young-0320/flash-margin-bench/hw/README.md

# hw

**소유자: 팀원 B** — 타인 수정은 PR로만.

실행 코드가 아닌 물리 설계물. DUT 보드 KiCad, BOM, 결선도, 열 이력 시료 기록.
레벨 시프터·히터·보호 회로가 여기서 결정된다.

## TODO

- [ ] DUT 보드 설계: SOP8 소켓, 가변 전원 + 레벨 시프터, 히터 + 온도 센서, 보호 회로
- [ ] BOM / 결선도
- [ ] 보드 제작·브링업
- [ ] 열 이력 시료 (리플로우 0/1/3/5회) 제작·기록
