young-0320/flash-margin-bench/docs/concepts/9.jtag_uart_and_os_enumeration.md

# 9. JTAG과 UART — 케이블 하나에 실린 두 대화, OS마다 다른 문패

- 관련: 로그 13 (Windows COM 오선택 사례) · 런북 3 판독표 E · `host/capture/sweep_uart_capture.py --port`

## 쉬운 버전 — 정비사 통로와 환자의 목소리

**보드와 PC의 대화는 종류가 둘이다.** JTAG은 **정비사 통로**다 — 칩을 멈춰 세우고, 속을 들여다보고, 새 프로그램(비트스트림·ELF)을 심는다. 칩이 협조하지 않아도 밀어넣을 수 있는 강제력 있는 문이고, hw_server/xsdb가 이 문으로 드나든다. UART는 **환자의 목소리**다 — 칩이 실행되는 동안 스스로 말하는 텍스트 스트림(우리의 `#G0 SWEEP BEGIN`, M/R 행들). 프로그램은 JTAG으로 들어가고, 데이터는 UART로 나온다. 방향도 성격도 다른 두 대화다.

**그런데 물리적으론 USB 케이블 하나다.** 보드 위 FTDI 칩(FT2232)이 USB 연결 하나를 **채널 두 개**로 나눈다 — A채널엔 JTAG, B채널엔 UART. 전화선 하나에 내선 두 개가 실린 셈이다. 여기까진 설계의 편리함인데, 함정은 그 다음이다: **내선 번호를 어떻게 보여줄지는 전화국(OS)이 정한다.**

**리눅스는 문패를 하나만 단다.** 커널이 "A채널은 JTAG이니 시리얼 포트가 아니다"라고 알아서 걸러, UART 채널만 `/dev/ttyUSB1` 같은 문패를 단다. 잘못 고를 여지가 없다. **Windows는 두 채널 모두 "USB Serial Port(COM3)(COM4)"라는 똑같은 문패를 달 수 있다.** 이름만 봐선 어느 쪽이 목소리(UART)이고 어느 쪽이 정비사 통로(JTAG)인지 알 수 없다 — 2026-07-08 원격 실행이 실패한 유력 원인이다(로그 13). JTAG 채널에 귀를 대면 영원히 조용하다.

**판별법 두 가지.** ① 장치 관리자에서 COM 포트 속성 → 상위(부모) 장치가 "USB Serial Converter **B**"인 쪽이 UART. ② 실증: 후보 COM으로 캡처를 띄우고 재프로그래밍 — `#G0 SWEEP BEGIN`이 **수 초 안에** 뜨는지가 판정이라 시도당 1분이 안 걸린다. 잘못 골라도 보드엔 아무 해가 없다.

## 엔지니어링 버전

**FT2232 듀얼 채널.** 채널 A = MPSSE 모드로 JTAG 신호를 비트뱅잉 — hw_server가 libusb/D2XX로 **원시 USB 장치를 직접** 잡는다(시리얼 포트 계층을 거치지 않음 — xsdb/xsct에 "포트 지정"이 없는 이유). 채널 B = 평범한 UART 브리지(8N1, 본 프로젝트는 2026-09-15부터 921600 — 그 전엔 115200), PS UART1에 배선.

**리눅스 열거.** `ftdi_sio` 커널 드라이버가 인터페이스 단위로 바인딩해 UART 채널만 ttyUSB 노드가 된다. JTAG 채널은 Digilent udev 규칙(`/etc/udev/rules.d/52-*digilent*.rules`)이 권한을 열어 hw_server가 원시 접근. 주의: ttyUSB **번호는 열거 순서**라 절대적이지 않다 — 다른 USB-시리얼 장치가 꽂혀 있으면 밀릴 수 있고, 그때는 `--port`로 조정한다.

**Windows 열거.** FTDI CDM 드라이버는 채널별로 VCP(가상 COM)를 켜고 끌 수 있는데(EEPROM/INF 설정), 구성에 따라 **두 채널 모두 COM으로 노출**된다. COM 번호는 시스템 이력에 따라 붙어 예측 불가. 판별은 위 ①(부모 컨버터 A/B) 또는 ②(BEGIN 실증).

**우리 코드에서 포트가 등장하는 유일한 곳.** PS의 C 코드는 Zynq 자기 자신의 UART 주변장치에 쓸 뿐 PC 쪽 포트를 모르고, tcl은 JTAG 전용이라 시리얼 개념이 없다. PC측 포트 선택은 `sweep_uart_capture.py --port`(기본 `/dev/ttyUSB1`) 한 곳뿐이다 — OS가 바뀌면 바꿀 것도 이 인자 하나다.

| 대화 | 우리 도구 | 포트 선택 |
| --- | --- | --- |
| JTAG | xsct/xsdb + hw_server | 없음 (원시 USB 직접, OS 무관) |
| UART | sweep_uart_capture.py | `--port` 인자 (리눅스 ttyUSB* / Win COM*) |
