young-0320/flash-margin-bench/docs/concepts/10.jedec_id.md

# 10. JEDEC ID — 칩의 자기소개, 통신 검증의 표준 관용구

## JEDEC이 뭔가

JEDEC은 반도체 업계 표준화 단체 이름이다 (Joint Electron Device Engineering
Council — 현 JEDEC Solid State Technology Association). DDR 메모리 규격을 만드는
그 단체다. "JEDEC ID"라고 할 때는 이 단체가 관리하는 **제조사 식별 표준
JEP106**을 가리킨다: 전 세계 반도체 제조사마다 고유 번호를 배정한 명부.
Winbond = 0xEF.

## 0x9F — "너 누구냐"

SPI 플래시에는 표준 명령 0x9F(Read JEDEC ID)가 있다. 8비트 명령을 보내면 칩이
3바이트로 자기소개한다. W25Q64의 답:

| 바이트 | 값 | 뜻 | 누가 정하나 |
| --- | -- | --- | --- |
| 1 | EF | 제조사 = Winbond | JEDEC (JEP106) |
| 2 | 40 | 디바이스 타입 = SPI NOR 계열 | 제조사 |
| 3 | 17 | 용량 코드: 2²³ 바이트 = 8MB = **64Mbit** | 제조사 (2ⁿ 관례) |

W25Q**64**의 64가 마지막 바이트에서 나온다 (0x17 = 23, 2²³ 바이트 = 64Mbit).

## 왜 통신 증거로 쓰나 (게재 2번의 논리)

전화를 걸어 "성함이 어떻게 되세요?"라고 묻는 것과 같다. 정확히 기대한 이름이
돌아오면 전화선(배선·전원)과 상대방(칩), 발음(클럭·타이밍)이 전부 정상이라는
뜻이다. 조건이 하나라도 어긋나면 이 3바이트가 정확히 맞을 확률은 사실상 0이라,
"EF 40 17 수신 = 보드↔모듈 통신 성립"이 성립한다. 게다가 칩 ROM에 새겨진 고정
응답이라 플래시에 뭘 썼는지와 무관 — 사전 쓰기(D2) 전에도 쓸 수 있는 첫 관문이다.

오답의 판독 (런북 3 표 E와 연결):

- `FF FF FF` — 아무도 수화기를 안 들었다. MISO가 미구동/풀업 상태 그대로 읽힘
  → 무칩·오배선·CS 미연결.
- `00 00 00` — 회선이 땅에 붙었다. MISO 접지·무전원.
- 그 밖의 값 — 다른 칩이거나 간헐 접촉 (비트 일부가 깨져 들어옴).

둘 다 "이름"이 아니라 **회선 상태를 그대로 읽은 것**이라는 게 요점이다.

## 이 리포에서 쓰는 곳

- `ps/src/flash_jedec.c` — 게재 2번: 1초 주기 반복 판독 + 판정 문구 (D1)
- `ps/src/flash_prep.c` — 사전 쓰기 전 JEDEC 선검사 (배선 정상일 때만 지우기 시작)
- SPI 마스터 RTL 경로(G3)는 0x9F가 아니라 읽기(0x0B)로 측정하지만, 그 전에 이
  유틸리티 경로(PS SPI, 2.6MHz)로 칩 존재를 먼저 증명해 두는 구조다.
