young-0320/flash-margin-bench/docs/results/reports/제5회 창의혁신 공모전 중간계획서.docx

제5회 창의혁신 공모전 중간계획서

FPGA 기반 플래시 메모리 마진 계측 및 수명 추적 플랫폼

- 팀명: 에러 ate -

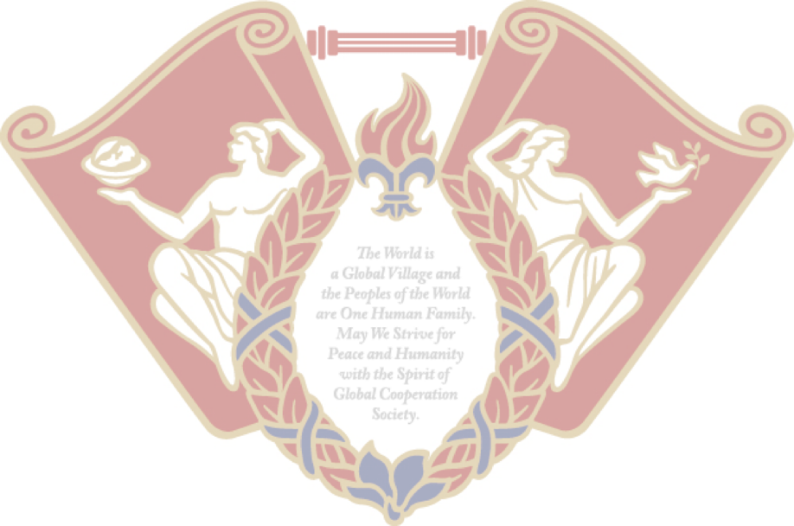
[picture p6: figure]

Ⅰ. 개요

Ⅱ. 세부내용 및 구성

Ⅲ. 기대효과 및 활용방안

Ⅳ. 수행방법

Ⅴ. 진행계획 및 역할분담

Ⅰ. 개요

1. 프로젝트 요약

본 프로젝트는 FPGA 기반 플래시 메모리 마진 계측 및 수명 추적 플랫폼을 개발한다. 같은 모델의 플래시 메모리라도 개체마다, 온도마다, 사용량마다 "여유(마진)"가 다르다. 우리는 저가 FPGA 보드(Zybo Z7-20)로 그 여유를 단위가 있는 물리량(ns, MHz, µs)으로 측정하고, 사용에 따라 여유가 어떻게 소모되는지를 칩 개체별로 추적한다. 즉, 불량인지 아닌지를 판정하는 것이 아니라 여유가 얼마나 남았는지를 측정하며, 출하 전 1회 검사가 아니라 수명 주기 내내 추적한다.

2. 배경 — 질문의 전환

당초 계획(참가 신청서)은 "FPGA 기반 SPI Flash 자동 검증 Mini-ATE", 즉 기존 검사 장비의 소형 재구현이었다. 그러나 검토 과정에서 "기존 장비를 작게 만들었다"는 것은 잘 만든 구현이지 창의적인 문제 정의가 아니라고 판단하여, 질문 자체를 바꾸었다.

산업용 ATE(자동 검사 장비)는 마진 측정을 "못 해서" 안 하는 것이 아니다. 특성 평가(characterization) 단계에서 전압-클럭 스윕은 표준적으로 수행한다. 문제는 시점과 접근성이다. ATE는 대당 수억~수십억 원의 전용 시설이며, 칩이 공장을 떠나는 순간 다시는 ATE에 물리지 않는다. 출하 전 1회 스냅샷이 전부이고, 필드에서 수년간 마모된 칩의 상태를 측정하는 인프라는 존재하지 않는다. 본 플랫폼은 작고 저렴하기 때문에 비로소 가능해지는 일, 즉 출하 이후 생애주기 전체에 걸친 반복 측정을 목표로 한다.

구분 | 산업용 ATE | 본 플랫폼
생애 시점 | 출하 전 1회 스냅샷 | 수명 주기 내내 반복 검진
대상 | 신품 로트(통계) | 사용 중인 개체(이력)
질문 | 지금 스펙을 만족하는가 | 여유가 얼마나 남았고 어떻게 줄고 있는가
결과 | PASS/FAIL + 수율 | 개체별 마진 곡선(단위 있는 물리량)
비용/형태 | 수억~수십억 원, 전용 시설 | 약 20만 원 내 COTS 부품, 벤치탑
비유 | 출생 시 신체검사 | 정기 건강검진

정직한 비교: 본 플랫폼은 ATE의 1/1000 가격에 같은 일을 하는 것이 아니다. ATE의 수많은 기능 중 출하 이후 단계에 필요한 마진 계측 기능만을 잘라내, 그 부분에 대해 1/1000 비용으로 접근 가능하게 만드는 것이다.

3. 목적

∙ 피코초급 위상 스윕으로 정상 칩의 타이밍 마진을 나노초 단위로 실측하는 계측 엔진 구현

∙ 온도·전압·마모에 따른 마진 축소 곡선(노화 곡선) 확보

∙ 마모량-마진 교정 곡선을 구축하고, 이력 미상 칩의 소모량 추정을 블라인드 실험으로 검증하여 추정 오차를 정량화

∙ 중고/재생 칩 판별, 고장 예지 등 실용 시나리오 실증

Ⅱ. 세부내용 및 구성

1. 핵심 원리 — 에러 없이 여유를 재는 위상 스윕

플래시 메모리는 데이터시트 보장 범위(온도 85°C, 클럭 104MHz) 안에서는 조건을 바꿔도 에러가 나지 않는다. PASS/FAIL만 기록하면 결과표는 전부 PASS로 채워져 실험이 성립하지 않는다. 그러나 칩이 데이터를 내보낼 때 "올바르게 읽히는 시간 구간"(유효 윈도우)이 존재하며, 읽기 샘플링 타이밍을 미세하게 옮겨 "어디서부터 틀리기 시작하는가"를 찾으면 이 윈도우의 폭이 나노초 단위 숫자로 측정된다. 결과는 가운데가 에러 0이고 양끝에서 에러가 증가하는 욕조 곡선(bathtub curve)이며, 에러 0 구간의 폭이 곧 마진이다. 칩이 고장 나기를 기다리는 것이 아니라 측정 장비 쪽이 고장 지점까지 다가가 여유를 직접 재므로, 정상 칩에서도 실험이 성립한다.

피코초 제어의 기술적 근거: Xilinx Zynq-7000 FPGA 내부의 MMCM(Mixed-Mode Clock Manager)이 제공하는 Dynamic Phase Shift 기능(PSEN/PSINCDEC 포트)으로 읽기 샘플링 클럭의 위상을 런타임에 미세 조정한다. 1스텝은 VCO 주기의 1/56로, VCO 1400MHz 설정 시 스텝 약 12.8ps다. 외부 장비 없이 FPGA 표준 프리미티브만으로 구현되므로 실현 가능성이 확보되어 있다.

이 윈도우 폭은 온도가 오르면, 전압이 낮아지면, 칩이 마모되면 좁아진다. 결정적으로 마진은 실제 에러가 발생하기 전부터 줄어들기 시작한다. 에러 카운트가 후행 지표라면 마진은 선행 지표이며, 이것이 고장 예지의 물리적 근거다.

2. 시스템 구성

∙ PC(대시보드): 시나리오 스크립트, 칩 개체 이력 DB, CSV 로깅, 그래프(욕조 곡선·슈무 플롯·Fail Map) — UART/USB 연결

∙ Zybo Z7-20 PS(프로세서): 실험 시나리오 자동화, 히터 온도 폐루프 PID 제어, JEDEC ID 칩 자동 식별

∙ Zybo Z7-20 PL(FPGA 로직): 위상 스윕 마진 엔진(핵심), 가변 클럭 SPI 컨트롤러, 패턴 생성기/비교기, 에러 위치 로거, ECC 인코더/디코더, 동작 시간 측정기(10ns 해상도), P/E 사이클링 엔진, Fault Injection(장비 자기 검증)

∙ DUT 보드: SPI NOR(W25Q)·SPI NAND(W25N) 소켓, 가변 전원 회로(전압 축), 히터+온도 센서(온도 축), 보호 회로, 짧은 배선의 전용 보드. SOIC-8 소켓이므로 동일 규격 타 제조사 칩(Macronix, GigaDevice, ISSI 등)도 교체 측정 가능

왜 FPGA인가: ① 읽기 타이밍의 피코초 단위 위상 스윕, ② 지우기·쓰기 소요 시간의 10ns 해상도 계측, ③ 스펙 한계 너머의 고속 클럭 생성과 실시간 비교 — 세 가지 모두 MCU로는 불가능하다. FPGA는 "빠른 SPI 통신기"가 아니라 정밀 계측기로 쓰인다.

3. 주요 기능

구분 | 기능 | 내용
계측(PL) | 위상 스윕 마진 측정기 | 위상별 비트에러 카운트 → 욕조 곡선, 유효 윈도우 폭(ns) 산출 [최우선]
계측(PL) | 가변 클럭 SPI + 패턴 비교 | 5MHz~스펙 초과 주파수 스윕, 조건별 최대 무에러 클럭(MHz)
계측(PL) | 에러 위치 로거 + ECC | 에러의 블록/페이지/비트 위치 기록, 정정 가능/불가 분리 카운트
계측(PL) | 동작 시간 측정기 | 지우기·쓰기 시간을 10ns 해상도로 계측(노화 지표)
계측(PL) | P/E 사이클링 엔진 | 마모 루프를 하드웨어로 고속 실행(수만 회), read disturb 포함
검증(PL) | Fault Injection | 비교기·ECC가 에러를 정확히 잡는지 장비 스스로 검증
자동화(PS/PC) | 시나리오 실행기 + 온도 PID | 온도×전압×주파수×위상 중첩 스윕 자동화, 25/40/60°C 유지
자동화(PS/PC) | 칩 개체 이력 관리 | 칩 ID별 누적 P/E·열 이력·측정 기록 영속 저장(종단 추적의 실체)
자동화(PS/PC) | 1-Click 진단 시퀀스 | 정상 확인→스윕→마진 측정→교정 곡선 대조→잔여 사이클 추정까지 자동
시각화(PC) | 욕조 곡선·슈무 플롯·Fail Map | 온도/전압/마모별 오버레이, 전압-클럭 경계 지도, 블록×워드라인 히트맵

4. 운용 모드의 구분

실험 모드(데이터 생산)는 교정 곡선과 기준 분포를 만들기 위한 장시간·파괴적 실험으로, P/E 마모 루프와 중첩 스윕, 열 이력 인가가 여기에 속한다. 진단 모드(데이터 사용)는 이력 미상 칩을 비파괴로 측정해 교정 곡선에 대조하는 것으로, 1-Click 진단이 대표이며 진단 대상 칩에는 마모를 가하지 않는다. 별도로 Fault Injection은 두 모드 모두의 전제인 장비 자체의 신뢰성 검증을 담당한다. "남은 수명(%)"과 같은 출력은 임의 점수가 아니라 추정 잔여 사이클 ÷ 정격 사이클로 정의된 비율로만 표기하며, 모든 측정값은 단위가 있는 원시 물리량으로 보고한다.

Ⅲ. 기대효과 및 활용방안

1. 중고 칩 등급 판정과 재생 칩(가짜 신품) 판별

폐기 장비에서 떼어낸 수만 회 마모된 플래시를 새것처럼 속여 파는 "재생 칩" 문제가 산업계에 실존한다. 재생 칩도 당장은 읽기/쓰기가 되므로 기존 검사로는 PASS가 뜨지만, 마진을 재면 지우기 시간이 길어져 있고 유효 윈도우가 신품 대비 좁다. 1비트 판정이 놓치는 것을 연속량 계측이 잡는다. 나아가 중고 칩을 잔여 마진에 따라 등급화(binning)하면 재사용 시장의 품질 기준이 된다. 신품 binning은 업계가 이미 수행하지만 중고 칩의 등급화 인프라는 공백이다. 오픈마켓에서 구한 출처 미상 칩과 정품 신품의 비교 실측으로 실증할 계획이다.

2. 고장 예지(Predictive Maintenance)

자율주행차, 인공위성, 의료기기의 메모리는 fail로 죽으면 안 되지만, 칩은 고장 직전까지도 검사 결과가 PASS다. 마진 축소 곡선을 추적하면 에러 발생 이전에 교체 시점을 판단할 수 있다. 응용 분야의 평균 쓰기 워크로드(월간 기록량)는 공개 자료로 구할 수 있으므로, 추정 잔여 사이클 ÷ 월간 소모 사이클 = 예상 잔여 개월로 환산 가능하다(SSD 업계의 TBW 계산과 같은 구조). 한편 SSD의 SMART와 달리, 차량 ECU·라우터·산업장비에 실장되는 raw SPI NOR/NAND는 자기 상태를 보고할 수단이 전혀 없으며 본 플랫폼의 타깃이 정확히 이 영역이다.

3. 과잉 설계(가드밴드) 최적화

"60°C 환경에서 전압이 10% 흔들려도 마진이 충분하다"를 슈무 플롯과 마진 데이터로 확인하면, 시스템 설계자는 불필요한 과잉 마진 설계를 줄여 원가를 낮추면서 안정성을 보장할 수 있다. 예컨대 스펙상 3.3V가 필요한 메모리라도 실측으로 60°C에서 2.8V까지 유효 윈도우가 충분함이 확인되면, 고가의 고정밀 전원 관리 칩(PMIC) 대신 저렴한 일반 레귤레이터로도 안정성이 보장됨을 데이터로 증명할 수 있다.

4. 패키징 스트레스 분석

에러와 마진 감소가 무작위가 아니라 특정 블록·워드라인 위치에 집중되면 물리적 스트레스의 공간적 지문이다(블록×워드라인 Fail Map). 또한 동일 신품 칩에 리플로우 열 프로파일을 0/1/3/5회 가한 그룹을 만들어 그룹별 초기 마진과 고온 마진 저하 곡선을 비교하면, 패키징 공정의 열 데미지를 마진 감소량으로 정량화할 수 있다. 이는 리플로우 대 레이저 보조 본딩(LAB) 같은 공정 간 비교 논의의 근거 데이터가 된다.

5. 교육·연구 플랫폼

학부 과정에서는 산업계의 특성 평가(characterization) 장비를 접할 기회가 없다. 총 20만 원 수준의 COTS 부품으로 구성되는 본 플랫폼은 타이밍 마진·슈무 플롯·노화 실험을 학부 실험실 수준에서 재현 가능하게 만들어, 반도체 신뢰성 교육·연구의 저비용 도구로 활용될 수 있다.

Ⅳ. 수행방법

1. 실험 설계

실험 축 | 값
온도 | 25°C / 40°C / 60°C (히터 + PID 폐루프 제어)
클럭 | 5MHz ~ 스펙 한계(104MHz) 너머까지 스윕
전압 | 3.3V → 저전압 방향 스윕
노화 | NAND P/E 반복(0 → 수만 회), 반복 읽기(read disturb)
열 이력 | 리플로우 프로파일 0/1/3/5회 인가 그룹
제조사 | 동일 스펙 SPI NOR 4개 제조사(공통 표준 커맨드 0x03으로 통일 측정)
등급 | 동일 계열에서 온도 등급만 다른 칩(예: 일반 vs 차량용) 마진 곡선 비교

수명 추정은 교정 곡선 방식으로 수행한다. 통제된 마모 실험이 기준 곡선을 만들고, 이력 미상 칩을 그 위에 위치시켜 소모된 P/E 사이클 수를 역산한다.

그룹 | 구성 | 역할
A | 신품 N개(N≥3) | 기준 분포 + 개체 간 산포 측정
B | 신품을 알려진 횟수까지 마모(0/5k/20k/50k회) | 교정 곡선 — 선이 아닌 띠(band)로 구축
C | 알려진 횟수까지 마모 후 횟수를 가리고 블라인드 추정 | 정답 있는 검증 — 추정 오차 ±X% 산출
D | 진짜 중고(이력 미상) | 응용 시연 — 소모량 추정 데모

방어 설계: ① 곡선은 여러 칩으로 만들어 띠로 보고하고, 개체 산포보다 노화 이동량이 큼을 먼저 보인다. 지표는 윈도우 폭과 지우기 시간을 병용한다. ② 추정 대상은 달력 나이가 아니라 소모된 P/E 사이클 수다. ③ 교정 곡선은 칩 모델별이며, 수명 추정은 W25N(NAND)으로 일관되게 구성하고 W25Q(NOR)는 타이밍 방법론 실증용으로 역할을 분리한다.

2. 사전 검증(시뮬레이션) 전략

∙ cocotb: 테스트벤치를 Python으로 작성하는 검증 프레임워크. SPI 컨트롤러·패턴 비교기·ECC RTL을 시뮬레이터 위에서 검증하며, PC 소프트웨어가 Python이므로 검증 로직을 실보드 UART 테스트 스크립트와 공유할 수 있다.

∙ Winbond 공식 W25Q Verilog 행동 모델: 제조사가 배포하는 칩 모델을 DUT로 연결해, 실제 칩 프로토콜(명령, 더미 사이클, tV 지연) 상대로 SPI 컨트롤러를 사전 검증한다. 모델의 tV 파라미터를 바꿔가며 위상 스윕 FSM이 윈도우 경계를 올바르게 찾는지까지 시뮬레이션으로 확인한다.

∙ VUnit: 테스트가 누적되면 회귀(regression) 관리에 사용한다.

∙ Python 몬테카를로 시뮬레이션(측정 알고리즘 검증): 샘플링 지터를 가우시안으로 모델링한 가상 칩으로 욕조 곡선을 생성하고, 윈도우 폭 추출 알고리즘을 정답을 아는 데이터에 적용해 추정 오차를 정량화한다. "위상당 몇 회 읽어야 경계 추정 오차가 ±1스텝 이내인가" 같은 실험 설계 질문(읽기 횟수 N, 경계 판정 규칙)에 하드웨어 제작 전에 답하고, 전체 실험 소요 시간 예산을 산출한다. Fault Injection이 하드웨어의 자기 검증이라면 이것은 알고리즘의 자기 검증이다.

∙ 한계의 명시: MMCM의 피코초 위상 이동 자체는 RTL 시뮬레이션으로 재현되지 않는다. 시뮬레이션의 역할은 제어 로직과 알고리즘 검증까지이며, 실제 윈도우 값은 실보드에서만 나온다. 위상 스윕 최소 실증(욕조 곡선 1장)을 최우선 마일스톤으로 두는 이유다.

3. 개발 방법

PL은 Vivado로 합성하고, PS는 베어메탈 C(Vitis)로 UART 명령 서버·온도 PID·측정 시퀀스를 구현하며, 시나리오 자동화·이력 DB·시각화는 PC Python이 담당한다. PS를 "UART 명령 서버"로 얇게 유지하고 무거운 로직을 PC로 분리하는 구조다. UART 명령 프로토콜(명령·응답 포맷)을 최우선으로 문서화하여 3인이 PL/PS/하드웨어를 병렬 개발하는 인터페이스 계약으로 삼는다.

4. 시료 및 예산

칩은 일반 SOIC-8 단품(개당 1~3천 원)을 사용하고 소켓은 DUT 보드의 1회성 부품(SOP8 ZIF 어댑터, 개당 5천~2만 원)이다. 시료는 수명 추정 4그룹(W25N 19~21개), 열 이력 그룹(8개), 타이밍 실증(W25Q 3개), 제조사 비교(4개사×3개), 등급 비교(2종×3개), 예비(3~5개)로 총 45~55개(약 10만 원)이며, 소켓·DUT 보드 PCB·전원/히터 부품을 포함해 재료비 지원 한도 20만 원 내에서 수행 가능하다.

5. 정직한 범위 설정(하지 않는 것)

산업용 ATE의 대체(웨이퍼 검사, 셀 내부 측정), 실장 상태(in-circuit) 측정, 달력 나이 추정, 다이 XY 좌표 주장(논리-물리 매핑 비공개로 Fail Map은 블록×워드라인 수준으로 한정), 가속 마모와 실시간의 환산은 범위 밖으로 명시한다. 측정을 다루는 프로젝트에서 가장 중요한 자산은 주장과 데이터가 일치한다는 신뢰이기 때문이다.

Ⅴ. 진행계획 및 역할분담

진행계획

추진내용 | 7월 | 8월 | 9월 | 10월
위상 스윕 마진 엔진 RTL 설계, cocotb+W25Q 모델 검증, 몬테카를로 알고리즘 확정 | ● | ●
DUT 보드 설계·제작(소켓/가변 전원/히터) 및 브링업 | ● | ●
욕조 곡선 실측(핵심 마일스톤) → 온도·전압 축 자동화, 슈무 플롯 | | ● | ●
NAND 마모 실험: 교정 곡선(그룹 A·B), Fail Map, ECC, 지우기 시간 추적 | | | ●
블라인드 수명 검증(그룹 C), 중고 칩·제조사·등급 비교 실증, 최종보고서/발표 | | | ● | ●

역할분담

이름 | 역할
| PL(FPGA 로직): SPI 컨트롤러, 위상 스윕 마진 엔진, ECC, P/E 사이클링 엔진, Fault Injection / 시스템 아키텍처 총괄
| PS 펌웨어(베어메탈 C: UART 명령 서버, 온도 PID) + PC SW(시나리오 자동화, 칩 이력 DB, 대시보드) / cocotb·몬테카를로 시뮬레이션
| DUT 보드 하드웨어(소켓, 가변 전원, 히터/센서, 보호 회로), 열 이력 시료 제작 / 실험 수행 및 데이터 정리
