young-0320/flash-margin-bench/data/README.md

# data

**스키마 관리: 팀원 B.** 측정 원본 CSV는 커밋 금지 (`.gitignore`) — `schema/`, `samples/`와 이 README만 커밋된다.

재현성은 원본 데이터가 아니라 생성 스크립트 + 파라미터 + chip_id 커밋으로 확보한다.

## TODO

- [ ] schema/ — 측정 레코드 스키마 정의 (`docs/interface/` CSV 스키마 준수)
- [ ] samples/ — 샘플 몇 줄

## 어디서 오는가

2026-11-11부터 캡처 · 세션 로그 · 마모 세션 폴더는 처음부터 이 폴더에 떨어진다
(`sweep_uart_capture.DEFAULT_OUTDIR` = `data/`, `run_wear.LOG_ROOT` = `data/wear/<세션>/`) — `build/`에서
옮기는 단계가 없다. `build*/`는 언제든 지워도 되는 폴더라 원본을 두지 않는다 — 2026-09-21에
`build_2024.2/`(652MB)를 실제로 지웠다.

같은 날 `build/` 에 남아 있던 원본을 전부 이리로 옮겼다 — `build/data/` 의 스윕 · 세션 로그 47개 · `build/logs/wear/` 의 세션 폴더 121개 · 지민 묶음(`build/inbox/chip23_20261018`)에만 있던 세션 `1792312085` · 콘솔 기록 25개(`logs/console/` — 마모 런 터미널 출력 · 재개 · 계획 확인 기록). 전부 해시 대조했고(그중 10/19 chip07 `050630Z` · chip25 `050352Z` 스윕은 프레이밍 슬립으로 무효라 build 에만 두던 런이라 `_invalid` 를 붙였다), 그 뒤 `build/` 쪽 사본 중 해시가 같은 것만 지웠다(3.63GB).

## 보관 현황 (2026-10-08 기준 945개 + `wear/` 세션 26개 / 2.5GB · 2026-11-11 기준 1,797개 + `wear/` 세션 172개 + `logs/console/` 25개 / 4.8GB)

| 파일군 | 유래 | 비고 |
| --- | --- | --- |
| `sweep_chip01_20260708T*` | 7월 실칩 (2024.2 세대) | 게재 4번의 원본. `164931Z`가 게재분 |
| `sweep_chip01_20260823T130847Z` | 8/23 W5-D 드리프트 1차 | 판정 보류분 |
| `sweep_chip0N_<UID>_2026091*`·`2026092*` | 9월 신품 전수 측정 (S-2, 2025.2 세대) | 집계는 `docs/results/data/newchip_survey_2026-09.md`. chip05는 측정 불가라 파일이 없고, chip10은 재장착 3회분 |
| `sweep_chip22_<UID>_2026101[78]*` · `sweep_chip23_<UID>_20261018*` · `sweep_chip24_<UID>_2026102[01]*` · `sweep_chip26_<UID>_2026102[67]*` · `temp_chip2[2346]_*` · `session_chip2[36]_<UID>_20261101T*` · `sweep_chip2[36]_<UID>_20261101T*` | 85°C 온도 마모 chip22 · 24(0 → 100k + 사다리 · newchip) · chip23(0 → 26.5k, 세션 1792309823 · 1792312282, 스윕 `20261018*`) · chip26(0 → 70k, 세션 1792996750 · 1793025714, 스윕 `20261026*` - `20261027*`) — 박지민 묶음 · 온도 로그(파일명 65C 는 실제 85°C). 11/01 에 이 PC(보드 A)에서 chip23 · chip26 상온 newchip 1회씩(블라인드 개봉 prep) | 집계 `docs/results/data/wear/wear_endurance_chip2[2346]_2026-10.md` · `docs/results/data/temp_chip2[2346]_2026-10.md`. 블라인드 `docs/results/data/blind_temp_chip23_chip26_2026-11.md` |
| `sweep_chip2N_<UID>_20261015*`·`20261019*`·`20261025*` · `session_chip2N_*` | 10/16 3차 구매분 신품 전수 측정 (chip21-23, 보드 A · newchip 1회씩) · 10/19 chip24 · 25(newchip + sweep 재측정 1회씩, chip25 슬립 무효 1회는 build/ 에만) · 10/25 chip26(newchip 1회) — FV 는 chip26 으로 끝, JV 는 chip30 부터 | 집계는 같은 `newchip_survey_2026-09.md` §1 2026-10-15 행 |
| `sweep_chip3N_<UID>_20261025*` · `session_chip3N_*` · `session_prepfail_20261025T1*` | 10/25 JV 신품 전수 (chip30-39, 보드 A · newchip 1회씩) · 실패 런(`FF FF FF` 8 · 접촉 실패 서명 3 — `132724Z` 는 뒤의 chip34, 「사용 이력」 아님) | 집계는 같은 `newchip_survey_2026-09.md` §1 2026-10-25 JV 행 |
| `sweep_chip21_<UID>_2026101[6-9]*` | 10/16-19 chip21 0 → 200k (보드 A — 체크포인트 23점, 한 세션). 신품 느린 무리 · 빠른 노화(chip12 형) | 집계는 `docs/results/data/wear/wear_endurance_chip21_2026-10.md`. `pe_end.py` 가 `build/` 에서 복사 (10/19) |
| `sweep_chip01_<UID>_2026092[2-6]*` | 9/22-26 P/E 파일럿 (체크포인트 12점 + x=0 newchip 2런 + 300k 의 45·75MHz) | 집계는 `docs/results/data/wear/wear_pilot_chip01_2026-09.md`. `build/data/` 에서 복사 |
| `sweep_chip04_<UID>_2026092[67]*` | 9/26-27 종단 chip04 (보드 B · 박지민 — 체크포인트 13점 + 복구 점 + 마모 전·100k 의 45·75MHz + newchip) | 집계는 `docs/results/data/wear/wear_endurance_chip04_2026-09.md`. 박지민이 보낸 묶음에서 복사 (9/29 · 9/30) |
| `sweep_chip01_<UID>_20260916T1{10148,13611}Z` | 9/16 chip01 스윕 2런 (박지민 리그 · 115200) | 박지민이 9/30 보낸 묶음. 집계하지 않았다 |
| `sweep_chip07_<UID>_2026092[7-9]*`·`20261019*` | 9/27-30 종단 chip07 (체크포인트 11점 + 마모 전·100k 의 45·75MHz + 100k 25MHz 반복 + 9/30 선 복구 뒤 사다리·newchip) · 10/19 10cm 점퍼선 교체 뒤 사다리(25 ×2 · 45 · 75, 무효 1회는 build/ 에만) · 10/20-21 100k → 200k 체크포인트 10점(세션 `1792429510` · `1792494559`) | 집계는 `docs/results/data/wear/wear_endurance_chip07_2026-10.md`. `build/data/` 에서 복사 |
| `sweep_chip03_<UID>_2026092[67]*`·`2026101[45]*` | 9/26-27 종단 chip03 (보드 A — 체크포인트 13점 + 마모 전·100k 의 45·75MHz + 100k 뒤 newchip) · 10/14-15 100k → 200k 연장 10점(세션 `1791990254`) | 집계는 `docs/results/data/wear/wear_endurance_chip03_2026-10.md`. `build/data/` 에서 복사 (10/3 — 그때까지 build 에만 있었다) |
| `sweep_chip09_<UID>_20260930*`·`20261001*`·`20261013*`·`20261014*` | 9/30-10/1 교정 chip09 (보드 A — 체크포인트 13점, 100k 는 휴지 뒤) · 10/13-14 100k → 200k 연장 10점(세션 `1791904816`) | 집계는 `docs/results/data/wear/wear_endurance_chip09_2026-10.md` |
| `sweep_chip17_<UID>_20261001*`·`20261002*` | 10/1-10/2 온도 chip17 (보드 B · 박지민 — 칩 위 65°C 체크포인트 13점) + 10/2 25°C 사다리(`20261002T09*`, 75MHz 는 `_reads` 만) | 집계는 `docs/results/data/wear/wear_endurance_chip17_2026-10.md`. 박지민이 보낸 묶음 |
| `temp_chip17_*.csv` | chip17 마모 중 칩 위 온도 1초 로그 (TMP117) | 집계는 `docs/results/data/temp_chip17_2026-10.md` |
| `sweep_chip12_<UID>_2026100[1-3]*` | 10/1-10/3 종단 chip12 (보드 A — 체크포인트 13점 + 100k 뒤 newchip). 구매처 미검증 — 다른 칩과 같은 칩으로 보지 않는다 | 집계는 `docs/results/data/wear/wear_endurance_chip12_2026-10.md` |
| `sweep_chip18_<UID>_20261003*`·`20261004*` | 10/3-10/4 종단 chip18 (보드 A — 체크포인트 13점 + 100k 뒤 newchip). 새 배치 빠른 무리 · 교정 | 집계는 `docs/results/data/wear/wear_endurance_chip18_2026-10.md`. `pe_end.py` 가 `build/` 에서 복사 (10/4) |
| `sweep_chip15_<UID>_20261004*`·`20261005*`·`20261015*`·`20261016*` | 10/4-10/5 종단 chip15 (보드 A — 체크포인트 13점 + 100k 뒤 newchip). 느린 무리 · 교정 · 10/15-16 100k → 200k 연장 10점(세션 `1792080192`) | 집계는 `docs/results/data/wear/wear_endurance_chip15_2026-10.md`. `pe_end.py` 가 `build/` 에서 복사 (10/5) |
| `sweep_chip10_<UID>_20261005*`·`20261006*` | 10/5-10/6 종단 chip10 (보드 A — 체크포인트 13점 + 100k 뒤 newchip). W25Q64JV · 교정 밖 | 집계는 `docs/results/data/wear/wear_endurance_chip10_2026-10.md`. `pe_end.py` 가 `build/` 에서 복사 (10/6) |
| `sweep_chip{02,12,15,17,18}_<UID>_20260930*`  | 9/30 추가 구매 배치 newchip (chip12·15·17·18, 보드 A) + 앵커 chip02 스윕 | 신품은 집계표 §1. `build/data/` 에서 복사 (10/3) |
| `sweep_chip{14,16}_<UID>_20261001*` | 10/1 추가 구매 newchip (보드 B · 박지민) | 집계표 §1 |
| `session_chip06_<UID>_20260930*` | 블라인드 chip06 마모 체크포인트 4회 + 개봉 prep 5회 (박지민) | `docs/results/data/blind_chip06_2026-10.md` |
| `sweep_chip06_<UID>_20260930*`·`20261012*`·`20261013*` | 블라인드 chip06 마모 체크포인트 4점(1k·3k·10k·12k, 세션 `1790788847`, 보드 B · 박지민) + 개봉 prep 5회의 스윕 · 12k → 100k 체크포인트 9점(세션 `1791740291`, 보드 A, 10/12) · 100k → 200k 체크포인트 10점(세션 `1791800419`, 보드 A, 10/12-13) | 9/30 은 박지민이 10/9 보낸 묶음(`nwe/`), 10/12·13 은 `pe_end.py` 가 `build/` 에서 복사. 집계는 `docs/results/data/wear/wear_endurance_chip06_2026-10.md` · 블라인드 판정은 `docs/results/data/blind_chip06_2026-10.md` |
| `sweep_chip14_<UID>_2026100[4-7]*` | 10/4-10/7 종단 chip14 (보드 B · 박지민 — 체크포인트 12점 1,000-100k + 100k 뒤 45·75MHz 사다리 + newchip). `20261004T050700Z_invalid` 는 체크포인트 100 스윕 시도(row_mismatch) | 박지민이 10/8 · 10/9 보낸 묶음에서 `pe_end.py --from` 으로 복사. 체크포인트 100 은 스윕이 실패해 유효본이 없다(`_invalid` 만). 10/12 JV 별개 승격(`pe_end.py --no-calib --promote`, 로그 53 [D53-5]) — 집계는 `docs/results/data/wear/wear_endurance_chip14_2026-10.md`. 세션 로그 16개(`session_chip14_*_2026100[4-7]*`)는 10/12 저녁 `TalkFile_14.zip` 으로 수령 · `pe_end.py --from` 으로 복사 — 폭·batch 가 비어 있다. 승격 전(`build/pe_end/chip14/`) |
| `sweep_chip16_<UID>_2026100[89]*` | 10/8-10/9 종단 chip16 (보드 B · 박지민 — 체크포인트 13점 100-100k + 100k 뒤 75·45MHz 사다리 + newchip). `20261007T034849Z` 는 마모 전 newchip (보드 A) | 박지민이 10/9 보낸 묶음에서 `pe_end.py --from` 으로 복사. 히터 설정 65°C 로 돌았다 — 10/12 온도 축 · 교정 밖으로 승격(`pe_end.py --temp --promote`, 로그 53 [D53-4]). 집계는 `docs/results/data/wear/wear_endurance_chip16_2026-10.md` |
| `temp_chip16_65C_*.csv`·`_events.txt` | chip16 마모 중 온도 컨트롤러 1초 로그 (TMP117 · 설정 65°C · 10/8 03:58Z - 10/9 06:17Z, 박지민 묶음 「온도제어chip16」) | 히터 꺼진 채 67°C 3.6시간 · 10/9 00:50Z 센서 FAULT 뒤 값 — 로그 53 §2. 집계는 `docs/results/data/temp_chip16_2026-10.md` (10/12) |
| `wear/<세션>/` | `run_wear.py` 세션 폴더 (`1790091548`·`1790212214` = 파일럿 0→300k · `1790494073`·`1790562456`·`1790643103` = chip07 0→100k · `1792429510`·`1792494559` = chip07 103.6k→178.1k · 178.8k→200k (10/20-21), 재개 판정 `1790562292`·`1790643034` · `1790423530`·`1790482991`·`1790491294` = chip04 0→100k · `1790408609`·`1791990254` = chip03 0→100k · 100k→200k (10/14-15) · `1790786787` = chip09 0→100k, 100k 휴지 뒤 `1790844691`·`1790844715` · `1791904816` = chip09 100k→200k (10/13-14) · `1790851785`·`1790879592` = chip17 0→100k (65°C) · `1790852877`·`1790880923` = chip12 0→100k · `1790989701` = chip18 0→100k · `1791078343`·`1791123800` = chip15 0→100k, 69,109 재개 판정 `1791123737` · `1792080192` = chip15 100k→200k (10/15-16) · `1792170748` = chip21 0→200k (10/16-19, 23점) · `1791175305` = chip10 0→100k · `1791280572` = chip02 0→100k · `1790788847` = 블라인드 chip06 100→12,000 (박지민 묶음, 10/8) · `1791740291`·`1791800419` = chip06 12,000→100k · 100k→200k (보드 A, 10/12·10/13) · `1791089978`·`1791201358`·`1791204058` = chip14 0→100 · 100→400(erase_fail@400) · 399→100k, 재개 판정 `1791201309`·`1791201933` (박지민 묶음, 10/8·10/9) · `1791434740`·`1791523150` = chip16 0→97,957(wip_timeout@97957) · 97,957→100k, 재개 판정 `1791523104` (박지민 묶음, 10/9·10/12)) | A.txt(사이클×섹터 소거·프로그램 시간)가 섹터 곡선의 원본. `build/logs/wear/` 에서 복사(chip04·06·14·16 은 박지민 묶음), 666MB (2026-09-30) |
| `sweep_*_invalid*` | 완주하지 못한 런 | 고장 서명 자료로 남긴다 (런북 3 표 E) |
| `*.analysis.json` | `bathtub_analysis --json` 수치 | 같은 CSV에서 재생성 가능 |
| `session_*.log` | `run_sweep_chip` 세션 로그 | 라벨 확정 전에 끝난 것은 `session_<stamp>`·`idfail`·`prepfail` 이름으로 남는다 |
| `sweep_loopback_2026070*`·`20260823T125659Z`  | G0 루프백 (2024.2 세대) | 2026-09-16에 `build_2024.2/data/`에서 복사. **원본은 9/21 삭제 — 이제 여기가 유일본** |
| `monte_carlo_sweep_params.csv` | 로그 13 — 실측 σⱼ로 N=100 재확인 | 〃. 승격 사본이 `docs/results/data/monte_carlo_n112_20260823.csv`에 있다 (내용 동일) |

`_reads.csv`(읽기별 e_i 원본)는 계약 §6이 보존을 **필수**로 규정한다. 게재분 메인 CSV는
`docs/results/data/`에 승격돼 있으나 `_reads`는 용량상 커밋하지 않으므로, **이 폴더가 유일한
사본**이다. `build_*/`는 지워도 되는 폴더이므로 원본을 거기 두지 않는다 — 9/21 삭제가 그
전제를 실제로 시험했고, 옮겨둔 덕에 잃은 것이 없었다. 다만 git도 `build*/`도 이 폴더를
지켜주지 않으므로 백업은 리포 밖에서 따로 챙긴다.
