young-0320/flash-margin-bench/docs/spec/README.md

# docs/spec — 사양서·합격 기준

**구현 전에 합격 조건을 확정하는 문서**의 보관소. 작성자는 한영웅(PE), 수신자는 구현
담당자 한 명이며, 인수 기준 판정으로 닫힌다.

`docs/interface/`와의 구분 — **계약은 3인이 동시에 지키는 것, 사양서는 한 사람에게
보내는 지시다.** 레지스터 맵·프로토콜·CSV 스키마처럼 여러 블록이 맞물리는 합의는
`interface/contract.md`(변경은 3인 합의 + `amendments/`), 한 사람의 구현 범위와 인수
조건을 정하는 문서는 여기.

## 목록

| 문서 | 내용 | 수신자 | 상태 |
| --- | --- | --- | --- |
| `s1.wear_bench_spec.md`  | 스트레스 벤치 (마모 실행 수단) | 장세은 | 작성 완료 (2026-08-23) · **개정 2026-09-16 · 09-18 · 09-19** — 개정 이력은 문서 머리말 |
| `s2.newchip_protocol.md` | 신품 전수 측정 프로토콜 | 장세은 | **확정 (2026-08-23)** — 시료 배분표 정본. 절차 설계는 한영웅, 실행은 소유자 |
| `s3.g1_test_plan.md` | G1 cocotb 회귀 합격 기준 | 박지민 | **동결 (2026-08-23)** — 개정 2로 미비점 8건 해소, 23항목. 판정 기준은 소유자와 한영웅 |
| `s3.g1_review.md` | 위 기준의 ① 판정서 (부속, 누적) | — | 틀만 생성 (2026-08-23) |
| `s4.blackbox_tb.md` | P/E 엔진 블랙박스 TB 채점표 | 한영웅의 AI (TB 구현) | **작성 중 (2026-09-18)** — 「제안-」 4건이 박지민 스펙 대기 |
| `s5.lifetime_inverse_model.md` | 수명 역산 모델 버전별 사양 (v1 - v4) | 한영웅의 AI (구현) | **작성 (2026-10-05)** — 현행 v4.3. 등록 원문은 s1 §15 추기, v4.3 은 2026-10-23 에 블라인드 개봉 전 여기 등록 |
| `s6.bathtub_v2.md` | 욕조 v2 측정 — 훑기 → 벽 집중 · 에지 계수기 · 표준 / 초심부 | v2 펌웨어 · 분석기 구현자 | **초안 (2026-11-11)** — 계약 쪽은 `../interface/amendments/4.edge_counter_bathtub_v2.md` |

## 규칙

- 파일명은 `s<번호>.<주제>.md` — **번호는 이 폴더 안의 일련번호** 다. 결번을 재사용하지
  않는다. 종전 규칙은 「워크플로의 트랙 번호」였는데 s1~s3 이 전부 워크플로 5 의 W5-S
  하나에서 나와 처음부터 성립하지 않았다 (2026-09-18 정정, 로그 41 `[D41-15]`)
- 대응하는 워크플로 트랙이 있으면 **머리말에 적는다.** 없어도 된다 — s4 가 그렇다
- 머리말에 **수신자 · 인수 판정자 · 근거 문서**를 명시한다. 작성자와 판정자가 같아도
  적는다 — 나중에 분리해야 할 때 누락이 드러난다
- 본문은 수치와 조건만 싣는다. **왜 그 값인가는 `docs/log/young/`** 에 남기고 링크한다
