young-0320/flash-margin-bench/docs/log/README.md

# 작업 로그 

## 이 폴더의 기준

> **로그는 "왜 이렇게 만들었나"에 대한 답이지 일지가 아니다.**
> 수치·현황은 `results/`·`spec/`·등록부에, **결정 근거와 의도, 그리고 경위는 로그에.**
> — 커밋 `1535ad8` (2026-09-17). `docs/CONTRIBUTING.md` §1 「폴더별 역할 상세」와 같은 규정.

그래서 아래 한 줄 요약은 "무엇을 했나"가 아니라 **그 로그에만 있는 판단**을 가리킨다.
수치를 찾는다면 로그가 아니라 `docs/results/` · `docs/spec/` · `docs/chip_registry.md` 다.

---

## 서식 규약

**[FORMAT.md](FORMAT.md)** — 무엇을 담고 무엇을 담지 않나, 골격·머리말·절별 규칙.
한영웅 로그에 강제, `jimin/`·`seeun/` 는 제안이다.

---

# 한영웅

## 1기 — 계약과 시뮬레이션 (7/06 ~ 7/07)

| # | 로그 | 여기에만 있는 것 |
| - | --- | --- |
| 1 | [몬테카를로·산출물 정책](young/1.monte_carlo_and_artifact_policy.md) | 산출물 정책의 출발점 |
| 2 | [중간보고서 스프린트](young/2.midterm_sprint_mode.md) | 게재 목록 확정 |
| 3 | [인터페이스 계약 v1](young/3.interface_contract_v1.md) | 결정 21건의**후보·장단점·탈락 이유**,`core`=계측제어 / `flash`=경로 분리 |
| 5 | [욕조 곡선 스크립트 v1](young/5.bathtub_script_contract_upgrade.md) | 게재 1번 소프트웨어 완성 |

## 2기 — RTL 구현과 G0 루프백 (7/07 ~ 7/09)

| #  | 로그 | 여기에만 있는 것 |
| -- | --- | --- |
| 6  | [core RTL](young/6.core_rtl_implementation.md) | MMCM 위상 제어 + AXI-Lite 레지스터 파일 |
| 7  | [flash RTL](young/7.flash_loopback_rtl.md) | G0 루프백 프런트엔드, 프레이밍 재정렬 |
| 8  | [Vivado 통합 + 스윕 SW](young/8.vivado_integration_and_sweep_sw.md) | 비트스트림·XSA·베어메탈·수신기 첫 관통 |
| 9  | [G2 JEDEC 브링업 준비](young/9.g2_jedec_bringup_prep.md) | **앱 소유권 배분** (`flash_jedec`=장세은, 별다른 이유 없으면 수정 지양) |
| 10 | [실칩 앞 의사결정 라운드](young/10.realchip_sweep_decisions.md) | 5건 확정·1건 대기 — 실칩 정책의 원점 |
| 11 | [SPI 마스터 RTL](young/11.spi_master_rtl.md) | `0x0B` 40클럭 프레임 고정 — 뒤에 UID 를 막는 제약 |
| 12 | [실칩 준비 일괄](young/12.realchip_prep_batch.md) | 테스트 계획 ·`flash_prep` · 클럭 사다리 3벌 |
| 13 | [첫 욕조 곡선 + line_dead 수정](young/13.first_loopback_bathtub_and_linedead_fix.md) | 자가진단 오발의 원인 |
| 14 | [세은 브링업 코드 리뷰](young/14.seeun_bringup_code_review.md) | 2벌 리뷰 + 실기 검증 |
| 15 | [G3 25·45MHz 완주](young/15.g3_25mhz_wall_too_narrow.md) | **벽 천이가 Δφ보다 가팔라 체크1 구조적 SKIP** |

## 3기 — 마모 벤치 사양 확정 (8/20 ~ 8/23)

| #  | 로그 | 여기에만 있는 것 |
| -- | --- | --- |
| 16 | [마모 벤치 사양 결정](young/16.wear_bench_spec_decisions.md) | 역할 재정의, 워크플로 5 신설 |
| 17 | [S-1 사양 확정](young/17.wear_bench_spec_finalization.md) | **모든 수치의 채택 근거** (최장 로그, 597줄) |
| 18 | [docs 구조 감사](young/18.docs_structure_audit.md) | `spec/` 신설, 문서-리포 정합 복구 |
| 19 | [S-3 G1 기준 동결과 개정 2](young/19.g1_acceptance_freeze.md) | 오라클 출처·판정 3단 · 미비점 8건 해소 |
| 21 | [S-2 전수 측정 프로토콜](young/21.newchip_protocol.md) | **되돌릴 수 없는 측정의 사전 등록** |

## 4기 — 실칩 스윕 파이프라인 (9/07 ~ 9/08)

| #  | 로그 | 여기에만 있는 것 |
| -- | --- | --- |
| 22 | [D 트랙 1차 실측](young/22.d_track_drift_sweep.md) | 스윕 2건 사후 기록, 판정 보류 |
| 23 | [래퍼·UID 파이프라인 설계](young/23.sweep_wrapper_and_uid_design.md) | **라벨을 사람이 입력하지 않는다** · 부록 A(오배치 위험) — 가장 많이 참조됨 |
| 24 | [같은 것의 구현과 검토](young/24.sweep_wrapper_uid_pipeline_impl.md)  | 로그 23 설계의 코드화 · §8 「중요 1」 —`#PREP ERROR` 를 종료 신호로 읽는 규약 |

## 5기 — 재개와 신품 전수 측정 (9/14 ~ 9/17)

| #  | 로그 | 여기에만 있는 것 |
| -- | --- | --- |
| 26 | [재개 + 9/15 절차](young/26.resume_after_papers_and_day_plan.md) | 팀원 논문 조사 반영 |
| 27 | [Vivado 2025.2 통일 계획](young/27.vivado_2025_2_migration_plan.md) | 워크플로 8, A/B 재기준선 생략 결정 |
| 28 | [9/15 실칩 검증일](young/28.realchip_day_chip02_chip03.md) | chip02·chip03 신품 측정과 그날의 결정 |
| 29 | [P/E 엔진 구현 층위](young/29.pe_engine_layer_decisions.md) | `N_READS` 112 치환 근거 |
| 30 | [`flash_prep` 신품 조사 확장](young/30.flash_prep_newchip_survey.md) | G-b·G-d 구현 명세 · §10.3 보 레이트 |
| 32 | [`reproduce.py`](young/32.reproduce_script.md) | 빌드·검증 원샷 재현 + 채점 |
| 33 | [Windows 대응 — 다섯 벽](young/33.reproduce_windows_support.md) | 셸 의존 제거 ·`.bat` 런처 · `PYTHONUTF8=1` 강제 · §4 빌드 신원 관리(보류) |
| 36 | [`flash_id` + sweep UID 대조](young/36.flash_id_and_sweep_uid_check.md) | **P/E 없는 신원 확인** · §2-7 리팩터 동등성 증거 · §2-10 **재장착 70ps** · §5 설계 결정 |
| 38 | [로그 서식 규약](young/38.log_format_convention.md) | **로그가 담을 것과 담지 않을 것의 판별선** · 골격 다섯 · 전 34편 계측 |
| 39 | [규약 집행 — 스킬과 검사기](young/39.log_convention_enforcement.md) | 규범은 README, 집행은 스킬 · **산문 주의사항은 체크리스트가 아니다** |
| 40 | [로그 전수조사](young/40.log_audit_and_its_byproducts.md) | **자를 못 맞췄다** — 줄이는 힘은 병합·결번에서만 나온다 · 「3인 추인」은 합의된 적 없는 표기였다 |
| 41 | [블랙박스 TB · 엔진 인터페이스](young/41.blackbox_tb_and_engine_interface.md)  | **구현자가 짜는 채점표를 어떻게 믿나** · 경계 7개는 S-1 §13 이 요구하는 것에서 나온다 |
| 42 | [블랙박스 TB 미비점 보완](young/42.blackbox_tb_gaps_and_jimin_reply.md)  | **표에 적힌 것과 실제로 재는 것이 갈라진 자리** · 집행 장치가 없는 인수 조건은 비어도 초록이 난다 |
| 43 | [전수 측정 — 앵커가 고장났다](young/43.newchip_survey_anchor_failure.md)  | **유효한 런과 해석 가능한 런은 다르다** · 기준 개체가 자기 열화를 보고 있으면 게이트가 자기 참조가 된다 · 재장착 σ 13.86 vs 137.33 |
| 44 | [P/E 엔진 구현 전 검토](young/44.pe_engine_prebuild_review.md)  | **경계에 「이어 돌릴」 명령이 없다** · mux 의 전제(체크포인트 무리셋)는 스윕이 부팅 1회 1회라 성립하지 않는다 · 파일럿은 리셋 수용을 권고 |
| 45 | [P/E 엔진 구현 — 실칩 앞에서 멈췄다](young/45.pe_engine_build_to_sim.md)  | **정본이 비워 둔 디테일 10건의 채택값** · 잔류 없는 섹터를 지우는 것은 마모다 · C 엔진은 리셋=프로세스 재시작인 호스트 시뮬레이션이 같은 TB 로 잰다 · (후속 §12~) 0 은 「제대로 재고 0」과 「세는 경로가 죽어서 0」이 같아 보인다 · tally 를 지우는 열쇠는 UID 타이핑 + 장부 먼저 |
| 49 | [보 레이트는 옵션 — xsct 가 실행 직전에 덮어쓴다](young/49.baud_rate_runtime_option.md)  | **ELF 를 갈지 않고 JTAG 로더가 변수를 덮어쓴다** · 보를 낮추면 이용률은 오른다 · 유실은 보가 아니라 안 읽는 시간 · 기계마다 다른 보는 통제 변인이 아니라 추적 조건 |
| 48 | [파일럿 마모 실행기 — 승인은 계획 화면에서](young/48.pilot_wear_handler_and_plan_approval.md)  | **tally 는 영역을 세지 않는다 — 안 지우면 x축이 통째로 밀린다** · 실행기 설계 §1-§7 에 마모 실험 후속 §8-§53 이 붙은 큰 로그 — 파일럿 300k · 종단 chip03 · 04 · 07 · 09 · 15 · 18 · 02 · 온도 chip17 · 교정 밖 chip10 · 12 · 14 · 수명 역산 v1-v3.2 · 기준선 비교 · 공모전 범위. 안건별 위치는 본문 머리의 절 색인 · 역산 v4 부터는 로그 52 |
| 47 | [문서 3층 — 명령은 commands.md 한 곳](young/47.docs_three_tiers_commands_single_source.md)  | **같은 명령 문장이 세 곳에 있으면 하나를 고칠 때 둘이 낡는다** · 런북은 날짜순이라 정본이 될 수 없다 · README 는 본질과 포인터만 |
| 51 | [역산 모델은 소거 시간 하나 — 두 무리, 두 번째 dose](young/51.inverse_model_design_and_blind_procedure.md)  | **비율도 차도 chip01·03 을 못 겹친다 — 차이는 오프셋이 아니라 속도(A 10배)** · prep 한 번은 미지수 둘에 식 하나 · 쌓인 양 ÷ 쌓이는 속도 = x/n · 신품 소거 40ms 가 무리를 가른다 · 폭은 나이가 아니라 현재 마진 · 온도는 비율이 상쇄 · 유효 표본은 칩 수 |
| 53 | [chip16 100k 가 온도 로그와 함께 왔다](young/53.chip16_100k_with_temperature_log.md)  | **상온 교정 칩의 마모 전 구간을 65°C 로그가 덮는다 — 히터가 꺼진 채 67°C 가 세 시간이라 로그도 의심** · 소거 4.2배는 상온 빠른 무리 모양 · 0 → 97,957 의 A 행이 없다(10/12 수령 → 1-100,000 완성 → **[D53-4] 온도 축 · 교정 밖으로 승격** — chip17 과 반대로 상온 빠른 무리처럼 늙음, 칩 온도 미확인) · chip14 는 JV 판독 → chip10 과 「JV 둘」 별개 승격 [D53-5] · chip14 앞 세션 넷 · chip06 스윕 9런 수령 |
| 52 | [역산 v4 — 고른 값을 잰 값으로, LOCO 는 채점표](young/52.inverse_v4_measured_not_chosen.md)  | **생성 모델 선택은 맞았다 — 분류가 아니라 교정 문제, 칩 7개 체제** · 정규 셀은 표 형식이 강제한 가정(분위수 21개로) · 「7개 = 1개」 는 재지 않은 극단값(ρ_s · ρ_p → n_eff) · 「두 번 센다」 진단은 맞고 처방이 틀렸다(정렬 뒤 σ_r 에서 R 유도) · 합격 띠를 먼저 · v4 → v4.1(chip06), chip14 는 대조군 · 합성 복원은 고도화 재료가 아니다 · 200k 연장(chip06 · 09 · 03 · 15) — 빠른 무리는 「언제」 · 160k 너머 평탄 · H6 ② 는 직전 + 21ms, 느린 chip03 · 15 는 계단 없이 미끄럼(chip03 10/14 예측 틀림 · chip15 10/16 예측 맞음 — 계단은 빠른 무리의 표지), **chip21 은 신품 느린데 빠른 속도(chip12 형) — 「신품 소거 = 무리」 전제 깨짐, 상온 모델 0/12 [U52-7]** · v4.3 설계 [D52-13] — 답 범위 100k 그대로, 200k 곡선은 고마모 과소추정 교정 재료 · 튜닝된 R 이 가리던 빠른 무리의 속도 모델 문제 · (후속 §9-§10) 등록 — ρ_s 0 · ρ_p 0.78 에 **칩 효과 ρ_chip 0.29** 를 더해야 95% 가 띠 안(칩 안 표로는 칩 차이가 안 보인다) [D52-6] · 전체값 하나 [D52-7] · 68% 과소신 그대로 등록 [D52-8] · 합성 생성기는 정렬을 깜빡했었다 · (후속 §11, 10/12) **v4.1 측정** — chip06 더한 9칩 LOCO 80.4 · 94.9%(띠 판정 v4 와 같음) · R 2.97 → 2.72 가 chip04 를 밀어냄 · 등록 [U52-5] 대기 · (후속 §12) **v4.2 프로그램 축 폐기 [D52-9]** — 좁아지나 과신(합성 95% 84%), 다음은 v4.3(200k) |
| 54 | [최종 발표 — 슬라이드는 두고 말을 줄인다, 수치는 v4.3](young/54.final_presentation_scope_and_script.md)  | **12장 합치기 대신 16장 유지 · 세부는 예상 질문** · chip23 을 어디에 둘지의 경위 · v3.2 유지안을 버린 이유 · 초안의 「프로그램과 소거의 반응 차이」 와 「차이 없음」 을 버린 이유 · NOR 부족 근거의 한계 |
| 55 | [교수님 피드백 (11/2) — 욕조 곡선 → 욕조 v2 설계](young/55.professor_feedback_bathtub_2026-11-02.md)  | **교수님 요구 다섯** · v2 설계(끊긴 축 W 1,000ps · 훑기 1회 → 벽 집중 K 5 · 표준 N 8,064 · 초심부 N 근거 재검토 [U55-4]) · **주력 25MHz** [D55-7] · 계수기 · BASE_SECTOR 를 M2 「기각한 지표」 장으로 [D55-8] · **천장 = 에지 방향 차(DCD), 선반 = 앞 비트 이력(ISI)** · 25MHz 도 배선에 흔들린다 · 리뷰 §9 |

## 결번 — 4 · 20 · 25 · 31 · 34 · 35 · 37 · 46 · 50 

---

# 장세은 

| # | 로그 | 여기에만 있는 것 |
| - | --- | --- |
| 1 | [Windows 빌드 트러블슈팅](seeun/1.windows_build_troubleshooting.md) | FPGA/Vitis Windows 환경 수동 빌드 가이드 |
| 2 | [W25Q64 온도·열화 환경 구성안](seeun/2.temperature_bench_design.md) | 온도 벤치 1차 하드웨어 구상 |
| 3 | [TMP117 단독 연결 시험](seeun/3.tmp117_test.md) | 온도 센서 읽기 시험 (9/21) |
| 4 | [DFR0457 온도 제어](seeun/4.dfr0457_temperature_controller.md) | 히터 PWM 제어 최종 연결 |
| 5 | [Arduino 온도 로그를 WSL 에서](seeun/5.arduino_wsl_temperature_logging.md) | USB 시리얼을 WSL 로 넘겨 로거 실행 |

---

# 박지민 

| # | 로그 | 여기에만 있는 것 |
| - | --- | --- |
| 1 | [P/E 노화 실험 아이디어](jimin/1.pe_wear_bench_idea.md) | 마모 벤치의 최초 착상 (9/14) |
| 2 | [P/E 스트레스 벤치 AI 프롬프트](jimin/2.pe_stress_bench_ai_prompt.md) | 구현 의뢰용 프롬프트 (9/15) |
| 3 | [cocotb 검증 환경 계획](jimin/3.cocotb_verification_plan.md) | G1 회귀 계획 (9/15) |
| 4 | [Vivado/Vitis 빌드 명령어](jimin/4.vivado_vitis_build_commands.md) | 전체 빌드 명령 정리 |
| 5 | [WSL USB 포트 연결](jimin/5.wsl_usbipd_jtag_uart_connection.md) | usbipd 로 JTAG·UART 붙이기 (9/16) |
| 6 | [cocotb 환경과 smoke 기준선](jimin/6.cocotb_environment_and_smoke_baseline.md) | cocotb 환경 확인 (9/18) |
| 7 | [cocotb G1 진행 기록](jimin/7.cocotb_g1_progress.md) | G1 구현 진행 (9/18) |
| 8 | [P/E 엔진 스펙 회신 검토](jimin/8.pe_engine_spec_review_notes.md) | 스펙 회신 검토와 개념 정리 (9/20) |
