young-0320/flash-margin-bench/host/viz/README.md

# host/viz

**소유자: 팀원 B** — 타인 수정은 PR로만.

결과 시각화와 칩 이력 DB (PC Python).

## TODO

- [ ] plot_bathtub (위상 vs 비트 에러 욕조 곡선)
- [ ] plot_shmoo
- [ ] chipdb (칩 이력 DB)
- [ ] Fail Map 생성·해석

- `overview_figures.py` — 보고서 Ⅱ. 개요의 개념도 2장(SVG): 칩 안의 신품 섹터 · 시스템 블록도. `build/plots/` 에 쓰고 사람이 `docs/results/plots/` 로 승격
