young-0320/flash-margin-bench/fpga/rtl/flash/README.md

# fpga/rtl/flash

**소유자: 팀원 A** — 타인 수정은 PR로만.

플래시와의 트랜잭션 계층 전부. 판별: "칩과 무엇을 주고받나"를 다루면 여기.
내부 아키텍처 결정권은 소유자에게 — 외부 스펙(레지스터 맵, 더미 사이클 요구사항)만 준수.
NOR/NAND 하위 폴더 분화는 W25N 착수 시 소유자 판단 — 지금은 평탄 유지.

## TODO

- [ ] SPI 마스터 — 물리 계층/커맨드 시퀀서 분리, 가변 클럭, 상태 폴링
- [x] 0x0B fast read 더미 사이클 지원 (첫 곡선이 0x03만 써도 스펙에 지금 포함) — `fpga/rtl/flash/flash_spi_ctrl.v`
- [ ] P/E 사이클링 엔진
- [ ] 패턴 생성기 / op_timer(10ns) / error logger
