young-0320/flash-margin-bench/docs/workflow/14.contest_thesis_paper_milestones.md

# 14. 공모전 · 졸업논문 · 학회 투고 — 범위와 마일스톤

- **작성일**: 2026-10-05
- **언제 쓰나**: 할 일이 어느 마일스톤의 것인지 정할 때. 새 작업을 받으면 먼저 이 문서의 「넣는 것 · 넣지 않는 것」 에 비춰 본다
- **근거**: 로그 48 [D48-99] (범위 자르기 · 2026-10-05 한영웅). 모델 버전은 `../spec/s5.lifetime_inverse_model.md`, 블라인드 등록은
  `../spec/s1.wear_bench_spec.md` §15
- **원칙**: 뒤 마일스톤은 앞 마일스톤을 포함한다. 마일스톤마다 **데이터 마감일**을 두고, 그날 뒤에 들어온 데이터는 다음 마일스톤으로 넘긴다.
  학회 욕심이 졸업논문을, 졸업논문 욕심이 발표를 늦추지 않게 하는 장치다

## 한눈에

| | M1 공모전 최종 발표 | M2 졸업논문 | M3 학회 투고 |
|---|---|---|---|
| 기한 | **끝 — 2026-11-06 발표** (처음 계획 10/16 · 보고서는 10/2 제출 · 수정 불가) | **TODO** (학과 일정 확인) | M2 뒤 (투고처 마감에 맞춤) |
| 데이터 마감 | **2026-11-01** (처음 계획 10/12) | M2 기한 3주 전 (TODO 날짜) | 투고 4주 전 |
| 질문 | 이 칩의 마모를 「몇 번」 으로 추정할 수 있나 | 같은 질문 + 그 추정을 블라인드로 믿을 수 있나 | 다른 칩에도 되나, 안 되면 알아채나 |
| 칩 | W25Q64 모듈 — 지금까지의 칩 | W25Q64 전부 — 출처 · 로트 · 실장 회사를 달리한 W25Q64 포함 | 다른 제조사 (Infineon S25FL128L 5개 확보) |
| 모델 | v4.3 · 판정은 chip06(v2) · chip26(v4.3) — 로그 54 [D54-3], 처음 계획 v3.2 | **v4** — 블라인드 개봉 전에 S-5 등록 | v5 (지문 장치 · 프로그램 축 본격) |
| 핵심 산출물 | 대본 · 슬라이드 · 시연 · 기준선 비교 | 논문 · 블라인드 판정 | 원고 |

## M1 공모전 최종 발표 (11/6 확정 — 2026-11-01 영웅님. 처음 계획 10/16)

> **2026-11-10 — 끝났다 (영웅님).** 11/6 발표로 공모전이 끝났다. 아래는 기록으로 두고 고치지 않는다 — 체크 안 된 항목은 발표로 갈음됐다. 현행은 M2.

**넣는 것**
- 지금까지의 결과(마진 불변 · 소거 · 프로그램 · 두 무리 · 128KB 교란) · 현행 모델(v4.3, 로그 54 [D54-3]) · 블라인드 chip06(v2 판정) · chip26(v4.3 모델 고정 판정)
- **방법론을 중심축으로** — 사전 등록(커밋 시각) · 블라인드 · LOCO · 합성 복원 · 버린 것들 (대본 6장)
- 선행 연구 인용과 위치(이진 판별 → 횟수 추정 + 정직한 구간)
- 기준선 비교 — 선행식 이진 판별 · 단순 회귀 · 현행 모델을 같은 LOCO 점에서
- 한계(한 품번 · 한 구매처 · 개체차 바닥 · chip12)와 다음 단계

**넣지 않는 것**: 새 측정 축 · 다른 제조사 · 물리 해석 주장(질의응답에서 「가설」 로만) · 데이터 마감 뒤 결과(chip10 끝 값 등은 「진행 중」 으로)

**할 일**
- [ ] 대본 확정 — `../results/reports/최종발표대본.md` (2026-11-04 초고 · 초시계 리허설 뒤 확정, 슬라이드 `최종발표_초안6.pptx`)
- [x] 기준선 비교 구현 · 수치 문서 (10/12) — `../results/baseline_compare.md` (2026-10-05)
- [ ] 1장 그림 — 신품 15칩 소거 분포 + chip04 1,000회 점
- [ ] 6장 그림 — 커밋 시각 타임라인 · 블라인드 구간 · LOCO 표 · 합성 복원
- [ ] 슬라이드 · 시연 리허설 (시연은 `wear_inverse.py` 화면)
- [ ] 숫자 대조 — 대본 숫자를 출처 문서와 발표 전날 다시 맞춘다

**지민과 묶인 할 일 (2026-10-09 추가 — 로그 53)**. 데이터 마감 10/12 안에 오면 M1 에서 「진행 중」 으로 말하고, 승격은 M2 다
- [ ] 지민에게 요청 넷 — ① chip16 세션 폴더 `1791434740`(0 → 97,957) · `1791523104`(resume) — **10/12 수령**(`TalkFile_request.zip`, 남은 건 ②③④) ② chip16 배치 설명(히터 · 센서가 chip16 보드 위에
  있었나 · 꺼진 뒤 왜 안 식었나 · 사진) ③ chip14 세션 로그 — **10/12 저녁 수령(16개, `TalkFile_14.zip`) · 반영 끝** ④ chip14 IC 마킹 사진 — **10/12 영웅님이 직접 판독(JV `1749`), 더 필요 없음**
- [ ] chip06 12k → 100k 마모를 지금 시작할지 정한다 — 보드 B 가 비었고 약 하루. v4.1([D52-4])의 전제라 10/16 전에 v4.1 을 보려면 10/10 안에 시작

**끝났다는 기준**: 발표 끝. 이후 M1 문서는 고치지 않고 기록으로 둔다

## M2 졸업논문

**넣는 것**
- M1 전부
- **블라인드 판정** — chip08(옛 로트 · 느린) · 새 10칩에서 뽑는 블라인드. **v4 를 개봉 전에 S-5 에 등록**하고 그 버전으로만 판정한다
- 교정 확대 — chip10(`DF`) · 새 10칩 중 교정분 (chip16 은 10/12 온도 축으로 빠짐 [D53-4])
- 프로그램 시간 PRBS 눈금 곡선 — 체크포인트 prep 이 2026-10-05 chip10 부터 13점마다 남긴다(재빌드한 범위 ELF)
- **같은 품번, 다른 출처 · 로트** — 다른 날 · 다른 실장 회사 모듈의 W25Q64. 「출처 미상 모듈 IC 로 만든 모델이 다른 로트에도 맞나」.
  펌웨어를 바꾸지 않는다. **모든 칩의 IC 윗면 마킹(품번 줄 · 날짜 코드 · 로트)을 사진으로 남겨 등록부에** — 개체 지문의 첫 단계
- 물리 해석은 **토론 수준** — 소거 시간 양자화(계단 높이 일정)를 지금 데이터로 확인한 결과까지
- 한계 · 개인 기여 범위(공동 작업과 구분 — 로그의 결정별 날짜 · 사람이 근거)
- **욕조 곡선 심화** — 11/2 교수님 피드백([로그 55](../log/young/55.professor_feedback_bathtub_2026-11-02.md)): 벽 확대 · 좌우 비교 · 0/1 pdf · 칩별 평균 산포 · 체크포인트별 평균. 아래 B1-B5. 논문에서는 「기각한 지표와 그 이유」 장 — 벽이 에지 방향으로 갈리고(DCD) 그 시간 차가 마모와 무관함까지 ([D55-8]). 주력 25MHz, 75MHz 는 선택 교차 검증 ([D55-7])

**넣지 않는 것**: 다른 제조사 칩 · 펌웨어 다중 제조사 대응(2026-10-05 M3 로 옮김) · 지문 장치의 본격 검증 · NAND · DRAM · 슈무 · 아이 다이어그램(향후 과제로 한 줄)

**할 일**
- [ ] 학과 일정 확인 → 기한 · 데이터 마감 날짜를 이 문서에 적는다
- [ ] 모든 칩 IC 윗면 마킹 사진 → 등록부 열 추가
- [x] ~~다른 출처 · 실장 회사의 W25Q64 모듈 추가 구매~~ — **Voltly 모듈은 30개로 고정한다** (2026-10-05, 로그 48 §48). 비교군은 Adafruit 5633 10개(JV)
- [ ] 아직 신품 측정을 안 한 Voltly 칩은 **날짜 코드 판독 → 무리 예측을 칩마다 적어 커밋 → newchip 측정** 순서로 (날짜 코드 가설의 사전 예측 시험)
- [x] v4.3 을 2026-10-23 에 S-5 에 등록했다 (블라인드 개봉 전 — 순서를 지켰다)

**영웅님이 할 일 (2026-11-11 정리 — 사람 손이 필요한 것만, 순서대로)**. AI 가 할 수 있는 것은 끝났다(로그 55 §11). 아래가 끝나야 다음으로 간다

보드 — 욕조 v2 (수정안 #1 · #4, 명세 S-6 §6)
- [ ] ① **A1 — 새 비트스트림이 v1 을 바꾸지 않는가.** 칩 하나를 꽂은 채 v1 스윕 3회(옛 → 새 → 옛, P/E 0). 끝나면 AI 가 판정하고, 통과하면 새 비트스트림을 기본으로 바꾸고 커밋에서 다시 빌드해 md5 를 기록한다
  ```
  uv run python host/run/run_sweep_chip.py --mode sweep --mhz 25 --chip N        # 옛 (지금 기본 폴더)
  cp build/bit_amend14_pre_A1/g3-25/g3_wrapper.bit build/vivado_g3_25/g3_chip_25.runs/impl_1/g3_wrapper.bit
  cp build/bit_amend14_pre_A1/g3-25/g3_chip_25.xsa build/vivado_g3_25/g3_chip_25.xsa
  uv run python host/run/run_sweep_chip.py --mode sweep --mhz 25 --chip N        # 새
  cp build/bit_v1_pre_amend14/g3-25/g3_wrapper.bit build/vivado_g3_25/g3_chip_25.runs/impl_1/g3_wrapper.bit
  cp build/bit_v1_pre_amend14/g3-25/g3_chip_25.xsa build/vivado_g3_25/g3_chip_25.xsa
  uv run python host/run/run_sweep_chip.py --mode sweep --mhz 25 --chip N        # 옛
  ```
- [ ] ② **v2 ELF 빌드** (한 번도 구운 적 없다): `BT2_MHZ=25 vitis -s ps/scripts/build_bathtub_v2.py` (75MHz 는 `BT2_MHZ=75`)
- [ ] ③ **A4 — 실칩 v2 첫 측정**, 같은 장착에서 v1 스윕 바로 뒤: `uv run python host/run/run_sweep_chip.py --mode bathtub2 --mhz 25 --depth std --chip N`
- [ ] ④ **#1 A2 — BASE_SECTOR 세 창**: ③ 에 `--base-sector` 를 0 · 중간 · 끝 근처로 바꿔 3회
- [ ] ⑤ **A5 — 75MHz**: 75MHz ELF 로 `--mhz 75`, 칩 1-2개에 1회씩
- [ ] ⑥ **첫 초심부 측정** (약 6시간, 밤에): ③ 에 `--depth deep`
- [ ] ⑦ **A3 — 루프백 v2 완주**: 실행 명령은 AI 가 ①-③ 동안 준비한다

보드 — 마모 (보드가 빌 때, 명령은 `../commands.md` §3)
- [ ] chip08 을 30k 에서 끝까지 이어 마모
- [ ] chip25 를 교정 칩으로 0 → 100k

사람에게 요청 · 확인
- [ ] 지민 · 세은에게 수정안 #4 · 명세 S-6 · 수정안 #1 추기를 보내 검토 · 승인 받기
- [ ] 학과에 M2 기한 확인 → 이 문서 맨 위 표에 적기
- [ ] 느린 무리 칩 추가 구매 여부

영웅님이 직접 할 판단 (보류 중)
- [ ] chip08 블라인드 결과 해석 · 보고서 한계 문구 (아래 느린 무리 절)
- [ ] SPI NAND 장 — 보류 (`15.thesis_spi_nand_scope_draft.md`). 다시 볼 때 M2 기한부터

**느린 무리 교정 보강 (2026-11-11 추가 — 로그 52 [U52-7])**. chip08 블라인드 불합격으로 느린 무리 블라인드 두 칩이 모두 95% 밖이다
- [ ] chip08 을 30k 에서 끝까지 이어 마모 → 교정에 넣을지 그때 정한다 ([D52-19])
- [ ] **chip08 블라인드 결과 해석은 영웅님이 직접 한다** (2026-11-11 영웅님) — AI 가 쓴 해석 문서 `../results/blind_chip08.md` 와 보고서 한계 문구(개봉 prep 1회 · 휴지 약 2.7시간을 「2.38배를 설명할 크기 아님」 으로 쓸지)는 영웅님 검토 전까지 잠정
- [ ] chip25(미배정 · 느린 FV 신품)를 교정 칩으로 0 → 100k(필요하면 200k)
- [ ] 느린 무리 칩 추가 구매 — 신품 측정으로 무리를 가른 뒤 배정
- [ ] 칩이 늘면 v4.4 설계(느린 무리 형 · 속도 사전) → 등록 → 남은 블라인드

**욕조 곡선 심화 (2026-11-10 추가 — 로그 55)**. 보드 없이 기존 데이터로 되는 것(B1-B3)을 먼저 하고, 새 측정(B4 · B5)은 [D55-8] 로 M2 에 넣었다
- [x] B0 욕조 v2 의 주 주파수 — **25MHz**, 75MHz 는 선택 교차 검증 (2026-11-10, [D55-7]). 사다리 비교는 로그 55 §7 · `host/analysis/bathtub_freq_compare.py`
- [x] B1 확대 그림 — 끊긴 축(P1), 한쪽 1,000ps (2026-11-10 영웅님, 로그 55 [D55-3]) · 좌우 벽 겹침. 기존 v1 데이터 — **초안 끝 (2026-11-11)**: `host/analysis/bathtub_p1_figures.py` → `build/bathtub/v1/`(칩 31 · 런 395). v1 데이터를 축만 바꾼 초안이라 build 에만 둔다. 승격할 욕조 그림은 v2 측정 런으로 만든 것 — 원본 `bathtub2_*` 는 `data/`, 그림은 `../results/plots/bathtub/v2/` · 수치는 `../results/data/` 동명 md (2026-11-11 영웅님)
- [x] B2 칩별 평균 · 산포 · 체크포인트별 평균 — `data/` 25MHz 스윕 전부 (`host/analysis/bathtub_stats.py`, 11/10 작업 중) — **끝 (2026-11-11)**: `bathtub_stats.py`(칩별 · 체크포인트별 집계, 칩 전체 추세는 뺌)
- [x] B3 비대칭 · 천장 폭이 마모에 따라 변하나 — 변하면 셀 쪽, 그대로면 출력단 쪽. 기존 체크포인트 스윕 — **끝 (2026-11-11)**: `bathtub_session_trend.py` — 장착 세션 안에서 어느 특징도 우연 이상으로 변하지 않는다(로그 55 §10)
- [ ] B7 외삽 판정 — 벽마다 바깥 꼬리가 하나의 가우시안인지(probit 직선 · 점 3개 이상) · 절반 높이 턱(ISI 부류)이 있는지로 「가능 · 불가 · 부분(가장 바깥 부류만)」 을 자동 판정한다. 그 뒤 승격할 그림을 고른다 (2026-11-11 영웅님 질문)
- [ ] B4 v2 측정 모드 (명세 `../spec/s6.bathtub_v2.md` · 계약 수정안 `../interface/amendments/4.edge_counter_bathtub_v2.md`, 2026-11-11 초안) — 펌웨어 2단계 스윕(훑기 1회 → 벽 집중, K = 5) + RTL 에지 계수기를 한 번에. 표준 N 8,064 · 초심부 N 2,064,384 = 직접 잰 BER 상한 7e-10 (같은 코드, N 만 다름, 천장은 112회 한 묶음 — [D55-4] · [D55-5] · [D55-11]). 초심부도 `_reads.csv` 를 남긴다 ([D55-9]). 체크포인트 스윕은 v1 그대로 ([D55-10]). 가운데를 건너뛰므로 계약 개정이 필요 — 스텝 결측 금지 · START 당 N ≤ 2,048(112 × k 버스트로) · 캡처 완주 검사(END 줄에 행 수) · 한 파일의 n_reads 섞임(분석 스크립트가 v2 파일을 v1 으로 읽지 않게) · 초심부 u32 여유(N × B = 2^32 의 98.4%) · `_reads.csv` 유지([D55-9]). 계수기는 정렬별 여섯 값을 전부 기록하고 해석은 PC — 승자가 아니라 이웃한 정렬 쌍으로 읽는다 ([D55-13] · [D55-16] · [D55-19]). ID 는 그대로, 새 레지스터 `FEATURE`(0x38) ([D55-18]). 구현 · 판정 한영웅, 검토 · 승인 박지민 · 장세은 ([D55-15]). 인수 A5 = 75MHz 실칩, 부류 정답은 같은 런 안에서 정한다 ([D55-17] · [D55-20]). 설계 리뷰 2 반영(로그 55 §10)
- [x] B6 주파수에 따른 ISI 선반 — 기존 45 · 75MHz `_reads.csv` 로 선반을 앞 비트 이력 부류에 맞춘다. 새 측정 없음 ([D55-12], 75MHz 새 측정은 뺐다) — **끝 (2026-11-11)**: `bathtub_isi_shelf.py` — 75MHz 「1 0 1」 상승 · 「1 1 0」 하강, 45MHz 왼쪽 「0 0 1」 상승(로그 55 §10)
- [ ] B5 BASE_SECTOR(계약 수정안 #1) — 닳은 칩에서 닳은 영역 · 안 닳은 영역을 같은 세션에 비교
- [x] chip16 축 결정 [U53-1] — **(나) 온도 축 · 교정 밖으로 승격 (2026-10-12, [D53-4])** — `docs/results/wear/wear_temperature_chip16.md`. 배치 설명(②)이 오면 §1 만 고친다. 원문: 지민 배치 설명을 받은 뒤 (가) 빠른 무리 교정 (나) 온도 런 `--temp` (다) 교정 밖. 그 뒤
  `pe_end.py --chip chip16 [--temp|--no-calib]` 다시 → `--promote` → 해석 문서 · S-1 §15 · 등록부 · 로그 53 닫기. (가)면 v4 교정 표 · LOCO 재생성
- [x] chip14 — **JV 판독 → chip10 과 「JV 둘」 별개 승격 (2026-10-12, [D53-5] · [U48-22] 닫음)**. 세션 로그도 10/12 저녁 수령 → 1단계 다시 · `--promote --overwrite` 끝(창 위치 · 현장 역산 59-60k)
- [x] v4.1 — chip06 100k 자료 수령 → 1단계 → 승격 → 교정 표 추가 → 같은 LOCO 한 번 더(S-5 §9 8번) — **10/12 측정 끝(미등록, [U52-5])**
- [x] 200k 연장 chip06(10/13) · chip09(10/14) — 승격 · `wear/wear_endurance_200k.md` · S-1 §15 추기 · 로그 52 §13 [D52-10]
- [x] chip03 200k(10/16) — 계단 없이 미끄럼 → `wear_endurance_200k.md` §6 · S-1 §15 10/16 추기
- [x] chip15 200k(10/17) — 예측대로 미끄럼 2.25 → `wear_endurance_200k.md` §7 · S-1 §15 10/17 추기
- [x] chip21 0 → 200k(10/19) — 신품 느린데 빠른 노화(chip12 형) → `wear_endurance_200k.md` §8 · S-1 §15 10/19 · 로그 52 [U52-7]
- [x] chip07 200k(10/21) — 1.91배 · 미끄럼 → 200k 문서 §9 (A 행 결손 두 곳)
- [x] chip02 200k · chip22 · 24(85°C) 승격 · 문서화(10/23) — 빠른 FV 7/7 계단, 85°C 상온 산포 안
- [x] v4.3 등록(10/23, [D52-16]) — 머지 · S-5 · S-1. 다음: chip08 블라인드 개봉 · 판정
- [ ] (기록) v4.3 — **답 범위 100k 그대로**, 200k 곡선으로 고마모 과소추정 교정([D52-13]): `A_SESSIONS` 4줄 · 5장 판 측정 **끝(10/19)** — 68% 74 → 79% 개선, 점 추정 0.84 그대로(80k 이상 한정 상한 효과; 지지 200k (가)는 10/20 재 보고 기각 — 과대 1.24 · 폭 2배). **[U52-8] 영웅님 고민 중**(나/마/다) → chip07 · 02 200k 뒤 재측정 · 등록
- [ ] v4.4 — **[U52-7] 느린 신품 두 종류 처리 결정**(가/나/다), chip22 · 23 의 종류 확인 뒤 *(11/1 — 확인됨: chip22 느린 노화 · chip23 chip12 · 21 형, chip23 블라인드 3.5배 과대 — 결정 재료 생김)*
- [x] 3차 구매 10칩 *(10/25 정정 — 6칩)* 신품 전수(10/16 chip21-23 끝, 셋 다 느린 무리) → 배정(10/16 영웅님: chip21 교정 0 → 200k · chip22 65°C 온도 PE 0 → 100k(느린 무리 첫 온도 칩, 교정 밖) · chip23 블라인드, 나머지 7개는 전수 뒤) — 10/19 chip24(빠른) · 25(느린), **10/25 chip26(빠른, 85°C 종단 배정) 으로 FV 신품 측정 끝**(영웅님)
- [x] JV 칩 신품 전수 — **chip30 부터 등록**(10/25 영웅님, 등록부 10/25) — **10/25 chip30-39 10칩 끝**(디바이스마트, 빠른 7 · 느린 3, 집계표 §1 무리 정리)
- [ ] chip08 · chip23 · 새 칩 블라인드 판정 *(11/1 — 85°C 온도 칩 chip26 합격 · chip23 불합격을 정답 봉인 없이 모델 고정 판정으로 끝냄 [D52-17], `docs/results/blind_temp_chip23_chip26.md`. 남은 것 chip08 · 새 칩)*
- [ ] chip26 — 70k 에서 멈춤, 100k 까지 이을지 결정 (지민) · chip23 장부 20k → 26,528 정정 행 (tally 를 읽은 뒤)
- [ ] 소거 시간 양자화 분석(토론 절)
- [ ] 논문 초고

**끝났다는 기준**: 블라인드 판정이 등록한 v4 로 끝나고 논문 제출

## M3 학회 투고

**넣는 것**
- M2 전부
- 다른 제조사 본실험 — 제조사 2-3곳 · 무리마다 여러 칩. 확보: Infineon S25FL128L 5개(MFI010 산업용 둘 · MFV010 확장 온도 셋, 2026-10-05)
- **펌웨어 다중 제조사 대응** — JEDEC 허용 목록(`ps/src/flash_io.c` 의 `ID_MF` · `ID_TYPE` · `ID_CAP` 고정값) · UID 명령(4Bh 는 Winbond 기준) ·
  등록부가 UID 를 칩 정체로 쓰는 부분 · 128Mbit 섹터 배치. 맨 IC 는 SOIC-8 → 핀헤더 변환 기판과 모듈과 같은 주변부품이 필요
- **「모른다」 고 말하는 장치** — 안 닳은 기준 섹터의 지문(프로그램 시간 · 소거 분포 모양 · UID · 날짜 코드)으로 교정 집단 밖 칩을 판정 보류
- 표본 확대 — FPGA 에 SPI 마스터 여럿을 두는 동시 마모 엔진 검토(보드 시간이 병목)
- 물리 검증 — 소거 펄스 수 해석을 모델에 반영할지
- 온도 두세 점

**넣지 않는 것**: NAND · DRAM · SRAM(별도 연구) · 슈무 · 아이 다이어그램은 별도 계측기 논문 후보

**할 일** (M2 뒤에 구체화)
- [ ] 투고처 선정 — 하드웨어 보안(재활용 · 위조 판별) 대 테스트 · 신뢰성
- [ ] 동시 마모 엔진 타당성
- [ ] 다른 제조사 본실험 계획 · 사전 등록

## 범위를 넘는 요청이 오면

1. 어느 마일스톤의 질문에 답하는가 → 그 마일스톤으로 보낸다
2. 데이터 마감 뒤라면 다음 마일스톤으로
3. 어느 질문에도 답하지 않으면(예: DRAM) 「향후 과제」 한 줄로 두고 하지 않는다
