young-0320/flash-margin-bench/docs/concepts/16.edge_counter.md

# 16. 에지 계수기 — 틀린 비트가 상승에서 났나 하강에서 났나

- 작성: 2026-11-10
- 관련 로그: [55](../log/young/55.professor_feedback_bathtub_2026-11-02.md) [D55-13] (설계 결정) · §7 · §9 (천장 = DCD, 선반 = ISI) · §10 [D55-19] (승자 없이 짝으로 읽기) · [D55-20] (75MHz 대조의 정답은 런 안에서)
- 관련 개념: [2. 위상 스윕과 MMCM](2.phase_sweep_and_mmcm.md) · [5. PRBS 패턴](5.prbs_pattern.md) · [7. 프레이밍 정렬](7.framing_alignment.md)
- 관련 코드: `fpga/rtl/flash/flash_rx.v` (지금의 3정렬 비교기 — 계수기는 여기에 붙는다, 아직 미구현)

## 한눈에 — 문제 · 해결 · 원리

### 1. 기존 RTL 계수기의 문제

`flash_rx.v` 는 읽기 한 번(2,048비트)마다 받은 비트열을 정답(PRBS)과 **정렬 3가지** 로 동시에 비교해 정렬마다 틀린 수를 세고(`e0` · `e1` · `e2`), 가장 적게 틀린 값만 낸다 — `e_i = min(e0, e1, e2)`.

- 틀린 비트가 **어느 에지(상승 0 → 1 · 하강 1 → 0)에서** 났는지 남지 않는다. 그래서 「0 과 1 의 pdf」, 「좌우 벽이 왜 다른가」 에 25MHz 에서 답할 수 없다.
- 상승과 하강은 번갈아 나와 개수가 같거나 1개 차이라, 오류 총수로는 가를 수 없다.
- 처음 떠올린 두 해결은 틀렸다.
  - 「앞 비트 → 지금 비트」 로 세기 — 어느 정렬이 이기느냐에 따라 「앞 비트」 가 가리키는 자리가 한 칸 밀려, 같은 원인이 상승으로도 하강으로도 기록된다(리뷰 모의: 하강 49%, 분류 불가 51%).
  - 「정답 비트 0/1」 로만 나누기 — 양쪽 벽 모두 정답 0 이 틀려 벽을 가르지 못한다.

### 2. 해결 방안

- **RTL**: 정렬 3개 각각의 오류 카운터를 정답 비트 0 / 1 로 둘씩 나눈다 — 카운터 3개가 **6개** 가 된다. 읽기가 끝나면 **6개를 전부** 기록한다(정렬별 총 오류 수 3개 + 정렬별 정답 1 오류 수 3개)(로그 55 [D55-16]). 「승자」(가장 적게 틀린 정렬)는 해석에 쓰지 않는다 — 이웃한 두 정렬이 같은 사실의 양면이라 둘 다 쓴다(2026-11-11, [D55-19]).
- **역할 분담**: FPGA 는 판단하지 않고 기록만 한다. PC 가 읽기마다 합이 그 쪽의 전이 수인 이웃 짝 (c − 1, c)을 고르고, 짝의 「지금 비트」 정렬 c 에서 정답 0 오류 = 먼저 온 상승, 정답 1 오류 = 먼저 온 하강으로 읽는다. 해석이 틀려도 재측정 없이 PC 계산만 고친다.
- **원본**: `_reads.csv` 에 읽기마다 여섯 열(`e_c0` · `e_c1` · `e_c2` · `e1_c0` · `e1_c1` · `e1_c2`)이 붙는다. 정답 0 오류 수는 `e_c − e1_c` 로 파생한다(계약 「파생량은 저장하지 않는다」). 항상 `min(e_c0, e_c1, e_c2) = err_count` · `e1_c ≤ e_c` — 실칩 무결성 검사 항목이다([수정안 #4](../interface/amendments/4.edge_counter_bathtub_v2.md) R8 ④⑤).
- **검증**: ① RTL 시뮬레이션(A2)을 실칩과 같은 `flash_top_spi` 경로로 돌려, 상승 · 하강 지터를 달리 넣은 가짜 칩에서 해석이 주입한 에지별 평균 · 폭을 되찾는지 본다. ② 실칩 25MHz(A4)에서 천장 오류 수가 고른 방향(쪽별 하강 수 또는 상승 수)과 계수기 방향을 맞춰 본다. ③ 실칩 75MHz(A5)에서 같은 런의 오류 수로 정한 선반 부류와 대조한다. 셋 다 통과해야 해석을 쓴다.

### 3. 원리

| 원리 | 내용 | 아래 절 |
| --- | --- | --- |
| 스냅샷과 전이 | 샘플은 한 순간의 값이라 0 이나 1 로 고정된다. 전이가 셔터보다 먼저 왔으면 다음 비트, 늦게 왔으면 지금 비트가 찍힌다 | §1 |
| 위상 스윕 | 셔터를 15.87ps 씩 옮겨 한 비트 전체를 훑는다. 전이 근처에서는 지터 · DCD · ISI 로 도착 시각이 흩어져 확률적으로 틀린다 — 이것이 BER 이고 벽이다 | §2 |
| 프레이밍과 정렬 3개 | 수신부는 프리앰블(「0 8개 이상 뒤 첫 1」 = `t0`)로 데이터 시작을 잡는다(`t0 + 4`). 그 1 도 전이라 벽 근처에서 ±1칸 흔들려, `t0 + 3/4/5` 세 출발점으로 다 맞대 보고 가장 적게 틀린 것을 고른다. 어긋난 정렬은 약 절반이 틀려 쉽게 가려진다. **번호 매기기만** 해결하고 흔들림(BER)은 그대로 남아 측정값이 된다 | §3 · [개념 7](7.framing_alignment.md) |
| 정답을 미리 안다 | 데이터가 PRBS 라 각 자리가 상승 · 하강 · 유지 중 무엇인지 측정 전에 안다. 틀린 자리의 정답 비트가 전이 방향을 정한다 | §4 |
| 방향은 정답 비트가 정한다 | 「지금 비트」 정렬에서 정답 0 오류는 먼저 온 상승, 정답 1 오류는 먼저 온 하강이다. 「다음 비트」 정렬에서는 정답 0 이 아직 안 온 하강, 정답 1 이 아직 안 온 상승이다 | 엔지니어링 버전 |
| 짝 = 같은 사실의 양면 | 같은 원인(상승이 먼저 옴)이 「지금 비트」 정렬에서는 「먼저 온 상승」, 「다음 비트」 정렬에서는 「아직 안 온 하강」 으로 적힌다. 둘을 더하면 그 쪽의 전이 전부라, 합으로 짝을 찾고 둘 다 쓴다 — 「승자」 는 필요 없다 | §5 |
| 벽 → pdf | 위상마다 「이 에지 중 셔터보다 먼저 온 비율」 을 센 것이라 벽 곡선은 에지 도착 시각의 누적분포다. 미분하면 상승 · 하강 에지의 pdf 가 따로 나오고, 두 분포의 거리가 DCD(= 천장 폭)다 | 엔지니어링 버전 |

**범위 밖**: 앞 비트 이력(ISI) 부류별 계수는 하지 않는다. 부류 판정은 오류 수를 PRBS 부류 개수와 맞춰 본다.

## 쉬운 버전

### 1. 스냅샷과 전이 — 기차 사진

플래시가 내보내는 데이터는 0과 1이 줄지어 지나가는 기차와 같다. 객차 하나가 비트 하나이고, 25MHz 에서 객차 하나의 길이(UI)는 40,000ps 다. FPGA 는 일정한 간격으로 셔터를 눌러 사진을 찍는다. 이 사진 한 장이 **샘플(스냅샷)** 이다 — 그 순간 데이터선의 전압을 한 번 보고 0 이나 1 로 정한다. 사진 한 장의 값은 언제나 하나로 고정된다.

객차와 객차 사이 이음매에서 값이 바뀌는 순간이 **전이** 다. 0 에서 1 로 바뀌면 **상승 에지**, 1 에서 0 으로 바뀌면 **하강 에지**, 같은 값이 이어지면 전이가 없다(유지).

```
시간 →
데이터선:  0 0 0 0 0 0 0 ┐1 1 1 1 1 1
                         ↑ 전이 (선이 0→1 로 바뀐 순간)

셔터 A:   ↑                       → 0 이 찍힌다 (전이가 셔터보다 늦다)
셔터 B:                      ↑    → 1 이 찍힌다 (전이가 셔터보다 먼저 왔다)
```

**「전이가 셔터보다 먼저 왔다」** 는 선이 바뀐 순간이 사진 찍은 순간보다 앞섰다는 뜻이다. 그러면 사진에는 바뀐 뒤 값(다음 비트)이 찍힌다. 늦게 왔다면 바뀌기 전 값(지금 비트)이 찍힌다.

### 2. 정상은 두 전이 사이, 위상 스윕은 일부러 전이를 찍는다

실제 SPI 장치는 앞 전이가 지나고 다음 전이가 오기 전, 두 전이 사이 한가운데서 찍는다. 그러면 값이 안정돼 있어 항상 맞다. 욕조 곡선의 **바닥**(오류 0)이 이 구간이다.

위상 스윕([개념 2](2.phase_sweep_and_mmcm.md))은 셔터 위치를 15.87ps 씩 옮겨 한 비트 전체를 훑는다. 그러다 셔터가 전이 근처에 오면 문제가 생긴다. 전이가 오는 시각은 매번 조금씩 다르기 때문이다.

- **지터** — 같은 종류의 전이라도 수 ps 씩 들쭉날쭉 온다 (25MHz 벽에서 σ 약 12ps).
- **DCD(duty cycle distortion)** — 상승 에지와 하강 에지의 평균 도착 시각이 다르다.
- **ISI(inter-symbol interference)** — 직전 비트들이 무엇이었느냐에 따라 도착 시각이 또 달라진다. 「1 0 1」 의 상승과 「0 0 1」 의 상승은 같은 상승이라도 도착 시각이 다르다.

그래서 셔터를 전이 근처에 두면 어떤 전이는 셔터보다 먼저 오고 어떤 전이는 늦게 온다. 같은 위상이라도 확률적으로 맞기도 틀리기도 한다. 이 확률이 BER 이고, BER 이 오르내리는 구간이 욕조의 **벽** 이다.

### 3. 정렬 3개 — 번호 매기기 문제

수신부(`flash_rx.v`) 손에는 두 줄이 있다.

- **받은 줄** — 셔터로 차례로 찍은 비트열
- **정답 줄** — 와야 할 PRBS 비트열. 플래시에 써 둔 데이터라 미리 안다([개념 5](5.prbs_pattern.md))

둘을 한 글자씩 맞대어 다른 곳을 세면 오류 수다. 그런데 **받은 줄의 몇 번째 글자부터 정답 줄의 첫 글자와 맞댈지** 를 정확히 모른다.

플래시는 데이터 앞에 시작 표시(프리앰블)를 보낸다. RTL 은 「0 이 8개 이상 이어진 뒤 처음 나온 1」 을 시작 표시로 잡고(이 위치가 `t0`), 거기서 4칸 뒤부터 진짜 데이터라고 본다(`t0 + 4`). 그런데 이 「처음 나온 1」 도 0 에서 1 로 바뀌는 전이다. 위상이 벽 근처면 이 전이도 먼저 오기도 늦게 오기도 해서, 수신부가 잡는 시작 위치가 실제보다 한 칸 이르거나 늦을 수 있다.

그래서 수신부는 세 출발점으로 다 맞대 본다.

| 이름 | 출발점 | 뜻 |
| --- | --- | --- |
| 한 칸 앞 | `t0 + 3` | 데이터가 예상보다 한 샘플 일찍 시작했다고 보고 맞댄다 |
| 제 번호 | `t0 + 4` | 예상한 자리에서 시작했다고 보고 맞댄다 |
| 한 칸 뒤 | `t0 + 5` | 데이터가 예상보다 한 샘플 늦게 시작했다고 보고 맞댄다 |

한 칸 어긋나게 맞대면 PRBS 는 무작위에 가까워 **약 절반이 틀린다**(읽기 한 번 2,048비트 중 1,000개 안팎). 맞는 출발점은 벽 근처의 진짜 오류 몇 개만 틀린다. 그래서 셋을 동시에 세고 **가장 적게 틀린 것을 진짜로 고른다** — 이것이 **승자 정렬** 이고, 그 오류 수가 지금 CSV 의 `bit_errors` 다.

> 주의 — 3정렬은 「흔들림」 을 보정하지 않는다. 번호 매기기(어디서부터 맞대나)만 해결한다. 전이 근처의 확률적 오류는 그대로 남고, 그것이 우리가 재려는 값이다.

### 4. 오류 총수만으로는 어느 에지에서 틀렸는지 모른다

0 과 1 두 값뿐인 신호라서 상승 다음 전이는 반드시 하강이고, 하강 다음은 반드시 상승이다. 그래서 상승 자리 수와 하강 자리 수는 **항상 같거나 1개 차이** 다. 25MHz 에서 오류 총수를 보고 「왼쪽 벽은 상승 에지, 오른쪽 벽은 하강 에지」 라고 가를 방법이 없다.

### 5. 같은 원인이 정렬에 따라 다르게 적힌다

상승 에지가 하강 에지보다 일찍 오는 칩에서, 셔터가 「상승은 지났고 하강은 아직」 인 위치에 있다고 하자. 데이터가 `0 1 1 0 1` 이면 경계는 상승, 유지, 하강, 상승이다.

```
찍힌 샘플:                     1   1   1   1
「지금 비트」 정렬로 맞댄 정답:   0   1   1   0   → 1번째 · 4번째가 틀림 = 상승 자리, 정답 0
「다음 비트」 정렬로 맞댄 정답:   1   1   0   1   → 3번째가 틀림        = 하강 자리, 정답 0
```

「다음 비트」 정렬은 번호가 하나 작은 정렬이다. RTL 은 같은 샘플을 정렬 0 은 `prbs[k−3]`, 1 은 `prbs[k−4]`, 2 는 `prbs[k−5]` 와 맞대므로 번호가 작을수록 뒤의 정답과 맞댄다 — 「제 번호」(`t0 + 4`)가 지금 비트면 다음 비트는 「한 칸 앞」(`t0 + 3`)이다.

물리적 원인은 하나(상승이 일찍 왔다)인데 기록은 둘로 갈린다. 「지금 비트」 정렬로 보면 「먼저 온 상승」, 「다음 비트」 정렬로 보면 「아직 안 온 하강」 이다. 둘 다 같은 사실의 양면이다 — **이 위상은 상승이 지나간 뒤이고 하강이 오기 전이다.**

그래서 둘 중 하나를 고를 필요가 없다. 「지금 비트」 정렬은 셔터보다 먼저 온 전이를, 「다음 비트」 정렬은 아직 안 온 전이를 세므로 **둘을 더하면 그 쪽의 전이 전부** 다. 정렬 번호는 위상에 따라 옮겨 가는 이름표라(§3 의 시작 표시가 한 칸 흔들린다) 번호로는 고르지 않는다. 합이 쪽의 전이 수와 같은 이웃 짝을 찾으면, 그 짝의 번호 큰 쪽이 「지금 비트」 다.

### 6. 그래서 계수기는 이렇게 생겼다

읽기 한 번(2,048비트)이 끝날 때마다 FPGA 가 정렬 셋 각각에 대해 두 숫자를 남긴다 — 모두 여섯 개다.

1. **그 정렬로 맞댔을 때 틀린 수** (정렬마다 하나, 셋)
2. **그중 정답이 1 이던 자리의 틀린 수** (정렬마다 하나, 셋). 정답 0 쪽은 1번에서 빼면 나온다

어느 두 정렬이 짝인지는 PC 가 여섯 숫자를 보고 찾는다. FPGA 는 판단하지 않고 기록만 한다. 「그래서 상승이 일찍 왔다」 같은 해석은 PC 가 아래 해석표로 한다. 해석이 틀렸다면 재측정 없이 PC 계산만 고치면 된다.

## 엔지니어링 버전

### 원본에 남는 것

`_reads.csv` 에 읽기마다 열 여섯이 는다(계약은 [수정안 #4](../interface/amendments/4.edge_counter_bathtub_v2.md)).

| 열 | 뜻 |
| --- | --- |
| `phase_step` · `read_idx` · `err_count` | 지금 그대로 (위상 · 읽기 번호 · 셋 중 최소 오류 수 = v1 의 `e_i`) |
| `e_c0` · `e_c1` · `e_c2` | 정렬 0 = 한 칸 앞(`t0 + 3`) · 1 = 제 번호(`t0 + 4`) · 2 = 한 칸 뒤(`t0 + 5`) 로 맞댔을 때의 오류 수 |
| `e1_c0` · `e1_c1` · `e1_c2` | 그 정렬에서 정답 비트가 1 이던 자리의 오류 수 |

정답 0 쪽 오류 수는 `e_c − e1_c` 로 계산한다 — 저장하지 않는다. `min(e_c0, e_c1, e_c2) = err_count` 와 `e1_c ≤ e_c` 가 항상 성립해야 하고, 실칩 무결성 검사 항목이다. 하나 더 — `e_c − 2·e1_c` 는 (창 안에 받은 1 의 수) − (정답 1 의 수)라, 정렬끼리의 차이가 정렬 번호 차이를 넘을 수 없다(창이 정렬 하나에 한 샘플씩 밀릴 뿐이다). 정답 0 · 1 을 뒤바꿔 세면 이것이 깨진다([수정안 #4](../interface/amendments/4.edge_counter_bathtub_v2.md) R8 ④⑤⑥).

**구조** — RTL 은 같은 샘플(`cc = k`)을 정렬 0 은 `prbs[k−3]`, 1 은 `prbs[k−4]`, 2 는 `prbs[k−5]` 와 맞댄다. 번호가 하나 작은 정렬이 한 비트 뒤의 정답과 맞대므로 **「다음 비트」 정렬 = 「지금 비트」 정렬 − 1** 이다. 어느 번호가 「지금 비트」 인지는 위상에 따라 옮겨 간다 — 아래 「주의」.

RTL 은 정렬마다 카운터를 정답 0 · 1 로 나눠 **6개(3 × 2)** 를 두고 여섯 값을 전부 내보낸다. 처음 안(승자 번호 + 승자의 정답 1 오류 수만 내기)은 동률이면 RTL 의 min 순서(작은 번호)가 승자를 정해, 그 규칙이 해석에 끼어들 수 있었다. 전부 기록하면 그런 일이 없고, 원본은 초심부 스윕당 약 1GB 에서 약 1.7GB 로 는다(로그 55 [D55-16]). 그다음 안(PC 가 승자를 고른다)도 버렸다 — 천장에서는 두 정렬이 모든 읽기에서 비겨 승자가 서지 않고, 짝으로 읽으면 승자가 아예 필요 없다(로그 55 [D55-19]).

비트별 참/거짓은 남기지 않는다. 초심부 한 스윕이 약 4,000만 회 읽기 × 2,048비트라 UART 로 보낼 수 없고, 해석에 필요한 것은 개수뿐이다.

### 방향은 정답 비트 하나로 정해진다

어느 정렬로 맞대든, 그 정렬 기준으로 오류가 나는 경우는 셔터가 **이웃 비트** 를 찍었을 때뿐이다.

| 셔터가 찍은 것 | 원인 | 정답 0 인 자리 | 정답 1 인 자리 |
| --- | --- | --- | --- |
| 다음 비트 | 다음 전이가 **일찍** 옴 | 0 → 1, 상승이 일찍 | 1 → 0, 하강이 일찍 |
| 앞 비트 | 앞 전이가 **늦게** 옴 | 1 → 0, 하강이 늦게 | 0 → 1, 상승이 늦게 |

「지금 비트」 정렬에서 틀린 자리는 셔터가 다음 비트를 찍은 자리(전이가 먼저 옴)이고, 「다음 비트」 정렬에서 틀린 자리는 그 정렬 기준으로 앞 비트를 찍은 자리(전이가 아직 안 옴)다. 그래서 틀린 자리의 **정답 비트가 전이의 방향을, 짝의 어느 쪽인지가 「먼저 온 것 · 아직 안 온 것」 을** 알려 준다. 두 에지의 꼬리가 같은 위상에서 겹쳐도 상승 · 하강의 누적분포가 따로 나온다.

주의 — 실칩에서는 시작 표시(프리앰블)를 칩이 보내지 않는다. `flash_spi_shim.v` 가 마스터의 데이터 창 예고(`pay`)를 받아 FPGA 안에서 「1 1 1 1」 을 합성한다. 그래서 `t0` 는 데이터 에지가 아니라 `pay` 가 `clk_sample` 로 건너오는 CDC 지연이 정하고, 위상이 그 경계를 지날 때 **정렬 번호가 한 칸 옮겨 간다** — 칩과 상관없는 자리다. 데이터 쪽도 덩어리를 지나면 셔터가 다음 비트로 넘어가, 덩어리 왼쪽 바닥에서 오류 0 이던 정렬보다 오른쪽 바닥의 것이 번호가 하나 작다. 위상축은 원형이라 두 이동이 한 바퀴에 한 번씩 서로 상쇄하고, `t0` 이동이 덩어리 안에 떨어지면 좌우 바닥의 번호가 같아진다. 그래서 정렬 번호를 고정 의미로 읽지 않고, 읽기마다 합으로 짝을 찾는다. 루프백은 프리앰블이 선을 타고 오므로 이 이동을 재현하지 못한다 — A2 는 `flash_top_spi` 경로로 돌린다.

### 해석표 — 짝 안의 정렬 × 정답 비트

읽기마다 이웃 짝 (c − 1, c) 중 `e_(c−1) + e_c` 가 그 쪽의 전이 수와 같은 짝을 고른다(쪽 끝 전이가 먼저 왔으면 1 이 더해진다). 어긋난 정렬은 약 절반이 틀려, 다른 짝은 합이 크게 다르다. 짝의 번호 큰 쪽 c 가 「지금 비트」, 작은 쪽 c − 1 이 「다음 비트」 다.

| 정렬 | 틀린 자리의 정답 | 그 자리의 전이 | 뜻 |
| --- | --- | --- | --- |
| 지금 비트 c | 0 | 0 → 1 상승 | 셔터보다 **먼저 온** 상승 |
| 지금 비트 c | 1 | 1 → 0 하강 | 셔터보다 **먼저 온** 하강 |
| 다음 비트 c − 1 | 0 | 1 → 0 하강 | **아직 안 온** 하강 |
| 다음 비트 c − 1 | 1 | 0 → 1 상승 | **아직 안 온** 상승 |

그래서 위상마다 상승의 「먼저 온 비율」 = (`e_c − e1_c`) ÷ 쪽 상승 수, 하강 = `e1_c` ÷ 쪽 하강 수가 바로 나온다. 「다음 비트」 정렬의 두 값은 그 나머지라 검산이 된다. 천장을 포함한 모든 위상에서 성립한다 — 천장에서는 두 정렬이 모든 읽기에서 비기는데(쪽 경계 전이 몫 0-1 차이), 짝으로 읽으면 어느 쪽이 이겼는지가 필요 없다. 이 표는 설계 단계의 유도이고, **RTL 시뮬레이션(A2)과 실칩 대조(A4 · A5)로 확정한다**.

### 위상을 쓸고 지나가면

상승이 하강보다 일찍 오는 칩이라면 위상(셔터 시각)을 왼쪽에서 오른쪽으로 옮길 때 이렇게 찍힌다.

| 위상 위치 | 무슨 일이 일어나나 | 기록 |
| --- | --- | --- |
| 바닥 (왼쪽) | 셔터가 모든 전이보다 이르다 | 오류 0 |
| 왼쪽 벽 | 가장 일찍 오는 상승 몇 개만 셔터를 앞지른다 | 「지금 비트」 정렬의 정답 0 오류가 0 에서 오른다 → **상승 에지의 앞쪽 꼬리** |
| 천장 | 상승은 전부 지났고 하강은 아직이다 | 「지금 비트」 = 쪽 상승 전부(정답 0), 「다음 비트」 = 쪽 하강 전부(정답 0). 두 정렬이 비긴다 (BER 약 0.25) |
| 오른쪽 벽 | 가장 늦게 오는 하강 몇 개만 아직 안 왔다 | 「지금 비트」 정렬의 정답 1 오류가 쪽 하강 수로 오른다 · 「다음 비트」 정렬의 정답 0 오류가 0 으로 내려간다 → **하강 에지의 뒤쪽 꼬리** |
| 바닥 (오른쪽) | 모든 전이가 지났다 | 「다음 비트」 정렬 오류 0 — 덩어리 안에 `t0` 이동이 없으면 왼쪽 바닥에서 오류 0 이던 정렬보다 번호가 하나 작다 |

두 정렬 중 오류가 적은 쪽(RTL 의 min)의 정답 1 오류가 덩어리 내내 0 이라는 것이 「상승이 먼저 온다」 는 판정이다 — 왼쪽은 「지금 비트」, 오른쪽은 「다음 비트」 정렬이 적은 쪽이다. 반대 칩이면 그 자리에 정답 1 쪽(`e1`)이 찍힌다.

> **2026-11-11 — 시뮬레이션이 고친 것 (A2, 로그 55 §11).** 「짝은 하나」 가 아니다. 오류 0 정렬이 1 인 바닥과 꼬리에서는 두 짝이 다 맞는다 — 그때는 덩어리 중심 왼쪽은 정렬 1, 오른쪽은 정렬 2 를 「지금 비트」 로 쓴다. 합의 여분은 0-2 다. 그리고 방향은 천장 오류 수가 상승 수냐 하강 수냐가 아니라, 고른 짝의 「지금 비트」 정렬이 `e1 = 0` 이냐 `e1 = e` 냐로 정한다.

천장 BER 이 0.25 인 이유: PRBS 는 비트의 약 절반이 전이 자리이고, 그 절반이 한쪽 방향이다. 천장에서는 한쪽 방향 전이가 전부 틀리므로 약 1/4 이다. 실측 천장 오류 수가 쪽별 하강 전이 수(112읽기 기준 56,572)와 25MHz 395런 중 386런에서 정확히 같다(로그 55 §7 추기). 상승 수(56,460)인 런도 있다 — 쪽 0-111 은 모두 1 로 시작해 0 으로 끝나 쪽마다 하강이 상승보다 1 많은데, 상승이 먼저 온 칩은 쪽 끝 상승(다음 쪽 첫 비트 1)이 「지금 비트」 쪽에 더해져 두 정렬이 하강 수로 비기고, 하강이 먼저 온 칩은 「다음 비트」 쪽(상승 전부)이 1 작아 min 이 상승 수가 된다. 그래서 25MHz 에서도 천장 오류 수가 방향을 하나 알려 준다(유도 — 수정안 #4 A2 · A4 에서 확인).

### 벽에서 pdf 로

위상 한 칸마다 「상승 전이 중 셔터보다 먼저 온 비율」 을 센 것이므로, 왼쪽 벽 곡선은 상승 에지 도착 시각의 **누적분포(CDF)** 다. 오른쪽 벽은 하강 에지의 누적분포를 반대쪽에서 본 것이다. 이를 위상으로 미분하면 **상승 에지의 pdf 와 하강 에지의 pdf 가 따로** 나온다.

- 두 분포의 거리 = 천장의 폭 = **DCD**
- 각 분포의 퍼짐 = 에지별 지터

교수님의 「0 과 1 의 pdf」 질문(로그 55 §1 3번)을 출력 에지 기준으로 답하는 방법이다. 셀 문턱 전압 분포 가설과는 다른 쪽이라, 둘 중 어느 것이 맞는지가 이 측정으로 갈린다.

### 이 계수기가 못 하는 것

- **앞 비트 이력(ISI) 부류는 못 나눈다.** 「1 0 1 의 상승」 과 「0 0 1 의 상승」 은 같은 칸에 들어간다. 부류는 지금처럼 오류 수를 PRBS 부류별 개수와 맞춰 본다 — 75MHz 에서 평평한 왼쪽 선반 = 27,952 = 「1 0 1」 상승 27,840 + 쪽 경계 상승 112, 오른쪽 선반 = 28,119 = 「1 1 0」 하강 28,008 + 쪽 머리 하강 111 로 확인됐다(27,840 · 28,008 은 선반 바깥 1-3스텝의 턱이다). 45MHz 왼쪽 선반은 「0 0 1」 상승(28,620, 112읽기 모두 일치)이다. 같은 칩이라도 배선이 바뀌면 부류가 바뀐다 — chip07 2026-09-29 75MHz 는 두 선반이 다 하강 부류였다. 부류별 하드웨어 계수기는 [D55-8] 범위 밖이다.
- **비트 위치는 모른다.** 읽기 한 번 안에서 몇 번째 비트가 틀렸는지는 남지 않는다.

### 처음 정의가 왜 틀렸나 — 「앞 비트 → 지금 비트」

처음에는 정렬과 상관없이 「앞 비트가 0 이고 지금 비트가 1 이면 상승 자리」 로 세려 했다. 그런데 §5 처럼 어느 정렬이 이기느냐에 따라 「앞 비트」 가 가리키는 자리가 한 칸 밀린다. 리뷰 모의에서 상승만 일찍 오는 칩을 넣었더니 이 계수기는 「하강 49%, 분류 불가 51%」 를 냈다(로그 55 §9 R1). 「정답 비트 0/1」 만으로는 어느 에지가 먼저인지까지는 나오지만, 양쪽 벽 모두 정답 0 이라 겹치는 구간에서 상승 · 하강의 누적분포를 나누지 못한다. 정렬별 기록을 **함께** 남겨야 풀린다.

### 흔한 오해

| 오해 | 실제 |
| --- | --- |
| 계수기는 0 과 1 의 개수를 센다 | 틀린 비트를 정답 0 · 정답 1 로 나눠 센다 |
| 3정렬은 흔들림을 보정한다 | 번호 매기기만 맞춘다. 흔들림(BER)은 그대로 남아 측정된다 |
| 셔터는 전이 이후에 찍어야 정상이다 | 두 전이 사이에서 찍는 것이 정상이다. 위상 스윕은 일부러 전이를 찍는다 |
| 상승 다음엔 하강만 온다는 규칙으로 방향을 안다 | 그 규칙은 「총수로는 못 가린다」 는 문제를 만든 쪽이다. 방향은 「정답을 미리 안다」 로 안다 — 틀린 자리의 정답 비트 |
| 동률 규칙이 방향 판정을 왜곡한다 | 방향은 정답 비트가 정하므로 동률과 무관하다. 게다가 v2 는 정렬별 값을 전부 남기고 「승자」 를 쓰지 않는다 — 합으로 찾은 짝을 둘 다 쓴다 |
