young-0320/flash-margin-bench/docs/spec/s1.wear_bench_spec.md

# S-1. 스트레스 벤치 사양서

- **수신자**: 장세은 (구현) — `ps/src/`
- **인수 판정**: 한영웅 (§13)
- **작성**: 2026-08-23 · **개정**: 2026-08-23 (건조판) · 2026-09-16 (§12 시간 예산 — 스윕 1회 실측 반영) ·
  2026-09-18 (§1 마모 패턴 — 파라미터화, 파일럿 `0x00` 확정) ·
  2026-09-18 (§8.2·§8.3 재개 판정 — 「큰 쪽 채택」 폐기 · 2벌 병합 신설 · `d` 3구간) ·
  2026-09-21 (§8.1 초기화 — 그 소거 도구가 엔진 경계 10 `tally_erase` 임을 명시) ·
  2026-09-18 (§1 계수 — 카운터는 마모 루프만, 체크포인트 P/E 는 영역별 누적으로) ·
  2026-09-19 (§6·§7 — 검사 사이클만 「프로그램 → 검사 → 소거」로 분기 ·
  blank check 는 부를 때 읽어서 센다) ·
  **2026-09-21** (§6 ⑥ A 행 출력 단계 · §7 합 불변식은 `0x00`·같은 읽기 한정 · §8.3 6 재개는
  `wear_start(cycle=채택값)` · §9 B 행 phase 분리 · R 사건 로그 · §10 사람 정지 —
  지민 회신 2026-09-20 과 `docs/log/young/44.pe_engine_prebuild_review.md`)
- **채택 근거**: 본 문서는 수치만 싣는다. 각 값을 왜 그렇게 정했는지는
  `docs/log/young/17.wear_bench_spec_finalization.md`
- **전제**: 계약 수정안 [#1](../interface/amendments/1.base_sector.md)(BASE_SECTOR) ·
  [#2](../interface/amendments/2.n_reads_112.md)(N=112). #1 미승인 시 §14

---

## 1. 1사이클 정의

| 항목 | 값 |
| --- | --- |
| 구성 | ① 0x00 프로그램 112페이지 → ② 7섹터 소거 |
| 마모 패턴  | **파라미터** (`WEAR_PAT_EVEN`/`WEAR_PAT_ODD` 레지스터 2개). **파일럿 고정값 `0x00`** — 아래 |
| 시간 (typ) | 7 × 45ms + 112 × 0.8ms =**405ms** |
| 계수 | 프로그램+소거 1쌍 = 1사이클. 체크포인트의 소거+PRBS 기록도 1사이클이지만 **영역별 누적**(§9 C `area_cumulative_cycles`)에만 넣는다 — 엔진의 사이클 카운터(§13 A1)는 **마모 루프만** 센다 |

> **2026-09-18 개정 — 마모 패턴은 파라미터(옵션화하여 패턴 선택할 수 있도록)다.** 2026-09-15 3인 회의에서 체커보드
> (`0x55`/`0xAA` 교대)도 **채택**해 본 실험은 여러 패턴으로 읽고 쓴다. 다만
> **파일럿은 마모 그룹이 하나뿐(§2.1)이라 패턴도 하나**이고 `0x00` 으로 확정했다
> (2026-09-18, 한영웅). 레지스터 설계와 "한 wear 그룹 안에서 패턴 변경 금지"는
> `docs/log/young/29.pe_engine_layer_decisions.md` `[D29-7]`.
>
> **2026-09-18 개정 — 세는 자리를 가른다** (한영웅). 체크포인트의 소거+PRBS 도 마모라는
> **사실은 그대로**이고, 그것을 **카운터가 아니라 영역별 누적에 기록한다.** §13 A5 가
> 「카운터 · A 로그 행수÷7 · B 의 cycle · **tally×100** 이 전부 100」을 요구하는데 tally 는
> 마모 루프 100사이클마다 1바이트이므로(§8.1), **카운터가 체크포인트까지 세면 A5 가
> 성립하지 않는다.** §13 은 이미 마모 루프를 전제로 쓰여 있었고 이 표의 계수 문구만
> 그것을 안 갈라 두었다. 경위는 `docs/spec/s4.blackbox_tb.md` §5.1 제안-8.
>
> **보류 둘** (2026-09-18, 한영웅).
> ① **본 실험 3그룹(§2.2)에 패턴과 목표 사이클을 어떻게 배정하나** — 축이 둘인데 그룹이
> 셋이라 하나를 고정하거나 그룹을 늘려야 한다.
> ② **패턴 간 비교를 사이클 수로 맞추나 누적 1→0 전이 수로 맞추나** — `0x00` 은 셀당
> 8비트, `0x55` 는 4비트가 1→0 이라 같은 300k 면 스트레스가 2배 다르다.

---

## 2. 영역 배치

### 2.1 파일럿 (확정)

```
섹터     0 ~     6   마모 그룹      BASE_SECTOR = 0
섹터     7 ~    13   근접 대조군    BASE_SECTOR = 7
섹터 2,041 ~ 2,047   원격 대조군    BASE_SECTOR = 2,041
섹터   512           tally #1       측정 안 함
섹터 1,536           tally #2       측정 안 함
```

### 2.2 본 실험 (잠정 — §15 파일럿 후 확정)

```
섹터     0 ~     6   마모 그룹 1    BASE_SECTOR = 0
섹터     7 ~    13   마모 그룹 2    BASE_SECTOR = 7
섹터    14 ~    20   마모 그룹 3    BASE_SECTOR = 14
섹터    21 ~    27   근접 대조군    BASE_SECTOR = 21
섹터 2,041 ~ 2,047   원격 대조군    BASE_SECTOR = 2,041
섹터   512 / 1,536   tally ×2       측정 안 함
```

**그룹 수·그룹별 목표 사이클·그룹별 패턴은 미정** (§1 개정 주석 · §15).

### 2.3 영역 규칙

| 영역 | 크기 | 소거 반복 | 스윕 측정 | PRBS 기록 |
| --- | --- | --- | --- | --- |
| 마모 그룹 | 7섹터 = 112페이지 | O | O | 체크포인트마다 |
| 대조군 (근접·원격) | 7섹터 | X | O | **체크포인트마다** |
| tally | 1섹터 × 2 | X (초기 소거 1회) | X | X |

- 완충 섹터를 두지 않는다
- 대조군은 체크포인트마다 소거+PRBS 재기록 → 대조군 누적 마모 = 체크포인트 수
- `flash_prep`·스캔 코드는 tally 섹터를 **하드 가드**로 제외한다
- tally는 실험 종료 시 해제한다 (§8.4)

---

## 3. 측정 조건

| 항목 | 값 |
| --- | --- |
| N (위상당 읽기) | **112** |
| B (읽기당 비트) | 2,048 (1페이지) |
| BASE_SECTOR | 영역별 (§2) |
| 클럭 | 25MHz |
| 측정 패턴 | **PRBS-15**, 시드 {1, page[13:0]} |
| θ 기록 | 10⁻², 10⁻³, 10⁻⁴ |
| 반복 — 파일럿  | **1회**. 단 처음·중간·끝 3개 지점만 **3회** |
| 반복 — 본 실험 | **3회** (파일럿 결과에 따라 5회로 상향 가능, §15) |
| 사전 등록 확인  | σ_width @ N=112 =**0.16 / 0.34 / 1.35 ps** (θ=10⁻²/10⁻³/10⁻⁴, σ_j=11ps) — 규칙 한계 7.9ps 통과 |

---

## 4. 초기화 (실험 시작 시 1회)

```
1. UID 읽기 (4Bh) → 등록부 대조. 미등록이면 중단
2. tally 섹터 2개 소거 → 전체 0xFF 확인
3. 대조군 전 영역에 PRBS15 프로그램 → verify
4. 마모 그룹 전 영역에 PRBS15 프로그램 → verify
5. 신품 blank check 1회 → 출고 시점 결함 비트 기록 (주소 포함)
6. 체크포인트 0 측정
```

---

## 5. 체크포인트 절차

### 5.1 마모 그룹 (그룹마다)

```
1. 그룹 7섹터 소거
2. PRBS15 프로그램 112페이지 → verify
3. 스윕 (N=112, BASE_SECTOR=그룹 시작) × 반복 횟수
4. 사이클 카운터 +1
```

### 5.2 대조군 (근접·원격 각각)

```
1. 7섹터 소거
2. PRBS15 프로그램 112페이지 → verify
3. 스윕 (N=112, BASE_SECTOR=21 또는 2,041) × 반복 횟수
4. 해당 대조군의 누적 사이클 +1 (로그에 기록)
```

---

## 6. 마모 루프

```
반복 {
    ① 0x00 프로그램 112페이지          → t_program_us 기록
   ①' 검사 주기 사이클이면 여기서       → program_fail_bits (§7)
        112페이지를 읽어 기대 패턴 대조     ※ 소거 전이라야 한다
    ② 7섹터 소거                        → 섹터별 t_erase_us 기록
    ③ 사이클 카운터 +1                  ※ 마모 루프만 센다 (§1)
    ④ 검사 주기 도달 시 (§7):
         - blank check (소거 직후 읽기 → erase_residual_bits)
         - tally 바이트 기록 (2벌 모두)
         - 다이 온도 읽기
         - UID 재확인
    ⑤ 체크포인트 도달 시 → 엔진은 멈추고 checkpoint_due (§5 는 호스트가 한다), 다음 체크포인트 산정 → §11
    ⑥ 이 사이클의 A 행 7개 출력 (검사 사이클이면 뒤에 B 행 1개)   ※ 매 사이클 실시간
}
```

> **2026-09-21 개정 — ⑥ 출력 단계를 넣었다 (S-4 §5.1 제안-6, 지민 회신 §4).** 종전 루프에는
> 출력 단계가 없어 A2 의 700행이 호스트에 닿는 경로가 문장에 없었다. 매 사이클 실시간이어야
> §8.3 의 `d` 규칙이 선다. ⑤ 의 「→ §5」는 엔진이 스윕을 부른다는 뜻이 아니다 — 엔진은
> `checkpoint_due` 로 멈추고 §5 는 호스트 도구가 한다 (`docs/interface/pe_engine.md` §2.1).

소거 시간은 **WIP 비트가 서 있는 구간의 지속시간**을 XTime으로 측정한다.

> **2026-09-19 개정 — 검사 사이클만 「프로그램 → 검사 → 소거」로 분기한다(①').**
> §7 은 `program_fail_bits` 를 *"프로그램 직후"* 에 재라고 하는데 이 루프는 검사를 ④
> 한 곳에 두어 **소거가 끝난 뒤** 였다. 그 시점엔 기대 패턴이 사라져 §7 의 그 줄이
> **실행될 수 없는 문장** 이었다 — 두 절이 어긋나 있었다. 읽기가 느는 것은 검사 주기
> (100사이클)뿐이고 나머지 99사이클은 그대로다.
>
> **그 사이클의 A 행 시간 정의가 달라진다.** ①' 의 읽기는 P/E 가 아니므로
> `t_program_us`·`t_erase_us` 에 **넣지 않는다** — 넣으면 A6(소거 시간)의 분포에
> 100사이클마다 한 번씩 튀는 점이 생긴다 (2026-09-19, 한영웅 · 로그 42 `[U42-3]`).

---

## 7. 무결성 검사 (blank check)

```
소거 직후    : 112페이지 읽기 → 0xFF가 아닌 비트    = erase_residual_bits
프로그램 직후: 112페이지 읽기 → 기대 패턴과 다른 비트 = program_fail_bits
```

| 항목 | 값 |
| --- | --- |
| 기본 주기 | **100사이클** |
| 조밀화 주기 | **10사이클** |
| 조밀화 트리거 | 결함 비트**1회 검출** |
| 1회 비용 | 약 176ms (실측 확인 대상) |

- 결함 비트의 **주소를 기록**한다. 초기엔 전량, 한 검사에서 64개 초과 시 처음 64개 + 총 개수
- 영구/일시 판정은 하지 않는다. 재현 횟수는 사후 분석에서 다룬다
- **두 숫자는 부를 때 실제로 읽어서 센다.** 마지막 결과를 캐시해 두지 않는다. 호스트는
  체크포인트(소거 직후)에 `blank_check` 를 불러 **세는 경로가 살아 있는지** 를 본다 —
  그 자리에서 `program_fail_bits` 의 정답은 `바이트 수 × popcount(~pattern)` (패턴 `0x00`
  이면 전량 229,376) 이다 (2026-09-19 추가 · 2026-09-21 정정)

> **2026-09-21 정정 — 합 불변식은 조건부다** (지민 회신 §5.1, 로그 44 `[D44-7]`). 종전 문장
> 「`erase_residual + program_fail = 전량` 이 항상 성립」은 **패턴 `0x00` 이고 두 값이 같은
> 읽기에서 나왔을 때만** 참이다. 기대 비트가 1인 자리에서는 두 값이 같은 것을 세므로 `0x55`
> 에서 깨지고, B 로그의 두 값은 프로그램 직후·소거 직후의 **서로 다른 두 읽기** 라 B 행에는
> 애초에 적용되지 않는다. 경로 점검은 위 `probe` 기대값으로 한다.

> **왜 이 한 줄이 필요한가.** 신품 100사이클에서는 `program_fail_bits = 0` 이 **정답** 이라,
> 「제대로 재고 0」과 「세는 경로가 죽어서 0」이 로그에서 같아 보인다 — 관측값이 정답과
> 같으면 그 관측에는 정보가 없다. 체크포인트(소거 직후)에 호스트가 blank check 를 부르면
> `program_fail_bits` 가 **전량** 이어야 하므로, 거기서 `0` 이 나오면 경로가 죽은 것이다.
> **정답에서 제일 먼 값이 나오는 자리** 를 일부러 고른 것이다 (로그 42 §8).

---

## 8. 카운트 영속화 (tally)

### 8.1 방식

| 항목 | 값 |
| --- | --- |
| 초기화 | 실험 시작 시 tally 섹터 2개를 각 1회 소거 → 전체`0xFF` (엔진 경계 10 `tally_erase` — `run_wear.py tally-erase`, 사람이 UID 를 타이핑해야 하고 지우기 전 값이 `chip_pe.md` 에 먼저 남는다) |
| 기록 | 100사이클마다 다음 바이트 하나에`0x00` (2벌 동일하게) |
| 판독 | 누적 =`0x00` 바이트 수 × 100 |
| 용량 | 4,096바이트 →**409,600 사이클** |
| 기록 비용 | 0.004% (2벌 합산) |
| 바이트 재기록 | **금지** — 각 바이트를 딱 한 번만 쓴다 |

### 8.2 판독과 2벌 병합

| 값 | 처리 |
| --- | --- |
| `0x00` | 센다 |
| `0xFF` | 안 씀 |
| 그 외 | 세지 않되**±1 불확실**로 기록 |

두 벌을 **하나의 tally 값으로 합치는 것이 「병합」** 이다. 2벌은 같은 사이클에 동일하게
쓰므로(§8.1) 눈금이 같고, 불일치의 원인은 **한 벌을 쓰고 다른 벌을 쓰기 전에 끊긴 것**
하나다 — 그래서 차이의 크기로 가른다.

| `|a − b|` | 뜻 | 동작 |
| --- | -- | ---- |
| `0` | 정상 | 그대로 쓴다 |
| `≤ 100` (1바이트) | 쓰는 중에 끊겼다 | **큰 쪽으로 병합** + 불일치와 두 원래 값을 기록 |
| `> 100` | **정상 차단으로 설명되지 않는다** — 한 벌의 기록이 반복 실패했거나 엔진이 한 벌만 쓰고 있다 | **중단하고 사람을 부른다** |

- **「병합」과 「채택」은 다른 말이다.** 병합은 **2벌 → tally 값 하나**(여기, 눈금이 같다),
  채택은 **tally 값과 호스트 로그 중 최종 사이클 수**(§8.3, 눈금이 다르다)를 고르는 일이다.
  **§8.3 의 「큰 쪽 채택」은 폐기됐고**(`[D41-20]`) 병합은 그 대상이 아니다
- 병합은 **호스트가 한다.** 엔진은 2벌을 따로 돌려준다 — `docs/interface/pe_engine.md` §2

### 8.3 재개 절차

```
1. UID 읽기 → 등록부 대조. 불일치면 중단
2. tally 2벌 판독 → **2벌 병합** (§8.2)
3. d = (A 로그의 최대 cycle) − (tally × 100) 을 구한다
4. d 로 가른다 — 아래 표. **큰 쪽 채택이 아니다**
5. blank check → 부분 소거 상태면 해당 섹터 재소거 (경계 8 `reerase`, 별도 명령 · R 행 기록)
6. 이어서 진행 — `wear_start(cycle=채택값, delta=다음 체크포인트까지)`. 엔진은 `cycle` 이
   tally 와 `d` 규칙 밖이면 거부한다 (`E_CYCLE`)
```

| `d` | 뜻 | 동작 |
| --- | --- | --- |
| `0 ≤ d < 100` | 정상 | **호스트 로그 채택** |
| `d < 0` | **호스트 죽음** — A 가 멈추고 tally 만 앞섰다 | **tally × 100 채택** + 결손 구간을 기록 |
| `d ≥ 100` | tally 가 안 는다 | 채택하지 않고**tally 섹터의 다음 바이트를 본다** (아래) |

`d ≥ 100` 에는 두 경우가 섞인다. §6 ④ 가 tally 를 먼저 쓰고 행을 나중에 내보내므로
**A 행은 받았는데 tally 쓰기 전에 끊기는 창** 이 있는데, 그것은 정상 차단이라 사람을
부르면 과하다.

| 다음 바이트 | 뜻 | 동작 |
| --- | --- | --- |
| `0xFF` | 아직 안 썼다 — 정상 차단의 창 | 호스트 로그 채택하고 계속 |
| 그 외 | 전원 차단 중 부분 프로그램 | §8.2 의**±1 불확실**로 기록 |
| write 시험 실패 | **플래시가 안 써진다** | **중단하고 사람을 부른다** |

복원 불확실성: 최대 100사이클 (+소거 중 차단 시 ±1)

> **2026-09-18 개정 — 「큰 쪽 채택」을 폐기한다** (한영웅, `[D41-20]`).
> 폐기 대상은 **이 절의 3번**(tally 와 호스트 로그를 부등호로 고르던 것)이고,
> §8.2 의 **2벌 병합은 눈금이 같은 다른 규칙이라 그대로 둔다.**
> tally 는 100사이클마다 1바이트라 **해상도가 100** 이다(§8.1). 147사이클에서 tally×100 =
> 100, 호스트 로그 = 147 이므로 **`tally < 호스트로그` 는 늘 참** 이고, 부등호로는 아무것도
> 안 가려진다 — 「호스트만 죽었다」와 「정상 중단」이 같은 모양으로 온다. 가르는 것은
> **차이의 크기** 다. 경위는 `docs/log/young/41.blackbox_tb_and_engine_interface.md` §12 ·
> `[D41-20]`·`[D41-21]`.
>
> **전제** — A 로그가 **매 사이클 실시간** 으로 나간다(§9 A). 일괄로 내보내면 `d` 가 버스트
> 단위로 튀어 이 표를 다시 써야 한다. §6 ④ 에 그 출력 단계를 넣는 개정이 따로 걸려 있다.
>
> **엔진은 채택하지 않는다.** tally 2벌의 원본값·다음 바이트·write 가능 여부만 돌려주고
> 판단은 호스트가 한다 — `docs/interface/pe_engine.md` §2 경계 3. 중단 판단이 사람을
> 불러야 하는 일이라 엔진이 혼자 정하면 호스트가 이유를 모른다(§8.3 1 과 같은 원리).

### 8.4 실험 종료 시

```
1. 최종 카운트를 docs/chip_registry.md에 확정 기입
2. tally 섹터 해제 (이후 정상 섹터로 사용 가능)
```

### 8.5 파일럿에서 검증할 것

파일럿 종료 시 tally 섹터를 전량 읽어 `0x00`/`0xFF` 외의 값이 있는지 확인한다.
있으면 마크 간격 또는 페이지당 기록 바이트 수를 조정한다.

---

## 9. 로깅

```
A. 사이클 로그   (매 사이클, 섹터별 1행)
   cycle, sector, t_erase_us, t_program_us, timestamp

B. 무결성 로그   (검사 주기마다 1행 — 두 읽기의 값을 한 행에)
   cycle, erase_residual_bits, program_fail_bits,
   p_addr_count, p_addrs, p_worst_page, p_worst_bits,     ← 프로그램 직후 읽기
   e_addr_count, e_addrs, e_worst_page, e_worst_bits,     ← 소거 직후 읽기
   die_temp_c, uid_ok, timestamp

R. 사건 로그     (사건 1건마다 1행 — 재소거 · WIP 타임아웃 · 프로그램/소거 실패 · UID 불일치 · 사람 정지)
   kind, cycle, sector, op, t_us, ok, resid_before, resid_after, timestamp

C. 체크포인트 로그 (스윕 1개당 1행)
   cycle, area, sweep_csv, chip_id(UID), base_sector, n_sectors, n_reads,
   pattern, repeat_idx, area_cumulative_cycles, git_rev, die_temp_c, timestamp
```

공통 필수: `chip_id`(UID), `git_rev`, `base_sector`, `timestamp`

- `p_addrs`·`e_addrs` — 결함 비트 주소 목록 (페이지·바이트·비트). 각 최대 64개 + 총 개수.
  프로그램 실패(전하가 안 들어감)와 소거 잔류(전하가 안 빠짐)는 다른 고장이라 phase 별로
  보존한다 (2026-09-21, 로그 44 `[D44-13]`)
- `R` 의 재소거는 **카운터에도 `area_cumulative_cycles` 에도 더하지 않는다.** 전원 차단 당시
  진행 중이던 P/E 의 완료 여부가 ±1 불확실하다는 뜻이고, 그 데이터 지점은 회복 사건이 있었음을
  표시해 민감도 분석에서 뺄 수 있게 한다 (지민 회신 §3.4). 호스트는 `docs/chip_pe.md` 에 증분
  행을 남긴다
- `area_cumulative_cycles` — 대조군의 재기록 누적 사이클을 포함한 값
- 온도는 B·C에만 (A는 매 사이클이라 같은 값 반복)

---

## 10. 중단·경고 조건

| 조건 | 동작 |
| --- | --- |
| 결함 비트 >**46** | θ=10⁻⁴ 무효 표시, 계속 |
| 결함 비트 >**459** | θ=10⁻³ 무효 표시, 계속 |
| 결함 비트 >**4,588** | θ=10⁻² 무효 →**정지** |
| 소거 시간 >**400ms** | 경고 기록, 계속 |
| WIP 미해제 >**2초** (잠정) | **정지** + 대기시간 기록. **자동 재시도 금지** |
| UID 불일치 | **정지** |
| 사람 정지 (`halt` 명령) | **다음 사이클 경계에서 정지**. 진행 중 P/E 는 끊지 않는다. 이어 가는 길은 `wear_start(cycle=마지막 완료값)` |

- 결함 비트 한계 = 위상 무관 에러 플로어가 θ를 넘는 지점.
  `0.5 × D / (112 × 2,048) < θ`
- 워치독 2초는 잠정값. **M 트랙 신품 소거 시간 실측 후 확정**
- 정지 사유는 전부 §9 R 행으로 남긴다 (2026-09-21)

---

## 11. 체크포인트 배치 — 적응적 조밀화

| 항목 | 값 |
| --- | --- |
| 시작점 | 0 |
| 두 번째 점 | 300 |
| 기본 간격 | **× 2.15** |
| 조밀 간격 | **× 1.47** |
| 조밀화 트리거 | 직전 체크포인트 대비 폭 변화**> 1.83ps** (= 3σ) |
| 복귀 조건 | 변화 ≤ 1.83ps → 다음 간격 2.15배로 복귀 |
| 종점 | **300,000** |

```
C_next = C × 2.15                      (조용할 때)
C_next = C × 1.47                      (직전 변화 > 1.83ps)
```

폭 계산은 `host/analysis/bathtub_analysis.py`. 자동화 전에는 수동 판정 허용.

---

## 12. 시간 예산

| 단위 | 값 |
| --- | --- |
| 1사이클 | 405ms (typ) |
| 스윕 1회 | **59초** (실측 2026-09-15, chip02 25MHz·N=112·921600) |
| 체크포인트 1점 — 파일럿  | 3영역 × 1회 =**약 3분** |
| 체크포인트 1점 — 본 실험 | 5영역 × 3회 =**약 15분** |
| 사이클링 300k (1그룹) | **33.7h** |

| 실험 | 사이클링 | 측정 | 합계 |
| --- | --- | --- | --- |
| 파일럿 (1그룹 300k) | 33.7h | 점 수 × 3분  | 점 수에 따라 34~35h |
| 본 실험 | 그룹별 목표 사이클 합 × 405ms | 점 수 × 15분 | §15 확정 후 산정 |

**개정 근거 (2026-09-16).** 종전 값 5.6분은 115200bps·N=112 계산치였고 "실측 확인 대상"으로
열어 두었던 항목이다. 2026-09-15 보 레이트를 921600으로 올려(로그 30 §10.3) 실측 59초를
얻었다 — UART 전송이 지배 항이었고 순수 측정 시간은 약 23초다. 체크포인트 비용이 5.6배
싸졌으므로 **§11 적응적 조밀화에서 점을 더 촘촘히 박을 여유가 생긴다**(종전엔 본 실험
점당 84분이 1차 비용 동인이었다 — 로그 17 §3.9). 사이클링 33.7h는 tSE가 지배하는 칩 물리라
불변이며, 이제 전체 일정의 95% 이상이 사이클링이다.

tSE는 칩 내부 고전압 펄스 시간이라 SPI 클럭으로 줄일 수 없다. 소켓 1개, 전 과정 직렬.

---

## 13. 인수 기준

### A. 100사이클 시험

| #  | 항목 | 통과 조건 |
| -- | --- | --- |
| A1 | 사이클 카운터 | 100 |
| A2 | 사이클 로그 행 수 | 700 (= 100 × 7) |
| A3 | 무결성 로그 행 수 | 1 |
| A4 | tally 바이트 | 각 벌에`0x00` 1개 |
| A5 | **경로 간 일치** | 카운터 / A행수÷7 / B의 cycle / tally×100 이**전부 100** |
| A6 | 소거 시간 | typ 45ms 부근, 400ms 미만 |
| A7 | UID | 로그의 chip_id가 등록부와 일치 |

### B. 전원 장애 복구 시험

100사이클 시험 도중 임의 시점 전원 차단 → 재개 → §8.3 복원

- 통과: 복원 카운트와 실제 진행 사이클의 차이 **≤ 100**
- 소거 중 차단 시: 부분 소거가 blank check에 잡히고 재소거 후 정상 진행

### C. 측정 경로 연결

체크포인트 절차(§5) 1회 실행

- 통과: `valid=1 reason=complete` · CSV의 `n_reads`=112, `base_sector`=지정값 ·
  체크포인트 로그의 `sweep_csv`가 실제 파일명과 일치

---

## 14. Plan B — 계약 수정안 #1 미승인 시

읽기 창이 페이지 0 고정. 한 스윕이 섹터 0~6만 읽는다.

```
섹터 0 ~ 3   마모 그룹 (64페이지)
섹터 4 ~ 6   대조군    (48페이지)
```

| 항목 | Plan A | Plan B |
| --- | --- | --- |
| 마모 그룹 | 다수 × 7섹터 | 1개 × 4섹터 |
| 대조군 | 근접 + 원격 | 근접만 |
| 그룹당 읽기 | 112 | 마모 64 / 대조 48 |
| θ 유효 | 10⁻², 10⁻³, 10⁻⁴ | 10⁻², 10⁻³ |
| 인접 간섭 검출 | 가능 | 불가 |

**§6~§10(마모 루프·무결성·tally·로깅·중단)은 Plan A와 완전히 동일하다.**
영역 배치와 스윕 파라미터만 다르므로 **승인을 기다리지 않고 착수한다.**

---

## 15. 파일럿 유보 항목

| #  | 미정 항목 | 파일럿이 답할 질문 |
| -- | --- | --- |
| ① | 본 실험 체크포인트 배치 | 폭이 언제부터 움직이는가 |
| ② | 본 실험 그룹 수·마모량 배분 | 마모 효과 대비 섹터 간 산포의 크기 |
| ③ | 본 실험 섹터 배치 | 인접 섹터 간섭이 존재하는가 (근접 vs 원격) |
| ④ | 본 실험 반복 횟수 (3회/5회)  | 폭 변화량이 노이즈 플로어 대비 얼마인가 |
| ⑤ | 반복 측정의 온도 전이 영향 | 3회 반복의 순서와 폭에 체계적 경향이 있는가 |
| ⑥ | tally 기록 방식 | 페이지당 256회 부분 프로그램이 성립하는가 (§8.5) |

**파일럿 결과 전에는 종단 마모 3칩을 착수하지 않는다.**

> **2026-09-23 추기 — 파일럿의 정지 기준과 사전 가설** (한영웅, chip01 파일럿 29,600사이클 시점 · 세션 `1790091548`).
> §11 의 종점 300,000 은 데이터시트 내구 10만의 3배라는 자리표시자이지 물리에서 나온 수가 아니다.
> 파일럿은 다음 셋 중 먼저 오는 것으로 멈춘다 — 이는 파일럿의 기준이며 실행기에 넣지 않는다.
>
> 1. **측정 불능** — 체크포인트 prep 이 마모 섹터에 PRBS 를 써서 검증하지 못하거나, 엔진이 스스로 서는 때
>    (WIP 2초 타임아웃 · 소거 잔류 4,588비트 초과). 폭을 더 잴 수 없으니 칩의 수명이 끝난 것이다.
>    소거 시간이 데이터시트 최대 400ms 를 넘는 것은 정지 사유가 아니다 — 늙었다는 표시지 못 잰다는 뜻이 아니다
> 2. **답이 나옴** — 폭이 재장착 σ 의 3배(≈42ps, S-2 §6.2)를 넘게 움직인 체크포인트가 나오고 그 뒤 2~3점으로
>    기울기가 서면 ①·④ 는 닫힌다. §11 의 조밀화 트리거 1.83ps 는 7월 반복 σ 로 만든 값이라 체크포인트 간
>    흔들림(8점에서 6ps)에도 걸리므로 파일럿에서는 쓰지 않는다
> 3. **300,000** — 위 둘이 오지 않으면.
>
> **사전 가설.** 29,600사이클까지 소거 시간 p50 은 32.8 → 62.6ms 로 2배가 됐고 폭(25MHz · θ=10⁻²)은
> 8점이 39,666~39,672ps 로 6ps 안에 있다. 이를 데이터로 삼아 나머지 구간의 예측을 미리 적는다 —
> **(H1) 25MHz SPI 타이밍 마진은 측정 불능(기준 1)까지 3σ(42ps) 안에서 움직이지 않는다.
> (H2) 소거 시간은 단조 증가한다.** 근거는 구조다 — 출력 엣지는 클럭에 맞춰 도는 출력 레지스터가 내고,
> 셀 열화로 길어지는 어레이 접근 시간은 25MHz 의 40ns 주기 안에서 여유가 커 엣지에 이르지 못한다. 반면
> 소거 시간은 소거 검증 루프가 산화막의 갇힌 전하를 그대로 반영한다. H1 이 참이면 결론은 "이 정밀도의
> 벤치로도 데이터시트 내구의 N배까지 마진은 움직이지 않았고 소거 시간이 노화 지표다" 이고, 이는 §1 의
> 목적(어느 지표가 노화를 보이는가)에 대한 답이다. H1 이 깨지는 자리는 수명 끝일 가능성이 크며, 그때는
> 폭보다 BER 바닥(체크리스트 2)이 먼저 뜰 수 있으므로 BER 바닥도 폭과 나란히 y1 로 본다.
> 75MHz 스윕을 체크포인트에 더하면 접근 시간 여유가 작아 H1 을 더 세게 시험한다 — 채택 여부는 미정.

> **2026-09-26 추기 — 파일럿 결과와 종단 3칩의 사전 등록** (한영웅, chip01 파일럿 300k 종료일 · 세션 `1790091548`·`1790212214`).
> 파일럿은 기준 3(300,000)으로 멈췄다. 기준 1·2 는 오지 않았다 — 294,500 까지 폭(25MHz · θ=10⁻²)은 신품 대비
> +15ps 로 재장착 σ 안이고 BER 바닥 0, 즉 **H1 참**. 소거 p50 은 28.7 → 131ms 로 단조 증가(**H2 참**). 프로그램
> 시간은 137k 까지 7.0ms 불변이다가 섹터 0 이 약 145k 부터 서서히 벌어져(1k 구간 중앙값 7.1ms, 200k 에 8.0ms) 294.5k 에
> 섹터 0 이 2.3배. 300k 최종값과 수치의 정본은 `docs/results/wear/wear_pilot_chip01.md`(해석) · `docs/results/data/wear/wear_pilot_chip01_2026-09.md`(수치).
>
> **종단 3칩 결정.** ① 배치는 "폭이 언제 움직이나" 로는 정할 수 없다(안 움직였다). 대신 **정격 내구 10만 회를 종점**으로
> 하고(데이터시트 근거 · 블라인드 x(누적 사이클 — 기호는 2026-09-30 N → x, 로그 51 [D51-1]) 가 내삽 범위에 들어옴 · 칩당 약 22시간), 체크포인트는 폭이 아니라 **prep 소거 시간과
> 마모 루프 소거 시간의 교정점**으로 둔다 — 블라인드 칩은 개봉 전 prep 1회로 소거 시간을 재기 때문이다. 격자는 소거 시간이
> 가파른 앞을 로그로, 블라인드 x 가 있을 10k 이상을 10k 등간격으로:
> `100 · 1,000 · 3,000 · 10,000 · 20,000 · 30,000 · 40,000 · 50,000 · 60,000 · 70,000 · 80,000 · 90,000 · 100,000` (13점,
> `run_wear.py` `CHECKPOINTS`). 파일럿 격자를 자르는 안은 63,700 다음이 100,000 이라 탈락. 파일럿 chip01 은 300k 에서
> 세워 보관한다(고온 유지 시험(베이크) 시료). 정격 너머의 마모는 종단에 넣지 않는다.
>
> **사전 가설 — 종단 3칩의 데이터를 보기 전에 적는다.** 근거는 chip01 의 A 행(사이클·섹터별 소거 시간)이다. 7섹터 중앙값은
> 58k 에서 한 번 뛴 것처럼 보였지만 섹터별로 쪼개면 **7섹터가 각자 다른 시점(34k-72k)에 같은 크기(칩 p50 으로는 92→110ms, 섹터별로는 아래 추정법으로 19.7-22.0ms)로
> 뛰었고**, 신품에 가장 느렸던 섹터 3(41ms)이 가장 먼저(34k) 뛰었으며, 전환 근처에서는 두 값 사이를 수천 사이클 오갔다.
>
> - **(H3 계단 양자)** 섹터의 소거 시간은 약 21ms 단위의 계단으로 오르고, 그 양자는 칩·섹터에 무관하게 같다 — 소거 펄스
>   하나의 폭이다. **추정법**: 섹터마다 1k 구간 중앙값 시계열에서 이웃 구간 사이 최대 상승을 찾아 그 두 값의 중점을 문턱으로
>   삼고, 첫 전환 구간(문턱을 처음 넘기 2k 전부터 마지막으로 문턱 아래인 구간 3k 뒤까지)의 A 행을 그 문턱으로 갈라 두 수준
>   중앙값의 차를 계단 높이로 한다. **판정**: 종단 3칩 21섹터 **전부**가 21±4ms 안이면 참. 근거 — chip01 7섹터가 이 추정법으로
>   19.7-22.0ms(평균 20.8 · sd 0.9), 부트스트랩 추정 잡음 sd 0.4ms 이하라 봐줄 잡음이 없다. 한 섹터라도 벗어나면 반증이다
> - **(H4 전환 순서)** 섹터의 첫 계단 전환 시점 순서는 신품 소거 시간의 내림차순과 같다. 판정: 칩마다 순위 상관 ρ ≥ 0.5,
>   3칩 중 2칩 이상
> - **(H5 칩 간 산포)** 신품 소거 시간으로 정렬한 같은 순위의 섹터끼리 비교하면, 첫 계단 전환 시점의 칩 간 차이는 chip01 의
>   섹터 간 폭(34k-72k)보다 작다. 판정: 3칩의 같은 순위 섹터 전환 시점 범위가 40k 이하. 이것이 서야 교정 곡선이 칩 사이를
>   건넌다
> - **(H1′·H2′ 재현)** 100k 안에서 폭은 3σ(42ps) 안, 프로그램 시간은 7.0ms 불변 — 파일럿에서 프로그램 시간이 섹터 0 부터
>   약 145k 에서 움직였으므로(1k 구간 중앙값 기준) 종단에서는 안 보일 것을 예측한다 — 여유는 1.5배뿐이다. 보이면 H2′ 는 깨진 것이고 그 시점을 기록한다
>
> **블라인드 역산의 방법을 미리 정한다 — 두 층.** 현장의 칩에는 신품 데이터가 없다. 그래서 주 결과는 신품값을 입력으로
> 받지 않는 모델이고, 신품값은 그 모델의 오차를 얼마나 줄이는지를 재는 보조 층으로만 쓴다.
>
> - **1차 — 현장 모델 (주 결과, 블라인드 판정은 이것으로).** 입력은 개봉 전 `--mode newchip`(prep 0-127) 1회의
>   **섹터별 소거 시간뿐**이다. 기준값은 같은 칩의 대조군 섹터(근접 7-13 · 원격 121-127, P/E 는 prep 몇 번뿐)의 소거
>   시간 — 칩이 자기 신품 기준을 몸에 지닌다. 읽는 것은 셋: 마모 섹터 대 대조군 섹터의 소거 시간 비율, 올라간 계단 수,
>   전환 구간에서 두 값 사이를 오가는 비율(계단 안의 완만한 상승 포함). 이를 종단 3칩의 섹터별 곡선(같은 비율로 정규화)에
>   대조해 x 를 좁힌다. 외부 데이터는 쓰지 않는다
> - **2차 — 참조 모델 (보조).** 1차에 집계표의 신품 소거 시간을 더해 같은 x 를 다시 추정한다. 두 층의 오차 차이가
>   "신품 참조의 값어치" 이고 보고서에 나란히 적는다 (현장 ±X · 참조 있음 ±Y)
>
> 전제 하나가 검증 항목으로 늘어난다 — **대조군 섹터의 소거 시간은 100k 동안 변하지 않는다** (안 닳은 섹터 = 신품).
> 체크포인트 prep 은 0-6 만 지우므로, 종단 3칩의 100k 직후에 `--mode newchip` 1회를 붙여 대조군 섹터의 소거 시간을
> 신품 집계표와 맞댄다. 오차 막대는 H5 의 산포로 보고한다. 폭은 역산에 쓰지 않는다(H1). 첫 분석 그림은 칩 전체 p50
> 이 아니라 **섹터 7개의 개별 곡선**이다.

> **2026-09-27 추기 — 종단 1칩째(chip03) 판정과 새 예측** (한영웅, 세션 `1790408609` 종료일). 수치·해석은
> `docs/results/wear/wear_endurance_chip03.md`.
>
> - **H1′ 참** — 25·45·75MHz 모두 체크포인트 100 대비 1σ 안, 같은 칩·같은 리그 전후 비교
> - **H2′ 거짓** — 프로그램 시간이 약 20k 부터 오른다(100k p50 8.60ms). 7섹터가 함께 오르고 chip01 의 섹터 순서
>   기울기는 없다
> - **H3·H4·H5 chip03 에서 판정 불가** — 100k 안에 계단이 없다. H3 의 "21섹터 전부" 는 그대로 두며, chip03 의 7섹터는
>   H3 을 충족하지 못한 것으로 센다
> - **전제(대조군 소거 불변) 부분 성립** — 100k 뒤 newchip 에서 원격 대조군(121-127)과 블록 2-7 은 신품 대비 0.98,
>   근접 대조군(7-13)을 포함한 첫 128KB(섹터 7-31)는 1.08-1.11. 인접 간섭(③)이 존재하고 범위는 128KB 다.
>   1차 현장 모델의 기준을 "대조군 섹터" 에서 **마모 영역에서 128KB 넘게 떨어진 섹터**로 좁히는 안이 [U48-8] 로
>   열려 있다 — 블라인드 개봉 전 데이터로만 정하므로 블라인드 착수 전에 닫는다
>
> **(H6, 두 칩을 본 뒤의 예측 — 사전 등록이 아니라 다음 칩에 대한 예측)** 섹터의 **첫 계단**을 "그 섹터의 1k 구간
> 중앙값이 처음 105ms 를 넘은 구간" 으로 정의한다. H6: 첫 계단은 ① 직전 1k 구간 중앙값이 **84ms 이상**일 때만 나타나고
> ② 그 구간 중앙값이 **107-112ms** 다(착지 수준이 칩·섹터에 무관하게 약 110ms). 근거: chip01 의 첫 계단 7개가 직전 84.4-93.2ms
> 에서 109.5-109.7ms 로 착지했고(34-62k), 전환 구간의 A 행이 두 봉우리로 갈려 94-108ms 가 비었다. chip03 은 100k 에 88-93ms
> 에 닿았으나 계단이 없어(105ms 이상 A 행이 70만 행 중 56건) ① 이 충분조건이 아님을 보였다 — 그래서 H6 은 계단이
> **올 때의 조건**만 말한다. "+8ms 도약" 같은 상대 기준은 쓰지 않는다 — chip01 섹터 5 는 42k 에 77 → 86ms 로 뛰었다가
> 53k 에 110ms 로 착지해, 상대 기준으로는 첫 계단이 두 번 잡힌다. **판정**: chip06·chip04 에서 첫 계단이 나타난 섹터 전부가
> ①·② 를 만족하면 참, 하나라도 어기면 거짓. 계단이 없는 섹터는 판정에서 뺀다. 이 문단은 chip06 의 마모 데이터를 보기 전에 커밋한다.

> **2026-09-27 추기 — 종단 3 을 chip06 에서 chip07 로 바꾼다** (한영웅). chip07 의 마모 데이터를 보기 전에 커밋한다.
>
> - **이유는 물리적인 것뿐이다** — chip06 이 박지민 쪽에 있고, 종단 3 은 보드 A(한영웅)에서 돌린다. chip06 은 마모 전 상태로 남는다
> - 위 H3-H6 과 두 층 역산에서 "chip06" 은 chip07 로 읽는다. 판정식·문턱은 바꾸지 않는다
> - **알고 바꾼 것**: chip07 의 신품 소거 median 은 47.0ms 로, 100k 안에 계단이 없던 chip03(51.1ms)과 같은 느린 무리다.
>   chip06(25.7ms)은 계단이 34-62k 에 온 chip01(28.7ms)과 같은 빠른 무리였다. 따라서 종단 3칩은 빠름·중간·느림이 아니라
>   중간(chip04 33.7ms) 하나·느림 둘이 되고, chip07 에도 계단이 없으면 H3-H6 은 chip04 한 칩으로만 판정된다. 빠른 무리의
>   대체 후보(chip09 26.0ms)를 두고 chip07 을 골랐다. **예측**: chip07 은 chip03 처럼 100k 안에 계단이 없다 — 계단이 오면
>   "신품 소거가 느리면 100k 안에 계단이 없다" 는 이 예측이 깨진 것이고, 그 시점과 섹터를 기록한다

> **2026-09-29 추기 — 링크 끊김과 체크포인트 측정 시점** (한영웅, chip07 종단 종료일 · 세션 `1790494073`·`1790562456`).
> chip07 은 50k→60k · 70k→80k 에서 USB 재열거로 호스트가 죽고 엔진만 구간을 끝내, 60k·80k 체크포인트를 못 쟀다(로그 48 §17).
> chip04 부터 두 가지를 바꾼다. 판정식·문턱·체크포인트 격자는 바꾸지 않는다.
>
> - **호스트는 끊겨도 버틴다** — 30초 안에 포트가 다시 열리면 구간을 잇고 체크포인트를 제때 잰다. 측정 절차는 같다.
>   끊긴 사이의 A·B 행은 없고, 그 구간 판정의 행 수 항목(A2·A3)은 채점하지 않는다
> - **못 잰 체크포인트는 재개 때 START 전에 잰다** — 이 점은 구간 직후가 아니라 **휴지 뒤** 측정이라 C 행 `measured` 칸에
>   따로 표시한다. 휴지(수 시간) 동안 소거 시간·폭이 회복할 수 있으므로 **곡선의 주 판정(H1′·두 층 역산)에는 직후 점만 쓰고**,
>   휴지 뒤 점은 같은 자리의 직후 점이 없을 때 참고로만 싣는다
> - chip07 의 60k·80k 는 이 변경 전이라 결측이다

> **2026-09-29 추기 — 종단 3칩째(chip07) 판정** (한영웅, 세션 `1790494073`·`1790562456`·`1790643103` 종료일). 수치·해석은
> `docs/results/wear/wear_endurance_chip07.md`.
>
> - **H1′ 25MHz 참 (사후 처리) · 75·45MHz 보류** — 2026-09-28 02:23:55Z 의 배선 접촉(계측 사건)이 25MHz 폭을 +590ps 옮겼다.
>   사고로 생긴 불연속이라 **사건 전후 구간을 각자의 첫 점과 비교**한다 — 등록 기준에 없던 방식이라 사후 처리로 표시한다.
>   사건 뒤 구간 −2ps. 사건 전 구간은 체크포인트 100 대비 최대 −59ps 로 숫자는 기준을 넘지만, 처음 10k(약 1.4시간)에 내려간 뒤
>   40k 동안 13ps 안에 머물러 **장착 뒤 안정화**로 판단한다. 75·45MHz 는 마모 전후 비교가 사건을 사이에 둬 보류 — 선을 되돌려
>   사건 전 상태가 재현되면 다시 잰다 (로그 48 [U48-9])
> - **H2′ 거짓** — 섹터별 4-12k 에 7.0ms 를 넘었고 100k 에 p50 14.19ms (chip03 에 이어 두 번째)
> - **H3-H5 chip07 에서 판정 불가** — 100k 안에 계단이 없다. H3 의 "21섹터 전부" 에 chip07 의 7섹터는 미충족으로 센다
> - **H6 판정에서 빠진다** — 계단이 없고, 섹터 1k 구간 중앙값이 ① 의 84ms 에도 닿지 않았다(최대 81ms)
> - **9/27 예측 "chip07 은 100k 안에 계단이 없다" 참** — 105ms 이상 A 행 0건(621,872행). 그 대가로 적었던 대로 H3-H6 은 chip04
>   한 칩으로만 판정된다

> **2026-09-30 추기 — chip07 선 복구 뒤 측정과 newchip** (한영웅, batch `20260930T041252Z`-`041756Z`). 수치·해석은
> `docs/results/wear/wear_endurance_chip07.md` §5·§6.
>
> - **H1′ 75·45MHz 판정 불가** — 선을 다시 눌러 경로 서명(원점 회전·F)은 마모 전 값으로 돌아왔지만, 폭이 마모 전 대비 25MHz −147 ·
>   75MHz −185 · 45MHz −79ps 로 세 클럭 모두 좁았다. USB 접촉이 불안정했고, 재접속을 사이에 둔 반복(리그 재현성)을 재기 전에
>   칩을 뺐다. 마모와 리그 상태를 가를 자가 없으므로 참·거짓 어느 쪽으로도 적지 않는다. 25MHz 판정(사후 처리 참)은 두 구간 안의
>   비교라 이 값에 영향받지 않는다
> - **대조군 전제: 원격만 성립 (chip03 에 이어 두 번째)** — 100k 뒤 newchip 에서 원격 대조군·블록 2-7 은 1.00, 근접 대조군 1.06 ·
>   64KB 블록 0 1.16 · 블록 1 1.07. 교란 범위가 첫 128KB 인 것이 칩을 바꿔 재현됐다([U48-8] 의 근거)
> - **prep 프로그램 시간은 A 행과 눈금이 다르다** — 새 prep 의 `#PREP PROGRAM`(PRBS)은 안 닳은 섹터에서 A 행 초기(0x00)와 같고
>   (6.73 대 6.74ms), 닳은 섹터에서 약 0.53배다(7.62-7.89 대 14.15-14.93ms). 두 층 역산에 프로그램 축을 넣는다면 prep 값은 A 행
>   교정 곡선에 그대로 대지 않고 따로 교정한다

> **2026-09-30 추기 — 종단 2칩째(chip04) 판정과 종단 3칩 종합** (한영웅, 박지민 세션 `1790423530`·`1790482991`·`1790491294`, 보드 B).
> 수치·해석은 `docs/results/wear/wear_endurance_chip04.md`.
>
> - **H1′ 참** — 25MHz 체크포인트 14점이 체크포인트 100 대비 −3.7 에서 +3.2ps, 45MHz +5.3 · 75MHz −2.0ps. 스윕 원점·F 가 끝까지 고정
> - **H2′ 참** — 섹터 1k 구간 중앙값 6.94-6.96ms 로 100k 까지 그대로
> - **H6 참** — 7섹터 모두 첫 계단(25-47k) 직전 87.8-94.4ms(① 84ms 이상), 착지 110.5-111.0ms(② 107-112ms). 9/27 13:08 KST 커밋 뒤,
>   chip04 A 행을 보기 전에 적은 예측이다
> - **H3 — chip04 7섹터는 충족, 종단 판정은 거짓.** 계단 높이 18.5-22.7ms 로 전부 21±4ms 안이지만, 등록 문구 "종단 3칩 21섹터 전부" 에서
>   chip03·chip07 의 14섹터는 계단이 없어 미충족으로 센다
> - **H4 거짓** — chip04 의 신품 소거 내림차순과 전환 순서의 순위 상관 −0.31(기준 0.5, 방향 반대). 계단이 온 종단 칩이 하나라
>   "3칩 중 2칩" 도 채울 수 없다
> - **H5 판정 불가** — 계단이 온 종단 칩이 하나다
> - **대조군 전제: 원격만 성립 (세 칩째)** — 근접 1.15 · 블록 0 1.25 · 블록 1 1.18 · 블록 2-7 1.00. 세 칩 모두 경계가 첫 128KB 다
> - **집계 방법 기록** — H3 추정법·H6 은 새로 짠 일회성 코드로 쟀다. 같은 코드가 파일럿 chip01 에서 첫 계단 시점·H6 값은 위 기록과 같고,
>   계단 높이는 섹터 5 하나가 22.8ms 로 등록값(최대 22.0ms)과 0.8ms 다르다
> - x 축은 tally 를 따른다 — 66,654-66,671 의 SPI 접촉 불량 행 120개는 집계에서 빼고, 66,600 으로 되돌린 재개 뒤의 값을 쓴다

> **2026-09-30 추기 — 수명 역산 1차 모델의 확정과 블라인드 절차** (확정 2026-09-30 저녁 · 로그 48 §22 [D48-40]~[D48-45]) (한영웅, 종단 3칩 종합 뒤 · 블라인드 마모 첫 P/E 전에 커밋한다).
> 위 2026-09-26 추기의 "두 층 역산" 을 종단 3칩의 결과로 고쳐 확정한다. 코드는 `host/analysis/wear_inverse.py`, 교정 표는
> `docs/results/data/wear_curves_<chip>_2026-09.csv`(생산 `host/analysis/wear_curves.py`). 이 추기가 커밋된 뒤에는 판정식을 바꾸지 않는다.
>
> **기호**: 누적 P/E 사이클은 **x**, 추정값은 x̂ (로그 51 [D51-1] 채택). N 은 위상당 읽기 112 에만 쓴다. 이 절의 옛 문구 「블라인드 N」 은 x 로 고쳤다.
>
> **1차(현장) 모델 — 입력은 개봉 전 `--mode newchip` prep 의 섹터별 소거·프로그램 시간뿐이다.**
>
> - **입력 A — 신품값**: 섹터 **32-127** 의 소거 시간 중앙값. 기준 섹터를 "대조군(7-13 · 121-127)" 에서 여기로 좁힌다 — 종단 3칩 모두
>   100k 뒤 newchip 에서 첫 128KB(섹터 7-31)가 1.06-1.25 로 느려졌고 블록 2-7 은 1.00 이었다([U48-8] 은 이 문장으로 닫는다). 이 값은
>   그 칩의 신품 소거 시간이며 **무리 분류자**다 — 신품 소거가 빠른 칩(chip01 28.7 · chip04 33.7ms)은 100k 안에 3.5-4배로 늘고
>   계단을 타며, 느린 칩(chip07 47.0 · chip03 51.1ms)은 1.6-1.7배로 완만하고 계단이 없다. 같은 배율이 두 무리에서 30배 다른 사이클을
>   뜻하므로(chip04 3k ≈ chip07 100k) 절대값 없이는 역산이 서지 않는다. 경계는 **40ms**(잠정 — 34 와 47 사이에 칩이 없다. 남은 칩은
>   chip06·09·02·10 이 26-33ms, chip08 이 49.5ms 로 경계에서 멀다)
> - **입력 B — 마모 섹터 소거 시간**: 섹터 0-6 각각의 값. prep 을 k 회 돌리면 7k 개. 나이의 주 신호
> - **입력 C — 마모 섹터 프로그램 시간**: 섹터 0-6 각각의 값. **x 추정에 넣지 않는다.** 무리 선택(A)의 교차 확인만 — 빠른 무리는 100k 까지
>   7.0ms 그대로, 느린 무리는 5-20k 부터 오른다. 넣지 않는 이유: prep 프로그램(PRBS)은 A 행(0x00)과 눈금이 달라(0.53배) 교정점이
>   chip07 100k 한 점뿐이고, 느린 무리 안에서도 상승 크기가 두 배 갈린다(+26% · 2.1배)
> - **쓰지 않는 것**: 폭·BER 바닥(H1′), 집계표의 신품값(2차 참조 모델에서만), 기준 섹터의 프로그램 시간(6.7-7.0ms 로 칩 간 정보가 없다),
>   그리고 9/26 추기의 "전환 구간에서 두 값 사이를 오가는 비율" — prep 1회로는 섹터당 소거가 한 번이라 관측할 수 없다. 개봉 prep 을
>   3회 이상으로 하면 살아난다 (아래 절차)
> - **교정**: 마모 4칩(chip01 300k · chip03 · chip04 · chip07 100k)의 A 행을 1,000사이클 구간 × 섹터로 묶은 p10/p50/p90. 무리 안 칩 × 섹터
>   하나하나가 그 구간의 구성원이고, 구성원마다 p50 중심 · (p90−p10)/2.56 폭의 정규분포를 놓는다. 100k 너머는 교정이 없어 답하지 않는다
> - **계산과 출력**: 구간마다 관측 B 가 나올 확률(관측별 구성원 평균 밀도의 기하 평균 — 7개 관측은 같은 칩이라 독립으로 곱하지 않는다)을
>   평평한 사전으로 정규화하고, **확률이 가장 큰 구간과 68%·95% 최고밀도 집합을 사이클 범위로** 낸다. 답은 점이 아니라 구간이다.
>   MAP 구간의 밴드(구성원 p10 최소~p90 최대) 밖에 관측이 전부 있으면 "교정 범위 밖" 으로 낸다
> - **소거 시간의 눈금 — 배율로 확정 (2026-09-30 저녁).** 규칙은 먼저 적었다: 모의 블라인드를 두 눈금으로 돌려 정답이 95% 안에 드는
>   비율이 높은 쪽, 같으면 68% 폭이 좁은 쪽. 4칩 46점에서 배율 36/46 · ms 19/46 (속도 배율 없이). 계단 착지는 ms 로 같지만(110·111ms)
>   계단 전 구간에서 배율이 두 칩을 더 잘 포갠다. ms 눈금은 chip04 를 1.5배 과대, chip01 을 과소로 한결같이 빗나갔다
> - **속도 배율 r — 같은 무리 안에서도 늙는 속도가 다르다.** 모의 블라인드에서 chip04 는 chip01 보다 약 1.4배, chip03 은 chip07 보다 약
>   1.25배 적은 사이클에 같은 상태에 이르렀다 — 곡선 모양은 같고 가로축만 늘어난 것. 이것을 숨은 오차가 아니라 모수로 둔다: 진짜 사이클
>   x 인 칩은 교정 곡선의 x·r 지점처럼 보이고, r 은 [1/R, R] 에서 로그 균등으로 적분한다. **R 은 규칙으로 정하고 결과에 맞춰 조정하지
>   않는다**: 두 쌍의 로그 차이(0.34 · 0.22)의 평균 ÷ 1.13(두 표본 차이의 기댓값 계수) = 개체 표준편차 약 0.25, 새 칩 하나 대 교정 칩
>   하나의 95% 범위 = √2 × 1.96 × 0.25 = log 2.0 → **R = 2.0**. 가정(로그 정규 · n=2 쌍 둘)은 약하며 그대로 적는다.
>   "계단 뒤 하한"(H6 의 105ms 를 빠른 무리의 x 하한으로 재사용)은 넣지 않는다 — 효과가 작고 규칙만 는다 (2026-09-30 결정)
>
> **2차(참조) 모델**은 9/26 추기 그대로 — 1차에 집계표의 신품 소거 시간을 더해 같은 x 를 다시 추정하고, 두 오차의 차이를 "신품 참조의
> 값어치" 로 나란히 적는다.
>
> **모의 블라인드 (2026-09-30 실행).** 교정 칩 하나를 빼고 그 칩의 구간별 섹터 p50 을 관측으로 넣어 나머지 칩으로 맞힌다
> (`wear_inverse.py --loco`, 1k·3k·10k-100k 12점, chip07 은 60k·80k 결측이라 10점 — 계 46점). 무리당 칩이 둘이라 이것은 "한 칩으로
> 다른 칩을 맞히기" 이고, 여기서 나오는 폭이 블라인드에서 기대할 오차다. 결과 (눈금 배율):
>
> | R | 정답∈68 | 정답∈95 | 68% 폭 중앙값 |
> |---|---|---|---|
> | 1 (속도 배율 없음) | 26/46 | 36/46 | 15,000 |
> | 1.4 | 35/46 | 45/46 | 28,000 |
> | **2.0 (채택, 규칙)** | **42/46** | **46/46** | **39,500** |
> | 3.0 | 39/46 | 46/46 | 48,500 |
>
> R = 2.0 에서 68% 구간이 정답을 91% 품는다 — 명목보다 넓다. n=2 쌍에서 R 을 낸 대가이고, 좁히려고 R 을 내리지 않는다(내리면 이
> 4칩에 맞춘 값이 된다). 이 표는 보고서에 민감도로 싣는다. **성공 기준**: 블라인드 칩의 정답이 95% 구간 안에 들고, 68% 구간의
> 바깥 폭(가장 낮은 구간부터 가장 높은 구간까지)이 **60,000 사이클 이하** — 위 표를 본 뒤 적은 값이라 사전 등록이 아니다. 60k 는
> 마모 담당자의 선택 범위(79k)보다 좁다는 최소선이며(LOCO R=2.0 에서 44/46 통과), 정밀도의 실제 주장은 상대 폭이다 — 폭이 N 에
> 비례해(±50% 꼴) 낮은 x 에서는 수 k 다. 보고서에는 폭/MAP 을 같이 적는다. 폭을 줄이는 길은 모수가 아니라 교정 칩 추가다.
>
> **블라인드 절차.**
>
> - 칩 둘: **빠른 무리 하나(chip06·09·10 중) · 느린 무리 하나(chip08)**. 추가 구매 칩에서 **교정 2**(신품 소거로 무리를 본 뒤 빠른·느린
>   하나씩, 100k, 보드 A·B 동시)를 먼저 돌려 무리당 교정 칩을 셋으로 늘린다 — 폭을 줄이는 유일한 확실한 길이다. 배분표는 S-2 §1
> - 마모 담당자(박지민, 보드 B)가 사이클 수를 **1,000-80,000** 안에서 고른다. 80,000 은 교정 100k 안쪽(내삽)이고, 1,000 을 아래로 둔 것은
>   추정자가 범위로 답을 좁히지 못하게 하려는 것이다 — 느린 무리가 낮은 사이클에 걸리면 신품과 구별이 어려워 구간이 넓게 나올 것을
>   미리 적어 둔다. 정답은 파일로 봉인하고 커밋 해시로 남긴다. 정답의 정본은 장부가 아니라 칩의 tally 다. 추정자는 보드 B 의 계획 화면을
>   보지 않는다
> - 개봉: 보드 A 에서 `--mode newchip`(0-127) prep 을 **3회 이상** 연속으로 돌린다(P/E +3). 그 세션 로그들이 `wear_inverse.py` 의 입력이다.
>   개봉 시점은 마모 종료 후 **24시간 이내** — 교정 곡선이 마모 직후 값이고 휴지 중 소거 시간이 회복할 수 있어서다. 종단 3칩의 100k 뒤
>   newchip 은 모두 하루 안(chip03·04 같은 날, chip07 다음 날)이었고 직후 값과 같은 눈금이었다. 더 오래 쉰 칩의 회복은 모른다
> - 추정자는 구간(MAP · 68% · 95%)과 무리 판정을 봉인 개봉 전에 커밋한다. 개봉 뒤 정답과 나란히 `docs/results/` 에 적는다
>
> **이 추기로 닫히는 것**: [U48-8](기준 섹터 32-127) · 종단 결과 문서들의 "넘어감 — 두 층 역산의 형식"(무리를 먼저 가르고 소거 한 축).
> **남는 것**: `run_wear.py --blind`(장부 `(MASK)`) · 정답 봉인 담당(로그 51 은 장세은, 이 추기는 마모 담당자 — 미정리) · 추가 교정 칩
> 둘의 CSV 가 들어오면 R 규칙을 세 쌍으로 다시 계산(규칙은 그대로, 값만).

> **2026-10-01 추기 — 블라인드 절차 정리 · 성공 기준 ③ · 칩 배정** (한영웅, 블라인드 첫 P/E 전 · 로그 48 §23 [D48-47]~[D48-50]).
>
> - **절차는 규칙으로 간다. `run_wear.py --blind` 는 만들지 않는다.** 마모·정답 봉인·Δx 마모는 **박지민**(보드 B) 하나가 한다.
>   지민은 평소 `accept --to <x>` 로 돌리고, 정답 파일의 sha256 만 커밋하며, 그 칩의 세션 로그와 `chip_pe.md` 행은 개봉까지 커밋하지
>   않는다. 추정자(한영웅)는 그 칩에 `run_wear`·`flash_id` 를 치지 않는다(tally 가 정답이다). Δx 를 쓰게 되면 A 행은 `cycle` 열을
>   0 부터 다시 매겨 넘긴다. 개봉 뒤 장부 행을 그대로 커밋한다. 3인 팀이라 완전 블라인드는 아니며 보고서에 그렇게 적는다
> - **개봉 prep 은 5회** (3회 → 5회. 한 번 잴 때 ±4ms 를 √5 로 줄인다). 나머지 개봉 절차는 위 추기 그대로
> - **성공 기준**: ① 정답 ∈ 95% 구간 · ② 68% 바깥 폭 ≤ 60,000 (최소선) · **③ 68% 바깥 폭 / MAP ≤ 2.0** — 등록 설정(배율 · R=2.0)
>   모의 블라인드 46점의 폭/MAP 90분위. MAP < 10,000 이면 ③ 대신 바깥 폭 ≤ 10,000. "90분위" 가 규칙이고 2.0 은 그 결과다.
>   근거와 낮은 x 예외의 경위는 로그 48 §23
> - **칩 배정**: chip09 교정(빠른, 100k, 13점 격자 그대로) · chip06 블라인드(빠른) · chip08 블라인드(느린; 새 배치 newchip 뒤 느린 칩이
>   둘 이상이면 교정으로 돌리고 새 칩을 블라인드로) · chip10 예비. 새 배치는 느린 교정(있으면) · 로트 브릿지 · 무마모 대조군 2.
>   위 추기의 "추가 구매 칩에서 교정 2(빠른·느린 하나씩)" 중 빠른 쪽을 원 배치로 옮긴 것이다 — 로트 교란 없이 빠른 무리를 3칩으로
> - **Δx(두 번째 dose)는 1차 블라인드에 넣지 않는다.** 1k 는 무의미하고(1k 변화 0.04ms 대 한 번 잴 때 폭 4~8ms) 5k~10k 는 매 사이클
>   회귀로 성립할 수 있으나 계단 칩에서 깨진다. 모의 블라인드로 먼저 시험한다(로그 48 §23)
> - **모의 블라인드가 보인 한계를 미리 적는다**: prep 소거 시간으로는 5만 번 넘은 칩의 x 가 좁혀지지 않는다(느린 무리 정답 9만 → MAP 5만,
>   68% 4.3만~9만). 지민이 5만 이상을 고르면 ②③ 은 통과해도 답의 쓸모가 작을 것이다. 그것도 결과다
>
> **남는 것**: 새 배치 newchip 뒤 chip08 재검토 · [U51-1] Δx 모의 시험 · 교정 칩이 늘면 ③ 의 값 재계산(규칙 그대로).
>
> **2026-10-01 저녁 추기 — 정답 봉인은 tally · chip06 추정은 두 번** (한영웅, chip06 개봉 prep 수령 뒤 · 추정 전 · 로그 48 §24 [D48-51]·[D48-52]).
>
> - **정답 봉인은 칩의 tally 로 갈음한다. 위 추기의 "정답 파일의 sha256 만 커밋" 은 하지 않는다.** tally 는 줄지 않고 지우려면 UID 를
>   쳐야 하므로 정답을 고쳐 적을 수 없다. 지민의 종이 기록은 개봉 때 tally 와 맞춰 보는 참고값이다. 지킬 것은 "추정을 커밋한 뒤에 tally 를 읽는다"
> - **chip06 은 두 번 추정한다** — v1 은 지금 커밋된 모델(교정 4칩), v2 는 chip09 를 교정 표에 넣고 R·③ 을 규칙대로 다시 낸 것. 둘 다 tally 를
>   읽기 전에 커밋한다. **판정용은 v2**, v1 은 교정 칩 추가 효과의 참고다(로그 48 [D48-55]). v1 뒤의 재량 수정은 판정이 아니라 탐색이다
> - v2 의 R 은 쌍을 늘려(빠른 3쌍 + 느린 1쌍) 지금 공식으로 다시 내고, 성공 기준 ③ 은 추정마다 자기 설정의 90분위로 판정한다(v1 은 2.0) —
>   로그 48 [D48-53]·[D48-54]
>
> **개봉 전 기록 — 계단 뒤에서 MAP 이 낮게 치우치는 이유** (2026-10-01, chip06 개봉 로그 추정 전 · 로그 48 §24 [D48-56]). 교정 칩 chip04 의
> 100k 뒤 newchip prep 1회(`session_chip04_…_20260927T173048Z`, 정답 100,000)로 모델을 돌렸다:
>
> | 교정 | R | MAP | 68% 바깥 (폭) | 95% |
> | ---- | - | --- | ------------- | --- |
> | chip01·04 (자기 포함) | 2 | 53k | 47k-97k (50k) | 34k-100k |
> | chip01·04 (자기 포함) | 1 | 95k | — | — |
> | chip01 (chip04 제외) | 2 | 66k | 35k-98k (63k) | 32k-100k |
>
> 섹터 0-6 소거 p50 중앙값의 신품 대비 배율 (교정 표):
>
> | x | 30k | 50k | 65k | 80k | 95-100k | 150k | 200k | 300k |
> | - | --- | --- | --- | --- | ------- | ---- | ---- | ---- |
> | chip01 | 2.36 | 2.90 | 3.86 | 3.90 | 3.97 | 4.13 | 4.51 | 5.13 |
> | chip04 | 2.61 | 3.31 | 3.38 | 3.45 | 3.55 | — | — | — |
>
> - **x 의 상한(100k)이 원인이 아니다.** MAP 은 최빈값이라 사전 범위를 잘라도 움직이지 않는다 — r 을 끄면 같은 상한에서 MAP 95k 다
> - **r 적분과 곡선 끝이 MAP 을 끌어내린다.** 관측(3.5-3.9배)이 맞는 곡선 지점은 약 50-95k 뿐이고 100k 너머엔 없다(chip04 곡선은 100k 에서
>   끝나고 chip01 은 거기서 4.0 이상). x 가 클수록 r > 1 쪽이 0 이 되어 사후분포가 50-90k 에서 평평해지고 MAP 이 그 안에 떨어진다
> - **근본은 관측 지표다.** 계단 뒤 배율은 35k 사이클에 3-5% 오르는데 칩 간 높이 차는 약 10% 다(chip01 3.9 · chip04 3.5). x 가 만드는
>   신호가 개체 차보다 작으므로, 교정 칩을 늘려도(chip01 의 300k 곡선이 이미 들어 있다) 계단 뒤의 MAP 은 좁혀지지 않고 구간만 정직하게
>   넓어진다. 좁히는 길은 다른 관측(Δx 기울기 · 프로그램 시간)이다
> - **그래서 모델은 고치지 않는다.** 비대칭 r 이나 칩별 곡선 모양은 새 모델링이고, 블라인드 직전 4칩으로 정하면 검증되지 않은 수정이 된다.
>   chip06 의 정답이 빠른 무리 계단 이전(약 5만 미만)이면 이 한계를 거의 겪지 않고, 이후면 MAP 이 낮게 치우치고 95% 구간이 넓게 나올 것을
>   여기 미리 적는다
>
> **우도는 그대로 — 합성 복원으로 확인** (2026-10-01, 로그 48 [D48-58]). 따로 돌린 prep 을 독립으로 치면 구간이 좁아지지만, 가정대로 만든
> 가짜 칩 500회에서 처음 보는 칩(정체 칩을 교정에서 뺌, prep 5회)의 68%/95% 구간이 53/82% 만 품었다. 기존(prep 전부를 관측 하나로)은 68/96%.
> v2 는 기존 우도 · chip09 · R 재계산이다. 수치와 그림은 `docs/results/data/synthetic_recovery_2026-10.md`
>
> **v2 설정** (2026-10-01 저녁, 로그 48 [D48-59]). 교정 5칩 · R 3.8(무리 안 4쌍의 곡선 맞춤 속도 비 → σ 0.49) · ③ 의 기준 5.99(v2 설정
> 모의 블라인드 폭/MAP 90분위). chip09 가 빠른 무리 안에서 2-3배 느리게 늙어 R 이 2.0 에서 커졌다.
>
> **v2 설정 정정** (같은 날, 로그 48 [D48-60]). R 은 **2.0**, ③ 은 **2.80**. 위의 R 3.8 은 교정 곡선 혼합이 이미 품은 칩 산포를 r 로 한 번 더
> 센 값이라 버렸다. 5칩 LOCO 포함률 68%/95% 가 R 2.0 에서 72/98% 로 명목에 가장 가깝다(R 3.8 은 81/98%). 정답을 읽기 전이다.

> **2026-10-01 추기 — 새 배치 4칩 배정** (한영웅, 로그 48 §25 [D48-57]). chip12 느린 교정(5번째 · 로트 브릿지) · chip08 느린 블라인드
> 확정 · chip15 2차 블라인드(느린 · 새 로트) · chip17 80°C 종단(온도 축, 히터와 계수 스윕 뒤) · chip18·chip10 무마모 대조군.
> 위 10-01 추기의 "새 배치 newchip 뒤 chip08 재검토" 는 이것으로 닫힌다. 교정이 6칩(빠른 01·04·09 · 느린 03·07·12)이 되면 R 과 ③ 을
> 규칙대로 다시 낸다.
>
> **2026-10-01 판정 — 블라인드 chip06** (한영웅, 개봉 2026-10-01 10:55 UTC · `docs/results/blind_chip06.md` · `docs/results/data/blind_chip06_2026-10.md`).
> 정답은 칩 tally 120/120 바이트 = **12,000 사이클** (박지민 종이 기록 일치 · 장부 마모 합계 12,000). 판정용 v2(교정 5칩 · R 2.0, 커밋 `04bab2a`)는
> MAP 7,001-8,000 · 68% 3,001-19,000 · 95% 1,001-34,000.
>
> | 성공 기준 | v2 (판정) | v1 (참고, 교정 4칩) |
> |---|---|---|
> | ① 정답 ∈ 95% | **참** | 참 |
> | ② 68% 바깥 폭 ≤ 60,000 | **참** (16,000) | 참 (9,000) |
> | ③ MAP < 1만 → 68% 바깥 폭 ≤ 10,000 | **거짓** (16,000) | 참 (9,000) |
>
> 정답은 v2 의 68% 구간 안, 사후분포 49번째 백분위다(MAP 은 정답의 약 0.6배로 낮게 치우침). v1 은 정답을 68% 구간 밖(79번째)에 두었다 —
> 교정에 chip09 가 들어와 넓어진 구간이 정직했다. ③ 은 교정 칩이 무리당 둘이던 모의 블라인드로 정한 값이라 무리 안 속도 산포를 몰랐다.
> 기준을 고치지 않고 거짓으로 적는다. 느린 무리(chip08) · 새 로트(chip15) 블라인드는 남는다.

> **2026-10-03 추기 — 10-01 배정 뒤 바뀐 것** (한영웅, 로그 48 §26 · §34 · §35 [D48-73]-[D48-77]). **chip17** 은 히터 한계로 칩 위
> 65°C 에서 돌았고 5만 회 계획보다 길게 10만 회까지 갔다(10-02 끝, `docs/results/wear/wear_temperature_chip17.md`). **chip12** 는 교정에서
> 빼고 다른 칩과 같은 칩으로 보지 않는다 — 구매처(알리익스프레스)가 다르고, 소거는 빠른 무리만큼 늘었는데 계단이 없고 프로그램은
> 그대로였다(`docs/results/wear/wear_endurance_chip12.md`). 그래서 위 10-01 추기의 「느린 교정 · 로트 브릿지」 와 「교정 6칩(느린
> 03·07·12)」 은 성립하지 않는다. 대신 새 배치 디바이스마트 칩 **chip16 · chip18** 을 상온에서 0 → 100k 닳게 하고, 같은 절차로 마치면
> **곡선이 어떻게 나오든 빠른 무리 교정에 넣는다** — 교정은 빠른 01·04·09·16·18 · 느린 03·07 의 7칩이 된다. 그때의 R 과 ③ 은 쌍 규칙을
> 버렸으므로([D48-60]) 방법부터 다시 정한다. 무마모 대조군은 chip18 대신 **chip14**(chip10 과 함께). 이 추기는 chip16 · 18 의 마모 결과를
> 보기 전에 커밋한다(chip18 은 10-03 01:09 KST 시작).

> **2026-10-04 추기 — chip18 종단 판정과 교정 편입** (한영웅, 세션 `1790989701`, 보드 A · 로그 48 §38). 새 배치 빠른 무리 첫 칩.
> 결과 `docs/results/wear/wear_endurance_chip18.md`.
>
> - **H1′ 참 (25MHz)** — 체크포인트 100 대비 −6.8 - 0.0ps. 45·75MHz 는 재지 않았다
> - **H2′ 참** — 섹터 1k 구간 중앙값 6.75-6.83ms, newchip prep 신품 대비 1.00
> - **H6 참** — 계단이 온 5섹터(53-100k) 직전 89.2-91.3ms(① 84ms 이상) · 착지 108.1-108.8ms(② 107-112ms). 첫 계단 구간 A 행의
>   94-108ms 가 0% — 두 봉우리. chip04 에 이어 두 칩째. 섹터 5 · 6 은 100k 에 88-90ms 로 ① 을 넘었으나 계단 없음
> - **(추가 관측, 종단 판정은 닫힘)** H3 높이 5섹터 19.7-23.1ms 로 21±4ms 안 · H4 계단 온 5섹터 ρ 0.70 · H5 는 chip18 의 계단이
>   chip04 · chip01 보다 늦어(53-100k) 같은 순위 섹터 범위가 40k 를 넘는 순위가 있다
> - **대조군 전제: 원격만 성립 (네 칩째)** — 원격 121-127 · 블록 2-7 0.98, 근접 7-13 1.09 · 블록 1 1.10
> - **교정 편입** — 위 10-03 추기대로 곡선을 보기 전 결정을 따라 넣었다(`wear_curves_chip18_2026-10.csv`). chip16 이 끝나기 전의 중간
>   상태라 R 은 2.0 그대로 둔다 — 6칩에서 명목에 가장 가까운 값은 1.6(68% 49/70 · 95% 69/70)이나 교정 곡선이 계속 늘어 모델에
>   반영하지 않고, v3 는 교정 칩이 더 쌓인 뒤 정한다(로그 48 [D48-86]). 교정 6칩 · R 2.0 LOCO 포함률 68% 60/70 · 95% 70/70 (5칩 42/58 · 57/58). 넣기 전 v2 의 현장 역산은
>   chip18 100k 를 MAP 54-55k 로 낮게 봤다(68% 밖 · 95% 안). v3 의 R · ③ 을 정하는 방법은 아직 정하지 않았다

> **2026-10-04 추기 — chip15 를 블라인드에서 느린 교정으로 (마모 전)** (한영웅, 로그 48 §39 [D48-90]). chip15(디바이스마트 · 신품 49.8ms)를
> 2차 블라인드에서 빼고 상온 0 → 100k 마모 뒤 **곡선이 어떻게 나오든 느린 무리 교정에 넣는다** — 느린 교정은 chip03 · 07 · 15 가 된다.
> 「교정에 없는 로트도 맞히나」 블라인드는 새로 산 10칩에서 마모 전에 다시 정한다. 이 추기는 chip15 의 마모를 시작하기 전에 커밋한다.

> **2026-10-05 추기 — chip15 종단 판정과 교정 편입** (한영웅, 세션 `1791078343` · `1791123800`, 보드 A · 로그 48 §40). 새 배치 느린 무리 첫 칩.
> 결과 `docs/results/wear/wear_endurance_chip15.md`.
>
> - **H1′ 참 (25MHz)** — 체크포인트 100 대비 −18.7 - +5.3ps. 45·75MHz 는 재지 않았다
> - **H2′ 거짓** — 섹터별 24-37k 에 +0.1ms, 100k 섹터 중앙값 8.25ms(+21%), 7섹터 함께. 느린 무리 세 칩 모두 거짓 · 상온 빠른 무리 네 칩 모두 참
> - **H6 판정 불가** — 7섹터 모두 100k 안에 105ms 를 넘지 않았다. 섹터 6 이 89k 에 100ms 를 넘었으나 95-100k A 행이 한 덩어리(94-108ms 75%)
> - **대조군 전제: 원격만 성립 (다섯 칩째)** — 원격 121-127 0.96 · 기준 32-127 0.98, 근접 7-13 1.09 · 블록 1 1.05 · 블록 2 0.96
> - **교정 편입** — 위 10-04 추기대로 넣었다(`wear_curves_chip15_2026-10.csv`, 사이클 69,109 의 USB 사건 7행을 뺌). 배율 100k 1.75 로 chip03(1.74)과
>   겹친다. 교정 7칩 · R 2.0 LOCO 포함률 68% 72/82 · 95% 82/82 (6칩 60/70 · 70/70). 넣기 전의 현장 역산은 100k 를 MAP 61-62k 로 읽었다(68% · 95% 안).
>   입력 C(prep 프로그램)의 「빠른 무리와 맞음」 경고가 헛울렸다 — prep 은 다 쓴 느린 칩에서도 0x00 루프만큼 오르지 않는다. R 은 2.0 그대로([D48-86])

> **2026-10-05 추기 — Δx(두 번째 dose)는 뺀다** (한영웅, 로그 48 §41 [D48-93]). 위 10-01 추기의 「Δx 모의 시험」 을 교정 7칩으로 했다. 5k · 10k 에서
> 68% 폭이 16 · 30% 줄지만 x 20k 이하에서만 포함률을 지키고, 50k 넘는 점(68% 23/25 → 17/25)과 chip18 · chip15 에서 틀린 쪽으로 좁혔다 —
> 계단(빠른 무리)과 후반 잡음(느린 무리) 때문에 Δx 기울기가 칩의 평생 속도를 대표하지 못한다. 블라인드 · 시연 절차에 넣지 않는다.
> 수치 `docs/results/data/inverse_v3_probe_2026-10.md` §1. 좁히는 다른 관측으로는 프로그램 시간(느린 무리)이 남는다

> **2026-10-05 추기 — v3 설정 등록 (블라인드 개봉 전)** (한영웅, 로그 48 §41 [D48-94]). 교정 7칩(빠른 01 · 04 · 09 · 18 · 느린 03 · 07 · 15).
>
> - **R 1.6** — 규칙 「LOCO 전체 68% 포함이 명목에 가장 가까운 R」. 7칩 82점에서 68% 59/82(72%) · 95% 81/82 · 68% 폭 중앙값 36,000
>   (R 2.0 은 72/82 · 82/82 · 43,000). 한계: 가장 빨리 늙는 chip04 의 68% 가 12점 중 4점 — 빨리 늙은 칩을 덜 썼다고 읽는 쪽으로 틀린다
> - **대표값은 사후 중앙값** (MAP 대신). 7칩 LOCO 추정 ÷ 정답 중앙값 MAP 0.72 → 사후 중앙값 0.95(R 2.0). 등급 판정 · 구간(HPD 68 · 95%)은 그대로
> - **입력 C(prep 프로그램 교차 확인)는 뺀다** — 다 쓴 느린 칩에서 「빠른 무리와 맞음」 으로 헛울렸다. 무리는 신품 소거로만 정하고 v3 는 프로그램 시간을 쓰지 않는다(로그 48 [U48-16])
> - Δx 없음 (위 추기). 위 성공 기준 ① ② ③ 은 바꾸지 않는다 — ③ 의 값을 v3 로 다시 낼지는 구현 때 같은 규칙으로
> - 남은 블라인드(chip08 · 새 10칩)는 v3 로 판정한다. 수치 `docs/results/data/inverse_v3_probe_2026-10.md` §2 · §3 · 같은 날 `wear_inverse.py` 에 구현(로그 48 §42)

> **2026-10-05 추기 — v3.1 설정 등록 (블라인드 개봉 전)** (한영웅, 로그 48 §43 [D48-95]). v3 에서 **느린 무리의 R 만 1.3** 으로 바꾼다.
>
> - **R 은 무리별** — 빠른 1.6(v3 그대로) · 느린 1.3. 느린 3칩 LOCO 34점에서 68% 31 · 95% 34 · 68% 폭 중앙값 31,500 (R 1.6 은 30 · 34 · 36,000).
>   R 1.0 · 1.1 은 95% 가 chip07 100k 를 놓치고(33/34), 1.2 가 통과하는 가장 작은 값 — 그 한 칸 위를 골랐다. 느린 쌍 속도 차 1.11 · 1.24 · 1.47배
> - 교정 7칩 LOCO 82점 전체: 68% 60 · 95% 81 · 68% 폭 중앙값 33,000 (v3 는 59 · 81 · 36,000). 빠른 무리 수치는 v3 와 같다
> - 위 v3 추기의 「명목에 가장 가까운 R」 은 정확하지 않다 — R 1.3-1.8 에서 68% 포함이 57-62점으로 평평하다. R 이 바꾸는 것은 폭과 95% 포함이다
> - 대표값(사후 중앙값) · 구간(HPD) · 입력 · 성공 기준은 그대로. 한계: 느린 무리 근거가 3칩
> - 남은 블라인드(chip08 · 새 10칩)는 **v4 로 판정할 예정이다** — 위 v3 추기의 「v3 로 판정」 을 바꾼다. 그때까지 교정 곡선을 늘리고 고도화를
>   검토하며, v4 는 개봉 전에 등록한다. v3.1 은 그 사이의 현행 모델이다. 수치 `docs/results/data/inverse_v3_probe_2026-10.md` §5

> **2026-10-05 추기 — 모델 버전별 사양은 S-5 로** (한영웅, 로그 48 [D48-96]). v1 - v3.1 의 사양을 한 표로 모은 정본은
> `docs/spec/s5.lifetime_inverse_model.md` 다. 이 절의 추기는 등록 시점의 원문으로 남기고, v4 부터는 S-5 에 등록한다.

> **2026-10-06 추기 — chip10(`DF`) 종단 결과 · 교정 밖** (한영웅, 세션 `1791175305`, 보드 A · 로그 48 §50 [D48-101] [U48-21]).
> **chip10 은 W25Q64JV 다**(마킹 `25Q64JVSIQ` `1850`, 같은 날 판독) — 이 사양의 다른 칩(FV)과 다른 세대라, 아래 판정은 FV 가설을 JV 칩에
> 대 본 결과로 읽는다. 같은 날 `--no-calib` 으로 승격했다(교정 밖 · 다른 칩과의 비교는 보류) — `docs/results/wear/wear_endurance_chip10.md`.
>
> - **H1′ 참 (25MHz)** — 체크포인트 100 대비 −3.2 - +8.5ps
> - **H2′ 거짓** — 0x00 마모 루프 프로그램 p50 이 1k 5.96 → 100k 6.63ms(1.11배). 빠른 무리 넷은 1.00-1.01 이었다
> - **H6 판정 밖** — 100k 안에 계단이 없다(105ms 이상 A 행 0). 섹터 100k 중앙값 78-87ms
> - **대조군 전제: 교란 없음** — 100k 뒤 newchip 에서 근접 7-13 0.98 · 블록 1 0.99 · 원격 1.02 (D1 칩은 근접 1.06-1.15)
> - **무리** — 신품 33.0ms 로 빠른 무리지만 소거 100k 2.55배(빠른 2.80-3.97 · 느린 1.59-1.75), 계단 없음 · 프로그램 상승은 느린 쪽. 교정 밖 현장
>   역산은 100k 칩을 MAP 54-55k 로 보고 95% 구간에서도 놓쳤다. 교정에 넣을지는 [U48-21] — 곡선을 본 뒤의 결정이다([D48-97])

> **2026-10-09 추기 — v4 등록 (블라인드 개봉 전)** (한영웅, 로그 52 [D52-2] · [D52-6] - [D52-8]). 사양은 S-5 §2 v4 열, 수치는
> `docs/results/data/inverse_v4_eval_2026-10.md`. 고른 값 다섯을 잰 값으로 — ① 셀을 정규 대신 분위수 21개 ② 증거량을 상관에서 잰 유효 관측 수
> ③ 교정 곡선을 칩 속도로 정렬 ④ R 을 정렬 뒤 σ_r 에서 유도 ⑤ LOCO 관측을 A 행 그대로 · 합격 띠를 먼저.
>
> - **교정 8칩** — 빠른 chip01 · 02 · 04 · 09 · 18 · 느린 chip03 · 07 · 15 (접미사 없는 표 전부, 분위수 열 붙여 재생성 · p10/p50/p90 불변)
> - **ρ** — ρ_s 0.00 · ρ_p 0.78 · ρ_chip 0.29 (교정 8칩 A 행 · 전체값 하나). chip06 개봉 prep 5회 0.00 · 0.72 로 마모 루프와 같다. ρ_chip 은 등록
>   절차 중에 더한 것 — 칩 안 표의 ρ 로는 95% 가 과신(90.2%)이었고, 그 식이 「이 칩이 교정과 다른 몫」을 못 보고 있었다. prep 1회 n_eff 2.55 · 5회 2.68
> - **R** — 유도. 8칩에서 빠른 2.97(σ_r 0.507 · M 5) · 느린 1.52(0.184 · 3). 교정 칩이 늘면 저절로 다시 난다
> - **LOCO (등록 방식 rows P5 · 94점 · 반복 20)** — 68% 79.1% · 95% 96.5% · 68% 폭 중앙값 33,000 · |중앙값 − 정답| 중앙값 7,500. 띠(68% 56-72 ·
>   95% 86-93 / 94)에 대면 **68% 는 과소신 · 95% 는 합격**. 과소신은 그대로 등록한다 — 안전한 쪽의 오차이고, 빠른 무리의 R 이 chip04 의 모양 차이를
>   속도 흩어짐으로 흡수한 결과라 모수가 아니라 교정 칩이 늘어야 준다. p50 관측은 75 · 91 / 94 (v3.2 는 67 · 93)
> - **합성 복원** — 정체 칩을 뺌 · prep 5회: 68% 73 · 95% 96 (v3.2 72 · 96)
> - 대표값(사후 중앙값) · 구간(HPD 68 · 95%) · 입력(A · B) · 성공 기준 ① ② ③ 은 그대로. ③ 의 값은 내지 않았다
> - 한계: 빠른 무리는 「모양이 같고 가로축만 늘어난 가족」이 아니다(ρ_chip 빠른 0.33 · chip04 잔차 −0.12) — chip04 는 12점 중 68% 41% · 95% 80%.
>   느린 무리 R 은 칩 셋에서 나온 값. 무리 경계 40ms 의 틈(34-47ms)은 미검증
> - **남은 블라인드(chip08 · 새 10칩)는 v4 로 판정한다.** 공모전 보고서 · 발표 수치는 v3.2 그대로([D48-107])

> **2026-10-06 추기 — chip02 를 빠른 무리 교정으로 (첫 결과 전)** (한영웅, 로그 48 §51 [D48-103]). chip02(FV `1434` · 신품 27.2ms)를 상온
> 0 → 100k 마모 뒤 **곡선이 어떻게 나오든 빠른 무리 교정에 넣는다** — 빠른 교정은 chip01 · 04 · 09 · 18 · 02(· chip16 이 끝나면 16)가 된다.
> 마모 START(09:56:29Z) 직후, 첫 체크포인트 결과를 보기 전에 커밋한다.
---

> **2026-10-12 추기 — chip16 은 온도 축으로 (등록 전제가 깨짐)** (한영웅, 로그 53 [D53-4]). 2026-10-03 에 상온 0 → 100k · 곡선 무관 빠른 무리 교정으로
> 등록한 chip16 을 박지민이 보드 B 에서 히터 설정 65°C 로 돌렸다(10-08 - 10-09, 세션 `1791434740` · `1791523104` · `1791523150`). 상온 전제가 깨졌으므로
> [D48-75] 의 교정 편입은 적용하지 않고 chip17 과 같이 **온도 축 · 교정 밖**(곡선 `_64C`)으로 승격한다. 빠른 무리 교정은 chip01 · 02 · 04 · 09 · 18 그대로,
> v4 → v4.1(chip06) 순서 불변. 판정(`docs/results/wear/wear_temperature_chip16.md`): 폭 −8.3 - +4.6ps(H1′ 참) · 프로그램 1.00(H2′ 참) · 소거 100k 4.34배 · 계단
> 1.19 - 1.22(H6 와 맞음) — chip17(2.44 · 계단 없음 · 프로그램 +20%)과 반대. 상온 v4 로 10/12 · 11/12. 온도 로그는 히터 상태와 맞지 않아(꺼진 채 3.6시간
> 66 - 67°C · 켜진 채 10시간 60 - 63°C) 칩 온도 미확인 — 「65°C 이력」 이라 쓰지 않는다. 온도 런은 앞으로 센서 · 히터 배치 사진을 시작 조건으로 둔다.

> **2026-10-12 추기 — chip14 는 JV, chip10 과 「JV 둘」 로 별개 승격** (한영웅, 로그 48 [U48-22] 닫음 · 로그 53 [D53-5]). 무마모 대조군으로 등록했던 chip14 를
> 박지민이 10/4 - 10/6 에 100k 까지 닳게 했고(로그 48 [D48-108]), 마킹 판독 `25Q64JVSIQ` `1749` 로 JV 가 확정돼 10/9 규칙대로 `--no-calib` 별개 승격 · `SEPARATE`.
> v4 교정(FV 8칩) 불변. 판정(`docs/results/wear/wear_endurance_chip14.md`): 폭 12점 중 11점 3σ 안(90k −43.4ps, 창 위치 미확인) · 프로그램 1.03 · 소거 100k 2.65배,
> **7섹터 모두 84ms 를 넘고도 계단 없음 — H6 는 FV 의 규칙**. 날짜 코드 예측 대조: chip10 `1850` · 14 `1749` · 16 `1551` · 17 `1430` 전부 「1430 이후」(4/4),
> 「chip10 · 14 같은 로트」 는 거짓(세대는 같음). 모델 적용 범위는 「W25Q64FV · 날짜 코드 1309 - 1551」 로 적는다. 같은 날 저녁 세션 로그 16개 수령 — 창 위치(80k - 100k
> 2 - 6스텝 이동, 90k 폭 −43ps 는 장착 쪽) · 현장 역산 59 - 60k(95% 23 - 100k, 정답 상한 끝 — chip10 54 - 55k 와 같은 방향) · 대조군 전제 원격 1.03 성립 · 근접 1.10 기록.

> **2026-10-14 추기 — 빠른 무리 두 칩을 200k 까지 (사전 등록 밖의 관측 · H6 ② 수정)** (한영웅, 로그 52 [D52-9] · §13). 역산 답 범위를 150k 너머로 넓히려고
> chip06(세션 `1791800419`) · chip09(`1791904816`)를 100k → 200k 로 더 닳게 했다 — 정격 너머는 종단에 넣지 않는다는 9/26 결정의 예외이고 판정이 아니라 관측이다.
> 결과(`docs/results/wear/wear_endurance_200k.md`): 폭은 200k 까지 3σ 안(chip06 보드 A 안 ±8ps · chip09 +25ps 안) · 100k 안에 계단이 없던 12섹터가 전부 110k-158k 에
> 전환, 높이 18.1-21.3ms(H3 안) · 160k-200k 는 두 칩 다 104-109ms 평탄 · 프로그램은 chip06 1.9배 · chip09 1.01 로 갈림. **H6 ② 「착지 107-112ms」 는 두 칩 14섹터가
> 전부 94.6-104.2 로 아래에 떨어졌다** — 직전 수준(83-88ms)에 21ms 양자를 더한 값이라 고정 띠가 아니다. 다음 칩(chip03 200k)에 대한 예측은 「① 직전 84ms 이상 ·
> ② 착지 = 직전 + 21±4ms」 로 둔다. H4 는 0.32 · −0.29 로 못 미침(chip06 신품값은 101-1,000 대리). 300k 는 가지 않는다 — 2차 계단은 chip01 로 충분하고 같은 구간에
> 칩이 여럿이어야 ρ_chip 을 잰다.

> **2026-10-16 추기 — 느린 무리 chip03 을 200k 까지: 10/14 예측 틀림, 느린 무리에는 H6 가 서지 않는다** (한영웅, 로그 52 §13 추기). 100k 에 88-93ms 로 문턱에 있던
> chip03(세션 `1791990254`)에 「110-130k 에 계단 · 착지 = 직전 + 21±4」 를 걸었는데, 계단 없이 미끄러졌다 — 한 구간 상승 최대 5-12ms(빠른 무리 18-21), p10-p90 20-25ms(빠른
> 무리 8-12)로 벌어진 채 p50 이 86 → 107ms 로 100k 에 걸쳐 올랐고, 105ms 이상 A 행 비율이 70k 에 걸쳐 0 → 66%(chip09 는 20k 안에 6 → 77%). 같은 문턱에서 빠른 칩은 뛰고
> 느린 칩은 미끄러지므로 **계단은 빠른 무리의 표지**이고(0 → 100k 의 「느린 세 칩 계단 없음」 이 「아직 못 와서」 가 아님), H6 ①·② 는 빠른 무리 안에서만 쓴다. 폭 +16ps 안 ·
> 프로그램 1.7-2.3배 · 휴지 19일 회복 없음. 느린 무리 소거 축은 100k-200k 에서 평탄 구간 없이 1.74 → 2.10. 다음 느린 칩 chip15 예측: 「계단 없이 미끄럼 · 200k 배율 약 2.1」.
> 결과 `docs/results/wear/wear_endurance_200k.md` §6.

> **2026-10-17 추기 — chip15 200k: 10/16 예측 맞음** (한영웅, 로그 52 §13 추기). 느린 무리 두 장째 chip15(세션 `1792080192`)는 「계단 없이 미끄럼 · 200k 배율 약 2.1」 대로 —
> 한 구간 상승 4-11ms · p10-p90 18-25ms · 배율 2.25(조금 높음), 섹터 4 · 2 는 128-131ms 로 한 수준 더(역시 미끄럼). 폭 +13ps 안 · 프로그램 1.5-2.0배 · 휴지 12일 회복 없음.
> 느린 무리 100k-200k 곡선 두 장(03 · 15)이 같은 모양(150k 1.87 · 1.88, 200k 2.10 · 2.25, 평탄 구간 없음). 다음 chip21(0 → 200k) 예측 「미끄럼 · 200k 배율 2.1-2.3」.
> 결과 `docs/results/wear/wear_endurance_200k.md` §7.

> **2026-10-19 추기 — chip21 0 → 200k: 예측 틀림, 「신품 소거 느림 = 노화 느림」 이 두 번째로 깨졌다** (한영웅, 로그 52 §13 추기 · [U52-7]). 3차 구매 chip21(신품 48.9ms ·
> FV `1647`, 세션 `1792170748`)에 「미끄럼 · 200k 배율 2.1-2.3」 을 걸었는데 미끄럼은 맞고 속도가 빠른 무리다 — 10k 1.49 · 50k 2.19 · 100k 2.63 · 200k 2.93(느린 03 · 15 는
> 100k 1.74 · 200k 2.10-2.25), 프로그램 150k 까지 불변, 폭 −6 - +3ps. 알리 chip12(1.40 · 1.99 · 2.58 · 불변)와 같은 꼴이라 [D48-73] 의 「구매처」 읽기는 접고 **FV 안의 세 번째
> 종류**(신품 느림 · 노화 빠름 · 미끄럼 · 프로그램 불변)로 본다 — 느린 신품 5칩 중 2. 40ms 경계로 무리를 가르는 S-5 의 전제는 빠른 신품(6/6 빠른 노화)에서만 선다. 상온 9칩
> 모델이 이 칩을 68% 0/12 · 95% 2/12 로 전부 틀린다. 같은 날 chip21 은 교정에서 뺐다(`_nocal`, 로그 52 [D52-12] — v4.3 은 다섯 장 200k 로 답 범위만, 두 종류는 v4.4). 적용 범위는 「W25Q64FV · 1309 - 1551」 그대로이고,
> 느린 신품에 대한 답에는 「chip12 · 21 형이면 전부 틀린다(5칩 중 2)」 가 한계로 붙는다. 결과 `docs/results/wear/wear_endurance_200k.md` §8.

> **2026-10-21 추기 — chip07 200k: 미끄럼 맞음 · 배율 1.91 (예측 약 2.1 보다 낮음).** 느린 형 세 칩 200k 1.91 · 2.10 · 2.25 가 100k 순서를 따른다. 105ms 미도달.
> A 행 결손 두 곳(전원 상실 · 작업 실수). `docs/results/wear/wear_endurance_200k.md` §9.

> **2026-10-23 추기 — v4.3 등록 (블라인드 chip08 개봉 전)** (한영웅, 로그 52 [D52-14] - [D52-16]). 사양은 S-5 §2 v4.3 열 — v4 식 그대로에 교정 9칩의 100k 너머 곡선 6장
> (chip01 300k · chip03 · 06 · 07 · 09 · 15 200k) · ρ_chip 재측정 0.21 · 대표값 사후 평균(상한 처리 후보 일곱을 로그 CRPS · 배율 오차로 비교해 선택). LOCO 106점 68% 81.6%(과소신) ·
> 95% 94.1%(합격) · 성공 기준 ③ 값 1.33. 학습 곡선: 빠른 무리는 교정 3칩에서 포화. 알려진 한계 — 정답 80k 이상 과소추정(0.84, 소거 한 지표의 정보 한계) · chip04 형(빠른 속도
> 가장자리) · chip12 · 21 형 느린 신품(전부 빗나감) · 고온 이력 칩 68% 22/48(95% 47/48). 개봉은 이 등록 뒤에만, 개봉 뒤 이 판으로 판정한다.

> **2026-10-23 추기 — chip02 200k · 85°C 두 칩** (한영웅, 로그 53 §5). ① chip02(빠른 무리 마지막 미계단 칩) 100k → 200k: 7섹터 148-178k 계단 — **빠른 FV 7/7 이 계단을
> 밟았다**(2.5만-17.8만 회). 200k 4.00배, 110k 재장착 단차 +128ps(110k-200k ±3ps). ② 설정 85°C(의도 85°C — 파일명 65C 는 틀림) chip24(빠른) · chip22(느린) 0 → 100k: chip24 는
> 상온 빠른 띠 한가운데(3.47배 · 계단 · 프로그램 불변 · 상온 모델 12/12), chip22 는 상온 느린 띠 위(1.90배, 상온 모델 68% 3/12 · 95% 12/12) — 느린 신품 개체 산포와 구별되지 않는다.
> 65 · 85°C 네 칩 합쳐 상온 모델 95% 47/48 · 68% 22/48. 온도 축은 넣지 않는다(로그 52 [U52-6]). `docs/results/wear/wear_temperature_85C.md` · `wear_endurance_200k.md` §10.

> **2026-10-25 추기 — 모델 적용 범위를 「W25Q64FV」 전체로 넓힌다** (한영웅). 10/12 의 「W25Q64FV · 날짜 코드 1309 - 1551」 은 그때까지 잰 FV 의 날짜 코드 범위였을 뿐이고,
> 3차 구매 FV(chip21-26, `1413` - `2122`)도 같은 FV 다. 범위는 세대(FV)로 긋고 날짜 코드로 긋지 않는다. 날짜 코드 1642 - 2122 칩의 교정 반영은 따로 정하고(chip21 은 `_nocal` 그대로),
> FV 느린 신품의 chip12 · 21 형 한계(10/19 추기)는 그대로 붙는다. 신품 전수는 이날 끝(31칩 = FV 19 · JV 12, `docs/results/newchip_survey.md` 10/25 추기)

> **2026-11-01 추기 — 85°C 온도 칩 두 개의 v4.3 블라인드 판정 (정답 봉인 없이 모델 고정)** (한영웅, 로그 52 §18 · 로그 53 §6). 박지민이 85°C 로 마모한 chip26(빠른, 0 → 70,000) ·
> chip23(느린, 0 → 26,528)을 보드 A 에서 상온 newchip 1회씩 재고 v4.3 7장 판(10/23 등록 그대로)으로 추정했다. 정답은 묶음으로 먼저 받아 봉인하지 않았다 — 모델 · 교정 표 · 코드가
> 고정이라 판정은 성립하고 봉인만 빠졌다(영웅님 결정). **chip26 합격**(60-61k · 68% 31-85k · 95% 25-100k, 정답 70,000 은 68% 안, 0.86배 — 성공 기준 ①②③ 통과) ·
> **chip23 불합격**(92-93k · 95% 78-100k, 정답 26,528 밖, 3.5배 과대 — ① 불통과). chip23 의 26k 배율 1.77 은 상온 chip21 · 12 와 같은 자리라 원인은 온도가 아니라 10/19 추기의
> chip12 · 21 형 한계다. 등록 판정 칩 chip08 은 그대로. `docs/results/blind_temp_chip23_chip26.md` · `docs/results/data/blind_temp_chip23_chip26_2026-11.md`

> **2026-11-11 추기 — chip08 도 정답 봉인 없이 v4.3 「모델 고정 판정」** (한영웅, 로그 52 §19 [D52-18]). 등록 판정 칩 chip08 의 11/5 마모 정답이 대장 커밋 제목과 대화로 판정자에게 드러났다. v4.3 은 10/23 등록 뒤 바뀌지 않았고 chip08 마모는 그 뒤라 모델 쪽에서 정답에 끌릴 길은 없다 — 빠진 것은 봉인 절차뿐이다. 봉인 판정은 chip06 하나로 남는다.

> **2026-11-11 추기 — chip08 판정 결과: 불합격** (한영웅, 로그 52 §19). 2026-11-05 상온 0 → 30,000(세션 `1793893689`) 뒤 같은 날 newchip 1회(관측 1.60배)를 v4.3 7장 판(10/23 등록 그대로)으로 추정했다 —
> 71-72k · 68% 58-96k · 95% 43-100k, 정답 30,000 밖 · 2.38배 과대(성공 기준 ① 불통과 · ② ③ 통과). 같은 30k 의 마모 중 배율 1.51 은 느린 교정 셋(1.32-1.36)과 chip12 · 21 형(1.79-1.90) 사이 —
> 교정 셋보다 1.5-2.3배(가운데 chip03 대비 약 1.8배) 빨리 늙어 느린 무리 R 1.59 너머다. 10/19 추기의 「chip12 · 21 형」 한계와는 다른 중간 속도라, 느린 신품의 노화 속도 산포가 교정 3칩보다 넓다는 재료([U52-7]).
> `docs/results/blind_chip08.md` · `docs/results/data/blind_chip08_2026-11.md`

## 16. 본 사양 범위 밖

- P/E 사이클러 구현 층위 (PS C 전제 — 3인 확정 필요)
- 온도 제어 (히터 도착 후. 본 사양은 기록만)
- W25N(NAND) 확장
