young-0320/flash-margin-bench/docs/spec/s5.lifetime_inverse_model.md

# S-5. 수명 역산 모델 사양 (v1 - v4)

- **수신자**: 한영웅의 AI (구현) — `host/analysis/wear_inverse.py` · 시험 `host/tests/test_wear_inverse.py`
- **인수 판정**: 한영웅
- **작성**: 2026-10-05 · v4 초안 2026-10-08
- **현행 버전**: **v4.3** (2026-10-23 등록 · 블라인드 개봉 전, 로그 52 [D52-16]). 남은 블라인드(chip08 · 새 칩)는 v4.3 7장 판으로 판정한다(§9 9번). chip08 은 정답이 드러나 봉인 없는 「모델 고정 판정」 이다(2026-11-11, 로그 52 [D52-18]). `--model v4.3` 이 기본,
  `--model v4` · `--model v3.2` 로 이전 모델 — 공모전 보고서의 수치는 v3.2 이하다(로그 48 [D48-107]) · 11/6 발표는 v4.3(로그 54 [D54-3]). 등록 경위는 로그 52 §15 · §17, 수치는 `docs/results/data/inverse_v4_3_eval_2026-10.md`
- **채택 근거**: 본 문서는 버전별 사양만 싣는다. 각 값을 왜 그렇게 정했는지는
  `docs/log/young/48.pilot_wear_handler_and_plan_approval.md` §22 - §24 · §41 - §43 · §45 ([D48-40] - [D48-60] · [D48-93] - [D48-95] · [D48-98]) ·
  v4 는 `docs/log/young/52.inverse_v4_measured_not_chosen.md` ([D52-1] - [D52-8])
- **등록 이력**: `docs/spec/s1.wear_bench_spec.md` §15 의 날짜별 추기 (블라인드 개봉 전 등록의 원문)
- **성능 수치**: v3 `docs/results/data/inverse_v3_probe_2026-10.md` §4 · §5 · §7 · v4 `docs/results/data/inverse_v4_eval_2026-10.md`
- **개념 설명**: `docs/concepts/15.lifetime_inverse_model.md`

---

## 1. 범위

개봉 전 prep 1회 이상의 섹터별 소거 시간에서, 마모 섹터 0-6 의 누적 P/E 사이클 x 를 구간으로 추정한다.
신품 기록 없이 칩 안의 값만 쓰는 1차(현장) 모델이다. 신품 집계표를 더하는 2차(참조) 모델은 구현하지 않았다.

## 2. 버전별 사양

| 항목 | v1 | v2 | v3 | v3.1 | v3.2 | v4 | v4.1 | v4.3 |
|---|---|---|---|---|---|---|---|---|
| 등록일 | 2026-09-30 | 2026-10-01 | 2026-10-05 | 2026-10-05 | 2026-10-05 | 2026-10-09 (코드 2026-10-08) | **미등록** — 2026-10-12 측정 (등록은 로그 52 [U52-5]) | **2026-10-23 등록** (블라인드 chip08 개봉 전, 로그 52 [D52-16]) — 브랜치 `inverse-v4.3-ceiling` 머지 |
| 교정 칩 (빠른 무리) | chip01 · 04 | chip01 · 04 · 09 | chip01 · 04 · 09 · 18 | v3 와 같음 | v3 와 같음 | 접미사 없는 표 전부 (2026-10-08: chip01 · 02 · 04 · 09 · 18) | v4 + **chip06** (chip01 · 02 · 04 · 06 · 09 · 18) | v4.1 과 같음 — **100k 너머: chip01 300k · chip02 · 06 · 09 200k** |
| 교정 칩 (느린 무리) | chip03 · 07 | chip03 · 07 | chip03 · 07 · 15 | v3 와 같음 | v3 와 같음 | 같음 (chip03 · 07 · 15) | 같음 (chip03 · 07 · 15) | 같음 (chip03 · 07 · 15) — **세 칩 모두 200k 까지**(chip07 10/21). chip21 은 밖([D52-12]) |
| 셀 분포 | 정규 (p50 · (p90−p10)/2.5631) | 같음 | 같음 | 같음 | 같음 | **분위수 21개 (§4)** | 같음 | 같음 |
| 증거량 (유효 관측 수) | 1 (prep 전부를 하나로) | 같음 | 같음 | 같음 | 같음 | **n_eff(ρ_s, ρ_p, ρ_chip) (§5)** — prep 1회 2.55 · 5회 2.68 | 같음 — ρ 등록값 그대로면 prep 1회 2.55 · 5회 2.68 | 같음 |
| 교정 곡선 정렬 | 없음 | 없음 | 없음 | 없음 | 없음 | **칩 속도 r̂_j 로 공통 시계 (§4)** | 같음 | 같음 (100k 안에서 정렬) |
| 속도 배율 범위 R (빠른 무리) | 2.0 | 2.0 | 1.6 | 1.6 | 1.6 | **σ_r 에서 유도 (§5)** — 등록 시 8칩 2.97 | 유도 — 9칩 **2.72** (σ_r 0.473 · M 6) | 같음 규칙 — **2.80** (7장 판: chip02 r̂ 0.636 → 0.608) |
| 속도 배율 범위 R (느린 무리) | 2.0 | 2.0 | 1.6 | 1.3 | 1.3 | 같은 규칙 — 등록 시 1.52 | 같음 규칙 — 1.52 | 같음 규칙 — **1.59** |
| ρ_s · ρ_p · ρ_chip | — | — | — | — | — | **0.00 · 0.78 · 0.29** (`--rho`, 2026-10-09 · 전체값 하나) | v4 등록값 그대로 (9칩 재측정 0.00 · 0.78 · **0.27** — 감도 LOCO 80.3 · 94.6%) | 0.00 · 0.78 · **0.21** (6장 판 재측정) |
| r 적분 | 로그 등간격 41점 평균 | 같음 | 같음 | 같음 | 격자 없는 적분 (§5) | 같음 | 같음 | 같음 — **곡선 지점 M = x·r 이 100k 너머 곡선(5장 → 7장)을 씀** |
| 대표값 | MAP 구간 | MAP 구간 | 사후 중앙값 구간 | 사후 중앙값 구간 | 사후 중앙값 구간 | 같음 | 같음 | **사후 평균** (v4.3.2 — CRPS · 배율 오차로 7안 중 선택, 로그 52 §15) |
| 구간 | HPD 68% · 95% | 같음 | 같음 | 같음 | 같음 | 같음 | 같음 | 같음 |
| 입력 C (prep 프로그램 교차 확인) | 있음 | 있음 | 없음 | 없음 | 없음 | 없음 | 없음 | 없음 |
| LOCO 관측 | 구간 p50 7개 | 같음 | 같음 | 같음 | 같음 | **A 행 그대로, prep 수만큼 (§7)** | 같음 | 같음 (정답 ≤ 100k 의 106점) |
| LOCO 합격 띠 | 없음 | 없음 | 없음 | 없음 | 없음 | **점 수에서 미리 (§7)** | 같음 — 106점: 68% 63-81 · 95% 97-105 | 같음 — 106점: 68% 63-81 · 95% 97-105 (고마모 0.90 기준은 미충족 — 정보 한계) |
| 기록의 답 줄 | MAP · 68% · 95% | 같음 | 중앙값 · MAP · 68% · 95% | v3 와 같음 | v3 와 같음 | 같음 (A·B 줄 끝에 σ_r · ρ_s · ρ_p · ρ_chip · n_eff) | 같음 | 같음 |
| 성공 기준 ③ 의 값 | 2.0 | 2.80 | 미정 | 미정 | 미정 | 미정 | 미정 | **1.33** (rows P5 × 20 · 106점의 「68% 바깥 폭 ÷ 대표값(사후 평균)」 90분위) |
| 블라인드 판정에 쓴 칩 | chip06 (참고) | chip06 (판정용) | 없음 | 없음 | 없음 | (chip08 · 새 10칩 예정) | (미등록) | chip08 불합격(모델 고정 판정 — 정답 봉인 없음, 2026-11-11 로그 52 [D52-18] · §19 — 정답 30,000 · 2.38배 과대 · 95% 밖, `docs/results/blind_chip08.md`) · 2026-11-01 85°C 온도 칩 chip26 합격 · chip23 불합격(모델 고정 판정, 정답 봉인 없음 — `docs/results/blind_temp_chip23_chip26.md`) |
| LOCO 등록 수치 (rows P5 · 94점) | — | — | — | — | (p50 67 · 93 / 94) | 68% 79.1% **과소신** · 95% 96.5% 합격 · 폭 33,000 | **106점**: 68% 80.4% 과소신 · 95% 94.9% 합격 · 폭 34,000 (p50 86 · 100 / 106) | **7장 판 106점**: 68% 81.7% 과소신 · 95% 94.5% 합격 · 폭 34,000 · 50-100k 추정/정답 0.84 · 합성(정체 칩 뺌 · prep 5) 71 · 96 |

- 표에 없는 항목은 §3 - §6 의 공통 사양이며 모든 버전이 같다
- 버전을 다시 돌릴 때: `--model v3.2` 가 v3.2 이전의 계산 경로(정규 셀 · 증거 1 · 정렬 없음 · R 상수)다. 교정은 `--curves` 로 그 버전의 칩만, R 은
  `--rate-range` 로 준다. v1 · v2 의 대표값은 기록의 MAP 칸이다. r 적분은 현행 코드가 v3.2 방식 하나라, v3.1 이전 버전의 등록 수치(41점)와는
  포함 수가 한두 점 다를 수 있다. 2026-10-08 확인: `--model v3.2 --loco` 가 10-07 기준선(68% 67/94 · 95% 93/94)을 그대로 낸다
- **v4 의 원칙** — 결과를 보고 고르던 값(R · 증거 1/k · 셀 모양)을 전부 교정 데이터에서 **잰 값**으로 바꾼다. LOCO 포함률은 손잡이가 아니라 채점표다.
  근거는 로그 52. 등록 때 68% 는 띠 위(과소신)였고 그대로 등록했다 — 안전한 쪽의 오차이고, 출처는 빠른 무리의 R(chip04 의 모양 차이가 σ_r 에
  들어감)이라 모수가 아니라 교정 칩이 늘어야 준다(로그 52 §10)

## 3. 입력 (공통)

| 입력 | 정의 | 쓰임 |
|---|---|---|
| A | 섹터 32-127 소거 시간의 중앙값 | 이 칩의 신품값 · 무리 분류 · 배율의 분모 |
| B | 섹터 0-6 소거 시간 (prep k 회면 7k 개) | x 추정의 관측 |
| C | 섹터 0-6 프로그램 시간 (v1 · v2 만) | 무리 선택의 교차 확인 문구 — x 추정에 넣지 않는다. 중앙값 7.3ms 미만이면 「빠른 무리와 맞음」 |

- **무리**: A 가 40ms 미만이면 빠른 무리, 이상이면 느린 무리. 교정 곡선은 같은 무리의 칩만 쓴다
- **눈금**: 배율(ratio). 관측은 B ÷ A, 교정은 구간값 ÷ 그 칩의 신품 소거 중앙값(`newchip_survey_2026-09.csv`)
- **쓰지 않는 것**: 폭 · BER 바닥 · 집계표의 신품값(블라인드 칩) · 기준 섹터의 프로그램 시간 · 두 번째 dose Δx

## 4. 교정 (공통)

- **표**: `docs/results/data/wear_curves/wear_curves_chipNN_YYYY-MM.csv` — 마모 루프 A 행을 1,000사이클 구간 × 섹터로 묶은 p10 · p50 · p90
- **대상**: 이름에 접미사가 없는 표만. `_65C`(chip17) · `_ali`(chip12) · `_nocal` 은 교정이 아니다
- **구성원**: 무리 안 칩 × 섹터 하나가 그 구간의 구성원이다. 구성원마다 평균 p50 · 표준편차 (p90 − p10) ÷ 2.5631 의 정규분포
- **폭의 바닥**: 표준편차는 p50 의 2% 아래로 두지 않는다
- **범위**: 곡선 지점은 교정이 있는 데까지 쓴다(chip01 은 300k). 답하는 x 는 1 - 100,000
- **v4 셀 분포**: 표에 `erase_us_q00 … q100`(5% 간격 분위수 21개, `wear_curves.py` 가 같이 쓴다)이 있어야 한다. 구성원은 이웃 분위수 사이
  조각마다 5% 의 균일 밀도(0.05 ÷ 조각 폭) — 모양을 가정하지 않아 계단 전환 셀의 빈 구간이 그대로 낮은 밀도가 된다. 조각 폭 하한 1µs(A 행 해상도),
  분위수 밖의 밀도 1/1,001 ÷ (q100 − q00)(1,001번째 표본의 몫). 둘 다 표본 수와 해상도에서 오는 값이라 고르지 않는다. 밴드 검사의 p10 · p90 은 q10 · q90
- **v4 정렬**: 무리 안 쌍마다 `pair_speed`(양방향 로그 평균)를 ŝ_a − ŝ_b = ln r_ab 로 두고 최소제곱으로 칩당 로그 속도 ŝ_j (무리 안 합 0).
  공통 시계 구간 B 마다 칩 j 의 (B 가운데) ÷ r̂_j 가 든 셀을 구성원으로 넣는다. 가장 가까운 셀을 그대로 쓰고 보간하지 않는다(계단 앞뒤를 섞으면
  한 번도 안 나온 중간값이 생긴다). 빠른 칩(r̂ > 1)의 100k 는 공통 시계 100k·r̂ 까지 늘어나고, 느린 칩(r̂ < 1)은 그 전에 끝난다

## 5. 계산 (공통)

1. **곡선 우도**: 곡선 지점(1k 구간) M 마다, 관측별 「구성원 밀도의 평균」 의 로그를 관측 수로 나눠 더한다(기하 평균).
   prep 을 여러 번 돌려도 관측 전부를 한 덩어리로 친다
2. **속도 배율 r**: 누적 x 인 칩은 곡선의 M = x · r 지점처럼 보인다고 두고, r 을 [1/R, R] 에서 로그 균등으로 적분한다.
   곡선에 없는 지점의 기여는 0 이다. R 이 1 이하면 r = 1 하나
   - v3.1 까지: r 을 로그 등간격 41점으로 찍어 평균한다
   - v3.2: 격자 없이 — x 구간 가운데 c 에 대해 곡선 범위 [c/R, c·R] 에 걸치는 1k 구간을 모두 더하고, 구간마다
     ln(걸친 끝 ÷ 걸친 시작)을 곱한다 (1k 구간은 [시작, 시작 + 1000))
3. **사전**: x 는 1 - 100,000 의 1k 구간에 균등
4. **사후**: 구간별 값을 합이 1 이 되게 정규화한다
5. **v4 증거량**: 1 의 기하 평균에 유효 관측 수 n_eff 를 곱한다 — k 섹터 × P prep 의 평균이 줄이는 분산의 역수. 관측 하나가 교정 곡선에서
   벗어나는 분산을 넷으로 나눈다: 칩 효과 ρ_chip(이 칩이 교정 혼합에서 7섹터 · 모든 prep 에 공통으로 벗어나는 몫 — 늘려도 안 준다) · 칩 안 몫
   1 − ρ_chip 안에서 ρ_s = 같은 prep 안 섹터 간, ρ_p = 같은 섹터 prep 간 상관
   `n_eff = 1 / (ρ_chip + (1 − ρ_chip)·(ρ_s/P + ρ_p/k + (1 − ρ_s − ρ_p)/(k·P)))`.
   ρ_chip 0 · ρ_s 1 · P 1 이면 v3 와 같고(1), 전부 0 이면 독립 곱(k·P), ρ_chip 이 c 면 1/c 를 못 넘는다. 값은 `--rho` 로 잰다: ρ_s · ρ_p 는 교정 A 행에서
   연속 사이클 P 개 × 7섹터 표(구간당 20개, 연속이라 추세는 무시할 만하다)의 이원 랜덤효과 적률 추정 — 행(prep) 효과의 몫이 ρ_s, 열(섹터) 효과의 몫이
   ρ_p. ρ_chip 은 칩 안 표로는 보이지 않으므로(칩 효과가 표 전체의 상수라 평균에 묻힌다) 교정 칩을 하나씩 빼고 그 칩의 A 행 한 줄(7섹터)을 나머지
   칩의 정렬된 혼합(공통 시계 b·r̂_j 의 구성원 p50 중앙값)과 비교한 로그 잔차 표의 일원 랜덤효과 — 표 간 분산의 몫. 블라인드 prep 로그(같은 표 꼴)로
   ρ_s · ρ_p 가 마모 루프의 값과 비슷한지 본다. 셋 다 **전체값 하나**를 등록한다(무리별로 두지 않는다 — 칩 3개짜리 무리의 값은 운일 수 있고 규칙이
   둘이 된다). 잰 값은 코드 `RHO` 에 출처와 함께 등록한다 — **등록 전에는 v4 가 돌지 않는다**(--rho-sector/--rho-prep/--rho-chip 은 시험용).
   2026-10-09 등록: ρ_s 0.00 · ρ_p 0.78 · ρ_chip 0.29 (빠른 0.33 · 느린 0.03 은 발견으로만)
6. **v4 R**: 정렬에 쓴 ŝ_j 의 표준편차 σ_r (무리마다 합 0 이라 Σŝ² ÷ (M − 1)) 에서 `R = exp(1.96 · σ_r · √(1 + 1/M))` — 새 칩 하나 대 교정 M개 평균의
   95% 범위. v1 · v2 규칙의 √2 가 √(1 + 1/M) 로 준 것이 이중 계산을 뺀 효과다. 무리에 칩이 하나면 두 무리를 합친 σ_r 을 쓴다(가정이라 기록에 적는다).
   `--rate-range` 를 주면 그 값이 이긴다. 2026-10-08 교정 8칩 미리보기: 빠른 σ_r 0.507 (M 5) → 2.97 · 느린 0.184 (M 3) → 1.52

## 6. 출력 (공통)

| 출력 | 정의 |
|---|---|
| MAP 구간 | 사후 확률이 가장 큰 1k 구간 |
| 사후 중앙값 구간 | 누적 사후 확률이 처음 절반에 닿는 1k 구간 (v3 부터 대표값) |
| HPD 68% · 95% | 확률이 큰 구간부터 모아 누적이 68% · 95% 에 닿을 때까지의 집합. 이어진 구간은 한 범위로 합쳐 적는다 |
| 밴드 밖 관측 수 | r 없이 곡선 우도가 가장 큰 지점에서, 구성원 p10 최소 - p90 최대 밖에 있는 관측의 수 |
| 등급 (화면, 2026-10-02 부터) | 사후 확률의 합이 가장 큰 등급 — 정격 100,000 대비 신품 1% 이하 · 저마모 20% 이하 · 중마모 60% 이하 · 고마모 100% 이하 |

- **보류**: 관측이 전부 밴드 밖이면 판정을 내지 않는다. 단 곡선 첫 구간보다 전부 아래면 신품 쪽으로 읽고 보류하지 않는다
- **기록** (`--out`): 입력 A 줄 · 입력 B 줄 · (v1 · v2 는 입력 C 줄) · 답 줄 · 주의 줄. 머리말에 모델 버전(v3.2 부터) · git 리비전 · 인자 · 입력 로그 sha256 · 교정 표 목록
- 100,000 너머는 답하지 않는다

## 7. 모의 블라인드 (LOCO)

- 교정 칩 하나를 빼고, 그 칩의 구간별 섹터 p50 7개를 관측으로 넣어 나머지 칩으로 추정한다. 신품값은 집계표 값. v4 의 등록 수치는 아래 rows 관측
- 정답 지점 12점: 1,000 · 3,000 · 10,000 - 100,000 (10,000 간격). 표에 구간이 없는 점은 뺀다(chip07 60k · 80k)
- 같은 무리에 남는 칩이 없으면 그 칩은 뺀다
- 지표: 정답 ∈ 68% · 정답 ∈ 95% · 68% 폭(HPD 조각 길이의 합)의 중앙값
- 명령: `uv run python host/analysis/wear_inverse.py --loco` (현행 버전) · `--rate-range R` (두 무리에 같은 R)
- **v4 관측**: 빠진 칩의 그 1k 구간 A 행에서 사이클 P 개를 뽑아 7섹터를 **그대로** 넣는다(`--loco-obs rows --prep-k P`, 7·P 개). 같은 사이클의
  7섹터를 함께 쓰므로 한 prep 안의 섹터 상관이 실전처럼 들어가고, 실전처럼 한 번 잰 값의 흔들림이 있다. 정렬 · σ_r · R 은 빠진 칩 없는 교정으로
  다시 낸다(누수 없음). seed · 반복 횟수를 적는다. A 행이 없는 칩은 이유와 함께 뺀다
- **v4 합격 띠 (돌리기 전에 정한다)**: 점 수 n 과 명목 q 에서 `n·q ± 1.96·√(n·q·(1−q))` (올림 · 내림). 띠 안이면 합격, 아래면 과신, 위면 과소신.
  58점이면 68% 는 33-46점 · 95% 는 52-58점. 점들이 칩 몇 개에서 나와 독립이 아니라 띠는 실제보다 좁다 — 띠 안은 「틀렸다는 증거 없음」이다.
  띠 밖일 때 의심 순서: 과신이면 ① 분위수 바닥 · 조각 폭 하한 ② 정렬 부족 ③ 구성원 수 M, 과소신이면 ① ρ 측정(연속 사이클 수 · 추세) ② R.
  결과를 본 뒤 순서를 바꾸지 않는다. 코드가 띠와 판정을 LOCO 출력 끝에 찍는다.
  2026-10-09 등록 때의 경위: ρ_chip 없는 식으로 95% 가 과신이었고, 위 순서의 ① - ③ 이 아니라 **ρ 의 정의**(칩 효과를 못 보는 표)가 원인이었다
  — 순서를 바꾼 것이 아니라 재는 양을 고친 것이다(로그 52 §9). 다음부터 과신의 ⓪ 은 「ρ 가 칩 효과를 재고 있나」

## 8. 블라인드 성공 기준

| # | 기준 |
|---|---|
| ① | 정답이 95% 구간 안 |
| ② | 68% 구간의 바깥 폭(가장 낮은 구간 - 가장 높은 구간) 60,000 사이클 이하 |
| ③ | 68% 바깥 폭 ÷ MAP 이 그 버전의 값(§2) 이하. MAP 이 10,000 미만이면 바깥 폭 10,000 이하로 대신한다. **v4.3 부터 MAP 대신 그 버전의 대표값(사후 평균)** |

- v3 · v3.1 의 ③ 값은 내지 않았다. 블라인드 절차(정답 봉인 · 개봉 prep 횟수 · 시한)는 `docs/spec/s1.wear_bench_spec.md` §15

## 9. v4 등록 절차 (원본 A 행이 있는 PC 에서 · 2026-10-08 초안 · 2026-10-09 실행)

한 번에 하나만 바꾼다 — 비교 사슬은 v3.2(8칩) → v4(8칩) → v4.1(8칩 + chip06). 각 단계의 LOCO 를 같은 점에서 나란히 둔다.
2026-10-09 에 1 - 7 을 돌렸다 — 수치는 전부 `docs/results/data/inverse_v4_eval_2026-10.md`(아래 각 단계 끝의 § 는 그 문서의 절).

1. **교정 표 재생성** — `docs/results/data/wear_curves/wear_curves_2026-09.md` 의 재현 명령 그대로(`wear_curves.py` · `pe_end.py`). 분위수 열 21개가
   붙는다. p10 · p50 · p90 열은 그대로라 v3.2 수치가 변하지 않는지 `--model v3.2 --loco` 로 확인한다 (68% 67/94 · 95% 93/94) — 됨 (§7)
2. **ρ 측정** — `--rho --prep-k 5` (교정 8칩 A 행) 와 `--rho data/session_chip06_*.log` (prep 5회). 칩별 중앙값이 비슷하면 전체 중앙값을 `RHO` 에
   등록하고 출처(이 명령 · 날짜)를 주석에 적는다. 마모 루프와 prep 의 값이 다르면 그 차이를 적고 prep 쪽을 쓴다(실전이 prep 이다) — ρ_s 0.00 · ρ_p 0.78,
   chip06 prep 0.00 · 0.72 로 같아 마모 루프 전체 중앙값을 등록. ρ_chip 0.29 는 같은 명령이 함께 찍는다 (§1)
3. **속도 · R 확인** — `--rate-rule` 의 v4 줄(칩 속도 r̂ · σ_r · R). 정렬 뒤 쌍 규칙이 다시 1 근처인지는 시험이 본다. A 행 없이 정렬 · R 유도만
   v3.2 위에 얹은 부분 탐색은 `docs/results/data/inverse_v4_probe_2026-10.md`(빠른 무리 2.97 이 68% 를 띠 위로 — 로그 52 §4) — 2.97 · 1.52 그대로
4. **합격 띠를 먼저 적는다** — LOCO 점 수(현재 94)에서 §7 의 식으로. 이 문서에 날짜와 함께 — 2026-10-08: 68% 56-72 · 95% 86-93 / 94
5. **LOCO** — `--loco --loco-obs rows --prep-k 5 --reps 20 --study` (v4 등록 방식) 와 `--loco` (p50, v3 와 같은 점) 둘 다. 띠 판정을 적는다
   — rows 79.1% **과소신** · 96.5% 합격 · 폭 33,000, p50 75 · 91 / 94 (§2). ρ_chip 없는 식은 74.2% · 90.2% 로 95% 과신이었다
6. **합성 복원** — `--synthetic 500` (v4 는 분위수 역변환 + ρ 코퓰러 · 정체 칩의 셀은 공통 시계 x·r 의 자기 시계 x·r/r̂_j 에서). 대각선 그림은 `--plot`
   — 정체 칩을 뺌 · prep 5회: 68% 73 · 95% 96 (§5)
7. **등록** — 이 문서 §2 의 v4 열을 「미등록」에서 날짜로, S-1 §15 추기, 로그에 결정 경위. 그 뒤 chip08 개봉 — 2026-10-09 등록 (로그 52 [D52-8])
8. **v4.1** — chip06 이 100k 에 닿으면(정답 12,000 부터) 표를 더해 같은 LOCO 를 한 번 더. chip14 는 2026-10-08 에 100k 까지 닳아 돌아왔다
   (로그 48 §53 [D48-108]) — 교정에 넣을지는 [U48-22] 의 답을 따른다
   > **2026-10-12 — 돌렸다.** chip06 이 10/12 100k 에 닿아 9칩 표로 1 - 6 을 다시 — 수치는 `docs/results/data/inverse_v4_1_eval_2026-10.md`,
   > §2 의 v4.1 열은 미등록 초안. 106점 띠 68% 63-81 · 95% 97-105 에 rows P5 80.4% · 94.9%(과소신 · 합격), R 빠른 2.97 → 2.72, chip04 가 95% 80 → 62%.
   > chip14 는 JV 로 교정 밖([D53-5]). 등록 여부는 로그 52 [U52-5]

9. **v4.3 — 고마모 과소추정 제거 (설계 2026-10-19, 로그 52 [D52-13])**. 답 범위 x ≤ 100k · 사전 · 대표값 · 구간 · 무리 경계 · LOCO 점(106, ≤100k)은 **전부 그대로**.
   바뀌는 것은 우도의 재료뿐이다 — 곡선 지점 M = x·r 이 100k 너머 곡선을 쓰는데(§5 — 교정 범위 밖은 0), 지금까지 그 구간은 chip01 하나라 큰 x 는 r 이 작은 쪽만
   기여해 사후가 아래로 눌렸다(v4.1 §4 · 로그 52 §11 의 「50k 이상 점 추정 55-63k」). 200k 까지 닳린 chip06 · 09(빠른) · chip03 · 15(느린)의 곡선이 그 자리를 채운다(이미
   승격돼 glob 에 든다 — 10/14-17). 할 일: ① `A_SESSIONS` 에 200k 세션(1791800419 · 1791904816 · 1791990254 · 1792080192) 등록 — 합성 복원과 ρ 가 100k 너머 행을 읽게
   ② 1 - 6 재실행(ρ · R · LOCO rows P5 ×20 · p50 · 합성) ③ **채점 기준(결과 전 고정)**: 106점 띠 68% 63-81 · 95% 97-105 그대로 통과 + 고마모 버킷 50-100k(약 45점)의
   추정/정답 중앙값이 v4.1 의 **0.84**(빠른 0.82 · 느린 0.89, `inverse_v4_1_eval` §3.1)에서 **0.90 이상**, 68% 포함이 v4.1 의 **74.2% 이상**, 느린 50-100k 의 95% 가 93.8% 아래로
   안 내려감. (설계 초안은 「0.6대 → 0.8」 로 적었는데 0.6대는 §11 의 chip06 held-out 점 추정이지 버킷 중앙값이 아니었다 — LOCO 를 돌리기 전인 2026-10-19 에 고쳐 적음.)
   안 오르면 과소추정의 원인이 곡선 결핍이 아니라는 답 ④ 5장 판(지금) → chip07 200k 뒤 6장 판 →
   chip02 200k 뒤 7장 판으로 같은 표를 쌓고 마지막 판으로 등록(`MODEL_VERSION` v4.3 · 이 표 §2 · S-1 §15). v4.1 등록 안건([U52-5])은 v4.3 이 대신한다.
   chip21(신품 느린 · 빠른 노화)은 넣지 않는다([D52-12]) — 느린 신품의 두 종류는 v4.4([U52-7]). 수치는 `docs/results/data/inverse_v4_3_eval_2026-10.md`
   > **2026-10-19 — 5장 판을 돌렸다.** 106점 띠 68% 82.6% 과소신 · 95% 94.7% 합격(v4.1 과 같은 판정). 고마모 50-100k: 정답∈68 74.2 → **79.1%**(① 충족) · 추정/정답 0.84 → **0.84**
   > (② 미충족). ρ_chip 0.29 → 0.20, R 그대로, 느린 세 칩 LOCO 전부 개선, 합성 71 → 66 · 96. 정답 x 별로 보면 50k +13% → 100k −29% 로 상한에 가까울수록 단조로 눌리고
   > 곡선이 있는 칩과 없는 칩의 차이가 없다 — **곡선 결핍이 아니라 답 범위 상한 100k 의 절단 효과**. 처리는 로그 52 [U52-8](영웅님 결정)
   > **2026-10-20 — 지지를 200k 로 넓히는 안(가)은 재 보고 기각.** 50-100k 추정/정답 0.84 → 1.24(과대) · 68% 폭 44k → 93k — 빠른 무리의 160k-200k 평탄 때문에 소거 시간이
   > 100k 너머를 식별하지 못한다. 답 범위 100k 절단은 그대로 두고, 상한 근처 중앙값 편향은 한계 · 표기 규칙으로(로그 52 [U52-8] 추기, `inverse_v4_3_eval` §3.3)
   > **2026-10-21 — 6장 판 · 후보 일곱 비교 (브랜치 `inverse-v4.3-ceiling`, 머지 대기).** 대표값을 사후 평균으로(로그 52 [D52-14]). 106점 82.5 · 94.7%, 50-100k 0.84 그대로 —
   > 상한은 정보 한계로 남는다. `docs/results/data/inverse_v4_3_ceiling_2026-10.md`
   > **2026-10-23 — 등록 뒤 chip02 200k 곡선이 들어와 교정 파일이 7장이 됐다(모델 식 · ρ · 대표값 그대로).** 7장 판 LOCO(rows P5 × 20): 68% 81.7% · 95% 94.5% · 폭 34,000 ·
   > 바깥 폭/대표값 90분위 1.33 · 추정/정답 1.02 — 등록 수치(81.6 · 94.1 · 34,000 · 1.33)와 같은 판정이고 ③ 값도 같다. **chip08 은 7장 판으로 개봉한다**(로그 52 §17)

v4 가 **안 고치는 것** (보고서의 한계로 남긴다): 무리 경계 40ms(틈 34-47ms 안의 칩은 미검증 — 블라인드는 우리가 고르지 않는다) ·
답 상한 100k 와 계단 이후의 「범위만 준다」(교정 칩을 더 닳게 해야 풀린다 — **v4.3 이 이것을 겨냥한다**, 9번) · 느린 신품의 chip12 · 21 형(v4.4, 로그 52 [U52-7])
