young-0320/flash-margin-bench/docs/concepts/15.lifetime_inverse_model.md

# 15. 수명 역산 모델 — 소거 시간으로 "몇 번 썼나" 를 거꾸로 맞히기

- 작성: 2026-09-30
- 관련 로그: [48](../log/young/48.pilot_wear_handler_and_plan_approval.md) (§15-§21 종단 3칩 판정)
- 관련 사양: S-1 §15 2026-09-30 추기 — `docs/spec/s1.wear_bench_spec.md` · 경위 [로그 48](../log/young/48.pilot_wear_handler_and_plan_approval.md) §22
- 관련 코드: `host/analysis/wear_curves.py` (교정 표) · `host/analysis/wear_inverse.py` (모델 · 모의 블라인드) ·
  `host/analysis/plot_wear_curves.py` (그림)
- 관련 결과: `docs/results/data/wear_curves/wear_curves_2026-09.md` · `docs/results/plots/wear/wear_curves_2026-09.png`
- 앞선 개념: [13 마모의 두 얼굴](13.wear_cell_death_and_margin_loss.md) · [14 NOR 의 프로그램과 소거
  ](14.nor_program_erase_and_wear.md)

> **2026-10-01 — v2 로 갱신했다 (§10).** 이 문서는 교정 4칩(v1) 때 썼다. 지금 판정용 모델(v2)은 chip09 를 더한 5칩 · R 2.0 이고,
> R 의 근거가 쌍 규칙에서 모의 블라인드 포함률로 바뀌었다. §4 (마) · §6 의 수치는 v1 이다.
>
> **2026-10-05 — v3 로 갱신했다 (§11).** 교정 7칩 · R 1.6 · 대표값은 사후 중앙값 · 입력 C 없음. §5 의 MAP 은 v2 까지의 대표값이다.
> 같은 날 v3.1 — R 을 무리별로(빠른 1.6 · 느린 1.3, §11 끝) · v3.2 — r 적분을 격자 없이. 버전별 사양만 건조하게 모은 표는 `docs/spec/s5.lifetime_inverse_model.md`.
>
> **2026-10-08 — v4 코드 (등록 전).** 고른 값을 잰 값으로: ① 셀을 정규분포 대신 분위수 21개로(§7 의 이봉이 그대로 들어간다) ② 섹터 7개를 「1개 분량」으로
> 치던 1/k 를 상관 ρ_s · ρ_p 로 잰 유효 관측 수로 ③ 교정 곡선을 칩 속도로 정렬해 r 이중 계산을 없앰 ④ R 을 정렬 뒤 속도 흩어짐 σ_r 에서 유도
> ⑤ LOCO 관측을 A 행 그대로 · 합격 띠를 먼저. 사양과 등록 절차는 S-5 §4 - §9. 원본 A 행으로 ρ 를 재고 표를 다시 만든 뒤 등록한다.
>
> **2026-10-09 — v4 등록 (현행).** 등록하며 ρ 에 세 번째 몫이 생겼다 — **ρ_chip**, 「이 칩 자체가 교정 칩들과 다른 몫」. 섹터 7개가 증거 7개가 아닌
> 이유를 칩 안의 흔들림(ρ_s · ρ_p)에서만 찾았는데 그것은 0 · 0.78 이었고, 본체는 칩 효과(0.29)였다. 체온계 7개로 한 사람을 재도 그 사람이 평균적인
> 사람이 되지는 않는다. 수치는 `docs/results/data/inverse_v4_eval_2026-10.md`, 경위는 로그 52 §9 - §10.

---

## 쉬운 버전

### 무엇을 하려는가

정체를 모르는 플래시 칩 하나를 받는다(**블라인드 칩** — 누가 몇 번 썼는지 추정하는 사람에게 숨긴 칩). 그 칩의 섹터를 몇 번 지워 보고 걸린 시간만 재서 **누적 P/E 횟수**(프로그램·소거를 한 쌍으로 센 마모 횟수, 기호 x — N 은 위상당 읽기 112 에만 쓴다)를 **구간으로** 맞힌다. "약 30,000 번" 이 아니라 "68% 확률로 25,001-37,000 번 사이" 처럼.

근거는 하나다 — **셀이 닳을수록 소거가 느려진다** (개념 14: 터널 산화막에 전자가 박혀 전계가 약해진다).
그래서 소거 시간은 칩의 나이테 같은 것이다.

### 재료 셋

1. **교정 곡선**(calibration curve — 답을 아는 표본으로 만든 "값 → 답" 대응표). 칩 4개(chip01·03·04·07)를 0 에서 100,000 번(chip01 은 300,000 번)까지 직접 닳게 하며 매번 소거 시간을 쟀다. 그걸 "1,000 번째마다 소거 시간이 대략 얼마였나"로 요약한 표가 `wear_curves_<chip>_2026-09.csv` 다. 성장표(나이별 키 분포)와 같은 역할이다.
2. **역산 모델**(inverse model — 결과에서 원인을 거꾸로 추정하는 계산 규칙). 블라인드 칩의 소거 시간을 교정 곡선에 대 보고 "어느 나이 구간이 이 값을 가장 잘 설명하나" 를 확률로 계산한다. 이 문서의 대부분이 이것이다.
3. **모의 블라인드 검증**(LOCO — 아래 §6). 실제 블라인드 전에 답을 아는 칩으로 모델의 오차를 미리 잰다.

### 왜 칩을 두 무리로 먼저 나누나

종단 실험(100,000 번까지 닳게 한 본 실험)에서 칩이 **신품 때 소거 속도**에 따라 두 부류로 갈렸다.

| 무리 | 칩 (신품 소거 시간) | 100k 까지 소거 시간 | 모양 |
| --- | --- | --- | --- |
| 빠른 무리 | chip01 (28.7ms) · chip04 (33.7ms) | 3.5-4배로 급하게 늘어남 | 중간에**계단현상**(약 85ms 에서 111ms 로 뛰어오름)존재. 프로그램 시간은 안 변함 |
| 느린 무리 | chip07 (47.0ms) · chip03 (51.1ms) | 1.6-1.7배로 완만 | 계단 현상 없음. 프로그램 시간이 일찍 오름 |

같은 "신품의 1.7배" 가 빠른 칩에서는 약 3,000 번, 느린 칩에서는 약 100,000 번이다. 무리를 모르고 대 보면 답이 30배 틀린다. 그래서 모델은 **먼저 무리를 고르고**, 그 무리의 곡선에만 대 본다. 경계는 신품 소거 시간 **40ms**(잠정 — 34ms 와 47ms 사이에 칩이 없어서 그 가운데).

블라인드 칩의 신품 소거 시간은 어떻게 아나? 칩 안의 **안 닳은 섹터**(섹터 32-127 — 마모시킨 섹터 0-6 에서 128KB 넘게 떨어져 있어 영향을 받지 않은 곳)를 같이 지워 보면 된다. 칩이 자기 신품값을 몸에 지니고 있는 셈이다.

"쓰던 칩에서 어떻게 신품값이 나오나" 하는 의문이 들 수 있다. 과거 기록을 꺼내는 것이 아니다. 마모는 칩 전체가 아니라 **지운 섹터에만**
쌓이므로(소거를 느리게 하는 갇힌 전하는 그 섹터 셀의 산화막에 있다), 지운 적 없는 섹터는 지금도 신품 상태다. 실측으로 확인했다 —
종단 3칩에서 섹터 0-6 을 10만 번 지운 뒤 섹터 32-127 의 소거 시간은 신품 대비 1.00 이었다(열흘과 재장착을 사이에 두고도). 현장 NOR 은
펌웨어 영역과 로그·카운터 핫스팟이 한 칩에 같이 있어 이 조건이 보통이고, 웨어 레벨링으로 전체가 고르게 닳은 칩은 적용 밖이다.

### 계산의 흐름 한 장

```
 블라인드 칩 prep 로그 (섹터 0-127 을 한 번씩 지우고 시간 기록)
        │
        ├─ 섹터 32-127 소거 시간 중앙값 = 신품값(A)  ──▶  40ms 미만? ─ 예 ─▶ 빠른 무리 곡선 (chip01·04)
        │                                                       └ 아니오 ▶ 느린 무리 곡선 (chip03·07)
        │
        └─ 섹터 0-6 소거 시간 7개 = 관측(B) ──(ratio 눈금이면 A 로 나눔)──┐
                                                                         ▼
          곡선의 1,000 번 지점 M 마다 "이 지점 칩이라면 이 7개 값이 나올 확률" 계산 (= 우도)
                                                                         ▼
          속도 배율 r 을 1/2 ~ 2 로 훑으며 x = M / r 로 옮겨 더함  (칩마다 늙는 속도가 다르다 — §4 (마))
                                                                         ▼
          합이 1 이 되게 나눔 (= 사후확률)  ──▶  제일 높은 구간 (MAP) · 68% 구간 · 95% 구간
```

---

## 엔지니어링 버전

### 1. 교정 표의 한 칸

한 행 = (1,000 번 구간 하나 × 섹터 하나). 예: chip04 · 26,001-27,000 번 · 섹터 3.

| 열 | 뜻 |
| --- | --- |
| `n` | 그 칸에 들어간 측정 수 (정상이면 1,000) |
| `erase_us_p10` · `p50` · `p90` | 그 1,000 번 소거 시간의**분위수**(작은 값부터 줄 세웠을 때 10% · 50% · 90% 지점). p50 은 중앙값 |

p10-p90 을 같이 두는 이유: 블라인드 칩은 섹터당 **한 번**(또는 몇 번)만 지워 본다. 그 한 번은 중앙값이 아니라 1,000 개 중
아무거나 하나다. p10-p90 폭이 "한 번 쟀을 때 얼마나 흔들릴 수 있나" 를 알려 준다.

### 2. 눈금 — ms 와 ratio

**눈금**(scale)은 마모 섹터 소거 시간을 교정 곡선과 **어떤 단위로 맞대느냐** 다.

- **ms 눈금** — 소거 시간 그대로(밀리초).
- **ratio 눈금** — 같은 칩 신품값(A)으로 나눈 배율. "신품의 몇 배로 느려졌나".

절댓값을 버리는 것이 아니다. **절댓값(A, ms)은 무리를 가르는 데 쓰고**, 무리 안에서 나이를 맞출 때만 배율로 맞댄다.
두 단계가 서로 다른 일을 한다.

| 단계 | 쓰는 값 | 이유 |
| --- | --- | --- |
| 무리 선택 | A (ms 절댓값) | 빠른/느린은 신품 소거 속도 자체의 차이다 |
| 나이 맞히기 | B/A (배율) — ratio 눈금일 때 | 같은 무리 안에서도 신품값이 다르다(chip01 28.7 · chip04 33.7ms). ms 로 대면 chip04 는 태생의 5ms 를 "더 닳았다" 로 읽는다 |

어느 눈금을 쓸지는 결과를 보기 전에 규칙으로 정해 뒀다(S-1 §15 추기): **모의 블라인드에서 정답이 95% 구간 안에 드는
비율이 높은 쪽**. 2026-09-30 결과는 ratio 36/46 · ms 20/46 → ratio.

주의 — 교정 칩의 배율 분모는 신품 집계표(`newchip_survey_2026-09.csv`, 마모 전 전 섹터 소거 중앙값)이고, 블라인드 칩의 분모는
개봉 prep 의 섹터 32-127 중앙값이다. 둘이 같다는 근거는 종단 3칩의 100k 뒤 newchip 에서 섹터 32-127 이 신품 대비 1.00 이었던
것이다.

### 3. 확률 모델 — 우도 · 사전확률 · 사후확률 (베이즈 정리)

> 수식은 GitHub 에서 렌더링된다. 같은 내용을 그림·마우스 값과 함께 본 페이지: [수명 역산 확률 모델](https://claude.ai/artifact/PRCK4oceuPdUxz9AHs6gvs) (비공개 — 공유해야 열린다)

**기호.**

| 기호 | 뜻 | 이 모델에서 |
| --- | --- | --- |
| $x$, $b$ | 누적 P/E 사이클과 그 후보 구간 | 1-1,000 · 1,001-2,000 · … · 99,001-100,000 번. 100개 |
| $e_i$ | $i$ 번째 관측값 | 섹터 $i$ 의 소거 시간 ÷ 신품값 (ratio 눈금) |
| $k$ | 관측 수 | prep 1회면 7, 3회면 21 |
| $j$, $M$ | 구성원과 그 수 | 같은 무리 교정 칩 × 섹터 곡선 하나가 구성원 하나. 칩 2개면 $M = 14$ |
| $\mu_j(b)$, $\sigma_j(b)$ | 구성원 $j$ 의 구간 $b$ 중심과 폭 | 교정 표의 p50 과 p10-p90 에서 계산 (§4) |
| $P(b \mid e)$ | 사후확률 | 관측 $e$ 를 본 뒤 "정답이 구간 $b$" 일 확률 |

이론 배경은 **베이즈 정리**(Bayes' theorem)다. 원인 후보가 여럿이고 결과 하나를 봤을 때 각 원인의 확률을 고치는 규칙이다.
여기서 원인 = "누적 P/E $x$ 가 구간 $b$", 결과 = 관측 $e = (e_1, \dots, e_k)$.

```math
\underbrace{P(b \mid e)}_{\text{사후확률}} \;=\; \frac{\overbrace{P(e \mid b)}^{\text{우도}} \cdot \overbrace{P(b)}^{\text{사전확률}}}{\underbrace{\sum_{b'} P(e \mid b')\,P(b')}_{\text{정규화 상수}}}
```

분모는 모든 구간에 대한 분자의 합이다. 사후확률의 합을 1 로 맞추는 역할만 한다.

- **사전확률** $P(b)$ (prior — 측정 전의 믿음). 블라인드 담당자가 1,000-80,000 번 사이에서 아무 값이나 고르므로 치우칠 근거가
  없다. 그래서 모든 구간에 같은 값 $P(b) = 1/100$ 을 준다 — **평평한 사전**(flat prior). 100 은 후보 구간 수(0-100,000 번을
  1,000 번씩 자른 수)다. 구간을 100 번씩 잘랐다면 1/1,000 이 된다. 어느 쪽이든 모든 구간에 같은 상수라 분자·분모에서
  약분되므로 사후확률은 그 값과 무관하다.
- **우도** $P(e \mid b)$ (likelihood — "정답이 $b$ 라고 가정하면 이 관측이 나올 법한 정도"). 관측은 고정해 두고 **가정을 바꿔 가며**
  매기는 점수다. 구간에 대해 합이 1 일 필요가 없다.
- **사후확률** $P(b \mid e)$ (posterior — 측정 뒤의 믿음). 이것이 답이다.

사전이 평평하면 $P(b)$ 가 분자·분모에서 약분되어 이렇게 줄어든다. 남은 일은 구간마다 우도 $L(b)$ 를 계산하는 것뿐이다(§4).

```math
P(b \mid e) \;=\; \frac{L(b)}{\sum_{b'} L(b')}, \qquad L(b) \equiv P(e \mid b)
```

**작은 예** (숫자는 설명용). ratio 관측 하나가 2.0 이고 후보 구간이 셋이라 하자.

| 구간 | 곡선 중심 μ | 폭 σ | 우도 = 정규분포 밀도 N(2.0; μ, σ) | 사후확률 |
| ---- | --- | ---- | --- | --- |
| 10k  | 1.6 | 0.10 | 0.0013 (4σ 밖) | 0.0004 |
| 30k  | 2.0 | 0.15 | 2.66 (한가운데) | **0.80** |
| 50k  | 2.3 | 0.20 | 0.65 (1.5σ 밖) | 0.20 |

합 3.31 로 나누면 사후확률이다. "30k 구간일 확률 80%" 가 답이다.

### 4. 우도를 실제로 어떻게 계산하나

**(가) 관측 하나 · 곡선 하나 — 정규분포 밀도.** 교정 표의 한 칸(칩 하나 · 섹터 하나 · 구간 하나)을 **정규분포**(가우스 분포 —
평균 주변에 모이는 종 모양)로 본다. 관측 $e$ 가 이 종의 어디쯤 떨어지는지가 점수다.

```math
\mathcal{N}(e;\,\mu,\sigma) \;=\; \frac{1}{\sigma\sqrt{2\pi}}\,\exp\!\left[-\frac{1}{2}\left(\frac{e-\mu}{\sigma}\right)^{2}\right]
```

$e = \mu$ 일 때 가장 크고, $\sigma$ 한 칸 멀어질 때마다 급하게 작아진다(1σ 에서 0.61배, 2σ 에서 0.14배, 4σ 에서 0.0003배).
$\mu$ 와 $\sigma$ 는 교정 표에서 온다. $\mu$ 는 p50(중앙값)이다. 정규분포에서 p10 과 p90 은 중심에서 각각 $1.2816\sigma$ 떨어져 있으므로

```math
p_{90} - p_{10} = 2 \times 1.2816\,\sigma \;\;\Rightarrow\;\; \sigma = \frac{p_{90} - p_{10}}{2.5631}, \qquad \sigma \ge 0.02\,\mu
```

오른쪽 하한(`SIGMA_FLOOR`)은 구간 안 값이 거의 일정해 폭이 0 에 가까울 때를 막는다. 폭이 0 이면 조금만 어긋나도 우도가 0 이 된다.

> **밀도는 1 을 넘을 수 있다.** $\sigma = 0.15$, $e = \mu$ 이면 밀도는 $1/(0.15\sqrt{2\pi}) = 2.66$ 이다. 밀도는 "그 근처에 몰려 있는
> 정도" 라서 확률과 단위가 다르다. 우도가 합이 1 이 아니어도 되는 이유이고, 마지막에 정규화하는 이유다.

**(나) 관측 하나 · 곡선 여럿 — 혼합 분포.** 블라인드 칩의 섹터 3 이 교정 칩의 어느 섹터를 닮았는지 모른다. 그래서 구간 $b$ 의
구성원 $M$ 개 곡선을 같은 무게로 섞는다 — **혼합 분포**(mixture distribution — 여러 분포의 가중 평균).

```math
\ell_i(b) \;=\; \log\!\left[\frac{1}{M}\sum_{j=1}^{M} \mathcal{N}\big(e_i;\;\mu_j(b),\,\sigma_j(b)\big)\right]
```

$\ell_i(b)$ 는 관측 $e_i$ 하나가 구간 $b$ 에서 받는 로그 점수다. 구성원 중 하나에만 가까워도 점수가 산다. 섹터마다 계단을 타는
시점이 다른 것(chip04 는 25-47k)이 이 혼합에 자연히 들어간다. 로그를 쓰는 이유는 계산상의 것이다 — 밀도는 $10^{-300}$ 처럼
작아질 수 있어 곱하면 컴퓨터에서 0 이 된다. 로그로 바꾸면 곱이 합이 된다. 코드의 `_logmeanexp` 가 괄호 안을 넘침 없이 계산한다.

**(다) 관측 여럿 — 곱하지 않고 기하 평균.** 관측이 서로 **독립**(한 값이 다른 값에 대해 아무것도 알려 주지 않음)이면 교과서대로
우도를 곱한다(로그로는 더한다). 이 모델은 더한 뒤 $k$ 로 나눈다.

```math
\text{독립일 때:}\;\; \log L(b) = \sum_{i=1}^{k} \ell_i(b) \qquad\quad \text{이 모델:}\;\; \log L(b) = \frac{1}{k}\sum_{i=1}^{k} \ell_i(b)
```

오른쪽은 $L(b) = \big(\prod_i e^{\ell_i(b)}\big)^{1/k}$, 즉 관측별 우도의 **기하 평균**이다. 섹터 0-6 은 같은 칩에서, 같은 prep
한 번에, 같은 온도·전원·장착으로 잰 값이다. 한 섹터가 느리면 옆 섹터도 느릴 가능성이 크다. 이런 관측 7개를 독립처럼 곱하면
모델은 증거가 7배라고 착각하고 구간을 지나치게 좁힌다. 기하 평균은 반대 끝 — 관측 7개를 **한 개 분량의 증거**로 친다.

> **둘은 한 식의 양 끝이다.** 일반형은 $\log L(b) = w \sum_i \ell_i(b)$ 이고 $w = 1$ 이면 독립, $w = 1/k$ 이면 기하 평균이다.
> $1/w$ 를 **유효 관측 수**(서로 닮은 관측을 독립 관측 몇 개로 칠 수 있나)라 볼 수 있다. 지금 코드는 가장 보수적인 $w = 1/k$ 를
> 잠정으로 쓰고, 모의 블라인드(§6)의 포함률로 검증한다.

코드 한 줄(`posterior()`)로 합치면:

```math
\log L(b) = \frac{1}{k}\sum_{i=1}^{k} \log\!\left[\frac{1}{M}\sum_{j=1}^{M} \mathcal{N}\big(e_i;\,\mu_j(b),\sigma_j(b)\big)\right], \qquad P(b \mid e) = \frac{L(b)}{\sum_{b'} L(b')}
```

**(라) 답은 100k 까지** — 교정 4칩이 모두 닿는 곳이 100,000 번이라 **답(x)의 후보 구간은 1-100,000 번**이고 그 너머는 답하지
않는다(`MAX_CYCLE`). 다만 곡선 지점 M 으로는 chip01 의 100k 너머(300k 까지)도 쓴다 — 아래 (마)의 r 이 1 보다 크면 x ≤ 100k 인
칩도 곡선의 100k 너머 지점처럼 보이기 때문이다. (2026-09-30 저녁에 바뀐 점 — 그 전에는 100k 너머 구성원을 뺐다.)

**(마) 속도 배율 r — 같은 무리 안에서도 늙는 속도가 다르다.** 모의 블라인드(§6)에서 chip04 는 chip01 보다 약 1.4배, chip03 은
chip07 보다 약 1.25배 **적은** 사이클에 같은 소거 시간에 닿았다. 곡선 모양은 같고 가로축만 늘어난 것이다. 그래서 "진짜 사이클
x 인 칩은 교정 곡선의 M = x·r 지점처럼 보인다" 고 두고, 모르는 r 을 범위 안에서 전부 더한다.

```math
P(x \mid e) \;\propto\; \sum_{r \in \mathcal{R}} L\big(b(x \cdot r)\big), \qquad \mathcal{R} = \{\,r : \tfrac{1}{R} \le r \le R\,\},\; \log r \text{ 균등 41점}, \quad R = 2.0
```

$b(\cdot)$ 은 그 사이클이 든 1,000 번 구간이다. r 의 범위 R 은 결과에 맞춰 고른 값이 아니라 규칙으로 냈다 — 두 쌍의 로그 차이
(0.34 · 0.22)의 평균을 1.13(두 표본 차이의 기댓값 계수)으로 나누면 개체 표준편차 약 0.25, 새 칩 하나가 교정 칩 하나와 다를 95%
범위는 $\sqrt{2} \times 1.96 \times 0.25 = \log 2.0$. n=2 쌍에서 낸 값이라 가정이 약하며, 교정 칩이 늘면 같은 규칙으로 다시 계산한다.
r 을 넣으면 구간이 넓어진다(x 에 비례, ±50% 꼴). 그것이 칩 4개가 정직하게 뒷받침하는 정밀도다 — 좁히려면 모수가 아니라 교정 칩을
더 닳게 해야 한다.

> **2026-10-01 — v2 에서 R 의 근거가 바뀌었다 (§10).** 빠른 무리 교정이 셋이 되자 같은 쌍 규칙이 3.84 를 냈다. 그런데 칩 사이 속도
> 차는 이미 곡선 혼합((나))에 들어 있어 r 로 한 번 더 세는 셈이라 버렸다. R 은 2.0 그대로이고, 근거는 5칩 모의 블라인드에서 68% · 95%
> 구간 포함률이 약속한 값에 가장 가까운 것이다.

### 5. 답의 모양 — MAP · 최고밀도 구간

```math
\hat b_{\text{MAP}} = \arg\max_b\; P(b \mid e), \qquad H_{68} = \text{확률 큰 구간부터 담아}\ \sum_{b \in H} P(b \mid e) \ge 0.68\ \text{이 되는 첫 집합}
```

- **MAP**(maximum a posteriori — 사후확률이 가장 큰 구간). "가장 그럴듯한 1,000 번 구간 하나". 점 추정.
- **68% · 95% 최고밀도 구간**(HPD, highest posterior density set — 확률 높은 구간부터 주워 담아 누적 68% · 95% 에 닿을 때까지 모은 집합). 가장 좁게 그 확률을 채우는 범위다. 봉우리가 둘이면 떨어진 두 범위로 나온다(출력에 "·" 로 이어진 여러 범위).
- **교정 범위 밖 경고** — 관측이 MAP 구간의 밴드(구성원 p10 최소-p90 최대) 밖에 전부 있으면, 어느 곡선과도 안 맞는다는 뜻이다 (무리 선택이 틀렸거나 100k 너머).
- **입력 C 교차 확인** — 마모 섹터 프로그램 시간. 빠른 무리는 7.0ms 그대로, 느린 무리는 오른다. 답에는 안 넣고 "무리 선택이 맞아 보이나" 만 알려 준다.
  (v3 에서 뺐다 — §11)

**실제 한 사례 — chip03 · 정답 30,000 번** (LOCO, ratio 눈금). chip03 을 교정 표에서 빼면 느린 무리에 남은 교정 칩은 chip07
하나라 $M = 7$ 이다. chip03 의 29,001-30,000 구간 섹터별 p50 을 관측으로 넣었다(신품값 51.1ms).

| 섹터 | 0 | 1 | 2 | 3 | 4 | 5 | 6 |
| --- | --- | --- | --- | --- | --- | --- | --- |
| 소거 (ms) | 67.4 | 68.2 | 69.8 | 66.4 | 66.3 | 68.2 | 70.1 |
| ÷ 신품값 = $e_i$ | 1.319 | 1.334 | 1.365 | 1.299 | 1.296 | 1.333 | 1.370 |

세 후보 구간의 관측별 로그 점수 $\ell_i(b)$ 와 그 평균($= \log L(b)$). 정답 구간은 일곱 섹터 모두에서 고르게 높고, 10k·50k 는
섹터에 따라 크게 오르내린다.

| 구간 $b$ | $\ell_0$ | $\ell_1$ | $\ell_2$ | $\ell_3$ | $\ell_4$ | $\ell_5$ | $\ell_6$ | 평균 |
| --- | --- | --- | --- | --- | --- | --- | --- | --- |
| 9,001-10,000 | 0.78 | 0.37 | −1.05 | 1.08 | 1.09 | 0.39 | −1.35 | 0.19 |
| **29,001-30,000 (정답)** | 2.09 | 1.99 | 1.67 | 2.07 | 2.05 | 2.00 | 1.60 | **1.93** |
| 49,001-50,000 | −0.23 | 0.62 | 1.88 | −1.60 | −1.82 | 0.59 | 2.00 | 0.21 |

100개 구간을 정규화한 결과, 그리고 같은 관측을 독립으로 곱했을 때($w = 1$)와의 비교:

| 우도 결합 | MAP | 68% 구간 | 68% 폭 | 95% 구간 |
| --- | --- | --- | --- | --- |
| 기하 평균 (현재) | 34,001-35,000 | 21,001-22,000 · 23,001-25,000 · 26,001-38,000 · 40,001-44,000 | 19,000 | 8,001-10,000 · 11,001-13,000 · 14,001-20,000 · 21,001-48,000 · 49,001-50,000 |
| 독립 곱 | 34,001-35,000 | 29,001-31,000 · 32,001-35,000 | 5,000 | 28,001-38,000 · 41,001-42,000 |

이 사례에서는 곱한 쪽도 정답을 품고 68% 폭이 약 4분의 1 이다. 그러나 교정 칩이 하나뿐이라 칩 사이 개체차가 곡선에 없는
상태에서 이렇게 좁히면 다른 사례에서 정답을 놓칠 위험이 커진다. 어느 $w$ 가 맞는지는 46개 사례 전체의 포함률로 정한다
(현재 기하 평균으로도 95% 포함률 78% — 과신 쪽).

### 6. 모의 블라인드 (LOCO) 와 구간의 정직성

**LOCO**(leave-one-chip-out, 하나 빼고 교차 검증 — 기계학습의 leave-one-out cross-validation 을 칩 단위로 한 것).
교정 칩 하나를 표에서 빼고, 그 칩의 1k·3k·10k-100k 12개 시점 값을 블라인드 관측처럼 넣어 나머지 칩으로 맞힌다. 네 칩을 돌아가며.

채점은 **포함률**(coverage — 정답이 구간 안에 든 비율)이다. 68% 구간은 정의상 **10번 중 3번은 빗나가야** 한다. 그래서:

| 포함률 | 뜻 |
| --- | --- |
| 약속한 값(68% · 95%) 근처 | **보정이 잘 됨**(calibrated — 모델이 말한 확신이 실제와 맞음) |
| 훨씬 낮음 | **과신**(overconfident — 구간을 너무 좁게 말함) |
| 훨씬 높음 | **과소신**(구간을 쓸데없이 넓게 말함. "0-100k" 는 늘 맞지만 정보가 없다) |

2026-09-30 결과 (4칩 46점):

| 눈금 · R | 68% 포함률 | 95% 포함률 | 68% 구간 폭 중앙값 |
| --- | --- | --- | --- |
| ms · r 없음 | 3/46 (7%) | 19/46 (41%) | 14,500 번 |
| ratio · r 없음 | 26/46 (57%) | 36/46 (78%) | 15,000 번 |
| ratio · R 1.4 | 35/46 (76%) | 45/46 (98%) | 28,000 번 |
| **ratio · R 2.0 (채택)** | **42/46 (91%)** | **46/46 (100%)** | **39,500 번** |
| ratio · R 3.0 | 39/46 (85%) | 46/46 (100%) | 48,500 번 |

r 없이는 ratio 도 95% 에서 78% 라 **과신 쪽**이었다. R = 2.0 에서는 68% 가 91% 를 품어 명목보다 넓다(과소신 쪽). R 을 1.4 로 내리면
명목에 가깝지만 그것은 이 4칩에 맞추는 것이라 하지 않는다 — 규칙으로 낸 2.0 을 쓰고 이 표를 민감도로 보고한다. 남은 빗나감은
전부 계단 뒤 자리다(§7).

**LOCO 가 실전과 다른 두 방향.**

- **실전보다 어렵다** — 한 칩을 빼면 무리마다 교정 칩이 **하나만** 남는다. "표본 한 명짜리 성장표로 다른 아이 맞히기" 다.
  칩 사이 개체차가 곡선 폭에 안 들어가 과신이 생긴다. 실전 블라인드는 두 칩을 다 쓴다.
- **실전보다 쉽다** — LOCO 관측은 빠진 칩의 구간 **p50**(1,000 번의 중앙값)이다. 흔들림이 거의 없는 이상적인 값이다.
  실전은 섹터당 소거 **한 번**(prep 3회면 세 번)이라 p10-p90 만큼 흔들린다. 고치려면 LOCO 관측을 원본 A 행(마모 루프가
  매 사이클 남긴 측정 행, `data/wear/<세션>/A.txt`)의 **한 사이클 값**으로 뽑아 넣으면 실전과 같은 조건이 된다(미구현).

### 7. 알려진 약점 — 계단 전환 구간의 봉우리 둘

빠른 무리 섹터는 계단을 올라타는 몇 천 번 동안 **아래 값(약 80-95ms)과 위 값(약 111ms) 사이를 오간다**. 그 구간의 소거
시간은 봉우리가 둘인 **이봉 분포**(bimodal distribution)다. 예: chip04 섹터 3 · 26,001-27,000 번 — 75-95ms 593회 ·
**95-110ms 0회** · 110ms 대 407회. 교정 그림의 넓은 옅은 띠(p10-p90)가 이것이다.

모델은 칸마다 종 모양 **하나**를 놓으므로, 한 번도 안 나온 95-110ms 에 가장 큰 밀도를 준다. 전환 중인 칩을 잘못 짚을 수 있다.
대안은 전환 칸을 "두 값의 섞임(위 값 비율 p)" 으로 두는 것이다. prep 을 3회 이상 돌리면 섹터마다 위·아래를 몇 번 오갔는지가
보여 이 비율이 정보가 된다(S-1 §15 에 적어 둔 "오가는 비율"). 모델 형식 변경이라 S-1 추기 승인 전에 정할 안건이다.

### 8. 2차 참조 모델 — 신품값을 "밖에서" 알 때

지금까지가 **1차(현장) 모델**이다. 현장에서 받은 칩에는 신품 때 기록이 없으므로 칩 안의 안 닳은 섹터에서 신품값을 얻는다.

**2차(참조) 모델**은 같은 칩의 **신품 집계표 값**(출고 직후 우리가 잰 소거 시간)을 안다고 치고 같은 x 를 다시 추정한다. 필요한 이유는 **비교의 기준**이다 — 두 답의 오차 차이가 "신품 기록이 있으면 얼마나 더 잘 맞히나"(신품 참조의 값어치)이고,
보고서에 "현장 ±X · 참조 있음 ±Y" 로 나란히 적는다. 1차가 칩 안의 기준 섹터로 충분히 버틴다면 X 와 Y 가 가깝다. 멀면 현장 역산의 약점이 기준 섹터에 있다는 뜻이다. 미구현.

### 9. 남은 결정 (2026-09-30)

- 정해진 것 (S-1 §15 2026-09-30 추기 · 로그 48 §22): X = 68% 바깥 폭 60,000 (LOCO 를 본 뒤 적은 값) · Y = 마모 종료 후 24시간 ·
  추가 구매 칩에서 교정 2(빠른·느린 하나씩, 100k) + 블라인드 2(빠른 하나 + chip08) · 개봉 prep 3회 이상 · 장부 표기 `(MASK)`
- 남은 것: `run_wear.py --blind` · 정답 봉인 담당 · 교정 칩 둘이 들어오면 R 재계산(규칙 그대로)
- 미구현: LOCO 관측을 한 사이클 값으로 · 전환 구간 이봉 처리 · 2차 모델 · 두 번째 dose(Δx, 로그 51 §6 — 2026-10-05 교정 7칩 시험 뒤 뺐다, 로그 48 [D48-93])

### 10. v2 (2026-10-01) — 교정 5칩, R 은 2.0 그대로

**무엇이 바뀌었나.** 빠른 무리 교정에 chip09(신품 26.0ms)를 더해 빠른 셋(01 · 04 · 09) · 느린 둘(03 · 07)이 됐다. chip09 는 빠른 무리
안에서 가장 느리게 늙어(같은 배율에 chip04 의 약 2.9배 사이클), 무리 안 속도 차를 곡선 묶음이 직접 품게 됐다.

**R.** 쌍 규칙(§4 (마))을 다시 돌리면 3.84 가 나오지만, 칩 사이 속도 차가 곡선 혼합과 r 에 두 번 들어가므로 버렸다. R 을 바꿔 가며 5칩
모의 블라인드(58점)의 68% · 95% 포함률을 보면 R 1.0 47/69% · 1.4 55/81% · **2.0 72/98%** · 2.8 83/100% · 3.8 81/98% 로, 약속한 값(68 ·
95%)에 가장 가까운 것이 2.0 이다. §6 에 적은 「LOCO 에 맞춰 R 을 고르지 않는다」 와 부딪히는데, 버린 이유(이중 계산)가 구조 결함이
먼저이고 LOCO 는 남은 값을 고른 것이다(로그 48 [D48-60]). 68% 폭 중앙값은 44,000 번이다.

**블라인드 chip06 (정답 12,000).** v2 는 MAP 7,001-8,000 · 68% 3,001-19,000 · 95% 1,001-34,000 으로 정답을 68% 구간 안(사후분포 49번째
백분위)에 품었다. 같은 입력을 교정 4칩(v1)으로 보면 68% 2,001-11,000 이라 정답이 밖(79번째)이다 — 칩이 하나 늘어 구간이 넓어진 쪽이
정직했다(`docs/results/blind_chip06.md`).

**다음 (v3).** 새 배치 디바이스마트 칩 chip16 · 18 을 상온 0 → 100k 로 닳게 해 곡선이 어떻게 나오든 빠른 무리 교정에 넣는다(결과 전
결정, 로그 48 [D48-75]) — 빠른 다섯 · 느린 둘. 알리익스프레스에서 산 chip12 는 같은 칩으로 보지 않아 넣지 않는다([D48-77]). v3 의 R 과
성공 기준 ③ 은 쌍 규칙을 버렸으므로 방법부터 다시 정한다.

### 11. v3 (2026-10-05) — 교정 7칩, R 1.6, 대표값은 사후 중앙값

**무엇이 바뀌었나.** 교정이 빠른 넷(01 · 04 · 09 · 18) · 느린 셋(03 · 07 · 15)이 됐다(chip16 은 아직). 설정은 세 가지가 바뀌었다(로그 48 [D48-94]).

- **R 2.0 → 1.6.** v2 와 같은 규칙(모의 블라인드 68% 포함이 약속한 68% 에 가장 가까운 값)을 7칩 82점에 다시 적용한 결과다. R 2.0 은 68% 구간이
  88% 를 품어, 약속보다 넓은 구간을 내고 있었다. 대가로 가장 빨리 늙는 chip04 는 12점 중 4점만 품는다
- **대표값 MAP → 사후 중앙값.** 사후분포가 오른쪽으로 길게 늘어진 모양이면, 가장 높은 봉우리(MAP)는 늘 왼쪽에 선다. 산 모양의 지도에서
  「정상 위치」 를 대표로 고르면, 긴 능선이 오른쪽으로 뻗은 산은 늘 왼쪽 끝을 가리키는 것과 같다. 중앙값은 「이보다 적게 썼을 확률이
  절반」 인 자리라 꼬리 길이를 반영한다. 7칩 모의 블라인드에서 추정 ÷ 정답 중앙값이 0.72(MAP) → 0.95(중앙값)로 바뀌었다
- **입력 C 를 뺐다.** prep 프로그램 시간은 다 쓴 느린 칩에서도 거의 오르지 않아(chip15 100k 에 6.88ms), 정상 칩에 「무리 선택과 어긋난다」 를
  띄웠다. 무리는 신품 소거로만 정한다. 프로그램 시간은 눈금(PRBS)이 맞는 데이터가 쌓인 뒤 축으로 다시 다룬다(v4)

**구간은 그대로 최고밀도(HPD).** 한 덩어리 구간(양쪽 꼬리를 16% · 2.5% 씩 자름)도 봤지만 95% 포함이 75/82 로 약속 아래라 버렸다.

**두 번째 dose(Δx)는 뺐다.** 칩을 조금 더 닳게 해 기울기로 속도 r 을 재는 방법은, 초반(20k 이하)에는 좋았지만 빠른 무리의 계단과 느린 무리
후반의 잡음 때문에 기울기가 칩의 평생 속도를 대표하지 못해 틀린 쪽으로 구간을 좁혔다(로그 48 [D48-93]).

**교정 칩을 늘려도 구간이 계속 좁아지지는 않는다.** 구간 폭의 바닥은 칩마다 늙는 속도의 산포다. 사람을 아무리 많이 조사해도 흰머리만으로
한 사람의 나이를 맞히는 정확도에는 한계가 있는 것과 같다 — 칩을 늘리면 그 산포를 정확히 알게 될 뿐이다. 더 좁히려면 칩 하나에서 다른
정보(프로그램 시간 같은 두 번째 축)를 더 뽑아야 한다.

v1 · v2 · v3 의 성능 비교는 로그 48 §42, 수치는 `docs/results/data/inverse_v3_probe_2026-10.md` §4.

**v3.1 (같은 날) — R 을 무리별로.** v3 의 68% 포함 72% 는 빠른 무리 60% 와 느린 무리 88% 의 평균이었다. 느린 무리는 세 칩의 배율 곡선이
거의 겹쳐 속도 여유가 크게 필요 없다 — 한 반 학생들의 키가 비슷하면 「처음 보는 학생」 의 키 범위도 좁게 잡아도 되는 것과 같다. 그래서
느린 무리만 R 1.3 으로 줄였다(68% 폭 36,000 → 31,500, 포함은 그대로). 빠른 무리는 칩 사이 차이가 커 1.6 을 둔다. R 을 얼마로 잡든
68% 포함은 거의 안 변하고, 바뀌는 것은 구간의 폭과 95% 포함이다(로그 48 §43 [D48-95]).

**v3.2 (같은 날) — r 을 띄엄띄엄 찍지 않고 전부 더한다.** 지금까지는 r 을 41개만 골라 그 자리의 곡선만 봤다. 적게 쓴 칩에서는 41개로도
곡선의 모든 칸을 여러 번 보지만, 9만 번쯤 쓴 칩에서는 한 걸음이 2천 번이라 1천 번짜리 칸을 하나 걸러 하나씩 건너뛴다. 줄자의 눈금을
2cm 마다만 읽으면 1cm 짜리 물건은 재는 자리에 따라 있다가 없다가 하는 것과 같다 — 그래서 68% 구간이 빗살처럼 쪼개졌다. v3.2 는
범위 [x ÷ R, x × R] 에 걸치는 칸을 하나도 빼지 않고 더한다. 답은 거의 그대로이고(중앙값 차이 최대 1천 번) 구간이 한 덩어리가 된다
(로그 48 §45 [D48-98]).

---

## 용어표

| 리포 용어 | 일반 용어 · 뜻 |
| --- | --- |
| x · 사이클 · P/E | 누적 프로그램/소거 횟수 (마모량). N 은 위상당 읽기 112 (로그 51 [D51-1]) |
| 블라인드 칩 | 추정자에게 x 를 숨긴 시험 칩 |
| prep ·`--mode newchip` | 섹터 0-127 을 한 번씩 지우고 쓰며 시간을 기록하는 측정. 블라인드 개봉 때의 입력 |
| A 행 | 마모 루프가 매 사이클·섹터마다 남긴 소거·프로그램 시간 기록 (`A.txt`) |
| 교정 곡선 · 교정 표 | 답(x)을 아는 칩으로 만든 "x → 소거 시간 분포" 대응표 |
| 구간 · bin | 1,000 번 단위 묶음 (1-1,000 · 1,001-2,000 …) |
| p10 · p50 · p90 | 10% · 50%(중앙값) · 90% 분위수 |
| 빠른 무리 · 느린 무리 | 신품 소거 시간 40ms 미만 · 이상인 칩 부류 |
| 신품값 · 입력 A | 안 닳은 섹터 32-127 의 소거 시간 중앙값 |
| 관측 · 입력 B · $e$ | 마모 섹터 0-6 의 소거 시간 |
| 입력 C | 마모 섹터 0-6 의 프로그램 시간 (무리 확인용) |
| ms 눈금 · ratio 눈금 | 소거 시간 절댓값으로 맞대기 · 신품값 대비 배율로 맞대기 |
| 구성원 | 무리 안 (칩 × 섹터) 곡선 하나 — 혼합 분포의 한 성분 |
| 우도 | 가정한 원인에서 관측 결과가 나올 확률(밀도) |
| 사전확률 · 사후확률 | 측정 전 · 측정 뒤의 믿음 |
| MAP | 사후확률이 가장 큰 구간 |
| 68% · 95% 구간 (HPD) | 확률 높은 구간부터 모아 누적 68% · 95% 를 채운 최소 집합 |
| LOCO · 모의 블라인드 | 교정 칩 하나를 빼고 나머지로 맞히는 교차 검증 |
| 포함률 · 보정 | 정답이 구간 안에 든 비율 · 그 비율이 약속한 확률과 맞는 정도 |
| 계단 | 빠른 무리 섹터의 소거 시간이 약 85ms 에서 111ms 로 뛰는 전환 |
| 속도 배율 r · R | 같은 무리 안 칩의 노화 속도 차이(가로축 배율) · 그 사전 범위 [1/R, R], v3.1 은 빠른 1.6 · 느린 1.3 (v3 는 1.6 · v2 까지 2.0) |
| 1차 · 2차 모델 | 칩 안 기준 섹터만 쓰는 현장 모델 · 신품 기록을 더한 참조 모델 |
