young-0320/flash-margin-bench/docs/concepts/14.nor_program_erase_and_wear.md

# 14. NOR 의 프로그램과 소거 — 공을 던져 넘기는 것과 자석으로 당기는 것

플래시 셀에 전자를 넣는 방법과 빼는 방법은 **서로 다른 물리**다. 넣을 때는 벽을 *넘기고*, 뺄 때는 벽을 *통과시킨다.* 이 차이가 마모 실험에서 "소거 시간은 첫 사이클부터 늘고, 프로그램 시간은 한참 뒤에야 움직이고, 타이밍 마진은 끝까지 안 움직이는" 세 현상을 한 줄로 설명한다.

마모가 겉으로 드러나는 두 얼굴(셀이 죽는 것 · 여유가 줄어드는 것)은 [개념 13](13.wear_cell_death_and_margin_loss.md)
에 있다. 여기서는 **그 벽 안에서 무슨 일이 일어나는가** 만 다룬다.

---

## 1. 셀 — 유리 벽 뒤의 선반

셀은 MOSFET 인데 게이트가 둘이다. 위의 **컨트롤 게이트**는 배선이 닿아 있고, 그 아래 **플로팅 게이트(FG)**
는 사방이 산화막으로 싸여 어디에도 안 닿는다. FG 와 채널 사이의 산화막을 **터널 산화막**이라 부르고 두께는 8-10nm 다.

FG 에 전자가 있으면 문턱 전압 Vt 가 올라가고, 없으면 내려간다. 읽기는 컨트롤 게이트에 중간 전압을 걸고 **전류가 흐르는지** 보는 것이다. 흐르면(FG 비어 있음) 1, 안 흐르면(전자 있음) 0. 그래서 NOR 은 소거 상태가 1 이고, 프로그램은 1→0 만 된다. 0 을 1 로 되돌리는 길은 소거뿐이라 섹터째 지운다.

비유하면 FG 는 **유리 벽 뒤 선반**이고 전자는 공이다. 프로그램은 공을 선반에 올리는 것, 소거는 내리는 것, 읽기는 선반에 공이 있나 보는 것이다. 벽은 열리지 않는다. 그래서 공을 넣고 빼는 방법이 둘이고, 둘이 다르다.

---

## 2. 프로그램 — 공을 던져서 벽을 넘긴다 (핫 일렉트론 주입)

드레인에 4-5V, 컨트롤 게이트에 8-10V 를 건다. 채널을 달리던 전자가 드레인 근처의 강한 전계에서
가속돼, 운동 에너지가 Si 와 SiO₂ 사이 장벽 3.2eV 를 넘는 놈이 생긴다. 이것이 **뜨거운(hot) 전자**이고,
그중 일부가 장벽을 넘어 게이트 전계에 끌려 FG 에 박힌다. 벽을 뚫는 것이 아니라 **벽 위로 넘기는 **것이다 (CHEI, channel hot electron injection).

특징은 **빠르고 전류가 많이 든다**는 것. 셀마다 채널 전류를 흘려야 하니 한꺼번에 못 하고 바이트·페이지
단위로 한다. 칩 내부는 펄스 → 검증 읽기 → 부족하면 다시 펄스, 이 루프를 Vt 가 목표를 넘을 때까지
돈다. 데이터시트의 페이지 프로그램 시간(수백 µs)이 이 루프 몇 번의 합이고, 마모 엔진의 A 행
`t_program_us` 는 한 섹터 16페이지의 합이다.

---

## 3. 소거 — 자석으로 벽 너머의 공을 당긴다 (FN 터널링)

컨트롤 게이트에 −8 에서 −10V, 소스·바디에 +5 에서 +8V. 터널 산화막 양단에 10MV/cm 급 전계가 걸리면 전자가
장벽을 **넘지 않고 통과한다.** 양자역학적 터널링이고, 벽이 8nm 라서 가능하다 (Fowler-Nordheim).
섹터의 모든 셀이 소스·바디를 공유하므로 한꺼번에 빠진다.

특징은 **느리고 전류가 거의 안 든다**는 것. 여기도 펄스 → 검증 → 반복인데, NOR 에는 절차가 하나 더
있다. 너무 많이 빠져 Vt 가 음수가 된 셀(**과소거**)은 항상 켜져 있어 같은 비트라인의 다른 셀을 전부
1 로 보이게 만든다. 그래서 칩은 소거 전에 섹터를 전부 프로그램해 출발선을 맞추고, 소거 뒤에는
과소거 셀을 살짝 되메우는 소프트 프로그램을 한다. 신품이 수십 ms 나 걸리는 이유가 이 절차다.

| | 프로그램 | 소거 |
| --- | --- | --- |
| 방법 | 벽을 넘긴다 (핫 일렉트론) | 벽을 통과시킨다 (터널링) |
| 단위 | 바이트·페이지 | 섹터 |
| 속도 | µs-ms | 수십 ms |
| 전류 | 크다 | 거의 없다 |
| 무엇에 민감한가 | 채널 전류 · 온도 | 산화막 양단 전계 |

---

## 4. 마모 — 벽에 흠집이 나고 공이 박힌다

프로그램이든 소거든 전자가 산화막을 지날 때마다 Si-O 결합이 조금씩 끊어져 **트랩**이 생기고, 거기에
전자가 박힌다. 박힌 전자는 그 자리에 음전하로 남는다. 유리 벽에 흠집이 나고 흠집마다 공이 끼는
것이다. 이것이 마모의 실체이고, 세 지표가 각각 다른 때에 이것을 드러낸다.

### 소거 시간 — 첫 사이클부터, 단조롭게

터널링은 전계의 **지수 함수**다. 산화막 안에 박힌 음전하는 FG 에서 나가려는 전자가 느끼는 전계를
깎으므로, 같은 펄스로 빠지는 양이 줄고 검증 루프가 는다. 트랩이 하나 생길 때마다 바로 반영되니
소거 시간은 첫 사이클부터 단조 증가한다. 그래서 **소거 시간은 산화막 흠집의 계수기**이고, 그것으로
P/E 이력을 되짚는 것이 가능해진다. 자석의 힘은 그대로인데 벽에 낀 공들이 자기장을 가리는 셈이다.

### 프로그램 시간 — 한참 뒤에야

핫 일렉트론은 벽을 *넘기는* 것이라 벽 *안의* 흠집에는 덜 민감하다. 대신 채널·드레인 근처에 계면
준위가 늘면 전류가 줄고 뜨거운 전자가 덜 생겨 펄스 수가 는다. 이것은 흠집이 상당히 쌓여야 보이므로
늦게 나타난다. 던지는 사람의 팔 힘은 그대로인데 발판이 무너지기 시작해야 던지기가 느려지는 것과
같다.

### 타이밍 마진 — 끝까지

읽기 경로는 셀과 떨어져 있다. 셀은 센스 앰프에 "전류 있음/없음" 만 주고, 출력 핀의 엣지는 SCLK 에
맞춰 도는 **출력 레지스터**가 만든다. Vt 가 마진 안에서 움직이는 한 센스 앰프의 답은 같고 엣지의 시각은
클럭이 정한다. **셀이 늙어도 시계는 안 늙는다.** 마진이 움직이는 자리는 셀이 아니라 센스 앰프가
답을 못 내는 순간, 즉 [개념 13](13.wear_cell_death_and_margin_loss.md) 의 ① 셀이 죽는 자리다.

### 유지 — 사양서가 실제로 보증하는 것

흠집 난 벽은 공을 **천천히 샌다.** 박힌 전하가 만드는 누설 경로(SILC) 로 FG 의 전자가 조금씩 빠지면
쓴 값이 몇 년 뒤 바뀐다. 데이터시트의 "내구 10만 회" 는 그 뒤에 쓴 데이터가 10-20년 유지된다는
보증이지, 10만 회에 셀이 죽는다는 뜻이 아니다. 즉시 읽어서 멀쩡한 것과 유지되는 것은 다른 시험이고,
유지는 고온 유지 시험(베이크 — 125-150°C 에 수 시간, 상온 수년을 가속. HTDR, JESD22-A117)으로 잰다.

---

## 5. 소거 직후의 프로그램은 왜 더 느린가 — 후보 둘

프로그램이 늙기 시작하면 한 가지가 더 보일 수 있다. **같은 사이클 안에서 먼저 프로그램되는 섹터가
더 느린** 현상이다. 마모 엔진은 7섹터를 프로그램한 뒤 7섹터를 소거하므로, 섹터 0 은 직전 사이클의
소거 7번 직후에 프로그램되고 섹터 6 은 가장 늦게 프로그램된다. 섹터 번호 순의 단조 기울기는 위치가
아니라 **소거 뒤 얼마나 지났나**를 따르는 모양이다. 후보는 둘이고 둘 다 마모에 비례한다.

- **열.** 소거 시간이 늘면 소거 7번의 합이 신품 0.2초에서 1초로 늘어 다이를 데운다. 핫 일렉트론
  주입은 온도가 오르면 효율이 떨어지므로(포논 산란으로 전자가 식는다) 펄스가 는다. 늙을수록 소거가
  길어져 더 데워지니 마모에 비례한다
- **소거 직후 과도.** 소거 직후 산화막 트랩의 전하가 ms-s 에 걸쳐 풀리며 Vt 가 움직인다. 늙은
  산화막일수록 트랩이 많아 과도가 크다

가르는 방법은 온도 센서 하나다. 다이 근처 온도가 소거 묶음 뒤에 오르는지 보면 첫째가 있는지 알고,
프로그램 순서를 뒤집거나 소거 뒤 지연을 넣은 짧은 런이 둘째를 가른다.

---

## 6. 이 프로젝트에서 보인 것

chip01 파일럿(2026-09-22 - 09-26, 섹터 0-6, 300k, 세션 `1790091548`·`1790212214`)에서 위 순서가 그대로
나왔다. 소거 p50 은 첫 체크포인트부터 단조 증가해 294.5k 에서 신품의 4.6배, 프로그램 시간은 137k 까지
7섹터 전부 7.0ms 로 붙박이였다가 섹터 0 이 약 145k 부터 서서히 벌어져 294.5k 에서 2.3배, 25MHz 폭은
신품 대비 15ps 로 재장착 σ(13.86ps) 안이었다. 섹터 번호 순의 프로그램 시간 기울기(§5)도 약 145k 부터
보였다. 수치는 `docs/results/` 의 승격본이 정본이고, 해석의 경위는 로그 48 과 그 후속에 있다.

이 순서가 말하는 것은 하나다. **어느 지표가 노화를 보이는가**(S-1 §1)에 대한 답은 소거 시간이고,
마진 폭은 셀이 죽기 전까지는 늙음을 모른다.
