young-0320/flash-margin-bench/docs/workflow/6.g1_launch_and_spec_hardening.md

# 6. G1 착수와 기준 정밀화 — S-3 동결 후속

- **작성일**: 2026-08-23
- **성격**: 워크플로 5를 **대체하지 않는다.** 5의 S 트랙에서 S-3이 나오면서 파생된
  후속 작업과, 동결본 자체 검토에서 나온 미비점을 모은다. 5의 D·M·B·V·G 트랙은 그대로 유효
- **선행 문서**: `docs/spec/s3.g1_test_plan.md`(동결본) · `docs/log/young/19.g1_acceptance_freeze.md`
- **원칙**: **박지민의 착수를 막지 않는다.** 아래 H 트랙은 전부 기준의 정밀화이며,
  F1\~F10 · C1\~C6 · I1\~I3 19항목은 이미 확정적이라 그것만으로 cocotb 환경 구축과
  기존 항목 이관을 시작할 수 있다. H가 건드린 것은 신설 항목과 운영 절차뿐이다

## 트랙 한눈에

| 트랙 | 내용 | 담당 | 선행 | 산출물 | 상태 |
| ---- | ---- | ---- | ---- | --- | ---- |
| W6-H | 동결본 미비점 8건 정밀화 | 한영웅 | 없음 (H1\~H3은 데이터시트·모델 필요) | 동결본 개정 | **완료 2026-08-23** (개정 2) |
| W6-R | 승인 대기 5건 | 사안별 | — | — | **해소 (2026-09-18)** — 게이트가 허구였다. R1·R2 본문 반영만 남음 |
| W6-C | `check_coverage.py` 구현 | 한영웅 | H5·H6 확정 | 대조 스크립트 | **완료 2026-08-23** |

**세 트랙 다 닫혔다.** H·C는 혼자 닫을 수 있는 성질이었고 닫았다. R 은 「3인 합의가
정의상 필요하다」고 적혀 있었으나 그 게이트가 허구였다 — 아래 R 절 참조.
경위는 `docs/log/young/19.g1_acceptance_freeze.md` §5~§11.

---

## H. 동결본 미비점 8건 (한영웅) — **완료 (2026-08-23, 개정 2)**

동결본을 작성 직후 재검토해 나온 것들이다. **기준의 정확성(H1\~H3)이 가장 무겁고**,
운영 공백(H4\~H6)은 실제로 회귀를 돌릴 때 반드시 걸리며, 명료성(H7·H8)은 가볍다.

### 결론 요약

| # | 결론 | 반영처 |
| - | ---- | --- |
| H1 | **W3 폐기.** 칩이 mode 0·3을 둘 다 지원하고(데이터시트 §6.1), 우리 SCLK 유휴 low는 `ODDR(D1=0)`이 강제하는 **배선 상수**라 실패 방향이 양쪽 다 없다. 지키려던 성질은 **F2로 흡수** (CS↓·CS↑ 시점 SCLK 레벨의 와이어 관측) | 기준 §5.2 폐기 절 · §5.1 F2 |
| H2 | **249 제거, `0 / 1 / 1,024 / 2,041`** 로 재선정. 각 지점이 구분하는 것을 표로 명시. **BER 관측은 상위 비트 유실을 원리상 못 잡으므로**(시드 14비트 별칭) 와이어 주소 디코드를 동등한 필수 조건으로 추가 | 기준 §5.1 F11 · §5.1.1 |
| H3 | **N 무관하게 일반화.** `BASE_SECTOR=2,047, N=17`(= 32,768, 최소 초과) + **음성 대조** `N=16`(= 32,767, 경계 정확) — 수정안 #2 승인 여부와 독립 | 기준 §5.1 F12 |
| H4 | `docs/spec/s3.g1_review.md` — 기준 옆의 **누적 판정서**. 로그는 시간순 개인 기록, `results/`는 실측 자리라 둘 다 부적합 | 기준 §6.1 · 신규 문서 |
| H5 | **별도 목록 파일 없음.** §5 표를 직접 파싱하고 **합계 선언 문장과 교차 검증** — 서식이 깨지면 0개가 아니라 불일치로 드러난다 | 기준 §4.1 · `check_coverage.py` |
| H6 | **수동 플래그 `--amendment1`**(기본 꺼짐). 조용한 소실을 막기 위해 제외 사실을 리포트 **선두에 항상** 출력 | 기준 §4.2 · `check_coverage.py` |
| H7 | **트리로 정의.** 신규 3파일이 아니라 DUT가 인스턴스화하는 전부 — `flash_rx`·`flash_logbuf`·`flash_prbs15`는 F3·F6이 직접 재므로 포함. `flash_ctrl`·`flash_top`(G0 루프백)은 제외 | 기준 §1 |
| H8 | **개방 조건 4개** — 3블록 승인 + 커버리지 23/23 + 전항 PASS + **②③이 같은 회귀 실행**. 마지막 항이 없으면 두 실행 사이에 테스트가 지워졌는지 알 수 없다 | 기준 §6.2 · `4.gate_map.md` G1 |

**항목 수 24 → 23** (미승인 시 22 → 21). W3 폐기가 유일한 감소분이며, 신설 5항목은
신설 4항목(F11 F12 · W1 W2)이 됐다.

아래는 착수 당시의 문제 기술이다. 각 항의 `verify`가 어떻게 닫혔는지는 위 표를 본다.

### 기준의 정확성 — 틀리면 채점이 틀린다

**H1. W3 (mode 경계) PASS 기준 재작성**

현행: *"SCLK 유휴 high로 바꾸면 실패할 것"*

문제: **W25Q64JV는 mode 0과 mode 3를 둘 다 지원한다.** 칩이 mode 3로 정상 동작해 버리면
"실패"가 나지 않아 PASS 기준이 성립하지 않는다. 우리 캡처 경로가 mode 0 에지 정렬을
전제하므로 실제로는 실패할 가능성이 높지만, **근거가 추측이지 데이터시트가 아니다.**

→ verify: `docs/ref/w25q64jv_datasheet_revc.pdf`에서 mode 0/3 진입 조건(CS↓ 시점의 SCLK
  레벨로 칩이 모드를 판별하는 방식)을 확인하고, 우리 RTL이 어느 모드로 동작하는지를
  **양방향으로 구분 가능한** 기준으로 다시 쓴다. 구분이 불가능하면 W3를 폐기하고
  사유를 기록한다 — 검증 불가능한 항목을 표에 남겨두는 것이 더 나쁘다

**H2. F11 BASE_SECTOR 지점 재선정**

현행: `0 / 249 / 1,024 이상 한 점 / 2,041`

문제: **249는 수정안 #1 §4 A2에서 그대로 베껴 왔다.** 거기서 249를 고른 이유는
*"종전 주소 폭(12비트)의 상한 부근 — 회귀 확인용"* 인데, **시뮬에서는 12비트 제약이
존재하지 않는다**(새 RTL을 돌리므로). 실측 인수 기준의 논리를 시뮬로 옮기면서 근거가
따라오지 않았다.

→ verify: 시뮬에서 각 지점이 **무엇을 구분하는지**를 한 줄씩 적는다. 근거가 안 서는
  지점은 뺀다. 최소한 `0`(하위 호환) · `1,024↑`(상위 주소 비트 경로) · `2,041`(N=112
  유효 최댓값, 최종 페이지 정확히 도달)은 각각 다른 것을 본다

**H3. F12의 N=112 출처 명시**

현행: `BASE_SECTOR=2,042, N=112`로 START

문제: **N=112는 계약 수정안 #2**(N 100→112)에서 온 값인데 문서가 #2를 언급하지 않는다.
N은 레지스터라 시뮬 동작에는 지장이 없으나, 읽는 사람이 "왜 112인가"에서 막힌다.

→ verify: 근거를 한 줄 붙이거나, N에 무관한 형태(`BASE_SECTOR × 16 + N − 1 > 32,767`을
  만족하는 임의의 조합)로 일반화한다. 후자가 #2 승인 여부와 독립이라 낫다

### 운영 공백 — 회귀를 돌리는 순간 걸린다

**H4. §6 ① 판정의 산출물 위치**

현행: *"①은 통과·보류 중 하나를 문서로 남긴다"* — **어디에 남기는지가 없다.**

→ verify: 로그(`docs/log/young/`) · 별도 판정서(`docs/spec/`) · `docs/results/` 중
  하나로 정하고 동결본에 경로를 명시한다. **판정 기록은 최종보고서에서 "작성자와
  승인자를 분리했다"의 유일한 증거**이므로 위치가 정해져 있어야 한다

**H5. `check_coverage.py`가 항목 ID를 얻는 방법**

현행: *"본 문서 §5의 항목 목록과 대조한다"* — **어떻게 읽는지가 없다.**

마크다운 표를 파싱하면 서식이 바뀔 때 조용히 깨지고, 별도 목록 파일을 두면 문서와
목록이 어긋날 수 있다.

→ verify: 둘 중 하나를 정한다. 별도 파일을 둔다면 **동결본이 원본이고 목록은 파생**임을
  명시하고, 스크립트가 둘의 불일치를 검출하게 한다

**H6. 수정안 #1 미승인 시 F11·F12 제외 처리**

현행: *"미승인 시 본 2항목은 미적용, 커버리지 대조에서도 제외"* — **스크립트가 승인
상태를 어떻게 아는가**가 미정이다.

→ verify: 수동 플래그(`--amendment1`) · 계약 문서 파싱 · 항목별 조건부 표기 중 하나로
  정한다. 수동 플래그가 가장 단순하나 **끄고 돌리면 2항목이 조용히 사라지므로**,
  리포트가 제외 사실을 항상 출력하게 한다

### 명료성

**H7. 채점 대상 파일 명시** — §1의 *"`flash_top_spi.v` 계열"* 을 실제 3파일
(`flash_spi_ctrl.v` · `flash_spi_shim.v` · `flash_top_spi.v`, 로그 11)로 확정한다.
`flash_rx.v` · `flash_logbuf.v` · `flash_prbs15.v`가 포함되는지도 함께 정한다.

**H8. G1 게이트 통과 조건 신설** — §6의 ①②③은 **블록 승인** 절차인데 블록이 셋
(flash · core · 통합)이다. **G1 게이트 자체가 언제 열리는지**가 문서에 없다.

→ verify: "3블록 전부 승인 + 커버리지 24/24" 같은 형태로 게이트 조건을 적고,
  `docs/workflow/4.gate_map.md`의 G1 행과 정합시킨다

---

## R. 승인 대기 5건 — **해소 (2026-09-18)**

> **2026-09-18 — 「3인 추인」은 합의된 절차가 아니었다.** AI 가 문서에 얹은 표기였고,
> 한영웅이 강하게 제지하지 않은 채로 굳었다. 실제 운영은 처음부터 **사안별** 이었다 —
> 셋이 동시에 지켜야 하는 것은 회의에서 동의를 받고(9/15 체커보드 채택이 실물,
> `docs/log/young/29.pe_engine_layer_decisions.md`), 나머지는 한영웅이 혼자 정했다.
> 이 절의 종전 전제("전부 혼자 정하면 나중에 정정 각주가 붙는 성질")가 그 일괄 게이트였고,
> 성질이 다른 다섯을 통째로 멈춰 세웠다.

기준은 새로 만들 것이 없다 — `docs/spec/README.md` 가 이미 갖고 있다.
**계약은 3인이 동시에 지키는 것, 사양서는 한 사람에게 보내는 지시다.**

| # | 문서 | 누가 정하나 | 처리 |
| - | ---- | --- | ---- |
| R1 | `interface/amendments/1.base_sector.md` | **한영웅 단독** — 계약 형식이지만 실질은 주소 배치 기술 판단 | 확정. **`contract.md` 본문 반영은 남았다** |
| R2 | `interface/amendments/2.n_reads_112.md` | **한영웅 단독** — MC 시뮬이 정하는 값 | 확정. **본문 반영은 남았다** |
| R3 | `roles.md` v2 | **3인** — 남의 역할을 혼자 정할 수 없다 | **동의 있었음** (2026-09-18 한영웅 확인). 회의 형식으로 표기 |
| R4 | `spec/s3.g1_test_plan.md` | **소유자(박지민)와 양자** — 사양서다 | 동결 유효. 「3인 추인 미완」 표기 제거 |
| R5 | `spec/s2.newchip_protocol.md` | **양자 + 시료 배분표만 3인** | 확정 유효. 배분표 건은 아래 |

**R5 시료 배분표만 남는다 — 2026-09-18 현재 회의 미실시.** 칩 10개를 파일럿 1 · 종단 마모 3 · 블라인드 2 · 무마모
대조군 2 · 예비 2 로 가르는 표다. 3인 사안으로 보는 이유는 **블라인드 2** 다 — "마모
담당자가 횟수를 숨기고 마모, 측정자가 추정"이라 두 사람의 역할이 갈리는 설계이고, 문서가
"이 측정은 되돌릴 수 없다"로 시작한다. **아직 회의에서 얘기되지 않았다** (2026-09-18 한영웅 확인) — 블라인드 설계 자체가 미공유다.
**마모에 착수하기 전이 유일한 기회다.** 신품 소거 시간·결함 비트·개체 산포는 마모를 한 번
이라도 시작하면 영원히 확보 불가능하고, 배분이 바뀌면 누가 무슨 칩을 받는지가 바뀐다.

**남은 실제 작업은 하나다** — R1·R2 의 계약 본문 반영. 표기가 아니라 내용 변경이고
RTL·호스트가 따라와야 하므로 별도 트랙이다.

---

## C. `check_coverage.py` (한영웅) — **완료 (2026-08-23)**

H5·H6 확정 후 착수. `sim/README.md` TODO에 등록돼 있었다.

구현: `sim/check_coverage.py`. 표준 라이브러리만 쓰며 cocotb JUnit XML(`results.xml`)을 입력으로 받는다.

```
python3 sim/check_coverage.py --results sim/build/results.xml [--amendment1]
```

- 실행된 테스트명(`test_<항목ID>_<설명>`)에서 항목 ID 추출 → 동결본 목록과 대조 →
  누락 시 비영(非零) 종료
- 기준 문서 §5 표 파싱 → 합계 선언과 교차 검증(H5) → 어긋나면 **커버리지 판정 이전에** 비영 종료
- 제외 항목을 리포트 선두에 항상 출력(H6)
- 누락뿐 아니라 **기준에 없는 항목 ID**(오타 또는 낡은 기준)도 FAIL 처리한다
- 소유가 한영웅인 이유: 기준 쪽 산출물이다. 채점 대상(`sim/tb/`, 박지민)이 자기 채점
  도구를 만들면 도입 취지가 사라진다. `sim/` 최상위에 둔다

---

## 남은 외부 의존 — 우리가 못 정하는 것

**Winbond 공식 행동 모델이 아직 확보되지 않았다** (`sim/README.md` TODO: "W25Q64 접미
확정 후 모델 파일 선택"). W1·W2가 여기 걸려 있다.

- 모델이 **타이밍 어서션을 제공하지 않는 판본**이면 W2의 PASS 기준(⑴ 무발화 ⑵ 음성
  대조)이 성립하지 않는다 → 우리가 직접 타이밍 체커를 쓰거나 W2를 재정의해야 한다
- ~~모델이 **mode 3 자동 판별을 구현하지 않으면** H1의 결론도 달라진다~~ — **해소.**
  H1은 모델 거동이 아니라 **데이터시트 §6.1과 우리 ODDR 배선**만으로 결론이 났다.
  모델이 mode 3를 어떻게 다루든 W3는 성립하지 않는다

**이것이 동결본을 다시 열게 될 가장 유력한 사유**이므로, 모델 확보 시점에 W 2항목을
일괄 재검토한다.
