young-0320/flash-margin-bench/docs/concepts/12.device_identity_and_nondestructive_check.md

# 12. 개체 식별 — 품종과 개체, 그리고 "재지 않고 확인하기"

- 작성일: 2026-09-16
- 관련 작업 로그: 로그 36(`flash_id` 구현) · 로그 23(UID 파이프라인 설계)
- 관련 코드: `ps/src/flash_id.c` · `ps/src/flash_io.c` `flash_read_uid()` ·
  `host/run/run_sweep_chip.py` `run_id()` · `docs/chip_registry.md`
- 함께 읽기: `docs/concepts/10.jedec_id.md`(품종 식별자 쪽)

---

## 쉬운 버전

### 품종과 개체는 다른 질문이다

강아지를 데려왔다고 하자. 두 가지를 물을 수 있다.

- **"무슨 종이냐"** — 진돗개다. 같은 종 수십만 마리가 같은 답을 낸다
- **"이 녀석이 누구냐"** — 목덜미 마이크로칩의 등록번호. 세상에 하나뿐이다

플래시 칩도 똑같다. `0x9F`(JEDEC ID)에 `EF 40 17`이라고 답하면 **"윈본드에서 만든
64Mbit 노어 플래시"**라는 뜻이고, 같은 모델 전부가 같은 답을 낸다. 품종이다.
`4Bh`(Read Unique ID)에 답하는 8바이트가 **개체**다 — 공장에서 다이마다 다르게
구워 넣은, 그 칩 하나만의 번호.

책상에 같은 모델 칩이 10개 널려 있을 때 `0x9F`는 아무 도움이 안 된다. 열 개가
전부 `EF 40 17`이라고 답한다. **품종 질문으로는 개체를 가릴 수 없다.**

### 그런데 왜 확인이 어려웠나 — 재는 행위가 대상을 닳게 한다

보통의 검사는 대상을 바꾸지 않는다. 자로 길이를 재도 물건은 그대로다.

플래시는 다르다. **쓰고 지우는 것이 곧 수명을 깎는 일**이다(P/E 사이클). 이 프로젝트가
재려는 것이 바로 그 마모의 효과라서, **검사가 표본을 바꾸면 실험 자체가 무너진다.**
체중 변화를 보겠다고 매번 체중계에 올릴 때마다 한 숟갈씩 먹이는 꼴이다.

문제는 이랬다. 개체 번호를 읽을 수 있는 상태(g2 비트스트림)에서 돌던 프로그램이
**하나뿐이었고, 그것이 반드시 지우고 쓰는 프로그램이었다.** 그래서 "누구냐"를 물으려면
반드시 한 번 닳게 해야 했다. 그 대가가 싫어서 재측정에서는 아예 묻지 않았고,
대신 사람이 "얘가 chip04야"라고 선언했다.

**의료로 치면 조직검사밖에 없던 상황이다.** 확인하려면 떼어내야 한다. 그래서 안 물었다.
`flash_id`는 그 자리에 **X-ray를 놓은 것**이다 — 읽기만 하므로 표본이 그대로다.

### 검사에는 두 가지 실패가 있다

칩이 `EF 40 17`이라고 답하지 않으면 원인이 여럿이다.

| 답 | 무슨 일인가 |
| --- | --- |
| `FF FF FF` | 아무도 대답하지 않았다 — 칩이 없거나 선이 틀렸다 |
| `00 00 00` | 선은 닿았는데 칩이 안 깨어 있다 — 전원·CS |
| 다른 값 | 누군가 대답은 했다 — 다른 칩이거나 접촉이 튀었다 |

개체 번호가 제대로 읽히면 위 셋은 자동으로 다 통과한 것이다. **그래서 품종 검사는
성공했을 때는 군더더기고, 실패했을 때만 값을 한다** — "왜 안 되는지"를 가른다.
진단은 원래 그런 성질이다. 잘 되면 필요 없고, 안 될 때 어디를 볼지 알려준다.

### 같은 걸 세 번 묻는 이유

전화가 지직거릴 때 상대가 불러준 번호를 한 번 더 확인하는 것과 같다.

SPI에는 **오류 검출 장치가 없다.** 전화선에 잡음이 끼어도 "지금 잡음이 꼈습니다"라고
알려주는 장치가 없는 셈이라, 접촉이 잠깐 튀면 **틀린 값이 성공으로 돌아온다.**
그래서 세 번 읽어 셋이 다 같을 때만 믿는다. 값 자체를 검산할 방법이 없으니
**반복의 일치**를 대신 쓴다.

### 신원 확인이 못 잡는 것

"다른 칩을 꽂았다"는 잡는다. **"칩을 안 뺐다"는 못 잡는다.**

접촉 저항이 매번 조금씩 달라지는 효과를 보려고 일부러 뺐다 꽂는 절차가 있는데,
사람이 빼지 않고 엔터만 쳐도 번호는 당연히 일치한다. 기계는 "지금 꽂혀 있는 게
누구냐"만 알지 "아까 뺐었냐"는 모른다. **정적인 사실은 확인되고 행위는 확인되지 않는다.**
거기는 여전히 사람 손에 달려 있다.

---

## 엔지니어링 버전

### 4Bh 프레임 — 왜 PL 경로로는 못 읽나

`4Bh`(Read Unique ID)의 전송 모양은 이렇다.

```
      [4Bh] [더미 4바이트] [UID 8바이트]      = 13바이트, 주소 없음
CS  ‾\______________________________________/‾
```

비교 대상인 측정용 읽기 `0x0B`(Fast Read)는 이렇다.

```
      [0Bh] [주소 3바이트] [더미 1] [데이터…]  = 주소가 있다
```

두 프레임은 **구조가 다르다.** 우리 PL 컨트롤러(`flash_spi_ctrl.v:120`)는 `0x0B`의
40클럭 프레임에 고정돼 있어 `4Bh`를 낼 수 없다. 그래서 개체 번호는 **PS 하드 SPI가
칩을 직접 잡는 세션(g2 비트스트림)에서만** 읽힌다 — 로그 23 §0이 말한 "세션 경계"가
이것이다. UID를 읽는 세션과 CSV를 만드는 세션이 물리적으로 달라, 사람이 중간에 끼면
UID가 파일에 닿지 못한다.

### 식별자의 층위

| 층위 | 명령 | 폭 | 같은 값을 갖는 집합 | 우리 쓰임 |
| --- | --- | --- | --- | --- |
| 품종 | `0x9F` | 3바이트 | 같은 모델 전부 | 배선·전원 진단 |
| 개체 | `4Bh` | 8바이트 | 그 칩 하나 | 측정의 귀속처 |

개체 번호는 공장에서 다이별로 프로그램되어 **변경 불가**다. 그래서 등록부
(`docs/chip_registry.md`)가 "라벨 ↔ 번호"를 불변 사실로 관리하고, 라벨(chip04)은
사람이 읽기 좋은 별명일 뿐 **진실은 번호 쪽에 있다.** 측정 CSV에 번호를 박는 이유가
그것이다 — 라벨은 사람이 잘못 붙일 수 있지만 번호는 칩이 스스로 말한다.

### 왜 "선언"에서 "검증"으로 바뀌는 것이 중요한가

같은 `--chip chip04`라는 입력이 두 가지로 읽힌다.

| | 선언 | 검증 |
| --- | --- | --- |
| 뜻 | "이건 chip04다" | "이게 chip04인지 확인해라" |
| 틀렸을 때 | 틀린 채로 파일에 기록된다 | 파일을 만들기 전에 멈춘다 |
| 사후 | **판별 불가** — 번호가 이미 박혔다 | — |

핵심은 **"사후 판별 불가"**다. 잘못된 측정이 남으면 나중에 이상한 값을 발견해도
"칩이 이상한 건지, 잘못 꽂은 건지" 구분할 근거가 없다. 데이터셋 전체의 신뢰가 흔들린다.
**틀린 데이터보다 없는 데이터가 낫다**는 계측의 오래된 원칙이 여기 적용된다 —
그래서 대조 실패는 경고가 아니라 중단이다.

### 비파괴 검사라는 일반 개념

측정이 대상을 변화시키는 계측에서는 **검사 수단 자체가 비파괴여야 한다**는 요구가
따로 생긴다. 반도체 신뢰성 시험(HTOL·사이클링), 배터리 수명 시험, 재료 피로 시험이
모두 같은 구조다 — 시험 대상의 상태량을 확인하는 행위가 그 상태량을 바꾸면 안 된다.

이 프로젝트에서는 그것이 **"쓰기 명령을 한 바이트도 내보내지 않는다"**로 구현된다.
소거·프로그램은 물론 `WREN`(쓰기 활성화)조차 내지 않는다. 앱을 따로 만든 이유가
기능 분리가 아니라 **그 보장을 코드 수준에서 자명하게 만들기 위해서**다 — 파일 안에
쓰기 명령이 없으면 "쓰지 않는다"를 읽어서 확인할 수 있다.
