young-0320/flash-margin-bench/docs/spec/s3.g1_review.md

# S-3 부속. G1 ① 판정서 — 어서션이 기준을 재는가

- **성격**: 합격 기준 `s3.g1_test_plan.md` §6 ①의 산출물. 블록별 행이 **누적**된다
- **판정자**: 한영웅 (TB 비작성자 — `roles.md` §검증(G1) 판정 3단)
- **대상**: `sim/tb/` 의 cocotb 테스트 코드 (작성: 박지민)
- **선행**: `check_coverage.py` 리포트 통과. 누락(항목 부재)은 기계가 이미 걸렀으므로
  ①은 **형식 커버**(`assert True` 류)와 **잘못된 기준**(예: tSHSL 최소값 오기)만 본다
- **위치 근거**: `s3.g1_test_plan.md` §6.1 (H4)

**③ 블록 승인은 해당 블록 행이 통과로 기입된 뒤에만 가능하다.** ①을 건너뛴 승인은 무효다.

---

## 판정 이력

| 일자 | 블록 | 회귀 스탬프 | 커버리지 | 판정 | 사유 / 보류 항목 |
| ---- | ---- | --- | --- | ---- | --- |
| — | flash | — | — | **미판정** | cocotb 환경 구축 전 |
| — | core | — | — | **미판정** | 〃 |
| — | 통합 | — | — | **미판정** | 〃 |

- **회귀 스탬프**: 커버리지 리포트와 전항 PASS가 **같은 실행**에서 나왔음을 보이는 값
  (커밋 해시 + 실행 시각). 게이트 조건 4번(§6.2)의 증거다
- **커버리지**: `23/23` 또는 수정안 #1 미승인 시 `21/21`. 제외 항목이 리포트에 명시됐는지 함께 확인
- **판정**: 통과 · 보류 둘 중 하나. 보류 시 **항목 ID를 반드시 적는다** — "전반적으로 부실"은
  재작업 범위를 정하지 못한다

## 보류 사유 기록 양식

보류가 나오면 아래를 이 문서에 이어 붙인다.

```
### <일자> <블록> 보류

| 항목 | 무엇이 | 무엇으로 고쳐야 하는가 |
| ---- | ------ | ---------------------- |
| F5   | 1UI 초과 실패 확인이 없다 (형식 커버) | 지연을 1UI 넘겨 BER≈0.5 를 어서트 |
```

## G1 게이트 개방 기록

3블록이 전부 통과로 기입되고 `s3.g1_test_plan.md` §6.2의 조건 4개가 충족되면 여기에 적는다.

| 항목 | 값 |
| ---- | -- |
| 개방일 | — |
| 회귀 스탬프 | — |
| 커버리지 | — |
| 수정안 #1 | 미승인 (`--amendment1` 미사용) |
| 캡처 승격 | `docs/results/captures/g1/` — 미생성 |
