young-0320/flash-margin-bench/docs/interface/s1.wear_bench_spec.md

# S-1. 스트레스 벤치 사양서

- **수신자**: 장세은 (구현) — `ps/src/`
- **인수 판정**: 한영웅 (§13)
- **작성**: 2026-08-23 · **개정**: 2026-08-23 (건조판)
- **채택 근거**: 본 문서는 수치만 싣는다. 각 값을 왜 그렇게 정했는지는
  `docs/log/young/17.wear_bench_spec_finalization.md`
- **전제**: 계약 수정안 [#1](amendments/1.base_sector.md)(BASE_SECTOR) ·
  [#2](amendments/2.n_reads_112.md)(N=112). #1 미승인 시 §14

---

## 1. 1사이클 정의

| 항목 | 값 |
| ---- | -- |
| 구성 | ① 0x00 프로그램 112페이지 → ② 7섹터 소거 |
| 마모 패턴 | `0x00` |
| 시간 (typ) | 7 × 45ms + 112 × 0.8ms = **405ms** |
| 계수 | 프로그램+소거 1쌍 = 1사이클. 체크포인트의 소거+PRBS 기록도 **1사이클로 계수** |

---

## 2. 영역 배치

### 2.1 파일럿 (확정)

```
섹터     0 ~     6   마모 그룹      BASE_SECTOR = 0
섹터     7 ~    13   근접 대조군    BASE_SECTOR = 7
섹터 2,041 ~ 2,047   원격 대조군    BASE_SECTOR = 2,041
섹터   512           tally #1       측정 안 함
섹터 1,536           tally #2       측정 안 함
```

### 2.2 본 실험 (잠정 — §15 파일럿 후 확정)

```
섹터     0 ~     6   마모 그룹 1    BASE_SECTOR = 0
섹터     7 ~    13   마모 그룹 2    BASE_SECTOR = 7
섹터    14 ~    20   마모 그룹 3    BASE_SECTOR = 14
섹터    21 ~    27   근접 대조군    BASE_SECTOR = 21
섹터 2,041 ~ 2,047   원격 대조군    BASE_SECTOR = 2,041
섹터   512 / 1,536   tally ×2       측정 안 함
```

**그룹 수와 그룹별 목표 사이클은 미정**(§15).

### 2.3 영역 규칙

| 영역 | 크기 | 소거 반복 | 스윕 측정 | PRBS 기록 |
| ---- | ---- | --- | --- | --- |
| 마모 그룹 | 7섹터 = 112페이지 | O | O | 체크포인트마다 |
| 대조군 (근접·원격) | 7섹터 | X | O | **체크포인트마다** |
| tally | 1섹터 × 2 | X (초기 소거 1회) | X | X |

- 완충 섹터를 두지 않는다
- 대조군은 체크포인트마다 소거+PRBS 재기록 → 대조군 누적 마모 = 체크포인트 수
- `flash_prep`·스캔 코드는 tally 섹터를 **하드 가드**로 제외한다
- tally는 실험 종료 시 해제한다 (§8.4)

---

## 3. 측정 조건

| 항목 | 값 |
| ---- | -- |
| N (위상당 읽기) | **112** |
| B (읽기당 비트) | 2,048 (1페이지) |
| BASE_SECTOR | 영역별 (§2) |
| 클럭 | 25MHz |
| 측정 패턴 | **PRBS-15**, 시드 {1, page[13:0]} |
| θ 기록 | 10⁻², 10⁻³, 10⁻⁴ |
| 반복 — 파일럿 | **1회**. 단 처음·중간·끝 3개 지점만 **3회** |
| 반복 — 본 실험 | **3회** (파일럿 결과에 따라 5회로 상향 가능, §15) |
| 사전 등록 확인 | σ_width @ N=112 = **0.16 / 0.34 / 1.35 ps** (θ=10⁻²/10⁻³/10⁻⁴, σ_j=11ps) — 규칙 한계 7.9ps 통과 |

---

## 4. 초기화 (실험 시작 시 1회)

```
1. UID 읽기 (4Bh) → 등록부 대조. 미등록이면 중단
2. tally 섹터 2개 소거 → 전체 0xFF 확인
3. 대조군 전 영역에 PRBS15 프로그램 → verify
4. 마모 그룹 전 영역에 PRBS15 프로그램 → verify
5. 신품 blank check 1회 → 출고 시점 결함 비트 기록 (주소 포함)
6. 체크포인트 0 측정
```

---

## 5. 체크포인트 절차

### 5.1 마모 그룹 (그룹마다)

```
1. 그룹 7섹터 소거
2. PRBS15 프로그램 112페이지 → verify
3. 스윕 (N=112, BASE_SECTOR=그룹 시작) × 반복 횟수
4. 사이클 카운터 +1
```

### 5.2 대조군 (근접·원격 각각)

```
1. 7섹터 소거
2. PRBS15 프로그램 112페이지 → verify
3. 스윕 (N=112, BASE_SECTOR=21 또는 2,041) × 반복 횟수
4. 해당 대조군의 누적 사이클 +1 (로그에 기록)
```

---

## 6. 마모 루프

```
반복 {
    ① 0x00 프로그램 112페이지          → t_program_us 기록
    ② 7섹터 소거                        → 섹터별 t_erase_us 기록
    ③ 사이클 카운터 +1
    ④ 검사 주기 도달 시 (§7):
         - blank check
         - tally 바이트 기록 (2벌 모두)
         - 다이 온도 읽기
         - UID 재확인
         - 호스트로 #WEAR 행 출력
    ⑤ 체크포인트 도달 시 → §5, 다음 체크포인트 산정 → §11
}
```

소거 시간은 **WIP 비트가 서 있는 구간의 지속시간**을 XTime으로 측정한다.

---

## 7. 무결성 검사 (blank check)

```
소거 직후    : 112페이지 읽기 → 0xFF가 아닌 비트    = erase_residual_bits
프로그램 직후: 112페이지 읽기 → 기대 패턴과 다른 비트 = program_fail_bits
```

| 항목 | 값 |
| ---- | -- |
| 기본 주기 | **100사이클** |
| 조밀화 주기 | **10사이클** |
| 조밀화 트리거 | 결함 비트 **1회 검출** |
| 1회 비용 | 약 176ms (실측 확인 대상) |

- 결함 비트의 **주소를 기록**한다. 초기엔 전량, 한 검사에서 64개 초과 시 처음 64개 + 총 개수
- 영구/일시 판정은 하지 않는다. 재현 횟수는 사후 분석에서 다룬다

---

## 8. 카운트 영속화 (tally)

### 8.1 방식

| 항목 | 값 |
| ---- | -- |
| 초기화 | 실험 시작 시 tally 섹터 2개를 각 1회 소거 → 전체 `0xFF` |
| 기록 | 100사이클마다 다음 바이트 하나에 `0x00` (2벌 동일하게) |
| 판독 | 누적 = `0x00` 바이트 수 × 100 |
| 용량 | 4,096바이트 → **409,600 사이클** |
| 기록 비용 | 0.004% (2벌 합산) |
| 바이트 재기록 | **금지** — 각 바이트를 딱 한 번만 쓴다 |

### 8.2 판독 규칙

| 값 | 처리 |
| -- | ---- |
| `0x00` | 센다 |
| `0xFF` | 안 씀 |
| 그 외 | 세지 않되 **±1 불확실**로 기록 |

두 벌이 불일치하면 **큰 쪽 채택**, 불일치를 로그에 기록한다.

### 8.3 재개 절차

```
1. UID 읽기 → 등록부 대조. 불일치면 중단
2. tally 2벌 판독 → 큰 쪽 채택
3. 호스트 로그 마지막 값과 대조 → 큰 쪽 채택, 불일치 기록
4. blank check → 부분 소거 상태면 해당 섹터 재소거
5. 이어서 진행
```

복원 불확실성: 최대 100사이클 (+소거 중 차단 시 ±1)

### 8.4 실험 종료 시

```
1. 최종 카운트를 docs/chip_registry.md에 확정 기입
2. tally 섹터 해제 (이후 정상 섹터로 사용 가능)
```

### 8.5 파일럿에서 검증할 것

파일럿 종료 시 tally 섹터를 전량 읽어 `0x00`/`0xFF` 외의 값이 있는지 확인한다.
있으면 마크 간격 또는 페이지당 기록 바이트 수를 조정한다.

---

## 9. 로깅

```
A. 사이클 로그   (매 사이클, 섹터별 1행)
   cycle, sector, t_erase_us, t_program_us, timestamp

B. 무결성 로그   (검사 주기마다 1행)
   cycle, erase_residual_bits, program_fail_bits,
   defect_addrs, defect_addr_count,
   worst_page_idx, worst_page_bits, die_temp_c, uid_ok, timestamp

C. 체크포인트 로그 (스윕 1개당 1행)
   cycle, area, sweep_csv, chip_id(UID), base_sector, n_sectors, n_reads,
   pattern, repeat_idx, area_cumulative_cycles, git_rev, die_temp_c, timestamp
```

공통 필수: `chip_id`(UID), `git_rev`, `base_sector`, `timestamp`

- `defect_addrs` — 결함 비트 주소 목록 (페이지·바이트·비트). 최대 64개
- `area_cumulative_cycles` — 대조군의 재기록 누적 사이클을 포함한 값
- 온도는 B·C에만 (A는 매 사이클이라 같은 값 반복)

---

## 10. 중단·경고 조건

| 조건 | 동작 |
| ---- | ---- |
| 결함 비트 > **46** | θ=10⁻⁴ 무효 표시, 계속 |
| 결함 비트 > **459** | θ=10⁻³ 무효 표시, 계속 |
| 결함 비트 > **4,588** | θ=10⁻² 무효 → **정지** |
| 소거 시간 > **400ms** | 경고 기록, 계속 |
| WIP 미해제 > **2초** (잠정) | **정지** + 대기시간 기록. **자동 재시도 금지** |
| UID 불일치 | **정지** |

- 결함 비트 한계 = 위상 무관 에러 플로어가 θ를 넘는 지점.
  `0.5 × D / (112 × 2,048) < θ`
- 워치독 2초는 잠정값. **M 트랙 신품 소거 시간 실측 후 확정**

---

## 11. 체크포인트 배치 — 적응적 조밀화

| 항목 | 값 |
| ---- | -- |
| 시작점 | 0 |
| 두 번째 점 | 300 |
| 기본 간격 | **× 2.15** |
| 조밀 간격 | **× 1.47** |
| 조밀화 트리거 | 직전 체크포인트 대비 폭 변화 **> 1.83ps** (= 3σ) |
| 복귀 조건 | 변화 ≤ 1.83ps → 다음 간격 2.15배로 복귀 |
| 종점 | **300,000** |

```
C_next = C × 2.15                      (조용할 때)
C_next = C × 1.47                      (직전 변화 > 1.83ps)
```

폭 계산은 `host/analysis/bathtub_analysis.py`. 자동화 전에는 수동 판정 허용.

---

## 12. 시간 예산

| 단위 | 값 |
| ---- | -- |
| 1사이클 | 405ms (typ) |
| 스윕 1회 | 약 5.6분 (실측 확인 대상) |
| 체크포인트 1점 — 파일럿 | 3영역 × 1회 = **17분** |
| 체크포인트 1점 — 본 실험 | 5영역 × 3회 = **84분** |
| 사이클링 300k (1그룹) | **33.7h** |

| 실험 | 사이클링 | 측정 | 합계 |
| ---- | --- | ---- | ---- |
| 파일럿 (1그룹 300k) | 33.7h | 점 수 × 17분 | 점 수에 따라 36~41h |
| 본 실험 | 그룹별 목표 사이클 합 × 405ms | 점 수 × 84분 | §15 확정 후 산정 |

tSE는 칩 내부 고전압 펄스 시간이라 SPI 클럭으로 줄일 수 없다. 소켓 1개, 전 과정 직렬.

---

## 13. 인수 기준

### A. 100사이클 시험

| # | 항목 | 통과 조건 |
| - | ---- | --- |
| A1 | 사이클 카운터 | 100 |
| A2 | 사이클 로그 행 수 | 700 (= 100 × 7) |
| A3 | 무결성 로그 행 수 | 1 |
| A4 | tally 바이트 | 각 벌에 `0x00` 1개 |
| A5 | **경로 간 일치** | 카운터 / A행수÷7 / B의 cycle / tally×100 이 **전부 100** |
| A6 | 소거 시간 | typ 45ms 부근, 400ms 미만 |
| A7 | UID | 로그의 chip_id가 등록부와 일치 |

### B. 전원 장애 복구 시험

100사이클 시험 도중 임의 시점 전원 차단 → 재개 → §8.3 복원

- 통과: 복원 카운트와 실제 진행 사이클의 차이 **≤ 100**
- 소거 중 차단 시: 부분 소거가 blank check에 잡히고 재소거 후 정상 진행

### C. 측정 경로 연결

체크포인트 절차(§5) 1회 실행

- 통과: `valid=1 reason=complete` · CSV의 `n_reads`=112, `base_sector`=지정값 ·
  체크포인트 로그의 `sweep_csv`가 실제 파일명과 일치

---

## 14. Plan B — 계약 수정안 #1 미승인 시

읽기 창이 페이지 0 고정. 한 스윕이 섹터 0~6만 읽는다.

```
섹터 0 ~ 3   마모 그룹 (64페이지)
섹터 4 ~ 6   대조군    (48페이지)
```

| 항목 | Plan A | Plan B |
| ---- | --- | --- |
| 마모 그룹 | 다수 × 7섹터 | 1개 × 4섹터 |
| 대조군 | 근접 + 원격 | 근접만 |
| 그룹당 읽기 | 112 | 마모 64 / 대조 48 |
| θ 유효 | 10⁻², 10⁻³, 10⁻⁴ | 10⁻², 10⁻³ |
| 인접 간섭 검출 | 가능 | 불가 |

**§6~§10(마모 루프·무결성·tally·로깅·중단)은 Plan A와 완전히 동일하다.**
영역 배치와 스윕 파라미터만 다르므로 **승인을 기다리지 않고 착수한다.**

---

## 15. 파일럿 유보 항목

| # | 미정 항목 | 파일럿이 답할 질문 |
| - | --- | --- |
| ① | 본 실험 체크포인트 배치 | 폭이 언제부터 움직이는가 |
| ② | 본 실험 그룹 수·마모량 배분 | 마모 효과 대비 섹터 간 산포의 크기 |
| ③ | 본 실험 섹터 배치 | 인접 섹터 간섭이 존재하는가 (근접 vs 원격) |
| ④ | 본 실험 반복 횟수 (3회/5회) | 폭 변화량이 노이즈 플로어 대비 얼마인가 |
| ⑤ | 반복 측정의 온도 전이 영향 | 3회 반복의 순서와 폭에 체계적 경향이 있는가 |
| ⑥ | tally 기록 방식 | 페이지당 256회 부분 프로그램이 성립하는가 (§8.5) |

**파일럿 결과 전에는 종단 마모 3칩을 착수하지 않는다.**

---

## 16. 본 사양 범위 밖

- P/E 사이클러 구현 층위 (PS C 전제 — 3인 확정 필요)
- 온도 제어 (히터 도착 후. 본 사양은 기록만)
- W25N(NAND) 확장
