young-0320/flash-margin-bench/docs/concepts/11.ber_scales_tails_and_ruler.md

# 11. BER 스케일과 꼬리 외삽, 그리고 자(尺)의 해상도

첫 실칩 곡선(로그 15)에서 나온 세 가지 질문 — "왜 10⁻¹²인가", "모델 부적합이
뭔가", "절벽은 자가 넓어서 생긴 착시 아닌가" — 의 일반론.

## BER 눈금 감각

BER 10⁻¹² = 1조 비트당 1비트 오류. W25Q64(6,400만 비트) 전체를 1만 5천 번
읽으면 10¹² 비트가 된다 — 저장장치의 일상 규모라, 업계 규격(SATA·PCIe·플래시
데이터시트)이 "사실상 안 틀림"으로 합의한 선이 이 근방이다. 반면 우리 스윕은
위상당 204,800비트만 읽으므로 볼 수 있는 바닥은 ~10⁻⁵. 10⁻¹²를 직접 재려면
위상 한 점에 열 시간대 → 그래서 "재는 것"이 아니라 "모델로 연장선을 긋는
것"(외삽)이 표준 전략이고, 체크 1(가우시안 probit 직선성)은 그 연장선을 그을 자격시험이었다.

## 벽의 두 얼굴: 모래 비탈(랜덤)과 콘크리트 절벽(결정론)

- 랜덤 지터(RJ)가 지배하는 벽: 샘플링 순간이 가우시안으로 흔들려 BER이
  위상에 따라 **매끈한 비탈**을 그린다. probit 좌표에서 직선이고, 벽 중심에서
  BER→0.5 (동전던지기)로 포화한다. 이 직선의 기울기가 σⱼ.
- 결정론 성분(DJ)이 지배하는 벽: 특정 패턴의 비트만 **항상** 틀린다. 포화
  천장이 0.5가 아닌 임의 값(실측 0.246)에 멈추고, 연속 위상에서 에러 수가
  비트 단위까지 동일하게 반복된다(노이즈면 출렁여야 한다 — 로그 13·15의
  "결정론 평탄부").
- 업계 표준 지터 모델(dual-Dirac)은 처음부터 TJ = DJ + 2Q(BER)·σ_RJ 로
  두 성분을 분리해 10⁻¹²까지 외삽한다. "단일 가우시안" 체크는 그 단순판.

## 자의 해상도와 절벽 착시

절벽처럼 보이는 벽도 σ가 0이 아닌 한 충분히 촘촘한 자로는 비탈이다. 우리
자는 Δφ = VCO주기/56 = 15.873ps (VCO 1.125GHz). 실칩 σⱼ ≈ 6~11ps이므로
비탈 전체(±3σ)가 자 눈금 1~2칸에 들어가 절벽으로 보인다. 자를 줄이는 길은
VCO 상향뿐인데 이 칩 등급 상한 1.2GHz → 14.9ps, 6% 개선에 그침 — 비탈 분해엔
2~3ps가 필요해 구조적으로 불가. 단, 자를 줄여도 0.246 천장(결정론 성분)은
그대로 남는다 — 착시는 비탈의 "모양"에만 해당하고, 모델 부적합의 핵심 증거는
자 해상도와 무관하다.

## 실무 귀결 (이 프로젝트)

- 결정론 지배 채널에서는 θ(판정 BER)를 바꿔도 폭이 거의 안 변한다 (실측:
  θ 10⁻²→10⁻⁴에서 27ps 차이). 외삽이 필요 없으므로 실측 폭 직독이 가능.
- 체크 1의 거취(θ-수렴 검사로 대체 vs 2성분 모델 도입)는 판정 기준 변경이라
  3인 합의 사안 — 로그 15 미결 참조.
