young-0320/flash-margin-bench/docs/concepts/5.prbs_pattern.md

# 5. PRBS와 BER — 정답지를 안 보내고 채점하는 법, 그리고 채점 결과를 읽는 법

- 관련 결정: 계약 19 (패턴 = PRBS-15, 시드 = {1, index[13:0]}) · 계약 §5 (N·B) · 로그 10 ① (체크리스트 문턱값)

## 왜 패턴 "사양"이 필요한가

에러 1개의 정의는 "받은 비트 ≠ 기대한 비트"다. 채점이 성립하려면 보내는 쪽과 채점하는 쪽이 **같은 정답지를 공유**해야 한다. 그리고 그 정답지의 내용 자체가 측정의 품질을 좌우한다.

시험지 비유로 나쁜 정답지 두 가지:

- **올-제로 (`0000...`)**: 모든 문제의 답이 "0"인 시험지. 답안지를 한 칸 밀려 써도(타이밍이 틀어져 옆 비트를 읽어도) 만점이 나온다. 고장이 에러로 번역되지 않으니 **욕조 곡선의 벽 자체가 안 생긴다.**
- **교대 (`0101...`)**: 한 칸 밀림은 잡지만 주기가 2라서 **두 칸 밀리면 다시 만점** — 짝수 슬립이 전부 투명해진다.

이상적인 정답지는 "어느 칸으로 밀려 써도 확률 1/2로 틀리는" **무작위 비트열**이다. 그러면 윈도우 밖에서 BER이 0.5로 포화하는데, 이것이 몬테카를로와 `bathtub_analysis.py`가 처음부터 가정해 온 성질이다. 그런데 진짜 난수는 채점자가 정답을 모르게 된다. 여기서 PRBS가 등장한다.

## PRBS: 무작위처럼 보이는 결정론

PRBS(Pseudo-Random Binary Sequence)는 **시프트 레지스터와 XOR 게이트 하나**로 만드는 비트열이다(이 회로를 LFSR이라 부른다). 매 클럭마다: 레지스터의 특정 두 칸을 XOR한 결과를 맨 앞에 밀어 넣고, 맨 뒤에서 한 비트를 출력한다. 동전 던지기처럼 보이지만 완전히 결정론적이라, **같은 시작값(시드)에서 돌리면 언제 어디서든 똑같은 수열**이 나온다.

즉 정답지를 통째로 전달하는 대신 **"생성 규칙 + 시작값"만 공유**한다. FPGA의 패턴 생성기, 비교기, 파이썬 golden model이 각자 15개 플립플롭(또는 코드 몇 줄)으로 같은 정답을 독립 재생성한다 — 오라클 독립성까지 공짜로 따라온다.

## 엔지니어링 수치 — 왜 하필 15인가

우리 사양: **다항식 x¹⁵ + x¹⁴ + 1** (15비트 레지스터, 14·15번 칸을 XOR — 통신 표준에서 검증된 최대 길이 구성).

| 항목 | 값 | 의미 |
| --- | --- | --- |
| 주기 | 2¹⁵ − 1 =**32,767비트** | 버스트 2,048비트는 주기의 6.25% →**버스트 안에서 반복 없음** |
| 하드웨어 비용 | FF 15개 + XOR 1개 | 7Z020 FF 106,400개의 0.014% — 사실상 공짜 |
| 0/1 균형 | 한 주기에 1이 16,384개, 0이 16,383개 | BER 0.5 포화의 전제인 균형성 |
| 이웃 비트 상이 확률 | ≈ 1/2 (한 주기에 전이 16,384회) | k비트 슬립 시(k = 1..2,047 어느 값이든) BER ≈ 0.5 — 모든 슬립이 가시화 |
| 최장 런 | 1이 15개 / 0이 14개 연속 | 저주파 쏠림 한계 — DC 균형 유지 |

**PRBS-7이면 안 되는 이유**: 주기가 2⁷−1 = 127비트라 버스트 2,048비트 안에 약 16번 반복된다. 그러면 **127의 배수만큼 밀린 슬립은 정답과 다시 일치**해 투명해진다 — 교대 패턴의 "짝수 슬립 구멍"과 같은 병이 주기만 길어진 채 남는 것. PRBS-15는 버스트 내 무반복이라 이 구멍이 없다. PRBS-23(주기 838만)은 이득 없이 레지스터만 커진다 — 버스트 무반복이면 충분하다.

전기적으로도 전이 밀도 ~50%는 실제 데이터와 비슷한 스펙트럼을 만들어, 심벌 간 간섭 같은 실사용 스트레스를 자극한 채로 마진을 잰다 — 얌전한 패턴으로 재면 마진이 낙관적으로 부풀 수 있다.

## 시드 규약 

시드는 15비트인데 **0만은 금지**다: 올-제로 상태에서 XOR 피드백은 영원히 0만 낳는다(락업). 우리 규약은 상위 비트를 1로 고정하고 하위 14비트에 인덱스를 넣는다:

$$
seed = \{1,\ index[13:0]\}
$$

- 구조적으로 0이 될 수 없어 락업 방어에 조건문이 필요 없다.
- **index = 루프백: 스텝 내 읽기 번호(0..N−1)** — 모든 위상 스텝이 동일한 자극 시퀀스를 받아, 스텝 간 차이가 순수하게 캡처 타이밍에만 귀속된다(통제 변인).
- **index = 실칩: 페이지 주소 하위 14비트** — "주소만 알면 그 페이지에 뭐가 써 있어야 하는지 안다"가 되어, 쓰기·읽기·채점 장부가 주소 하나로 닫힌다.
- 정직한 한계: W25Q64는 32,768페이지라 하위 14비트가 같은 페이지 쌍(16,384쌍)은 같은 시드를 공유한다. 시드의 목적은 페이지 유일성이 아니라 **버스트 단위 재생성 가능성**이므로 실험에 무해하다 — 스윕은 소수의 페이지만 쓴다.

## 버스트마다 재시드하는 이유

버스트 시작마다 시드를 다시 넣으면, 비교기는 **이전 이력 없이** 그 버스트의 정답을 그 자리에서 만들 수 있다. 도중에 에러가 나든 측정을 재시작하든 다음 버스트에서 동기가 저절로 회복된다. 이력에 의존하는 연속 스트림 방식이었다면 슬립 하나가 이후 전체를 오염시켰을 것이다 — 재시드는 오염의 전파를 버스트 하나로 격리하는 방화벽이다.

---

## BER — 채점 결과를 읽는 법 (이 실험의 y축)

**BER(Bit Error Rate) = 틀린 비트 수 ÷ 읽은 비트 수.** 욕조 곡선의 y축이 이것이고, 위상 스텝 하나가 BER 표본 하나다 (스텝당 읽는 비트 = N×B = 100×2,048 = 204,800).

### BER은 측정값이 아니라 추정값이다

에러는 확률 현상이라 BER은 "동전의 앞면 확률"과 같은 종류의 양이다 — 동전을 던져서(비트를 읽어서) **추정**할 수 있을 뿐이다. 두 가지 실무적 귀결:

- **분해능**: 스텝당 204,800비트이므로 구별 가능한 최소 BER은 1/204,800 ≈ **4.9×10⁻⁶**. 체크 2의 floor 문턱(10⁻⁵)이 이 바로 위에 있는 것은 우연이 아니다 — 측정이 분해할 수 있는 한계 근처까지 요구하되 넘지 않는 값이다.
- **"에러 0" ≠ "BER 0"**: 20만 번 던져 앞면이 안 나왔다고 앞면 확률이 0인 게 아니다. 에러 0의 올바른 문장은 "BER < 상한"이고, n비트 무에러의 95% 신뢰 상한은 ≈ 3/n(3의 법칙)이다. `bathtub_analysis.py`가 floor를 "실측 0.0 (상한 …)"으로 출력하는 이유. 클럭 사다리의 "풀 스윕 에러 0 → 승격"(로그 10 ⑤)도 정확히는 "전 위상에서 BER < 1.5×10⁻⁵ 상한" 진술이다.

### 왜 로그로 보는가 — 벽은 자릿수의 게임

윈도우 안팎에서 BER은 10⁻⁶ ↔ 0.5처럼 **자릿수 단위로** 변한다. 선형 축에서는 벽이 수직 절벽으로 뭉개져 보이지만, 벽의 실체는 절벽이 아니라 **경사**다: 샘플 시점이 전이 지점에 가까워질수록 지터(가우시안)의 꼬리가 점점 자주 걸린다. 로그 축 + probit 변환(가우시안의 역함수)을 하면 이 경사가 **직선**이 되고, 직선성(R² ≥ 0.98, 체크 1)이 "벽이 정말 가우시안 지터로 설명되는가"의 검정이 된다. 직선의 기울기에서 σⱼ(지터 표준편차)가 나오고, 이것이 몬테카를로에 되먹임되어 N=100의 근거를 재확인한다(계약 §5).

### 판독표 — BER 값이 말해주는 것

| 관측 | 해석 |
| --- | --- |
| ≈ 0 (바닥) | 유효 창 안. 정확히는 "< 3/n 상한" |
| 10⁻⁴ ~ 10⁻¹ (경사)  | 벽 — 지터 꼬리가 걸리는 전이 구간. probit 적합·θ 교차가 전부 여기서 나온다 |
| **0.5 (포화)** | 샘플이 완전히 창 밖 — 받은 비트와 정답이 무상관. **동전 던지기 = 정보 0** |
| 0.5보다 유의하게 큼 | 무상관이 아니라 **반상관** — 프레이밍 슬립/극성 반전 의심 (분석기 체크 5가 잡는 서명) |

0.5가 "최악"인 이유: BER 1.0은 사실 완벽한 채널이다(전부 뒤집으면 만점). 정보가 진짜로 없는 지점이 0.5이고, PRBS의 균형성(위 표)이 창 밖을 정확히 0.5로 포화시켜 준다 — 전 통계의 암묵 전제가 패턴 사양으로 보장되는 구조.

### θ 문턱 — "윈도우 폭"은 정의의 문제다

벽이 경사인 이상 "창이 어디서 끝나는가"는 자연이 정해주지 않는다 — **수위선을 어디에 긋느냐**의 문제다. 그래서 폭은 반드시 문턱과 함께 말해야 한다: "BER = θ 교차점 사이 거리". 우리는 θ = 10⁻²(잠정)를 채택하고 10⁻³·10⁻⁴ 폭을 병행 기록한다(계약 §6) — 문턱을 나중에 바꿔도 곡선만 있으면 재환산이 되도록. θ의 최종 확정은 실측 곡선이 체크리스트 4항을 통과하는지로 판정한다(로그 10 ①, 문턱 3개는 2026-07-07 확정).

### 읽기 단위 통계 — 평균 뒤에 숨는 버스트

같은 스텝의 BER이라도 "에러가 읽기 전체에 고르게 4개"와 "한 읽기에 몰려 4개"는 물리가 다르다(후자 = 버스트성 — 순간 전원 노이즈, 간헐 접촉). 스텝 합계만 저장하면 이 구별이 소실되므로 읽기별 e_i를 전량 보존하고(계약 3-4), 과분산 F = 관측분산/이항기대분산 ≤ 2(체크 4)로 "에러가 비트 단위로 독립"이라는 probit 적합의 전제를 검사한다. 평균은 같아도 분산이 말해주는 것이 있다 — e_i 버퍼가 원시값 보존에 목숨 거는 이유.
