young-0320/flash-margin-bench/docs/concepts/8.ui_ruler_and_clock_ladder.md

# 8. 1 UI라는 자와 클럭 사다리 — 왜 클럭을 올려야 벽이 보이나

- 관련 결정: 계약 결정 16 (VCO 1,125MHz 고정) · 로그 10 ⑤ (승격 기준) · 워크플로 1 조건부 필수 ③

## 스윕의 자는 정확히 1 UI다

위상은 원형 축이다 — 시계 바늘을 한 바퀴 넘게 돌리면 그냥 제자리다. 샘플 위상을 SCLK 한 주기(= 비트 하나의 폭, **UI**) 넘게 밀면 "다음 비트의 같은 지점"을 찍는 것이고, 7번 문서의 재정렬이 그걸 투명하게 흡수한다. 따라서 **스윕이 볼 수 있는 세계의 크기는 정확히 1 UI**다. 25MHz면 자의 길이가 40ns.

## 문틈이 자보다 넓으면

측정하려는 것은 칩의 **유효 데이터 창**(비트 폭에서 전이 불확정 구간을 뺀 나머지)이다. 에러는 샘플이 불확정 구간 — tCLQV 산포 + 지터 + 신호 전이 시간 — 에 걸릴 때만 나는데, 이 구간은 **클럭과 무관한 ns 단위 절대량**이다. 25MHz에서는 40ns 자 위에 불확정 구간이 몇 ns도 안 되어, 유효 창이 자를 통째로 덮어버릴 공산이 크다: **스윕 전 스텝 에러 0, 벽 없음.**

문틈을 자로 재는데 문틈이 자보다 넓으면 얻는 문장은 "자보다 넓다"뿐이다. 욕조 곡선의 정보 — probit 적합, σⱼ, θ 교차 폭 — 는 전부 벽에 있으므로(5번 문서), 벽 없는 스윕은 하한 진술 한 줄이지 곡선이 아니다. 체크리스트는 적합 자체가 불가능하다.

## 클럭을 올리면 벽이 자 안으로 들어온다

불확정 구간은 고정이고 UI가 줄어드니, 클럭을 올릴수록 그 고정량이 자에서 차지하는 비율이 커진다:

| SCLK | O (MMCM 분주) | UI | 스텝 수 (56×O) | 불확정 ~5ns의 비율 |
| --- | --- | --- | --- | --- |
| 25MHz  | 45 | 40ns | 2,520 | 12.5% |
| 45MHz  | 25 | 22.2ns  | 1,400 | 22.5% |
| 75MHz  | 15 | 13.3ns  | 840 | 37.5% |

어느 클럭부터 벽이 보이기 시작하는지 자체가 칩 마진의 측정값이다 — 사다리는 우회로가 아니라 **측정 절차의 일부**다.

VCO를 1,125MHz에 고정한 설계(결정 16)의 우아함이 여기서 드러난다: 위상 스텝 Δφ = VCO주기/56 = **15.873ps는 사다리 전 구간 불변**이고, 바뀌는 것은 스텝 수(56×O)뿐이다. 자가 짧아져도 눈금 간격은 그대로 — 클럭별 곡선을 같은 분해능으로 겹쳐 볼 수 있고, 빌드도 분주 파라미터(O_DIV) 하나로 끝난다. 이 불변성 덕에 phase_ps 계산도 클럭 독립식(step × 10⁶/63 fs)이 된다 — 사다리에서 UI 기반 상수를 쓰면 오염된다는 것을 오늘 니어미스로 확인했다 (로그 12).

## "에러 0"도 산출물이다

승격 기준(로그 10 ⑤)이 코어스 스캔이 아니라 **풀 스윕 에러 0**인 이유 중 하나: 전 스텝 에러 0인 완전한 CSV는 "이 클럭에서 유효 창 > 1 UI(= BER < 1.5×10⁻⁵ 상한, 5번 문서의 3의 법칙)"라는 **게재 가능한 증거**다. 버려지는 사다리 단이 아니라 "저클럭에서는 여유가 이만큼"이라는 데이터 포인트.

정직한 한계 둘: ① 벽이 보이는 클럭에서도 벽 폭이 몇 스텝뿐이면 전이 구간에 점이 부족해 R² 적합이 안 된다 — 그 단은 건너뛰고 더 올린다 (채택 기준: 양벽 각각 BER>θ 스텝 ≥ 2개인 최저 클럭에서 체크리스트 통과). ② 75MHz에서는 왕복 지연이 1 UI에 근접해 7번 문서의 PAY_LEAD 재보정이 걸릴 수 있다 — 측정 한계가 아니라 프레이밍 보정 항목.
