young-0320/flash-margin-bench/docs/concepts/2.phase_sweep_and_mmcm.md

# 2. 위상 스윕과 MMCM — 15ps짜리 눈금자는 어떻게 만들어지나

- 관련 결정: 계약 0(샘플 클럭 시프트), 16(클럭 플랜 — VCO 1,125MHz, Δφ=15.87ps)

## 위상이란: 두 시계의 어긋남

같은 속도로 가는 시계 두 개가 있다고 하자. 둘 다 1초에 한 번 째깍거리지만, 하나가 다른 것보다 0.3초 늦게 째깍거린다면 — 이 "늦음"이 위상이다. 주파수(빠르기)는 같고 **타이밍(언제)**만 다른 것.

디지털 회로에서 데이터는 클럭이 째깍하는 순간에 읽힌다. 칩이 내보낸 데이터 비트 하나는 아주 짧은 시간 동안만 유효하고(우리 설계에서는 40ns — 이 길이를 **UI**라고 부른다), 그 구간의 어디에서 읽느냐에 따라 성공/실패가 갈린다. 한가운데서 읽으면 항상 성공, 비트가 바뀌는 경계에서 읽으면 실패하기 시작한다. **읽는 시점(위상)을 조금씩 옮겨가며 "어디서부터 틀리는가"를 찾는 것**이 위상 스윕이고, 그 결과가 욕조 곡선이다.

## 위상 아키텍처: 무엇을 움직일 것인가

읽는 시점과 데이터가 오는 시점의 "상대적 차이"를 바꾸는 방법은 둘이다: 데이터를 내보내는 쪽 시계를 움직이거나, 읽는 쪽 시계를 움직이거나. 줄자와 물체의 관계와 같다 — 물체를 옮겨 재도 되고 줄자를 옮겨 재도 되지만, 물체에는 다른 것들이 딸려 있다(명령·제어 신호가 같은 시계에 묶여 있다).

우리는 **읽는 쪽(샘플 클럭)만 움직인다**. 칩이 보는 세계(SCLK·명령·CS)는 스윕 내내 완전히 동일하고, 우리 쪽 "읽는 순간"만 15.87ps씩 이동한다. 이러면 곡선에 나타나는 모든 변화를 "읽는 타이밍" 단 하나의 변수에 귀속시킬 수 있다 — 실험에서 통제 변인을 하나만 남기는 것과 같은 원리다.

## MMCM: FPGA 안의 시계 공방

MMCM(Mixed-Mode Clock Manager)은 FPGA에 내장된 클럭 가공 블록이다. 하는 일은 시계 공방과 같다: 기준 시계(보드의 125MHz)를 받아서, 더 빠르게/느리게 만들거나, **원하는 만큼 늦춘(위상 시프트한) 복제 시계**를 만들어 준다.

내부 구조는 세 개의 손잡이로 요약된다:

```
125MHz 입력 → [÷D] → [×M] → VCO (내부 고속 발진) → [÷O] → 출력 클럭
```

- **VCO**: 공방의 심장. 600~1200MHz 사이의 매우 빠른 발진기로, 모든 출력은 이 발진을 나눠서 만든다.
- **D, M, O**: 사용자가 정하는 정수 손잡이. VCO = 125 × M ÷ D, 출력 = VCO ÷ O.

### 위상 시프트의 눈금은 왜 1/56인가

MMCM은 VCO 한 주기를 하드웨어적으로 **56등분**하는 위상 보간기를 내장하고 있다(칩에 새겨진 상수 — 우리가 못 바꾼다). "위상 한 칸 이동" 명령을 줄 때마다 출력 클럭이 VCO 주기의 1/56만큼 늦춰진다:

$$\Delta\phi = \frac{VCO 주기}{56}$$

그래서 눈금을 촘촘하게 하려면 VCO를 빠르게 돌리면 된다. VCO 1,125MHz면 주기 888.9ps ÷ 56 = **15.87ps** — 우리의 눈금이다. 참고로 1조분의 15초다. 빛도 이 시간엔 5mm밖에 못 간다.

### 그런데 왜 VCO를 최대(1200)로 안 돌렸나 — 지터

지터는 클럭 자신의 흔들림이다. 완벽한 시계는 정확히 40ns마다 째깍거리지만, 실제 시계는 매번 몇 ps씩 빠르거나 늦다. 문제는 우리가 만드는 것이 **시간을 재는 계측기**라는 점이다 — 자를 만드는데 자 자체가 떨리면, 그 떨림이 측정값에 그대로 섞인다.

MMCM의 지터는 설정의 "청결도"가 좌우한다. MMCM은 피드백 루프라 입력과 출력을 **초당 125÷D 백만 번** 비교하며 스스로 보정하는데, D가 크면 비교가 뜸해져 보정 사이에 위상이 더 떠돈다. 그래서 수칙은 **D=1(입력을 안 나누고 그대로 비교), M은 정수**다. VCO를 정확히 1200MHz로 만들려면 D=5가 필요해서(125×48÷5) 지터가 늘어난다 — 눈금 1ps를 얻으려고 자의 떨림을 키우는 역설. 그래서 D=1이 가능한 것 중 가장 빠른 VCO 1,125MHz(M=9)를 골랐다.

## 눈금 하나 더: 스윕 전체는 몇 스텝인가

한 비트 길이(UI) = 출력 클럭 한 주기 = VCO 주기 × O. 이걸 Δφ = VCO 주기 ÷ 56으로 나누면:

$$\text{UI당 스텝 수} = 56 \times O$$

우리 설정(O=45)에서는 56 × 45 = **2,520스텝**. 위상을 2,520번 밀면 정확히 한 비트를 처음부터 끝까지 훑는다.

## 함정 하나: SCLK와 샘플 클럭은 같은 빠르기여야 한다

위상 시프트는 자기 클럭 한 주기를 넘어가면 제자리로 돌아온다(시계 바늘이 한 바퀴 돌면 같은 위치이듯). 그래서 샘플 클럭의 주기가 UI와 같아야 스윕이 UI 전체를 정확히 한 번 덮는다. 만약 SCLK를 clk_core의 절반 속도로 만들면 UI가 샘플 클럭 주기의 2배가 되어 **비트의 절반은 영영 스윕할 수 없다.** 그래서 계약 R9가 "SCLK는 분주하지 말고 clk_core를 그대로 내보내라(포워딩)"를 강제한다.
