young-0320/flash-margin-bench/docs/concepts/3.clock_domains_and_cdc.md

# 3. 클럭 도메인과 CDC — 두 시계 세계 사이에 다리를 놓는 법

- 관련 결정: 계약 1-1(CDC 소유권 — flash 전담), 계약 0의 파생 구조

## 클럭 도메인: 같은 시계를 보는 회로들의 나라

디지털 회로의 모든 저장 소자(플립플롭)는 자기 클럭이 째깍하는 순간에만 값을 받아들인다. **같은 클럭을 쓰는 회로들의 집합**을 클럭 도메인이라 부른다 — 같은 표준시를 쓰는 나라라고 생각하면 된다. 나라 안에서는 모두가 같은 순간에 움직이므로 신호를 주고받는 데 아무 문제가 없다.

우리 설계에는 나라가 둘 있다:

- **clk_core의 나라**: SPI 마스터, AXI 레지스터, 핸드셰이크 — 고정된 시계
- **clk_sample의 나라**: MISO 캡처 플롭, 비교기, 에러 집계 — 같은 빠르기지만 **위상이 계속 바뀌는** 시계 (스윕이 곧 이 시계를 옮기는 일이므로)

## 왜 국경을 함부로 넘으면 안 되나: 준안정성

플립플롭에는 규칙이 있다: 째깍하는 순간의 **직전·직후 아주 짧은 시간 동안 입력이 바뀌면 안 된다**(셋업/홀드 시간). 어기면 어떻게 되나 — 0도 1도 아닌 어중간한 전압에 한동안 머무르는 **준안정(metastable)** 상태가 된다. 동전을 던졌는데 모서리로 선 상황이다. 결국 0이나 1로 쓰러지긴 하는데, 언제 어느 쪽으로 쓰러질지 보장이 없다.

같은 나라 안에서는 이 규칙이 자동으로 지켜진다(모두 같은 순간에 움직이니 타이밍을 계산할 수 있다). 그런데 **다른 나라에서 온 신호**는 우리 시계와 아무 약속 없이 아무 때나 바뀐다 — 언젠가는 반드시 금지 구간을 밟는다. 그 결과가 준안정성이고, 증상은 최악의 유형이다: **가끔, 재현 안 되게, 값이 틀린다.** 매번 틀리면 금방 잡지만, 만 번에 한 번 틀리는 버그는 몇 주를 잡아먹는다.

## CDC: 국경 세관

CDC(Clock Domain Crossing)는 이 국경 통과를 안전하게 만드는 회로 기법의 총칭이다. 가장 기본은 **2단 동기화기**: 신호를 받는 나라의 플립플롭 두 개를 직렬로 놓는다. 첫 번째 플롭은 준안정에 빠질 수 있지만, 두 번째 플롭이 받기 전 한 주기 동안 거의 확실히 안정된다. 모서리로 선 동전도 잠시 기다리면 쓰러져 있다는 원리다.

단, 2단 동기화기는 **1비트짜리 신호**에만 안전하다. 32비트 카운터 값을 그대로 국경에 넘기면 비트마다 도착 시간이 달라 — 어떤 비트는 이번 째깍에, 어떤 비트는 다음 째깍에 잡혀 — 잠깐 동안 뒤죽박죽 값이 읽힌다. 그래서 다중 비트를 넘길 때의 정석은: **값을 먼저 멈춰 세워 놓고**, "값 준비됨"이라는 1비트 신호만 동기화기로 넘긴 뒤, 받는 쪽이 그 신호를 보고 멈춰 있는 값을 읽는 것이다.

### 왜 이걸로 충분한가: 준안정성은 "전이"의 문제지 "국경"의 문제가 아니다

이 정석이 좀 이상하게 들릴 수 있다 — 32비트 값 자체는 동기화기를 **아예 거치지 않고** 생짜 배선으로 국경을 넘는데, 그게 어떻게 안전한가? 답은 준안정성이 원래 무엇 때문에 생기는지를 다시 보면 나온다: 플립플롭은 "다른 나라 신호라서" 위험한 게 아니라, 째깍하는 순간 **입력이 마침 바뀌고 있어서** 위험하다(셋업/홀드 위반). 값이 여러 주기째 가만히 멈춰 있다면 — 즉 아무 전이도 없다면 — 그 값을 아무 순간에나 찍어도 위반할 전이 자체가 없으므로 항상 안전하다.

그래서 트릭은 "32비트를 안전하게 옮기는 법"이 아니라 **"32비트가 멈춰 있는 상태를 만들고, 그 사실 하나만 안전하게 알리는 법"**이다. 보내는 쪽이 값을 다 확정한 뒤에야 "준비됨" 비트를 세우고, 그 비트가 2단 동기화기를 거쳐 오는 동안 걸리는 몇 주기가 — 우연이 아니라 — 바로 "32비트가 그동안 계속 멈춰 있었다"는 걸 받는 쪽에게 보장해주는 여유 시간이 된다. 받는 쪽이 동기화된 준비 신호를 확인하는 시점엔 원래 값은 이미 그보다 훨씬 오래전부터 정지해 있었던 셈이라, 그제서야 읽는 32비트는 동기화기 없이도 안전하다.

## 우리 설계에서: 다리는 하나, 가장 쉬운 자리에

측정 데이터의 여정: MISO 핀 → 캡처 플롭(clk_sample 나라) → 비교·집계(clk_sample 나라) → **국경** → 핸드셰이크·AXI(clk_core 나라).

계약 1-1의 결정은 이 국경(다리)을 **맨 뒤, 측정이 다 끝난 지점**에 놓는 것이었다. 이유는 위의 정석과 정확히 일치한다 — 측정이 끝나면 카운터와 버퍼는 **멈춰 있는 값**이고, 넘길 것은 "끝났음(done)" 1비트뿐이다. 비트가 초당 2,500만 개씩 흐르는 도중에 다리를 놓는 것(1-1의 다른 후보)보다 압도적으로 쉽고 안전하다.

그리고 다리 전체를 flash 블록 한 사람이 소유한다. 국경 사고의 특성상(간헐적·재현 불가) 책임 경계가 갈라져 있으면 "네 쪽 문제다"의 무한 루프에 빠지기 쉽기 때문에, 계약의 모든 신호를 clk_core 하나로 통일하고 국경은 블록 내부 문제로 캡슐화했다.

## 덧붙임: 우리 국경은 그나마 온순한 편

일반적인 CDC는 두 시계의 빠르기가 다른 경우까지 다뤄야 해서 더 험하다. 우리 두 시계는 **같은 MMCM에서 나온 같은 주파수**고 위상만 다르다(이런 관계를 mesochronous라 부른다). 위상은 스텝 사이에만, 우리가 명령할 때만 바뀐다. 그래서 "측정 중에는 두 시계의 관계가 고정"이라는 좋은 성질이 있고, 다리 설계가 교과서적 패턴으로 충분하다. 남는 미묘함 하나는 위상이 바뀔 때마다 국경 통과 지연이 한 주기쯤 달라질 수 있다는 것 — 그래서 비트 정렬(프레이밍)을 버스트마다 다시 잡고, 인접 스텝 간 BER 연속성 검사로 이 유형의 버그를 자동 검출한다.
