young-0320/flash-margin-bench/docs/workflow/1.midterm_report_workflow.md

# 1. 중간보고서(7/10) 게재 항목 작업 워크플로

- **작성일**: 2026-07-06
- **마감**: 2026-07-10 중간보고서 제출
- **목표**: 무조건 필수 1개를 확보하고, 칩 도착·브링업 성공 시 조건부 묶음을 승격시킨다
- **근거 문서**: `docs/project_context.md` §9 (게이트 순서 G0→G4 고정)
- **원칙**: "필수" = 없으면 보고서가 성립하지 않는 것 **그리고** 우리 통제 안에서 확실히 달성 가능한 것. 통제 못 하는 변수를 필수로 적으면 계획이 도박이 된다.
- **운영 모드 (2026-07-07 ~ 제출)**: (G0→G2→G3) 투입. 단 인터페이스 합의(핸드셰이크·레지스터 맵·카운터 폭·CSV 스키마)는 구두로 정하는 즉시 `docs/interface/`에 한 줄씩 기록. 제출 후 역할·규칙 복원.

## 게재 확정 목록 (2026-07-07) — 담당 배정 (7/8 동시 진행)

1. 루프백 욕조 곡선 (무조건 필수) — **한영웅** (아침 최우선: 1·2번용 인터페이스 계약 완성 → 장세은 인계 후 착수)
2. 보드-모듈 정상 통신 증거 — JEDEC ID 캡처 1장, 실칩 곡선의 도입부로만 — **장세은**
3. 몬테카를로 근거 그림 2장 (✅ 확보 — 보고서 문단 정리 + G0 후 실측 σⱼ 재실행만 남음) — **한영웅**
4. 실칩 욕조 곡선 + 연속 반복 5회 에러바 (조건부 승격) — **한영웅** ※ 1·2 완료가 선행 조건

- cocotb 증거: **필수 아님 — 마감 시점에 회귀 PASS가 존재하면 캡처 1장으로 줍는다** (G1 작업 자체는 유지, 게재만 강등)
- **박지민** (7/8 오전 인턴, 오후 합류): cocotb 사다리 — ① iverilog+cocotb 환경 구축·예제 PASS ② Winbond W25Q64 행동 모델 구동 ③ cocotb로 모델에 JEDEC ID 트랜잭션 → 0xEF 40 17 수신 확인 (= 2번의 시뮬레이션 리허설, 향후 SPI 마스터 채점기)
  - 환경: 윈도우면 네이티브 말고 **WSL2 권장** (cocotb의 VPI 연결이 네이티브 윈도우에서 잘 깨짐) — `wsl --install` 후 WSL 안에서 `sudo apt install iverilog gtkwave`, `pip install cocotb`. 파이썬 분석 쪽은 `docs/CONTRIBUTING.md` §1.5 (uv) 참조

---

## 우선순위 구조

| 분류 | 항목 | 게이트 | 하드웨어 | 방어하는 질문 |
| --- | --- | --- | --- | --- |
| 무조건 필수 | 루프백 욕조 곡선 | G0 | Zybo 단독 | "그 측정기, 실제로 동작하나?" |
| 조건부 필수 (승격형 묶음) | 실칩 곡선 + 최소 반복(연속 5회) | G2→G3(+G4 최소판) | Zybo + W25Q64 | "실제 칩에서도 되나?" + "한 번 우연히 나온 그림 아닌가?" |
| 병렬 저비용 | 몬테카를로 (위상당 N 근거) | — | 불필요 (PC만) | "N번 읽기는 왜 N번인가?" |
| 병렬 저비용 | cocotb 검증 증거 | G1 | 불필요 (PC만) | "RTL이 맞다는 건 어떻게 아나?" |
| 순수 선택 | 재장착 포함 풀 반복성 통계 | G4 완전판 | Zybo + W25Q64 | "장착 편차까지 분리했나?" |

- **승격 조건**: 모듈이 D-2(7/8)까지 도착하고 JEDEC ID가 읽히면(G2), 조건부 묶음은 그 즉시 필수로 승격. 미충족 시 루프백 곡선 + 계획으로 보고서를 완성한다.
- **묶음인 이유**: 실칩 곡선이 성공한 순간 재장착 없는 연속 반복 5회는 몇 분~몇 시간짜리다. "곡선 1장 + 에러바"가 "곡선 1장"과 "반복성 표" 두 항목보다 강하므로 분리하지 않는다.
- 병렬 저비용 2개는 하드웨어가 필요 없으므로 무조건 필수와 **동시 진행** (cocotb는 팀원 A 소유).

---

## 무조건 필수 — 루프백 욕조 곡선 (G0)

칩·DUT 보드 없이 FPGA 단독으로 자기 배선의 욕조 곡선을 실측한다. 외생 변수 0 — 유일하게 확실히 달성 가능한 실측물이자 보고서의 바닥. 최대 기술 리스크(MMCM 위상 제어)를 여기서 소진한다.

0. (선행 입력) 몬테카를로에서 위상당 읽기 횟수 N 확정 — 아래 병렬 저비용 참조
1. MMCM 동적 위상 시프트 제어 RTL + 스윕 FSM 동작 확인
   → verify: 위상 스텝 명령에 대해 시프트 완료(DONE) 응답이 전 구간에서 돌아옴
2. 루프백 경로 구성 (출력 핀 → 입력 핀) + 패턴 생성/비교기 연결
   → verify: 위상 중앙에서 에러 0, 극단 위상에서 에러 발생
3. 위상 전 구간 스윕 → 위상별 에러 카운트 CSV 수집 (UART 경로 포함)
   → verify: CSV에 전 스텝 데이터가 결측 없이 기록됨
4. 욕조 곡선 산출 스크립트 작성 (CSV → 곡선 그림 + 윈도우 경계 판정 + 폭 계산)
   → verify: 곡선이 욕조 모양(중앙 평탄 0, 양끝 상승)이고 폭이 ns 단위로 출력됨
5. golden model(경계 판정 독립 구현)과 폭 판정 교차 검증
   → verify: 두 구현의 윈도우 폭 판정 일치

**산출물**: 루프백 욕조 곡선 그림 1장 + 윈도우 폭 수치

## 조건부 필수 — 실칩 곡선 + 최소 반복 묶음 (G2 → G3 → G4 최소판)

설득력 1위("프로젝트 전체 주장의 증명")지만 달성 확실성이 외생 변수 세 개에 걸려 있어 승격 조건을 단다: ① 모듈 배송 시점, ② 브링업 성공, ③ 저클럭에서는 윈도우가 스윕 범위(클럭 1주기)보다 넓어 에러가 안 보일 수 있음 — 클럭을 올려가며 에러가 보이는 지점을 찾아야 한다.

첫 곡선은 SOP8 ZIF 어댑터 직결 + 저클럭 허용 (전용 보드 불요).

1. 실칩 저클럭 브링업: JEDEC ID 읽기 (G2) — **승격 판정 지점**
   → verify: 0xEF 40 17 (W25Q64) 수신
2. 쓰기 → 읽기 → 검증 기본 트랜잭션 확인
   → verify: 알려진 패턴이 오류 없이 왕복
3. 루프백의 스윕 절차를 실칩 읽기 경로에 적용, CSV 수집
   → verify: 위상 극단에서 에러가 실제로 발생 (안 나면 클럭을 올려 재시도)
4. 동일 스크립트로 곡선 산출
   → verify: 실칩 욕조 곡선 1장 + 윈도우 폭 (ns)
5. 같은 칩 연속 반복 측정 5회 (재장착 없이) — 곡선에 거의 공짜로 붙는 부속
   → verify: 윈도우 폭의 평균·표준편차 → 곡선에 에러바 표기

**산출물**: 실칩 욕조 곡선 그림 1장 (에러바 포함) + 윈도우 폭 평균·편차

## 병렬 저비용 — 몬테카를로: 위상당 읽기 횟수 N의 근거

하드웨어 불필요. 단순 게재물이 아니라 **G0의 선행 입력**이다 — 스윕을 돌리려면 N을 정해야 하므로 사실상 첫 작업.

1. 에러율 p인 위상에서 N회 읽기 시 경계 판정 오차의 시뮬레이션 (Python)
   → verify: N에 따른 윈도우 폭 추정 분산 곡선 출력
2. 채택한 N 값의 근거 문장 정리 (보고서 게재용)
   → verify: "N = ___인 이유" 한 단락 + 그림 1장

## 병렬 저비용 — cocotb 검증 증거 (G1)

하드웨어 불필요. 팀원 A 소유 — 무조건 필수와 동시 진행.

1. cocotb + Winbond 공식 행동 모델 환경에서 SPI 트랜잭션 회귀 실행
   → verify: 회귀 전체 PASS
2. PASS 로그·커버 항목 요약을 보고서 게재 형태로 정리
   → verify: 시뮬레이션 파형 또는 PASS 요약 캡처 확보

## 순수 선택 — 재장착 포함 풀 반복성 통계 (G4 완전판)

조건부 묶음 완료 후, 시간이 남을 때만.

1. 재장착(ZIF 탈착) 포함 반복 측정 N회
   → verify: 재장착 편차가 연속 측정 편차와 분리되어 보고됨

**산출물**: 반복 측정 산점도 또는 편차 표 — "측정이 노이즈가 아니라 신호"의 완전한 증거

---

## 시간이 남으면 (게재 항목 외 보너스)

- **10개 전수 신품 측정** — 조건부 묶음 성공 시 같은 절차 ×9, 수 시간. 개체 산포 히스토그램 1장
- **신품 소거·쓰기 시간 측정** — 10ns 타이머 동작 증거, 표 한 줄

둘 다 비파괴이므로 보고서 이후에 해도 손실 없음. 필수·선택과 시간을 다투지 않는다.
