young-0320/flash-margin-bench/docs/concepts/1.monte_carlo.md

# 1. 몬테카를로와 위상 스윕의 파라미터들

- 작성일: 2026-07-06
- 관련 작업 로그: `docs/log/young/1.monte_carlo_and_artifact_policy.md`
- 관련 코드: `host/analysis/monte_carlo_sweep_params.py`

---

## 몬테카를로는 무엇을 하는 도구인가

한 문장으로: **실험을 실험하는 도구**입니다.

본실험(위상 스윕)을 하려면 파라미터를 미리 정해야 합니다 — 위상마다 몇 번 읽을지(N), 에러율 몇을 경계로 볼지(θ). 그런데 이 값들이 좋은지 나쁜지는 실험을 해봐야 알고, 실험을 하려면 값을 정해야 하는 순환에 빠집니다. 게다가 θ 같은 값은 "유효 윈도우 폭"이라는 숫자의 정의 그 자체라서, 한번 정하면 프로젝트 끝까지 못 바꿉니다. 감으로 정했다가 나중에 틀렸다는 걸 알게 되면 그때까지의 측정이 전부 비교 불능이 됩니다.

몬테카를로는 이 순환을 끊습니다. 컴퓨터 안에 **정답을 미리 아는 가짜 칩**(진짜 욕조 곡선을 우리가 심어둔)을 만들고, 그 위에서 측정 절차 전체 — "위상마다 N번 읽고, 에러를 세고, 경계를 판정하고, 폭을 계산한다" — 를 난수로 수천 번 연습합니다. 정답을 아니까 측정값이 정답에서 얼마나 흔들리는지(편차), 얼마나 벗어나는지(편향)를 N과 θ의 함수로 잴 수 있습니다.

비유하면 **정답지를 아는 모의고사**입니다. 진짜 시험(실칩 측정)에서는 정답(진짜 폭)을 아무도 모르기 때문에 채점 도구가 옳은지 검증할 방법이 없습니다. 모의고사에서는 정답을 심어놨으니 채점 도구(경계 판정 알고리즘)가 정답을 복원하는지 시험할 수 있죠.

그래서 역할이 세 겹입니다:

1. **파라미터의 근거** — "왜 N=100인가? 왜 θ=10⁻³인가?"에 감이 아니라 곡선으로 답한다
2. **실험 예산 설계** — 스윕 1회가 몇 초인지 미리 계산해서, 정밀도와 시간의 거래를 눈에 보이게 한다
3. **golden model의 시험대** — 정답을 아는 합성 데이터는 경계 판정 알고리즘의 검증 벡터가 되고, 나중에 실측 반복 편차(G4)와 비교할 이론 하한(순수 통계 노이즈)이 된다. 실측 편차가 이 하한보다 크면 그 초과분은 통계가 아닌 다른 원인(온도 드리프트, 재장착)이라는 진단까지 가능하다

---

## 위상 스윕이란 무엇인가 — 욕조 곡선의 전 단계

플래시 내부 동작은 몰라도 됩니다. 필요한 그림은 "동기식 디지털 통신이 신호를 받는 법" 하나입니다.

1. **디지털 수신 = 순간 포착.** 데이터는 전압이 오르내리는 연속 파형으로 오고, 받는 쪽은 클럭이 째깍하는 순간에 한 번 '찰칵' 샘플링해 그 순간의 전압으로 0/1을 판정한다.
2. **한 비트 안에는 안전 구간과 위험 구간이 있다.** 비트 하나가 전선을 점유하는 시간이 클럭 한 주기(UI). 값이 바뀌는 전이 순간 근처에서 찍으면 틀릴 수 있고, 안정 구간 한가운데면 항상 맞는다. 회전문을 통과하는 사람을 찍는 것과 같다 — 문이 돌아가는 순간에 찍으면 잘리고, 완전히 나온 순간이면 선명하다.

```
신호:   ──╳████████████╳──   (╳ = 전이 구간(위험), █ = 안정 구간)
                 ↑
           한가운데 '찰칵' = 항상 정확
```

3. **위상 = 찰칵 타이밍의 위치, 스윕 = 그걸 조금씩 옮겨보기.** 평소 시스템은 타이밍을 가운데 고정해 두므로 항상 성공하고, 안전 구간의 너비는 보이지 않는다. 위상 스윕은 MMCM으로 타이밍을 수십 ps씩 일부러 어긋내며 "어디서부터 틀리는가"를 양쪽으로 찾는 것. 위치별 에러율을 기록하면 아래의 욕조 곡선이 되고, 바닥 너비가 유효 윈도우 폭이다.

**플래시는 파형을 보내주는 상대방일 뿐이다.** 위상 스윕은 전적으로 수신 측(FPGA)의 행위라서 상대가 칩이든 루프백 점퍼든 원리가 같다 — G0가 칩 없이 성립하는 이유. 플래시 내부(셀·전하)가 필요해지는 건 측정이 아니라 해석 단계("낡으면 왜 좁아지는가")다.

한 줄 요약: 위상 스윕 = "사진 찍는 타이밍을 일부러 조금씩 어긋내며, 어디까지 어긋나도 사진이 안 망가지는지 재는 것."

## 욕조 곡선이란 무엇인가

위상 스윕이 만들어내는 결과 그래프입니다. X축은 읽기 샘플링 타이밍(위상), Y축은 그 타이밍에서 측정된 에러율. 가운데가 평탄하게 낮고(윈도우 안 — 항상 성공) 양끝에서 가파르게 치솟아(윈도우 밖 — 항상 실패) **욕조를 옆에서 자른 단면** 모양이 되기 때문에 욕조 곡선(bathtub curve)이라고 부릅니다. 신호 무결성/지터 분석 분야의 표준 용어이고, SerDes 같은 고속 링크의 BER 테스트에서 쓰는 바로 그 그림입니다.

비유하면 **긴 줄넘기에 들어가는 타이밍**입니다. 줄이 도는 동안 들어가도 되는 타이밍 구간이 있죠 — 한가운데 타이밍이면 백 번 시도해도 백 번 성공하고, 구간을 완전히 벗어나면 백 번 다 걸립니다. 그리고 구간의 가장자리 타이밍에서는 *가끔* 걸립니다. 시도 타이밍을 조금씩 옮겨가며 "백 번 중 몇 번 걸리는가"를 기록하면 그게 정확히 욕조 곡선입니다.

이 곡선에서 읽어내는 것은 두 가지입니다:

- **바닥의 폭** = 유효 윈도우 폭. 이 프로젝트가 재는 "여유" 그 자체입니다. 평소에는 윈도우 한가운데서 읽으니 항상 성공해서 여유가 안 보이는데, 타이밍을 일부러 가장자리까지 밀어보면 여유가 나노초 단위 숫자로 나옵니다 — 칩이 고장 나기를 기다리는 대신 측정기가 고장 지점까지 다가가서 재는 방식.
- **벽의 위치와 기울기의 변화** = 온도·전압·노화가 남기는 지문. 조건이 나빠지면 바닥이 좁아지고, 그 좁아지는 속도가 우리의 데이터입니다.

이름 주의: 신뢰성 공학에도 "욕조 곡선"이 따로 있습니다(X축 = 수명, Y축 = 고장률 — 초기 고장·안정기·마모기). 이름만 같은 완전히 다른 그래프이므로, 보고서에서는 "BER bathtub (위상 대 에러율)"이라고 한 번 명시해 혼동을 차단합니다. 또 SRAM의 버터플라이 커브(전압 노이즈 마진)와도 무관합니다 — 그쪽은 셀 내부 전압 이야기, 우리는 인터페이스 타이밍 이야기.

## 경계는 벽이 아니라 비탈이다 — 욕조 곡선과 θ

위 줄넘기 비유에서 "가장자리 타이밍에서는 가끔 걸린다"고 했는데, 이 "가끔"이 핵심입니다. 위상을 옮겨가며 에러율을 재면 이렇게 생겼습니다:

```
에러율
 0.5 |‾\                              /‾
     |  \                            /
10⁻² |---\--------------------------/---  ← θ를 여기 그으면 (좁고 정밀한 폭)
10⁻³ |----\------------------------/----  ← θ를 여기 그으면
10⁻⁴ |-----\----------------------/-----  ← θ를 여기 그으면 (넓고 거친 폭)
   0 |______\____________________/______
              ↑    윈도우 폭    ↑        → 위상
```

가운데는 에러 0, 바깥은 엉망(0.5)인 건 분명한데, 그 사이가 **점진적인 비탈**입니다. 에러율이 0에서 갑자기 0.5로 뛰는 게 아니라 10⁻⁶ → 10⁻⁴ → 10⁻² → 0.5로 번져요. 그러니 "윈도우가 끝나는 지점"을 물으면 자연이 주는 정답이 없습니다. 수평선을 하나 긋고 **"에러율이 이 높이를 넘는 순간부터 윈도우 밖"**이라고 선언해야 하고, 그 수평선의 높이가 θ입니다.

해수욕장 비유가 정확합니다: "수영 가능 구역은 어디까지인가?" 바다는 점점 깊어질 뿐 경계벽이 없으니, "수심 1.5m까지"라는 기준을 사람이 정해야 구역의 폭이 정의됩니다. 수심 1.2m 기준이면 구역이 좁아지고 2m 기준이면 넓어지죠. 어느 쪽도 틀린 게 아니고, 기준을 명시하고 한번 정하면 바꾸지 않는 것이 중요할 뿐입니다. 우리의 "유효 윈도우 폭"도 마찬가지로 항상 **"BER=θ 기준 폭"**입니다.

θ의 높낮이는 거래입니다. θ를 높게(10⁻²) 그으면 교차점이 비탈 안쪽 = 폭이 좁게 정의되지만, 그 지점의 에러는 흔한 사건이라 많이 세어져서 판정이 정밀합니다. 낮게(10⁻⁴) 그으면 폭은 "거의 에러 없음"이라는 직관에 가깝게 넓지만, 만 비트에 하나 틀리는 희귀 사건을 세는 것이라 판정이 거칠어집니다. 그래서 우리는 대표값 하나를 채택하되 10⁻²/10⁻³/10⁻⁴ 세 높이의 폭을 전부 병행 기록합니다 — 노화가 비탈의 위치가 아니라 **기울기**를 바꾸는 경우까지 잡기 위해서입니다.

---

## 파라미터 사전

### Δφ — 위상 스텝 (기본 15 ps)

측정 타이밍을 옮기는 한 걸음의 크기, 즉 **우리 자(尺)의 눈금**입니다. 이 값은 우리가 자유롭게 고르는 게 아니라 하드웨어가 줍니다: MMCM의 미세 위상 시프트 한 칸 = VCO 주기 ÷ 56이라, VCO를 어떻게 설정하느냐에 따라 대략 10~18ps로 정해집니다. 눈금보다 가늘게는 어떤 수를 써도 잴 수 없습니다 — 이 사실이 아래 N 선택 규칙의 근거가 됩니다. (현재 15ps는 자리표시자이고 클럭 플랜 확정 시 실값으로 바뀝니다.)

### N — 위상당 읽기 횟수

같은 위상에 멈춘 채 **같은 패턴을 반복해서 읽는 횟수**입니다. 경계 근처의 에러는 확률적이라 한 번 읽어서는 "이번엔 운 좋게 통과"와 "진짜 안전"을 구분할 수 없습니다. 주사위가 찌그러졌는지 알려면 여러 번 던져야 하듯, N은 그 던지는 횟수입니다. N이 클수록 욕조 곡선이 매끈해지고 경계가 정밀해지지만, 스윕 시간이 정비례로 늘어납니다.

### B — 읽기 1회의 비트 수 (기본 2,048 = 256바이트)

읽기 한 번에 실려 오는 비트 수, 비유하면 **그물 한 번에 걸리는 그물코 수**입니다. 통계의 유효 표본은 N이 아니라 N×B라서, N=100이라도 실제로는 20만 번의 동전 던지기를 한 셈이 됩니다 — 비트 단위로 에러를 세는 방식이 강력한 이유입니다.

**주의: B는 실측이 아니라 설계 추론값입니다.** 실제 스윕 엔진의 버스트 길이가 확정되면 반드시 일치시켜야 하고, 바뀌면 FPGA 에러 카운터 폭(위상당 최대 에러 = N×B, 오버플로 시 곡선이 조용히 오염됨)과 N 권고값이 연쇄로 바뀝니다. 스크립트의 `!!` 경고 블록 참조.

### θ — 경계 문턱값 (채택 10⁻², 병행 기록 10⁻²/10⁻³/10⁻⁴)

위 절 참조. "여기서부터 윈도우 밖"이라고 선언하는 에러율 기준선이며, 윈도우 폭이라는 숫자는 θ 없이는 정의 자체가 안 됩니다.

**채택 근거 (2026-07-06 잠정, G0 실측 후 확정)**: 폭을 재는 목적이 변화 추적이므로, 좋은 θ의 기준은 노화 신호 ÷ 측정 노이즈(SNR)입니다. 노화가 비탈을 통째로 밀든(신호 전 θ 동일) 완만하게 만들든(낮은 θ의 신호가 1.7배 크지만 노이즈는 7배 큼), SNR은 10⁻²가 모든 시나리오에서 우세합니다. "에러 없음" 직관과의 거리는 병행 기록되는 10⁻⁴ 폭이 담당합니다.

다만 이 논리는 비탈이 가우시안이라는 모델 위에 서 있으므로, **최종 확정은 G0 루프백 실측 후**에 합니다. G0는 칩도 노화도 없는 계측기 특성 데이터라 이를 보고 확정해도 "결과 보고 유리한 정의 고르기"가 아닙니다 — 장비를 교정한 뒤 눈금을 확정하는 것과 같습니다. 확정 기준은 사전 선언되어 있습니다(스크립트 docstring의 체크리스트 4항: 비탈 log-선형성, BER floor < 10⁻⁵, 실측 σⱼ로 N 재확인, 버스트성 점검). 통과 시 10⁻²로 확정하고 이후 변경 금지.

### σⱼ — 경계 지터 (시뮬레이션 가정: 20~200 ps)

비탈이 얼마나 완만한가, 즉 **경계의 흐릿함**입니다. 해수욕장 비유를 이어가면, 물가선은 파도 때문에 매 순간 다른 곳에 있고 그 흔들림의 폭이 σⱼ입니다. 클럭과 데이터의 지터가 클수록 비탈이 완만해져 경계 찾기가 어려워집니다. 실값은 G0에서 측정되기 전까지 모르므로, 시뮬레이션은 그럴듯한 범위 전체를 훑어 결론이 σⱼ에 둔감함을 보입니다.

### trials, seed

가상 실험의 반복 횟수(1,000)와 난수 씨앗(42, 고정). 씨앗을 고정하는 이유는 보고서의 그림을 언제 누가 다시 돌려도 비트 단위로 똑같이 재생성되게 하기 위함입니다 — "생성물은 커밋하지 않고 스크립트로 재생성한다"는 리포 원칙의 전제 조건.

### σ_width — 최종 출력: 폭 추정의 표준편차

같은 칩을 같은 조건에서 무한히 반복 측정한다고 상상했을 때 폭 값이 흔들리는 정도. 몬테카를로가 내놓는 답이 바로 "σ_width가 N과 θ에 따라 어떻게 변하는가"의 곡선입니다.

---

## 파라미터들이 서로 묶이는 세 개의 매듭

1. **N 선택 규칙: σ_width ≤ Δφ/2** — 측정의 통계적 흔들림이 자 눈금의 절반보다 작으면 충분합니다. 그보다 정밀해 봐야 눈금에 묻히고, 그보다 거칠면 눈금이 아깝습니다. (잠정 규칙 — G0/G4 실측 후 재조정 가능)
2. **θ 신뢰 조건: N×B×θ ≥ ~20** — 어떤 θ의 교차점을 믿으려면 거기서 에러가 스무 개쯤은 세어져야 합니다. 따라서 **N의 하한은 채택 θ가 아니라 병행 기록하는 가장 낮은 θ(10⁻⁴)가 정합니다**: N×B ≥ 20만 → B=2,048이면 N ≥ 100. θ를 높여 N을 줄이고 싶은 유혹이 여기서 막힙니다.
3. **시간 예산: 스윕 1회 = 스텝 수 × (N × 읽기 시간)** — 스텝 수 = 클럭 한 주기(UI) ÷ Δφ라서, 클럭을 올리면 스텝 수가 줄고 읽기도 빨라져 시간이 제곱 꼴로 줄어듭니다 (25MHz 22.8초 → 100MHz 1.5초, N=100 기준). 스윕이 느리면 범인은 대개 N이 아니라 클럭입니다.
