young-0320/flash-margin-bench/docs/results/reports/최종발표_질의응답부록.md

# 최종 발표 질의응답 부록 (2026-11-06)

- **작성일**: 2026-11-04 · **슬라이드**: [`최종발표_초안6.pptx`](최종발표_초안6.pptx) · **대본**: [`최종발표대본.md`](최종발표대본.md)
- **쓰는 법**: [§0 핵심 수치](#s0) → [§1 예상 질문](#s1) → 답 오른쪽 `표` 칸의 링크로 뒤의 데이터로 간다. ★ 는 곤란한 질문이고, 답을 먼저 외워 둔다
- **모델 버전**: 별말이 없으면 v4.3 7장 판(교정 9칩). chip06 판정만 v2, 기준선 비교만 v3.2 다
- **값의 정의**: 소거 · 프로그램 표의 한 칸은 그 사이클에서 끝나는 1k 구간의 섹터 0-6 p50 중앙값이다. 슬라이드 7 · 8 · 12쪽과 같다. 체크포인트 표(`wear_checkpoint_table_2026-10.md`)는 직전 구간 전체의 p50 이라 조금 다르다
- **재현**: [§7](#s7) 의 표 대부분은 `uv run python host/analysis/deck_tables.py` 산출이다. 다른 표의 출처는 표 아래에 적었다

## 찾아보기

| 찾는 것 | 위치 | 찾는 것 | 위치 |
|---|---|---|---|
| 핵심 수치 한 장 | [§0](#s0) | 블라인드 3칩 | [§5](#s5) |
| 예상 질문 | [§1](#s1) | 고온 칩 · chip06 대 chip26 | [§6](#s6) |
| 모델 수식 · 값 · 계산 예 | [§2](#s2) | 칩 명부 · 신품값 · 날짜 코드 | [D1](#d1) |
| 모델 버전 · 버린 것 | [§3](#s3) | 소거 시간 체크포인트별 | [D2](#d2) |
| 교차검증 · 합성 · 학습 곡선 · 기준선 | [§4](#s4) | 프로그램 시간 체크포인트별 | [D3](#d3) |
| 먼저 적었다는 증거(커밋 시각) | [§3.3](#s33) | 칩 간 · 섹터 간 산포 · 칩 속도 | [D4](#d4) |
| 계단 시점 · 높이 | [D5](#d5) | 마진 폭 변화 | [D6](#d6) |
| 안 쓴 섹터 · 근접 섹터 | [D7](#d7) | 마모 소요 시간 · 사고 기록 | [D8](#d8) |
| 측정 조건 · 데이터시트 | [D9](#d9) | 선행 연구 비교 | [D10](#d10) |

## §0. 핵심 수치 한 장

| 항목 | 값 | 표 |
|---|---|---|
| 대상 칩 | Winbond W25Q64FV, 64Mbit SPI NOR, 4KB 섹터 · 정격 10만 회 · -40 to 85°C | [D9](#d9) |
| 데이터시트 | 섹터 소거 typ 45ms(IQ · IF) · 60ms(IG), max 400ms · 페이지 프로그램 typ 0.7ms, max 3ms | [D9](#d9) |
| 신품 측정 | 31칩 (FV 19 · JV 12) · 측정 불가 3칩(chip05 · 11 · 13) | [D1](#d1) |
| 신품 소거 | FV 빠른 24.9-33.7ms · 느린 47.0-51.1ms · 경계 40ms | [D1](#d1) |
| 마모 칩 | 19칩 · 30만 회 1칩(chip01) · 20만 회 7칩(02 · 03 · 06 · 07 · 09 · 15 · 21) | [D1](#d1) |
| 마모 조건 | 섹터 0-6(7섹터 · 112페이지) · 0x00 프로그램 후 소거 반복 | [D9](#d9) |
| 소요 시간 | 10만 회 약 16-27시간 · 20만 회 약 39-56시간 · 30만 회 약 81시간 | [D8](#d8) |
| 마진 측정 | 25MHz · 위상 스텝 15.873ps · 위상당 112회 · 2,520스텝 | [D9](#d9) |
| 마진 판정 | 재장착 σ 13.86ps · 기준 3σ = 42ps · chip01 30만 회 +15.5ps | [D6](#d6) |
| 소거 증가 (상온) | 10만 회: 빠른 2.60-3.97배 · 느린 1.59-1.75배 · 30만 회 chip01 5.2배(28.7 → 148.1ms) | [D2](#d2) |
| 계단 | 빠른 FV 상온 6칩 모두 · 높이 약 18-23ms · 느린 칩 없음 | [D5](#d5) |
| 프로그램 (상온 100k) | 빠른 1.00-2.09배 · 느린 1.21-2.15배 (칩마다 다름) | [D3](#d3) |
| 안 쓴 섹터 (상온 FV) | 10만 회 뒤 기준 섹터 32-127 이 신품의 0.98-1.00배 · 근접 7-13 은 1.06-1.15배 | [D7](#d7) |
| 칩 속도 차 | 빠른 무리 r̂ 0.608-2.092 (최대 약 3.4배) · 느린 무리 0.798-1.187 (약 1.5배) | [D4](#d4) |
| 모델 | 소거 시간 배율 + 교정 곡선 + 평평한 사전의 베이즈 역추정 · 답 범위 1-100,000회 | [§2](#s2) |
| 교차검증 | 106점 · 95% 구간 94.5% (띠 91.5-99.1%, 합격) · 68% 구간 81.7% (띠 59.4-76.4%, 과소신) | [§4](#s4) |
| 블라인드 | chip06 12,000회 68% 안(49백분위) · chip26 70,000회 68% 안 · chip23 26,528회 3.5배 과대(불합격) | [§5](#s5) |
| chip26 오차 | 대표값 60,500 · 정답 대비 -9,500회 · -13.6% · 0.86배 | [§5](#s5) |
| 고온 | 네 칩 48점: 95% 47/48 · 68% 22/48 · 일관된 온도 방향 없음 | [§6](#s6) |

## §1. 예상 질문

### A. 문제 설정 · 선행 연구

| # | 질문 | 답 | 표 |
|---|---|---|---|
| A1 | 왜 NOR 인가 | 부트 코드와 펌웨어가 들어 있어 고장 나면 시스템 전체가 부팅되지 않는데, 가장 가까운 선행 연구들의 대상은 NAND 였습니다. | [D10](#d10) |
| A2 | ★ NOR 연구가 부족하다는 근거는 | 편수를 센 통계는 아닙니다. Sakib · Guo 의 대상이 NAND 이고, Guo 는 NOR 를 향후 과제로 적었습니다. LIU 는 칩 수준 열화 연구가 적다고 썼습니다. NOR 연구가 없다는 뜻은 아닙니다. | [D10](#d10) |
| A3 | 선행 연구와 무엇이 다른가 | Sakib 은 데이터시트 기준 이진 판별, Guo 는 신품 등록이 필요한 점 추정입니다. 저희는 등록 없이 칩 안의 안 쓴 섹터로 구간을 답하고 처음 보는 칩으로 검증했습니다. | [D10](#d10) |
| A4 | ★ 세계 최초인가 | 그렇게 주장하지 않습니다. 사용량 추정은 Guo 2017 이 NAND 에서 먼저 했고, NOR 쪽 전방 인용 조사도 끝내지 않았습니다. | [D10](#d10) |
| A5 | SSD 처럼 내부 정보를 읽으면 되지 않나 | SSD 는 SMART 로 보고하지만, 기판에 바로 붙는 SPI NOR 에는 그런 경로가 없어 바깥에서 재야 합니다. | |
| A6 | 소거 시간이 늘어나는 건 이미 아는 사실 아닌가 | 맞습니다. 신호 자체는 저희 발견이 아닙니다. 저희가 더한 것은 개체 차를 지우는 기준, 횟수 구간 추정, 블라인드 검증입니다. | [D10](#d10) |

### B. 마진 측정

| # | 질문 | 답 | 표 |
|---|---|---|---|
| B1 | 마진이 왜 안 줄었나 | 원인은 가설입니다. 창을 정하는 것은 클럭에 맞춰 도는 출력 회로이고, 셀이 느려져도 25MHz 40ns 주기 안에서 출력까지 닿지 않는 것으로 봅니다. | [D6](#d6) |
| B2 | 그럼 계측기는 헛수고 아닌가 | 안 변한다고 말하려면 정밀한 자가 필요합니다. 13.86ps 자가 있어서 답이 마진이 아니라 소거 시간이라고 말할 수 있었고, 590ps 배선 사건도 찾았습니다. | [D6](#d6) |
| B3 | 42ps 는 어떻게 정했나 | 같은 칩을 다시 꽂은 흔들림 σ 13.86ps(chip10 3회)의 3배입니다. | [D6](#d6) |
| B4 | ★ 42ps 를 벗어난 칩은 없었나 | 있습니다. chip06 -55ps · chip02 +128ps 는 재장착 단차, chip07 은 초기 -59ps 와 배선 사건 +590ps 입니다. 단차 뒤 다시 움직이지 않아 장착 쪽으로 읽었고, chip07 은 사후 처리로 표시했습니다. | [D6](#d6) |
| B5 | 고주파에서는 줄지 않나 | chip01 75MHz 300k 는 신품 대비 +2.6ps 지만 신품값이 다른 보드라 비교가 약합니다. 25MHz 만큼 강하게 말하지 않습니다. | [D6](#d6) |
| B6 | 위상당 112회는 왜인가 | 몬테카를로로 N 을 먼저 정했고, 112페이지가 마모 영역 7섹터와 정확히 겹치게 맞췄습니다. | [D9](#d9) |
| B7 | θ = 10⁻² 는 왜인가 | 몬테카를로로 먼저 정했고, θ 를 10⁻⁴ 까지 조여도 폭 차이가 27ps(0.07%)입니다. | [D9](#d9) |
| B8 | 슬라이드의 "욕조곡선 바닥 미확인"은 무슨 뜻인가 | 위상 분해능과 지터 안에서는 BER 바닥 근처를 나누지 못했다는 뜻입니다. 위상당 약 22.9만 비트라 BER 약 4×10⁻⁶ 아래는 원리상 보이지 않습니다(계산값). | [D9](#d9) |

### C. 마모 실험

| # | 질문 | 답 | 표 |
|---|---|---|---|
| C1 | 얼마나 걸렸나 | 10만 회 약 하루(16-27시간), 20만 회 약 이틀(39-56시간), 30만 회 3일 이상(약 81시간)입니다. | [D8](#d8) |
| C2 | 정격을 넘겼는데 칩이 죽지 않았나 | chip01 은 30만 회까지 체크포인트 12점 검사가 모두 PASS 였습니다. 그래서 PASS 만으로는 사용량을 알 수 없습니다. | [D2](#d2) |
| C3 | 왜 섹터 0-6 인가 | 7섹터 = 112페이지로 읽기 창과 마모 영역을 겹치기 위해서입니다. 같은 칩의 32-127 은 안 지워서 기준으로 남습니다. | [D7](#d7) |
| C4 | 소거 시간이 데이터시트를 넘었나 | 넘지 않았습니다. 30만 회 p50 148ms 로 max 400ms 안입니다. 스펙 안에서 쓴 횟수를 읽는 것이 요점입니다. | [D9](#d9) |
| C5 | 프로그램 7ms 는 데이터시트 3ms 를 넘은 것 아닌가 | 아닙니다. 기록값은 한 섹터 16페이지의 합입니다. 페이지당 약 0.43ms 입니다. | [D9](#d9) |
| C6 | 쉬면 회복되지 않나 | 12-19일 쉰 칩도 소거 시간이 이어졌습니다. chip03 88.9 → 88.8ms · chip15 86.4 → 85.8ms 로 회복이 보이지 않았습니다. | [D8](#d8) |
| C7 | 실험 중 사고는 없었나 | 있었습니다. USB 끊김 · 접촉 불량 · PC 전원 상실입니다. 칩 내부 카운터(tally)로 횟수를 대조해 이어 갔고, 결측은 표에 그대로 남겼습니다. | [D8](#d8) |
| C8 | 검증은 어떻게 했나 | 실칩 전에 cocotb 테스트벤치로 시퀀스를 검증했고, 테스트는 구현자와 다른 사람이 썼습니다. 칩 없는 루프백으로 측정계도 먼저 확인했습니다. | |

### D. 소거 · 프로그램 결과

| # | 질문 | 답 | 표 |
|---|---|---|---|
| D-1 | 소거 시간은 왜 느나 | 산화막에 전하가 갇혀 지우기와 교정에 일이 더 듭니다. LIU 2019 의 4단계(사전 프로그램 · 일괄 소거 · 과소거 교정 · 비선택 섹터 복구)가 모두 늘어나는 구조입니다. | [D10](#d10) |
| D-2 | 계단은 왜 생기나 | 가설입니다. 지우고 확인하기의 반복 단계가 하나 늘 때 시간이 한 칸 뛴다고 봅니다. 높이가 칩과 무관하게 약 18-23ms 로 일정한 것이 근거입니다. | [D5](#d5) |
| D-3 | 왜 21ms 나 되나 | 모릅니다. NAND 펄스 약 1ms(Sakib)보다 커서 펄스 하나가 아니라 교정 · 복구 같은 더 큰 단위로 추정합니다. | [D5](#d5) |
| D-4 | 느린 칩은 왜 완만한가 | 가설입니다. 같은 85-93ms 를 지나지만 사이클마다 요구 횟수가 흔들려 비율이 천천히 바뀐다고 봅니다. 분포 폭이 약 2배인 것이 근거입니다. | [D4](#d4) |
| D-5 | ★ 왜 두 무리로 갈리나 | 원인을 모릅니다. 처음 10칩은 날짜 코드로 갈렸지만 FV 19칩에서는 겹칩니다. 내부 설정 차이를 가설로 두고, 확인하려면 제조사 자료가 필요합니다. | [D1](#d1) |
| D-6 | 40ms 경계는 왜인가 | FV 신품값 사이의 빈 구간(33.7-47.0ms)입니다. 칩을 더 재도 이 구간에 든 FV 칩은 없습니다. | [D1](#d1) |
| D-7 | 프로그램 시간은 왜 안 쓰나 | 칩마다 너무 다릅니다. 100k 에서 chip09 1.01배, chip02 2.09배입니다. 모델 축으로 시험한 v4.2 는 구간이 과신해 버렸습니다. | [D3](#d3) |
| D-8 | 5.2배는 어떻게 나온 값인가 | chip01 신품 28.7ms 와 마지막 구간(294.5-300k) p50 148.1ms 의 비입니다. 100k 에서는 약 4배입니다. | [D2](#d2) |

### E. 모델

| # | 질문 | 답 | 표 |
|---|---|---|---|
| E1 | 원리를 한 줄로 | 안 닳은 섹터로 나눈 배율을, 칩들을 실제로 닳게 해 만든 곡선에 거꾸로 대어 횟수별 확률을 냅니다. | [§2](#s2) |
| E2 | 왜 베이즈인가 | 칩마다 늙는 속도가 달라 같은 배율이 여러 횟수에 대응합니다. 그래서 숫자 하나보다 확률 분포가 맞습니다. | [§2](#s2) |
| E3 | 사전 확률은 무엇인가 | 1-100,000회를 1k 구간으로 나눈 평평한 사전입니다. 로그 균등 사전도 시험했지만 68% 가 56% 로 떨어져 버렸습니다. | [§3.2](#s32) |
| E4 | 입력은 무엇인가, raw 데이터가 필요한가 | prep 로그의 섹터별 소거 시간뿐입니다. 스윕과 `_reads` 는 쓰지 않습니다. 계산에는 칩이 필요 없습니다. | [§2](#s2) |
| E5 | 기준 섹터를 왜 32-127 로 잡았나 | 닳은 섹터 근처 128KB 안은 함께 느려집니다(1.06-1.25배). 32-127 은 0.98-1.00배입니다. | [D7](#d7) |
| E6 | ★ 68% 구간이 81.7% 인 건 잘된 것 아닌가 | 아닙니다. 합격 띠 위라 구간이 필요 이상 넓다는 뜻(과소신)입니다. 안전한 쪽 오차로 기록하고 그대로 등록했습니다. | [§4](#s4) |
| E7 | 교정 칩 9개로 충분한가 | 빠른 무리는 3개에서 포화됐습니다. 느린 무리는 3칩뿐이라 판정하지 못했습니다. 남는 오차 약 1.4배는 칩 속도 차입니다. | [§4](#s4) |
| E8 | ★ 교정 칩을 늘리면 좋아지지 않나 | 빠른 무리는 3개 이후 거의 안 좋아졌습니다. 칩마다 늙는 속도가 달라 생기는 몫이라 칩 수로는 안 줄어듭니다. | [§4](#s4) |
| E9 | 많이 쓴 칩은 잘 맞나 | 낮게 읽습니다. 정답 10만 회를 약 0.7배로 읽습니다. 다만 50-100k 의 95% 구간 포함은 99.3% 라 범위로 답합니다. | [§4](#s4) |
| E10 | 10만 회 넘는 칩은 | 답 범위가 10만 회까지입니다. 지지를 20만 회로 넓히면 과대 1.24배에 폭이 2배가 돼 버렸습니다. 소거 시간은 100k 너머를 구분하지 못합니다. | [§3.2](#s32) |
| E11 | ★ 모델을 여러 번 바꿨는데 끼워 맞추기 아닌가 | 판정은 판정 전에 고정한 버전으로만 했습니다(chip06 v2, chip26 v4.3). 버전마다 이유와 성능을 기록했고, 좋아 보여도 버린 설정이 있습니다. | [§3](#s3) |
| E12 | 단순 회귀로 충분하지 않나 | 오차 중앙값이 회귀 10,000, 모델(v3.2) 7,500 입니다. 느린 무리는 회귀가 낫습니다. 차이의 본체는 구간을 준다는 점입니다. | [§4](#s4) |
| E13 | 기준선은 94점인데 교차검증은 왜 106점인가 | 기준선 비교는 10/07 교정 8칩이고, 교차검증은 chip06 을 더한 9칩입니다. | [§4](#s4) |
| E14 | 칩 없이 다른 PC 에서 돌아가나 | 돌아갑니다. 로그 · 교정 표 · 코드 · numpy 만 있으면 됩니다. 측정만 보드가 필요합니다. | [§2](#s2) |

### F. 블라인드

| # | 질문 | 답 | 표 |
|---|---|---|---|
| F1 | ★ 다른 블라인드 칩은 없었나 (chip23) | 있습니다. 같은 날 판정한 chip23 은 정답 26,528회를 약 92,500회로 3.5배 높게 읽어 불합격입니다. 같은 사이클의 배율이 상온 chip12 · 21 과 같아 원인을 칩 종류로 봅니다. 이 형은 10/19 에 한계로 적었습니다. | [§5](#s5) |
| F2 | ★ chip26 은 왜 블라인드라 부르나 | 엄밀한 봉인 블라인드가 아니라 모델 고정 판정입니다. 모델을 10/23 에 고정했고 마모는 10/26 에 시작해, 추정이 정답에 끌릴 길이 없습니다. | [§5](#s5) |
| F3 | chip26 오차는 | 대표값 60,500회, 정답 70,000회, -9,500회(-13.6%)입니다. 칩 하나의 결과이고 68% 구간은 3.1만-8.5만 회입니다. | [§5](#s5) |
| F4 | chip06 기준 ③ 은 왜 불통과인가 | 68% 폭 16,000 이 기준 10,000 을 넘었습니다. 기준은 무리당 교정 칩이 둘이던 때 정한 값이고, 고치지 않고 불통과로 적었습니다. | [§5](#s5) |
| F5 | ★ chip06 의 R 을 결과를 보고 고쳤나 | R 3.8 추정을 본 뒤 2.0 으로 고친 것은 맞습니다. 정답을 읽기 전이고, 이유는 칩 산포를 두 번 세는 결함입니다. 버린 추정도 파일로 남겼고 정답을 68% 안에 품었습니다. | [§5](#s5) |
| F6 | chip06 점 추정은 왜 7-8천인가 | MAP 은 정답의 0.6배로 낮았습니다. 분포가 오른쪽으로 길어서입니다. v4.3 은 사후 평균으로 바꿨습니다. | [§3.2](#s32) |
| F7 | 3인 팀인데 블라인드가 되나 | 완전하지 않습니다. 정답은 칩 내부 기록(tally 120/120 바이트)으로 봉인했고 종이 기록과 일치했습니다. | [§5](#s5) |
| F8 | 먼저 적었다는 증거는 | git 커밋 시각입니다. chip06 추정 커밋 18:08, 개봉 19:55 입니다. | [§3.3](#s33) |
| F9 | 블라인드가 더 남았나 | chip08(느린 · 상온)이 남았고 등록한 v4.3 7장 판으로 엽니다. | [§5](#s5) |
| F10 | 시연 칩은 답을 아는 칩 아닌가 | 맞습니다. 시연은 블라인드가 아니라 시스템이 실제로 돈다는 것을 보여 드리는 것입니다. | [§5](#s5) |

### G. 고온

| # | 질문 | 답 | 표 |
|---|---|---|---|
| G1 | 고온과 상온이 같다는 말인가 | 아닙니다. 개체 차와 구별되지 않았다는 뜻입니다. 표본이 적어 같다고 단정하지 않고, 68% 적중은 상온 약 80% 에서 46% 로 떨어집니다. | [§6](#s6) |
| G2 | ★ chip06 과 chip26 만 보면 프로그램이 다르지 않나 | 다릅니다만 온도 효과로 볼 수 없습니다. 70k 에서 상온 chip06 은 1.21배, 85°C chip26 은 1.01배로 오히려 상온 칩이 올랐습니다. 상온 6칩도 넷은 평평하고 둘은 오릅니다. | [§6](#s6) |
| G3 | 유의미한지 검정했나 | 칩 한 개로는 검정이 되지 않습니다. 상온 6칩과 비교한 순위 검정도 p 가 약 0.29 아래로 내려갈 수 없습니다. 섹터 7개를 표본처럼 세면 잘못입니다. | [§6](#s6) |
| G4 | 고온에서 측정한 것인가 | 마모를 고온에서 했습니다. 블라인드 판정 측정은 상온에서 했습니다. 고온 동작 중 판정은 시험하지 않았습니다. | [§6](#s6) |
| G5 | 칩 온도는 정확한가 | 센서 자리 값이고 칩 내부 온도는 재지 못했습니다. chip24 는 초반 30k 에 81-84°C, chip26 은 처음 30k 에 약 79-83°C 였습니다. | [§6](#s6) |
| G6 | 모델에 온도를 왜 안 넣었나 | 일관된 방향이 없어 넣을 근거가 없습니다. 고온 이력 칩에는 넓은 범위로 답합니다. | [§6](#s6) |
| G7 | 유지(retention)나 전압은 봤나 | 보지 않았습니다. 온도 축도 마모 이력까지입니다. | |

### H. 활용 · 한계

| # | 질문 | 답 | 표 |
|---|---|---|---|
| H1 | ★ 실제 중고 칩에 해 봤나 | 못 했습니다. 닳은 섹터 위치를 아는 칩으로만 검증했습니다. | |
| H2 | 현장 칩에도 안 쓴 섹터가 있나 | 펌웨어 영역처럼 거의 지우지 않는 섹터가 그 역할을 할 것으로 봅니다. 저희가 확인한 것은 안 쓴 섹터가 0.98-1.00배라는 데까지입니다. | [D7](#d7) |
| H3 | ★ 펌웨어 섹터를 재면 펌웨어가 지워지지 않나 | 지워집니다. 소거 시간을 재려면 실제로 지워야 합니다. 백업 후 재고 복원해야 하고, 그 절차는 아직 만들지 않았습니다. | |
| H4 | 안 쓴 섹터가 닳은 섹터 옆이면 | 같은 128KB 안 근처는 함께 느려집니다. 떨어진 섹터를 골라야 합니다. | [D7](#d7) |
| H5 | 어느 섹터가 닳았는지 어떻게 아나 | 지금 검증은 위치를 아는 칩으로 했습니다. 위치를 찾는 절차는 검증하지 않았습니다. | |
| H6 | ★ 칩 전체를 고르게 쓴 경우는 | 약합니다. 웨어 레벨링으로 고르게 닳으면 기준으로 쓸 섹터가 없습니다. 이 경우는 신품 때 등록하는 방식이 낫습니다. | [D10](#d10) |
| H7 | 진단이 칩을 닳게 하나 | 섹터 0-127 에 P/E 가 1회 늘어납니다(정격의 0.001%). 사실상 마모는 없지만 내용은 지워지므로 비파괴는 아닙니다. | |
| H8 | 다른 품번에도 되나 | 안 됩니다. FV 모델은 JV 두 칩을 약 0.6배로 낮게 읽습니다. 곡선을 따로 만들어야 합니다. | [D2](#d2) |
| H9 | 느린 칩은 왜 틀리나 | 느린 신품 7칩 중 3칩(chip12 · 21 · 23)이 빠르게 늙는 다른 형인데, 신품 측정 한 번으로는 구별되지 않습니다. | [D2](#d2) |
| H10 | 진단 시간 · 비용은 | 11/1 chip26 측정은 1분 53초, 계산은 수 초입니다. 비용은 슬라이드의 약 20만 원입니다. | [D9](#d9) |
| H11 | 표본이 충분한가 | 한 품번에 마모 19칩입니다. 무리 안 산포를 재기에는 빠른 무리가 낫고, 느린 무리와 고온은 적어서 경향만 말합니다. | [D1](#d1) |
| H12 | NAND 로 넓히면 | SPI NAND 는 내부 버퍼를 거쳐 출력해 지표가 다릅니다. tR · raw BER 같은 지표로 다시 교정해야 합니다. 계획 단계입니다. | |

## §2. 모델 상세 (v4.3)

### 2.1 말로 설명하면

| 단계 | 하는 일 | 왜 |
|---|---|---|
| 1. 기준 잡기 | 섹터 32-127 소거 중앙값 A 를 잰다 | 그 칩의 신품값 대신 쓴다 |
| 2. 무리 판정 | A 가 40ms 미만이면 빠른 무리, 이상이면 느린 무리 | 곡선 모양이 달라 같은 무리 곡선만 쓴다 |
| 3. 배율 계산 | 닳은 섹터 소거 시간 ÷ A | 칩마다 다른 출발점을 지운다 |
| 4. 곡선과 대조 | 곡선의 각 지점에서 지금 배율이 나올 확률을 낸다 | 교정 칩을 실제로 닳게 하며 잰 분포다 |
| 5. 칩 속도 반영 | 이 칩이 r 배 빠르면 x 회에 곡선의 x·r 지점처럼 보인다고 두고 r 전체를 평균한다 | 같은 무리에서도 늙는 속도가 다르다 |
| 6. 분포 출력 | 1k 구간별 확률 → 사후 평균 · 68% · 95% 구간 · 등급 | 숫자 하나로 답하면 틀리기 때문이다 |

### 2.2 계산 순서 (교수님께 말로 설명)

**30초 답변**

> "먼저 안 닳은 섹터로 칩의 기준값을 잡아 무리를 나눕니다. 닳은 섹터 7개의 소거 시간을 기준값으로 나눠 배율을 만들고, 같은 무리 교정 곡선의 1k 지점마다 이 배율이 나올 가능성, 즉 우도를 계산합니다. 관측 7개가 완전히 독립은 아니어서 상관을 재서 정보량을 약 3.1개로 보정합니다. 칩마다 늙는 속도가 다르므로 가능한 속도 범위에 걸쳐 우도를 평균합니다. 사전 확률은 1-100k 에 평평하게 두어서, 이 값을 합이 1 이 되게 나누면 횟수별 확률이 되고, 거기서 사후 평균과 95% 구간을 냅니다."

**단계별 설명 (chip26 값)**

1. **기준값을 잡는다.** 안 쓴 섹터 32-127 의 소거 시간 중앙값 A 를 구한다. 그 칩의 신품값 대신이다. → 25.3ms
2. **무리를 나눈다.** A 가 40ms 미만이면 빠른 무리, 이상이면 느린 무리다. 이후에는 같은 무리 칩의 곡선만 쓴다. → 빠른 무리, 교정 6칩
3. **배율을 만든다.** 닳은 섹터 0-6 의 소거 시간을 각각 A 로 나눈다. 칩마다 다른 출발점이 지워진다. → 배율 7개, 중앙값 2.66배
4. **교정 곡선을 준비한다.** 교정 칩을 실제로 닳게 하며 잰 값으로, 1k 구간마다 배율이 어떻게 분포하는지 표를 만든다. 칩마다 늙는 속도가 다르므로 먼저 가로축을 맞춰 겹쳐 둔다.
5. **우도를 계산한다.** 곡선의 1k 지점마다 "이 지점의 칩이라면 지금 배율 7개가 나올 가능성"을 구한다. 배율 하나마다 칩 · 섹터별 분포에서 밀도를 읽어 평균하고, 7개 값은 로그로 평균한다.
6. **정보량을 보정한다.** 7개 섹터는 같은 칩이라 7개의 독립 증거가 아니다. 잰 상관(ρ)으로 유효 관측 수 n_eff 를 구해 우도에 반영한다. → 7개가 아니라 3.10개
7. **칩 속도를 반영한다.** 이 칩의 속도를 모르므로, 사용 횟수 후보 x 마다 곡선의 x/R 에서 x·R 까지 우도를 로그 눈금으로 고르게 평균한다. R 은 교정 칩의 속도 흩어짐에서 계산한다. → R 2.80
8. **확률로 바꾼다.** 사전 확률이 1-100k 에 평평하므로 7번 값의 합이 1 이 되게 나누면 1k 구간별 사후 확률이 된다.
9. **답을 낸다.** 사후 평균이 대표값이고, 확률이 큰 구간부터 모아 68% · 95% 구간을 만든다. 정격 대비 등급은 확률이 가장 큰 등급이다. → 60,001-61,000회, 95% 25,001-100,000회, 고마모

**수식 (참고)**

```text
입력    A = median(소거시간[섹터 32-127])
        y_i = 소거시간[섹터 i] / A                (i = 0-6, prep 여러 번이면 7·P 개)
무리    A < 40ms → 빠른 · 그 밖 → 느린

교정    구성원 m = (같은 무리 칩 j, 섹터 s) 의 공통 시계 지점 M 의 셀
        칩 속도 r̂_j 로 정렬: M 에는 칩 j 의 M / r̂_j 구간 셀을 넣는다
        셀 밀도 f_m(y): 분위수 21개(5% 간격) 사이를 조각마다 5% 균일 밀도로 둔다

곡선 우도
        log L(M) = n_eff · (1/N) · Σ_i log( mean_m f_m(y_i) )

유효 관측 수
        n_eff = 1 / ( ρ_chip + (1 - ρ_chip) · ( ρ_s/P + ρ_p/k + (1 - ρ_s - ρ_p)/(k·P) ) )
        k = 섹터 수(7) · P = prep 횟수

칩 속도 적분
        P(x | y) ∝ ∫[1/R, R] L(x·r) d(ln r) · 사전 p(x)
        사전 p(x) = x 는 1-100,000 의 1k 구간에 균등

속도 범위
        R = exp( 1.96 · σ_r · sqrt(1 + 1/M) )     (σ_r = 교정 칩 ln r̂_j 의 표준편차 · M = 교정 칩 수)

출력    대표값 = 사후 평균이 든 1k 구간
        68% · 95% 구간 = 확률 큰 1k 구간부터 모은 HPD
        등급 = 정격 대비 1% · 20% · 60% · 100% 까지 신품 · 저마모 · 중마모 · 고마모 중 확률 최대
```

### 2.3 값

| 기호 | 뜻 | 값 | 출처 |
|---|---|---|---|
| 교정 칩 | 빠른 6 · 느린 3 | chip01 · 02 · 04 · 06 · 09 · 18 / chip03 · 07 · 15 | S-5 §2 |
| 100k 너머 곡선 | 7장 | chip01 300k · chip02 · 03 · 06 · 07 · 09 · 15 200k | S-5 §2 |
| R | 칩 속도 범위 | 빠른 2.80 (σ_r 0.486 · M 6) · 느린 1.59 (σ_r 0.204 · M 3) | `--rate-rule` |
| ρ_s | 같은 prep 안 섹터 간 상관 | 0.00 | `RHO` |
| ρ_p | 같은 섹터의 prep 간 상관 | 0.78 | `RHO` |
| ρ_chip | 칩 효과(반복해도 안 주는 몫) | 0.21 | `RHO` |
| n_eff | prep 1회 · 7섹터 | 3.10 | 계산 |
| 곡선 범위 | 곡선 지점 M | 교정이 있는 데까지 (chip01 300k) | S-5 §4 |
| 답 범위 | x | 1-100,000 | S-5 §4 |
| 소거 관측 | 쓰는 값 / 쓰지 않는 값 | prep 소거 시간 / 폭 · BER · 프로그램 · 집계표 신품값 | S-5 §3 |

### 2.4 계산 예: chip26

| 단계 | 값 |
|---|---|
| 기준 A (섹터 32-127) | 25.3ms → 빠른 무리 |
| 닳은 섹터 7개 | 67.1 · 68.6 · 67.5 · 70.7 · 62.5 · 61.2 · 64.7ms |
| 관측 배율 | 2.66배 |
| 교정 곡선 | 빠른 6칩 · R 2.80 · n_eff 3.10 |
| 2.66배가 지나는 자리 | 상온 빠른 칩들이 약 50-80k 에서 지남 |
| 대표값 (사후 평균) | 60,001-61,000회 |
| 68% · 95% 구간 | 31,001-85,000회 · 25,001-100,000회 |
| 등급 | 고마모 · 확률 51% |
| 정답 | 70,000회 → 68% 구간 안, 61번째 백분위 |

### 2.5 실행

| 목적 | 명령 | 칩 |
|---|---|---|
| 측정 | `uv run python host/run/run_sweep_chip.py --mode newchip --mhz 25` | 필요 |
| 추정 | `uv run python host/analysis/wear_inverse.py <prep 로그>` | 불필요 |
| 교차검증 | `uv run python host/analysis/wear_inverse.py --loco` | 불필요 |
| 칩 속도 · R | `uv run python host/analysis/wear_inverse.py --rate-rule` | 불필요 |

## §3. 모델 버전 · 버린 것 · 증거

### 3.1 버전 이력

| 버전 | 등록일 | 교정 칩 | 바뀐 것 | 어디에 썼나 |
|---|---|---|---|---|
| v1 | 2026-09-30 | 4칩 | 첫 모델 · R 2.0 · MAP | chip06 참고 추정 |
| v2 | 2026-10-01 | 5칩 | chip09 추가 | **chip06 판정** |
| v3 · v3.1 · v3.2 | 2026-10-05 | 7칩 | 사후 중앙값 · 무리별 R · 격자 없는 적분 | 기준선 비교(8칩 · 94점) |
| v4 | 2026-10-09 | 8칩 | 분위수 셀 · 정렬 · ρ · R 유도 · 합격 띠 먼저 | - |
| v4.1 | 미등록 | 9칩 | chip06 추가 | v4.3 이 대신함 |
| v4.3 | 2026-10-23 | 9칩 | 200k 곡선 · 대표값 사후 평균 | **교차검증 · chip26 · chip23 판정** |

출처: `docs/spec/s5.lifetime_inverse_model.md` §2

### 3.2 버린 것

| 버린 것 | 왜 | 근거 |
|---|---|---|
| 가설 「닳으면 마진이 좁아진다」 | 30만 회까지 기준 안 | [D6](#d6) |
| H2′ 「프로그램은 정격 안에서 불변」 | 느린 칩에서 깨짐 | [D3](#d3) |
| R 3.8 | 곡선 혼합과 r 이 칩 산포를 두 번 셈 | 로그 48 [D48-60] |
| Δx (추가 마모로 구간 좁히기) | 20k 아래만 좋아지고 50k 넘는 점에서 틀린 쪽으로 좁힘 | 로그 48 [D48-93] |
| 입력 C (프로그램 교차 확인) | 정상 칩에 경고가 울림 | S-1 §15 |
| v4.2 프로그램 축 | 좁아지지만 과신 (합성 95% 가 84%) | 로그 52 [D52-9] |
| 지지 200k | 과대 1.24배 · 68% 폭 2배 이상 | `inverse_v4_3_eval_2026-10.md` §3.3 |
| 대표값 MAP · 중앙값 | 배율 오차 평균 MAP 0.471 · 중앙값 0.329 · 사후 평균 0.310 | `inverse_v4_3_ceiling_2026-10.md` §2 |
| 로그 균등 사전 | 68% 56.3% 로 과신 | 같은 표 |
| 온도 축 | 일관된 방향 없음 | [§6](#s6) |

### 3.3 먼저 적었다는 증거

| 시각 (KST) | 사건 | 근거 |
|---|---|---|
| 9/23 00:39 | chip01 파일럿 마모 시작 | 세션 `1790091548` |
| 9/24 09:56 | H1 · H2 사전 가설이 S-1 에 커밋 | `45a51ec` |
| 9/26 16:31 | 종단 3칩 사전 등록 커밋 | `0b1abe2` |
| 9/26 16:43 | chip03 종단 마모 시작 (등록 12분 뒤) | 세션 `1790408609` |
| 10/1 18:08:35 | chip06 v2 추정 커밋 | `04bab2a` |
| 10/1 19:55 | chip06 tally 개봉 (커밋 1시간 47분 뒤) | [§5](#s5) |
| 10/4 10:42 | chip15 교정 편입 결정 커밋 | `2afa1ba` |
| 10/4 10:45 | chip15 마모 시작 (커밋 3분 뒤) | 세션 `1791078343` |
| 10/5 16:36 | 기준선 비교 방법 커밋 (결과 전) | `7ce25fc` |
| 10/23 21:34 | v4.3 등록 | `7c55df6` |
| 10/26 15:39 | chip26 마모 시작 (등록 뒤) | 세션 `1792996750` |
| 11/1 23:28 | chip26 · chip23 추정 (코드 `18e06ad`) | 추정 파일 머리말 |

★ **H1 은 시점을 정확히 말한다.** S-1 은 29,600회(9/23) 시점에 적었다고 기록하지만, 커밋은 9/24 09:56 이라 약 12만 회까지 진행된 뒤다. 커밋 시각이 증명하는 것은 그 뒤 약 18만 회를 재기 전에 적었다는 것까지다.

## §4. 검증 수치

### 4.1 교차검증 (칩 하나씩 빼고 맞히기, rows P5 × 20)

| 항목 | 값 | 판정 |
|---|---|---|
| 교정 · 점수 | 9칩 · 106점 (정답 100k 이하) | |
| 95% 구간 포함 | 94.5% (합격 띠 97-105점 = 91.5-99.1%) | 합격 |
| 68% 구간 포함 | 81.7% (합격 띠 63-81점 = 59.4-76.4%) | 과소신 |
| 68% 폭 중앙값 | 34,000회 | |
| 추정 ÷ 정답 전체 · 50-100k | 1.02 · 0.84 | |
| 합성 복원 (정체 칩 뺌 · prep 5회) | 68% 71 · 95% 96 | |

출처: `inverse_v4_3_ceiling_2026-10.md` §7. 아래 두 표는 5장 판(10/19) 값이고 7장 판과 판정이 같다.

| 정답 구간 | 점 | 68% | 95% | 68% 폭 | 추정 ÷ 정답 |
|---|---|---|---|---|---|
| 3k 이하 | 18 | 81.7% | 93.6% | 3,000 | 1.17 |
| 3-20k | 18 | 82.5% | 93.3% | 17,000 | 1.08 |
| 20-50k | 27 | 88.9% | 89.1% | 41,000 | 1.21 |
| 50-100k | 43 | 79.1% | 99.3% | 44,000 | 0.84 |
| 빠른 무리 | 72 | 81.8% | 92.8% | 40,000 | 0.96 |
| 느린 무리 | 34 | 84.3% | 98.8% | 23,000 | 0.98 |

| 정답 x (p50 관측) | 50k | 60k | 70k | 80k | 90k | 100k |
|---|---|---|---|---|---|---|
| 추정 ÷ 정답 중앙값 | 1.13 | 1.04 | 0.85 | 0.84 | 0.75 | 0.71 |
| 68% 적중 | 8/9 | 7/8 | 8/9 | 8/8 | 5/9 | 6/9 |
| 95% 적중 | 8/9 | 8/8 | 9/9 | 8/8 | 9/9 | 9/9 |

| 칩 | 무리 | 점 | 68% | 95% | 68% 폭 | 오차 중앙값 |
|---|---|---|---|---|---|---|
| chip01 | 빠른 | 12 | 100% | 100% | 36,000 | 12,500 |
| chip02 | 빠른 | 12 | 82% | 100% | 43,000 | 4,500 |
| chip04 | 빠른 | 12 | **34%** | **57%** | 33,000 | 19,500 |
| chip06 | 빠른 | 12 | 90% | 100% | 51,500 | 5,500 |
| chip09 | 빠른 | 12 | 85% | 100% | 52,500 | 4,500 |
| chip18 | 빠른 | 12 | 100% | 100% | 50,000 | 6,500 |
| chip03 | 느린 | 12 | 84% | 99% | 30,000 | 5,500 |
| chip07 | 느린 | 10 | 67% | 97% | 13,000 | 2,500 |
| chip15 | 느린 | 12 | 99% | 100% | 23,000 | 6,500 |

★ **chip04 가 가장 나쁘다.** 가장 빨리 늙는 칩(r̂ 2.09)이라 범위 가장자리에 있다. 출처: `inverse_v4_3_eval_2026-10.md` §3-§4

### 4.2 합성 복원 (500회 · 명목 → 실제 %)

| 명목 | 10 | 20 | 30 | 40 | 50 | 60 | 68 | 80 | 90 | 95 |
|---|---|---|---|---|---|---|---|---|---|---|
| 정체 칩 뺌 · prep 5회 (5장 판) | 12 | 22 | 30 | 39 | 49 | 58 | 66 | 78 | 89 | 96 |
| 정체 칩 뺌 · prep 1회 (5장 판) | 13 | 24 | 35 | 43 | 54 | 66 | 73 | 84 | 91 | 95 |

### 4.3 학습 곡선 (교정 칩 k 개만 쓰기)

| 무리 | k | 조합 | 68% 적중 | 95% 적중 | 배율 오차 (절대 로그) | 68% 폭 |
|---|---|---|---|---|---|---|
| 빠른 | 1 | 6 | 27.2% | 46.3% | 0.510 | 6,667 |
| 빠른 | 2 | 15 | 64.2% | 79.3% | 0.420 | 36,600 |
| 빠른 | **3 (포화)** | 20 | 73.3% | 89.5% | 0.367 | 41,775 |
| 빠른 | 4 | 15 | 78.3% | 91.9% | 0.356 | 44,067 |
| 빠른 | 5 | 6 | 81.4% | 91.4% | 0.351 | 44,583 |
| 느린 | 1 | 3 | 43.2% | 77.9% | 0.298 | 8,333 |
| 느린 | 2 | 3 | 78.8% | 99.3% | 0.274 | 23,500 |

출처: `inverse_learning_curve_2026-10.md`. 포화 판정은 측정 전에 정했다. 느린 무리는 3칩이라 판정하지 못했다.

### 4.4 기준선 비교 (교정 8칩 · 94점 · 모델 v3.2)

| 방법 | 답 | 검출 | 빠른 무리 2만 회 이하 | 오경보 |
|---|---|---|---|---|
| (a) 데이터시트 기준 이진 | 썼다 / 안 썼다 | 64/94 | 2/20 | 0/15 |
| (b) 실측 신품 분포 기준 이진 | 썼다 / 안 썼다 | 65/94 | 3/20 | 0/15 |
| (c) 칩 안 정규화 이진 | 썼다 / 안 썼다 | 74/94 | 13/20 | 0/15 |

| 부분 | 점 | 단순 회귀 오차 중앙값 | 모델 오차 중앙값 | 모델 68% | 모델 95% |
|---|---|---|---|---|---|
| 전체 | 94 | 10,000 | 7,500 | 67/94 | 93/94 |
| 20k 이하 | 32 | 2,662 | 1,500 | 27/32 | 32/32 |
| 20-50k | 24 | 13,366 | 8,500 | 16/24 | 23/24 |
| 50k 초과 | 38 | 20,825 | 14,500 | 24/38 | 38/38 |
| 빠른 무리 | 60 | 16,163 | 9,000 | 36/60 | 59/60 |
| 느린 무리 | 34 | **4,106** | 6,500 | 31/34 | 34/34 |

출처: `baseline_compare_2026-10.md`. 느린 무리는 회귀가 더 낫다.

## §5. 블라인드 3칩

| 항목 | chip06 | chip26 | chip23 |
|---|---|---|---|
| 슬라이드 | 10쪽 상온 | 10쪽 열화 · 15쪽 시연 | 없음 (질문 시) |
| 무리 · 신품 | 빠른 · 25.7ms | 빠른 · 25.7ms | 느린 · 49.4ms |
| 마모 | 상온 · 보드 B | 약 84°C · 보드 B | 85°C · 보드 B |
| 측정 | prep 5회 · 상온 | prep 1회 · 상온 | prep 1회 · 상온 |
| 관측 배율 | 1.63 | 2.66 | 1.83 |
| 모델 · 교정 · R | v2 · 5칩 · 2.0 | v4.3 · 빠른 6칩 · 2.80 | v4.3 · 느린 3칩 · 1.59 |
| 정답 | **12,000** | **70,000** | **26,528** |
| 대표값 | MAP 7,001-8,000 | 평균 60,001-61,000 | 평균 92,001-93,000 |
| 중앙값 · MAP | 중앙값 약 1.2만 | 중앙값 60,001-61,000 · MAP 51,001-52,000 | 중앙값 94,001-95,000 · MAP 99,001-100,000 |
| 68% 구간 | 3,001-19,000 | 31,001-85,000 | 91,001-100,000 |
| 95% 구간 | 1,001-34,000 | 25,001-100,000 | 78,001-100,000 |
| 정답의 자리 | 49백분위 · 68% 안 | 61백분위 · 68% 안 | 0% · **95% 밖** |
| 대표값 ÷ 정답 | 약 0.6 | 0.86 | **3.49** |
| 오차 | MAP 약 -4,500 | -9,500 (-13.6%) | +65,972 (+249%) |
| 기준 ① 정답 ∈ 95% | 통과 | 통과 | **불통과** |
| 기준 ② 68% 폭 ≤ 60,000 | 통과 (16,000) | 통과 (54,000) | 통과 (9,000) |
| 기준 ③ | **불통과** (16,000 > 10,000) | 통과 (0.89 ≤ 1.33) | 통과 (0.10 ≤ 1.33) |
| 봉인 | 칩 tally · 추정 먼저 커밋 | 없음 · 모델 먼저 고정 | 없음 · 모델 먼저 고정 |
| 입력 해시 · 코드 | 추정 파일 머리말 · `318dee7` | 머리말 · `18e06ad` | 머리말 · `18e06ad` |

| chip06 의 다른 추정 | 교정 · R | MAP | 68% | 95% | 정답 자리 |
|---|---|---|---|---|---|
| v1 (참고) | 4칩 · 2.0 | 5,001-6,000 | 2,001-11,000 | 1,001-18,000 | 79백분위 · 68% 밖 |
| R 3.8 (버림) | 5칩 · 3.8 | 6,001-7,000 | 2,001-30,000 | 1,001-61,000 | 32백분위 · 68% 안 |

| chip23 원인 비교 (26k 소거 배율) | 값 |
|---|---|
| chip23 (85°C) | 1.77 |
| chip21 · chip12 (상온 · 빠른 노화 형) | 1.79 · 1.69 |
| chip22 (85°C · 같은 배치) | 1.40 |
| chip03 · 07 · 15 (상온 느린 교정) | 1.28-1.33 |

출처: `blind_chip06.md` · `data/blind_chip06_2026-10.md` · `blind_temp_chip23_chip26.md` · `data/blind_temp_chip23_chip26_2026-11.md`

## §6. 고온

### 6.1 칩별

| 칩 | 온도 | 무리 | 소거 100k (배) | 계단 | 프로그램 100k (배) | 상온 모델 68% · 95% |
|---|---|---|---|---|---|---|
| chip16 | 65°C 설정 | 빠른 | 4.34 | 7/7 | 1.00 | 6/12 · 12/12 |
| chip17 | 65.2°C | 빠른 | 2.44 | 없음 | 1.20 | 1/12 · 11/12 |
| chip24 | 83.5°C | 빠른 | 3.47 | 3섹터 | 1.00 | 12/12 · 12/12 |
| chip22 | 85.0°C | 느린 | 1.90 | 없음 | 1.64 | 3/12 · 12/12 |
| **합계** | | | | | | **22/48 · 47/48** |
| chip26 | 약 84°C | 빠른 | 70k 2.47 | 70k 까지 없음 | 70k 1.01 | 블라인드 합격 |
| chip23 | 85.0°C | 느린 | 26k 1.77 | 없음 | 평평 | 블라인드 불합격 |
| 상온 빠른 6칩 | 25°C | 빠른 | 2.60-3.97 | 6/6 (chip02 는 200k 안) | 1.00-2.09 | 교차검증 |
| 상온 느린 3칩 | 25°C | 느린 | 1.59-1.75 | 없음 | 1.21-2.15 | 교차검증 |

출처: `wear/wear_temperature_85C.md`

### 6.2 chip06 (상온) 대 chip26 (85°C)

| 누적 | 소거 배율 chip06 | chip26 | 프로그램 ms chip06 | chip26 | 프로그램 배율 chip06 | chip26 |
|---|---|---|---|---|---|---|
| 1k | 1.22 | 1.12 | 6.55 | 6.79 | 1.00 | 1.00 |
| 10k | 1.56 | 1.44 | 6.55 | 6.80 | 1.00 | 1.00 |
| 20k | 1.78 | 1.64 | 6.69 | 6.82 | 1.02 | 1.01 |
| 30k | 1.99 | 1.86 | 6.90 | 6.82 | 1.05 | 1.00 |
| 40k | 2.16 | 1.94 | 7.12 | 6.80 | 1.09 | 1.00 |
| 50k | 2.26 | 2.11 | 7.42 | 6.80 | 1.13 | 1.00 |
| 60k | 2.35 | 2.28 | 7.64 | 6.80 | 1.17 | 1.00 |
| 70k | 2.53 | 2.47 | 7.96 | 6.82 | 1.21 | 1.01 |

### 6.3 70k 에서 chip26 대 상온 빠른 6칩

| 지표 | chip26 | chip06 | 상온 범위 | 상온 중앙 | chip26 순위 (7칩 중 낮은 쪽부터) |
|---|---|---|---|---|---|
| 프로그램 ÷ 첫 1k | 1.01 | 1.21 | 1.00-1.71 | 1.01 | 3 |
| 프로그램 ms | 6.82 | 7.96 | 6.55-11.55 | 6.95 | 3 |
| 첫 1k 프로그램 ms | 6.79 | 6.55 | 6.50-6.98 | 6.75 | 5 |
| 소거 배율 | 2.47 | 2.53 | 2.34-3.86 | 2.59 | 2 |

★ **칩 한 개로는 유의미성을 말하지 못한다.** 순위 검정은 상온 6칩 대 1칩이라 p 최소가 2/7 = 0.29 다. 사이클당 시간도 chip06 약 0.59-0.61초, chip26 약 0.56-0.62초로 차이가 없다.

## §7. 기본 데이터

### D1. 칩 명부

| 칩 | 세대 | 날짜 코드 | 무리 | 신품 소거 ms | 신품 섹터 범위 ms | 신품 폭 ps | 마모 끝 | 신품 측정일 | 용도 |
|---|---|---|---|---|---|---|---|---|---|
| chip01 | FV | 1541 | 빠른 | 28.7 | 25.7-32.7 | 39,659 | 300,000 | 09-22 | 교정 · 파일럿 |
| chip02 | FV | 1434 | 빠른 | 27.2 | 23.9-33.1 | 39,630 | 200,000 | 09-15 | 교정 |
| chip03 | FV | 1309 | 느린 | 51.1 | 46.9-55.4 | 39,653 | 200,000 | 09-15 | 교정 |
| chip04 | FV | 1450 | 빠른 | 33.7 | 29.9-43.3 | 39,688 | 100,000 | 09-16 | 교정 |
| chip05 | FV | 1212 | 측정 불가 | - | - | - | - | - | 신품 측정 불가 |
| chip06 | FV | 1430 | 빠른 | 25.7 | 22.2-31.0 | 39,798 | 200,000 | 09-16 | 상온 블라인드 → 교정 |
| chip07 | FV | 1333 | 느린 | 47.0 | 46.2-55.7 | 39,796 | 200,000 | 09-20 | 교정 |
| chip08 | FV | 1423 | 느린 | 49.5 | 45.8-55.2 | 39,498 | - | 09-20 | 블라인드 대기 |
| chip09 | FV | 1548 | 빠른 | 26.0 | 22.4-30.1 | 39,327 | 200,000 | 09-20 | 교정 |
| chip10 | JV | 1850 | 빠른 | 33.0 | 31.4-36.1 | 38,730 | 100,000 | 09-20 | 교정 밖 (JV) |
| chip12 | 미상 | — | 느린 | 47.8 | 46.5-54.1 | 39,682 | 100,000 | 09-30 | 교정 밖 (마킹 지워짐) |
| chip14 | JV | 1749 | 빠른 | 36.2 | 34.1-41.7 | 38,803 | 100,000 | 10-01 | 교정 밖 (JV) |
| chip15 | FV | 1327 | 느린 | 49.8 | 48.3-55.6 | 39,685 | 200,000 | 09-30 | 교정 |
| chip16 | FV | 1551 | 빠른 | 26.8 | 25.3-30.8 | 39,802 | 100,000 | 10-01 | 온도 65°C |
| chip17 | FV | 1430 | 빠른 | 26.4 | 23.2-31.1 | 39,775 | 100,000 | 09-30 | 온도 65°C |
| chip18 | FV | 1529 | 빠른 | 29.4 | 24.6-33.9 | 39,603 | 100,000 | 09-30 | 교정 |
| chip21 | FV | 1647 | 느린 | 48.9 | 44.8-54.3 | 39,649 | 200,000 | 10-15 | 교정 밖 (빠른 노화 형) |
| chip22 | FV | 1413 | 느린 | 49.5 | 45.6-52.7 | 39,588 | 100,000 | 10-15 | 온도 85°C |
| chip23 | FV | 1642 | 느린 | 49.4 | 45.1-53.3 | 39,679 | 26,528 | 10-15 | 온도 85°C · 판정 불합격 |
| chip24 | FV | 1542 | 빠른 | 24.9 | 22.8-28.7 | 39,583 | 100,000 | 10-19 | 온도 85°C |
| chip25 | FV | 1645 | 느린 | 50.6 | 46.5-64.2 | 39,573 | - | 10-19 | 미배정 |
| chip26 | FV | 2122 | 빠른 | 25.7 | 23.5-31.6 | 39,638 | 70,000 | 10-25 | 온도 85°C · 판정 합격 · 시연 |
| chip30 | JV | 2505 | 느린 | 53.2 | 49.6-60.7 | 39,697 | - | 10-25 | 미배정 |
| chip31 | JV | 2505 | 빠른 | 26.5 | 22.9-28.9 | 39,622 | - | 10-25 | 미배정 |
| chip32 | JV | 2033 | 느린 | 52.6 | 48.8-56.5 | 38,897 | - | 10-25 | 미배정 |
| chip33 | JV | 1836 | 빠른 | 35.5 | 32.2-43.3 | 38,790 | - | 10-25 | 미배정 |
| chip34 | JV | 1736 | 빠른 | 34.4 | 32.7-39.8 | 38,852 | - | 10-25 | 미배정 |
| chip35 | JV | 2505 | 빠른 | 36.9 | 33.2-43.5 | 38,918 | - | 10-25 | 미배정 |
| chip36 | JV | 2505 | 빠른 | 24.5 | 24.5-24.5 | 39,717 | - | 10-25 | 미배정 |
| chip37 | JV | 2505 | 빠른 | 26.3 | 23.2-29.5 | 39,821 | - | 10-25 | 미배정 |
| chip38 | JV | 2505 | 빠른 | 30.2 | 28.1-37.9 | 39,813 | - | 10-25 | 미배정 |
| chip39 | JV | 2033 | 느린 | 53.4 | 49.8-58.9 | 38,704 | - | 10-25 | 미배정 |

- 무리는 신품 소거 40ms 기준이다. chip12 는 마킹이 지워졌다. chip36 은 섹터 범위가 집계되지 않았다
- 무리 분류값(섹터 32-127) 범위: FV 빠른 10칩 24.9-33.7ms · FV 느린 9칩 47.0-51.1ms(chip12 포함) · JV 빠른 9칩 24.5-36.3ms · JV 느린 3칩 52.7-53.4ms. 표의 신품 소거는 집계표 중앙값이라 칩에 따라 조금 다르다
- 폭은 UID 꼴로 두 띠다: UID `DF` JV 7칩 38,704-38,918ps · 나머지 24칩 39,327-39,821ps
- 날짜 코드: 느린 FV 1309-1423 · 1642-1647, 빠른 FV 1430-1551 · 2122. 끝자리 IG · IQ 는 무리와 상관없다
- 출처: `newchip_survey_2026-09.csv` · `docs/chip_registry.md`

### D2. 소거 시간 체크포인트별

칸 = 소거 ms (신품 대비 배율). `-` 는 그 칩이 안 간 사이클이거나 결측이다(chip07 60k · 80k 근처).

- chip01 300k: 이 표는 마지막 1k 구간 147.5ms(5.13배)다. 슬라이드의 148.1ms(5.2배)는 294.5-300k 구간 전체의 p50 이다
- chip23 은 26,528회에서 멈췄다. 26k 구간 배율 1.77 은 [§5](#s5)에 있다
- 데이터시트 max 는 400ms 이고, 전 칩 p50 이 그 안이다

**소거 ms (÷신품) · 빠른 무리 · 상온**

| 누적 | chip01 | chip02 | chip04 | chip06 | chip09 | chip18 |
|---|---|---|---|---|---|---|
| 1k | 35.5 (1.23) | 31.5 (1.16) | 46.7 (1.38) | 31.3 (1.22) | 29.7 (1.14) | 34.2 (1.16) |
| 3k | 42.8 (1.49) | 35.1 (1.29) | 52.2 (1.55) | 35.8 (1.39) | 34.2 (1.32) | 38.4 (1.30) |
| 5k | 44.0 (1.53) | 38.8 (1.43) | 56.3 (1.67) | 37.6 (1.47) | 34.7 (1.34) | 42.2 (1.43) |
| 10k | 47.8 (1.66) | 40.1 (1.48) | 65.2 (1.93) | 40.1 (1.56) | 39.7 (1.53) | 45.0 (1.53) |
| 20k | 59.9 (2.08) | 44.6 (1.64) | 74.9 (2.22) | 45.8 (1.78) | 44.5 (1.71) | 50.5 (1.71) |
| 30k | 67.7 (2.36) | 50.2 (1.85) | 88.9 (2.63) | 51.1 (1.99) | 48.9 (1.88) | 57.7 (1.96) |
| 40k | 74.8 (2.60) | 54.2 (2.00) | 111.7 (3.31) | 55.5 (2.16) | 54.3 (2.09) | 62.2 (2.11) |
| 50k | 81.4 (2.83) | 58.0 (2.14) | 111.8 (3.31) | 58.0 (2.26) | 59.5 (2.29) | 66.5 (2.26) |
| 60k | 109.5 (3.81) | 60.9 (2.24) | 114.0 (3.38) | 60.3 (2.35) | 62.4 (2.40) | 69.8 (2.37) |
| 70k | 110.9 (3.86) | 63.5 (2.34) | 115.2 (3.41) | 65.0 (2.53) | 69.0 (2.66) | 73.9 (2.51) |
| 80k | 111.9 (3.90) | 67.7 (2.49) | 116.3 (3.45) | 65.6 (2.56) | 68.4 (2.63) | 80.5 (2.73) |
| 90k | 113.0 (3.93) | 69.7 (2.57) | 118.5 (3.51) | 69.7 (2.71) | 70.6 (2.72) | 86.0 (2.92) |
| 100k | 114.1 (3.97) | 70.7 (2.60) | 119.8 (3.55) | 76.3 (2.97) | 72.7 (2.80) | 108.4 (3.68) |
| 120k | 116.1 (4.04) | 75.1 (2.77) | - | 81.1 (3.16) | 78.8 (3.03) | - |
| 140k | 117.4 (4.09) | 79.3 (2.92) | - | 103.4 (4.03) | 103.7 (3.99) | - |
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
| 90k | 3 | 1.57 | 1.69 | 1.70 | 1.08 | 1.17 | 1.23 | 2.05 |
| 100k | 3 | 1.59 | 1.74 | 1.75 | 1.10 | 1.21 | 1.27 | 2.15 |
| 150k | 3 | 1.78 | 1.87 | 1.88 | 1.06 | 1.38 | 1.50 | 2.47 |
| 200k | 3 | 1.91 | 2.10 | 2.25 | 1.18 | 1.85 | 2.05 | 2.89 |

**섹터 간 · 사이클 간 산포** (한 칩 안)

| 칩 | 누적 | 섹터 p50 최소 ms | 최대 ms | 섹터 간 차이 ms | 같은 섹터 p10-p90 폭 중앙 ms |
|---|---|---|---|---|---|
| chip01 | 100k | 111.8 | 118.7 | 6.9 | 2.6 |
| chip01 | 200k | 122.8 | 136.3 | 13.5 | 8.0 |
| chip02 | 100k | 68.0 | 72.1 | 4.0 | 6.1 |
| chip02 | 200k | 107.3 | 109.1 | 1.8 | 3.5 |
| chip04 | 100k | 117.4 | 129.8 | 12.4 | 3.7 |
| chip06 | 100k | 69.5 | 103.9 | 34.4 | 11.3 |
| chip06 | 200k | 106.5 | 108.2 | 1.7 | 2.9 |
| chip09 | 100k | 68.8 | 103.0 | 34.3 | 6.9 |
| chip09 | 200k | 105.8 | 109.2 | 3.4 | 2.4 |
| chip18 | 100k | 88.0 | 115.7 | 27.7 | 23.0 |
| chip03 | 100k | 87.7 | 93.2 | 5.6 | 10.6 |
| chip03 | 200k | 103.7 | 127.3 | 23.6 | 16.0 |
| chip07 | 100k | 72.2 | 81.0 | 8.9 | 6.1 |
| chip07 | 200k | 86.9 | 94.7 | 7.8 | 7.4 |
| chip15 | 100k | 74.9 | 98.8 | 23.9 | 9.7 |
| chip15 | 200k | 103.2 | 131.1 | 28.0 | 16.8 |
| chip12 | 100k | 119.4 | 127.0 | 7.5 | 6.3 |
| chip21 | 100k | 126.0 | 131.5 | 5.5 | 4.1 |
| chip21 | 200k | 139.9 | 151.7 | 11.8 | 8.0 |
| chip16 | 100k | 114.3 | 123.8 | 9.5 | 4.9 |
| chip17 | 100k | 60.3 | 67.5 | 7.1 | 5.2 |
| chip24 | 100k | 79.6 | 109.3 | 29.7 | 14.8 |
| chip22 | 100k | 89.7 | 98.3 | 8.6 | 5.8 |
| chip10 | 100k | 78.0 | 87.0 | 9.0 | 3.7 |
| chip14 | 100k | 91.8 | 103.6 | 11.8 | 6.4 |

느린 칩 산포 근거: 전환 밖 p10-p90 이 빠른 칩 8-12ms, 느린 칩 chip03 20-25ms 다. 105ms 이상 비율이 chip09 섹터 4 는 약 2만 회, chip03 섹터 0 은 약 7만 회에 걸쳐 바뀐다(`wear/wear_endurance_200k.md` §6).

### D5. 계단

| 칩 | 계단 섹터 | 계단 시점 (문서) | 높이 ms (문서) | 105ms 넘은 섹터 (계산) | 105ms 첫 도달 (계산) | 1k 구간 최대 상승 ms (계산) |
|---|---|---|---|---|---|---|
| chip01 | 7/7 | 34-62k | 19.7-22.0 | 7/7 | 35-63k | 16.3-25.2 |
| chip02 | 7/7 | 148-178k | 17.5-21.0 | 7/7 | 148-178k | 17.5-21.0 |
| chip04 | 7/7 | 25-47k | 18.5-22.7 | 7/7 | 26-47k | 17.1-22.7 |
| chip06 | 7/7 | 90k(섹터 0) · 116-158k | 18.1-21.3 | 7/7 | 98-186k | 17.0-21.2 |
| chip09 | 7/7 | 92k(섹터 6) · 110-157k | 18.1-21.3 | 7/7 | 139-199k | 16.9-19.9 |
| chip18 | 5/7 | 53-100k | 19.7-23.1 | 5/7 | 54-100k | 3.5-19.4 |
| chip03 | 없음 | - | - | 6/7 | 161-189k | 5.2-12.3 |
| chip07 | 없음 | - | - | 0/7 | - | 3.2-7.6 |
| chip15 | 없음 | - | - | 7/7 | 125-199k | 5.4-10.6 |
| chip12 | 없음 | - | - | 7/7 | 46-69k | 5.0-11.0 |
| chip21 | 없음 | - | - | 7/7 | 25-57k | 5.0-7.8 |
| chip16 | 7/7 | 해석 문서 참고 | - | 7/7 | 43-70k | 17.6-19.8 |
| chip17 | 없음 | - | - | 0/7 | - | 2.2-4.3 |
| chip24 | 3/7 | 78-100k | 17-21 | 3/7 | 78-100k | 5.7-20.7 |
| chip26 | 없음 | - | - | 0/7 | - | 2.3-3.8 |
| chip22 | 없음 | - | - | 0/7 | - | 2.9-5.3 |
| chip23 | 없음 | - | - | 0/7 | - | 2.9-5.7 |
| chip10 | 없음 | - | - | 0/7 | - | 1.7-5.1 |
| chip14 | 없음 | - | - | 0/7 | - | 3.4-7.9 |

- 문서 값과 계산 값의 기준이 다르다. 착지가 105ms 아래인 칩(chip06 · 09)은 105ms 첫 도달이 실제 계단보다 늦게 나온다
- 빠른 칩의 계단 직전 수준은 약 84ms 이상이고, 착지는 직전 + 약 21ms 다. 느린 칩도 85-93ms 를 지나지만 뛰지 않는다
- 계단 뒤 평탄: chip06 · 09 160-200k 104-109ms · chip02 180-200k 106-109ms
- 2차 계단: chip01 203-283k, 116 → 137ms

### D6. 마진 폭

체크포인트 100 대비 변화. 기준은 ±42ps(3σ)다.

| 칩 | 체크포인트 100 폭 ps | 100k 안 최소 변화 ps | 최대 ps | 끝 사이클 | 전 구간 최소 ps | 최대 ps |
|---|---|---|---|---|---|---|
| chip02 | 39,676.8 | +0.0 | +11.6 | 200,000 | +0.0 | +137.7 |
| chip04 | 39,774.7 | -3.7 | +3.2 | 100,000 | -3.7 | +3.2 |
| chip09 | 39,612.9 | -2.7 | +10.9 | 200,000 | -2.7 | +24.5 |
| chip18 | 39,584.9 | -6.8 | +0.0 | 100,000 | -6.8 | +0.0 |
| chip03 | 39,681.2 | -2.1 | +3.6 | 200,000 | -2.1 | +15.7 |
| chip07 | 39,355.7 | -59.1 | +543.8 | 200,000 | -59.1 | +543.8 |
| chip15 | 39,677.0 | -18.8 | +5.3 | 200,000 | -18.8 | +13.3 |
| chip21 | 39,682.8 | -5.2 | +3.1 | 200,000 | -5.7 | +3.1 |
| chip16 | 39,789.8 | -8.3 | +4.6 | 100,000 | -8.3 | +4.6 |
| chip17 | 39,763.7 | -3.3 | +14.8 | 100,000 | -3.3 | +14.8 |
| chip24 | 39,668.2 | -1.0 | +5.6 | 100,000 | -1.0 | +5.6 |
| chip26 | 39,759.5 | -32.0 | +3.7 | 60,000 | -32.0 | +3.7 |
| chip22 | 39,752.3 | +0.0 | +17.3 | 100,000 | +0.0 | +17.3 |
| chip23 | 39,742.1 | -0.6 | +6.7 | 20,000 | -0.6 | +6.7 |

| 표 밖 칩 · 사건 | 내용 |
|---|---|
| chip01 | 신품 39,659 · 30만 회 +15.5ps (25MHz) · 75MHz 12,185.7ps (신품 12,183.1, 다른 보드) |
| chip06 | 체크포인트 100 없음. 20k 에 -55ps (보드 B → A 재장착), 이후 200k 까지 ±8ps |
| chip02 | 110k 에 +128ps (13일 휴지 · 재장착), 110-200k 안 ±3ps |
| chip07 | 초기 10k -59ps (장착 뒤 안정화로 읽음), 9/28 배선 접촉으로 +590ps, 사건 전후를 나눠 사후 처리 |
| chip14 | 90k -43ps 는 창 이동 자리 (12점 중 11점 3σ 안) |
| chip12 | 재장착 단차 약 30ps 포함 불변 |
| 재장착 σ | 13.86ps (chip10 3회) |
| 클럭 사다리 (chip01, 7월) | 25MHz 39,737ps · 45MHz 21,898ps · 75MHz 12,205ps |

출처: `data/wear/wear_checkpoint_table_2026-10.md` · `wear/wear_endurance_200k.md` · `wear/wear_endurance_chip07.md`

### D7. 안 쓴 섹터 · 근접 섹터 (마모 뒤 상온 newchip ÷ 신품)

| 칩 | 조건 | 기준 32-127 | 근접 7-13 | 원격 121-127 |
|---|---|---|---|---|
| chip03 | 100k · 상온 | 0.98 | 1.11 | 0.98 |
| chip04 | 100k · 상온 | 1.00 | 1.15 | 1.00 |
| chip07 | 100k · 상온 | 1.00 | 1.06 | 1.00 |
| chip15 | 100k · 상온 | 0.98 | 1.09 | 0.96 |
| chip18 | 100k · 상온 | 0.98 | 1.09 | 0.98 |
| chip12 | 100k · 상온 | 0.99 | - | - |
| chip10 (JV) | 100k · 상온 | 1.02 | 0.98 | 1.02 |
| chip14 (JV) | 100k · 상온 | 1.03 | 1.10 | 1.03 |
| chip22 | 100k · 85°C | 1.00 | 1.11 | - |
| chip24 | 100k · 85°C | **1.11** | **1.43** | - |
| chip23 | 26.5k · 85°C | 0.99 | 1.06 | 0.99 |
| chip26 | 70k · 85°C | 0.98 | 1.17 | 0.98 |

- 블록 경계: 근접 쪽 64KB 블록 0 · 1 은 1.05-1.25배이고 블록 2(섹터 32-47)부터 약 1.00 으로 끊긴다. 그래서 기준을 32 부터 잡는다
- ★ chip24 는 기준 섹터도 1.11 이다. 고온 칩에서 기준값이 흔들릴 수 있는 사례다. 이 한 칩으로 일반화하지 않는다
- 출처: 칩별 `data/wear/wear_endurance_*.md` · `wear/wear_temperature_85C.md` §3

### D8. 마모 소요 시간 · 사고

세션 로그의 첫 시각과 끝 시각 차이의 합이다. 체크포인트 측정이 포함되고 세션 사이에 쉰 시간은 빠진다.

| 칩 | 끝 사이클 | 10만 번까지 시간 | 그 뒤 시간 | 합계 시간 | 비고 |
|---|---|---|---|---|---|
| chip01 | 300,000 | - | 80.8 | 80.8 | 122,164 까지 한 세션이 100k 를 걸침 |
| chip02 | 200,000 | 16.1 | 23.4 | 39.5 |  |
| chip04 | 100,000 | 26.4 | - | 26.4 |  |
| chip06 | 200,000 | 16.4 | 25.0 | 41.4 |  |
| chip09 | 200,000 | 16.1 | 22.9 | 39.1 |  |
| chip18 | 100,000 | 18.2 | - | 18.2 |  |
| chip03 | 200,000 | 19.1 | 24.1 | 43.3 |  |
| chip07 | 200,000 | 26.8 | 21.7 | 48.4 |  |
| chip15 | 200,000 | 19.0 | 24.4 | 43.4 |  |
| chip12 | 100,000 | 23.2 | - | 23.2 |  |
| chip21 | 200,000 | - | 56.3 | 56.3 | 200,000 까지 한 세션이 100k 를 걸침 |
| chip16 | 100,000 | - | - | - | 로그 시각이 맞지 않아 뺐다 — 다음 세션이 24.6시간 뒤에 시작 |
| chip17 | 100,000 | 16.7 | - | 16.7 |  |
| chip24 | 100,000 | 19.4 | - | 19.4 |  |
| chip26 | 70,000 | 11.5 | - | 11.5 |  |
| chip22 | 100,000 | 22.6 | - | 22.6 |  |
| chip23 | 26,528 | 5.9 | - | 5.9 |  |
| chip10 | 100,000 | 17.1 | - | 17.1 |  |
| chip14 | 100,000 | 22.9 | - | 22.9 |  |

- 사이클당 평균: 0-100k 약 0.6초 · 100-200k 약 0.9초 · chip01 122-300k 약 1.1초

| 사건 | 내용 |
|---|---|
| chip01 122,164 | 타이머 오버플로로 가짜 `wip_timeout`, 펌웨어 수정 뒤 재개 (`45a51ec`) |
| chip04 66,671 | SPI 접촉 불량 · 66,600 으로 되돌린 수기 복구 |
| chip06 0-100 | 호스트 로그 유실, tally 로 보정 |
| chip07 60k · 80k | USB 재열거로 체크포인트 결측, 엔진 단독 완주 (tally 80,000) |
| chip07 100k-103.6k | PC 전원 상실로 A 행 유실 |
| chip15 69,109 | USB 흔들림 `wip_timeout` · resume |
| chip16 97,957 | `wip_timeout` · 약 1.5시간 뒤 resume |
| chip23 26,528 | USB 끊김 · 히터 센서 FAULT 로 중단 |
| chip26 33,100 | error 뒤 이어 돌림 · 70k 첫 스윕 `_invalid` 로 재스윕 |
| 휴지 회복 | chip03 19일 88.9 → 88.8ms · chip15 12일 86.4 → 85.8ms · chip09 13일 이어짐 |
| 측정 불가 | chip05 · 11 · 13 (JEDEC 무응답 등) · 앵커 chip02 조립체 고장(-300ps 이탈)은 대조 칩으로 분리 |

### D9. 측정 조건 · 데이터시트

| 항목 | 값 | 출처 |
|---|---|---|
| 보드 | Zybo Z7-20 (Zynq-7020) · W25Q64 모듈 | README |
| 위상 스텝 | 15.873ps (MMCM 동적 위상 이동) | 스윕 CSV |
| 스윕 | 25MHz · 2,520스텝 · 위상당 112회 · 2,048비트 · PRBS-15 | 집계표 |
| 한 스윕 | 5.78억 비트 · 약 1분 | README · 세션 로그 |
| 위상당 비트 | 112 × 2,048 = 229,376 → 최소 BER 약 4.4×10⁻⁶ | 계산 |
| 판정 θ | 10⁻² (10⁻³ · 10⁻⁴ 도 기록, 세 값 차이 27ps) | README |
| UART · 빌드 | 921600 · Vivado/Vitis 2025.2 | 집계표 |
| 마모 1 사이클 | 0x00 프로그램 112페이지 → 7섹터 소거 | S-1 |
| A 행 | 사이클 · 섹터마다 `t_erase_us` · `t_program_us`(16페이지 합) | S-1 |
| 체크포인트 | 100 · 1k · 3k · 10k · 20k 이후 10k 단위 (13점, chip01 은 격자가 다름) | S-1 §15 |
| 진단 시간 | 11/1 chip26 newchip 1분 53초 (보드 프로그래밍 약 10초 · prep 약 40초 · 스윕 약 1분) + 계산 수 초 | 세션 로그 |
| 비용 | 슬라이드 약 20만 원 · **레포에 부품 목록 근거 없음** | 15쪽 |
| 정격 내구 | 10만 회 이상 · 유지 20년 이상 | 데이터시트 |
| 동작 온도 | -40 to 85°C (Industrial) | 데이터시트 |
| 섹터 소거 tSE | typ 60ms (IG) · 45ms (IQ · IF) · max 400ms | 데이터시트 |
| 페이지 프로그램 tPP | typ 0.7ms · max 3ms | 데이터시트 |
| 마모 칩 프로그램 | 16페이지 합 6.5-7.0ms → 페이지당 약 0.43ms | [D3](#d3) |
| 팀 | 한영웅 PE · 총괄 · 박지민 RTL · DV · 장세은 HW · TE | `docs/roles.md` |

### D10. 선행 연구 비교

| 논문 | 칩 | 신호 | 답 | 기준 | 검증 | 원문 확인 |
|---|---|---|---|---|---|---|
| Sakib 외 2018, *Cryptography* 2(3):17 | raw NAND | 소거 시간 | 재활용 / 정품 · 확신도 | 데이터시트 중앙값 | 신품 분포와 겹침 | 읽음 |
| Guo 외 2017, DAC (FFD) | raw MLC NAND | 부분 프로그래밍 실패 지도 | 점 추정 | 신품 때 칩마다 등록 | 같은 칩 다른 페이지 | 읽음 |
| LIU 외 2019, JUESTC 48(4) | 65nm 128Mb SPI NOR 자체 제작 | 소거 시간 열화 기전 | 기전 · 최적화 | - | 칩 수준 측정 | 읽음 |
| Poudel 외 2020, DAC (Flashmark) | NOR | 의도적 마모 워터마크 | 위조 판별 | 워터마크 | - | 초록 |
| **저희** | SPI NOR (W25Q64FV) | 소거 시간 배율 | 횟수 + 68 · 95% 구간 + 등급 | 칩 안의 안 쓴 섹터 | 교차검증 · 블라인드 · 합성 | - |

| 인용 문장 | 출처 |
|---|---|
| "there are a very few works on the detection of recycled Flash memory" | Sakib 2018 3절 |
| "we will extend this analysis to other flash memory types, such as TLC NAND and NOR flash memory" | Guo 2017 7절 |
| 연구 대부분이 단일 소자 수준이고 칩 수준 성능 열화 연구는 상대적으로 적다 · 65nm 이하 NOR 칩에서 소거 열화가 특히 심각 (중국어 원문 번역) | LIU 2019 서론 |

| 저희가 약한 점 | 내용 |
|---|---|
| 칩 전체를 고르게 쓴 경우 | Sakib 은 데이터시트와, Guo 는 등록 지도와 비교하므로 잡는다. 저희는 안 쓴 섹터가 있어야 한다 |
| 초기 소량 사용 | Sakib 은 수명 0.05-3% 를 검출한다. 저희는 1,000회(정격 1%) 지점의 검출이 약하다 |
