young-0320/flash-margin-bench/docs/results/reports/최종발표대본.md

# 최종 발표 대본 (2026-11-06)

- **작성일**: 2026-11-04 · **슬라이드**: [`최종발표_초안6.pptx`](최종발표_초안6.pptx) 16장, 같은 대본이 슬라이드 노트에 들어 있다
- **방침 (영웅님, 11/04)**: 슬라이드는 합치지 않고 말을 줄인다. 장마다 핵심만 말하고, 세부는 아래 예상 질문으로 답한다
- **시간**: 음절 수로 낸 추정 약 7분 16초(초당 4.5음절 · 터미널 전환 포함). 느리게(초당 4음절) 8분 2초 · 빠르게(초당 5음절) 6분 36초. 실제로 재 본 값이 아니니 리허설에서 초시계로 잰다. 남는 시간은 여유로 둔다
- **이전 판**: `최종발표대본초안.md`(10/5)는 v3.2 시절 수치와 긴 구성이라 쓰지 않는다

## 시연

보드에 chip26을 꽂아 두고 3쪽에서 실행한다. 리허설에서 이 명령과 로그 경로를 먼저 확인한다(11/1 로그는 `build/data/` 에 있었다).

```bash
uv run python host/run/run_sweep_chip.py --mode newchip --mhz 25 && \
uv run python host/analysis/wear_inverse.py "$(ls -t build/data/session_chip26_*.log | head -1)"
```

- 슬라이드 15쪽 숫자는 11/1 측정이다(약 60,500회 · 68% 31,001-85,000회 · 95% 25,001-100,000회 · 정답 70,000회). 새로 재면 달라질 수 있으니 대본은 화면 값을 읽는다
- 실패 대비: 리허설 결과 화면을 캡처해 둔다. 측정은 섹터 0-127 을 지우고 `docs/chip_pe.md` 에 행을 남긴다

## 대본

### 1쪽 · 표지 (약 11초)

> 안녕하세요, 팀 errorATE입니다. FPGA 기반 플래시 메모리 수명 예측 시스템을 발표하겠습니다.

### 2쪽 · NOR 선택 이유 (약 27초)

> 저희는 NOR 플래시를 골랐습니다. NOR에는 부트 코드와 펌웨어가 들어 있어서, 고장 나면 시스템 전체가 부팅되지 않습니다. 그런데 노화 연구는 NAND에 몰려 있습니다. 중고 칩을 가린 연구도, 사용량을 추정한 연구도 대상이 NAND였고, NOR는 향후 과제로 남아 있었습니다.

- 논문 카드 세 장은 읽지 않는다

### 3쪽 · 과정 · 시연 시작 (약 49초)

> 결론부터 말씀드리겠습니다. 타이밍 마진으로 수명을 재려 했지만, 마진은 30만 번을 써도 움직이지 않았습니다. 대신 소거 시간이 5.2배로 늘었고, 이걸로 몇 번 썼는지 거꾸로 읽는 모델을 만들어 블라인드로 검증했습니다. 저희는 결과를 보기 전에 예측과 기준을 먼저 적었고, 그 기준을 바꾸지 않았습니다. [터미널 전환 · 명령 실행] 85도에서 7만 번 쓴 실제 칩을 지금 진단에 걸어 두고, 결과는 끝에서 확인하겠습니다.

- STEP 설명은 읽지 않는다

### 4쪽 · 마진 가설 기각 (약 31초)

> 처음 가설은 닳으면 마진이 좁아진다는 것이었습니다. 읽는 시점을 약 16피코초씩 밀면서 데이터가 맞게 읽히는 구간의 폭을 쟀습니다. 결과는 30만 번까지 판정 기준 42피코초 안이었고, 가설은 데이터로 기각했습니다. 다만 소거와 프로그램 시간을 처음부터 함께 기록해 두어서 지표를 옮길 수 있었습니다.

- 욕조곡선 수치는 읽지 않는다

### 5쪽 · PASS/FAIL 대신 구간 (약 20초)

> 답의 형태도 바꿨습니다. 기존 검사는 고장 직전까지 PASS, 한 비트입니다. 저희는 몇 번 썼는지를 확률 구간으로 답합니다. 그래서 같은 PASS 안에서 중고 칩을 가리고 교체 시점을 고를 수 있습니다.

### 6쪽 · 마모 엔진 (약 20초)

> 데이터는 칩을 실제로 닳게 해서 얻었습니다. 지우고 쓰기를 FPGA로 최대 30만 번 반복하면서 천 번 단위로 시간을 기록했습니다. 시퀀스는 실기판에 올리기 전에 테스트벤치로 먼저 검증했습니다.

- 오른쪽 설계 판단은 질문이 오면

### 7쪽 · 두 무리 · 계단 현상 (약 23초)

> 같은 모델인데 신품 소거 시간이 40밀리초를 사이에 두고 두 무리로 갈렸습니다. 빠른 무리는 약 21밀리초씩 계단을 밟고, 느린 무리는 계단 없이 완만하게 늘어납니다. 계단은 내부 소거 단계가 하나 느는 것으로 보지만, 아직 가설입니다.

- 160k · 1.91-2.25배는 읽지 않는다

### 8쪽 · 소거 시간 증가 (약 28초)

> 소거 시간은 마모를 따라갔습니다. 같은 칩이 30만 번에 5.2배가 됐습니다. 두 가지만 보시면 됩니다. 같은 무리에서도 늙는 속도가 약 3배까지 달라서 구간으로 답해야 합니다. 그리고 안 쓴 섹터는 10만 번 뒤에도 신품값 그대로입니다. 이게 모델의 핵심 재료입니다.

### 9쪽 · 모델 · 교차검증 (약 36초)

> 그래서 칩 자신을 기준으로 삼습니다. 닳은 섹터를 안 닳은 섹터로 나누면 칩마다 다른 출발점이 지워지고, 이 배율을 교정 칩의 곡선과 맞대어 사용량을 분포로 냅니다. 같은 94개 지점에서 데이터시트 기준은 64개, 저희 기준은 74개를 잡았습니다. 칩을 하나씩 빼고 맞히는 교차검증에서는 95% 구간이 정답의 94.5%를 품어, 미리 정한 합격 띠 안에 들었습니다.

- 실측 신품 65는 읽지 않는다

### 10쪽 · 블라인드 (약 54초)

> 진짜 시험은 답을 모르는 칩입니다. 왼쪽 chip06은 상온 블라인드입니다. 팀원이 횟수를 정해 봉인했고, 저희는 추정을 먼저 커밋한 뒤 정답을 열었습니다. 정답 1만 2천 번은 68% 구간 안, 분포의 거의 가운데였습니다. 다만 미리 정한 기준 셋 중 구간 폭은 떨어졌고, 기준을 고치지 않고 그대로 보고합니다. 오른쪽 chip26은 85도에서 마모한 칩입니다. 10월 23일에 고정한 모델로 판정했고, 정답 7만 번이 68% 구간 안에 들었습니다. 이 칩은 정답을 봉인하지 않아 모델 고정 판정으로 구분합니다. 이 순서의 증거는 커밋 시각입니다.

- 95% 구간 · MAP · 사전 기준 번호는 읽지 않는다

### 11쪽 · 고온 셋업 (약 12초)

> 현장은 상온이 아닙니다. 그래서 칩을 히팅 필름으로 가열해, 65도와 85도에서 칩 6개를 마모했습니다.

- 회로 · 로그 사진은 가리키기만 한다

### 12쪽 · 고온 결과 (약 30초)

> 결과는 상온 칩의 개체 차이와 구별되지 않았습니다. 온도에 따른 일관된 방향이 없고, 오른쪽의 물리적 기대는 가설로만 둡니다. 표본이 적어 차이가 없다고 단정하지는 않습니다. 모델의 95% 구간은 48점 중 47점으로 유지됐지만 68% 구간은 22점만 맞아서, 고온 이력 칩에는 넓은 범위로 답합니다.

### 13쪽 · 한계 (약 27초)

> 한계는 셋입니다. 첫째, W25Q64FV 한 모델에서만 검증했고, 그 안에서도 느린 신품 7개 중 3개는 빠르게 늙는 다른 형이라 모델이 높게 읽습니다. 둘째, 보드 분해능 안에서는 마진 변화가 보이지 않아 지표에서 뺐습니다. 셋째, 온도는 센서 값이고 칩 내부 온도는 모릅니다.

### 14쪽 · 극복 방안 (약 18초)

> 극복 방안입니다. 같은 계열 JV 12개와 다른 제조사 칩 5개를 이미 확보해, 같은 절차로 곡선을 만들어 비교하겠습니다. 지표는 지금 장비로 확실히 재는 소거 시간을 씁니다.

### 15쪽 · 시연 결과 · 의의 (약 46초)

> [터미널 전환] 아까 걸어 둔 결과입니다. [화면 값을 읽는다] 이 칩의 추정은 약 6만 번, 68% 구간은 3만에서 8만 5천 번이고, 실제 7만 번이 구간 안에 있습니다. [슬라이드 복귀] 약 20만 원 부품으로 칩 하나를 5분 안에 진단하고, 빠른 무리는 교정 칩 3개부터 성능이 포화됩니다. 다음은 NAND로 넓히겠습니다. 기능 검사는 살았다만 말합니다. 저희는 얼마나 썼고, 그 말을 얼마나 믿어도 되는지를 답합니다.

### 16쪽 · 감사합니다 (약 4초)

> 감사합니다. 질문 받겠습니다.

## 예상 질문

먼저 물어보지 않으면 말하지 않는다. 물어보면 숨기지 않고 바로 답한다.

질문별 답과 데이터 표를 모은 판은 [`최종발표_질의응답부록.md`](최종발표_질의응답부록.md) 다.

### 마진 · 측정

| 질문 | 답 | 출처 |
|---|---|---|
| 창이 안 변했으면 피코초 계측기는 헛수고 아닌가 | 「안 변한다」 를 말하려면 자가 정밀해야 합니다. 같은 칩을 다시 꽂은 흔들림이 13.86ps이고, 기준은 그 3배인 42ps입니다. 이 자가 있어서 답이 마진이 아니라 소거 시간이라고 말할 수 있었습니다. 배선 접촉으로 폭이 590ps 옮겨 간 사건도 이 자로 찾았습니다. | `newchip_survey.md` §6 · `wear/wear_endurance_chip07.md` |
| 42ps를 벗어난 칩은 없었나 | 있었습니다. chip06은 보드를 바꿔 다시 꽂은 20k에서 -55ps 단차가 생겼고, 그 뒤 200k까지는 ±8ps 안입니다. chip07은 초기 -59ps와 +590ps 사건이 있어 구간을 나눠 판정했고, 이것은 사후 처리로 표시했습니다. 단차 뒤에 움직이지 않아 마모가 아니라 장착 쪽으로 읽습니다. | `wear/wear_endurance_200k.md` §1 · `wear/wear_endurance_chip07.md` |
| 먼저 적었다는 증거는 | git 커밋 시각입니다. chip06 추정은 10/1 18:08에 커밋했고 정답은 19:55에 열었습니다. chip15를 교정에 넣는다는 결정은 10/4 10:42 커밋, 마모 시작은 10:45입니다. | `data/blind_chip06_2026-10.md` §1 · §4 · 커밋 `2afa1ba` |

### 모델

| 질문 | 답 | 출처 |
|---|---|---|
| 기준 섹터를 왜 32-127로 잡았나 | 마모 섹터 근처는 소거 교란으로 함께 느려집니다(근접 섹터 약 1.06-1.15배). 32-127은 10만 번 뒤에도 신품의 0.98-1.00배라 기준으로 씁니다. | `wear/wear_endurance_chip04.md` · 칩별 해석 |
| 68% 구간은 잘 맞나 | 교차검증에서 81.7%를 품어, 합격 띠(59.4-76.4%)보다 위입니다. 구간이 필요 이상 넓다는 뜻이고 과소신으로 기록했습니다. 안전한 쪽 오차라 고치지 않고 등록했습니다. | `docs/spec/s5.lifetime_inverse_model.md` §2 · `data/inverse_v4_3_ceiling_2026-10.md` §7 |
| 교정 칩 9개로 충분한가 | 빠른 무리는 3개에서 포화됐습니다. 1개에서 3개로 늘 때 95% 적중이 46%에서 90%로 오르고, 5개까지 가도 91%입니다. 느린 무리는 3칩뿐이라 판정하지 못했습니다. 남는 오차 약 1.4배는 칩마다 늙는 속도 차이입니다. | `data/inverse_learning_curve_2026-10.md` |
| 모델을 여러 번 바꿨는데 끼워 맞추기 아닌가 | 판정은 판정 전에 고정한 버전으로만 했습니다. chip06은 v2, chip26은 v4.3입니다. 숫자가 좋아 보여도 버린 것이 있습니다. R 3.8은 칩 산포를 두 번 세서, Δx는 일부 칩에서 틀린 쪽으로 좁혀서, 사후 지지 200k는 과대 1.24배에 폭이 2배가 되어 버렸습니다. | `docs/spec/s5.lifetime_inverse_model.md` · `data/inverse_v3_probe_2026-10.md` · `data/inverse_v4_3_eval_2026-10.md` §3.3 |
| chip06의 R을 결과를 보고 고친 것 아닌가 | R 3.8 추정을 본 뒤 2.0으로 고친 것은 맞습니다. 다만 정답을 읽기 전이었고, 이유는 칩 산포를 두 번 세는 구조 결함이었습니다. 버린 R 3.8 추정도 파일로 남아 있고, 그것도 정답을 68% 구간 안에 품었습니다. | `blind_chip06.md` §4 · `data/blind_chip06_2026-10.md` §5 |
| chip06 점 추정은 왜 7-8천인가 | MAP은 정답의 0.6배로 낮았습니다. 분포가 오른쪽으로 길어서입니다. 그래서 점이 아니라 구간으로 답하고, v4.3 대표값은 사후 평균으로 바꿨습니다. | `blind_chip06.md` §2 · `data/inverse_v4_3_ceiling_2026-10.md` §3 |
| 많이 쓴 칩은 잘 맞나 | 10만 번 쓴 칩을 약 0.7배로 낮게 읽습니다. 소거 시간이 100k 너머를 구분하지 못해서입니다. 대신 50-100k의 95% 구간 포함률은 99.3%라서, 고마모는 숫자보다 범위로 답합니다. | `data/inverse_v4_3_eval_2026-10.md` §3 (5장 판) |
| 기준선은 94점인데 교차검증은 왜 106점인가 | 기준선 비교는 10/07 교정 8칩 기준이고, 교차검증은 chip06을 더한 9칩 기준입니다. | `baseline_compare.md` · `data/inverse_v4_3_eval_2026-10.md` |
| 단순 회귀로 충분하지 않나 | 같은 94점에서 오차 중앙값이 회귀 10,000, 당시 모델(v3.2) 7,500입니다. 느린 무리는 회귀가 더 낫습니다. 차이의 본체는 정확도보다 구간을 준다는 점입니다. | `baseline_compare.md` |

### 블라인드

| 질문 | 답 | 출처 |
|---|---|---|
| 다른 블라인드 칩은 없었나 (chip23) | 있습니다. 같은 날 판정한 85도 느린 칩 chip23은 불합격입니다. 정답 26,528번을 92,500번으로 3.5배 높게 읽어 95% 구간 밖이었습니다. 같은 사이클의 배율이 상온의 chip12 · 21과 같아 원인을 온도가 아니라 칩 종류로 봅니다. 이 형은 10/19에 한계로 적어 두었습니다. 시간상 발표에서는 두 칩만 설명했습니다. | `blind_temp_chip23_chip26.md` |
| 정답을 봉인 안 했는데 chip26이 왜 블라인드인가 | 엄밀한 봉인 블라인드는 아니어서 모델 고정 판정으로 구분합니다. 모델과 교정 표를 10/23에 고정한 뒤 10/26에 마모를 시작했고, 추정 파일에 코드 버전과 입력 해시가 남아 있어 추정값이 정답에 끌릴 길이 없습니다. | `data/blind_temp_chip23_chip26_2026-11.md` |
| 3인 팀인데 chip06이 블라인드가 되나 | 완전 블라인드는 아닙니다. 정답은 칩 안의 기록(tally)으로 봉인했고, 개봉 값 120/120 바이트가 종이 기록 12,000과 일치했습니다. | `blind_chip06.md` §4 |
| 블라인드가 더 남았나 | chip08이 남아 있습니다. 등록된 v4.3 7장 판으로 개봉할 예정입니다. | `docs/spec/s5.lifetime_inverse_model.md` |
| 시연 칩은 답을 아는 칩 아닌가 | 맞습니다. 시연은 블라인드가 아니라 시스템이 실제로 돈다는 것을 보여 드리는 것입니다. | - |

### 칩의 성질

| 질문 | 답 | 출처 |
|---|---|---|
| 두 무리는 왜 생기나 | 원인은 확인하지 못했습니다. 처음 10칩은 날짜 코드로 깔끔하게 갈렸지만, FV 19칩으로 늘리니 겹쳐서 생산 시기만으로는 설명되지 않습니다. 내부 설정 차이를 가설로 둡니다. | `docs/chip_registry.md` 마킹 절 |
| 계단은 모든 빠른 칩에서 나왔나 | 빠른 FV 7칩 모두 나왔습니다. chip06 · 09 · 02는 100k 넘어 7섹터가 전부 넘어갔고, 높이는 18-21ms, 그 뒤 평탄합니다. 원인은 내부 소거 단계가 늘어나는 것으로 보는 가설입니다. Sakib의 펄스 약 1ms보다 커서 더 큰 단위로 봅니다. | `wear/wear_endurance_200k.md` §1 · §10 · `docs/ref/선행논문_재활용판별_NOR소거열화.md` §5 |
| 프로그램 시간은 왜 안 쓰나 | 칩마다 너무 다릅니다. 100k에서 chip09는 1.01배, chip02는 2.09배입니다. 일관된 축이 못 되어 모델에서 뺐습니다. | `host/analysis/plot_deck_figures.py` 출력 · `wear/wear_endurance_200k.md` |

### 고온

| 질문 | 답 | 출처 |
|---|---|---|
| 고온과 상온이 같다는 말인가 | 아닙니다. 개체 차이와 구별되지 않았다는 뜻이고, 표본이 적어 같다고 단정하지 않습니다. 68% 구간 적중은 상온 약 80%에서 고온 46%(22/48)로 떨어집니다. | `wear/wear_temperature_85C.md` |
| 온도는 얼마나 믿을 수 있나 | 센서 자리 온도이고 칩 내부 온도는 재지 못했습니다. chip24는 초반 30k 동안 81-84도로 설정보다 낮았습니다. | `wear/wear_temperature_85C.md` §4 |

### 활용 · 선행 연구

| 질문 | 답 | 출처 |
|---|---|---|
| 실제 중고 칩에 해 봤나 | 못 했습니다. 닳은 섹터 위치를 아는 칩으로만 검증했습니다. | - |
| 칩 전체를 고르게 쓴 경우는 | 약합니다. 안 닳은 섹터가 남아 있어야 작동하는 방법입니다. | `docs/ref/선행논문_재활용판별_NOR소거열화.md` §1 |
| 진단이 칩에 영향을 주나 | 섹터 0-127을 지우고 쓰므로 P/E가 1회 늘고(정격의 0.001%), 그 구간의 내용은 지워집니다. 마모는 무시할 수준이지만 비파괴는 아닙니다. | `docs/chip_pe.md` (11/01 행) |
| 다른 품번에도 되나 | 안 됩니다. FV 모델은 JV 두 칩을 약 0.6배로 낮게 읽습니다. 그래서 곡선을 따로 만들어야 합니다. | `wear/wear_endurance_chip14.md` |
| 선행 연구와 무엇이 다른가 | Sakib 2018은 데이터시트 기준의 이진 판별입니다. 같은 품번 FV 신품이 24.9-51.1ms로 두 배 달라 이 칩에서는 그 전제가 서지 않습니다. Guo 2017은 사용량을 추정했지만 신품 때 칩마다 등록이 필요하고, 같은 칩 안에서 검증했습니다. 저희는 등록 없이 구간으로 답하고 처음 보는 칩으로 검증했습니다. 최초라고 주장하지는 않습니다. | `docs/ref/선행논문_재활용판별_NOR소거열화.md` §1 · §3 · `newchip_survey.md` |
| NOR 연구가 부족하다는 근거는 | 편수를 센 통계는 아닙니다. 가장 가까운 연구들의 대상이 NAND이고 NOR가 향후 과제로 남아 있다는 것이 근거입니다. LIU 2019나 Flashmark 2020 같은 NOR 연구도 있습니다. | `docs/ref/선행논문_재활용판별_NOR소거열화.md` |
| 비용과 시간은 | 부품 약 20만 원입니다. 11/1 chip26 측정은 prep과 스윕을 합쳐 1분 53초였습니다. | `build/data/session_chip26_D16518B58F503638_20261101T142328Z.log` |
