young-0320/flash-margin-bench/docs/results/reports/최종발표대본초안.md

# 최종 발표 대본 초안 (2026-10-16 발표)

- **작성일**: 2026-10-05 · **상태**: 초안 — 영웅님의 5단계 흐름(선행 한계 → 발상 전환 → 가설 기각 → 교정 · 모델 → 한계)을 뼈대로,
  논리가 비는 자리를 채웠다. 채운 자리와 이유는 끝의 「보완한 것」 에 있다
- **숫자 출처**: [`final_report_material_2026-10.md`](final_report_material_2026-10.md) (보고서 재료) · [`../data/inverse_v3_probe_2026-10.md`](../data/inverse_v3_probe_2026-10.md)
  (v3 · v1-v3 비교) · 칩별 해석 `../wear/*.md` · 블라인드 [`../blind_chip06.md`](../blind_chip06.md). 대본 숫자는 발표 직전 이 문서들과 다시 대조한다
- **배점** (보고서 제출 뒤 발표): 창의성 20 · 난이도 20 · 구현 완성도 30 · 발표 30. 각 장 머리에 어느 항목을 겨누는지 적었다
- **시간**: 지금 합계 12분 30초 — 실제 발표 시간을 확인해 다시 나눈다. 10분이면 1 · 2 장을 1분씩, 3 · 7 장을 45초씩으로 줄이고 6장은 지킨다
- **TODO**: 표시는 발표 전까지 채울 것
- **2026-10-05 주의**: 칩은 W25Q64**FV** 다(chip10 · 16 을 뺀 전 칩 마킹 확인, 로그 48 §47 · §48). 대본에 「JV」 를 쓰지 않는다.
  chip12 는 품번이 긁혀 있었다 — 8장 · 질의응답에서 「재마킹 의심 외관」 으로만 말한다
- **중심축 (2026-10-05, 영웅님)**: 발표에서 가장 강조할 것은 **방법론** — 결과를 보기 전에 가설과 기준을 정했고, 모델을 스스로 검증했고,
  데이터를 끼워 맞추거나 조작 · 왜곡하지 않았다는 것을 설득한다. 6장이 그 중심이고, 0 · 4 · 9 장이 같은 실을 잇는다

---

## 0. 여는 말 (30초) — 발표 30

> 플래시 메모리는 죽기 직전까지 "정상" 입니다. 오늘은 그 정상 판정 속에 숨어 있는 **"얼마나 썼나"** 를 숫자로, 그리고 그 숫자를
> 얼마나 믿어도 되는지까지 재는 방법을 보여드리겠습니다.
>
> 그리고 하나 더 보여드리고 싶은 것이 있습니다. 저희는 **결과를 보기 전에 예측과 판정 기준을 먼저 적었고, 그 기준을 끝까지 바꾸지
> 않았습니다.** 오늘 나오는 숫자는 맞아서가 아니라, 틀릴 수 있는 방식으로 쟀기 때문에 믿을 수 있습니다.

- 화면: 같은 품번 칩 두 개 사진 — 하나는 신품, 하나는 10만 번 쓴 칩. "둘 다 기능 검사 PASS 입니다"

## 1. 기존 방법의 한계 (1분 30초) — 창의성 20

> 지금 칩을 검사하는 방법은 크게 둘입니다.
>
> 첫째, **기능 검사(PASS/FAIL)**. 읽고 쓰기가 되면 PASS 입니다. 그런데 저희가 정격의 세 배인 30만 번을 쓴 칩도 기능 검사는 PASS 였습니다.
> 칩은 고장 나는 순간까지 PASS 이고, 중고 칩이나 재생 칩도 PASS 로 통과합니다.
>
> 둘째, 선행 연구는 **소거 시간**에 주목했습니다. 칩이 닳으면 지우는 데 오래 걸린다는 것이죠. 2018년 미국 앨라배마대 연구팀은 NAND
> 플래시에서 이 점으로 중고 칩을 수명의 몇 %만 써도 가려냈습니다. 그 연구팀 스스로 **「재활용 플래시 판별 연구는 아주 적다」** 고 썼습니다.
> 하지만 이 방법도 답이 **"썼다 / 안 썼다" 두 가지**뿐입니다. 50번 쓴 칩과 9만 번 쓴 칩이 같은 "사용됨" 입니다. 남은 수명은 알려주지 않습니다.
>
> 그리고 이 방법은 **같은 품번이면 신품 소거 시간이 거의 같다**는 전제로 데이터시트 값을 신품 기준으로 씁니다. 저희가 같은 품번 SPI NOR
> 15개를 신품 상태로 재 보니, **신품 소거 시간이 26ms 에서 51ms 까지, 두 배 차이**가 났습니다. 신품인데 느린 칩이, 이미 1,000번 쓴 빠른
> 칩보다 오래 걸립니다(chip03 신품 51.1ms > chip04 1,000회 46.5ms). 이 칩에서는 그 전제가 성립하지 않습니다.

- 화면: ① PASS/FAIL 표(전부 PASS) ② 신품 15칩 소거 시간 분포 + 1k 쓴 chip04 점 하나가 신품 분포 안에 들어가는 그림
- 인용(발표에서 이름을 대는 선행 연구는 이 하나): Sakib 외, *Non-Invasive Detection Method for Recycled Flash Memory Using Timing Characteristics*,
  *Cryptography* 2(3):17, 2018 (doi 10.3390/cryptography2030017) · 같은 그룹 학회판 Kumari 외, IEEE HOST 2018 — 한 연구로 묶어 말한다.
  「a very few works on the detection of recycled Flash memory」 는 같은 논문 3절. 근거 정리 `../../ref/선행논문_재활용판별_NOR소거열화.md` §1
- 「NAND 는 XX편 · NOR 는 X편」 처럼 숫자로 말하려면 IEEE Xplore 에서 날짜 · 검색어를 정해 직접 세고 그 조건을 화면에 같이 적는다 — 세기 전에는 쓰지 않는다
- **TODO**: 신품 분포 + chip04 1k 점 그림 (집계표 `newchip_survey_2026-09.csv` + `wear_endurance_chip04_2026-09.csv`)

## 2. 발상의 전환 — 마진을 피코초로 직접 잰다 (1분 30초) — 창의성 20 · 난이도 20

> 저희는 PASS/FAIL 이 아니라, PASS 안에 남은 **여유(마진)**를 재기로 했습니다. 칩이 데이터를 내보내는 순간을 기준으로 읽는 시점을
> 15.9 피코초씩 2,520번 옮겨 가며, 몇 피코초 구간에서 데이터가 맞게 읽히는지 — **유효 윈도우 폭**을 잽니다. 피코초는 1조분의 1초입니다.
>
> 가설은 이랬습니다. 칩이 닳으면 셀이 느려지고, 그러면 이 창이 **에러가 나기 전부터** 좁아질 것이다. 그러면 창 폭이 남은 수명을
> 보여줄 것이다. 다만 창이 안 줄어들 수도 있으니, 소거 시간과 프로그램 시간을 **보조 지표로 같이 기록**하기로 했습니다.

- 화면: 욕조 곡선 한 장(`plots/bathtub/v1/bathtub_*`) — 가로축 위상, 세로축 BER, 가운데 0 인 구간이 창
- 화면: 장비 구성 — Zybo Z7-20(FPGA) + 소켓 + 20만 원 수준

## 3. 그 자가 믿을 만한가 (1분) — 난이도 20 · 구현 30

> 창이 "안 변했다" 고 말하려면, 자가 그만큼 정밀해야 합니다. 그래서 측정 전에 자부터 검증했습니다.
>
> - 알고리즘은 몬테카를로로 미리 검증해 한 위상당 112번 읽기로 정했고,
> - 같은 칩을 뺐다 꽂아 반복 측정한 흔들림이 **13.86ps** 입니다. 판정 기준은 그 세 배, 42ps 로 잡았습니다.
> - 측정 중 생긴 장비 사고(배선 접촉으로 590ps 이동)도 데이터만으로 찾아내 분리했습니다.

- 화면: 반복 측정 산포 · 3σ = 42ps 막대

## 4. 가설은 기각됐다 — 그런데 다른 것이 움직였다 (1분 30초) — 구현 30

> 결과입니다. 칩 9개를 정격 10만 번까지(한 개는 30만 번까지) 닳게 하며 13번씩 쟀습니다.
>
> **창 폭은 움직이지 않았습니다.** 10만 번 동안 기준 42ps 안, 30만 번에서도 마찬가지입니다. "닳으면 창이 좁아진다" 는 저희의
> 출발 가설은 데이터로 기각됐습니다. 저희는 파일럿 도중 이 경향을 보고 **"정격 안에서는 움직이지 않는다" 를 결과 전에 미리 적어 두었고**,
> 남은 칩들이 그 예측대로 나왔습니다. 이유도 있습니다 — 창을 정하는 건 클럭에 맞춰 도는 출력 회로이고, 셀이 느려지는 정도는 25MHz 의
> 40ns 주기 안에서 여유가 커 출력까지 닿지 않습니다.
>
> 대신 **보조 지표가 움직였습니다.** 소거 시간은 10만 번에 신품의 1.6-4배가 됐고, 칩은 두 무리로 갈렸습니다.
> - **빠른 무리**(신품 40ms 미만): 소거가 2.8-4배로 크게 늘고, 섹터마다 약 21ms 씩 **계단**을 뛰어오릅니다. 프로그램 시간은 그대로입니다
> - **느린 무리**(신품 40ms 이상): 소거는 1.6-1.75배로 완만하게, 계단 없이 늘고, 대신 **프로그램 시간이 오릅니다**(+21-26%, 한 칩은 2.1배)
>
> 소거 시간이 느는 이유는 칩 안에 있습니다. 섹터를 지울 때 칩은 내부에서 여러 단계를 거치는데, 셀이 닳을수록 상한 셀을 고치느라 일을 더 합니다.
>
> 원래 목적은 "무엇이 노화를 보여주는가" 였습니다. 그 답이 창 폭이 아니라 소거 시간이라는 것을, 피코초 자로 창이 안 움직인다는 것을
> 확인했기 때문에 말할 수 있습니다. 그리고 저희는 이 기각을 숨기지 않았습니다 — 출발 가설이 틀렸다는 것이 이 발표의 첫 결과입니다.

- 화면: ① 칩 간 폭 변화(`plots/wear/wear_checkpoint_width_program_2026-10.png` 위 칸 — 전부 ±42ps 띠 안) ② 배율 곡선 두 칸
  (`plots/wear/wear_ratio_curves_2026-10-05.png`) — 빠른 무리 계단 · 느린 무리 완만
- 「기각」 표현: 기각된 것은 **중간계획서의 전제**(마모 → 창 축소)이고, 사전 등록한 H1(정격 안 불변)은 **참**이다. 둘을 섞지 않는다

## 5. 교정 곡선과 모델 (1분 30초) — 창의성 20 · 구현 30

> 이제 소거 시간으로 "몇 번 썼나" 를 거꾸로 읽습니다. 1장의 문제 — 신품값이 칩마다 두 배 다르다 — 를 이렇게 풉니다.
>
> 1. **칩이 자기 신품값을 몸에 지니고 있습니다.** 닳지 않은 먼 섹터(32-127)의 소거 시간이 그 칩의 신품값입니다. 10만 번 뒤에도 0.98배로
>    그대로였습니다. 그래서 닳은 섹터를 **신품값 대비 배율**로 읽으면 개체차가 지워집니다.
> 2. 신품값이 40ms 보다 빠른지 느린지로 **무리를 정합니다.**
> 3. 같은 무리 교정 칩들의 1,000번 단위 곡선과 맞대어, 몇 번 썼을 때 지금 배율이 나올 확률을 계산합니다. 같은 무리 안에서도 늙는
>    속도가 칩마다 다르기 때문에(최대 2.9배) 그 차이까지 넣습니다.
> 4. 답은 숫자 하나가 아니라 **추정값 + 68% · 95% 구간 + 등급**(신품 · 저마모 · 중마모 · 고마모)입니다.

- 화면: 4단계 그림 · 시연 화면 한 장(`wear_inverse.py` 출력 — 칩 · 무리 · 교정 곡선 · 확률 막대 · 판정)

## 6. 끼워 맞추지 않았다는 증거 — 방법론 (2분 30초) — 구현 30 · 발표 30 · **발표의 중심**

> 모델이 데이터에 잘 맞는 것은 어렵지 않습니다. 데이터를 보고 모델을 고치면 언제나 맞습니다. 그래서 저희는 반대로 했습니다.
> **답을 모르는 상태에서 먼저 적고, 나중에 맞춰 봤습니다.** 네 가지 장치를 보여드리겠습니다.

**① 결과보다 먼저 적었다 — 사전 등록**

> 예측과 판정 기준은 데이터를 보기 전에 사양서에 날짜를 달아 적고 커밋했습니다. 커밋 시각이 증거입니다.
>
> - 창 폭 불변 예측(H1): 30만 번 파일럿의 2만 9,600번 지점에서, 나머지 27만 번을 재기 전에 적었습니다
> - chip15 를 교정에 넣는다는 결정: **10월 4일 10시 42분 커밋, 마모 시작은 10시 45분** — 곡선이 어떻게 나오든 넣는다고 먼저 적었습니다
> - 블라인드 chip06 의 추정: **개봉 1시간 47분 전에 커밋**했습니다

**② 정답을 숨기고 맞혔다 — 블라인드**

> 팀원이 칩 하나를 몰래 닳게 하고 정답을 봉인했습니다. 칩 안의 기록(tally)이 정답이라 저희가 고칠 수 없습니다. 추정 68% 구간
> 3,001-19,000 번, 정답 **12,000 번** — 구간 안이었습니다. 그런데 미리 정한 기준 셋 중 「구간 폭」 하나는 통과하지 못했습니다.
> **기준을 고치지 않고 불통과로 보고합니다.** 기준을 바꿔 통과시키는 순간, 앞의 모든 사전 등록이 의미를 잃기 때문입니다.

**③ 스스로 시험했다 — 모의 블라인드와 합성 복원**

> - **모의 블라인드(LOCO)**: 교정 칩을 하나씩 빼고 나머지로 맞힙니다. 94번 중 68% 구간이 67번(71%), 95% 구간이 93번을 품었습니다 —
>   약속한 확률대로입니다
> - **합성 복원**: 정답을 아는 가짜 칩 500개를 모델의 가정대로 만들어 넣어, 모델이 말하는 확률이 정직한지 쟀습니다. 여기서 저희가
>   준비한 「개선안」 이 오히려 구간을 과신하게 만든다는 것이 드러나, **그 개선안을 버렸습니다**

**④ 틀린 것을 버렸다 — 기록으로 남은 기각들**

| 저희가 버린 것 | 왜 |
|---|---|
| 출발 가설 「마모되면 창이 좁아진다」 | 9칩 모두 3σ 안 — 데이터가 기각 |
| 「프로그램 시간은 정격 안에서 안 변한다」(H2′) | 느린 무리 세 칩에서 깨짐 — 거짓으로 기록 |
| 속도 범위 R 3.8 | 칩 간 차이를 두 번 세는 구조 결함 — 숫자가 좋아 보여도 버림 |
| v1 모델 | 자기 성적표는 가장 좋았지만, 처음 보는 칩을 0.4배로 읽음 — 저희 분석으로 찾아냄 |
| 두 번째 측정(Δx)으로 구간 좁히기 | 전체로는 좁아졌지만 일부 칩에서 틀린 쪽으로 좁힘 — 버림 |
| 무리 교차 확인 경고(입력 C) | 정상 칩에 경고를 띄움 — 뺌 |

> 그리고 이 모든 결정 — 98개 — 에 날짜와 사람, 이유, 버린 후보가 기록돼 있습니다. 데이터를 본 뒤에 정한 것은 **「사후 처리」 라고
> 따로 표시**했습니다. 원자료(칩당 70만 행)와 재현 명령은 전부 남아 있어, 누구든 같은 숫자를 다시 낼 수 있습니다.

- 화면: ① 커밋 시각 타임라인 세 줄(H1 · chip15 · chip06) ② 블라인드 구간과 정답 점 · 기준 표(③ 불통과 그대로) ③ LOCO 포함률 표 ·
  합성 복원 포함률 그림(`plots/synthetic_recovery_2026-10.png`) ④ 버린 것 표
- 숫자 출처: H1 — S-1 §15 사전 가설 · chip15 — 커밋 `2afa1ba`(10-04 10:42 KST)와 세션 `1791078343`(01:45Z) · chip06 — 커밋 `04bab2a`
  (10-01 18:08 KST = 09:08Z)와 개봉 10:55Z · LOCO — `baseline_compare_2026-10.md` §1(10-07, 교정 8칩 · v3.2 — 10-05 의 7칩 82점은 `inverse_v3_probe_2026-10.md` §7) · S-5 · 합성 복원 — `synthetic_recovery_2026-10.md` ·
  결정 수 — 로그 48 `[D48-*]`
- chip06 은 v2 로 판정했다. 지금 버전으로 다시 본 값은 개봉 뒤라 **블라인드 성과로 말하지 않는다**
- 모델을 버전별로 올린 효과(교정에 없던 칩 오차 v1 16,000 → v3 8,500 → 교정 8칩(10-07) 7,500)는 7장 기준선 비교 뒤에 한 줄로 붙여도 된다

## 7. 기준선 비교 (1분) — 창의성 20 · 구현 30

> 같은 칩 데이터에 세 방법을 대 봤습니다.
>
> | 방법 | 답 | 같은 데이터에서 |
> |---|---|---|
> | 선행 연구식 이진 판별 (데이터시트 기준) | 썼다 / 안 썼다 | 94번 중 64번 검출 — 빠른 칩은 2만 번 이하에서 20번 중 2번 |
> | 같은 판별 + 저희 정규화 | 썼다 / 안 썼다 | 94번 중 74번 검출 — 빠른 칩은 2만 번 이하에서 20번 중 13번 · 신품 15칩 오경보 0 |
> | 단순 회귀 (배율 → 사이클 곡선 맞춤) | 숫자 하나 | 오차 중앙값 10,000 번 · 구간 없음 |
> | 저희 모델 (v3) | 숫자 + 믿을 수 있는 구간 + 등급 | 오차 중앙값 7,500 번 · 68% 구간 67번 · 95% 구간 93번 |
>
> 선행 연구 방식 그대로 데이터시트 값을 기준으로 하면, 빠른 칩은 3-4만 번을 써도 신품으로 보입니다. 신품을 실제로 재서 기준으로 삼아도
> 문턱이 느린 칩의 신품값에 걸려 결과가 같습니다. 저희 방식대로 칩 자신의 안 닳은 섹터로 나누면 빠른 칩은 1만 번부터 전부 잡힙니다 —
> 하지만 답은 여전히 "썼다" 뿐입니다. 단순 회귀도 숫자를 주지만 저희 모델보다 덜 맞고(오차 중앙값 1만 번 대 7,500 번 — 느린 칩만은
> 회귀가 낫습니다), 얼마나 믿어야 할지는 말하지 않습니다. 저희 모델의 구간은 94번 중 약속한 만큼 정답을 품었습니다.

- 화면: `plots/baseline_compare_binary_2026-10.png`(선행 방식을 우리 칩에 — 무리별 검출) · `plots/baseline_compare_estimate_2026-10.png`(우리 모델 대 단순 회귀)
- 숫자 출처: `../baseline_compare.md` · `../data/baseline_compare_2026-10.md` (2026-10-07 판 — chip02 를 교정에 넣은 뒤 같은 방법으로 다시 계산,
  10-05 판은 커밋 `fd0f79a`). 방법은 결과 전에 커밋(`7ce25fc`)
- **메시지를 초안과 다르게 고쳤다 (결과가 예상과 달랐다)**: ① 초안의 「이진 판별은 썼는지는 잘 맞힌다」 는 정규화한 빠른 무리에서만 참이다 —
  선행식 기준 그대로는 빠른 무리를 놓치고, 느린 무리는 느는 폭이 작아 정규화해도 4만 번부터 잡힌다 ② 점 추정 오차는 저희가 작다(1만 대 7,500 — 10-05 판 9,254 대 8,500 에서 벌어졌고, chip02 를 뺀 82점에서도 8,867 대 6,500) ·
  느린 무리는 회귀가 낫다 — 「저희 숫자가 늘 더 정확하다」 고는 말하지 않는다. 저희가 더하는 것의 본체는 구간이다
- 판정 규칙은 논문 4절 식 (1) 과 대조했다(2026-10-05, `../../ref/sakib2018_recycled_flash_timing_cryptography.pdf`)

## 8. 한계와 다음 단계 (1분) — 발표 30

> 한계도 분명합니다.
>
> - **검증 범위**: 한 품번(W25Q64FV, 2013-2015년 생산), 한 구매처의 두 배치입니다. 다른 구매처 칩(chip12)은 어느 무리와도 맞지 않았습니다 —
>   이 모델은 교정한 집단 밖의 칩을 맞히지 못합니다
> - **정밀도의 바닥**: 같은 로트 안에서도 늙는 속도가 칩마다 2.9배까지 달라, 교정 칩을 늘려도 구간이 어느 폭 아래로는 좁아지지 않습니다.
>   가장 빨리 늙는 칩은 덜 쓴 것으로 읽는 경향이 남아 있습니다
> - **고마모의 바닥**: 5만 번을 넘으면 소거 시간이 거의 늘지 않아(계단을 넘은 빠른 칩은 4만 번부터 그대로입니다), 10만 번 쓴 칩도
>   추정값은 6-8만 번에 머뭅니다. 그래서 고마모는 숫자가 아니라 **등급과 구간**으로 답합니다 — 7만 번 이상 31번 모두 95% 구간이 정답을 품었습니다
> - 온도는 65°C 한 칩, 전압 축은 하지 못했습니다
>
> 다음은 **"모른다" 고 말할 줄 아는 모델**입니다. 닳지 않은 섹터의 성질(개체 지문)로 교정 집단 밖 칩을 걸러 판정을 보류하고,
> 다른 제조사 칩과 프로그램 시간을 두 번째 축으로 더하겠습니다.

- 화면: 한계 넷 · 다음 단계 셋
- 고마모: 공모전은 모델(v3.2)을 그대로 두고 한계로 말한다(로그 48 [D48-107]). 보정치는 칩 하나씩 빼고 시험해 버렸다 — 7만 번 이상 오차는
  19,500 → 10,000 으로 줄지만 2-5만 번이 8,500 → 12,333 으로 나빠진다(관측이 같으면 보정도 같다). 답 범위 150k · 프로그램 축은 v4 후보

## 9. 맺음 (30초)

> 기능 검사는 "살았다" 만 말합니다. 저희는 그 안에서 **"얼마나 썼고, 그 말을 얼마나 믿어도 되는지"** 를 재는 방법을 만들었습니다.
> 피코초 자로 창이 움직이지 않는다는 것을 확인했기에, 소거 시간이라는 답에 닿을 수 있었습니다.
> 그리고 그 모든 답을, 틀릴 수 있는 방식으로 먼저 적고 나서 확인했습니다.

---

## 예상 질문

| 질문 | 답의 요지 · 출처 |
|---|---|
| 창이 안 변했으면 피코초 계측기는 헛수고 아닌가 | 「무엇이 노화를 보이나」 에 답하려면 「안 변한다」 를 증명해야 했고, 그 증명에 13.86ps 자가 필요했다. 또 장비 사고(590ps)를 찾아낸 것도 이 자 |
| 선행 연구와 무엇이 다른가 | 이진 판별 → 횟수 추정 + 구간 + 그 구간이 정직한지 블라인드 · LOCO 로 검증. 개체차를 신품값 배율로 정규화 |
| 기준 섹터를 왜 32-127 로 | 마모 섹터를 지울 때 첫 128KB(섹터 0-31)가 약 10% 느려진다(소거 교란, 다섯 칩에서 재현). 그 밖은 0.98 |
| 칩 7개로 충분한가 | 아니다 — 그래서 결과를 구간으로 주고, 구간이 약속한 확률대로 맞는지 LOCO 로 쟀다. 칩을 늘려도 개체차 때문에 구간은 일정 폭 아래로 안 좁아진다 |
| 모델 버전을 여러 번 바꿨는데 그게 끼워 맞추기 아닌가 | 버전마다 바꾼 이유 · 날짜 · 그때의 성능을 사양서(S-5)에 남겼다. 블라인드 chip06 은 개봉 전 버전(v2)으로만 판정하고, 이후 버전의 chip06 값은 성과로 쓰지 않는다. 남은 블라인드는 개봉 전에 버전을 등록한다 |
| 사전 등록을 정말 먼저 했다는 증거는 | git 커밋 시각 — 바꿀 수 없는 순서 기록. chip15 는 커밋 3분 뒤 마모 시작 |
| 진짜 중고 칩은 해 봤나 | 못 했다. 닳은 섹터 위치를 아는 칩으로만 검증했다 — 한계에 적었다 |
| 블라인드 기준 ③ 은 왜 불통과 | 무리당 교정 칩이 둘이던 때 정한 폭 기준이라 같은 무리 안 속도 차를 몰랐다. 기준을 고치지 않고 불통과로 적었다 |
| 두 무리는 왜 생기나 | 원인은 확인하지 못했다. 다만 IC 날짜 코드로 갈린다 — 2014년 23주 이전 생산은 전부 느린 무리, 30주 이후는 전부 빠른 무리(10칩). 같은 셀이라도 내부 소거 알고리즘 · 바이어스 조건이 바뀌면 초기 속도와 열화 모양이 크게 달라진다는 칩 설계 연구(LIU 외 2019, 65nm NOR)가 있어, 그 무렵의 내부 설정 변경을 가설로 둔다. 남은 칩으로 예측을 먼저 적고 확인 중 |
| 10만 번 쓴 칩을 왜 6-8만 번으로 읽나 | 5만 번 위에서는 소거 시간이 거의 안 늘어 관측에 정보가 없다 — 빨리 늙는 칩의 4만 번과 느리게 늙는 칩의 10만 번이 같은 값을 낸다. 보정치를 넣어 봤지만 중마모 칩을 같은 만큼 밀어 올렸다. 그래서 등급 · 구간으로 답하고, 95% 구간은 7만 번 이상 31번 모두 정답을 품었다. 늦게 늙는 칩은 프로그램 시간이 계속 늘어 v4 의 두 번째 축 후보 · 로그 48 §52 |
| 그냥 곡선을 맞춘 것 아닌가 · 소거 시간은 왜 느나 | 모델은 측정한 교정 곡선이지만 기전은 알려져 있다 — NOR 섹터 소거는 칩 안에서 사전 프로그램 · 일괄 소거 · 과소거 교정 · 이웃 섹터 복구의 네 단계이고, 산화막이 닳을수록 네 단계가 모두 길어진다(LIU 외 2019). 계단(약 21ms, 칩이 바뀌어도 일정)은 알고리즘이 단계를 하나 더 쓰기 시작한 순간으로 읽힌다(가설). 근거 `../../ref/선행논문_재활용판별_NOR소거열화.md` §5 |

## 보완한 것 (초안 흐름 대비)

1. **1장 — 「죽기 직전이라도 문턱을 안 넘으면 PASS」 를 고쳤다.** 이 한계는 **기능 검사(PASS/FAIL)**의 것이다. 소거 시간 선행 연구는 오히려
   50회만 써도 「사용됨」 으로 잡는다 — 그 연구의 한계는 **이진 답(얼마나 썼는지 모름)**과 **고정 문턱이 개체차에 흔들림**이다. 섞어 말하면
   그 논문을 아는 심사위원에게 바로 걸린다. 개체차(신품 26-51ms)는 저희 데이터로 보여줄 수 있는 가장 강한 근거라 1장에 넣었다
2. **2장 — 시간 순서.** 창 폭 발상은 중간계획서부터 있었고(선행 연구를 보고 바꾼 것이 아니다), 선행 연구는 나중에 찾았다. 그래서 「선행
   연구의 한계를 보고 발상을 바꿨다」 가 아니라 「기존 접근(PASS/FAIL · 소거 시간 이진)과 다른 축을 시험했다」 로 썼다
3. **3장 신설 — 자의 정밀도.** 「창이 안 줄었다」 는 음성 결과는 측정 정밀도가 없으면 「못 쟀다」 와 구별되지 않는다
4. **4장 — 「기각」 의 대상.** 기각된 것은 중간계획서의 전제, 사전 등록 H1(정격 안 불변)은 참. 「가설이 틀려서 방향을 틀었다」 가 아니라
   「예측한 대로 안 움직였고, 그래서 답이 소거 시간이다」 로 이어지게 했다
5. **5장 — 1장의 개체차 문제를 푸는 고리(신품값 배율 정규화)를 명시했다.** 이것이 없으면 1장과 5장이 이어지지 않는다
6. **6장 신설 — 검증.** 블라인드 · LOCO 가 없으면 모델은 곡선 맞춤이다. 기준 ③ 불통과를 그대로 말하는 것이 오히려 신뢰를 준다
7. **7장 — 기준선 비교 자리.** 영웅님 결정(발표에 넣기). 결과는 2026-10-05 에 넣었다 — 메시지를 초안과 다르게 고쳤다(7장 아래 메모)
8. 발표 시간이 10분이 아니면 3 · 6 · 7 장을 줄이기보다 4 · 5 장 설명을 줄인다 — 구현 완성도(30)는 검증이 보여준다
9. **6장을 방법론 중심으로 다시 썼다 (2026-10-05, 영웅님 요청).** 사전 등록(커밋 시각 증거) · 블라인드 · 자가 검증(LOCO · 합성 복원) ·
   버린 것들. 0 · 4 · 9 장에 같은 문장을 한 줄씩 심어, 「틀릴 수 있는 방식으로 먼저 적고 확인했다」 가 발표 전체의 실이 되게 했다.
   시간은 10분 안에서 6장 2분 30초 — 4 · 5 장을 30초씩 줄여 맞춘다
