young-0320/flash-margin-bench/docs/log/young/51.inverse_model_design_and_blind_procedure.md

# 51. 역산 모델은 소거 시간 하나 — 두 무리로 갈리고, 두 번째 dose 가 칩 속도를 지운다

- **작성일**: 2026-09-29
- **발단**: 종단 3칩(chip03·04·07)의 마모가 끝나 문서화 중이다. 다음 국면은 블라인드와 역산
  모델인데, S-1 §15 의 「두 층 역산」은 뼈대만 있고 입력·식·오차 산출법이 없었다. 게다가
  chip01 과 chip03 이 같은 x 에서 소거 시간이 다르게 늘어(4배 vs 1.7배) 파일럿 때 세운
  "비율로 정규화하면 칩 사이를 건넌다" 는 전제가 흔들렸다.
- **목적**: 이력을 모르는 칩의 prep 측정값으로 누적 P/E 사이클 수를 어떤 식·어떤 입력으로
  역산하고, 그 식을 블라인드로 어떻게 검증하는가? 그리고 온도·프로그램 시간·윈도우 폭은
  이 모델에 들어가는가?
- **관련**: `docs/spec/s1.wear_bench_spec.md` §15 (2026-09-26 두 층 역산 · 09-27 H6) ·
  `docs/results/wear/wear_endurance_chip03.md` §4-§5 · `docs/results/data/newchip_survey_2026-09.csv` ·
  `docs/workflow/5.newchip_baseline_and_wear_bench.md` 「보류 — 블라인드 이해충돌」 ·
  [로그 23](23.sweep_wrapper_and_uid_design.md) 부록 D ·
  [로그 48](48.pilot_wear_handler_and_plan_approval.md) §15 · `[U48-1]` `[U48-7]` `[U48-8]`

> **2026-09-30 — 모델 형식이 바뀌었다 ([로그 48](48.pilot_wear_handler_and_plan_approval.md) §22, S-1 §15 2026-09-30 추기).**
> 채택된 1차 모델은 비모수 교정 밴드(1k 구간 × 섹터 p10/p50/p90) + 무리 분류(40ms) + 배율 눈금 + 속도 배율 r(R = 2.0) 이고,
> 코드는 `host/analysis/wear_inverse.py` 다. 이 로그의 무리 분류·소거 단일 입력·LOO·무리별 블라인드 1칩은 그대로 살았고,
> 거듭제곱 회귀(D51-3)는 뒤집혔으며 두 번째 dose(D51-4)는 보류다. 기호 x 는 같은 날 저녁 채택됐다([D48-46]). 봉인 담당은 아직 정리되지 않았다.

## 결정

- [D51-1] 누적 P/E 사이클 수의 기호는 **`x`**, 추정값은 `x̂`. `N` 은 읽기 횟수 112 에만 쓴다
  (2026-09-29, 한영웅) — §1
- [D51-2] 역산 모델의 입력은 **소거 시간뿐**이다. 프로그램 시간은 보조 지표, 윈도우 폭은
  「현재 마진」으로 나란히 보고하되 역산에 넣지 않는다. 온도는 변수가 아니라 상수(상온)이고
  측정 온도만 기록한다 (2026-09-29, 한영웅) — §2 · §3
- [D51-3] 곡선 형태는 `e − e₀ = A·xⁿ`. n 은 칩 공통, A 는 무리별. 무리는 원격 섹터 소거
  시간 40ms 를 문턱으로 둘로 가른다 — §4 · §5
  > **2026-09-30 — 뒤집힘 (로그 48 §22, [D48-42]).** 형태를 두지 않고 교정 칩 × 섹터의 1k 구간 분위수를 밴드로 쓴다. 무리 문턱 40ms 는 그대로
  >
- [D51-4] 현장·블라인드 절차는 **prep → Δx 추가 마모 → prep**. 두 점의 기울기로 A 를 소거한
  `x̂ = n·(e−e₀)/(de/dx)` 가 주 결과, prep 1회 식은 비교선 (2026-09-29, 한영웅) — §6
  > **2026-09-30 — 보류 (로그 48 §22, [D48-42]).** 블라인드 개봉은 prep 3회 이상, Δx 없이. 칩 속도는 모수 r 의 사전 범위로 흡수한다. Δx 는 r 을 데이터로 좁히는 후보로 남는다
  >
- [D51-5] 오차 막대는 회귀 잔차가 아니라 종단 칩 **leave-one-out** 으로 낸다. n·A·Δx·식·오차
  막대를 블라인드 첫 P/E 전에 S-1 §15 추기로 커밋한다 — §7
- [D51-6] 블라인드 2칩은 **무리마다 하나**. 느린 무리는 남은 칩이 chip08 뿐이라 chip08 로
  고정. 정답은 장세은이 봉인(해시만 커밋), 체크포인트 없이 끝에서 §6 절차로 잰다. 3인 구조에서
  완전 블라인드가 아님을 보고서에 명시한다 — §8 · `[D23-14]` 뒤집음
- [D51-7] 온도 축(계수 스윕 25→50→80→25 · 80°C 종단)은 이 모델과 **독립된 확장**이다. 시간이
  없으면 폐기해도 모델은 서고, 살아나면 보정 항으로만 붙는다 — §3

## 근거

### 1. 기호 — 리포가 이미 x 를 쓰고 있었다

파이프라인 문서가 "곡선의 x=0 점"·"x축을 만든다", 집계표가 "신품 x=0" 이라 새 글자를 들이면
두 벌이 된다. 후보와 탈락: `N` 은 `N_READS_CFG=112` 와 충돌, `C` 는 checkpoints.csv 의 「C 행」과
충돌, `P`·`E` 는 프로그램·소거와 겹친다. `k` 는 신뢰성 문헌 관례라 충돌은 없으나 리포 전례가
없어 표기 통일 작업이 하나 더 생긴다. S-1 §15 09-26 추기의 「블라인드 N」 세 곳은 같은 혼동이
있으므로 추기 날짜를 달고 `x` 로 고칠 대상이다.

### 2. 스윕은 x 정보를 갖지 않는다 — 데이터 보존 때문이 아니라 H1 때문에

처음 걱정은 "현장에서는 데이터를 지울 수 없으니 스윕만 가능하고, 스윕은 욕조 곡선만 준다" 였다.
두 전제가 다 틀렸다. 폭은 chip01 300k · chip03 100k(25·45·75MHz) 에서 3σ 안에 있었다(H1 참) —
폭은 나이를 안 담는다. 그리고 소거·프로그램 시간은 지우지만 **백업 → 소거 → 원본 복원**으로
데이터가 보존되며, 복원 쓰기가 곧 프로그램 시간 측정이다. 그 섹터에 P/E 1회가 든다.

하드웨어 관점에서는 가정이 반대다. 소거 시간은 WIP 비트 폴링 + µs 타이머라 아무 MCU 로 되고,
위상 스윕은 MMCM 이 있는 FPGA 에서만 된다. 소거 시간이 노화 지표라는 결론은 현장 배포에 유리한
쪽이다.

**프로그램 시간을 뺀 이유.** chip01 은 145k 부터 섹터 순서 기울기로, chip03 은 20k 부터 7섹터
균일하게 올라 두 칩이 반대 방향이다. 여기에 현장 데이터는 임의 패턴이라 0x00 을 쓰는 마모
루프와 프로그램 시간이 같은 눈금인지 확인이 없다. 패턴 의존성 검증은 시간이 없어 차후 연구
과제로 미룬다 — 그래서 역산 입력에서 빼고 보조 지표로만 남긴다.

### 3. 온도 — 비율이 1차로 상쇄하므로 상수로 둔다

온도가 들어갈 자리는 둘이다. ⑴ 측정 시점 온도(보정 변수): e 와 e₀ 가 같은 prep 안에서 같은
온도로 측정되므로 온도 효과가 1차로 나뉘어 사라진다. 남는 2차 항(온도 계수가 마모 정도에
따라 다를 때)은 크기를 모르니 오차 막대에 넣는다. ⑵ 마모 이력의 온도(노화 축): 블라인드
칩의 **과거** 온도는 측정할 수 없어 입력이 될 수 없고, 온도별 종단 곡선을 세울 시료도 없다.
그래서 모델의 전제는 「상온 마모 이력」이고 이것은 약점이 아니라 범위 정의다.

대가는 chip03 원격 섹터의 일간 차이 2%(9/15 vs 9/27)가 보정 없이 오차에 들어간다는 것이다.
그래서 교정 곡선 체크포인트와 블라인드 prep 은 같은 실내·같은 리그·정착 뒤에 재고, TMP117
이 왔으니 prep 마다 온도를 한 줄 기록한다. 기록이 없으면 "측정 온도 25±2°C" 를 보고서에 쓸
수 없다.

온도 축을 살릴 경우의 설계도 여기 적어 둔다. 계수 스윕은 마모된 칩(chip03·04·07, chip01 은
베이크 시료라 prep 금지)을 25 → 50 → 80 → **25** 로 prep 한다 — 마지막 25 는 가열 자체가
트랩 전하를 풀어 소거 시간을 영구히 바꾸는 어닐링과 온도 계수를 가르는 되돌림 점이다. 80°C
종단은 "고온 P/E + 22시간 베이크" 가 설계상 섞이며 후자는 chip01 베이크 시험이 따로 재 준다.
새 칩을 사면 로트가 달라질 수 있어 **상온 종단 브릿지 1개**가 필요하다 — 온도 효과와 로트
효과가 완전히 겹치기 때문이다. 현장 모델은 같은 칩 원격 섹터로 정규화하므로 로트에 덜 민감하다.

### 4. 비율도 차도 chip01·chip03 을 겹치지 못했다 — 차이는 오프셋이 아니라 속도

체크포인트 p50 으로 chip03 격자에 chip01 을 로그 보간해 맞댔다. 비율 t/t₀ 는 두 칩 사이가
100k 로 갈수록 벌어져(1k 에 1.25배 → 100k 에 2.05배), 차 t−t₀ 는 10k 이상에서 2배로 일정했다.
chip03 값을 chip01 곡선으로 역산하면 비율은 x̂/x ≈ 0.1, 차는 ≈ 0.3 — 둘 다 못 쓰는 수준이고
차가 덜 나쁘다. 「소거 시간이 곱셈적으로 자라니 비율이 자연스럽다」 는 사전 직관은 데이터가
지지하지 않아 철회했다.

거듭제곱 `e − e₀ = A·xⁿ` 을 맞추면 두 칩 다 로그 잔차 8% 안에 들어오고, n 은 0.45(chip01) ·
0.60(chip03) 으로 가까운데 A 가 0.33 vs 0.036 으로 **10배** 다. 정규화가 실패한 이유가 A 다.
비율·차는 곡선을 한 파라미터로 밀거나 늘리는 것이라 A 를 지울 수 없다.

문헌은 형태를 받쳐 준다. NOR 소거는 「펄스 → 검증 → 미달이면 다시 펄스」 루프이고, 터널
산화막의 전자 트랩이 검증 통과까지의 펄스 수를 늘린다(Macronix AN0291 · Micron TN-12-30).
트랩 축적은 사이클 수의 제곱근(Mielke et al., IEEE TDMR 2004) 또는 지수 0.3~0.6 의 거듭제곱
(NAND 계면·벌크 트랩 연구)으로 보고된다. 우리 n 0.45~0.60 이 그 범위 안이다. 프록시가 원문
PDF 를 막아 초록·요약만 확인했으므로 지수 수치는 원문으로 재확인이 필요하다. 「검증 통과까지의
프로그램 펄스 수로 블록 나이를 추정한다」 는 발상은 Micron 특허(US 8036035 · 8358538)에 있어
보고서에 선행 기술로 인용하고, 우리 차별점은 **칩 밖에서 WIP 시간만으로** 재는 것과 §6 의
두 번째 dose 다.

### 5. 4칩을 놓으면 두 무리다 — 신품 소거 시간이 속도를 분류한다

chip04·07 의 100k 값(각 세션 checkpoints.csv 의 cycle=100000 행, chip04 는 지민 세션)을 받아 4칩을
놓았다.
chip01 값은 파일럿 체크포인트가 63.7k 와 137k 사이에 점이 없어 보간이 과소였고, 90,001-100,000
구간 A 행 p50 으로 다시 뽑았다.

신품 집계표를 정렬하면 9칩이 25.7~33.7ms 여섯과 47.0~51.1ms 셋으로 갈리고 사이 13ms 가 비어
있다. 마모한 칩의 100k 비율은 빠른 무리(chip01·04) 3.97·3.54, 느린 무리(chip03·07) 1.74·1.58.
**초과량 e−e₀ 로 보면 빠른 무리 두 칩이 85.4·85.9ms 로 사실상 같고**, 느린 무리는 27·38ms 로
30% 벌어진다. 무리 안에서 신품 순서와 비율 순서가 뒤집히므로(chip07 < chip03) "신품이 빠를수록
비율이 크다" 는 단조 가설은 버리고, t_ref 는 속도를 연속 예측하는 것이 아니라 **무리를 분류**
한다고 본다. UID 앞자리와는 무관하다 — `DF` 인 chip10 이 빠른 무리 한가운데다.

이 구조는 4칩을 본 뒤 찾은 패턴이라 사전 등록이 아니다. chip04 에 대한 예측도 값을 받은 뒤
적은 사후 확인이다. 진짜 예측으로 남길 수 있는 것은 아직 안 태운 칩에 대한 것뿐이며 §7 의
H7 이 그것이다.

### 6. 두 번째 dose — 미지수 둘에 측정 둘

prep 한 번은 숫자 하나를 주고 미지수는 x 와 A 둘이다. 어떤 정규화를 쓰든 식 하나로 둘을 못
푼다. 후보를 늘어놓으면: ⑴ x 축 정규화(AFT) — τ_chip 을 알아야 해 같은 문제. ⑵ 속도를 t_ref
로 예측 — §5 에서 무리 분류까지만 성립. ⑶ 같은 prep 안의 다른 관측(근접 대조군 교란·프로그램
시간·섹터 분포) — 2칩으로는 가능성 이상 말할 수 없음. ⑷ 계층 모델 — 정확도가 아니라 오차
막대를 넓히는 장치. ⑸ 회귀 대신 구간 분류 — 후퇴선. ⑹ **알려진 소량의 추가 마모**.

⑹ 을 채택한다. 초과량 `e−e₀ = A·xⁿ` 과 기울기 `de/dx = A·n·xⁿ⁻¹` 을 나누면 A 가 사라지고
`x̂ = n·(e−e₀)/(de/dx)` 다 — 쌓인 양을 쌓이는 속도로 나누면 걸린 시간이 나오고 비례 상수가
n 이다. 교정 칩에서 가져오는 것은 n 하나. n 을 0.52 로 두고 실제가 0.60 이면 오차 15% 다.
비용은 1섹터 × 1k-2k 사이클 ≈ 2-3분(1사이클 ≈ 소거 1회 + 16페이지, 추정)과 P/E 1% — 벤치
종단의 22시간은 7섹터 × 100k 의 값이라 현장과 자릿수가 다르다. 처음엔 prep 1회 식(무리별
A_g)을 주 결과로 두고 Δx 를 선택으로 뒀으나, 느린 무리의 A_g 산포 30% 가 그대로 오차 막대가
되므로 Δx 를 **필수**로 올렸다. prep 1회 식은 "Δx 없이 얼마나 되는가" 의 비교선으로 남긴다.

e₀ 를 현장에서 어떻게 얻나 — **같은 칩의 안 쓴 섹터**다. chip03 100k 뒤 newchip 에서 마모
영역 128KB 밖 섹터가 신품 대비 0.98 이었다(11일·재장착 뒤). 개체 편차는 칩 사이의 것이고 칩
안의 안 쓴 섹터는 그 칩의 e₀ 를 지닌다. 현장 NOR 은 코드 영역(XIP, 펌웨어 갱신 때만 소거)과
핫스팟(EEPROM 에뮬레이션·카운터·링 로그·부트 플래그, 웨어 레벨링 없이 같은 섹터)이 한 칩에
공존하므로 이 조건이 기본형이다. e₀ 의 잡음은 칩 안 섹터 간 ±10%(집계표 min/max) 이고, 원격
섹터 여러 개의 중앙값으로 줄인 뒤 남는 것이 적용 하한(e−e₀ 가 5ms 를 넘는 3k 근처, 추정)으로
나타난다. 근접 대조군(7-13)은 10% 오염돼 e₀ 로 못 쓴다 — 범위는 `[U48-8]`.

계단 칩(chip01 형)에서는 Δx 구간이 21ms 계단에 걸리면 기울기가 과대, 평탄 구간이면 과소다.
Δx 를 넉넉히 잡아 얼마나 막히는지는 A 행이 답하고, 못 막으면 x̂ 를 구간으로 보고한다.

### 7. 과적합 — 유효 표본은 39도 70만도 아니고 칩 수다

데이터가 많아 보이지만(3칩 × 13 체크포인트, A 행 칩당 70만 행) 블라인드가 묻는 것은 「다른
칩에서 맞는가」 이고 한 칩 안의 70만 행은 그 질문에 표본 1개다. 그래서 형태는 물리와 단조성으로
고정하고(자유 파라미터 0~2개) 데이터로는 칩 간 산포만 잰다. 회귀는 정방향(`e = g(x)`, x 는
실행기가 세는 값이라 오차 0)으로 하고 역함수로 x̂ 를 구한다 — 분석화학의 검량선(inverse
prediction) 그대로다. 역방향 회귀는 errors-in-variables 편향이 생겨 탈락.

성능은 학습 잔차가 아니라 **LOO** 로만 말한다. 칩 하나를 빼고 나머지로 n(·A_g)을 정한 뒤 뺀
칩의 각 체크포인트에서 §6 절차대로 x̂ 를 내는 것을 칩 수만큼 반복하고, x̂/x 의 중앙값·범위가
블라인드에 미리 적는 오차 막대다. 잔차를 쓰면 칩 안 잡음이라 작게 나와 자신을 속이는 숫자가
된다. 이 막대와 함께 다음을 S-1 §15 추기로 커밋한다 — n · 무리 문턱 40ms · e₀ 섹터 규칙 ·
Δx · 식, 그리고 안 태운 칩에 대한 예측:

> (H7, chip04·07 을 본 뒤의 예측) 신품 소거 40ms 미만 칩은 100k 에 e−e₀ = 86±10ms, 40ms
> 이상 칩은 33±10ms. 블라인드 칩의 무리는 원격 섹터 소거 시간으로 개봉 전에 판정한다.

### 8. 블라인드 — 무리마다 하나, 봉인은 장세은, 완전 블라인드는 아니다

마모 안 한 칩은 빠른 무리 chip06·09·10(02 는 앵커, 05 는 측정 불가), 느린 무리 **chip08 하나**.
둘 다 빠른 무리에서 뽑으면 느린 곡선의 검증이 0 이고 무리 분류 자체가 시험되지 않으므로
chip08 은 대조군·예비로 돌리지 않는다. 종단 3 이 chip06 → chip07 로 바뀐 경위(9/27)는 아직
리포에 없다 — 등록부와 로그 48 후속 절이 받는다.

절차의 골격은 로그 23 부록 D 의 네 항목을 그대로 채운다. ⑴ 사전 커밋 vs 로컬 보관 → 해시만
커밋, 원본은 장세은 로컬, 개봉 시 대조. ⑵ 시간 누설 → 체크포인트를 찍지 않아 CSV 채널을
막고, 두 칩을 한 무인 세션에서 연속으로 돌려 개별 소요 시간을 섞는다. 커밋 시각·보드 점유는
그래도 새므로 ⑷ 3인 구조에서 완전 블라인드가 아님을 보고서에 명시한다 — 절차를 더 복잡하게
해도 막히지 않는 채널이라 명시가 정직하다. ⑶ 측정은 끝에서 1회가 아니라 §6 의 prep → Δx →
prep 이며, 봉인된 x 에 Δx 가 더해지는 것은 정답이 x+Δx 가 될 뿐 봉인과 충돌하지 않는다.
워크플로 5 「보류 — 블라인드 이해충돌」 의 해소안(설계 한영웅 · 봉인 장세은 · 추정 한영웅)을
채택한다. 격자는 10k~90k 안.

## 미결

- **[U51-1] Δx 의 값** — 1k 인가 2k 인가 5k 인가. 4칩 A 행에서 각 Δx 로 기울기를 재 x̂/x 의
  분산이 가장 작은 값. 계단 칩에서 얼마나 막히는지가 같이 나온다
  > **2026-10-01 — 1k·2k 는 탈락, 5k-10k 만 후보 ([로그 48](48.pilot_wear_handler_and_plan_approval.md) §23).** 1k 사이 변화 0.04ms 가
  > 한 번 잴 때 폭 4-8ms 의 100분의 1이라 앞뒤 한 번씩으로는 안 된다. 매 사이클 A 행 회귀로 5k-10k 를 모의 블라인드에서 시험한다.
  > 1차 블라인드에는 넣지 않는다
  > **2026-10-05 — 5k · 10k 도 탈락, Δx 는 뺐다 ([로그 48](48.pilot_wear_handler_and_plan_approval.md) §41 [D48-93]).** 교정 7칩 모의 블라인드에서
  > 20k 아래만 좋아지고, 계단 칩(chip18)과 후반 느린 칩(chip15)에서 기울기가 틀린 쪽으로 구간을 좁혔다
  >
- **[U51-2] n 은 공통인가** — 무리 사이에 n 도 다르면 무리별 n 이다. chip04·07 의 A 행(또는
  13점 checkpoints.csv)이 리포에 없어 아직 못 돌렸다. §7 의 LOO 도 같은 데이터가 선행 조건
- **[U51-3] 빠른 무리의 블라인드 칩** — chip06·09·10 중 하나. 대조군 2·예비와 함께 정한다
  > **2026-10-01 — 닫힘 ([로그 48](48.pilot_wear_handler_and_plan_approval.md) §23, [D48-50]).** chip06 블라인드 · chip09 교정 · chip10 예비
  >
- **[U51-4] 프로그램 시간의 패턴 의존성** — 0x00 루프와 임의 데이터 복원 쓰기가 같은 눈금인지.
  차후 연구 과제로 미뤘고, 확인되면 프로그램 시간을 역산 입력으로 올릴지 다시 본다
- **[U51-5] 종단 4칩 곡선의 승격** — `docs/results/` 에 chip04·07 해석 문서와 §4·§5 의 겹침
  그림(지금은 스크래치)을 어디에 어떤 이름으로 둘 것인가
