young-0320/flash-margin-bench/docs/log/young/26.resume_after_papers_and_day_plan.md

# 26. 재개 — 팀원 논문 조사 반영, 실칩 검증일(9/15) 절차, project_context 정합

- **작성일**: 2026-09-14
- **발단**: [로그 24](24.sweep_wrapper_uid_pipeline_impl.md) §8(9/8) 이후 팀원 커밋 2건(`64deb89` 세은 9/11 ·
  `e229b04` 지민 9/14)이 들어왔고, 래퍼는 아직 실칩에서 한 번도 돌지 않았다. 내일 첫 실행을
  앞두고 순서표를 만들고 낡은 문서를 맞춘다
- **목적**: 세은이 제안한 마모 패턴 체커보드를 채택할 것인가? 내일 첫 실행에 무엇이 낡은
  채로 남아 있나?
- **관련**: `docs/workflow/7.realchip_uid_verification_day.md` ·
  `docs/workflow/9.sept_meeting_role_split.md` · `docs/project_context.md` ·
  [로그 27](27.vivado_2025_2_migration_plan.md) · [로그 28](28.realchip_day_chip02_chip03.md)

## 결정

- [D26-1] 마모 패턴은 `0x00` 유지 — 세은의 체커보드 제안은 지금 채택하지 않는다.
  **닫힌 것이 아니라 보류다** (2026-09-14, 한영웅) — §3

  > **2026-09-15 — 뒤집혔다 (3인 회의, 한영웅).** 체커보드도 **채택**한다. `0x00` 과
  > 체커보드를 **여러 패턴으로** 읽고 쓰기로 했다 — 보류가 아니라 둘 다 쓴다.
  > 그 회의는 따로 문서화하지 않았으므로 **이 추기가 기록이다.** 레지스터는
  > [로그 29](29.pe_engine_layer_decisions.md) [D29-7] 이 이미
  > `WEAR_PAT_EVEN`/`WEAR_PAT_ODD` 로 설계해 둬 값만 바꾸면 된다.
- [D26-2] 런북 3 은 손대지 않고 워크플로 7 머리에 "이 문서로 대체"를 적는다. 런북 3 이 당일
  절차의 원전이므로 갱신은 별건이다 — §5 · `docs/workflow/7.realchip_uid_verification_day.md`
- [D26-3] 워크플로 7 §0 표에 "빌드 산출물 mtime 이 소스보다 뒤인가"를 항목으로 넣는다 — §2 ·
  `docs/workflow/7.realchip_uid_verification_day.md`
- [D26-4] `project_context.md` §1~§3·§5·§6·§10 은 손대지 않는다 — 철학·범위는 여전히 맞다 — §4 ·
  `docs/project_context.md`

## 근거

### 1. 팀원 논문 조사 2건 — 읽고 남기는 것

내용은 `docs/ref/` 두 문서가 정본이다. 읽고 남는 것만 적는다.

| 문서 | 보고서 활용 | 사양에 닿는 것 |
| ---- | --- | --- |
| `docs/ref/선행논문_조사.md` (세은) | 배경·차별점(사전 계측 vs 사후 복구) | **마모 패턴 체커보드 제안** — §3에서 결정 |
| `docs/ref/해외논문_조사.md` (지민) | 서론 대비표("제조사급 접근권 없이 외부 관측값으로")가 그대로 쓸 만하다 | 없음. "ECC count·Fail map"은 NAND 확장 항목이라 base 주장과 섞지 않도록 집필 시 주의 |

둘 다 결론이 같다 — *내부 물리량을 못 보는 제약을 FPGA 위상 스윕으로 우회한다*. 이 문장은
`project_context.md` §3.2와 일치하므로 서론은 이 셋을 합치면 된다.

### 2. 워크트리에서 빌드한 것은 main 으로 오지 않는다

| 파일 | mtime |
| ---- | ----- |
| `build/vitis_prep/flash_prep/build/flash_prep.elf` (main) | 2026-09-07 23:53 |
| `ps/src/flash_prep.c` (로그 24 §8 「중요 1」 수정) | 2026-09-08 00:18 |

그 수정 빌드는 워크트리 `.claude/worktrees/fix-sweep-wrapper-review`에서 돌았고,
`build/`는 워크트리마다 따로라 **main의 ELF는 UID 재시도 루프 수정 전**이었다. 내일 그대로
갔으면 `#PREP ERROR`가 재시도 중에 찍혀 래퍼가 첫 전송 실패에서 죽는, 로그 24 §8 이 고쳤다고
기록한 바로 그 경로를 다시 밟았을 것이다.

`g3_chip_25` 비트스트림(7/8)·`g3_sweep.elf`(7/9)는 소스 무수정이라 재빌드가 필요 없다.

> **2026-09-14 밤 — 이 재빌드는 2025.2 전환에 흡수됐다 ([로그 27](27.vivado_2025_2_migration_plan.md)).**
> 다른 세션이 같은 날 Vivado 2025.2 통일(워크플로 8)을 실행해 `build/`를 통째로 2025.2로
> 재빌드했다(23:00~23:06). 2024.2 산출물은 `build_2024.2/`에 남아 있고(보험 비트 pl4/pl6 포함),
> `program_g3.tcl`의 `BUILD_DIR`로 고를 수 있다. 워크플로 7의 환경 경로·빌드 세대·판정
> 주의(§0·§1·§4·§6)를 이에 맞춰 고쳤다. 번호도 정리했다 — 워크플로 7 실칩 검증일 / 8 Vivado
> 통일 / 9 회의, 로그 26 본 문서 / 27 Vivado / 28 실칩 당일.

### 3. 마모 패턴은 0x00 유지 — 체커보드의 인용 근거가 NAND 다

1. **인용 근거가 NAND다.** 셀 간 간섭(cell-to-cell interference)을 키워 빨리 지치게 하는
   논리는 셀이 직렬로 붙은 NAND 스트링에서 성립한다. NOR는 셀이 병렬이고 간섭 메커니즘이
   다르다.
2. **간섭이 어느 셀까지 미치는지 모른다.** [로그 16](16.wear_bench_spec_decisions.md) 때
   논의한 대로, 체커보드가 인접 셀
   "하나"에만 영향을 준다는 보장이 없고 논리-물리 매핑도 비공개라(`project_context.md` §6)
   그것을 찾는 비용이 실험 하나다. S-1은 그래서 완충 대신 **근접 대조군(파일럿 기준 섹터 7\~13, S-1 §2.1)으로
   간섭 유무를 측정**하는 쪽을 택했다.
3. 0x00의 근거(모든 비트 1→0, 최대 스트레스, 비트 천이 없음이라 측정 패턴 PRBS15와 분리)는
   그대로 유효하다.

**닫힌 것이 아니라 보류다.** 파일럿 칩(S-1 §15)이 300k에서 폭 이동을 보이지 않으면
가속 수단이 필요해지고, 그때 체커보드는 후보 1순위다. 세은 문서는 그대로 두고(팀원 소유)
이 로그가 답이다 — 통지 목록에 추가.

### 4. `project_context.md` 에서 손대지 않은 것

§1\~§3·§5·§6·§10(철학·범위)은 여전히 맞다. §5 "golden model" 문구는 `sim/golden/` 폴더
부재(roles 미결)와 무관하게 사실이므로 유지한다.

### 5. 런북 3 D3 는 낡았는데 원전이라 손대지 않는다

런북 3 D3의 `sweep_uart_capture.py --target chip01` 명령은 `--target` 삭제로 더는 돌지
않는다. 런북 3은 당일 절차의 원전이므로 갱신은 별건이다 — 런북은 손대지 않고 워크플로 7
머리에 "이 문서로 대체"를 적었다.

## 산출물

| # | 산출물 | 위치 |
| - | --- | ---- |
| 1 | 9/15 회의 안건 (역할 배분 변경안, 확정할 것 3건, 서명·통지, 각자 할 일) | `docs/workflow/9.sept_meeting_role_split.md` |
| 2 | 9/15 실칩 검증일 순서표 (전날 준비 → 배선 → 1차 실행 → 세 곳 대조 → 분석 → 재장착 3회 → W5-D 판정 → 보관) | `docs/workflow/7.realchip_uid_verification_day.md` |

## 미결

- **[U26-1] 워크플로 7 §9 표가 9/15 실행 결과로 닫힌다.** 판정 문장은 그날 로그 28에
  ([로그 27](27.vivado_2025_2_migration_plan.md)은 Vivado 2025.2 전환 로그)

  > **2026-09-16 — 닫혔다 ([로그 28](28.realchip_day_chip02_chip03.md)).** 9/15 측정 결과와
  > 그날의 결정 4건이 예약해 둔 그 번호에 들어갔다.
- **[U26-2] 통지 목록 (누적)** — [로그 24](24.sweep_wrapper_uid_pipeline_impl.md) 미결 5의
  항목 + 본 로그 §3(세은에게 마모 패턴 결정) + 수정안 #3 승인 요청(박지민·장세은).
  9/15 결과를 근거 자료로 붙여 한 번에 보내는 편이 낫다

  > **2026-09-18 — 닫혔다 (한영웅).** 셋 중 둘이 없어졌다 — 마모 패턴은 9/15 회의에서
  > 논의돼 [D26-1] 이 뒤집혔고, **수정안 승인 요청이라는 절차는 리포에 실재하지 않는다**
  > (워크플로 9 §3 「서명·통지」는 회의 안건 목록이지 승인 시스템이 아니다). 남은 실물은
  > [로그 24](24.sweep_wrapper_uid_pipeline_impl.md) [U24-5] 한 곳이고 거기가 정본이다.
- **[U26-3] 런북 3 D3 갱신** — `--target` 명령을 래퍼 한 줄로 바꿀지, 워크플로 7을 원전으로
  승격할지
- **[U26-4] 일정 재산정** — 워크플로 5 마감(8/31 G5) 2주 초과. 10월 최종보고 기준으로 마모 300k
  (칩당 33.7h + 체크포인트)가 파일럿 1 + 종단 3에 들어가는지 역산이 필요하다. W5-D 판정
  뒤에 한다

  > **2026-09-18 — 닫혔다.** 역산했고 결과는 `docs/workflow/10.newchip_survey_completion.md`
  > 「10/6 최종보고까지 — 마모 일정 역산」이다. **들어간다** — 144.4h ≈ 6.0일이고 10/6 까지
  > 8일이 남는다. 임계 경로는 마모 시간이 아니라 G5 ③ 블라인드 절차(미설계)·W10-M(2/10)·
  > 마모 엔진 순이다.
- **[U26-5] 워크트리 정리** — `.claude/worktrees/fix-sweep-wrapper-review`가 locked 상태로 남아
  있다. 커밋은 이미 main에 있으므로 제거해도 된다(사람 확인 후)

  > **2026-09-18 — 닫혔다.** `.claude/worktrees/` 가 없고 `git worktree list` 도 main
  > 하나뿐이다. 이미 정리됐다.
  > **2026-09-18 — 닫혔다.** `.claude/worktrees/` 가 없고 `git worktree list` 가 main 하나만
  > 낸다. 워크트리는 이미 제거됐다.
