young-0320/flash-margin-bench/jimin.md

# P/E 엔진 스펙 회신 — 한영웅 → 박지민

- **날짜**: 2026-09-18 (2026-09-19 보완 — TB 미비점 보완분 반영)
- **대상**: `docs/log/jimin/2.pe_stress_bench_ai_prompt.md` (2026-09-15, P/E 스트레스 벤치 구현용 AI 프롬프트)
- **보내는 것**: ① 엔진 경계 7개(스펙) ② 뼈대와 재량 ③ 첫 프롬프트 수정사항 ④ 구현용 프롬프트 갱신 패치
- **이 파일은 전달용 임시본입니다.** 정본은 리포의 `docs/spec/s4.blackbox_tb.md` §5.1·§5.2 와 `docs/interface/pe_engine.md` §2 입니다.
- 본문의 `:숫자` 는 지민 프롬프트의 **줄 번호**이고, 리포 쪽 기준은 **GitHub `main` 최신(2026-09-19)** 입니다.

---

# 표지 — 지민이 정해야 하는 것만

**본문은 40KB 입니다. 이 한 장만 보셔도 진도가 나갑니다. 나머지는 근거와 참고입니다.**

## A. 답이 꼭 필요한 것 — 4개 (본문 §6)

| # | 질문 | 없으면 |
| - | ---- | --- |
| 1 | **체크포인트에서 엔진이 스스로 멈추고 `checkpoint_due` 로 알리나?** 프롬프트 `:390` 은 이것을 **호스트 실행기 책임**으로 적었습니다 | UART 포트가 하나인데 체크포인트가 분 단위라, 엔진이 안 멈추고 계속 뱉으면 **호스트 버퍼가 넘칩니다** |
| 2 | **재개 9단계 중 3·4·5(호스트 로그 판독·대조·선택)를 호스트로 넘겨도 되나?** 그리고 **§8.3 5번의 재소거를 무엇으로 부르나?** 경계 7개에 그 수단이 없습니다 — ⓐ `wear_resume()` 안에서 자동 ⓑ 경계 8 `reerase()` 신설. 어느 쪽이든 **그 재소거가 X축에 세어지는지**도 같이 | 엔진이 호스트 로그를 읽을 수 없어 `:363` 이 성립하지 않고, **S-1 §13 B 의 두 번째 통과 조건**(부분 소거 → 재소거)을 아무도 못 밟습니다 |
| 3 | **1사이클 순서에 「⑥ A 로그 출력」을 넣어 주세요** (확인만) | `:190-196` 에 출력 단계가 없어 **A2 의 700행이 호스트에 닿는 경로가 없습니다** |
| 4 | **검사 사이클만 「①프로그램 → 검사 → ②소거」로 분기**하고, **`blank_check` 는 부를 때 실제로 읽어서 세 주세요**(마지막 결과 캐시 금지). S-1 §7 이 *"프로그램 직후"* 에 재라고 하는데 §6 루프는 소거가 끝난 ④에서 잽니다 — **동결본 두 절이 서로 어긋나 있습니다** | `program_fail_bits` 가 **영구히 측정 불가**입니다. 이건 「칩이 실제로 마모됐나」를 증명하는 **유일한 논리 경로**라, 없으면 tally 가 100 을 가리켜도 그게 장부인지 사실인지 구분할 방법이 없습니다 |

## B. 기본값 없이 지민이 정하는 것 — 2개

| 정할 것 | 우리가 거는 조건 |
| --- | --- |
| **층위** (RTL 엔진 / PS C / PS C + 핀 mux) | 없습니다. **전적으로 재량**입니다 |
| **명령 채널 = 제안-1** (경계 7개를 무엇으로 부르나) | 하나뿐 — **ELF 재빌드 없이** `wear_start` 의 네 인자와 `wear_resume` 이 들어갈 것 |

**재소거를 어디에 붙이나**(제안-9)도 기본값이 없는데, 그건 위 **A-2** 에 붙여 여쭙습니다.

## C. ⚠️ 안 읽고 넘기면 굳는 것 — §4 표 10줄

행 문법 · 체크섬 · 오류 코드 6종 · `defect_addrs` 인코딩 · `die_temp_mc` · `timestamp` u64 ·
`t_program_us` 정의 · 체크포인트 반올림 · tally 대안 · 공통 필수를 어디에 싣나.

**전부 기본값을 붙여 보내고, 회신에 언급이 없으면 그대로 확정합니다.** 우리가 이미 돌려 본
실물(`host/tests/`)이라 그대로 가도 동작합니다. **바꾸고 싶으면 그 줄만** 알려 주십시오.

## D. 첫 프롬프트에서 바뀌는 것 — 5줄

1. **「두 tally 가 다르면 큰 값 채택」은 폐기**합니다 — tally 해상도가 100 이라 부등호로는 아무것도 안 갈립니다. `d` 규칙으로 갑니다 (§1)
2. **판단 주체는 호스트**입니다. 엔진은 재료만 돌려줍니다 (제안-5)
3. **사이클 카운터는 마모 루프만** 셉니다. 체크포인트의 소거+PRBS 는 `area_cumulative_cycles` 로 갑니다 (§1)
4. **로그 행에 체크섬이 붙습니다** — UART 에 패리티가 없어서, 없으면 숫자 비트 반전을 아무도 못 잡습니다 (제안-4)
5. **테스트는 새로 짜지 않습니다** — 채점표가 `host/tests/` 에 이미 있습니다. 엔진 구현자가 채점표를 다시 짜면 그 둘이 서로를 검증하지 못합니다

## E. 답이 필요 없는 것

- **`far`(섹터 2,041) 스윕은 오늘 하드웨어로 불가능합니다** — RTL 11비트 `BASE_SECTOR` 미구현(구현 0건). 파일럿은 wear·near 까지만 (§5.0)
- §5.2 의 일곱 항목(WIP 타임아웃·`flash_prep` 전소거·포트/baud·로그 파일 분할 등)은 **우리가 처리합니다**

---

## 0. 세 줄 요약

1. **스펙을 보지 않고 블랙박스 TB 를 먼저 짰습니다**(`host/tests/`, 49 케이스 통과). 막힌 자리가 그대로 아래 제안 목록이 됐습니다.
2. **지민 프롬프트가 S-1 을 따랐던 두 곳은 우리 쪽이 틀린 것이었습니다 — S-1 을 먼저 고쳤습니다**(§1). 그 두 건은 답하실 필요가 없습니다.
3. **답해 주실 것은 4개뿐**입니다(§6). 나머지는 **기본값을 붙여 보내므로 회신에 언급이 없으면 그대로 확정**됩니다.

---

## 1. 먼저 — 우리 쪽을 고쳤습니다 (S-1 개정 4건 — 9/18 세 건 · 9/19 한 건, 모두 반영 완료)

프롬프트 §5.1·§5.2 의 **「두 tally 가 다르면 큰 값 채택」** 은 지민이 지어낸 게 아니라 **S-1 §8.2·§8.3 을 그대로 따른 것**이었습니다. 그래서 요구하기 전에 우리 사양을 고쳤습니다.

**네 건 모두 `docs/spec/s1.wear_bench_spec.md` 본문에 반영돼 있습니다** — §8.2·§8.3·§1 은 **2026-09-18**, §6·§7 은 **2026-09-19** 입니다. 각 자리에 개정 경위를 인용구로 붙여 두었으니 **열어 보시면 바뀐 이유가 같이 보입니다.** 근거는 로그 41 `[D41-20]`·`[D41-21]` 과 로그 42 입니다.

| # | 고친 곳 | 무엇을 |
| - | --- | --- |
| 1 | **S-1 §8.2** (9/18) | 「큰 쪽 채택」을**tally 2벌 사이로 한정**하고 이름을 **「2벌 병합」** 으로 바꿨습니다. 차이가 1바이트(100) 이하면 큰 쪽으로 병합 + 불일치 기록, **100 을 넘으면 중단하고 사람을 부릅니다**(정상 차단으로 설명되지 않으므로) |
| 2 | **S-1 §8.3** (9/18) | tally 와 호스트 로그를 부등호로 고르던 것을**폐기**하고 `d` 규칙으로 바꿨습니다 (아래) |
| 3 | **S-1 §1 계수** (9/18) | 체크포인트의 소거+PRBS 도 1사이클이지만**영역별 누적(`area_cumulative_cycles`)에만 넣고, 엔진의 사이클 카운터는 마모 루프만 셉니다** |
| 4 | **S-1 §6·§7** (9/19) | §7 은 `program_fail_bits` 를 *"프로그램 직후"* 에 재라는데 §6 루프는 소거 뒤 ④에서 쟀습니다 — **두 절이 서로 어긋나 있었습니다.** §6 에 ①'(프로그램 직후 검사)를 넣고, §7 에 **「부를 때 읽어서 센다」** 를 붙였습니다 (제안-10) |

### 왜 「큰 쪽 채택」이 안 되나

tally 는 100사이클마다 1바이트라 **해상도가 100** 입니다. 147사이클 시점에서 `tally×100 = 100`, 호스트 로그 `= 147` 이므로 **`tally < 호스트로그` 는 늘 참**이고, 부등호로는 「호스트만 죽었다」와 「정상 중단」이 구분되지 않습니다. 가르는 것은 **차이의 크기**입니다.

```
d = (A 로그의 최대 cycle) − (tally × 100)

  0 ≤ d < 100   정상                                   → 호스트 로그 채택
      d < 0     호스트 죽음 (A 가 멈추고 tally 만 앞섬)  → tally×100 채택 + 결손 구간 기록
      d ≥ 100   tally 가 안 는다                        → 채택하지 않고 tally 다음 바이트를 본다
                  · 0xFF        → tally 쓰기 전에 끊긴 정상 차단. 호스트 로그 채택하고 계속
                  · 그 외 값    → ±1 불확실로 기록
                  · write 실패  → 플래시가 안 써진다. 중단하고 사람을 부른다
```

**이 판단은 호스트가 합니다.** 엔진은 재료만 돌려주면 됩니다(경계 3).

### 왜 카운터가 체크포인트를 세면 안 되나

S-1 §13 A5 의 통과 조건이 *"카운터 / A행수÷7 / B의 cycle / **tally×100** 이 전부 100"* 인데 tally 는 마모 루프만 셉니다. 카운터가 체크포인트까지 세면 **네 경로가 서로 다른 것을 세게 되어 A5 가 성립하지 않습니다.** 프롬프트 §3.3 의 *"wear loop cycle 과 영역별 누적을 같은 변수로 처리하지 말라"* 와 같은 결론입니다.

---

## 2. 엔진 경계 — 7개 (스펙)

**층위(RTL / PS C / PS C + 핀 mux)는 전적으로 지민이 정합니다.** 이 문서는 **밖에서 보이는 모양**만 정합니다. 레지스터 write 로 채우든 C 함수로 채우든 같은 모양이면 됩니다.

| # | 서명 | 없으면 |
| - | --- | --- |
| 1 | `wear_start(base_sector, n_sectors, pattern, cycles)` | 루프를 시작할 수 없다 |
| 2 | `wear_status() → (cycle, state, defect_seen)` | 호스트가 스윕 시점을 모른다 |
| 3 | `wear_resume() → (tally_a, tally_b, mismatch, next_tally_byte, write_ok)` | B(전원 장애 복구)를 판정할 수 없다  |
| 4 | `blank_check(base_sector, n_sectors) → (erase_residual_bits, program_fail_bits, defect_addrs[], defect_addr_count, worst_page_idx, worst_page_bits)` | 부분 소거를 못 잡는다 |
| 5 | `tally_read() → (count_a, count_b, mismatch)` | A5(경로 간 일치)가 성립하지 않는다  |
| 6 | `tally_dump() → 4,096B × 2벌` | `0x00`/`0xFF` 외의 값을 못 본다 |
| 7 | `uid_read() → 16 hex` | 중단 판단을 호스트가 못 한다 |

**값의 규약**

- `pattern` 은 **시작할 때 한 번만** 받습니다. 한 wear 그룹 안에서 변경 금지. 파일럿 고정값 `0x00`
- `cycles` 는 **다음 체크포인트까지의 수**입니다. 엔진은 거기까지만 돌고 멈춥니다
- `state` 는 다섯 — `idle` · `running` · **`checkpoint_due`** · `halted` · `error`
- `cycle` 은 **마모 루프 사이클**입니다 (체크포인트 P/E 는 여기 안 들어감, §1)
- `tally_read()` 는 **2벌을 따로** 돌려줍니다. 엔진이 고르면 호스트가 불일치를 볼 수 없습니다
- `defect_addrs[]` 는 최대 64개 + 총 개수 (페이지·바이트·비트)
- `worst_page_idx`·`worst_page_bits` 는 **프롬프트 §4.4 가 맞았습니다** — S-1 §9 가 요구하는데 우리 경계에 빠져 있어서 오늘 넣었습니다
- **재소거를 부를 수단이 이 7개에 없습니다** — S-1 §8.3 5번(「부분 소거 상태면 해당 섹터 재소거」)이 갈 자리가 없습니다. `wear_start` 는 §8.1 초기화가 안 돌았으면 거부하고 `wear_resume()` 은 채택하지 않으므로 둘 다 아닙니다. **엔진이 재개 안에서 자동으로 하나, 경계 8 로 따로 내나** 가 §6 의 2번에 붙어 있습니다

**경계에 넣지 않은 것과 이유** — `wear_times()`(소거·프로그램 시간은 A 로그에 이미 있음. 같은 값이 두 경로로 나오면 어긋났을 때 어느 쪽이 맞는지 알 수 없음) · `log_tail()`(로그는 호스트가 받아서 가짐. 엔진에 되물으면 「엔진이 뱉었다」와 「호스트가 받았다」의 차이가 가려짐 — UART 행 유실을 실제로 겪었습니다) · 온도 읽기(로그로 나옴) · 체크포인트 실행(호스트 도구).

---

## 3. 뼈대 — 못 박는 것 (9건)

흔들리면 **TB 가 채점을 못 하거나 X축이 비가역으로 틀어지는 것**들입니다. 아래 `:숫자` 는 지민 프롬프트의 줄 번호입니다.

| # | 못 박는 것 | 프롬프트의 현재 상태 |
| --- | --- | --- |
| **제안-6** | **A 로그를 매 사이클 실시간으로 내보낸다** | `:296` 에서 **이미 채택하셨습니다.** 다만 `:190-196` 의 1사이클 순서(①Program ②상태 확인 ③Erase ④상태 확인 ⑤카운트)에 **출력 단계가 없습니다** — ⑥ 으로 넣어 주세요 |
| **제안-10** | **검사 사이클은 「①프로그램 → 검사 → ②소거」로 분기한다** · **`blank_check` 는 부를 때 읽어서 센다** | S-1 **§7 은 *"프로그램 직후"* 에 재라고 하는데 §6 루프는 ④(소거 뒤)에서 잽니다** — 동결본 두 절이 어긋나 있어, 지민 프롬프트 `:306-315` 의 *"Program 검사 시점"* 도 루프 어디인지 정해지지 않았습니다. `:190-196` 의 ②·④ 「완료 상태와 오류 확인」은 **상태 레지스터 확인이지 데이터 대조가 아닙니다.** **← 확인이 필요합니다** |
| **제안-7** | **엔진이 체크포인트에서 스스로 멈추고 알린다** (`checkpoint_due`) | `:390` 이 *"checkpoint 도달 시 안전한 정지"* 를 **호스트 실행기 책임**으로 적었습니다. **← 답이 필요합니다** |
| **제안-5** | **재개에서 엔진은 채택하지 않는다** | S-1 §8.3 을 고쳤으므로 §1 의`d` 규칙을 따르면 됩니다. 다만 `:363`(*"PC 호스트 로그의 마지막 완료 cycle 판독"*)은 **엔진이 호스트 로그를 읽으라는 뜻**이라 경계와 부딪칩니다. **← 답이 필요합니다** |
| **제안-8** | **A1 카운터 = 마모 루프 사이클** | S-1 §1 개정으로 닫혔습니다.`wear_loop_cycles` / `wear_pe_actual` / `near_pe_actual` / `far_pe_actual` 을 따로 두라는 `:236-238` 과 같은 방향입니다 |
| **제안-9** | **재소거를 부를 수단을 정한다** (ⓐ `wear_resume()` 안에서 자동 / ⓑ 경계 8 `reerase()`) | 경계 7개 어디에도 없습니다. `wear_start` 는 §8.1 초기화 미실행이면 거부하고 `wear_resume()` 은 채택하지 않으므로 둘 다 아닙니다. **← 답이 필요합니다**(§6 의 2번) |
| **제안-4** | **로그 행에 무결성 검사 수단이 있다** (체크섬 또는 단조 증가) | 프롬프트 전체에 없습니다.**방식은 재량**(§4) |
| **제안-2** | **거부가 서로 구분되는 형태로 온다** | `:227-228` 의 *"명확한 오류 로그와 비영 종료 상태"* 까지는 왔습니다. 코드가 없어 여섯 가지 거부를 가를 수 없습니다. **이름은 재량**(§4) |
| — | **무결성 로그는 정확히 1행** | `:536` 이 *"1행 이상"* 으로 느슨합니다. S-1 §13 A3 은 **정확히 1행** 입니다 |

**왜 제안-4(체크섬)가 뼈대인가** — `cycle=100` 이 UART 에서 `cycle=900` 으로 바뀌어 와도 **행 수는 700 그대로**라 A5 의 네 경로 중 하나만 조용히 틀립니다. 6일 무인 구동에 UART 는 패리티가 없습니다.

**왜 제안-7 이 뼈대인가** — UART 포트는 하나이고 체크포인트는 분 단위라 그동안 호스트가 `#WEAR` 를 읽지 못합니다. **엔진이 안 멈추고 계속 뱉으면 버퍼가 넘칩니다.**

### 이미 서로 맞아 있어 확인만 하는 것

기존 로그가 있는데 신규 초기화를 시도하면 **거부하고 자동으로 소거하지 않는다**(`:372-373`) · **플래시 동작의 자동 재시도 금지**(`:285-286`. 전송·연결만 3회) · tally 2벌과 불일치 기록 · wear 는 섹터 0–6 만 건드리고 near/far/tally 는 하드 가드(`:208-225`).

---

## 4. 재량 — 지민이 정합니다 (기본값 첨부, 무응답이면 확정)

빈칸으로 보내면 왕복이 한 번 더 돌아서, **우리가 이미 돌려 본 실물을 기본값으로 붙입니다.** 바꾸고 싶으면 그 줄만 알려 주시면 됩니다.

| 정할 것 | 우리 기본값 |
| --- | --- |
| **명령 채널** (제안-1 — 경계 7개를 무엇으로 부르나) | 무엇이든 좋습니다. 조건 하나 —**ELF 재빌드 없이** `wear_start` 의 네 인자와 `wear_resume` 이 들어가야 합니다 |
| **로그 행 문법 = 제안-3** | 아래 전문 |
| **체크섬 방식 = 제안-4** | 본문 바이트 합`mod 0x10000`, 4자리 hex, 행 끝 ` sum=` |
| **오류 코드 이름 = 제안-2** | `REJECT <code>` 6종 — `E_NSECT0`·`E_TALLY_OVERLAP`·`E_RANGE`·`E_CAP`·`E_RUNNING`·`E_DIRTY`. **우리 TB 가 이 코드로 채점합니다** |
| `defect_addrs` 인코딩 | `page:byte:bit` 를 `;` 로, 최대 64개 + 총 개수 |
| `die_temp` 표기 | **정수 밀리도** `die_temp_mc`(B 행). 미확보 시 빈 값 (`xil_printf` 는 부동소수를 못 찍고, XADC 코드가 리포에 0건이라 미확보가 기본 경로입니다) |
| `timestamp` 원천·폭 | 부팅 후 µs,**u64** (기존 `us_since()` 는 u32 µs 라 **71.6분마다 감깁니다** — 300k 사이클 33.7h 에 28회) |
| `t_program_us` 정의 | 섹터의 16페이지**합계** (`:302-303` 이 열어 둔 것) |
| 체크포인트 배치 반올림 | **100 단위 내림** (×2.15·×1.47 이 정수가 아니고 tally 복원 해상도가 100) |
| tally 부분 프로그램이 성립 안 하면 | 페이지당 1바이트(섹터당 16마크) 등 대안 (S-1 §15 ⑥ 이 파일럿 유보 항목으로 열어 둔 것) |
| **공통 필수를 어디에 싣나** (`chip_id`·`git_rev`·`base_sector`) | **세션 헤더 `#WEAR H` 1행.** A 행마다 실으면 300k 에서 2.1M행이 그만큼 길어집니다 |
| **층위** (RTL / PS C / PS C + 핀 mux) | **전적으로 재량** |

### 로그 행 문법 (기본값 전문)

```
#WEAR H chip_id=<16hex> git_rev=<hex> base_sector=<n> n_sectors=<n>
        pattern=0x<2hex> ts=<n> sum=<4hex>

#WEAR A cycle=<n> sector=<n> t_erase_us=<n> t_program_us=<n> ts=<n> sum=<4hex>

#WEAR B cycle=<n> erase_residual_bits=<n> program_fail_bits=<n>
        defect_addr_count=<n> defect_addrs=<p:b:k;p:b:k;...>
        worst_page_idx=<n> worst_page_bits=<n> die_temp_mc=<n> uid_ok=<0|1>
        ts=<n> sum=<4hex>
```

- 유효 접두는 **`#WEAR `**(뒤 공백 포함). 줄 앞에 쓰레기 바이트가 붙어도 찾습니다
- `sum` 은 그 앞까지의 본문 바이트 합 `mod 0x10000`
- **S-1 §9 의 공통 필수(`chip_id`·`git_rev`·`base_sector`)가 A 행에서 빠져 있었습니다** — 프롬프트 `:296-300` 과 우리 첫 실물 **양쪽 다** 빠뜨렸던 자리입니다. **기본값은 `#WEAR H` 세션 헤더 1행**으로 잡았고(A 행마다 실으면 300k 에서 2.1M행이 그만큼 길어집니다), 다른 자리가 좋으면 그 줄만 알려 주십시오
- 정본은 `docs/spec/s4.blackbox_tb.md` §5.2 이고, 우리 파서·가짜 엔진이 이 문법 그대로 돌고 있습니다

---

## 5. 첫 프롬프트 수정사항

리포의 실제 코드(2026-09-19 기준)와 대조한 결과입니다. 실험 설계·해석 문제는 빼고 **구현에 들어가면 기계적으로 깨지는 것만** 추렸습니다.

### 5.0 프롬프트 §7 이 "추측하지 말라"고 남긴 3건 — 사실 답

| 질문 | 사실 | 근거 |
| --- | --- | --- |
| `run_sweep_chip.py` 가 `base_sector != 0` 을 거부하나 | **거부합니다** — `ap.error("수정안 #1 미승인 — 0 만 허용")` | `host/run/run_sweep_chip.py:341` |
| RTL/PS 가 11비트`BASE_SECTOR[10:0]` 를 구현했나 | **구현 0건.** `fpga/rtl/` 전체에 `cfg_base_sector` 없음. AXI 디코드는 `0x24` 까지고 `0x28` 은 디코드 자체가 없음 | `fpga/rtl/core/core_axil_regs.v:70-71,153,177` |
| 스윕 빌드의`N_READS` 가 112 인가 | **112 맞습니다.** 단 실칩 전용이고 원본 `g0_sweep.c` 는 100 유지(루프백 이력 보존) | `ps/scripts/build_g3_sweep.py:27,42` · `ps/src/g0_sweep.c:67` |

**→ far(2041) 스윕은 오늘 하드웨어로 불가능합니다(blocker).** 주소 산술 자체는 맞습니다 (`2041×16+111 = 32767` ✓, `2042×16+111 = 32783 > 32767` ✓).

### 5.1 경계에 닿는 것 — 답이 필요하거나 같이 정해야 하는 것

| #  | 내용 |
| -- | --- |
| 1  | **베어메탈에 "실행 인자"가 없습니다.** `ps/src/` 의 앱은 전부 `main(void)` 이고 파라미터 전달은 빌드타임 텍스트 치환뿐입니다(`build_g3_sweep.py:42` 가 `#define` 을 sed 로 교체). `:406-415` 의 CLI 옵션(expected UID·target cycles·base sector)이 **엔진에 닿을 경로가 없습니다** → §4 「명령 채널」 |
| 2  | **`:296-300` 스키마에 `sum=` 이 없습니다.** 그대로 내보내면 우리 파서가 **전 행을 reject** 합니다 → §4 「로그 행 문법」 |
| 3  | **`die_temp_c` 를 `xil_printf` 로 못 찍습니다**(부동소수 미지원). 게다가 XADC 를 읽는 코드가 리포에 0건입니다(`XSysMon`/`XAdcPs` 0건) → §4 |
| 4  | **`timestamp` 의 원천이 없고 u32 면 71.6분마다 랩합니다** → §4 |
| 5  | **「큰 쪽 채택」** → §1 에서 우리가 고쳤습니다 |
| 6  | **A1 카운터 정의** → §1 에서 우리가 고쳤습니다 |
| 7  | **`checkpoint_due` 규약이 없습니다** → §3 제안-7 |
| 8  | **`program_fail_bits` 를 잴 자리가 사이클 순서에 없습니다.** 근원은 **S-1 자신** 입니다 — §7 은 *"프로그램 직후"* 에 재라 하고 §6 루프는 ④(소거 뒤)에서 잽니다. `:190-196` 의 ②·④ 는 **상태 확인**이지 데이터 대조가 아니라 여기서도 안 나옵니다. **소거 뒤엔 기대 패턴이 사라져 영구히 측정 불가** → §3 제안-10 · §6 의 4번 |
| 9  | **거부가 *"비영 종료 상태"***(`:227`)라 **프로세스가 죽는 것**으로 읽힙니다. 거부 뒤 `wear_status()` 를 부를 수 있나요? → §3 제안-2 |
| 10 | **무결성 로그 *"1행 이상"***(`:536`) ↔ S-1 §13 A3 은 **정확히 1행** |
| 11 | **tally 바이트 부분 프로그램은 미검증 전제**입니다 — S-1 §15 ⑥ 이 *"페이지당 256회 부분 프로그램이 성립하는가"* 를 파일럿이 답할 질문으로 열어 뒀는데 `:337-343` 은 확정 절차로 썼습니다 → §4 에 대안 |
| 12 | **체크포인트 배치가 정수가 아닙니다** (300 → 645 → 1386.75). 반올림 규칙이 프롬프트에도 S-1 §11 에도 없습니다 → §4 |
| 13 | **재소거를 부를 자리가 없습니다.** `:363-371` 의 재개 절차가 S-1 §8.3 5번(「부분 소거면 재소거」)을 그대로 두는데 **경계 7개 어디에도 그 수단이 없습니다.** S-1 §13 B 의 두 번째 통과 조건(*"소거 중 차단 시 부분 소거가 blank check 에 잡히고 재소거 후 정상 진행"*)이 여기 걸립니다 → §6 의 2번 |

### 5.2 경계 밖 — 우리(한영웅)가 처리합니다. 회신 불필요

- **WIP 2초 타임아웃을 "기존 코드 재사용"으로는 못 만듭니다** — `flash_prep.c:90` 의 `wait_wip_clear()` 는 시간이 아니라 **반복 1천만 회 상한**이라 실효 타임아웃이 분 단위입니다. XTime 기반으로 새로 써야 합니다
- **`COUNTS_PER_SECOND` 괄호 함정** — `x / COUNTS_PER_SECOND` 로 쓰면 `X/A/2` 로 전개돼 **정확히 4배 작은 값**이 나옵니다. 2026-09-15 chip02 에서 실제로 밟았습니다(`flash_prep.c:115` 주석)
- **`flash_prep` 이 매 실행마다 섹터 0–127 을 통째로 지웁니다**(`N_PAGES=2048`) — wear(0–6)·near(7–13)이 그 안에 있습니다. 체크포인트를 기존 래퍼로 돌리면 마모 이력과 근접 대조군이 날아갑니다
- **`near_pe_actual` 의 초기값이 0 이 아닙니다** — `docs/chip_pe.md` 에 chip02 는 `0~127 +1` 이 5행, chip03 이 1행 있습니다
- **`docs/chip_pe.md` 머리말의 원격 대조군 표기가 낡았습니다**(121–127 → 2,041–2,047)
- `:471-509` 의 단위 테스트 중 **`BASE_SECTOR=2042` 거부는 계층이 다릅니다** — 그건 스윕 읽기 창 파라미터지 P/E 함수 인자가 아닙니다. 엔진 쪽 등가물은 `wear_start` 의 범위 검사이고 우리 TB 에 이미 있습니다
- 포트 기본값(`/dev/ttyUSB1` ↔ Windows COM) · baud 실제값 925,925bps(+0.47%) · **A 로그 300k 면 2.1M행(≈200MB)** 이라 파일 분할 규칙 필요

### 5.3 프롬프트 §1 「반드시 읽을 것」이 나흘 낡았습니다 (문서 09-15, 리포 09-19)

빠진 것 — `docs/interface/pe_engine.md`(경계 7개) · `docs/spec/s4.blackbox_tb.md`(블랙박스 TB 사양서) · `host/tests/`(995줄 — `tb-pre-spec` 커밋 + 9/18·9/19 보완분) · `docs/log/young/29`(P/E 층위 결정) · `docs/log/young/41`(경계·TB).

**주의** — `:488-509` 의 15개 시나리오 중 상당수가 `host/tests/` 에 이미 있습니다. 그리고 블랙박스 전제상 **엔진을 구현하는 에이전트가 그 채점표를 다시 짜면 안 됩니다.** 테스트는 우리가 가진 것을 쓰고, 지민 쪽은 엔진만 보시면 됩니다.

---

## 6. 답해 주실 것 — 4개

1. **제안-7** — 체크포인트에서 **엔진이 멈추고 `checkpoint_due` 로 알리나요?** (`:390` 은 호스트 책임으로 적혀 있습니다)
2. **제안-5·제안-9 / `:363`** — 재개 절차 9단계 중 **3·4·5(호스트 로그 판독·대조·선택)를 호스트로 넘겨도 될까요?** 엔진은 1·2·6·7(UID·tally 판독·blank check·재소거)만 하는 모양입니다. 같이 여쭐 것 하나 — **그 재소거를 무엇으로 부르나요?** 경계 7개에 없습니다. ⓐ `wear_resume()` 안에서 엔진이 자동으로 하거나 ⓑ 경계 8(`reerase(base_sector, n_sectors)`)로 내는 두 갈래이고, 어느 쪽이든 **그 재소거가 X축에 세어지는지**(§8.2 의 ±1)도 같이 정해 주십시오
3. **제안-6 / `:190-196`** — 1사이클 순서에 **⑥ A 로그 출력**을 넣어 주세요 (확인만)
4. **제안-10 / `:190-196`·`:306-315`** — **검사 사이클만 ①프로그램 → 검사 → ②소거 로 분기**해 주세요 (확인만). 지금 순서로는 `program_fail_bits` 를 **소거 뒤에** 재게 되어 기대 패턴이 이미 사라진 뒤입니다 — 영구히 측정 불가입니다. S-1 §6 과 §7 이 어긋나 있던 자리라 **S-1 본문은 이미 고쳤습니다**(§1 의 4번).

   **한 줄만 덧붙입니다 — `blank_check` 는 부를 때 실제로 읽어서 세 주세요**(마지막 결과를 캐시해 두지 않기). 두 숫자는 같은 읽기에서 기준만 달리해 나오므로 `erase_residual + program_fail = 전량(229,376)` 이 항상 성립합니다. 그러면 **호스트가 체크포인트에서 한 번 불러 「세는 경로가 살아 있는지」를 확인**할 수 있습니다 — 소거 직후라 `program_fail` 이 전량으로 나와야 하고, `0` 이면 그 경로가 죽은 겁니다. **로그 행 문법(제안-3)은 안 바꿉니다.** 필드 추가 없습니다

그 외 §4 표 12줄 중 **기본값을 붙인 10줄은 회신에 언급이 없으면 그대로 확정**하겠습니다. 나머지 둘은 기본값을 붙이지 않았습니다 — **층위**(전적으로 재량) · **명령 채널**(조건 하나만 겁니다). 재소거는 §3 뼈대(제안-9)로 올려 위 2번에서 여쭙습니다.

---

## 7. 구현용 프롬프트 — 갱신 패치

원본 프롬프트를 버릴 필요는 없고, 아래만 갈아 끼우면 오늘 상태와 맞습니다.

| 절 | 이렇게 바꿉니다 |
| --- | --- |
| §1 읽을 것 | `docs/interface/pe_engine.md` · `docs/spec/s4.blackbox_tb.md` · `host/tests/` · 로그 29·41 **추가** |
| §3.1 1사이클  | `⑥ 호스트로 A 로그 행 출력(매 사이클, 섹터별 1행)` **추가**. 검사 사이클만 `①프로그램 → 검사 → ②소거` 로 분기 |
| §3.3 카운트 | `wear_loop_cycles` 가 **엔진 카운터**이고 체크포인트 P/E 는 `area_cumulative_cycles` 로 간다고 **명시** |
| §4 PS C | *"전용 프로그램을 구현한다"* 앞에 **경계 7개(§2)를 채우는 형태로** 라고 못 박기 |
| §4.2 WIP | *"기존 코드 재사용"* → **XTime 기반으로 새로 쓴다**(기존은 반복 횟수 상한이라 2초가 안 지켜짐) |
| §4.3 로그 | 행 문법을 §4 기본값 전문으로 교체(`sum=` 포함, `#WEAR H` 헤더 1행). `timestamp` 는 u64 |
| §4.4 무결성 | `die_temp_c` → `die_temp_mc`(정수 밀리도, 미확보 시 빈 값) |
| §5.1 tally | *"두 tally 가 다르면 큰 값 채택"* → **§1 의 「2벌 병합」**(차이 > 100 이면 중단) |
| §5.2 resume | 9단계를**엔진 단계(1·2·6·7) / 호스트 단계(3·4·5·8·9)** 로 가르고, 판단은 §1 의 `d` 규칙. **재소거를 무엇으로 부르는지 명시**(제안-9) |
| §7 체크포인트 | 반올림**100 단위 내림** 명시. far=2041 은 **blocker 확정**(RTL 11비트 미구현)이므로 wear·near 까지만 |
| §8 테스트 | *"15개 시나리오를 새로 짠다"* → **`host/tests/` 의 채점표를 쓴다.** 엔진 구현자가 채점표를 다시 짜지 않는다 |
| §9 합격 기준  | *"무결성 로그 1행 이상"* → **정확히 1행** |

### 붙여 쓸 머리말 블록

```
이 작업의 엔진 경계는 docs/interface/pe_engine.md §2 의 7개 함수다. 이름과 반환값을
바꾸지 않는다. 층위(RTL / PS C)는 자유다.

로그 행 문법·체크섬·오류 코드는 docs/spec/s4.blackbox_tb.md §5.2 의 기본값을 쓴다.
채점표는 host/tests/ 에 이미 있다 — 새로 만들지 않는다.

사이클 카운터는 마모 루프만 센다. 체크포인트의 소거+PRBS 는 area_cumulative_cycles 로 간다.
재개 판단(「큰 쪽 채택」 아님)은 S-1 §8.3 의 d 규칙을 따르고, 판단 주체는 호스트다.

사람의 명시적 승인 없이 실제 칩에 Program/Erase 를 실행하지 않는다.
```

---

## 8. 참고 — 블랙박스 TB 가 보증하는 것과 못 하는 것

과장 없이 적습니다. **TB 는 「엔진이 무결하다」를 보증하지 못합니다.** 보는 데가 경계 7개와 호스트가 받은 파일뿐이고, 지금 통과한 49개는 **가짜 엔진**에 대고 잰 것입니다.

보증하는 것은 셋입니다 — ① **채점표에 이빨이 있다**(엔진에 버그 10종을 심으면 지정 항목이 반드시 깨집니다. 반대 방향도 집행합니다 — **버그 하나로도 안 깨지는 채점 항목이 있으면 그 항목이 비어 있는 것**이라 테스트가 빨간불을 냅니다) ② **채점 기준이 구현에 맞춰 휘지 않았다**(스펙을 안 보고 짰습니다) ③ **환경 고장 10종에서 조용히 통과하지 않는다**.

못 하는 것 — 칩 물리(소거 시간 곡선·실제 부분 소거의 잔류량·마모 결함 진행) · A6(소거 시간)는 통째로, A7 은 **실제 UID 대조가** 실칩 전용(가짜 엔진에서는 고정값 대조까지) · 우리가 생각 못 한 고장 · **100사이클에서 통과해도 300k 에서 나는 것**. 엔진 내부의 정확성은 지민의 cocotb 층(`docs/log/jimin/3`)이 보는 자리입니다.
