young-0320/flash-margin-bench/docs/chip_registry.md

# 시료 등록부 (W25Q64FV · JV — 1차 ×10 + 알리 2 + 2차 6 + 3차 6 + 4차 JV 10 = 34, 라벨 chip01~chip40)

Updated: 2026-11-01

칩 개체의 **정본 식별자는 하드웨어 Unique ID**다. 사람이 부르는 라벨(chip01 등)은 편의를
위한 별칭이며, 라벨과 데이터가 어긋나면 **UID가 진실**이다.

- **UID**: `4Bh` Read Unique ID Number — 공장에서 새긴 개체별 읽기 전용 64비트
  ("a factory-set read-only 64-bit number that is unique to each W25Q64JV device")
- **JEDEC ID**(`9Fh` → `EF 40 17`)는 모델 식별자라 전 칩이 동일하다(FV · JV 도 같다). **개체 식별 불가.**

## 등록부

| 라벨 | UID (16 hex) | 최초 측정  | 용도 | 비고 |
| --- | --- | --- | --- | --- |
| chip01 | D1654CB09B352233 | 2026-07-08 | 브링업·G3·G4 반복성 ·**파일럿(종료)** · **고온 유지 시험 시료** | 7월 게재 데이터의 원본 개체. 9/22 신품 25MHz 39,659.0ps — 세 지표(width·소거·벽 두께) 모두 무리 한가운데라 파일럿에 가장 무난한 개체(집계표 §1).**2026-09-26 P/E 파일럿 종료 — 섹터 0-6 300,000 사이클, 300k PRBS 기록 상태로 소켓에서 빼 보관.** 고온 유지 시험(베이크) 시료 — 300k 에 써 둔 PRBS 가 가열 뒤에도 남는지 본다. **그 전까지 prep·newchip 금지**(PRBS 가 덮여 가열 전후 비교가 사라짐 — `docs/results/wear/wear_pilot_chip01.md` §6) |
| chip02 | D1642C74E7134527 | 2026-09-15 | **상온 종단 → 교정 (빠른 무리) · 200k 연장 종료** | 신품 소거 27.2ms ·**빠른 무리**. 2026-09-21 TB 영역(섹터 1000-1006) 인수 시험 100사이클 — 마모 섹터 0-6 과 무관. **2026-10-06 — tally-erase 뒤 상온 0 → 100k 시작(세션 `1791280572`), 마치면 곡선 무관 빠른 무리 교정에 넣는다** (로그 48 [D48-103] — START 직후 · 첫 결과 전 커밋) **2026-10-20 - 10-22 100k → 200k**(세션 `1792520588`) — 7섹터 148-178k 계단(빠른 FV 7/7), 200k 4.00배, 프로그램 약 3배, 110k 재장착 단차 +128ps. `docs/results/wear/wear_endurance_200k.md` §10 |
| chip03 | D1628C10C3433F33 | 2026-09-15 | **종단 1 (보드 A) · 종료 · 200k 연장 종료** | **2026-09-27 종단 마모 종료 — 섹터 0-6 100,000 사이클**, 뒤이어 75·45MHz 스윕과 newchip 1회. 결과 `docs/results/wear/wear_endurance_chip03.md`. **2026-10-14 - 10-15 100k → 200k 연장**(세션 `1791990254`, 24h09m, 무인) — 느린 무리 첫 200k, 역산 답 범위 150k 너머용(로그 52 [D52-10]). 소거 200k 2.10배 · **계단 없이 미끄럼**(한 구간 상승 5-12ms · 분포 폭 20-25ms) · 프로그램 1.7-2.3배 · 폭 +16ps 안. 결과 `docs/results/wear/wear_endurance_200k.md` §6. 200k PRBS 기록 상태로 소켓에서 빼 보관 — 고온 유지 시험 100k 시료 후보에서는 빠짐(200k 가 됐다) |
| chip04 | D16484578B525622 | 2026-09-16 | **종단 2 (보드 B) · 종료** | **2026-09-27 종단 마모 종료 — 섹터 0-6 100,000 사이클**(박지민, 보드 B · 115200). 60k 에서 DUMP 중단 뒤 수기 체크포인트, 66,654-66,671 SPI 접촉 불량 · `wip_timeout`@66671 뒤 66,600 으로 되돌려 재개(66,601-66,653 은 두 번 탐 — 장부 마모 합계 100,071). 100k 뒤 75·45MHz 스윕과 newchip 1회 — 0-127 에 newchip PRBS 기록 상태로 박지민 보관. 결과 `docs/results/wear/wear_endurance_chip04.md` |
| chip05 | | 2026-09-16 | **측정 불가 — 분모 제외** | **JEDEC 무응답(FF FF FF) 누적 4회 (9/16 3회 · 9/20 1회) — UID 미확보.** 2026-09-20 전수 측정 분모를 `n=9` 로 확정했다(집계표 §7·§8). 같은 리그에서 직전 chip04, 직후 chip06 이 정상 동작했으므로 배선·전원이 아니라 개체 또는 삽입 상태 문제다. 방향·핀 접촉 재확인 혹은 점퍼선 교환 확인 |
| chip06 | D16428231B4E182B | 2026-09-16 | **블라인드 (빠른 무리) → 교정 (12k → 100k) · 200k 연장 종료** | 2026-09-27 종단 3 에서 뺌 — 칩이 박지민 쪽에 있어 보드 A 에서 못 돌림. 종단 3 은 chip07 (S-1 §15 추기).**2026-09-30 블라인드 12,000 개봉**(정답 12k · v2 판정 `docs/results/blind_chip06.md`). **2026-10-11 - 10-12 보드 A 에서 12k → 100k**(세션 `1791740291`) → 교정 9칩째(v4.1 측정, 로그 52 §11). **2026-10-12 - 10-13 100k → 200k 연장**(세션 `1791800419`, 24h54m) — 답 범위 150k 너머용(로그 52 [D52-9]). 소거 200k 4.18배 · 7섹터 계단 90k-158k · 프로그램 1.9배 · 폭 보드 A 안 ±8ps. 결과 `docs/results/wear/wear_endurance_200k.md`. 200k PRBS 기록 상태로 소켓에서 빼 보관 |
| chip07 | D1629835DB334534 | 2026-09-20 | **종단 3 (보드 A) · 종료** · 200k 연장 종료 | 2026-09-27 chip06 대신 배정. 신품 소거 47.0ms 로 chip03 과 같은 느린 무리 — 알고 고름 (S-1 §15 추기).**2026-09-29 종단 마모 종료 — 섹터 0-6 100,000 사이클**(60k·80k 체크포인트 결측 — USB 재열거로 호스트 종료). **2026-09-28 02:23:55Z 배선 접촉(계측 사건)** 뒤로 25MHz 폭이 +590ps 옮겨 있다. 100k 뒤 25·45·75MHz 스윕(P/E 0). **2026-09-30 선 복구 뒤 사다리와 newchip 1회로 측정 종료** — 0-127 에 newchip PRBS 기록 상태로 소켓에서 빼 보관. 결과 `docs/results/wear/wear_endurance_chip07.md` **2026-10-19 - 10-21 100k → 200k 연장**(세션 `1792429510` · `1792494559`, 10cm 선) — 소거 200k 1.91배 · 미끄럼 · 프로그램 2.9배. A 행 결손 100.0-103.6k(전원 상실) · 178.1-178.8k(작업 실수). 결과 `docs/results/wear/wear_endurance_200k.md` §9 |
| chip08 | D16414615B564524 | 2026-09-20 | **블라인드 (느린 무리) · 상온 30k · 블라인드 불합격(모델 고정 판정)** | 신품 소거 49.5ms. 원 배치의 유일한 느린 신품 — 새 배치 newchip 뒤 느린 칩이 둘 이상이면 교정으로 돌림 (로그 48 §23) **2026-11-05 상온 0 → 30,000**(세션 `1793893689`, 체크포인트 100-30k) · 같은 날 newchip 1회 **2026-11-11 v4.3 블라인드(모델 고정 판정 — 정답 봉인 없음, [D52-18])** — 관측 1.60배 → 추정 71-72k · 95% 43-100k, 정답 30,000 밖 · 2.38배 과대. 30k 배율 1.51 이 느린 교정 셋과 chip12 · 21 형 사이 — 중간 속도([U52-7] 재료). 마모 곡선 미승격. `docs/results/blind_chip08.md` |
| chip09 | D1657C9713633921 | 2026-09-20 | **교정 4 (빠른 무리) · 200k 연장 종료** | 신품 소거 26.0ms. 2026-10-01 배정 — 빠른 무리 교정을 원 배치로 (로트 교란 없음, 로그 48 §23). 종단과 같은 100k · 13점 격자.**2026-10-01 0 → 100k 종료**(세션 `1790786787`, 100k 는 휴지 뒤). **2026-10-13 - 10-14 100k → 200k 연장**(세션 `1791904816`, 22h56m, 무인) — 답 범위 150k 너머용(로그 52 [D52-9]). 소거 200k 4.15배 · 7섹터 계단 92k-157k · 프로그램 1.01 불변 · 폭 +25ps 안. 결과 `docs/results/wear/wear_endurance_200k.md`. 200k PRBS 기록 상태로 소켓에서 빼 보관 |
| chip10 | DF685453E7791531 | 2026-09-20 | **W25Q64JV (FV 아님) · 상온 종단 종료 · 교정 밖** | 신품 소거 33.0ms (섹터 32-127 중앙값, 9/20) ·**빠른 무리**(40ms 경계 — 빠른 교정 칩 26.0-33.7ms 의 위쪽 끝, chip04 33.7ms 바로 아래). UID 앞바이트가`DF` 로 나머지 아홉(`D1 6x`)과 다르다. JEDEC 정상·스윕 완주라 접촉 서명은 없으나 재측정 때 **UID 재독으로 확인**한다. **2026-10-05 — 상온 0 → 100k 마모로 바꿈**: `DF` 칩이 어떻게 늙는지 본다(새 10칩 도착 전). 교정에 넣을지는 곡선을 본 뒤 정한다 (로그 48 §44 [D48-97]). `DF` 무마모 대조군은 chip14 가 남는다 **2026-10-06 종단 마모 종료 — 섹터 0-6 100,000 사이클(보드 A), 뒤이어 newchip.** 어느 무리와도 맞지 않아(소거 100k 2.55배 · 계단 없음 · 프로그램 1.11배) 교정에 넣지 않고 `--no-calib` 으로 승격(결과 `docs/results/wear/wear_endurance_chip10.md`, 다른 칩과의 비교는 보류) · 다루는 법은 [U48-21]. **2026-10-06 마킹 `25Q64JVSIQ` `1850` — JV 세대다** (아래 마킹 표) |
| chip11 | | 2026-09-30 | **측정 불가 — UID 미확보 · 분모 제외** | **알리익스프레스 구매분(chip12 와 같은 2개 묶음).** **2026-09-30 추가 구매 배치(8칩 chip11-18) 신품 측정에서 JEDEC 을 못 읽어 UID 미확보** — 그날 보드 A 의 `#PREP FAIL jedec mismatch`(`FF FF FF` · `00 00 00` · `80 00 00`) 7건 (`data/session_prepfail_20260930T155646Z` … `162125Z` · `210130Z`) 중 어느 것이 이 칩인지는 못 가린다(UID 전에 멈춰 귀속 없음 · `162125Z` 는 21초 뒤 chip17 PASS 라 재장착). 같은 리그에서 chip12 · 15 · 18 · 17 이 그 사이에 정상이라 배선·전원이 아니라 개체 또는 삽입 상태 문제 — chip05 와 같은 종류. 방향·핀 접촉 재확인 혹은 점퍼선 교환 뒤 재시도, 그래도 안 되면 분모에서 뺀다. 라벨은 이 칩 자리로 두고 새 칩에 주지 않는다 |
| chip13 | | 2026-09-30 | **측정 불가 — UID 미확보 · 분모 제외** | **디바이스마트 6개 묶음(chip13-18) 중 하나.** chip11 과 같다 —**2026-09-30 추가 구매 배치(8칩 chip11-18) 신품 측정에서 JEDEC 을 못 읽어 UID 미확보** — 그날 보드 A 의 `#PREP FAIL jedec mismatch`(`FF FF FF` · `00 00 00` · `80 00 00`) 7건 (`data/session_prepfail_20260930T155646Z` … `162125Z` · `210130Z`) 중 어느 것이 이 칩인지는 못 가린다(UID 전에 멈춰 귀속 없음 · `162125Z` 는 21초 뒤 chip17 PASS 라 재장착). 같은 리그에서 chip12 · 15 · 18 · 17 이 그 사이에 정상이라 배선·전원이 아니라 개체 또는 삽입 상태 문제 — chip05 와 같은 종류. 방향·핀 접촉 재확인 혹은 점퍼선 교환 뒤 재시도, 그래도 안 되면 분모에서 뺀다. 라벨은 이 칩 자리로 두고 새 칩에 주지 않는다 |
| chip12 | D165B43013742436 | 2026-09-30 | **별개 칩 · 종단 종료 · 교정 제외** | 알리익스프레스에서 구매. 2026-10-01 배정(로그 48 §25) — 100k · 13점 격자. 신품 소거 47.8ms (섹터 32-127 중앙값) ·**느린 무리**. **2026-10-03 — 교정에서 뺀다** — 구매처(알리익스프레스, 검증 안 된 판매자)가 다른 칩(디바이스마트)과 달라 새 배치를 대표하지 못하고, 소거·프로그램이 빠른 무리처럼 늙었다 (로그 48 [D48-73]). **2026-10-03 종단 마모 종료 — 섹터 0-6 100,000 사이클** (보드 A, 7,400 재장착), 뒤이어 newchip 1회. 빠른·느린 무리에 넣지 않는다 — 소거는 빠른 무리만큼 늘었지만 계단이 없고 프로그램은 그대로라 어느 무리와도 맞지 않는다 (로그 48 [D48-77]). 결과 `docs/results/wear/wear_endurance_chip12.md` |
| chip14 | DF678C14CF384F30 | 2026-10-01 | **상온 종단 종료 (보드 B · 박지민) · JV 별개 승격 · 교정 밖 (chip10 과 「JV 둘」)** | 신품 소거 36.3ms (섹터 32-127 중앙값, 첫 prep) · 40ms 경계로는 빠른 무리지만 빈 구간(33.7-47ms) 안.**UID 앞바이트 `DF` — chip10 과 같고**, width 38,803ps 도 chip10(38,730)처럼 약 900ps 낮다. 2026-10-01 prep 4회(앞 2회는 라벨 전 Ctrl-C, 집계표 §1). **2026-10-03 — 무마모 대조군 배정** (chip18 자리, 로그 48 [D48-76]). **2026-10-04 - 10-06 박지민이 보드 B 에서 섹터 0-6 을 0 → 100,000 마모**(세션 `1791089978` 0→100 · `1791201358` 100→400 erase_fail@400, 장부 399 로 보정 · `1791204058` 399→100k 12점 PASS), 10/7 45·75MHz 사다리 + newchip. 자료는 10/8 수령(`data/`, 세션 로그 없음) — 무마모 대조군 자리는 비었다. **2026-10-09 앞 세션 폴더 넷 수령**(1단계 다시 — 1k 곡선 1-100,000 완성). 체크포인트 100 은 스윕이 실패해 유효본이 없다. 세션 로그 15 · 마킹 사진은 아직(로그 48 §53 추기). 100k 소거 2.65배 · 계단 없음 · 프로그램 1.05배로 chip10 과 같은 모양(로그 48 §53). **2026-10-12 — 마킹 `25Q64JVSIQ` `1749` (JV) 판독 → [U48-22] 규칙대로 chip10 과 「JV 둘」, `--no-calib` 별개 승격 · `SEPARATE`** (로그 53 [D53-5]). 결과 `docs/results/wear/wear_endurance_chip14.md` — 7섹터 모두 84ms 를 넘고도 계단 없음 · 폭 12점 중 11점 3σ 안. 세션 로그 16개는 10/12 저녁 수령 → 1단계 다시 · 창 위치(80k-100k 2-6스텝 이동) · 현장 역산 59-60k(95% 상한 끝) · 근접 대조군 소거 1.10 채움 |
| chip15 | D16314314B671B24 | 2026-09-30 | **상온 종단 · 교정 (느린 무리) · 종료 · 200k 연장 종료** | 2026-10-01 배정(로그 48 §25). 신품 소거 49.7ms (섹터 32-127 중앙값) ·**느린 무리**. 구매처 디바이스마트. **2026-10-04 — 2차 블라인드에서 상온 0 → 100k 마모로, 마치면 곡선 무관 느린 무리 교정에 넣는다** (로그 48 [D48-90], 마모 시작 전 커밋). 블라인드는 새 10칩에서 다시 뽑는다.**2026-10-04 종단 마모 종료 — 섹터 0-6 100,000 사이클**(보드 A · 921600). 69,109 에서 USB 흔들림으로 `wip_timeout` → resume 채택 69,109 · 섹터 6 재소거 ±1 뒤 재개(두 번 돈 사이클 없음 · 체크포인트 결측 없음). 10-05 newchip 1회로 측정 종료 — 0-127 에 newchip PRBS 기록 상태. 느린 교정 편입(`wear_curves_chip15_2026-10.csv`). 결과 `docs/results/wear/wear_endurance_chip15.md` **2026-10-15 - 10-16 100k → 200k 연장**(세션 `1792080192`, 24h21m, 무인) — 느린 무리 두 장째, 100k 너머 LOCO 용(로그 52 [D52-10]). 소거 200k 2.25배 · **계단 없이 미끄럼**(예측 맞음) · 프로그램 1.5-2.0배 · 폭 +13ps 안. 결과 `docs/results/wear/wear_endurance_200k.md` §7. 200k PRBS 기록 상태로 보관 |
| chip16 | D165906063442A33 | 2026-10-01 | **65°C 종단 (온도 축 2) · 종료 · 승격 · 교정 밖** | 신품 소거 26.9ms (섹터 32-127 중앙값) ·**빠른 무리** · width 39,801.5ps. 구매처 디바이스마트. **2026-10-03 배정 — 상온 0 → 100k, 마치면 교정에 넣는다** (로그 48 [D48-74] · [D48-75]). **2026-10-08 - 10-09 박지민이 보드 B 에서 섹터 0-6 을 0 → 100,000 마모**(세션 `1791434740` 0→97,957 error · `1791523104` resume · `1791523150` 97,957→100k 1점 PASS), 10/9 75·45MHz 사다리 + newchip. 자료 10/9 수령(`data/` · 1단계 `build/pe_end/chip16/`), **앞 세션 둘은 10/12 수령 → 1단계 다시, A 행 700,000 · 1k 곡선 1-100,000 완성**(13점 모양은 chip01·18 과 겹침, 계단 1.19 — 로그 53 §3 추기). **같이 온 온도 로그(`temp_chip16_65C_*`)가 마모 전 구간을 65°C 설정으로 덮는다** — [D48-74] 의 상온과 다르고, 히터가 꺼진 채 67°C 가 3시간이라 로그 자체도 의심. 100k 소거 116.6ms(신품 27.7ms 의 4.2배 — chip17 65°C 의 2.44 가 아니라 상온 빠른 무리 모양) · 폭은 100 대비 −8ps. 처리는 로그 53 [U53-1] → **2026-10-12 영웅님 결정 [D53-4]: 온도 축(두 번째 설정 65°C 칩) · 교정 밖으로 승격** — 곡선 `_64C` · 결과 `docs/results/wear/wear_temperature_chip16.md`(chip17 과 반대로 상온 빠른 무리처럼 늙음 · 상온 v4 가 10/12 맞힘 · 센서가 히터를 안 따라가 칩 온도 미확인). 100k 뒤 식히지 않은 채 45·75MHz 사다리 + newchip. 25°C newchip 은 아직 |
| chip17 | D1642C325331242E | 2026-09-30 | **65°C 종단 (온도 축) · 종료** | 2026-10-01 배정(로그 48 §25). 히터·PID 가 하루 유지 가능해진 뒤, chip03/07 온도 계수 스윕(25→50→80→25 prep) 뒤에 시작. 신품 소거 26.4ms (섹터 32-127 중앙값) ·**빠른 무리** **2026-10-01 — 기술적 한계로 80°C → 65°C, 마모 5만 회로 진행 (박지민 리그)**. **2026-10-02 종단 마모 종료 — 섹터 0-6 100,000 사이클 (65°C, 박지민 · 보드 B)** — 5만 회 계획보다 길게 갔다. 뒤이어 25°C 로 식혀 25·45·75MHz 스윕(P/E 0). 결과 `docs/results/wear/wear_temperature_chip17.md` |
| chip18 | D1652C218B613936 | 2026-09-30 | **상온 종단 · 교정 (빠른 무리) · 종료** | 2026-10-01 배정(로그 48 §25). 신품 소거 29.5ms (섹터 32-127 중앙값) ·**빠른 무리**. 구매처 디바이스마트. **2026-10-03 — 무마모 대조군에서 상온 0 → 100k 마모로, 마치면 교정에 넣는다** (로그 48 [D48-74] · [D48-75]). **2026-10-04 종단 마모 종료 — 섹터 0-6 100,000 사이클(보드 A), 뒤이어 newchip. 교정에 넣었다.** 결과 `docs/results/wear/wear_endurance_chip18.md` |
| chip21 | D1659431272A2339 | 2026-10-15 | **0 → 200k 종료 · 교정 밖(_nocal) — 신품 느린 무리인데 빠른 노화(chip12 형), v4.4 재료 [U52-7]** | 2026-10-15 newchip 1회(보드 A, 집계표 §1). 신품 소거 48.9ms(섹터 32-127 중앙값) ·**느린 무리** · width 39,649.3ps · blank_pre 0(출고 상태). 마킹 `25Q64FVSIG` `1647`. **2026-10-16 배정(영웅님)** — chip15 200k 뒤 0 → 200k(느린 무리 100k 너머 세 장째, 교정 4번째 느린 칩) **2026-10-16 - 10-19 0 → 200k 종료**(세션 `1792170748`, 56h20m, 무인, 23점 전부 PASS). 소거 200k 2.93배(느린 03 · 15 는 2.10 · 2.25) · 미끄럼 · 프로그램 150k 까지 불변 → chip12 와 같은 꼴, 느린 신품 5칩 중 2. 상온 9칩 모델 LOCO 68% 0/12. 결과 `docs/results/wear/wear_endurance_200k.md` §8. 10/19 승격 직후 교정에서 뺌(`_nocal`, [D52-12]) — v4.3 은 이 칩 없이, 종류 처리는 v4.4. 200k PRBS 기록 상태로 보관 |
| chip22 | D163C424D305372D | 2026-10-15 | **85°C 종단 (온도 축 · 느린 무리) · 종료 · 승격 · 교정 밖** | 2026-10-15 newchip 1회(보드 A, 집계표 §1). 신품 소거 49.5ms(섹터 32-127 중앙값) ·**느린 무리** · width 39,588.5ps · blank_pre 0(출고 상태). 마킹 `25Q64FVSIG` `1413`. **2026-10-16 배정(영웅님)** — 65°C 온도 PE 0 → 100k(느린 무리 첫 온도 칩 — chip16 · 17 은 둘 다 빠른 무리). 교정 밖, 곡선 이름 `_<마모 평균 °C>C`(`pe_end.py --temp`). 10/16 낮 「상온 0 → 100k 교정」 에서 바꿈 **2026-10-17 - 10-18 설정 85°C(파일명 65C 는 틀림, 의도 85°C) 0 → 100k**(박지민, 세션 `1792205864`, 칩 85.0°C) — 100k 1.90배 · 계단 없음 · 프로그램 1.64 · 상온 모델 held-out 68% 3/12 · 95% 12/12. 곡선 `_85C`. `docs/results/wear/wear_temperature_85C.md` |
| chip23 | D16660141F1B132F | 2026-10-15 | **85°C (온도 축 · 느린 무리) · 26.5k 에서 중단 · 승격 · 블라인드 불합격 · 교정 밖** | 2026-10-15 newchip 1회(보드 A, 집계표 §1). 신품 소거 49.4ms(섹터 32-127 중앙값) ·**느린 무리** · width 39,679.0ps · blank_pre 0(출고 상태). 마킹 `25Q64FVSIG` `1642`. **2026-10-16 배정(영웅님)** — 블라인드(느린 무리 두 번째, chip08 과 함께). 우리는 닳게 하지 않는다 — 박지민이 보드 B 에서 비밀 사이클까지, 개봉 때 prep 만 잰다(S-1 §15 블라인드 절차) **2026-10-18 85°C(설정 · 칩 85.0°C, 영웅님: 의도 85°C) 0 → 26,528**(세션 `1792309823` · `1792312282`, 1.7k 끊김 → resume) — 13:50Z USB 끊김 · 13:57Z 히터 센서 FAULT 로 멈춤, 체크포인트 100-20k. 20k 소거 1.53배 · 프로그램 평평(chip12 · 21 형 모양). 이어 갈지 지민 확인 **2026-11-01 승격(곡선 `_85C`) · 상온 newchip 1회(보드 A)로 v4.3 블라인드** — 관측 1.83배 → 추정 92-93k · 95% 78-100k, 정답 26,528(마지막 A 행, tally 미확인) 밖 · 3.5배 과대. 26k 배율 1.77 이 상온 chip21 · 12 와 같은 자리 — 느린 신품 · 빠른 노화 형으로 확정([U52-7] 재료). 장부 20k → 26,528 정정 행은 tally 를 읽은 뒤. `docs/results/blind_temp_chip23_chip26.md` |
| chip24 | D1656C51CF672034 | 2026-10-19 | **85°C 종단 (온도 축 · 빠른 무리) · 종료 · 승격 · 교정 밖** | 2026-10-19 newchip 1회(보드 A, 집계표 §1). 신품 소거 **24.9ms**(섹터 32-127 중앙값 — 전 칩 중 최소, 10/25 기준 FV 중 최소 · JV chip36 24.5ms 가 더 작다) ·**빠른 무리** · width 39,583.2ps · blank_pre 0. 마킹 `25Q64FVSIQ` `1542`. 새 배치의 첫 빠른 칩 — 빠른 블라인드 후보. 용도는 전수 뒤 **2026-10-20 - 10-21 설정 85°C 0 → 100k**(박지민, 세션 `1792494617`, 칩 83.5°C) — 100k 3.47배 · 3섹터 계단 · 프로그램 불변 · 상온 모델 held-out 12/12 · 12/12. 곡선 `_83C`. `docs/results/wear/wear_temperature_85C.md` |
| chip25 | D1666C67A72B2835 | 2026-10-19 | **미배정 (3차 구매분 · 느린 무리)** | 2026-10-19 newchip 1회(보드 A, 집계표 §1). 신품 소거 50.6ms(섹터 32-127 중앙값) ·**느린 무리** · width 39,572.5ps · blank_pre 0. 마킹 `25Q64FVSIG` `1645`(10/19 엔 앞 네 글자 판독 불가, 뒤에 판독). **참고(영웅님 기억, 10/19)**: 구매 때 상위 등급 품목으로 정격 온도 105°C 로 봤음 — 판매 정보로 확인 필요, 마킹만으로는 다른 FV 와 구별 안 됨. 용도는 전수 뒤 |
| chip26 | D16518B58F503638 | 2026-10-25 | **85°C (온도 축 · 빠른 무리) · 70k 에서 멈춤 · 승격 · 블라인드 합격 · 교정 밖** | 2026-10-25 newchip 1회(보드 A, 집계표 §1). 신품 소거 25.7ms(섹터 32-127 중앙값) ·**빠른 무리** · width 39,638.1ps · blank_pre 0(출고 상태). 마킹 `25Q64FVSIG` `2122` — FV 칩 중 가장 늦은 날짜 코드(기존 최신 1647). 0-6 ÷ 32-127 소거 비 0.98(앞쪽 섹터 미리 닳은 흔적 없음). **배정(영웅님, 10/25) — 85°C 종단.** **2026-10-26 - 10-27 설정 85°C 0 → 70,000**(박지민, 세션 `1792996750` · `1793025714`, 센서 처음 30k 81-83°C · 뒤 85.0°C, 100k 까지 이을지 미정) — 70k 마모 중 배율 2.47 · 계단 없음 · 프로그램 불변, 곡선 `_84C`. **2026-11-01 상온 newchip 1회(보드 A)로 v4.3 블라인드** — 관측 2.66배 → 추정 60-61k · 68% 31-85k, 정답 70,000(tally) 68% 안 · 0.86배. `docs/results/blind_temp_chip23_chip26.md` · **FV 신품 측정은 이 칩으로 끝**(영웅님, 10/25) — JV 칩은 chip30 부터 등록 |
| chip30 | D1628C6597471430 | 2026-10-25 | **미배정 (JV · 디바이스마트 · 느린 무리)** | 2026-10-25 newchip 1회(보드 A, 집계표 §1). 신품 소거 53.2ms(섹터 32-127 중앙값) ·**느린 무리** · width 39,696.8ps · 프로그램 6.73ms · blank_pre 0. 마킹 `25Q64JVSIQ` `2505`. UID `D1` 형 |
| chip31 | D1641086635D0E37 | 2026-10-25 | **미배정 (JV · 디바이스마트 · 빠른 무리)** | 2026-10-25 newchip 1회(보드 A, 집계표 §1). 신품 소거 26.6ms(섹터 32-127 중앙값) ·**빠른 무리** · width 39,621.5ps · 프로그램 6.62ms · blank_pre 0. 마킹 `25Q64JVSIQ` `2505`. UID `D1` 형 |
| chip32 | DF603D0357252F26 | 2026-10-25 | **미배정 (JV · 디바이스마트 · 느린 무리)** | 2026-10-25 newchip 1회(보드 A, 집계표 §1). 신품 소거 52.7ms(섹터 32-127 중앙값) ·**느린 무리** · width 38,897.3ps · 프로그램 5.80ms · blank_pre 0. 마킹 `25Q64JVSIQ` `2033`. UID `DF` 형 — chip10 · 14 처럼 width 약 800ps 낮고 프로그램 짧음 |
| chip33 | DF6858705F745F33 | 2026-10-25 | **미배정 (JV · 디바이스마트 · 빠른 무리)** | 2026-10-25 newchip 1회(보드 A, 집계표 §1). 신품 소거 35.5ms(섹터 32-127 중앙값) ·**빠른 무리(40ms 경계) · 빈 구간 33.7-47ms 안** · width 38,790.2ps · 프로그램 5.79ms · blank_pre 0. 마킹 `25Q64JVSIQ` `1836`. UID `DF` 형 — chip10 · 14 처럼 width 약 800ps 낮고 프로그램 짧음 |
| chip34 | DF6738825B416137 | 2026-10-25 | **미배정 (JV · 디바이스마트 · 빠른 무리)** | 2026-10-25 newchip 1회(보드 A, 집계표 §1). 신품 소거 34.4ms(섹터 32-127 중앙값) ·**빠른 무리(40ms 경계) · 빈 구간 33.7-47ms 안** · width 38,851.8ps · 프로그램 5.79ms · blank_pre 0. 마킹 `25Q64JVSIQ` `1736`. UID `DF` 형 — chip10 · 14 처럼 width 약 800ps 낮고 프로그램 짧음. **13:27 첫 시도의 「blank_pre 48,538 비트」 는 접촉 불량 읽기였다** — 13:45 재측정 blank_pre 0 · PASS (아래 10/25 단락) |
| chip35 | DF6994870F4F412F | 2026-10-25 | **미배정 (JV · 디바이스마트 · 빠른 무리)** | 2026-10-25 newchip 1회(보드 A, 집계표 §1). 신품 소거 36.1ms(섹터 32-127 중앙값) ·**빠른 무리(40ms 경계) · 빈 구간 33.7-47ms 안** · width 38,917.5ps · 프로그램 6.14ms · blank_pre 0. 마킹 `25Q64JVSIQ` `2505`. UID `DF` 형 — chip10 · 14 처럼 width 약 800ps 낮고 프로그램 짧음 |
| chip36 | CA6194A2C32F0733 | 2026-10-25 | **미배정 (JV · 디바이스마트 · 빠른 무리)** | 2026-10-25 newchip 1회(보드 A, 집계표 §1). 신품 소거 24.5ms(섹터 32-127 중앙값) ·**빠른 무리** · width 39,717.3ps · 프로그램 10.66ms · blank_pre 0. 마킹 `25Q64JVSIQ` `2505`. UID `CA` 형 — **다른 모양: 128섹터 소거가 24,487-24,523µs(폭 36µs, 다른 칩은 수 ms) · 프로그램 10.66ms(다른 칩 5.8-7.0) · UID 앞바이트 `CA`** (chip12 처럼 「같은 칩」 인지 확인 필요 — **별개 칩 여부 보류**, 영웅님 10/25) |
| chip37 | D166B805DF3C2638 | 2026-10-25 | **미배정 (JV · 디바이스마트 · 빠른 무리)** | 2026-10-25 newchip 1회(보드 A, 집계표 §1). 신품 소거 26.3ms(섹터 32-127 중앙값) ·**빠른 무리** · width 39,820.8ps · 프로그램 6.74ms · blank_pre 0. 마킹 `25Q64JVSIQ` `2505`. UID `D1` 형 — 0-6 ÷ 32-127 소거 비 0.92(10/05 점검 범위 0.96-1.04 밖, 앞쪽이 더 빠름) |
| chip38 | D163808443284C2D | 2026-10-25 | **미배정 (JV · 디바이스마트 · 빠른 무리)** | 2026-10-25 newchip 1회(보드 A, 집계표 §1). 신품 소거 30.1ms(섹터 32-127 중앙값) ·**빠른 무리** · width 39,813.3ps · 프로그램 6.76ms · blank_pre 0. 마킹 `25Q64JVSIQ` `2505`. UID `D1` 형 |
| chip39 | DF603D0357693E33 | 2026-10-25 | **미배정 (JV · 디바이스마트 · 느린 무리)** | 2026-10-25 newchip 1회(보드 A, 집계표 §1). 신품 소거 53.4ms(섹터 32-127 중앙값) ·**느린 무리** · width 38,704.4ps · 프로그램 5.91ms · blank_pre 0. 마킹 `25Q64JVSIQ` `2033`. UID `DF` 형 — chip10 · 14 처럼 width 약 800ps 낮고 프로그램 짧음 |

**2026-10-05 — IC 윗면 마킹 확인을 시작했다 (한영웅).** 모듈 기판 실크는 `W25QXX`. 지금까지 이 등록부와 사양서는 칩을 「W25Q64JV」 로 적었지만 **마킹으로 확인한 적이 없었다** — JEDEC `EF 40 17` 은 W25Q64JV 와 옛 세대 W25Q64FV 가 같아 측정으로는 가를 수 없다.

| 라벨 | IC 윗면 마킹 | 날짜 코드 | 비고 |
| --- | --- | --- | --- |
| chip01 | `25Q64FVSIG` | `1541` | 빠른 무리 |
| chip02 | `25Q64FVSIQ` | `1434` | 빠른 무리(신품 소거 27.2ms) |
| chip03 | `25Q64FVSIG` | `1309` | 느린 무리. 주문 품번은 W25Q64FV**SS**IG(SOIC-8 208mil · 산업용 온도 · 무연)로 추정 — 데이터시트로 확인 |
| chip04 | `25Q64FVSIG` | `1450` | 빠른 무리 |
| chip05 | `25Q64FVSIG` | `1212` | 측정 불가 |
| chip06 | `25Q64FVSIQ` | `1430` | 빠른 무리 |
| chip07 | `25Q64FVSIG` | `1333` | 느린 무리 · 점퍼선 20cm (아래) |
| chip08 | `25Q64FVSIG` | `1423` | 느린 무리 |
| chip09 | `25Q64FVSIQ` | `1548` | 빠른 무리 |
| chip10 | `25Q64JVSIQ` | `1850` | **JV 세대 — 이 등록부의 다른 칩(FV)과 다른 제품**. 2018년 50주. UID `DF`. 마모 종료 10/6 (로그 48 §50) |
| chip12 | **품번 줄의 숫자가 지워짐** · 모듈 생김새도 다름 | — | 의도적으로 지운 것으로 보이는 외관 — 재마킹 · 위조 부품의 전형적 징후. 단정은 못 한다. 데이터만으로 「같은 칩이 아니다」 로 판정한 칩([D48-77]) |
| chip14 | `25Q64JVSIQ` | `1749` | |
| chip15 | `25Q64FVSIG` | `1327` | 느린 무리 |
| chip16 | `25Q64FVSIG` | `1551` | 빠른 무리 |
| chip17 | `25Q64FVSIQ` | `1430` | |
| chip18 | `25Q64FVSIG` | `1529` | 빠른 무리 |
| chip21 | `25Q64FVSIG` | `1647` | 느린 무리(신품 소거 48.9-49.5ms) — 3차 구매분, 10/15 신품 측정 |
| chip22 | `25Q64FVSIG` | `1413` | 느린 무리(신품 소거 48.9-49.5ms) — 3차 구매분, 10/15 신품 측정 |
| chip23 | `25Q64FVSIG` | `1642` | 느린 무리(신품 소거 48.9-49.5ms) — 3차 구매분, 10/15 신품 측정 |
| chip24 | `25Q64FVSIQ` | `1542` | 빠른 무리(신품 소거 24.9ms — FV 중 최소) — 3차 구매분, 10/19 신품 측정 |
| chip25 | `25Q64FVSIG` | `1645` | 느린 무리(신품 소거 50.6ms) — 3차 구매분, 10/19 신품 측정. 영웅님 기억: 상위 등급 · 정격 105°C(판매 정보 확인 필요) |
| chip26 | `25Q64FVSIG` | `2122` | 빠른 무리(신품 소거 25.7ms) — 3차 구매분, 10/25 신품 측정. FV 마지막 칩 |
| chip30 | `25Q64JVSIQ` | `2505` | 10/25 신품 측정. |
| chip31 | `25Q64JVSIQ` | `2505` | 10/25 신품 측정. |
| chip32 | `25Q64JVSIQ` | `2033` | 10/25 신품 측정. |
| chip33 | `25Q64JVSIQ` | `1836` | 10/25 신품 측정. |
| chip34 | `25Q64JVSIQ` | `1736` | 10/25 신품 측정. |
| chip35 | `25Q64JVSIQ` | `2505` | 10/25 신품 측정. |
| chip36 | `25Q64JVSIQ` | `2505` | 10/25 신품 측정. |
| chip37 | `25Q64JVSIQ` | `2505` | 10/25 신품 측정. |
| chip38 | `25Q64JVSIQ` | `2505` | 10/25 신품 측정. |
| chip39 | `25Q64JVSIQ` | `2033` | 10/25 신품 측정. |
- 「`25Q64FV`」 만 적힌 칸은 FV 세대만 확인한 것이다. 날짜 코드는 연도 2 + 주차 2 로 읽는다(한영웅 판독, 2026-10-05)
- **날짜 코드와 무리가 갈린다 (2026-10-05, 10칩).** 1309 · 1327 · 1333 · 1423 의 4칩이 전부 느린 무리, 1430 · 1434 · 1450 · 1529 · 1541 · 1548 의
  6칩이 전부 빠른 무리(앵커 chip02 포함) — **2014년 23주와 30주 사이에서 겹침 없이 나뉜다.** 끝자리 IG/IQ 는 무리와 상관없다
  (빠른 무리에 둘 다). 생산 시기에 따른 공정 · 설정 변경과 보관 기간(칩 나이)이 겹쳐 있어 둘을 이 자료로는 가르지 못한다
  **2026-10-25 추기 — FV 19칩으로는 겹친다.** 3차 구매분의 느린 칩 chip21 · 23 · 25 가 `1647` · `1642` · `1645`(2016년)로 빠른 칩들(1430-1551)보다 늦다.
  느린 날짜 코드 1309 - 1423 · 1642 - 1647, 빠른 1430 - 1551 · 2122 — 「2014년 23-30주 사이 한 줄」 은 원 배치 10칩까지의 관측이다. 2016년 느린 셋 중 chip21 은 신품 느림 · 노화 빠름 형(S-1 10/19 추기)
- **예측 — 날짜 코드를 읽기 전에 적는다 (2026-10-05, 로그 48 §48).** 신품 소거가 빠른 무리인 chip14(36.3ms · UID `DF`) · chip16(26.9ms) ·
  chip17(26.4ms) · chip10(33.0ms · UID `DF`)은 날짜 코드가 **1430 이후**일 것이다. UID 가 `DF` 로 시작하는 chip10 · chip14 는 둘이 같은 날짜 코드 무리(같은 로트)일 것이다. chip05 는 소거 자료가 없어 예측하지 않는다
  **판정 (2026-10-06, chip10 판독 — 한영웅)**: chip10 은 `25Q64JVSIQ` `1850` — 「1430 이후」 는 맞았지만 **FV 가 아니라 JV** 였다.
  「chip10 · 14 같은 로트」 는 **거짓**(2026-10-12, chip14 `1749` — chip10 `1850` 과 날짜 코드가 다르다, S-1 10/12 추기). 10/25 JV `DF` 다섯 칩도 1736 · 1836 · 2033 · 2033 · 2505 로 갈려 `DF` 는 로트가 아니다.
  위 「날짜 코드와 무리가 갈린다」 는 FV 칩들의 이야기라 chip10 에는 쓰지 않는다
- 날짜 코드 `1309` 는 2013년 생산으로 읽힌다. 모듈이 오래된 재고 칩을 얹었다는 뜻이고, **「신품」 은 「우리가 받기 전 사용 이력을 모른다」 는 뜻**이다 —
  재생 칩일 가능성까지 배제하지는 못한다. 신품 측정에서 마모 섹터(0-6)와 기준 섹터(32-127)의 소거 시간이 같은지가 그 점검이다
- **점검 결과 (2026-10-05)**: 칩마다 첫 신품 newchip prep 의 소거 중앙값 비 0-6 ÷ 32-127 이 **0.96-1.04**, 7-31 ÷ 32-127 이 0.98-1.05 (15칩).
  우리 손에서 100사이클만 닳아도 빠른 무리는 1.08-1.4(chip04 1.22), 느린 무리는 약 1.02 가 된다 — 빠른 무리 칩은 앞쪽 섹터가 미리 닳은 흔적이
  없고, 느린 무리는 수백 사이클 이하를 가려낼 힘이 없다. 칩 전체가 고르게 쓰였다면 이 비로는 보이지 않는다(기준 섹터도 같이 닳으므로)

**2026-10-05 — chip07 만 점퍼선이 20cm 였다 (다른 칩은 10cm).** *(2026-10-19 — 10cm 로 교체하고 재측정: 25MHz +538 · 45MHz +957ps 로 다른 칩 띠 안에 들어옴 — 선이 원인, `docs/results/wear/wear_endurance_chip07.md` 10/19 추기)* 칩마다 배선이 한 벌이라(S-2 §8) chip07 의 폭 측정은 다른 칩과 조건이 다르다 — chip07 의 폭 이동(세션 사이 −440ps · 계측 사건 +590ps)을 읽을 때 이 조건을 같이 본다. 소거 · 프로그램 시간은 칩 내부 동작이라 선 길이의 영향을 거의 받지 않는다.

**2026-09-30 — 라벨 상한을 chip20 까지 열었다** (칩 추가 구매). 새 칩은 `--mode newchip` 이 UID 를 읽고 다음 빈 라벨(chip11~)을 물어 행을 추가한다. chip05 행은 죽은 칩의 자리라 새 칩에 주지 않는다. 추가분의 개수·용도는 S-2 §1 배분표에 아직 없다.

> **2026-10-16 추기 — 9/30 배치는 8칩** = 알리익스프레스 2(chip11 · 12) + 디바이스마트 6(chip13-18). chip11 · 13 은 JEDEC 무응답으로 측정 불가(UID 미확보, 위 표). chip19 · 20 은 상한만 연 빈 번호(지금은 칩 없음) — 나중에 새 칩에 줄 수 있다.
> 구매 누계 10(1차) + 2(알리) + 6(2차) + 10(3차) = **28칩**, 측정 불가 3(chip05 · 11 · 13) 빼면 25.
> **2026-10-25 추기** — **3차 구매는 6칩(chip21-26)이었다**(영웅님 확인) — 아래 10/16 단락의 「3차 구매 10칩」 · 위 「10(3차) = 28칩」 은 틀린 기록. 3차까지 누계 24, chip27-29 는 빈 번호.

**2026-10-25 — FV 신품 측정은 chip26 으로 끝, JV 칩은 chip30 부터 등록한다 (영웅님).** JV 칩(`25Q64JV`)은 chip30 부터 번호를 받는다 — 지금까지의 JV 둘(chip10 · 14)은 그대로 둔다. `--mode newchip` 이 묻는 빈 라벨에 chip30 이상을 넣는다. chip19 · 20 · 27-29 는 빈 번호로 남는다. JV 칩은 **디바이스마트 구매 10칩 = chip30-39** (10/25 신품 전수 끝, 전부 `25Q64JVSIQ` — 날짜 코드 2505 ×6 · 2033 ×2 · 1836 · 1736). UID 앞바이트가 세 가지다 — `DF` 5칩(32-35 · 39) · `D16x` 4칩(30 · 31 · 37 · 38, FV 칩과 같은 꼴) · `CA` 1칩(36).
> **10/25 접촉 실패 서명 — 「사용 이력」 아님.** 13:27 newchip(batch `20261025T132724Z`)에서 UID `DF6738825B416137`(뒤의 chip34)이 blank_pre 48,538 비트 · 페이지 단위 `00` 뒤 첫 소거 `busy stuck` 으로 멈췄다. 한때 사용 이력으로 읽었으나 **13:45 같은 칩 재측정이 blank_pre 0 · PASS** 라 접촉 불량 읽기로 정정한다. 14:02 · 14:04 실패 두 건(`140239Z` · `140430Z`)도 같은 서명(UID `0000000000000000` · blank_pre 수만 비트 · `busy stuck`). **blank_pre 가 0 이 아니고 뒤이어 `busy stuck` 이 나면 칩을 다시 꽂고 재측정한다.** 이날 `JEDEC FF FF FF` 는 8건(전부 재장착으로 풀림)

**2026-10-20 — 라벨 상한을 chip40 까지 열었다** (4차 구매 10칩 — 도착하면 신품 전수, 라벨 chip31-40). 구매 누계 38.
*(2026-10-25 — 실제 라벨은 chip30-39(JV 디바이스마트 10칩, 위 10/25 단락). chip40 은 빈 번호. 3차가 6칩이라 구매 누계는 **34**, 측정 불가 3 빼면 31)*

**2026-10-16 — 라벨 상한을 chip30 까지 열었다** (3차 구매 10칩 = chip21-30 *(10/25 정정 — 6칩, chip21-26)* — 신품 전수 측정 중. `--mode newchip` 이 묻는 빈 라벨 중 chip05 · 11 · 13 은 죽은 칩 자리라 주지 않고, chip19 · 20 은 빈 번호라 줘도 된다). 상한 밖 라벨은 `chip_registry.py` · `sweep_uart_capture.py` 가 막는다.

용도 배분의 **정본은 `docs/spec/s2.newchip_protocol.md` §1**이다 — 파일럿 1 / 종단 마모 3 /
블라인드 2 / 무마모 대조군 2 / 예비 2 = 10. 전수 신품 측정은 용도가 아니라 **단계**이며,
비파괴이므로 10개 전부에 먼저 수행하고 그 뒤에 용도가 갈린다.

(2026-08-23 정정: 종전에는 이 줄이 근거를 `project_context.md` §7로 적었으나 §7에는 파일럿이
없었다. §7이 S-2 확정본을 가리키도록 갱신됐고, 이 줄의 참조도 함께 돌렸다.)

## 기입 절차

1. `flash_prep` 실행 시 출력되는 `#PREP UID <16hex>` 를 읽는다
2. 이 표에 UID를 기입한다. **최초 1회만** — UID는 불변이다. `host/run/run_sweep_chip.py`가
   `#PREP UID`를 받아 공란 행을 자동으로 채운다 (`host/capture/chip_registry.py` — 공란 채우기·행
   추가만 허용, 기존 값 수정 금지)
3. P/E는 이 표에 적지 않는다. `docs/chip_pe.md`에 작업마다 증분 행이 append 된다
   (블라인드 칩은 `--blind`로 증분을 `(MASK)` 처리 — 절차는 미설계, 로그 23 부록 D)

## 소급 적용 (7월 데이터)

7월 8일 측정분은 UID를 읽기 전이라 파일에 개체 식별자가 없다. **파일명은 변경하지 않는다** —
README·유래 md·로그 13·15·워크플로가 전부 `chip01` 표기를 참조하고 있어 개명은 재현성 기록을
끊는다. 대신:

- 워크플로 5 **D 트랙**(드리프트 확인)에서 chip01을 다시 꽂을 때 UID를 읽어 이 표에 기입
  - **2026-08-23 D 1차 측정에서는 확보하지 못했다** — `flash_prep`에 `4Bh`가 아직 없다
    (B-1b, 장세은). 그 스윕 CSV에도 `#UID` 헤더가 없다. 다음 chip01 세션으로 이월
    (`docs/log/young/22.d_track_drift_sweep.md` §5)
- `docs/results/data/sweep_chip01_20260708T164931Z.md` 등 유래 문서에 UID 한 줄 추가
- 파일명의 `chip01`은 별칭으로 유지하되, 이 등록부가 UID와의 대응을 보증한다

## 새 데이터 규칙 (2026-08-20 이후 · 2026-09-07 정정)

모든 chip 측정 CSV는 **`uid` 열**(전 행 반복)과 **파일명 `sweep_<label>_<uid16>_<stamp>.csv`**
에 UID를 갖는다 (계약 수정안 #3, `docs/interface/amendments/3.uid_pipeline.md`). 수집 경로:

- `flash_prep`이 `#PREP UID <16hex>` 출력 (PS SPI 경로, `4Bh`, 3회 일치)
- `host/run/run_sweep_chip.py`가 UART를 계속 쥔 채 그 값을 받아 이 표에서 라벨을 역조회하고,
  `host/capture/sweep_uart_capture.py`에 넘긴다. **캡처는 UID 없이 chip CSV를 만들지 않는다**

(정정: 종전에는 "CSV 헤더에 `#UID <16hex>` 주석 행"으로 적었으나, 주석 행은 `csv.DictReader`가
헤더로 읽어 분석이 통째로 깨진다. 열 방식으로 바꿨다 — 로그 23 §8.)

스윕 중에는 PS가 칩과 직접 통신할 수 없으므로(스윕은 PL 경로, prep은 PS SPI 경로) UID와
스윕의 연결은 **같은 세션**이라는 절차적 근거에 의존한다. 세션 중간에 칩을 교체하지 않는다.
PL에서 UID를 직접 읽어 헤더에 박는 완전 자동화는 계약 변경 안건이다(BASE_SECTOR와 묶음).

## 누적 P/E의 정본

등록부의 `누적 P/E` 열은 **값을 갖지 않는다** — 값을 두 곳에 두면 어긋난다. 호스트 측 기록은
`docs/chip_pe.md`의 **증분 이력**(append-only, 누적은 읽는 쪽이 합산)이고, 정본은 **칩 자신의
이력(tally) 섹터**에 있다(`docs/workflow/5.*` 전원 장애 복구 절). 이력과 칩 tally가 어긋나면
**칩이 진실**이다 — UID와 같은 원칙이다. 칩은 자기가 누구인지(UID)와 얼마나 살았는지(tally)를
스스로 들고 다닌다. 등록부는 **불변 사실**(UID·라벨·최초 측정)만 사람이 관리한다.
