young-0320/flash-margin-bench/docs/project_context.md

# flash-margin-bench

Updated: 2026-11-11 (공모전 끝 · 졸업논문 단계 — §1 · §3.3 · §5 · §7 시료 운용 · 나온 것 · §9 현황을 지금 상태로. 직전 개정 2026-10-05)

**FPGA 기반 플래시 메모리 마진 계측 및 노화 진단 플랫폼**

> 불량인지 아닌지를 판정하는 것이 아니라, **여유가 얼마나 남았는지를 측정한다.**

---

> **이 문서는** 팀과 AI 가 배경·계획·범위를 공유하는 자리다 — **왜 이 실험인가 · 무엇을 재나 ·
> 무엇은 하지 않나**. 지금 어디까지 됐나는 여기 없다 → `docs/project_pipeline.md` ·
> 밖에 보이는 결과 요약은 → `README.md` · 사람이 치는 명령은 → `docs/commands.md`

## 1. 한 문장 요약

같은 모델의 플래시 메모리라도 개체마다, 온도마다, 사용량마다 "여유(마진)"가 다르다.
우리는 FPGA 보드로 그 여유를 숫자로 측정하고, 여유가 어떻게 줄어드는지를 추적하는 플랫폼을 만든다.

**범위 구조 — Base와 확장**: Base는 SPI NOR(W25Q64 — 다섯 번 산 34칩, 등록 34 라벨)로, 측정 방법론 실증부터 노화 추적·수명 역산까지 **NOR 하나로 완결**한다(2026-11-06 공모전 최종 발표까지 블라인드 3칩을 판정했고, 지금은 졸업논문 단계다). SPI NAND(W25N)는 확장으로, 실제 비트 에러·Fail Map·ECC가 등장하는 일반화 단계다. 조달·일정 충족 시 착수하며, base의 성립은 확장에 의존하지 않는다.

---

## 2. 배경: 왜 이 프로젝트인가

### 2.1 원래 계획과 그 한계

처음 계획은 "FPGA 기반 SPI Flash Mini-ATE"였다. FPGA로 패턴 생성기, 비교기, ECC, Fail Map, PASS/FAIL 분류기를 만들어 플래시 메모리를 테스트하는 소형 검사 장비다.

그러나

- ATE(자동 검사 장비)는 이미 산업에 존재하는 장비다.
- "기존 장비를 작게 만들었다"는 것은 잘 만든 **구현**이지, 창의적인 **문제 정의**가 아니다.

그래서 장비를 다시 만드는 것이 아니라, **질문 자체를 바꾸기로 했다.**

### 2.2 질문을 바꾸다

| | 기존 질문 | 우리의 질문 |
| ---- | --- | --- |
| 관점 | 이 칩은 정상인가, 불량인가? | 이 칩은**여유가 얼마나 남았는가?** |
| 결과 | PASS 또는 FAIL (1비트짜리 답) | 여유의 크기와 그 변화 곡선 (연속적인 답) |
| 비유 | 시험의 합격/불합격 발표 | 남은 체력을 재는 건강검진 |

PASS, FAIL은 "고장 났는가"만 본다. 하지만 정말 알고 싶은 것은 "앞으로 얼마나 더 사용할 수 있는가"다. 우리는 메모리 칩에 대해 후자의 질문을 던진다.

---

## 3. 핵심 문제: 정상인 칩에서 무엇을 측정하는가

### 3.1 처음 부딪힌 벽

플래시 메모리는 생각보다 튼튼하다. 데이터시트가 보장하는 범위(온도 85°C, 클럭 104MHz) 안에서는 온도를 좀 올리고 클럭을 좀 바꿔도 **에러가 나지 않는다.** 즉, 조건을 바꿔가며 PASS/FAIL만 기록하면 결과표는 전부 PASS로 채워지고, 실험은 아무것도 보여주지 못한다.

"에러가 나야 실험이 성립한다"는 전제 자체가 함정이었다.

### 3.2 돌파구: 에러 없이도 여유는 측정된다

칩이 데이터를 내보낼 때, 그 데이터가 "올바르게 읽히는 시간 구간"이 존재한다. 이 구간을 **유효 윈도우**라고 부르자.

- 평소에는 윈도우 한가운데에서 읽으니 항상 성공한다. 그래서 여유가 얼마인지 보이지 않는다.
- 그런데 FPGA는 읽는 타이밍을 **수십 피코초(1조분의 1초 단위) 간격으로 아주 조금씩 옮길 수 있다.**
- 타이밍을 앞뒤로 밀어가며 "어디서부터 틀리기 시작하는가"를 찾으면, 윈도우의 폭이 **나노초 단위 숫자로** 측정된다.

이것이 이 프로젝트의 핵심 도구다. **칩이 고장 나기를 기다리는 게 아니라, 고장 나는 지점까지 측정 장비 쪽이 다가가서 여유를 직접 잰다.** 그래서 모든 칸이 PASS인 조건에서도 실험이 성립한다.

### 3.3 여유는 실제로 움직인다

이 윈도우 폭은 고정된 값이 아니다.

- **온도가 오르면** 칩 내부 회로가 느려져 윈도우가 좁아진다.
- **전원 전압이 낮아지면** 역시 좁아진다.
- **칩이 낡으면(쓰기/지우기를 많이 반복하면)** 여유가 줄어든다 — 단, 어느 지표에 나타나는지는 칩 종류에 따라 다르다(아래).

즉 "온도·전압·노화에 따라 여유가 어떻게 줄어드는가"라는 곡선이 우리의 데이터다. PASS/FAIL로는 보이지 않던 것이 숫자로 보인다.

**노화 지표에 대한 정직한 전제**:

- **Base(NOR)**: W25Q는 셀 어레이를 직접 읽는 구조라 노화가 타이밍 윈도우에 반영될 *여지*가 있다 — 단 이것은 보장이 아니라 **base 실험이 검증하는 가설**이다. 그래서 base에서도 노화 지표를 이중화한다: ① 유효 윈도우 폭(가설 검증 대상), ② 소거·쓰기 소요 시간(교과서적으로 확립된 노화 지표 — 윈도우가 마모에 반응하지 않더라도 교정 곡선과 수명 역산은 이 지표로 성립한다).
- **확장(NAND)**: W25N은 셀 → 페이지 버퍼 → 핀의 2단계 구조라, 셀이 마모돼도 버퍼에서 나오는 출력 타이밍은 거의 그대로일 수 있다. 따라서 NAND에서는 위 두 지표에 **위상과 무관한 비트 에러 플로어**(셀 마진의 대리 지표)를 더한 3종 체계로 확장한다.

"윈도우 폭 = 만능 노화 센서"라고 주장하지 않는 것이 이 프로젝트의 방어선이다.

**실험이 낸 답 (2026-10 - 11)**: base 의 가설 ①은 **기각됐다** — W25Q64FV 의 25MHz 윈도우 폭은 정격 내구의 3배(300k, 1칩)와
2배(200k)까지 측정 재현성(3σ = 42ps) 안에서 움직이지 않았다. 지표 ②가 일했다 — 소거 시간은 100k 에 빠른 무리 2.60-3.97배 ·
느린 무리 1.59-1.75배, 300k 에 5.2배로 늘었고, 교정 곡선과 수명 역산은 이 지표로 섰다. 이중화해 둔 이유가 그대로 결과가 됐다
(`docs/results/wear/` · `docs/results/wear/wear_endurance_200k.md`).

---

## 4. 무엇을 만들고 무엇을 측정하는가

### 4.1 세 가지 측정

**① 타이밍 여유 측정 (핵심)**
읽기 타이밍을 미세하게 스윕하여 유효 윈도우 폭을 측정한다. 온도와 전압을 바꿔가며 이 폭이 어떻게 변하는지 기록한다.

**② 동작 경계 지도 (shmoo plot, "슈무 플롯")**
전압을 낮추고 클럭을 스펙 한계 너머까지 올리면 실제로 실패하는 지점이 나타난다. 전압-클럭-온도 축에서 "동작하는 영역"과 "실패하는 영역"의 경계를 지도처럼 그린다. 이런 그림을 반도체 업계에서는 슈무 플롯이라 부르며, 우리는 이 측정을 **자동화된 플랫폼**으로 만든다.

**③ 노화 추적 (base: NOR 종단 마모)**

- 같은 칩을 마모시키며 체크포인트마다 윈도우 폭과 소거·쓰기 소요 시간을 측정한다. **파일럿 1칩은 300k 사이클**(데이터시트 "Min. 100K per sector"의 3배 — 하한 보장이지 고장점이 아니므로, `docs/spec/s1.wear_bench_spec.md` §11), **종단 칩은 정격인 100k** 까지다(파일럿에서 폭이 움직이지 않아 종점을 정격으로 잡았다 — S-1 §15). 역산의 답 범위 너머 곡선을 얻으려고 교정 칩 일부를 200k 까지 이었다(로그 52 [D52-10]). 마모 범위는 칩 전체가 아니라 7섹터 마모 그룹(섹터 0\~6)이며, 같은 칩의 안 닳은 섹터가 대조군이자 그 칩의 신품 기준이 된다. 칩이 낡을수록 지우기에 걸리는 시간이 길어지는 성질이 있고, 이 시간은 PS 의 µs 타이머로 WIP 해제를 폴링해 재며(아래 「2026-11 현재의 실물」), **동작 시간의 변화 자체를 칩의 나이를 읽는 센서로 쓴다.**
- 마모량-지표 교정 곡선이 확보되면, 이력을 모르는 칩의 측정값 1회로 사용량을 역추정하고 블라인드 실험으로 검증한다. 이 역추정이 **수명 역산 모델**이다 — 닳은 섹터의 소거 시간이 같은 칩의 안 닳은 섹터보다 몇 배 느린지를 교정 곡선에 대어 누적 사이클을 구간으로 답한다(사양 `docs/spec/s5.lifetime_inverse_model.md`).

**③′ 실에러 측정 (확장: NAND)**

- NAND 플래시는 쓰기/지우기를 수만 번 반복하거나 같은 곳을 수십만 번 읽으면 **실제 비트 에러**가 생긴다. 이때 에러가 몇 개, 어느 주소에서 생기는지 지도(Fail Map)로 기록하고 ECC(오류 정정 코드)로 몇 개까지 복구되는지 확인한다.
  - **필수 전제**: W25N은 on-die ECC가 기본 활성이라, 켜둔 채 읽으면 마모로 인한 raw 에러가 전부 정정되어 가려진다. 노화 측정 시 ECC-E 비트로 비활성화하거나 ECC 상태 레지스터를 병행 로깅하는 절차를 프로토콜에 명문화한다.

### 4.2 측정 지표 (전부 단위가 있는 물리량)

- 유효 윈도우 폭 (ns) — 온도별, 전압별
- 에러 없이 동작하는 최대 클럭 (MHz) — 조건별
- 실제 비트 에러 개수와 위치 (확장: NAND, 마모 후)
- ECC로 정정된 개수 / 정정 불가 개수 (확장: NAND)
- 지우기·쓰기 소요 시간 (µs) — 마모 정도에 따른 변화

> 원칙: 임의의 가중치로 합성한 "점수"는 만들지 않는다. 근거를 물었을 때 방어할 수 없는 숫자는 신뢰를 깎는다. 측정값은 항상 단위가 있는 원시 물리량으로 보고한다.

---

## 5. 시스템 구성

```
[PC / 대시보드]
  │
  │  UART/USB — CSV 저장, 그래프
  │
┌─┴─[ Zybo Z7-20 ]───────────────────────
│
│  PS (프로세서)
│    - 실험 시나리오 자동화
│    - 온도 폐루프 제어 (PID)
│    - 결과 수집
│
│  PL (FPGA 로직)
│    - SPI 컨트롤러 (클럭 가변)
│    - 타이밍 위상 스윕 엔진 (핵심)
│    - 패턴 생성기 / 비교기
│    - ECC 인코더/디코더 (확장: NAND 단계)
│    - 동작 시간 측정기 (10ns 해상도, 목표 구성 — 현재 소거 시간은 PS µs 타이머)
│    - Fault Injection (자기 검증용*)
│
└─┬──────────────────────────────────────
  │
  │  본실험: 짧은 배선의 전용 보드 (브레드보드 금지)
  │  단, 첫 욕조 곡선(G0-G3)은 SOP8 ZIF 어댑터 직결 + 저클럭으로 허용
  │
┌─┴─[ DUT 보드 ]─────────────────────────
│
│  - SPI NOR (W25Q64) — base: 마진 측정·노화 추적 대상
│  - SPI NAND (W25N) — 확장: 실에러·Fail Map·ECC 대상 (조달 시)
│  - 가변 전원 회로 — 전압 축
│  - 레벨 시프터 — 저전압 스윕의 필수 전제
│      (FPGA는 3.3V 출력 고정, DUT 입력 절대최대정격은 VCC+0.4V.
│       없이 전압을 내리면 과전압 스트레스가 실험 교란 변수가 된다)
│  - 히터 + 온도 센서 — 온도 축 (PS가 제어)
│  - 보호 회로
│
└────────────────────────────────────────
```

> **2026-11 현재의 실물**: 전용 DUT 보드(가변 전원 · 레벨 시프터)는 제작 전이라 측정은 **W25Q64 가 실장된 6핀 모듈**(핀헤더 납땜, 칩마다
> 배선 한 벌 — 런북 3 · S-2 §8)을 보드 JB 에 직결해서 했다. SOP8 ZIF 어댑터는 계획에만 있고 쓰지 않았다.
> 온도는 PS 폐루프가 아니라 아두이노 온도 제어기(`hw/temperature_controller.ino` — TMP117 센서 + 필름 히터)로 칩 위 65 · 85°C 두 점에서
> 마모를 돌렸다. 전압 축은 이 보드가 전제라 착수하지 않았다. 소거 · 쓰기 시간은 FPGA 10ns 계측이 아니라 PS 의 µs 타이머로 WIP 해제까지 폴링해 잰다(`ps/src/flash_wear.c` · `ps/src/wear_plat_zynq.c`). 위 그림은 목표 구성이다.

\* Fault Injection은 "에러를 흉내 내는" 용도가 아니라, **우리가 만든 비교기와 ECC가 에러를 정확히 잡아내는지 스스로 검증하는 용도**다. 측정 장비를 만들 때는 장비 자체의 신뢰성부터 증명해야 하기 때문이다.

같은 이유로 검증에는 설계자 자신과 독립적인 기준(oracle) 3종을 둔다:
**Winbond 공식 행동 모델**(프로토콜 정답, cocotb 시뮬레이션) · **golden model**(경계 판정 알고리즘의 Python 독립 구현) · **루프백 실측**(칩 없이 FPGA 단독으로 자기 배선의 욕조 곡선을 찍어 메커니즘을 물리 검증).

### 왜 FPGA인가 (반드시 받을 질문)

단순히 플래시를 읽고 쓰는 것은 몇천 원짜리 마이크로컨트롤러로도 된다. FPGA가 필요한 이유는 명확히 세 가지다.

1. 읽기 타이밍을 **피코초 단위로 조절**하는 위상 스윕 — MCU로는 불가능
2. 동작 시간을 **10ns 해상도로 계측** — MCU로는 불가능 (목표 구성이고, 현재 소거 시간은 PS µs 타이머로 잰다)
3. 스펙 한계 너머까지의 **고속 클럭 생성과 실시간 비교** — MCU로는 불가능

즉 FPGA는 "빠른 SPI 통신기"가 아니라 **정밀 계측기**로 쓰인다.

---

## 6. 이 프로젝트가 하지 않는 것 (정직한 범위 설정)

- 산업용 ATE를 대체하지 않는다. 웨이퍼 검사, 셀 내부 전압 측정 같은 제조사 수준 테스트는 범위 밖이다.
- 상온-85°C 범위의 온도만으로 칩에 에러를 일으키겠다고 주장하지 않는다. (스펙 안쪽이라 에러가 안 나는 것이 정상이며, 그래서 여유 측정 방식을 택했다.)
- 방열판·팬 비교 같은 실험은 하지 않는다. 플래시는 자체 발열이 수십 mW 수준이라 방열 구조의 효과가 물리적으로 측정 불가능하기 때문이다. 온도는 히터로 **제어하는 독립 변수**이지, 완화 대상이 아니다.

범위 밖의 것을 명시하는 이유: 측정을 다루는 프로젝트에서 가장 중요한 자산은 **주장과 데이터가 일치한다는 신뢰**다.

---

## 7. 실험 계획

| 축 | 값 |
| ---- | --- |
| 온도 | 25°C / 40°C / 60°C (히터 + PID 제어) |
| 클럭 | 5MHz 부터 스펙 한계 너머까지 스윕 (fR 초과 구간은 0x0B fast read — SPI 스펙에 더미 사이클 선반영) |
| 전압 | 3.3V → 저전압 방향 스윕 (레벨 시프터 경유) |
| 노화 | base: NOR 마모 (파일럿 0 → 300k · 종단 0 → 100k · 연장 100k → 200k, 7섹터 그룹 — S-1 §2·§11·§15) / 확장: NAND 마모·반복 읽기 |

각 조건에서: 쓰기 → 읽기 → 검증 → 윈도우 폭 측정 → (NAND) Fail Map + ECC → 기록(CSV) → 그래프.

**시료 운용 (W25Q64, base)** — 처음 계획은 10칩을 「전수 신품 측정 → 파일럿 1 · 종단 3 · 블라인드 2 · 무마모 대조군 2 · 예비 2」 로
나누는 것이었다(`docs/spec/s2.newchip_protocol.md` §1). 실험이 진행되며 칩을 네 번 더 사고 용도를 바꿨다. **지금의 배정 정본은
`docs/chip_registry.md`** 이고(34 라벨), 2026-11-11 기준은 이렇다:

0. **전수 신품 측정** — 들어온 칩은 전부. 31칩(FV 19 · JV 12) 측정, chip05 · 11 · 13 은 JEDEC 무응답으로 UID 를 못 읽어 분모에서 뺐다.
   **용도가 아니라 단계**다
1. **파일럿 1** — chip01, 0 → 300k. 본 실험의 미지수(S-1 §15)를 풀었고 교정 곡선에도 들어간다. 고온 유지 시험 시료로 보관
2. **교정 9칩** — 빠른 무리 chip01 · 02 · 04 · 06 · 09 · 18 · 느린 무리 chip03 · 07 · 15. 칩 하나가 노화 곡선 하나를 내고, 그 곡선이
   수명 역산의 교정 표가 된다. 100k 너머 곡선은 7장(chip01 300k · chip02 · 03 · 06 · 07 · 09 · 15 200k). 체크포인트는 100k 까지 고정
   13점(100 · 1k · 3k · 10k … 100k) — 처음 계획한 적응적 조밀화는 폭이 움직이지 않아 쓰지 않았다
3. **블라인드** — chip06(상온 · 빠른 무리, 정답 12,000 · 2026-10-01 개봉, 그 뒤 교정으로) · chip26 · chip23(85°C, 2026-11-01 모델 고정
   판정 — 정답 봉인 없음) · chip08(마모 함; 상온 · 느린 무리 — v4.3 으로 「모델 고정 판정」, 정답 봉인 없음 — 로그 52 [D52-18])
4. **온도** — 65°C chip16 · 17 · 85°C chip22 · 24 (0 → 100k) · chip26(70k 에서 멈춤) · chip23(26,528 에서 중단). 전부 교정 밖
5. **교정 밖 상온** — chip12 · 21(신품은 느린 무리인데 빠른 무리 속도로 늙는 형) · chip10 · 14(JV)
6. **미배정** — chip25(FV · 느린 무리) · chip30-39(JV 10칩)

처음 계획의 무마모 대조군은 남지 않았다 — chip14 · 18 을 마모로 돌렸고, 대조는 같은 칩의 안 닳은 섹터가 맡는다(등록부 chip14 · 18 행).

확장 시 동일한 배분 논리를 W25N 조달분에 적용한다.

**개체 식별 (2026-09-07 이후)**: 칩의 정본 식별자는 하드웨어 UID(`4Bh`, 64비트)이며 라벨
chipNN은 별칭이다. 대응표는 `docs/chip_registry.md`, P/E 이력은 `docs/chip_pe.md`(append-only).
측정 CSV는 파일명과 `uid` 열에 UID를 갖는다(계약 수정안 #3). 누적 P/E 의 정본은 칩 자신의 tally 섹터다(S-1 §8).

**측정의 자기 검증 절차** (모든 본실험에 선행):

- **반복성 프로토콜** — 같은 칩을 재장착 포함 반복 측정하여 윈도우 폭의 재현 편차를 정량화한다.
  이 편차(측정 노이즈)가 예상 노화 이동량보다 충분히 작아야만 노화 실험이 성립한다.
  노이즈 플로어를 확립하기 전에는 마모를 시작하지 않는다.
- **블라인드 검증** — 마모 담당자가 마모 횟수를 숨긴 칩을 측정자가 추정하고, 정답과 대조한다. 추정 성능을 사후 해석이
  아니라 사전 등록된 기준으로 검증한다. 실제 절차(S-1 §15): 정답은 칩의 tally 가 쥐고, 추정을 커밋한 뒤에 tally 를
  읽는다. 답은 점이 아니라 **구간**(68% · 95%)이며 성공 기준 셋을 먼저 등록했다. 3인 팀이라 완전 블라인드는 아니다.
  85°C 두 칩(chip26 · 23)은 정답을 봉인하지 않고 모델을 먼저 고정해 판정했다 — 「모델 고정 판정」 으로 구분한다(로그 52 [D52-17])

### 기대 결과물

1. 온도·전압에 따른 **유효 윈도우 축소 곡선**
2. 전압-클럭 평면의 **슈무 플롯** (온도별로 여러 장)
3. 마모 횟수에 따른 **비트 에러 증가 곡선과 Fail Map**
4. 마모 횟수에 따른 **지우기 시간 증가 곡선** (노화 지표)
5. 같은 모델 칩 여러 개의 **개체 간 여유 분포** — 개체 산포(σ)와 노화 이동량(Δ)을 분리해야 교정 곡선을 선이 아닌 띠(band)로 정직하게 보고할 수 있다
6. 블라인드 수명 추정의 **오차 정량화** — 계획은 ±X% 였고, 실제로는 구간의 포함 여부와 폭으로 낸다

**2026-11-11 기준으로 나온 것**: 4(소거 시간 곡선 — 마모 19칩, 교정 9칩) · 5(신품 31칩 분포와 두 무리) · 6(블라인드 3칩 — chip06 68% 안 · 기준 ③ 불통과 · chip26
합격 · chip23 불합격, 교정 9칩 교차검증 106점) 은 나왔다. 1 은 65 · 85°C 마모 이력까지라 온도별 윈도우 곡선이 아니고(소거 노화도 상온
개체 산포와 구별되지 않았다), 2(슈무)는 전용 보드가 없어 착수하지 않았으며, 3 은 NAND 확장이라 범위 밖에 남았다.
결과의 정본은 `docs/results/`, 요약은 `README.md`, 상태는 `docs/project_pipeline.md`.

---

## 8. 역할 분담 (3인, v2 — 2026-08-20)

| 담당 | 소유 영역 |
| ---- | --- |
| 한영웅 — 총괄 + Product Engineer | 실험 설계(칩 배분·반복성·블라인드·사전 등록), 판정 기준(θ·게이트·고장 판독표), MSA, 분석(`host/analysis/`), 사양서·인터페이스 계약, 게재물 승격. 코어·flash RTL은 지원으로 작성한 실적이 있으며 합격 판정은 넘긴다 |
| 팀원 A(박지민) — RTL 설계 / DV | 코어·flash RTL(`fpga/rtl/`), 빌드 플로우(xdc·tcl), G1 검증(cocotb 환경·Winbond 모델·회귀 실행·블록 승인 집행) |
| 팀원 B(장세은) — 하드웨어 / Test Engineer | DUT 보드(온도 축 우선), PS 펌웨어(`ps/` — 사전 쓰기·UID·소거 시간 계측·P/E 사이클러, PS C 로 구현됨), 실험 수행, 열 이력 실험, 시각화·chipdb |

원칙: 폴더 = 소유자, RTL 작성자와 회귀 승인자 분리(G1 판정은 3단계 분할 — `docs/roles.md` §팀원 A). 상세·미결(P/E 사이클러 층위 등)은 `docs/roles.md`.

---

## 9. 마일스톤

**욕조 곡선 마일스톤 (중간보고서, 게이트 순서 고정 — 상세는 `docs/workflow/4.gate_map.md`)**

1. **G0 루프백 욕조 곡선** — 칩·보드 없이 FPGA 단독으로 자기 배선의 곡선 실측. 최대 기술 리스크(MMCM 위상 제어)를 최우선 소진
2. **G1** cocotb + Winbond 모델 회귀 PASS — G0과 병렬 트랙(소유자·의존성 분리), 둘 다 PASS 후 G2 진입
3. **G2** 실칩 저클럭 브링업 (JEDEC ID)
4. **G3 실칩 욕조 곡선 1장** — 이 그래프가 프로젝트 전체 주장의 증명
5. **G4 반복성 정량화** — 재장착 포함 재현 편차. "측정이 노이즈가 아니라 신호"라는 증거

중간보고서 게재분 = 루프백 곡선 · 실칩 곡선 · 반복성 · 몬테카를로(위상당 읽기 횟수 N의 근거) · cocotb 검증 증거.
온도·전압 축은 의도적으로 이 마일스톤에서 제외 — 히터·레벨 시프터(전용 보드)가 전제라 일정 도박이 되기 때문.

**현황 (2026-11-11)**: 공모전은 2026-11-06 최종 발표로 끝났고, 지금은 졸업논문(M2 — `docs/workflow/14.contest_thesis_paper_milestones.md`) 단계다. G0·G2·G3·G4 통과(2026-07-09, 코어 RTL 동결). **마모는 2026-09-22 에 개시**했다 — P/E 엔진 실칩 인수 뒤 파일럿 chip01 로(G5 의 실제 경위는 아래). **G1(cocotb 회귀)은 진행 중**(회귀 21항목 PASS(9/23, 작성자 실행) · ① 판정 3블록 미판정 · F11 · F12 제외 · 게이트 미개방) — 합격 기준은 `docs/spec/s3.g1_test_plan.md`(2026-08-23 동결), G5 조건이 아니라 최종보고 조건이었다.

**중간보고서 이후 실제로 간 길 (base — NOR)**:

| 날짜 | 무엇 |
| --- | --- |
| 2026-09-15 - 09-20 | 신품 전수 측정(S-2) · 재장착 σ 13.86ps · 앵커 chip02 의 이탈이 측정계가 아니라 조립체 고장임을 가름 |
| 2026-09-22 | P/E 엔진 실칩 인수 → 파일럿 chip01 개시 |
| 2026-09-26 | 파일럿 300k 종료 — 폭 불변 · 소거 5.2배. 종단 칩의 종점을 100k · 13점으로 정하고 가설(H1′ - H6)을 사전 등록 |
| 2026-09-27 - 09-30 | 종단 3칩(chip03 · 07 · 04) — 신품 소거 시간으로 갈리는 두 무리 확인 |
| 2026-09-30 - 10-01 | 수명 역산 모델 v1 · v2 등록 · 블라인드 chip06 개봉(정답 12,000 을 68% · 95% 구간에 품음) |
| 2026-10-02 | chip17 칩 위 65°C 종단 종료 · **최종보고서 제출** |
| 2026-10-03 - 10-05 | 추가 구매분 종단(chip12 별개 칩 판정 · chip18 · chip15 교정 편입) · 모델 v3 → v3.2 |
| 2026-10-06 - 10-14 | chip02 · chip06(12k → 100k) 교정 편입 → 교정 9칩 · 모델 v4 등록(10-09) · chip16(65°C 설정) 온도 축 · JV chip14 교정 밖 승격(10-12, chip10 은 10-06) |
| 2026-10-12 - 10-23 | 200k 연장(chip06 · 09 · 03 · 15 · 07 · 02) · chip21 0 → 200k(신품 느린데 빠른 노화 — 교정 밖) · 85°C chip22 · 24 · **모델 v4.3 등록(10-23)** |
| 2026-10-15 - 10-25 | 추가 구매분 FV 6칩 · JV 10칩 신품 측정 → 신품 31칩으로 끝 |
| 2026-11-01 | 85°C chip26 · chip23 을 v4.3 으로 모델 고정 판정 — chip26 합격 · chip23 불합격(칩 종류) |
| 2026-11-06 | **최종 발표** — 공모전 끝. 수치는 v4.3(로그 54 [D54-3]) |
| 2026-11-10 - 11-11 | 교수님 피드백(11-02)으로 욕조 v2 설계(로그 55) — 명세 S-6 · 계약 수정안 #4 초안, 수정안 #1 을 같이 구현하기로 · 측정 원본을 처음부터 `data/` 에 쓰게 바꿈 |

**지금 하고 있는 것 (M2, 2026-11-11)**:

- **욕조 v2** — 교수님 피드백(벽 확대 · 좌우 비교 · 0/1 pdf · 칩별 · 체크포인트별 평균)에서 나왔다. 펌웨어 2단계 스윕(훑기 1회 → 벽 집중,
  25MHz)과 RTL 에지 계수기다. 명세 `docs/spec/s6.bathtub_v2.md` · 계약 수정안 #4(`docs/interface/amendments/4.edge_counter_bathtub_v2.md`)가
  초안이고, 수정안 #1(BASE_SECTOR)을 같은 작업으로 구현한다 — 구현 · 판정 한영웅, 검토 · 승인 박지민 · 장세은(로그 55 [D55-14] · [D55-15]).
  논문에서는 「기각한 지표와 그 이유」 장이다([D55-8]). 마모 체크포인트 스윕은 v1 그대로 둔다([D55-10])
- 기존 25MHz 스윕의 칩별 · 체크포인트별 평균 · 산포 — `host/analysis/bathtub_stats.py` 로 시작했고 닫지 않았다(로그 55 [U55-2])
- 남은 블라인드 chip08(v4.3 으로 판정) · 느린 신품 두 형의 처리(v4.4, 로그 52 [U52-7])
- 측정 원본은 2026-11-11 부터 캡처 · 실행기가 처음부터 `data/` 에 쓴다 — `build/` 에서 옮기는 단계가 없어졌다(`data/README.md`)
- M2 기한 · 데이터 마감은 학과 일정을 확인한 뒤 정한다(워크플로 14)

**G5 마모 개시 게이트** — 마모는 이 프로젝트에서 유일한 비가역 행위라 게이트를 뒀다: ① 전수 신품 측정 완료(S-2), ② 반복성 노이즈 플로어가 예상 노화 이동량 대비 충분히 작음을 확인, ③ 체크포인트 계획과 블라인드 절차의 사전 커밋. 실제로는 ①을 2026-09-20 에 닫았고, ②는 예상 이동량을 문서로 정하지 못한 채 파일럿 1칩을 미지수 해소용으로 먼저 돌려 답을 얻었으며(폭은 움직이지 않았다), ③의 블라인드 절차는 종단 3칩 뒤 블라인드 칩의 첫 P/E 전에 등록했다(S-1 §15, 2026-09-30 · 10-01).

**확장 (NAND — 조달·일정 충족 시)**: W25N 실에러 측정 — Fail Map, ECC 정정 한계, 3종 지표 체계, on-die ECC 제어

**확장 (제조사별 비교 — 조달 시)**: 동일 스펙·핀 호환 SPI NOR를 제조사별(Winbond W25Q64 외 GigaDevice GD25Q64, Macronix 등 동급 칩)로 확보하여 동일 프로토콜로 측정한다. 신품 윈도우 분포·노화 곡선이 제조사 간에 어떻게 다른지 비교 — 측정 플랫폼이 특정 칩이 아니라 SPI NOR 일반에 성립함을 보이는 일반화 축이다.

> 원칙: 계획 10페이지보다 실측 그래프 1장이 강하다.

---

## 10. 핵심 철학 (요약)

1. **판정이 아니라 계측.** PASS/FAIL은 1비트짜리 답이다. 우리는 그 안에 숨어 있던 연속적인 "여유"를 꺼내 숫자로 만든다.
2. **에러를 기다리지 않고, 경계까지 다가간다.** 측정 장비 쪽의 타이밍을 움직여 여유를 직접 잰다. 그래서 정상 칩에서도 실험이 성립한다.
3. **인터페이스의 거동은 칩 내부 상태의 센서다.** 윈도우 폭, 동작 시간의 변화는 온도·노화가 남기는 지문이다.
4. **주장과 데이터의 일치가 최우선.** 만든 점수 대신 단위가 있는 측정값을, 과장 대신 명시된 범위를.
5. **자기 측정을 먼저 의심한다.** 반복성으로 측정 노이즈 플로어를 확립한 뒤에만 노화 신호를 주장하고, 수명 추정은 블라인드로 검증한다. 장비의 신뢰성(Fault Injection, oracle 3종)부터 증명한 뒤 칩을 논한다.
