young-0320/flash-margin-bench/docs/roles.md

# 역할 분담 v2

Updated: 2026-08-20 (v1: 2026-07-06 초안) (2026-11-11 갱신)

| 사람 | 역할 | 주 소유 폴더 예시 |
| --- | --- | --- |
| 한영웅(총괄+PE) | 총괄 / Product Engineer | `docs/interface/`, `host/analysis/`, `docs/results/` |
| 팀원 A(박지민)  | RTL 설계 / Design Verification | `fpga/rtl/`, `fpga/constraints/`, `fpga/scripts/`, `sim/tb/` |
| 팀원 B(장세은)  | 하드웨어 / Test Engineer | `hw/`, `ps/`, `host/viz/`, `data/` |

---

## 협업 원칙 — 주 역할은 명확히, 서로의 일은 돕는다

폴더 = 소유자는 **책임 소재**를 정하기 위한 것. **자기 주 역할이 무엇인지 명확히 인지하되, 팀원의 일을 돕는 것을 목표로 한다.**

다만 **누가 무엇을 도왔는지는 기록에 남긴다.**

---

## 한영웅 — 총괄 + PE (Product Engineer)

### 역할 정의

**장비를 만드는 사람이 아니라, 장비로 판정 기준을 세우고 데이터로 결론을 내는 사람.**

Product Engineer는 산업에서 특성·신뢰성 평가 계획을 수립하고, 테스트 리밋과 가드밴드를 결정하며, 측정 시스템 자체의 신뢰성을 검증(MSA)하고, 데이터를 근거로 다음 단계 진입 여부를 판정한다. 설계자가 "어떻게 만들까"를, 검증자가 "스펙대로 도는가"를 묻는다면 PE는 **"이 숫자를 믿어도 되는가, 그래서 어떤 결론을 내릴 수 있는가"** 를 묻는다.

PE의 자리가 갖는 고유한 성격은 **결론을 내야만 한다**는 것이다. 연구자는 "데이터가 부족해 아직 모른다"로 끝낼 수 있지만 PE는 판정을 미룰 수 없다. 불충분한 데이터 위에서 방어 가능한 잠정 결론을 내고, 한계를 명시하고, 그 미지가 결론을 뒤집을 수 없음을 보이는 것이 직무의 핵심이다.

### 총괄

마일스톤과 게이트를 관리하고, 일정 판단과 3인 회의 안건 상정, 보고서 총괄 집필과 게재물 승격을 결정한다.

### 실험 설계

무엇을 측정할지보다 **어떻게 측정해야 믿을 수 있는지**를 먼저 정한다. 시료 배분, 반복 횟수, 블라인드 절차, 그리고 결과를 보기 전에 무엇을 고정해 둘지(사전 등록)를 설계한다.

> 사례 — 몬테카를로로 N=100을 실측 전에 결정하고 문서로 고정(로그 1) · W25Q64 ×10 배분(전수 신품 10 / 종단 마모 3\~4 / 블라인드 2 / 무마모 대조군 2 / 예비) · 마모 대상을 NOR 완결로 확정(2026-08-20) · 스윕 읽기 범위가 페이지 0\~99이므로 마모 범위를 4KB 섹터 0\~6으로 정합

### 판정 기준

측정값을 결론으로 바꾸는 규칙을 소유한다. 리밋, 합격 조건, 게이트 정의, 그리고 "이 증상이면 칩이 아니라 장비"를 가르는 판독 규칙까지. 타인이 만든 벤치·펌웨어에 대해서는 **구현 전에** 인수 기준을 못 박고, 나온 데이터로 판정한다.

> 사례 — θ 체계(10⁻² 채택 + 10⁻³·10⁻⁴ 병행 기록)와 체크리스트 5항 문턱값 · 게이트 G0\~G5 정의와 통과 판정 · 고장 서명 판독표(런북 3 표 E: 전 위상 BER 0.5 = PAY_LEAD 어긋남, 0.51 = 사전 쓰기 누락)

### 측정 시스템 분석 (MSA)

칩을 논하기 전에 자기 측정을 먼저 의심한다. 반복성·재현성으로 노이즈 플로어를 세우고, 장비 드리프트를 검출하고, 측정 능력 밖의 주장은 기각한다.

> 사례 — 반복 5회로 width 39,737.3 ± 0.61ps 확립(G4) · probit 편당 4점 미달로 BER 10⁻¹² 외삽을 자격 미달 기각, 대신 θ 3값 수렴(27ps)으로 직독을 정당화하고 σⱼ≤11ps 상한으로 방어(로그 15) · 남은 과제: 재장착·보드·일자를 포함한 %GRR·ndc

### 분석

판정과 분석 도구는 직접 만든다. 계측 대상(DUT·장비)의 코드가 아니라, 그 출력을 해석하는 코드다.

> 사례 — `host/analysis/`: `monte_carlo_sweep_params.py`(N·θ 사전 등록), `bathtub_analysis.py`(경계 판정·체크리스트 자동 판정), `repeatability_aggregate.py` · 교정 곡선(band) 구축, 개체 산포 σ와 노화 이동량 Δ 분리, 블라인드 추정 오차 정량화, 가드밴드 유도

### 사양서·계약

병렬 개발이 가능하도록 인터페이스와 요구사항을 문서로 먼저 고정한다.

> 사례 — `docs/interface/contract.md` v1(레지스터 맵·UART 프로토콜·측정 레코드 스키마) · `docs/spec/s3.g1_test_plan.md`(회귀 승인 기준) · 스트레스 벤치 사양(마모 범위·체크포인트·로깅 항목·중단 조건)

### 지원

코어·flash RTL 설계 실적이 있어(로그 6·7·11) RTL 트랙을 지원할 수 있다. 계측 엔진 내부를 아는 것은 PE 역할에도 직접 기여한다 — 측정 이상이 DUT 쪽인지 장비 쪽인지 데이터 서명만으로 가르는 판독표는 그 이해에서 나왔다. 지원으로 작성한 부분의 합격 판정은 협업 원칙에 따라 넘긴다.

---

## 팀원 A — RTL 설계 / Design Verification

### 역할 정의

**스펙을 논리로 구현하고, 그 구현이 스펙과 일치함을 독립적 근거로 증명하는 사람.**

설계자는 외부 스펙(레지스터 맵, 타이밍 요구사항)만 지키면 내부 구조를 스스로 결정한다. 검증자는 "돌아가는 것 같다"가 아니라 **제조사 공식 모델 같은 독립 기준(oracle) 상대로 통과했다**는 근거를 만든다. 이 프로젝트에서 RTL은 측정의 원점이므로, RTL이 틀리면 그 위의 모든 숫자가 무의미해진다.

### RTL

계측 엔진(`fpga/rtl/core/`)과 트랜잭션 계층(`fpga/rtl/flash/`)을 소유한다. 코어는 G0\~G4 통과 시점(2026-07-09)으로 동결됐고 남은 일정에 신규 코어 RTL 소요는 없으므로(온도·전압 축은 PS 영역), 실질 업무는 유지보수와 필요 시 수정이다. 내부 아키텍처 결정권을 갖는다.

> 사례 — MMCM 동적 위상 제어·스윕 FSM·AXI-Lite(core) · SPI 마스터 0x0B 시퀀서·패턴 생성기·op_timer·error logger(flash) · 현재 `flash_spi_ctrl.v` 등 3파일은 한영웅이 지원으로 작성한 것이며 로그 11이 인수인계·리뷰 기준

### 빌드 플로우

핀 배정·CDC 제약(xdc)과 Vivado 재생성 tcl을 소유한다. `.xpr`이 아니라 tcl이 소스다.

### 검증 (G1)

cocotb 환경과 Winbond 공식 행동 모델 회귀를 구축·운영한다. **G0\~G5 중 유일하게 착수되지 않았던 게이트**(2026-11-11 현재 회귀 21항목 PASS(9/23, 작성자 실행) · ① 판정 3블록 미판정 · F11 · F12 제외 · 게이트 미개방)이며, 오라클 3종 중 1종이 결손인 상태로는 "측정을 먼저 의심한다"는 프로젝트의 주장이 완성되지 않는다.

작성자와 승인자를 분리하기 위해, 합격 기준은 착수 **전에** 한영웅이 `docs/spec/s3.g1_test_plan.md`로 동결한다(2026-08-23 동결 완료). 몬테카를로 사전 등록과 같은 방어 기법이다.

**판정은 셋으로 나뉜다** — 인원이 3인이라 완전 분리가 불가능하기 때문이다. 한영웅은 기준 작성자이면서 채점 대상 RTL의 실제 작성자이고(위 §RTL), 박지민은 RTL 소유자이면서 그것을 채점할 TB의 작성자다. 어느 한 사람에게 판정을 몰면 분리가 절반만 성립한다.

| 단계 | 무엇을 | 누가 |
| ---- | --- | ---- |
| ① | 어서션이 기준 항목을 실제로 재는가 | 한영웅 (TB 비작성자) |
| ② | RTL이 그 어서션을 통과하는가 | 회귀 (자동, 재량 없음) |
| ③ | 블록 승인 집행 | 박지민 (RTL 소유자) |

상세와 커버리지 대조 규약은 `docs/spec/s3.g1_test_plan.md` §6. 대조 스크립트 `sim/check_coverage.py`는 기준 쪽 산출물이므로 한영웅 소유다.

### 지원

RTL과 시뮬레이션 환경을 아는 위치이므로, 실칩 브링업에서 고장이 RTL 쪽인지 배선 쪽인지 가르는 판단을 지원할 수 있다.

---

## 팀원 B — 하드웨어 / Test Engineer

### 역할 정의

**측정이 실제로 일어나게 만드는 사람.** 물리 계층(보드·소켓·전원·히터)과 실행 계층(펌웨어·실험 운영)을 세운다.

계획서와 분석 스크립트가 아무리 정교해도, 칩이 보드에 안정적으로 물리고 펌웨어가 조건을 재현 가능하게 만들어주지 않으면 데이터는 나오지 않는다. Test Engineer는 실험 조건을 **재현 가능한 형태로** 구현하고, 장시간 실험을 안정적으로 운영하며, 나온 데이터를 정리해 분석에 넘긴다.

### DUT 보드

SOP8 소켓, 가변 전원+레벨 시프터, 히터+온도 센서, 보호 회로를 설계·제작·브링업한다. 온도·전압 축이 여기서 열린다.

우선순위는 **온도 축(히터+센서) 먼저**다. 온도는 노화 서사와 직결되지만, 전압 축은 늦어져도 대체 게재물(클럭×위상 2D 맵)이 있다.

### PS 펌웨어

베어메탈 C로 측정 시퀀스와 실험 조건 제어를 구현한다. UART 명령 서버, 온도 PID, 칩 식별, 사전 쓰기, 마모 루프.

> 사례 — `core_smoke.c`(작성), `flash_jedec.c`(스펙·검토·캡처 소유) — 로그 14 · 소거 시간 계측: `flash_prep.c`의 섹터 erase에 WIP-busy 지속시간(XTime) 기록 — 노화 이중 지표의 후자 · P/E 사이클러: `flash_prep.c`의 erase/program 루프에 카운터를 더한 확장 (사이클 시간이 erase 45ms에 지배되므로 PS SPI 유틸리티 경로로 충분하며, RTL 사이클링 엔진은 과잉으로 판단해 PS C 상정 → 2026-11-11 갱신: `ps/src/flash_wear.c` 로 구현됨)

### 실험 수행

신품 전수 측정과 마모 배치를 실행하고, 측정 데이터를 정리한다. 9월 마모 구간에서 부하가 가장 크다 — 소켓이 하나라 직렬이고, 섹터 0\~6을 100k 사이클까지 돌리면 칩당 약 10시간(데이터시트 typ 기준 추정)이다.

### 열 이력 실험

리플로우 0/1/3/5회 그룹 실험을 프로파일 결정부터 보고서 집필까지 독립 챕터로 완결한다.

### 시각화·데이터

`host/viz/`(plot_bathtub, plot_shmoo, chipdb)와 `data/` 스키마를 소유한다. 스키마는 `docs/interface/` 계약을 따른다.

### 지원

실칩 브링업 현장을 가장 많이 보는 위치이므로, 판독표에 새 고장 서명이 나타나면 최초 발견자가 된다.

---

## 미결 (3인 확정 필요)

- ~~**G1 cocotb 착수 시점** — 범위 축소안 채택 여부~~ **해소 (2026-08-23, S-3 동결)**: 축소하지 않는다. 전 항목을 cocotb로 이관해 상시 회귀로 고정하되, **항목마다 오라클 출처(벤더 모델 / 자기 정합)를 명시**하는 방식으로 G1의 주장 범위를 정한다. 축소로 얻으려던 것은 범위가 아니라 "무엇을 증명했다고 말할 수 있는가"였다
- **로그 1 미결 F** — golden model 독립성 절차(시점 분리 재구현 vs 팀원 A의 교차 검증 벡터) 미해소. **S-3 범위 밖으로 확정**(`s3.g1_test_plan.md` §8) — G1 게이트 판정 시점에 별건으로 처리한다
- ~~**P/E 사이클러 구현 층위** — PS C(상정) vs RTL 엔진~~ **해소 (2026-11-11 갱신)**: PS C 로 구현됐다 (`ps/src/flash_wear.c`)
- ~~**v1 표기 정정 확인** — `sim/golden/` 폴더는 존재하지 않으며 golden model은 `host/analysis/`에 통합돼 있다. 폴더를 신설할지 통합을 확정할지 결정 필요~~ **확정 (2026-11-11 갱신)**: 통합 유지 — golden model 은 `host/analysis/` 에 있고 golden 폴더는 만들지 않았다 (`sim/README.md` 정합)
