young-0320/flash-margin-bench/docs/results/reports/final_report_material_2026-10.md

# 최종보고서 재료 — 핵심 수치 · 계획 대비 달성 · 그림 (2026-10-01)

> 보고서 본문(워드)에 옮길 숫자와 표를 출처와 함께 한곳에 모은다. 본문 숫자는 여기와 대조한다. 해석의 정본은 각 출처 문서다.

## 1. 핵심 수치

### 1.1 계측기

| 항목 | 값 | 출처 |
|---|---|---|
| 위상 스텝 | 15.873ps (25MHz, MMCM 동적 위상 이동) | 스윕 CSV `dphi_ps` |
| 스윕 | 25MHz · 위상당 읽기 N = 112 · 2,048 비트 · 2,520 스텝 | 집계표 측정 조건 |
| 반복 정밀도 (재장착 σ) | **13.86ps** (chip10 재장착 3회) · 판정 기준 3σ = 42ps | `data/newchip_survey_2026-09.md` §6 |
| 신품 25MHz 유효 창 폭 | 38,730-39,802ps (15칩) — 40ns 주기의 약 97-99% | 집계표 §1 |
| 알고리즘 사전 검증 | 몬테카를로로 N=112 채택 (폭 추정 오차 규칙 한계의 1/6 이하) | `data/monte_carlo_n112_20260823.md` |
| 측정계 고장 분리 | 앵커 chip02 조립체 고장(−300ps 이탈)을 대조 칩 3점으로 분리 · chip07 배선 사건(+590ps)을 경로 서명으로 분리 | `newchip_survey.md` · `wear_endurance_chip07.md` |

### 1.2 신품 전수 측정

| 항목 | 값 |
|---|---|
| 측정 | **31칩** (2026-10-25 끝, 측정 불가 chip05 · 11 · 13 제외) — FV 19(원 배치 8 · 추가 5 · 3차 6, chip12 포함) · JV 12(원 배치 chip10 · 추가 chip14 · 디바이스마트 chip30-39) |
| 신품 소거 시간 두 무리 | 경계 40ms, 빠른 19 · 느린 12. FV 빠른 24.9-33.7 · 느린 47.0-51.1ms(사이 빈 구간) · JV 빠른 24.5-36.3 · 느린 52.7-53.4ms |
| UID 앞바이트 `DF` JV 7칩 | chip10 · 14 · 32-35 · 39 — 폭 38,704-38,918ps 로 나머지 24칩(39,327-39,821)과 겹치지 않음. 소거 33-53ms. JV 중 `D16x` 4 · `CA` 1 은 FV 띠 |

### 1.3 마모

| 칩 | 무리 | 마모 | 마진(25MHz 폭) | 소거 (신품 대비, 섹터 중앙값) | 계단 | 프로그램 시간 |
|---|---|---|---|---|---|---|
| chip01 | 빠름 | **300k** (파일럿) | 신품 대비 +15.5ps (불변) | 300k 5.2배 · 100k 4.0배 | 34-62k | 오름(약 145k 부터) |
| chip04 | 빠름 | 100k | −3.7-+3.2ps (불변) | 100k 3.6배 | 25-47k | 불변 (6.94-6.96ms) |
| chip09 | 빠름 | **200k** (교정 100k 2026-10-01 · 연장 10-14) | 체크포인트 100 대비 +25ps 안 (불변) | 200k 4.15배 · 100k 2.8배 | 92k 1섹터 · 110-157k 나머지 6섹터 | 불변 (200k 6.56ms · 1.01배) |
| chip06 | 빠름 | **200k** (블라인드 12k → 교정 100k 10-12 · 연장 10-13) | 보드 A 안 ±8ps (불변 · 재장착 단차 −55ps 제외) | 200k 4.18배 · 100k 2.97배 | 90k 1섹터 · 116-158k 나머지 6섹터 | 오름 (200k 12.4ms · 1.9배) |
| chip03 | 느림 | **200k** (종단 100k 2026-09-27 · 연장 10-15) | +3.6ps · 재장착 뒤 +16ps 안 (불변) | 200k 2.10배 · 100k 1.74배 | **없음 — 85-93ms 에서 105 를 미끄럼으로 지남** | 20k 부터 오름 (200k 13.6ms · 2.0배) |
| chip07 | 느림 | **200k** (종단 100k 2026-09-29 · 연장 10-21) | 25MHz 불변 (20cm 선 → 10cm 교체 뒤 띠 안) | 200k 1.91배 · 100k 1.6배 | 없음 — 미끄럼 | 4-12k 부터 오름 (200k 19.5ms · 2.9배) |
| chip02 | 빠름 | **200k** (교정 100k 2026-10-07 · 연장 10-22) | 장착 단차 +128ps 외 불변 | 200k 4.00배 · 100k 2.60배 | 148-178k (빠른 무리 중 가장 늦음) | 20k 부터 오름 (200k 약 3배) |
| chip15 | 느림 | **200k** (교정 100k 2026-10-04 · 연장 10-16) | −19 - +13ps (불변 · 재장착 포함) | 200k 2.25배 · 100k 1.75배 | **없음 — 미끄럼 (chip03 과 같음)** | 24k 부터 오름 (200k 12.6ms · 1.5-2.0배) |
| chip21 | **신품 느림(48.9ms) · 노화 빠름** | **200k** (0 → 200k 한 세션, 2026-10-16 - 10-19) | −6 - +3ps (불변) | 200k 2.93배 · 100k 2.63배 | 없음 — 미끄럼인데 빠른 속도 | 150k 까지 불변, 뒤에 2섹터만 +26-29% |

- **마진은 정격 내구의 1-3배까지 3σ(42ps) 안에서 움직이지 않았다** — 사전 등록 H1·H1′ 참 (25·45·75MHz)
- **계단**: 빠른 무리만, 약 85ms → 약 103-111ms 로 섹터마다 따로 뛴다 (높이 18.1-23.1ms). 100k 안에 없던 칩(chip06 · 09)도 200k 까지 가면 110-158k 에 전부 밟았다 — 「있고 없고」 가 아니라 「언제」. 느린 chip03 · 15 는 같은 85-93ms 에서 200k 까지 가도 계단 없이 미끄러졌다(한 구간 상승 4-12 · 분포 폭 18-25ms) — 계단의 유무가 두 무리를 가른다 (`wear/wear_endurance_200k.md`)
- **신품 소거는 빠른 노화를 예측하지만 느린 노화를 보증하지 않는다**: 신품 40ms 미만 6칩은 전부 빠르게 늙었고(계단), 40ms 이상 5칩 중 2칩(chip12 · 21)은 빠른 속도로 미끄러졌다. 개봉 전 한 점으로는 못 가른다 (`wear/wear_endurance_200k.md` §8)
- **같은 빠른 무리 안 노화 속도**: 곡선 맞춤 속도 비 chip04 대 chip09 2.9배 · chip01 대 chip09 2.0배 · chip01 대 chip04 1.3배 (`wear_inverse.py --rate-rule`)

### 1.4 수명 역산 모델

| 항목 | 값 | 출처 |
|---|---|---|
| 입력 | 개봉 prep 의 섹터별 소거 시간만 (안 닳은 섹터 32-127 = 그 칩의 신품값) | S-1 §15 · 개념 15 |
| 형식 | 베이즈 역추정 — 교정 칩 경험 분포 우도 × 평평한 사전(1-100k) · 무리 경계 40ms · 배율 눈금 · 속도 배율 r ∈ [1/2, 2] | `host/analysis/wear_inverse.py` |
| 교정 | 5칩 — 빠른 chip01·04·09 · 느린 chip03·07 (A 행 1k 구간 × 섹터 분위수) | `data/wear_curves/` |
| LOCO (교정 칩끼리, 58점) | 68% 구간 적중 72% · 95% 구간 적중 98% · 68% 폭 중앙값 44,000 | 로그 48 [D48-60] |
| 합성 복원 (500회) | 처음 보는 칩 · prep 5회 — 판정용(5칩 · R 2.0) 68%/95% 적중 66/91% · 4칩 R 2.0 68/96% · prep 독립 우도는 53/81% 로 과신 | `data/synthetic_recovery_2026-10.md` §1·§4b |
| 진단 시간 | prep 1회 약 40초 · 5회 약 3-4분 + 계산 수 초 | 세션 로그 |
| 한계 | 계단 이후(빠른 무리 약 5만 회 이상)는 MAP 이 낮게 치우치고 범위만 준다 | S-1 §15 개봉 전 기록 |
| Δx (연구용) | 5천 회 추가 시 chip06 구간 68% 폭 23,500 → 13,000 (약 45%↓), 1천 회는 효과 없음 | 이 문서 §1.6 |

- **쓰던 칩에서 "신품값"을 어떻게 얻나** — 과거 기록이 아니라 지금 칩 안에 남아 있는 **지운 적 없는 섹터**를 재는 것이다. 마모는 칩이
  아니라 섹터 단위로 쌓이므로(산화막에 갇힌 전하는 그 섹터의 것), 종단 3칩에서 섹터 0-6 을 10만 번 지운 뒤에도 섹터 32-127 의 소거
  시간은 신품 대비 **1.00** 이었다(같은 128KB 안 7-31 은 소거 교란으로 1.06-1.25 라 기준에서 뺀다). 현장 NOR 은 코드 영역과 핫스팟이
  한 칩에 공존해 이 조건이 기본형이다. 전제는 "지우지 않은 섹터가 있다" 이고, 웨어 레벨링으로 고르게 닳은 칩에는 적용되지 않는다

### 1.5 블라인드 (chip06) — 정답 12,000

`data/blind_chip06_2026-10.md` · 해석 `blind_chip06.md`. v2(판정용) MAP 7,001-8,000 · 68% 3,001-19,000 · 95% 1,001-34,000 →
**정답 12,000 이 68%·95% 안, 49번째 백분위**. 성공 기준 ① 통과 · ② 통과 · ③ 불통과(68% 폭 16,000). 정격 대비 실제 사용률 12% 가
추정 3-19%(68%) 안. v1(교정 4칩)은 정답을 68% 밖(79번째 백분위)에 두었다. tally 120/120 바이트 = 지민 기록 12,000.

> **2026-11-01 추기 — 85°C 온도 칩 둘 (v4.3, 정답 봉인 없이 모델 고정)** (`blind_temp_chip23_chip26.md`): chip26(빠른, 정답 70,000) 60-61k · 68% 31-85k — **68% 안, 0.86배, 기준 셋 통과**.
> chip23(느린, 정답 26,528) 92-93k · 95% 78-100k — **3.5배 과대, ① 불통과**. 같은 사이클 배율이 상온 chip21 · 12(느린 신품 · 빠른 노화)와 같아 원인은 온도가 아니라 v4.3 이
> 한계로 적어 둔 칩 종류. 그림 `plots/blind_temp_chip23_chip26_2026-11.png`

### 1.6 Δx 효과 (교정 5칩 LOCO, R 2.0)

| Δx | 추가 시간 (7섹터, 신품 근처) | 68% 폭 (x 3-20k) | 68% 폭 (전체) |
|---|---|---|---|
| 0 | 0 | 23,500 | 44,000 |
| 1,000 | 약 6분 | 24,000 | 44,000 |
| 2,000 | 약 12분 | 19,500 | 41,000 |
| 3,000 | 약 18분 | 17,500 | 41,000 |
| 5,000 | 약 30분 | 13,000 | 36,000 |
| 10,000 | 약 1시간 | 14,500 | 30,000 |

구간당 LOCO 점이 10개 안팎이라 경향으로 읽는다.

> **2026-10-05 — 교정 7칩으로 다시 보니 이 효과는 x 20k 이하에서만 남았다.** 50k 넘는 점과 chip18 · chip15 에서 Δx 가 틀린 쪽으로 좁혀 모델에서 뺐다(로그 48 [D48-93] · `docs/results/data/inverse_v3_probe_2026-10.md` §1). 발표에서 Δx 를 성과로 쓰지 않는다

### 1.7 온도 축

> **2026-10-23 갱신 — 65 · 85°C 네 칩**(`wear/wear_temperature_85C.md`): chip24(83°C · 빠른) 3.47배 · 상온 모델 12/12, chip22(85°C · 느린) 1.90배 · 68% 3/12 · 95% 12/12.
> 네 칩 합쳐 상온 개체 산포 안, 상온 모델 95% 47/48 · 68% 22/48 — 「85°C 까지 범위 답 유지, 고온 이력 칩에는 범위로 답한다」
> **2026-11-01 — 85°C 두 칩 더**: chip26(84°C · 빠른 · 70k 2.47배)은 상온 빠른 무리 안, chip23(85°C · 느린 · 26.5k 1.77배)은 상온 chip21 · 12 형 자리 — 느린 무리 85°C 신호는 여전히 chip22 한 칩

chip17(빠른 무리, 새 로트) 65°C 종단 10만 회 — 기술적 한계로 80°C 계획에서 낮춤, 10/2 끝(박지민 리그). 결과와 보고서 문장은
`docs/results/wear/wear_temperature_chip17.md`(문장은 로그 48 [D48-65] 확정): 폭은 10만 회 동안 3σ 안, 소거는 상온 빠른 무리보다 덜 늘고
프로그램 +20%, 65°C 효과는 개체차와 구별되지 않음, 상온 역산 모델은 이 칩의 사용량을 0.15-0.35배로 낮게 봄. 10/2 저녁 25°C 로 식혀 잰
스윕은 25MHz 폭이 65°C 13점보다 +40 - +58ps 넓고 창 위치는 같았다 — 유의미한 변화로 보지 않아 보고서에 더하지 않는다([D48-72]).
측정 온도 계수 · 되돌림 점(25→65→25°C) · 25°C prep(소거 시간)은 최종 발표.

> **2026-10-12 추기 — 온도 축 두 번째 칩 chip16** (`docs/results/wear/wear_temperature_chip16.md`, 로그 53 [D53-4]). 같은 히터 · 설정 65°C 로 돌린 chip16 은
> chip17 과 반대로 상온 빠른 무리의 빠른 쪽처럼 늙었다(소거 10만 회 4.34배 · 계단 있음 · 프로그램 불변 · 폭 3σ 안 · 상온 v4 모델이 12점 중 10점 68% 안).
> 온도 로그가 히터 상태와 맞지 않아 칩 온도는 미확인. 발표 문장은 해당 문서 「발표 · 논문 문장」 제안 — 「65°C 효과는 개체차와 구별되지 않는다」 는 그대로

## 2. 중간계획서 대비 달성

| 중간계획서 (Ⅰ.3 목적 · Ⅳ 실험 축) | 달성 | 비고 |
|---|---|---|
| ① 피코초 위상 스윕 계측 엔진 | **달성** | 15.9ps 스텝 · σ 13.86ps · 몬테카를로 검증 · 15칩 측정 |
| ② 온도·전압·마모 마진 축소 곡선 | **마모만, 그리고 마진은 줄지 않음** | 마진 불변은 사전 등록 예측(H1)으로 확인한 결과. 온도는 65°C 10만 회 1칩에서도 마진 불변, 전압 미착수 |
| ③ 마모량 교정 곡선 + 블라인드 오차 정량화 | **지표를 바꿔 달성** | 마진 대신 소거 시간. 교정 5칩 · 블라인드 1칩(chip06) · 기대 오차는 LOCO·합성 복원으로 |
| ④ 중고·재생 칩 판별, 고장 예지 시연 | **부분** | 신품·사용품 등급(정격 대비 사용률)은 역산 모델이 준다. 실제 중고 칩(그룹 D) 시연 없음 |
| 그룹 A 신품 기준 분포 (N≥3) | **초과** | 15칩 |
| 그룹 B 교정 곡선(띠) | **달성** | 5칩 · 1k 구간 p10/p50/p90 띠 · 0-100k (chip01 300k) |
| 그룹 C 블라인드 | **달성 (1칩)** | chip06. chip08 은 발표까지 (chip15 는 10/4 느린 교정으로 옮겨 10/5 편입 — 새 블라인드는 새 10칩에서, 로그 48 [D48-90]) |
| 그룹 D 진짜 중고 칩 | 미달성 | |
| 온도 25/40/60°C | **부분** | 65°C 종단 10만 회 1칩(chip17) + 25°C 스윕 한 번 — 온도 두 점 · 칩 하나 |
| 전압 축 · 슈무 플롯 | 미달성 | 가변 전원 보드 미완 |
| NAND (W25N) · ECC · Fail Map | 범위 조정 | base 를 NOR 로 완결 (`docs/project_context.md`) |
| 열 이력(리플로우) · 제조사 · 등급 비교 | 미달성 | |
| 칩 개체 이력 관리 | **달성** | UID 기반 등록부 · P/E 장부 · 세션 기록 |
| 자동화 · 1-Click 진단 | **부분** | 마모·체크포인트·스윕 자동 실행기, 역산 한 줄 명령. 진단 화면은 발표 전 |

## 3. 그림

| 그림 | 경로 | 보고서 용도 |
|---|---|---|
| 욕조 곡선 (신품) | `docs/results/plots/bathtub/v1/bathtub_*` | 계측기 원리 |
| 노화 곡선 4칩 (섹터별) | `docs/results/plots/wear/wear_curves_2026-09.png` | 마모 실험 |
| **노화 배율 곡선 5칩 + chip06 관측선** | `docs/results/plots/wear/wear_ratio_curves_2026-10-04.png` (10/2 5칩판은 지움 — 이 그림은 chip18 까지 6칩) · 발표용 현행 `wear_ratio_curves_2026-10-05.png`(chip15 까지 7칩) | 같은 무리 안 속도 차이 · 블라인드 범위가 넓은 이유 |
| **합성 복원** | `docs/results/plots/synthetic_recovery_2026-10.png` | 모델 확률의 정직성 · 우도 수정을 되돌린 근거 |
| 몬테카를로 | `docs/results/plots/monte_carlo_*` | 알고리즘 사전 검증 |
