young-0320/flash-margin-bench/docs/operating_manual.md

# 조작 설명서 — 사람이 치는 명령

이 문서는 **무엇을 어떤 순서로 치는가**의 정본이다. 워크플로 문서(`docs/workflow/`)는 그날의
계획이고, 여기는 계획과 무관하게 항상 같은 조작법이다. 명령이 바뀌면 **여기를 먼저 고친다.**

- 파이프라인 전체 지도(무엇이 무엇으로 이어지는가): `docs/project_pipeline.md`
- 빌드 절차만: `docs/build_reproduction.md`
- 측정 사양(왜 그 조건인가): `docs/spec/`

---

## 0. 계층 — 무엇을 직접 치는가

```
[최상단]  사람이 친다
    reproduce.py                    빌드·검증 전체 (보드 없이)
    host/run/run_sweep_chip.py      실칩 측정 (prep → 스윕 → 분석)
    host/analysis/bathtub_analysis.py   분석만 다시
    host/run/run_wear.py            마모 벤치 — 미구현 (W10-W)

[중하단]  위 스크립트가 부른다. 직접 칠 일은 드물다 — §3 에 그 드문 경우만
    host/capture/sweep_uart_capture.py   UART → CSV
    host/capture/chip_registry.py        등록부 파서
    host/run/chip_pe.py                  P/E 이력
    ps/scripts/program_*.tcl             xsct 프로그래밍
    ps/scripts/build_*.py                Vitis ELF 빌드
    fpga/scripts/build_*.tcl             Vivado 비트·XSA

[보드 위]  ELF. 사람이 직접 실행하지 않는다 (xsct 가 올린다)
    flash_prep · flash_id · flash_jedec · g0_sweep/g3_sweep · core_smoke
```

**터미널은 하나면 된다.** 최상단 스크립트가 UART 를 쥔 채 xsct 를 부르므로, 캡처용 창을
따로 열 필요가 없다. (직접 `sweep_uart_capture.py` 를 쓸 때만 창이 둘 필요하다 — §3)

---

## 1. `reproduce.py` — 빌드·검증

보드가 필요 없다. 새 PC 에서 처음 하거나, 소스를 고친 뒤에 돌린다.

```bash
python reproduce.py                    # 전체 9단계 (약 9분)
python reproduce.py --only g3-25       # 한 단계만
python reproduce.py --vitis-only       # ELF 만 다시 (Vivado 생략)
python reproduce.py --list             # 단계 목록과 실제 명령
```

| 옵션 | 언제 |
| --- | --- |
| `--only <단계…>` | 한두 단계만. 단계 이름은`--list` 에 |
| `--vitis-only` | C 코드만 고쳤을 때 (비트스트림 재사용) |
| `--no-sim` / `--no-selftest` | `iverilog`·`uv` 가 없는 PC (Windows)  |
| `--keep-going` | 실패해도 끝까지 — 기본은 첫 실패에서 중단 |

기본 단계: `sim · selftest · g0 · g2 · prep · id · g3-25 · g3-45 · g3-75`
선택 단계(`--only` 로만): `jedec · smoke · g0e · g3e-25/45/75`

**읽는 법.** 각 단계는 6겹으로 채점된다 — 종료 코드 · 완료 문구 · 산출물 존재와 갱신 ·
타이밍 충족 · 수치 기준표 · 빌드 파라미터. `WARN` 은 실패가 아니라 기준표와 다른 것이고
**로그에 적을 거리**다. 요약은 `build/logs/reproduce_<UTC>/summary.txt` 에도 남는다.

Vivado/Vitis 가 PATH 에 있어야 한다 — `source ~/Xilinx/2025.2/Vitis/settings64.sh`
(Windows 는 `settings64.bat`). 영웅 PC 는 `.bashrc` 에 들어 있어 따로 칠 필요가 없다.

---

## 2. `run_sweep_chip.py` — 실칩 측정

한 프로세스가 UART 를 쥔 채 **세션1 → 세션2 → 분석**을 잇는다. 세션 사이에 사람이 끼면
UID 가 CSV 에 닿지 못하므로 한 명령으로 묶여 있다(로그 23 §0).

```bash
uv run python host/run/run_sweep_chip.py --mode <newchip|sweep> --mhz <25|45|75> [옵션…]
```

### 모드 — 무엇을 하는가 (필수)

| | `--mode newchip` | `--mode sweep` |
| --- | --- | --- |
| 세션1 | `flash_prep` — JEDEC·UID·blank 조사 → **소거 + 정답지(PRBS) 쓰기** | `flash_id` — JEDEC·UID 만 읽는다 |
| **P/E** | **+1** (`chip_pe.md` 에 기록) | **0** |
| 칩 식별 | 기계가 읽고, 신규면 라벨을 묻는다 | 기계가 읽어 등록부에서 라벨을 찾는다 |
| 세션2 | g3 비트 + 스윕 ×N | 같음 |
| 분석 | 자동 | 같음 |

**모드가 정한 것은 옵션으로 뒤집을 수 없다.** `sweep` 에 prep 을 켜는 스위치가 없고,
`newchip` 에 `--chip` 을 줄 수 없다. 앵커 재측정에서 옵션을 빠뜨려 칩을 한 번 더
마모시키던 사고를 **표현 불가능**하게 만든 것이다.

### 옵션

| 옵션 | 기본 | 무엇 / 언제 |
| --- | --- | --- |
| `--mode` | **필수** | 위 표 |
| `--mhz` | **필수** | SPI 클럭. 어느 g3 비트를 구울지 정한다. 기계가 알 수 없는 값이라 필수다 |
| `--chip NN` | 없음 | **재고 싶은 칩.** `2`·`02`·`chip02` 다 받는다. 주면 읽은 라벨과 대조해 어긋나면 중단. 생략하면 읽은 대로 간다 |
| `--repeat N` | 1 | 스윕 반복. 세션1 은 1회, 스윕만 N회 |
| `--reseat` | 꺼짐 | 회차**사이**에 재장착 프롬프트 + UID 재확인. `--repeat 2` 이상에서만 |
| `--pl {4,6}` | 없음 | PAY_LEAD 보험 비트스트림. 전 위상 BER 0.5 가 나올 때(75MHz 임계). 비트는 먼저 굽는다 (`-tclargs bit <mhz> <k>`) |
| `--port` | `/dev/ttyUSB1` | Windows 는`COM<N>` |
| `--baud` | 921600 | 2026-09-15 이전에 구운 ELF 는`115200` |
| `--base-sector` | 0 | 수정안#1 미승인 — 0 만 허용 |
| `--blind` | 꺼짐 | `chip_pe.md` 에 증분 대신 `(봉인)`. `newchip` 에서만 |

N(위상 스텝당 읽기 횟수)은 옵션이 아니다 — 실칩은 **112 고정**이고 ELF 에 박혀 있다.
스크립트는 `BEGIN` 의 `n=` 을 보고 다르면 **첫 줄에서** 중단한다.

### 상황별

```bash
# 신품 첫 투입 (chip05~10) — P/E +1
uv run python host/run/run_sweep_chip.py --mode newchip --mhz 25

# 등록된 칩 재측정 — 어느 칩인지는 기계가 안다. P/E 불변
uv run python host/run/run_sweep_chip.py --mode sweep --mhz 25

# 앵커를 집어야 할 때 — 다른 칩을 꽂았으면 스윕 전에 걸린다
# (앵커는 prep 없이 잰다 — 재장착 성분만 보려는 것이고 P/E 도 안 쓴다. S-2 §8)
uv run python host/run/run_sweep_chip.py --mode sweep --mhz 25 --chip 2

# 재장착 σ — 3회, 회차 사이마다 빼고 다시 꽂는다 (매번 UID 재확인)
uv run python host/run/run_sweep_chip.py --mode sweep --mhz 25 --chip 2 --repeat 3 --reseat

# 조사·사전 쓰기만 하고 스윕은 나중에 → 전용 모드는 없앴다.
#   newchip 으로 돌리고 스윕 결과를 버리거나, 나중에 sweep 으로 다시 잰다
```

### 실패하면 무엇을 보는가

| 증상 | 뜻 | 볼 곳 |
| --- | --- | --- |
| `session_idfail_*.log` | **꽂힌 칩이 다르다** — 그것만 이 이름이다 | 로그의 읽은/기대 UID |
| `session_prepfail_*.log` | `flash_prep` 이 PASS 전에 죽었다 | `#PREP FAIL`·`#PREP ERROR` 줄 |
| `session_<batch_id>.log` (개명 안 됨) | ELF 누락·타임아웃 등 칩 신원과 무관한 실패 | 마지막 몇 줄 |
| `*_invalid.csv` | 스윕이 완주하지 못했다 (행 결측·중단) | `#G0 SWEEP END` 줄의 `valid=`  |
| `분석 실패 — 측정은 유효하다` | CSV 는 정상. 분석만 다시 돌리면 된다 | §4 |

세션 로그는 `build/data/session_*.log`, CSV 는 `build/data/sweep_*.csv` 에 생긴다.
**측정이 끝나면 원본을 `data/` 로 옮긴다** — `build/` 는 재빌드 때 지워진다.

---

## 3. 중하단을 직접 부를 때

평소에는 최상단이 부른다. 직접 칠 이유가 있는 경우만 적는다.

```bash
# 보드↔칩 통신만 확인 (배선 의심, 게재 2번 캡처) — 1초 주기 반복
xsct ps/scripts/program_g2.tcl build/vitis_jedec/flash_jedec/build/flash_jedec.elf
uv run python -m serial.tools.miniterm /dev/ttyUSB1 921600

# 이 칩이 몇 번인지만 확인 — 쓰기 없음, P/E 0
xsct ps/scripts/program_g2.tcl build/vitis_id/flash_id/build/flash_id.elf

# UID → 라벨 역조회 (보드 불필요)
uv run python host/capture/chip_registry.py --lookup D1642C74E7134527

# UART 원문만 보고 싶다 (진단) — CSV 를 만들지 않는다
uv run python host/capture/sweep_uart_capture.py --raw

# G0 루프백 캡처 (실칩 없이 계측기 점검) — 터미널 둘이 필요하다
uv run python host/capture/sweep_uart_capture.py --loopback     # 터미널 1 (먼저)
xsct ps/scripts/program_g0.tcl                                  # 터미널 2
```

**수신을 먼저, 송신을 나중에.** 보드는 ELF 가 뜨는 순간부터 뿜는다. 최상단 스크립트는
이 순서를 스스로 지키지만, 직접 부를 때는 사람이 지켜야 한다.

---

## 4. `bathtub_analysis.py` — 분석만 다시

```bash
uv run python host/analysis/bathtub_analysis.py data/sweep_chip04_<uid>_<stamp>.csv --json
```

`--json` 이면 수치가 `<입력>.analysis.json` 으로도 남는다. 화면에는 폭 3종(1e-2/1e-3/1e-4)과
체크리스트 5종이 뜨고, 그림은 `build/plots/bathtub_<stem>.png` 다.

측정 중에는 `run_sweep_chip.py` 가 자동으로 부르므로 직접 칠 일은 **파라미터를 바꿔 다시
볼 때**와 **자동 분석이 실패했을 때**다.

**체크리스트 5번(BER 연속성)이 FAIL 이면 곡선이 아니라 RTL 을 의심한다** — 한 스텝 만에
BER 이 0.001 → 0.25 로 뛰는 것은 물리적으로 불가능하고, 캡처 비트 정렬 슬립의 서명이다.

관련: 신품 조사 수치를 세션 로그에서 뽑는 파서 —
`uv run python host/analysis/prep_survey_parse.py data/session_chip04_*.log [--csv]`

---

## 5. 하지 않는 것

- **`sweep` 모드로 P/E 를 쓰지 않는다.** 그런 인자가 없다. 사전 쓰기가 필요하면 `newchip` 이다
- **`--chip` 으로 라벨을 "지정"하지 않는다.** 그것은 대조용 선언이고, 실제 라벨은 UID 가 정한다
- **신규 칩을 등록부에 손으로 적지 않는다.** `newchip` 이 기계가 읽은 UID 로만 등록한다
- **`build/` 안의 측정 원본을 그대로 두지 않는다.** 재빌드 때 사라진다 — `data/` 로 옮긴다
