young-0320/flash-margin-bench/docs/log/young/45.pe_engine_build_to_sim.md

# 45. P/E 엔진 구현 — 실칩 앞에서 멈췄다

- **작성일**: 2026-09-21
- **발단**: [로그 44](44.pe_engine_prebuild_review.md) `[D44-15]` 로 경계·S-4·S-1 을 잠그고 구현에
  들어갔다. TB 를 잠근 정본에 맞추고, `flash_prep` 을 파라미터화하고, 엔진 C 와 호스트
  시뮬레이션·어댑터·실행기를 만들어 실칩에 P/E 를 내는 첫 명령 직전까지 갔다
- **목적**: 정본이 비워 둔 디테일을 어떤 값으로 채웠고, 왜 그 값인가? 실칩 앞에서 무엇이 아직
  안 닫혔나?
- **관련**: `docs/interface/pe_engine.md` §2 · `docs/spec/s4.blackbox_tb.md` §4·§5.2·§9 ·
  `docs/spec/s1.wear_bench_spec.md` §6~§10 · [로그 41](41.blackbox_tb_and_engine_interface.md) ·
  [로그 42](42.blackbox_tb_gaps_and_jimin_reply.md) · [로그 44](44.pe_engine_prebuild_review.md) ·
  `host/tests/` · `ps/src/flash_wear.c` · `ps/sim/` · `host/run/wear_link.py` · `host/run/run_wear.py`
  · (후속 §12~§16) `reproduce.py` · `docs/build_reproduction.md` · `docs/workflow/12.pe_engine_acceptance_runbook.md` ·
  `docs/spec/s1.wear_bench_spec.md` §8.1 · [로그 33](33.reproduce_windows_support.md) · [로그 32](32.reproduce_script.md)

## 결정

- [D45-1] 응답(`OK`/`REJECT`)의 체크섬은 첫 글자부터다 — 접두가 없다 (2026-09-21, 한영웅의 AI) — §1 · `host/tests/host_side.py`
- [D45-2] 명령 채널의 tally 값(`TALLY`·`RESUME`)은 바이트 수이고 사이클(×100)로 바꾸는 것은 어댑터다. 경계 3·5 의 반환은 mock 과 같이 사이클이다 — §2 · `host/run/wear_link.py`
- [D45-3] `REERASE` 는 `recovering` 이고 **같은 범위의 마지막 `blank_check` 가 잔류를 봤을 때만** 받으며, 잔류가 있는 섹터만 지운다. 아니면 `E_STATE` — §3 · `ps/src/flash_wear.c` · `host/tests/mock_engine.py`
- [D45-4] `write_ok` 는 비파괴 시험이다 — WREN 뒤 WEL 이 서고 BP 가 0 이면 참, WRDI 로 되돌린다 — §4 · `ps/src/flash_wear.c`
- [D45-5] `BLANK` 는 `E_NSECT0`·`E_RANGE` 만 검사한다(읽기라 tally·대조군을 막지 않는다). 부팅 시 `pattern` 은 `0x00` 이라 START 전 `BLANK` 의 `program_fail` 대조값도 `0x00` 이다 — §5
- [D45-6] 정본에 자리가 없는 세 경우의 코드 — 전송 3회 실패는 그 op 의 `program_fail`/`erase_fail` R 행 + `error`, 인자 누락·비숫자는 `E_RANGE`, 모르는 동사는 `E_STATE` — §6
- [D45-7] B(전원 장애 복구)의 「정상 진행」은 재개 뒤 `wear_start(cycle=채택값)` 이 받아들여져 5사이클을 완주하는 것까지 잰다 — §7 · `host/tests/harness.py`
- [D45-8] 재소거의 `chip_pe.md` 증분 행은 섹터 범위=재소거한 섹터, 증분 `±1`, 비고 「reerase · ±1」 — §8 · `host/run/run_wear.py`
- [D45-9] C 엔진의 채점은 호스트 시뮬레이션(fake NOR + 파이프)이 한다. 프로세스 재시작이 보드 리셋이고 칩만 상태 파일로 남는다 — §9 · `ps/sim/` · `host/tests/test_sim.py`
- [D45-10] `git_rev` 는 빌드 스크립트가 생성하는 `wear_build.h` 로 들어간다. `-D` 로 문자열을 넘기지 않는다 — §10 · `ps/scripts/build_flash_wear.py` · `ps/sim/build_sim.sh`
- [D45-11] 실칩 P/E 는 내지 않았다. 인수 시험은 사람이 `run_wear.py accept --i-approve-real-pe` 로 연다. SPI 프리스케일러는 64 그대로다 ([U44-7] 은 열려 있다) — §11

*2026-09-21 후속 — probe 와 tally 소거, 그리고 reproduce 가 wear 를 굽는다 (구 로그 46, 2026-09-23 병합):*

- [D45-12] `reproduce.py` 기본 순서에 `tb`(블랙박스 TB 114) 와 `wear`(flash_wear.elf) 가 들어간다. `wear` 는 로그의
  `git_rev` 가 체크아웃 HEAD 와 같은지를 ⑥ 으로 대조한다 — §12 · `reproduce.py` · `docs/build_reproduction.md` §3.5·§5.3
- [D45-13] `accept` 의 verdict 9번째 줄이 `probe` 다 — 멈춘 직후 `BLANK` 를 불러 `program_fail_bits` 가 전량(229,376)이어야
  PASS. FAIL 이면 B 행의 0 을 읽지 않는다 — §13 · `host/run/run_wear.py` `judge_accept`
- [D45-14] tally 소거는 엔진 명령 `TALLY_ERASE uid=<16hex>`(경계 10) 와 실행기 `run_wear.py tally-erase` 로 한다.
  `flash_prep` 모드가 아니다 (2026-09-21, 한영웅) — §14 · `ps/src/flash_wear.c` · `host/run/run_wear.py`
- [D45-15] 자물쇠 셋 — 엔진은 `idle` 에서 UID 가 소켓의 칩과 같을 때만(`E_UID`, 범위는 상수 512·1,536), 실행기는
  `--i-approve-tally-erase` 에 더해 사람이 그 칩의 UID 를 타이핑해야 하고, 지우기 전 값을 `chip_pe.md` 에 먼저 적은
  뒤에야 명령을 보낸다 — §14 · S-4 §4 `E_UID` · S-1 §8.1
- [D45-16] WSL 의 USB 넘기기(usbipd)는 `reproduce.py` 에 넣지 않는다. `usbipd.exe attach --wsl --auto-attach` 한 줄을
  문서로 둔다 — §15 · `docs/build_reproduction.md` §1
- [D45-18] `plat_now_us` 는 카운터를 초와 나머지로 나눠 µs 로 바꾼다 — `t × 10⁶` 은 부팅 15.37시간에
  64비트를 넘쳐 가짜 `wip_timeout` 을 낸다 (2026-09-24, chip01 파일럿 122,164사이클에서 실제 발생) — §17 ·
  `ps/src/wear_plat_zynq.c`
- [D45-17] `reproduce.py` 는 확인 없이 돌려도 된다 — 덮는 것은 소스에서 다시 만들 수 있는 bit·XSA·ELF 뿐이고 측정
  원본(`build/data`·`logs`·`plots`)은 건드리지 않는다. 측정 직전만 피한다 (2026-09-21, 한영웅) — §16

## 근거

### 1. 응답 체크섬의 시작점 — 동사가 본문이다

S-4 §5.2 는 「접두 다음부터 ` sum=` 앞까지」라 하고 행은 `#WEAR `, 명령은 `WEAR ` 라 적었지만
응답의 접두는 적지 않았다. 후보는 둘 — ⓐ `OK `/`REJECT ` 를 접두로 보고 그 뒤부터, ⓑ 접두가
없으니 첫 글자부터. 행에서 종류 글자(`A`)가, 명령에서 동사(`START`)가 본문에 들어가므로 응답의
`OK` 도 같은 자리다 — ⓑ. 실익도 있다: `OK`↔`REJECT` 가 뒤집혀도 체크섬이 잡는다. 이 결정은
`host_side.py` 한 곳에만 있고 C 엔진은 그 함수가 만든 문자열로 시험된다.

### 2. tally 는 바이트로 싣고 어댑터가 곱한다

경계 5 는 `(count_a, count_b, mismatch)` 라 「count」인데 mock 은 처음부터 사이클(×100)을
돌려줬고 `decide_resume` 의 `|a−b| > 100`·`d` 규칙도 그 단위 위에 있다. S-1 §8.3 은 「tally × 100」
이라 tally 자체는 바이트다. 명령 채널을 S-1 의 단위(바이트)로 두고 어댑터가 ×100 을 하면 mock 과
어댑터의 반환 모양이 같아 같은 채점표가 둘 다 잰다. 엔진 쪽에서 곱하는 안은 `DUMP` 의 바이트와
`TALLY` 의 값이 다른 단위가 돼 탈락.

### 3. 잔류 없는 섹터를 지우는 것은 마모다

`pe_engine.md` §2.1 의 REERASE 조건 「가장 최근 blank_check 에서 그 섹터의 부분 소거 확인 ·
요청 섹터가 검출 주소로 계산한 섹터와 일치」를 엔진이 판정하려면 `recovering` 이 마지막
blank_check 의 범위와 잔류를 들고 있어야 한다. 요청 범위가 다르거나 잔류가 0 이면 지울 이유가
없으므로 `E_STATE`. 범위 7섹터 안에서도 섹터마다 다시 읽어 잔류가 있는 것만 지운다 — 재소거는
카운터에 안 들어가는 ±1 이라(§8.2) 불필요한 섹터까지 지우면 그 불확실을 7배로 늘린다.
사건 행은 섹터마다 1행이다.

### 4. 쓸 수 있는지를 쓰지 않고 본다

`write_ok` 의 「write 시험」을 실제 프로그램으로 하면 그것이 곧 마모이고 어느 주소를 쓸지도
없다. WREN 뒤 상태 레지스터의 WEL 이 서는지는 칩이 쓰기 명령을 받아들이는지를, BP 비트는
블록 보호로 막혀 있지 않은지를 비파괴로 보인다. SPI 무응답이면 WEL 이 안 서서 거짓이 된다 —
S-4 §3.1 「SPI 무응답」이 `write_ok=0` 으로 호스트에 닿는다. 셀이 실제로 프로그램되는지는
못 본다 — 그것은 다음 tally 쓰기가 답한다.

### 5. BLANK 는 읽기다

`check_range` 를 START·REERASE 와 같이 걸면 호스트가 대조군을 blank check 할 수 없다.
읽기는 마모가 아니므로 범위만 본다. `pattern` 은 START 인자라 START 전에는 정의가 없는데
`resume` 절차가 START 전에 `BLANK` 를 부르므로 기본값이 있어야 한다 — 파일럿 고정값 `0x00`
(S-1 §1). 인수 시험의 `probe` 기대값(전량 229,376)이 이 값 위에 선다.

### 6. 정본에 자리가 없는 코드

R 행의 `kind` 집합과 거부 11종은 잠겨 있어 새 이름을 만들 수 없다. `flash_xfer` 3회 실패는
폴링 전송에서 사실상 안 나지만(XSpiPs 가 busy 일 때뿐) 자리를 비워 둘 수 없어 그 op 의
`*_fail` 로 적고 `t_us=0` 으로 가른다. 인자가 빠지거나 숫자가 아닌 것은 「인자 범위」 단계의
실패라 `E_RANGE`. 모르는 동사는 「상태에 맞지 않는 명령」에 가장 가까워 `E_STATE`. 셋 다
호스트가 만드는 정상 명령에서는 나지 않는다.

### 7. 「재소거 후 정상 진행」을 잰다

종전 `check_B` 는 잔류가 0 이 됐는지까지만 봤다. `pe_engine.md` §5 가 B 의 경계를
「3 + 4 + 8 + 1(`cycle=채택값`)」로 적으므로 경계 1 까지 밟아야 B 다. `resume_after` 가 §8.3
1~5 뒤에 6 을 짧게(5사이클) 돌리고 `checkpoint_due` 와 `cycle=채택값+5` 를 확인한다.
Hypothesis 의 임의 시점 200례가 전부 이 길을 지난다 — 차단 시점에 따라 채택값이 tally 앞·뒤
어디에 떨어져도 `E_CYCLE` 에 걸리지 않는 것을 여기서 봤다.

### 8. 재소거 행의 증분 칸

S-1 §9 와 `pe_engine.md` 는 「증분 행을 비고 「reerase · ±1」로」라고만 한다. 증분 칸에 `+1`
을 적으면 카운터에 안 들어가는 것을 들어간 것처럼 읽히고, `+0` 이면 마모가 없었던 것처럼
읽힌다. `±1` 이 S-1 §8.3 의 「복원 불확실성 ±1」 그 자체라 그대로 적는다. 섹터 범위는 지운
섹터 하나다 — 7섹터 전부로 적으면 안 지운 섹터에 불확실이 붙는다.

### 9. 실칩 없이 C 엔진을 같은 TB 로

mock 만 통과하면 「엔진은 이렇게 동작한다」를 증명하지 못한다. 엔진을 `flash_io.h` 와
`wear_plat.h` 만 부르게 갈라, 같은 소스를 fake NOR(8MB 배열 · 06/04/05/20/02/03/9F/4B) 와
stdin/stdout 위에 올리면 어댑터 경유로 mock 과 같은 `check_*` 가 잰다. 리셋은 프로세스 재시작
이고 칩은 `WEAR_FAKE_STATE` 파일로만 남아 무상태가 강제된다. 못 보는 것 — WIP 시간·부분 소거의
물리·UART 의 실제 손실. 보는 것 — 문법·상태기계·tally 슬롯·주소 범위(fake 의 P/E 자취가
`[1000, 1007)` + tally 512·1,536 뿐인 것을 TB 가 확인한다).

### 10. git_rev 는 생성 헤더로

`-DWEAR_GIT_REV="\"abc\""` 는 Vitis → CMake → 셸을 지나며 따옴표가 깎일 수 있다. 빌드
스크립트가 `wear_build.h` 한 줄을 생성해 소스 옆에 두면 두 빌드(Vitis·gcc)가 같은 방식이고
소스에 값이 없다. `test_sim.py` 가 H 행의 `git_rev` 와 빌드 시점 HEAD 를 대조한다.

### 11. 실칩 앞에서 멈춘 자리

프롬프트 §0 대로 실칩 P/E 는 사람 승인 뒤다. 프리스케일러는 64(2.6MHz, JEDEC 검증치)로
빌드했고 16·8 은 `WEAR_SPI_PRESCALE` define 으로만 열어 두었다 — 실측 절차는 인수 100사이클을
64 로 먼저 돌려 A6 분포를 얻은 뒤 16 으로 다시 빌드해 같은 시험을 돌리고 `t_program_us` 는
WIP 만 재므로 값이 같아야 하며 사이클 시간(A 행 `ts` 간격)만 줄어야 한다. 남은 것은 [U44-7]·
[U44-8] 그대로다.

발견한 문서 간 어긋남 둘 — S-1 §6 ④ 는 tally 기록을 「검사 주기 도달 시」 안에 두어 조밀화(10)
가 tally 까지 10 단위로 만들지만 §8.1 은 100 단위다(프롬프트 §3 #8 대로 §8.1 을 따랐다).
S-1 §9 B 행의 `die_temp_c` 와 S-4 §5.2 의 `die_temp_mc` 는 이름이 다르다(S-4 를 따랐다 —
XADC 미구현이라 빈 값이다).

알고 넘긴 것 — PS UART RX FIFO 가 64B 라 `running` 중에는 사이클 경계에서만 비운다. START 행은
약 110B 라 `running` 중에 보내면 넘쳐 `E_SUM` 이거나 유실된다. 설계상 `running` 중에 보낼
것은 `HALT`·`STATUS`(30B 안팎)뿐이라 문제가 되지 않지만, 호스트는 응답 없이 다음 명령을 보내지
않아야 한다(S-4 §5.2). `flash_prep` 의 PRBS 시드 `page & 0x3FFF` 는 페이지 16,384 이상(원격
2,041 = 페이지 32,656~)에서 페이지 272~383 과 겹친다 — prep 의 verify 는 같은 시드로 읽어
통과하지만 스윕 쪽 규약(수정안 #1)이 미정이라 정하지 않았다.

### 후속 (2026-09-21) — 실칩 전 마지막 두 자물쇠 (구 로그 46)

위 §11 에서 멈춘 자리에서 하루 뒤 이어진 작업이다. 보드가 둘이라 WSL 을 쓰는 조원도 자기 PC 에서
같은 계측기를 구워야 했는데 `reproduce.py` 에는 wear 단계가 없었고, 런북 12 가 「실칩 전에 붙이는
것이 맞다」고 적어 둔 probe 와 tally 초기화 수단도 없었다. 답하려는 질문은 둘 — 조원 PC 에서 한 줄로
wear ELF 까지 나오게 하려면 `reproduce.py` 에 무엇이 빠져 있나? B 행의 0 을 믿게 하는 probe 와
`E_DIRTY` 자물쇠의 열쇠(tally 소거)는 어떤 모양이어야 하나?

### 12. `reproduce.py` 는 wear 를 몰랐고, prep 채점 문구도 한 커밋 낡아 있었다

이 PC 에는 g2·wear ELF 가 다 있었지만 wear ELF 안의 `git_rev` 가 한 커밋 전(3a0d88f) 이었다 — 커밋
직전에 구웠기 때문이다. H 행의 `git_rev` 는 시험 기록의 신원이라, 「다시 구웠다」(③ mtime)만으로는
부족하고 「어느 커밋으로 구웠나」가 채점에 있어야 했다. 그래서 `wear` 단계의 ⑥ 은 g3 의 steps 대조와
같은 자리에 `git_rev == HEAD` 를 둔다.

기본 순서 전체를 돌리자 `prep` 이 FAIL 로 떨어졌는데 빌드는 성공이었다. 이 로그 산출물 7 의 체크포인트 모드
커밋(769e80d)이 `build_flash_prep.py` 의 완료 문구를 `== done:` 에서 `== done (default 0~127):` 로
바꿨고 채점 문구는 옛것이었다. 스크립트가 문서를 따른다는 규약(로그 32)대로 문서 §3.3 기대 출력과
스크립트를 함께 고쳤다. 채점 문구를 완화(`== done` 접두만)하는 길은 버렸다 — 기본 0~127 이 아닌
체크포인트 변형이 `vitis_prep/` 자리에 구워지는 것을 ⑥ 이 잡아야 하기 때문이다.

`tb` 는 gcc 를 도구 선검사에 넣는다. gcc 가 없으면 sim 케이스가 skip 되고
`test_gcc_absent_is_reported_not_hidden` 이 FAIL 하도록 이미 짜여 있어(위 §9), 선검사에서 미리 죽는
쪽이 「skip 됐는데 초록」보다 낫다. Windows 네이티브는 `build_sim.sh` 가 bash 이고 `wear_plat_host.c` 가
`poll.h` 라 ② 층이 안 된다 — 이번엔 지원하지 않고 WSL 로 안내한다 ([U45-5]).

### 13. probe — 0 은 「제대로 재고 0」과 「세는 경로가 죽어서 0」이 같아 보인다

신품 100사이클의 B 행 정답은 결함 비트 0 이다. 그런데 `program_fail_bits` 를 늘 0 으로 돌려주는
엔진(mock 의 `program_check_dead`)도 같은 B 행을 낸다. harness 의 `check_probe`([로그 42](42.blackbox_tb_gaps_and_jimin_reply.md) §7 · `[D44-7]`)
가 mock·sim 에서는 이것을 가르고 있었는데 실칩 실행기의 verdict 에만 없었다. 멈춘 시점의 마지막
동작이 소거라 `0xFF` 를 패턴 `0x00` 과 대조하면 전량이 나와야 한다는 성질을 그대로 옮겼다.

`BLANK` 자체가 거부되면 `probe` 는 `None` 으로 FAIL 이다 — 「확인 못 함」을 PASS 로 두면 시험 버튼이
안 눌리는 경보기와 같다. `judge_accept` 의 순수 함수 시험에 `program_check_dead` → `probe` FAIL 과
`None` → FAIL 두 경우를 더했다.

### 14. tally 소거 — 열쇠는 있어야 하고, 무거워야 한다

`E_DIRTY` 는 재개를 신규로 착각해 X 축을 지우는 것을 막는 자물쇠다(`[D44-10]`). 자물쇠만 있고 열쇠가
없어서, 첫 실칩 시험이 지저분하게 끝나면 같은 칩으로 0 부터 다시 할 길이 없었다. S-1 §8.1 은 「실험
시작 시 tally 섹터 2개를 각 1회 소거」라고 했고 S-4 §9 는 「실험 개시 소거가 지운다」고 했지만 그
도구는 없었다.

후보 둘. ⓐ `flash_prep` 에 tally 초기화 모드 — 엔진의 「wear 구간 밖은 지우지 않는다」를 지키고,
열쇠가 물리적으로 무겁다(다른 ELF 를 xsct 로 갈아 끼워야 한다). ⓑ 엔진 명령 — 같은 ELF 안에서 끝나고
호스트 시뮬레이션으로 TB 채점이 된다. 영웅님이 ⓑ 를 골랐다 — ⓐ 는 소거 뒤 wear ELF 를 다시 굽는
비용이 매번 붙는다. 대신 `pe_engine.md` §3 의 「한 번도 지우지 않는다」에 경계 10 예외를 명시했다.

「쉽게는 못 지우되 동의를 받으면 지운다」의 실체를 셋으로 나눴다. 엔진 쪽은 `idle` 에서만, 그리고
`uid` 인자가 부팅 때 읽은 칩 UID 와 같아야 한다 — 호스트가 소켓의 칩을 알아야 지울 수 있다는 뜻이고,
범위는 인자로 못 바꾼다. 실행기 쪽은 `y/n` 을 버리고 **UID 타이핑** 으로 했다 — `y` 는 손이 먼저
간다. 셋째가 요점이다. tally 는 칩이 스스로 기억하는 마모 눈금이니, 지우기 전 값을 `chip_pe.md` 에
512·1,536 `+1` 두 행(비고 「tally erase · 지운 값 a= b=」)으로 먼저 옮기고, 장부 기입이 실패하면
명령을 보내지 않는다. 자동 소거(`accept --cycle 0` 이 `E_DIRTY` 를 받으면 알아서 지우기)는 애초에
후보에서 뺐다 — S-4 §4 가 「자동으로 소거하지 않는 것이 핵심」이라고 못박았다.

작은 함정 하나. 명령 파서가 값을 `int(v, 0)` 으로 먼저 시도하므로 숫자로만 된 UID(`1234…`)가 정수로
새어 문자열 비교가 깨진다. `uid` 키만 문자열로 고정했고 그 케이스를 왕복 시험에 넣었다. 소문자
UID 도 같은 칩으로 받는다(엔진은 대문자로 바꿔 비교).

### 15. usbipd 를 `reproduce.py` 가 대신 쳐 줄 것인가 — 안 한다

조원이 매번 손으로 치던 것이라 넣을까 했지만 둘 다 아니었다. 첫째, `reproduce.py` 는 보드를 만지지
않는다는 범위(로그 32, §4 굽기 제외)와 같은 이유로 USB 도 범위 밖이다. 둘째, BUSID 가 PC 마다 달라
설정 파일이 하나 더 생긴다. 대신 usbipd-win 4 부터는 WSL 안에서 `usbipd.exe attach --wsl --auto-attach`
를 치면 그 터미널이 사는 동안 보드를 뺐다 꽂아도 다시 붙으므로, 세션마다 한 줄이면 된다. 이 절차는
이 PC 에서 검증할 수 없어 문서에 「미검증」으로 표시했다 ([U45-4]).

### 16. 덮어쓰기 걱정 — 되돌릴 수 없는 것만 세면 답이 나온다

전체 실행을 확인 없이 돌렸다가 「이전 build 가 지워지는 것 아니냐」는 지적을 받았다. 실제로 g0·g2·prep
이 제자리에서 덮였고 `_prev` 에 직전 1세대만 남았다. 그러나 `build/` 에서 되돌릴 수 없는 것은
측정 원본(`data`·`logs`·`plots` 의 실측분)이고, 스크립트는 그것을 건드리지 않는다 — selftest 의 합성
CSV·그림 두 장만 매번 새로 쓴다. bit·ELF 는 `rm -rf build` 뒤 다시 만들 수 있어야 재현이라는 문서
§7 의 전제 그대로다. 그래서 [D45-17] 으로 정리했고, 남는 주의는 「측정 직전엔 돌리지 말 것」과 「돌린
뒤 무엇이 덮였는지 한 줄 알릴 것」 둘이다.

### 17. 후속 (2026-09-24) — 타이머 µs 변환이 15.37시간에 넘친다

chip01 파일럿(세션 `1790091548`)이 122,164사이클에서 `wip_timeout` 으로 섰다. 섹터 5 소거가 2초 안에
안 끝났다는 것인데, 같은 사이클의 A 행은 그 소거를 116ms 로 기록했고 직전 30사이클도 115~119ms 였다.
R 행이 답을 들고 있었다 — `t_us=18446744018369433065` = 2⁶⁴ − 55,340,118,551, `ts=43`. 마지막 정상
A 행의 `ts` 는 55,339,381,141µs, 부팅 후 15.37시간이다. `plat_now_us` 가 `t × 1,000,000 / cps` 로
계산하는데 cps 가 333,333,333 이라 t × 10⁶ 이 2⁶⁴ 를 넘는 시각이 정확히 55,340초다. 넘친 순간 시각이
43µs 로 돌아갔고 `wait_wip` 의 「지금 − 시작」 이 거대한 양수가 되어 2초 초과로 판정했다.

왜 이제 났나 — 엔진은 체크포인트마다 다시 프로그래밍돼 시계가 0 부터 가는데, 63,700 이후는 30k 분할
구간 둘을 재프로그래밍 없이 이어 돌아 처음으로 15시간을 넘겼다. 그 전 구간은 전부 그보다 짧았다.
칩은 무관하다 — probe 의 잔류 32,768비트는 엔진이 서면서 못 지운 섹터 6 하나(정확히 한 섹터)이고
B 행 결함 비트는 끝까지 0 이다. 재개는 런북 §5 의 resume(재소거 ±1)이 그대로 맡는다.

후보는 둘이었다. 128비트 곱(`unsigned __int128`)은 컴파일러 의존이고, 초·나머지 분리는 정수 연산
셋으로 끝나며 나머지 < cps 라 곱이 3.3×10¹⁴ 에 그친다. 후자를 택했다. `flash_prep.c` 의 같은 식은
차이(`t1 − t0`)에 쓰여 짧은 구간만 재므로 무관하다. 호스트 시험은 이 파일을 안 타므로 식만 gcc 로
경계값(55,339s · 55,341s)에서 따로 확인했다.

## 산출물

| # | 산출물 | 위치 |
| - | --- | ---- |
| 1 | 마모 엔진 (PS C) | `ps/src/flash_wear.c` · `ps/src/wear_plat.h` · `ps/src/wear_plat_zynq.c` |
| 2 | 호스트 시뮬레이션 (fake NOR · 파이프) | `ps/sim/flash_io_fake.c` · `ps/sim/wear_plat_host.c` · `ps/sim/xil_types.h` · `ps/sim/build_sim.sh` |
| 3 | 엔진 빌드 | `ps/scripts/build_flash_wear.py` |
| 4 | UART 어댑터 (경계 9개) | `host/run/wear_link.py` |
| 5 | 실행기 (accept · status · halt · resume · tally · dump · uid) | `host/run/run_wear.py` |
| 6 | sim 대상 TB · 실행기 TB | `host/tests/test_sim.py` · `host/tests/test_run_wear.py` · `host/tests/conftest.py` |
| 7 | `flash_prep` 체크포인트 모드 (빌드 타임 `PREP_BASE_SECTOR`·`PREP_N_SECTORS`) | `ps/src/flash_prep.c` · `ps/scripts/build_flash_prep.py` |
| 8 | `flash_io` 앱별 프리스케일러 진입점 | `ps/src/flash_io.c` `flash_spi_init_prescale()` |

## 미결

- **[U45-1] 실칩 100사이클 인수 시험** — 사람이 `run_wear.py accept --i-approve-real-pe` 를 친 뒤 A1~A7·C 가 실칩에서 서야 닫힌다. 그 전엔 「완료」가 아니다
- **[U45-2] 전송 실패의 R 행 표기** — [D45-6] 은 정본에 자리가 없어 고른 값이다. 실칩에서 한 번이라도 나면 `kind` 집합을 여는 것이 맞는지 다시 본다
- **[U45-3] `flash_prep` 체크포인트 모드의 실칩 확인** — 네 변형 ELF 는 빌드만 됐다. 보드에 올려 `#PREP RANGE` 와 소거 범위를 확인한 적이 없다
  > **2026-09-23 — 0~6 변형은 닫힘 ([로그 48](48.pilot_wear_handler_and_plan_approval.md) §11).** chip01 체크포인트 100 에서 `#PREP RANGE sectors=0-6` · 7섹터 소거 · 112페이지 검증이 실칩에서 섰다. 나머지 세 변형(근접·원격)은 여전히 미확인
- **[U45-4] WSL 조원 PC 의 usbipd 절차가 실제로 통과하나** — `docs/build_reproduction.md` §1 의 「미검증」 줄.
  `ls /dev/ttyUSB*` 에 둘이 보이고 `run_wear.py uid` 가 등록부와 맞으면 그 줄을 검증 날짜로 바꾼다
- **[U45-5] Windows 네이티브에서 호스트 시뮬레이션(②)을 지원할 것인가** — `build_sim.sh` 를 파이썬으로,
  `wear_plat_host.c` 의 `poll` 을 Windows 분기로 갈라야 한다. 지금은 WSL 로 안내한다. 세은 쪽 수요가 생기면 정한다
- **[U45-6] 경계 10 을 지민이 수용하나** — 엔진은 지민 영역으로 적혀 있다(`pe_engine.md` §4). 명령 하나가
  늘고 「wear 구간 밖은 지우지 않는다」에 예외가 생겼다. 알린 적이 없다
