young-0320/flash-margin-bench/docs/log/young/44.pe_engine_prebuild_review.md

# 44. P/E 엔진 구현 전 검토 — 경계에 「이어 돌릴」 명령이 없다

- **작성일**: 2026-09-20
- **발단**: 박지민의 스펙 검토 회신(2026-09-20)이 도착했다. 뼈대 제안 7·5·9·6·10 을 전부 받고
  층위(PS C + PL 핀 mux)와 명령 채널(UART 텍스트)을 정했으며, 구현 전 확인 4건을 되물었다.
  구현에 들어가기 전에 S-1·S-4·경계 문서·mock TB·PS 코드를 회신과 줄 단위로 대조했다
- **목적**: 이 설계로 파일럿 첫 체크포인트를 넘어 300k 까지 갈 수 있나? 못 가는 자리는
  어디이고, 무엇을 정하면 열리나?
- **관련**: `docs/spec/s1.wear_bench_spec.md` §6·§7·§8.3·§11·§12 · `docs/spec/s4.blackbox_tb.md` §4·§5 ·
  `docs/interface/pe_engine.md` §2 · `docs/interface/contract.md` §3 · `host/tests/` ·
  `ps/src/g0_sweep.c` · `ps/scripts/program_g3.tcl` · `ps/src/flash_io.c` ·
  [로그 29](29.pe_engine_layer_decisions.md) · [로그 41](41.blackbox_tb_and_engine_interface.md) ·
  [로그 42](42.blackbox_tb_gaps_and_jimin_reply.md) · `docs/log/jimin/8.pe_engine_spec_review_notes.md`

## 결정

- [D44-1] START 의 인자 이름을 가른다 — `cycle=` 은 누적 현재값(A 행의 `cycle` 과 같은 뜻),
  `delta=` 는 이번 구간에 추가로 돌릴 횟수. 「`cycles` 는 delta 로 해석한다」는 문장 규약을
  이름 규약으로 바꾼다 (2026-09-20, 한영웅) — §1
- [D44-2] 근접·원격 대조군과 겹치는 구간을 `E_CTRL_OVERLAP` 으로 거부한다. 보호 범위는 엔진 안
  상수표이고 배치가 바뀌면 ELF 를 다시 빌드한다 (2026-09-20, 한영웅) — §4 ·
  `docs/spec/s4.blackbox_tb.md` §4 · `host/tests/mock_engine.py`
- [D44-3] 상태에 `recovering` 을 더한다 — RESUME 뒤, 마지막 blank check 결과를 든 상태.
  REERASE 는 이 상태에서만 받는다 (2026-09-20, 한영웅) — §7 · `docs/interface/pe_engine.md` §2.1
- [D44-4] `WEAR HALT` 를 더한다 — 다음 사이클 경계에서 멈춰 `halted` 로 간다
  (2026-09-20, 한영웅) — §8
- [D44-5] 세션 id 는 호스트가 START 인자로 주고 H 행이 되돌린다. `req` 의 단조 증가는 세션
  안에서만 정의한다 — §9
- [D44-6] 복구 사건(재소거)과 정지 사유(WIP 타임아웃 등)는 A·B 행에 끼우지 않고 별도 행으로
  남긴다. 문법은 [U44-5] (2026-09-20, 한영웅) — §6
- [D44-7] 합 불변식 문장은 지민 §5.1 이 맞다 — 패턴 `0x00` 이고 같은 읽기일 때만 성립하고 B 행에는
  적용되지 않는다. S-1 §7 · `pe_engine.md` §2.1 · harness `probe` 의 기대값을 우리가 고치고
  회신에 인정으로 적는다 — §5
- [D44-8] 층위는 **PS C** 로 확정됐다 (jimin 회신 2026-09-20) — [D29-1] 뒤집음 · [U29-1] 닫음.
  핀 mux 와 단일 비트스트림([U29-2])은 전제가 흔들려 [U44-2] 로 다시 연다 — §2·§3
- [D44-9] mux 레지스터가 그만한 이득이 있으면 계약 §3 변경을 허용한다 (2026-09-20, 한영웅) — §3
- [D44-10] 이어 돌리기는 START 하나로 한다 — `cycle=` 을 받고, `E_DIRTY` 는 「tally 에 마크가 있는데
  `cycle=0`」일 때만, `cycle` 이 tally×100 과 S-1 §8.3 `d` 규칙 밖이면 `E_CYCLE` (2026-09-21, 한영웅)
  — [U44-1] 닫음 · §1 · `docs/interface/pe_engine.md` §2
- [D44-11] 층위는 ⓑ — 리셋을 받아들이고 엔진은 무상태, 파일럿에 mux 를 두지 않는다. ⓐ는 파일럿의
  JTAG 실패율이 나온 뒤 본 실험에서만 다시 본다 (2026-09-21, 한영웅) — [U44-2] 닫음 · [U29-2] 닫음 · §2
- [D44-12] 체크포인트 준비는 `flash_prep` 을 `base`·`n` 으로 파라미터화해 호스트가 영역마다 돌린다.
  엔진에 PREP 을 넣지 않는다 (2026-09-21, 한영웅) — [U44-3] 닫음 · [D29-12] 뒤집음 · §2
- [D44-13] B 행은 phase 별 여덟 필드(`p_`·`e_` × 개수·주소·최악 페이지·비트)로 가른다. 사건 행 `R` 은
  §6 의 안대로 확정한다 (2026-09-21, 한영웅) — [U44-4] 닫음 · [U44-5] 닫음 · `docs/spec/s4.blackbox_tb.md` §5.2
- [D44-14] TB 를 이음매(체크포인트 뒤·복구 뒤 START)·HALT·명령 손상·중복까지 넓힌다. 거부표는
  `E_CTRL_OVERLAP`·`E_SUM`·`E_DUP`·`E_STATE`·`E_CYCLE` 이 는다 (2026-09-21, 한영웅) — [U44-6] 닫음 · §11
- [D44-15] 지민의 회신은 더 없다. 이 로그의 결정으로 경계·S-4·S-1 을 잠그고 구현에 들어간다
  (2026-09-21, 한영웅)

## 근거

### 1. 두 번째 구간을 시작할 수단이 없다 — mock 에서 재현했다

경계는 START(신규) · RESUME(읽기 전용) · REERASE 뿐이다. START 는 tally 에 `0x00` 이 하나라도
있으면 `E_DIRTY` 로 거부한다 — S-4 §4 마지막 줄, 재개를 신규로 착각해 tally 를 지우는 것을 막는
자물쇠다. 그 자물쇠가 정상 진행도 잠근다.

```
wear_start(0,7,0x00,300) → (300, 'checkpoint_due')   tally (300, 300)
wear_start(0,7,0x00,300) → REJECT E_DIRTY
```

지금 harness 는 START 한 번에 100사이클을 돌리고 끝나므로 이 자리를 한 번도 밟지 않았다.
전원 장애 복구도 같다 — RESUME 이 원자료를 주고 호스트가 147 을 채택해도, 그 147 을 엔진에
넘겨 A 행 번호와 tally 눈금(다음 마크는 200)을 잇는 명령이 없다. 지민 회신의 명령표 넷에도 없다.

「N번째 체크포인트까지는 사람이 확인하고 넘어간다」는 옵션(S-1 §11 「자동화 전 수동 판정」)은
**호스트가 사람을 기다리느냐** 의 정책이고 이 문제와 층이 다르다. 사람이 「가라」고 해도 엔진에
그것을 받을 명령이 없다.

후보는 둘이다. ⓐ START 에 `cycle=` 을 더하고 `E_DIRTY` 를 「tally 가 비어 있지 않은데
`cycle=0`」으로 좁힌다. ⓑ `CONTINUE cycle= delta=` 를 신설한다. ⓐ를 권한다 — 명령이 하나이고
범위 검사가 한 곳이며, 받은 `cycle` 과 tally×100 의 관계가 S-1 §8.3 의 `d` 규칙 밖이면
엔진이 거부하는 안전판을 같은 자리에 둘 수 있다. 어느 쪽이든 경계 서명 변경이라 `pe_engine.md`
· S-4 §4 · mock · TB 케이스가 함께 바뀐다 — [U44-1].

### 2. 체크포인트마다 리셋은 어차피 일어난다 — mux 의 전제

지민이 mux 를 고른 이유는 「체크포인트마다 보드 리셋과 재프로그래밍이 개입하지 않게」다.
그런데 스윕은 부팅 1회에 1회다 — `g0_sweep.c:121` 이 그렇게 짜여 있고, `program_g3.tcl` 은
MMCM 위상 잔존(`phase_pos_mismatch`) 때문에 ELF 만 재로드하면 거부되도록 전체 경로
(`rst -system` → 비트스트림 → ELF)를 강제한다. 파일럿 한 점에 스윕이 3회이므로 리셋이 최소
3회다. 무상태 엔진은 어차피 §13 B(전원 차단)가 요구하므로 추가 비용이 아니다.

| | ⓐ 스윕을 부팅 1회 X회로 고치고 mux 로 한 비트스트림 | ⓑ 리셋을 받아들이고 엔진을 무상태로, 파일럿은 mux 없이 |
| - | - | - |
| 새로 만드는 것 | 스윕 앱을 명령 서버로 재작성 · 위상 0 복귀 · 캡처 스크립트 다세션화 · mux RTL · 계약 수정안 · cocotb · 핀 브링업 | flash_prep 파라미터화(B-0) · 호스트가 XSCT 로 ELF 를 갈아 끼우는 절차 |
| 검증된 계측기(스윕)에 손대나 | **댄다** — 게재 곡선과 앵커 기준선의 출처 코드 | 안 댄다 |
| 체크포인트당 JTAG 작업 | 0 | 약 7회 (prep 3 · 스윕 3 · 엔진 1) |
| JTAG 이 실패하면 | — | 엔진은 `checkpoint_due` 에서 멈춰 있어 **마모도 X축 손상도 없다**. 사람이 재시도 |
| 파일럿 전체 절약 시간 | 리셋·로드 약 11점 × 7회 × 10초 ≈ 13분 | — |
| 새 고장 부류 | 두 마스터가 한 버스 — 동시 구동 | 없음 |

파일럿(34~40시간)에서 ⓐ가 되찾는 것은 십수 분이고, 그 값으로 검증된 계측기를 열고 P/E 엔진
일정을 스윕 재작성에 묶는다. **파일럿은 ⓑ** 를 권한다. 본 실험은 점당 스윕이 15회라 JTAG
작업이 점당 20회에 가까워지므로 그때 ⓐ를 다시 본다 — 파일럿에서 JTAG 실패율이 실측되면 그
판단의 분모가 생긴다. 한영웅은 ⓐ 쪽 성향이다 — [U44-2].

### 3. mux 가 살아남으면 계약이 열린다

로그 29 §4 가 PS C 를 고른 근거 하나가 「계약 변경 0」이었는데 mux 는 소유권 선택·readback
레지스터 하나를 요구한다. 계약 §3 에 `0x28` 이 비어 있다. 리셋 시 기본 소유자는 PS 쪽이어야
한다 — 리셋 직후 도는 것이 prep 이나 엔진이기 때문이다. §2 가 ⓑ로 가면 파일럿에는 필요 없다.

### 4. 근접·원격 보호가 거부 코드에 없다

S-4 §4 의 여섯 거부에는 tally 겹침만 있다. `START base=7 n_sectors=7` 은 통과해 근접 대조군을
마모시킨다. `base` 가 인자인 이유(TB 영역 1,000 · 본 실험 그룹)는 타당하므로, 보호 목록을
엔진 상수로 두고 코드 하나를 더한다. 「ELF 재빌드 없이」의 조건은 START 의 네 인자에만 걸린
것이라 배치 상수를 빌드 타임에 두는 것과 어긋나지 않는다. S-4 §4 표와 T3 집행 케이스가 함께 는다.

### 5. 합 불변식은 패턴 `0x00` · 같은 읽기에서만 참이다

S-1 §7 은 「`erase_residual + program_fail = 전량` 이 항상 성립」이라 적었다. 기대 비트가 1인
자리에서는 두 값이 같은 것을 세므로 `0x55` 에서 깨지고, B 행의 두 값은 서로 다른 두 읽기라
B 행에는 애초에 적용되지 않는다 — mock 의 `_emit_b` 도 이미 두 시점 값을 실어 정상 B 행은
0+0 이다. `probe` 의 기대값도 패턴 의존이다 — 소거 직후 `program_fail` 의 정답은 전량이 아니라
`바이트 수 × popcount(~pattern)` 이다.

### 6. 사건 행 하나로 재소거와 정지 사유를 같이 받는다

재소거뿐 아니라 WIP 타임아웃·UID 불일치·프로그램 실패 같은 정지 사유도 S-1 §10 이 「기록」만
요구하고 자리가 없다. 부분 실패의 「어디까지 물리적으로 발행됐나」(지민 프롬프트 §3.3)도 같은
자리다. 종류(`kind=`)로 가르는 한 행이 후보다.

```
#WEAR R kind=reerase sector=3 t_erase_us=51230 ok=1 resid_before=812 resid_after=0 cycle=147 ts=… sum=…
#WEAR R kind=wip_timeout op=erase sector=5 wait_us=2000000 cycle=4211 ts=… sum=…
```

호스트 쪽은 `docs/chip_pe.md` 에 증분 +1 행을 비고 「reerase · ±1」로 남기면 영역별 누적에도
자취가 남는다. B 행의 phase 분리도 같은 성격이다 — 프로그램 실패(전하가 안 들어감)와 소거
잔류(전하가 안 빠짐)는 다른 고장이고 사후 분석의 「재현 횟수」는 phase 별 주소가 있어야 센다.
한 행 안에서 `p_defect_addrs`·`p_worst_page_idx`·`p_worst_page_bits`·`e_…` 여섯 필드로 가르면
A3 「정확히 1행」이 그대로 서고 파서(`key=value`)는 하위 호환이다. 로그 42 §8 이 제안-3 을 다시
열지 않기로 한 것은 우리가 여는 경우였고, 지금은 구현자가 묻는 경우다 — [U44-4]·[U44-5].

### 7. `recovering` 이 없으면 REERASE 의 조건을 엔진이 모른다

지민 §3.3 의 조건 「현재 세션이 전원 장애 복구 상태」·「가장 최근 live blank check 에서 부분
소거 확인」을 엔진이 판정하려면 RESUME 뒤의 상태와 마지막 blank check 결과를 들고 있어야
한다. 다섯 상태(`idle`·`running`·`checkpoint_due`·`halted`·`error`)에는 그 자리가 없다.
전이는 `idle → RESUME → recovering → blank_check → REERASE → blank_check → START(cycle=채택값)`.

### 8. 사람이 멈출 명령이 없다

구간이 ×2.15 로 자라 뒤로 갈수록 십수 시간이다. 중간에 세우려면 전원을 뽑는 수밖에 없고,
그러면 정상 중단이 아니라 복구 경로로 들어가 ±1 불확실을 떠안는다. `halted` 상태는 이미 있다.

### 9. `req` 는 리셋마다 0 으로 돌아간다

§2 대로 체크포인트마다 리셋이면 세션마다 `req` 가 새로 시작한다. 엔진에는 비휘발 카운터가
없으므로 세션 id 는 호스트가 준다. H 행이 그것을 되돌리면 호스트가 여러 세션의 로그를 이을 때
경계가 보인다.

### 10. 시간 예산 — 바닥은 칩이 정하고 SPI 는 웃돈만 깎는다

PS SPI 는 EMIO 경로라 상한이 25 MHz 다 (UG585 §17). 기준 클럭 166.67 MHz 에서 프리스케일러
8 → 20.8 MHz, 16 → 10.4 MHz, 지금은 64 → 2.6 MHz. 페이지 한 장 전송(260 바이트)이 2.6 MHz
에서 0.8 ms 라 tPP 와 같은 크기이고 그것이 112장이다. 추정치이고 실측 대상이다.

| PS SPI | 1사이클 | 300k |
| --- | --- | --- |
| 2.6 MHz (현재) | 약 495 ms | 약 41 h |
| 10.4 MHz | 약 430 ms | 약 36 h |
| 20.8 MHz | 약 415 ms | 약 34.5 h |
| 바닥 (7×tSE + 112×tPP) | 약 360~405 ms | 30~34 h |

다이가 하나라 동작을 겹칠 수 없고, 7섹터는 32KB 블록 소거 경계에 맞지 않아 명령 수도 못 줄인다.
`t_program_us` 는 WIP 지속시간 합이라 측정값은 클럭과 무관하다 — [U44-7].

### 11. TB 가 안 재는 자리

지금 TB 가 증명하는 것은 「START 한 번에 100사이클」이다. 파일럿은 약 11구간이 체크포인트로
이어지고 사이에 복구가 낄 수 있다. 이음매에서만 깨지는 것 — A 행 번호의 연속(300→301),
147 재개 뒤 tally 눈금 정렬, `E_DIRTY` 의 새 뜻, 세션·`req`, HALT 뒤 계속 — 은 지금 케이스에
없다. 명령 채널은 TB 가 짜일 때 없던 표면이다 — 비트 하나 뒤집힌 `delta=300` 이 `delta=900` 으로
들어오면 체크포인트를 600사이클 지나치고, 재전송된 START 가 두 번 실행되면 X축이 그만큼
민다. S-4 §3 의 기준 「채점표를 틀리게 하나 · X축을 비가역으로 틀리게 하나」에 둘 다 든다.
확장은 [D41-24] 대로 한영웅 판단이다 — [U44-6].

## 미결

- **[U44-1] 이어 돌리기 — START 에 `cycle=` 을 더하나, CONTINUE 를 신설하나** — 권고는 START.
  정하면 `pe_engine.md` §2 서명 · S-4 §4 `E_DIRTY` 뜻 · mock · TB 가 함께 바뀐다

  > **2026-09-21 — 닫혔다 (한영웅 · [D44-10]) — START 에 `cycle=`. CONTINUE 는 두지 않는다).**

- **[U44-2] 층위 — ⓐ 스윕 재작성 + mux 단일 비트스트림 / ⓑ 리셋 수용 · 무상태 엔진 · 파일럿은
  mux 없이** — 권고 ⓑ. 한영웅 성향 ⓐ. 파일럿 JTAG 실패율이 본 실험 판단의 분모다

  > **2026-09-21 — 닫혔다 (한영웅 · [D44-11]) — ⓑ. 파일럿에 mux 없음. ⓐ는 본 실험에서 JTAG 실패율을 보고 다시 판단).**

- **[U44-3] 체크포인트 준비(소거+PRBS)를 누가 하나** — [U44-2] 종속. ⓑ면 `flash_prep` 을
  `base`·`n` 으로 파라미터화(로그 29 [D29-12] 가 임계 경로에서 뺀 B-0 의 부활), ⓐ면 엔진의
  `PREP` 명령과 하드 가드를 뚫는 체크포인트 모드. 어느 쪽이든 지금의 0~127 통째 소거로는
  원격(2,041)이 준비되지 않는다

  > **2026-09-21 — 닫혔다 (한영웅 · [D44-12]) — `flash_prep` 파라미터화. B-0 부활).**

- **[U44-4] B 행 phase 분리 문법** — `p_`·`e_` 여섯 필드 한 행. 채택하면 S-4 §5.2 ·
  `host_side.py` · mock 이 바뀌고 지민 질문 2 의 답이 된다

  > **2026-09-21 — 닫혔다 (한영웅 · [D44-13]) — `p_`·`e_` 여덟 필드 한 행).**

- **[U44-5] 사건 행(R) 문법** — 종류 집합과 필드. 지민 질문 3 의 답이 된다. 묶는 방식은 별도 논의

  > **2026-09-21 — 닫혔다 (한영웅 · [D44-13]) — §6 의 안 그대로. 종류 집합은 S-4 §5.2).**

- **[U44-6] TB 확장 범위** — 다구간 · 재개 후 계속 · HALT · 명령 손상 · 중복. 거부표 6 → 8
  (`E_CTRL_OVERLAP`·`E_SUM`·`E_DUP`)

  > **2026-09-21 — 닫혔다 (한영웅 · [D44-14]) — 넓힌다. 거부표 6 → 11).**

- **[U44-7] PS SPI 프리스케일러** — 후보 8(20.8 MHz)·16(10.4 MHz). EMIO·점퍼선 경로라 실측으로
  정한다. flash_io.c 의 값은 JEDEC 검증치라 앱별로 따로 둔다
- **[U44-8] 근접·원격 스윕 불가** — RTL 에 BASE_SECTOR 가 없어(로그 29 F2) 근접 7 도 원격 2,041 도
  못 잰다. S-4 §5.3 은 원격만 적었다. 체크포인트 C 판정의 실칩 절반이 여기 걸린다
  > **2026-09-22 — 열린 채로 순서만 정했다 ([로그 48](48.pilot_wear_handler_and_plan_approval.md) §6).**
  > 계측기 교체는 곡선 안이 아니라 칩 경계에서 한다 — 파일럿은 지금 계측기로 마모군만 재고,
  > `BASE_SECTOR` 는 파일럿이 끝난 뒤에 넣어 종단 3칩부터 대조군을 포함한다. 대가로 파일럿은
  > S-1 §15 ③(인접 간섭)에 답하지 못한다
