young-0320/flash-margin-bench/docs/results/data/temp_chip16_2026-10.md

# temp_chip16_2026-10 — chip16 온도 마모 런의 센서 온도 (전체 · 상태 변화 · 구간별 · 시간별)

> 수치와 표만 둔다. 해석·판정은 [`../wear/wear_temperature_chip16.md`](../wear/wear_temperature_chip16.md). 마모 수치는 [`wear/wear_endurance_chip16_2026-10.md`](wear/wear_endurance_chip16_2026-10.md).

- **무엇**: chip16 설정 65°C 마모 런(2026-10-08 12:58 → 10-09 15:17 KST) 동안 온도 컨트롤러가 1초마다 남긴 센서 온도를, 마모 세션 로그의
  시각(UTC)으로 마모 구간 14개와 체크포인트 측정 26개(prep · 스윕)에 나눠 낸 통계. 표본 95,641 개
- **센서 · 히터**: TMP117 + 필름 히터 + 아두이노 PWM(상한 220/255), chip17 과 같은 구성이라고 보고 적는다 — **센서 · 히터가 chip16 보드 위 어디에
  있었는지는 기록이 없다**(박지민 배치 설명 미수령, 로그 53 [U53-2]). 값은 다이 온도가 아니라 센서 자리 온도다
- **파일**: [`temp_chip16_intervals_2026-10.csv`](temp_chip16_intervals_2026-10.csv) (구간·측정·전체, 한 행 = 시간 창 하나) ·
  [`temp_chip16_hourly_2026-10.csv`](temp_chip16_hourly_2026-10.csv) (KST 시간별). 열은 chip17 표와 같다(`mean_c`·`sd_c`·`min_c`·`p5_c`·`p95_c`·`max_c` ·
  `in_63_67_pct` · `run_pct` · `setpoint_c` · 시간별 `wear_pct`·`measure_pct`)
- **짝 그림**: [`../plots/temp/temp_chip16_timeline_2026-10.png`](../plots/temp/temp_chip16_timeline_2026-10.png) (시계 축) · [`../plots/wear/wear_temp_chip16_2026-10.png`](../plots/wear/wear_temp_chip16_2026-10.png) 윗칸 (사이클 축)
- **원본**: `data/temp_chip16_65C_20261008T033716Z.csv`(7행 · 센서 FAULT 로 끝) · `…034049Z.csv`(PWM 상한 128 · 15분) · `…035828Z.csv`(PWM 상한 220 ·
  10-08 03:58Z → 10-09 06:17Z, 94,719행) + 각 `_events.txt`. 설정은 세 파일 모두 `T65`. 박지민 묶음 「온도제어chip16」(10/9)

## 1. 전체

| 창 | 길이 | 평균 (°C) | sd | 5-95% | 최저 | 최고 | 63-67°C 안 |
|---|---|---|---|---|---|---|---|
| **마모 구간 전체 (시간 가중)** | 22.2 시간 | **63.67** | 1.80 | 61.30 - 67.13 | 59.81 | 67.41 | 49.7% |
| 마모 구간 전체 (사이클 가중) | 100,000 사이클 | 63.9 | — | — | — | — | — |
| 체크포인트 측정 전체 | 1.4 시간 | 63.43 | 1.70 | 60.81 - 66.36 | 59.72 | 67.05 | 62.5% |
| 로그 전체 | 26.6 시간 | 63.49 | 1.99 | 61.06 - 67.09 | 24.56 | 67.41 | 50.8% |

chip17 은 같은 창에서 65.22°C · 97.2% 였다(`temp_chip17_2026-10.md` §1). 로그 전체의 최저 24.56°C 는 로거를 켠 첫 수 초(03:58Z)다.

## 2. 설정 · 상태 · PWM 이 바뀐 자리 (UTC)

`target_c` 는 03:58Z 무장 뒤 끝까지 65 다. 바뀐 것은 상태와 PWM 이다 — RUN 인 채 PWM 0 인 구간은 「설정을 넘어 출력을 끈 상태」 다.

| 시각 (UTC) | 길이 | 상태 · PWM | 평균 (°C) | 최저 - 최고 | 듀티 평균 | 무엇 |
|---|---|---|---|---|---|---|
| 10-08 03:37 - 03:41 | 4분 | 두 번 재시작 | — | — | — | 첫 로거 7행 뒤 센서 FAULT · 둘째는 PWM 상한 128 로 켜 `T65` (평균 56.6 · 듀티 49.5%) |
| 03:58 - 04:52 | 54분 | RUN · 켜짐 | 61.75 | 47.6 - 66.3 | 79.7% | PWM 상한 220 으로 다시 켜 `T65` 무장 · 승온. 마모 START 04:46Z 는 이 안 |
| 04:52 - 04:59 | 7분 | RUN · PWM 0 ↔ 켜짐 | 65.5 - 66.5 | 65.3 - 67.0 | 0 - 2.5% | 설정 도달 뒤 출렁임 |
| 04:59 - 10:39 | 5.7시간 | RUN · 켜짐 | 64.47 | 63.1 - 66.1 | 84.6% | 제어 중 — 1k - 30k 체크포인트 |
| **10:39 - 14:13** | **3.6시간** | **RUN · PWM 0** | **66.6** | **65.5 - 67.4** | **0%** | **히터가 꺼진 채 66 - 67°C 에 머묾** — 40k 체크포인트(12:20Z)가 이 안 |
| 14:13 - 10-09 00:50 | 10.6시간 | RUN · 켜짐 | 62.15 | 59.9 - 65.3 | 86.3% | 듀티 상한에 붙었는데 60 - 63°C — 50k 스윕 - 80k 체크포인트 |
| **10-09 00:50 - 06:17** | **5.5시간** | **FAULT_LATCHED,SENSOR · PWM 0** | **63.47** | **59.7 - 66.2** | **0%** | 센서 FAULT 로 히터 영구 꺼짐. 90k 체크포인트 · 90k → 100k · 100k 체크포인트 · 사다리가 이 안. 값은 올라갔다(01Z 62.4 → 03Z 64.1) |

두 굵은 구간이 열 거동으로 읽히지 않는 자리다 — 히터가 꺼졌는데 식지 않고(chip17 은 55초 꺼지자 44.9°C), 히터가 상한으로 켜졌는데 60°C 대에
머물렀다. 센서가 히터 · 칩과 열적으로 붙어 있지 않았거나(배치), 값이 고정됐거나, 다른 열원이 있다는 뜻이다. 해석은 `../wear/wear_temperature_chip16.md` §1.

## 3. 마모 구간별

| 구간 | 길이 (분) | 평균 (°C) | sd | 5-95% | 최저 | 63-67°C 안 | 히터 |
|---|---|---|---|---|---|---|---|
| 0 → 100 | 0.7 | 66.09 | 0.15 | 65.82 - 66.25 | 65.81 | 100% | RUN |
| 100 → 1,000 | 6.5 | 65.46 | 0.85 | 64.06 - 66.88 | 63.89 | 100% | RUN |
| 1,000 → 3,000 | 15.3 | 65.09 | 0.15 | 64.81 - 65.27 | 64.40 | 100% | RUN |
| 3,000 → 10,000 | 59.9 | 64.76 | 0.15 | 64.57 - 65.00 | 64.06 | 100% | RUN |
| 10,000 → 20,000 | 98.5 | 64.26 | 0.13 | 64.05 - 64.44 | 63.48 | 100% | RUN |
| 20,000 → 30,000 | 110.1 | 64.39 | 0.29 | 63.78 - 64.72 | 63.12 | 100% | RUN |
| 30,000 → 40,000 | 119.6 | 66.59 | 0.60 | 65.29 - 67.19 | 64.38 | 69.2% | RUN → **PWM 0** (10:39Z 부터) |
| 40,000 → 50,000 | 129.3 | 66.16 | 1.58 | 62.31 - 67.31 | 61.01 | 44.0% | PWM 0 → 켜짐 (14:13Z) |
| 50,000 → 60,000 | 140.4 | 62.96 | 0.44 | 62.11 - 63.65 | 61.48 | 49.7% | 켜짐 · 상한 |
| 60,000 → 70,000 | 152.3 | 62.33 | 0.40 | 61.55 - 62.90 | 60.79 | 2.8% | 켜짐 · 상한 |
| 70,000 → 80,000 | 163.2 | 61.86 | 0.38 | 61.12 - 62.38 | 60.28 | 0.0% | 켜짐 · 상한 |
| 80,000 → 90,000 | 166.2 | 61.69 | 0.81 | 60.53 - 63.55 | 59.87 | 11.2% | 켜짐 → **FAULT** (00:50Z, 구간 78.6% 지점) |
| 90,000 → 97,957 | 134.4 | 64.02 | 0.70 | 62.52 - 64.88 | 61.31 | 90.7% | FAULT · 꺼짐 |
| 97,957 → 100,000 | 34.8 | 63.00 | 1.29 | 60.61 - 65.62 | 59.81 | 47.4% | FAULT · 꺼짐 (resume 뒤) |

구간 길이가 0.7 → 166분으로 느는 것은 사이클 단가가 0.40 → 1.02s 로 늘어서다(소거 시간 증가). 체크포인트 26개 창(prep 약 25초 · 스윕 약 6분)의 같은
통계는 CSV 의 `checkpoint_prep`·`checkpoint_sweep` 행이고, 체크포인트별 평균은 [`wear/wear_endurance_chip16_2026-10.md`](wear/wear_endurance_chip16_2026-10.md) §1 의 온도 열에 옮겼다.

## 4. 시간별 (KST)

| 시각 | 평균 (°C) | sd | 최저 | 최고 | 63-67°C 안 | 히터 RUN | 마모 중 | 측정 중 |
|---|---|---|---|---|---|---|---|---|
| 10-08 12시 (12:58-) | 56.32 | 2.76 | 24.56 | 57.59 | 0.0% | 95.5% | 0% | 0% |
| 13시 | 62.37 | 3.42 | 47.61 | 66.97 | 48.2% | 100% | 9.5% | 11.1% |
| 14시 | 64.78 | 0.33 | 63.89 | 65.28 | 100% | 100% | 76.8% | 21.9% |
| 15시 | 64.45 | 0.33 | 63.45 | 64.85 | 100% | 100% | 88.3% | 11.0% |
| 16시 | 64.26 | 0.07 | 64.09 | 64.41 | 100% | 100% | 100% | 0% |
| 17시 | 64.11 | 0.40 | 63.07 | 64.61 | 100% | 100% | 88.4% | 11.0% |
| 18시 | 64.42 | 0.26 | 63.18 | 64.66 | 100% | 100% | 100% | 0% |
| 19시 | 65.42 | 0.80 | 63.74 | 66.62 | 100% | 100% | 88.2% | 11.1% |
| 20시 | 66.87 | 0.20 | 66.34 | 67.22 | 70.2% | 100% (PWM 0) | 100% | 0% |
| 21시 | 67.08 | 0.28 | 66.15 | 67.38 | 17.7% | 100% (PWM 0) | 88.3% | 11.0% |
| 22시 | 66.84 | 0.44 | 65.69 | 67.41 | 45.5% | 100% (PWM 0) | 100% | 0% |
| 23시 | 63.58 | 1.46 | 61.01 | 66.13 | 60.0% | 100% | 88.3% | 11.0% |
| 10-09 00시 | 63.10 | 0.47 | 61.62 | 63.98 | 61.9% | 100% | 100% | 0% |
| 01시 | 62.85 | 0.36 | 61.48 | 63.46 | 39.4% | 100% | 100% | 0% |
| 02시 | 62.44 | 0.46 | 60.69 | 63.34 | 7.9% | 100% | 88.3% | 11.0% |
| 03시 | 62.35 | 0.31 | 61.40 | 63.00 | 0.0% | 100% | 100% | 0% |
| 04시 | 62.03 | 0.43 | 60.79 | 62.81 | 0.0% | 100% | 88.3% | 11.0% |
| 05시 | 62.01 | 0.35 | 60.70 | 62.62 | 0.0% | 100% | 100% | 0% |
| 06시 | 61.78 | 0.34 | 60.28 | 62.46 | 0.0% | 100% | 100% | 0% |
| 07시 | 61.45 | 0.48 | 59.95 | 62.43 | 0.0% | 100% | 88.3% | 11.0% |
| 08시 | 61.41 | 0.43 | 60.02 | 62.23 | 0.0% | 100% | 100% | 0% |
| 09시 | 61.49 | 0.62 | 59.87 | 65.96 | 4.0% | 84.3% → FAULT | 100% | 0% |
| 10시 | 63.34 | 0.69 | 61.15 | 64.49 | 73.3% | 0% | 88.3% | 11.0% |
| 11시 | 63.90 | 0.72 | 61.31 | 64.85 | 87.5% | 0% | 100% | 0% |
| 12시 | 64.13 | 0.76 | 61.32 | 65.34 | 88.6% | 0% | 79.1% | 0% |
| 13시 | 63.27 | 0.47 | 61.95 | 64.11 | 75.1% | 0% | 0% | 0% |
| 14시 | 63.09 | 1.14 | 59.72 | 66.18 | 58.5% | 0% | 58.0% | 9.2% |
| 15시 (-15:17) | 62.83 | 0.74 | 60.93 | 64.24 | 39.8% | 0% | 0% | 6.2% |

13시(12:47 - 14:19 KST)는 `wip_timeout` 뒤 resume 판정까지 마모가 멈춘 시간이다.

## 재현

```bash
uv run python host/analysis/pe_end.py --chip chip16 --temp     # 1단계가 temp_wear_summary.py 를 불러 build/pe_end/chip16/temp_chip16_{intervals,hourly}_2026-10.csv · 그림 2 를 낸다
# §2 의 상태 · PWM 구간은 data/temp_chip16_65C_*.csv 를 (파일 · target_c · state · fault · pwm==0) 로 잘라 60초 이상인 것만 적었다
```
