young-0320/flash-margin-bench/host/tests/README.md

# host/tests — 블랙박스 TB

`docs/spec/s4.blackbox_tb.md` 의 채점표를 실행한다. 판정 대상은 S-1 §13 A·B·C 이고,
**박지민의 P/E 엔진 스펙을 보지 않은 채** 짜였다 (로그 41 `[D41-1]`·`[D41-10]`).

```bash
uv run pytest host/tests/ -q
```

| 파일 | 무엇 |
| ---- | ---- |
| `host_side.py` | **호스트 쪽 문자열의 정본** — 명령·응답·행 문법(S-4 §5.2)·파서·재개 절차. mock 과 UART 어댑터가 같이 쓴다 |
| `mock_engine.py` | 가짜 엔진 — `pe_engine.md` §2 경계 10개 + 명령 입구 `command(line)` + 고장 주입 + **버그 주입** |
| `harness.py` | 채점표 본체. 검사를 테스트가 아닌 함수로 둔 이유는 아래 |
| `test_acceptance.py` | §13 A·B·C · S-4 §2 J · S-4 §4 거부 12종 · HALT · R 행 · **T1·T3 집행** |
| `test_faults.py` | S-4 §3 주입 고장 (명령 손상·중복 포함) · §13 B (Hypothesis 임의 시점 차단) · **T2 집행** |
| `test_tb_catches_bugs.py` | **채점표가 실패하는지 확인한다** — S-4 §7 T6 (양방향) |
| `test_sim.py` | **C 엔진**(`ps/src/flash_wear.c`)을 호스트 시뮬레이션(`ps/sim/`)으로 띄워 같은 채점표로 잰다. gcc 가 없으면 skip |
| `test_run_wear.py` | 실행기 `host/run/run_wear.py` — 판정·로그 분리는 순수 함수로, accept·resume 은 sim 파이프로 끝까지 |
| `test_pe_end.py` · `test_wear_checkpoint_csv.py` · `test_wear_curves.py` · `test_wear_inverse.py` | 분석 스크립트 시험 — `pe_end.py` · `wear_checkpoint_csv.py` · `wear_curves.py` · `wear_inverse.py` |
| `test_bathtub2.py` | 욕조 v2 — 펌웨어(`ps/src/bathtub_v2.c`)를 호스트 시뮬레이션(`ps/sim/build_bt2_sim.sh`)으로 S-6 §6 시험 2 의 경우마다 돌리고, 그 출력을 캡처(`bathtub2_capture.py`) · 분석기(`bathtub2_analysis.py`)에 흘린다. gcc 가 없으면 skip |
| `conftest.py` | `sim_bin` fixture — `ps/sim/build_sim.sh` |

## 왜 버그를 심나

가짜 엔진과 채점표를 같은 손이 짰다. 그러면 가짜 엔진이 채점표가 기대하는 대로 동작해
**언제나 통과하는 채점표**가 될 수 있다. 그래서 엔진에 버그를 하나씩 심고 지정한 항목이
반드시 깨지는지 본다 — 안 깨지면 그 항목은 아무것도 재고 있지 않다.

이 장치가 실제로 일한 적이 있다. `undercount` 를 처음에 "한 사이클 건너뛰기"로 짰더니
다음 사이클에 스스로 회복해 **버그가 아니었고**, `test_tb_catches_bugs.py` 가 그것을 잡았다.

**역방향도 집행한다** — 버그 하나로도 안 깨지는 채점 항목이 있으면 그 항목이 비어 있는
것이다. `test_every_score_item_has_a_bug` 가 `SCORE` 와 버그 케이스를 1:1 로 묶는다.

## 채점 항목 하나에 실행 모양 하나

`score(item)` 이 실행과 채점을 같이 든다. B(전원 장애 복구)만 모양이 다르기 때문이다 —
끊고, 전원을 다시 넣고(`resume_after`), §8.3 을 밟아야 잴 것이 생긴다. T6 가 같은 항목을
정상 엔진과 버그 엔진에 **두 번** 부르므로 그 모양이 한 자리에 있어야 한다.

## 경계는 Python 함수이고, 그 위에 문자열이 있다

제안-1(호출면 문법)이 닫히기 전에 UART 문자열을 고르면 그것은 발명이라 mock 은 함수로 두었다.
제안-1 이 닫힌 뒤(S-4 §5.2, 2026-09-21) **UART 어댑터**(`host/run/wear_link.py`)가 같은 메서드
이름으로 실엔진의 명령 문자열을 만든다 — 채점표는 그대로이고 뒤에 붙는 것만 바뀐다. mock 의
`command(line)` 은 같은 문자열을 받아 체크섬·`req` 를 두드리는 입구다. `reerase()` 는 경계 8 이다.

같은 `check_*` 가 mock 과 C 엔진(sim) 을 잰다. `test_sim.py` 에서 프로세스를 다시 띄우는 것이
보드 리셋이고(fake NOR 의 상태 파일만 남는다), 엔진이 무상태인지를 J 와 복구 경로가 그것으로 본다.

## 실칩에서 못 보는 것 / 실칩에서만 보는 것

A6(소거 시간)·A7 의 실제 UID·B 의 부분 소거 **물리** 는 실칩 전용이다. 가짜 엔진의 시계는
상수라 `t_erase_us` 가 가짜이고, S-4 §2 표가 A6 를 mock 에서 `X` 로 둔 것이 그 뜻이다.
부분 소거는 **「잔류가 있다/없다」까지만** mock 이 들고, 잔류량과 진행은 실칩이 답한다.
