young-0320/flash-margin-bench/docs/results/plots/bathtub/README.md

# bathtub — 욕조 곡선 그림

버전은 **측정 방식**(펌웨어가 위상 스텝마다 읽기를 어떻게 배치하나)으로 나눈다. 같은 데이터를 축만 바꿔 다시 그린 그림은 그 데이터의 버전에 둔다.

| 버전 | 측정 방식 | 기간 |
|---|---|---|
| `v1/` | 위상 전 구간을 같은 간격 · 같은 읽기 수로 스윕 (`bathtub_analysis.py` 산출, 계약 v1 CSV) | 2026-07 - 2026-11 |
| `v2/` | 벽 집중 측정 — 가운데를 건너뛰고 양쪽 벽에 읽기를 몰아 깊은 BER 까지 본다. 11/2 교수님 피드백 ([로그 55](../../../log/young/55.professor_feedback_bathtub_2026-11-02.md)) | 미착수 — 첫 그림이 나올 때 폴더를 만든다 |
