young-0320/flash-margin-bench/docs/results/blind_chip08.md

# 블라인드 결과 해석 — chip08 (상온 마모, 정답 30,000) · 모델 고정 판정 — 정답 봉인 없음

- **작성일**: 2026-11-11 (개봉 prep 2026-11-05) · **수치**: [`data/blind_chip08_2026-11.md`](data/blind_chip08_2026-11.md) — 표를 다시 싣지 않고 거기를 인용한다
- **모델**: S-5 v4.3 7장 판 (2026-10-23 등록, 로그 52 [D52-16] · §17) · **경위**: 로그 52 §19 [D52-18]
- **판정 방식**: 「모델 고정 판정 — 정답 봉인 없음」. chip08 은 등록 판정 칩이었으나 정답이 판정 전에 드러나 chip23 · chip26([D52-17])과 같은 방식으로 판정했다. 봉인 판정은 chip06 하나다
- **선례**: [`blind_temp_chip23_chip26.md`](blind_temp_chip23_chip26.md) (85°C 온도 칩 둘)

## 결론

**chip08 은 불합격이다.** 정답 30,000 을 95% 구간(43,001-100,000) 밖에 두고 대표값 71,500 으로 **2.38배 과대**하게 읽었다(기준 ① 불통과 · ② ③ 통과).
정답은 사후분포의 맨 아래 0.02% 자리다. 실패의 원인은 이번에도 칩 종류다 — chip08 은 같은 사이클에서 느린 교정 칩 셋보다 1.5-2.3배(가운데 chip03 대비 약 1.8배) 빨리 늙었고,
그 속도는 교정 셋이 잰 속도 범위(R 1.59) 너머다. 다만 chip23 처럼 「느린 신품 · 빠른 노화」 형(chip12 · 21)과 같은 자리는 아니고, **교정 셋과 그 형 사이**에 있다.

| | chip08 (느린 · 상온) |
|---|---|
| 정답의 자리 | 사후분포 맨 아래 밖(0.02%) · 95% 밖 |
| 성공 기준 ①②③ | **불통과** · 통과 · 통과 |
| 대표값 ÷ 정답 | 2.38 |

정답을 봉인하지 않았다 — 11/5 마모 기록이 대장 커밋과 대화로 판정자에게 드러났다. 모델 · 교정 표 · 코드는 10/23 등록 뒤 수치가 바뀌지 않았고 chip08 의 마모(11/5)는 그 뒤라,
추정값이 정답에 끌릴 길은 모델 쪽에 없다. 개봉 prep 3분 뒤에 같은 입력으로 돌린 기록(git_rev `452386e`)도 답 줄이 같다(수치 문서 머리말).

v4.3 으로 판정한 블라인드는 이로써 셋이다 — 빠른 무리 chip26 합격, 느린 무리 chip23(85°C) · chip08(상온) 불합격.

## 1. 모델이 읽은 것

개봉 관측 1.60배는 느린 교정 칩 셋이 100k 근처에서 지나는 자리다(수치 문서 §6 — 100k 1.59-1.75). 모델은 속도 배율 r 을 [1/1.59, 1.59] 안에서 적분하므로,
x = 30k 에서는 곡선 지점 M = x·r 이 약 48k 까지만 가고, 그 자리의 교정 배율(마모 중 곡선 48k 1.40-1.48)은 chip08 의 30k 값(마모 중 1.51 · 개봉 1.60)에 못 미친다. 그래서 사후는 r 이 큰 쪽과 x 가 큰 쪽이 함께 맞는
58-96k 에 몰렸다. 68% 폭 38,000 은 chip23(9,000)처럼 답 범위의 벽에 눌린 폭이 아니고, 95% 상한만 100k 에 닿는다. 「밴드 밖」 경고는 나오지 않았다 — chip23 과 같이
r 이 범위 안에서 관측을 흡수했다.

2.38배는 v4.3 을 만들며 잰 구간별 치우침(5장 판 LOCO 의 20-50k 추정/정답 1.21, 로그 52 [U52-8] 추기)을 훨씬 넘는다. 모델 전체의 치우침이 아니라 이 칩의 속도에서 온 오차다.

## 2. chip08 은 두 형 사이에 있다

같은 30k 에서 견주면(수치 문서 §6):

- chip08 의 마모 중 배율 1.51 은 느린 교정 칩 셋(1.32-1.36)보다 높다. 교정 칩이 1.51 에 처음 닿는 것은 chip15 45k · chip03 54k · chip07 68k — chip08 은 30k 에 닿았다
- 「느린 신품 · 빠른 노화」 형 chip12(1.79) · chip21(1.90)보다는 낮고, 85°C 의 같은 형 chip23(26k 1.77)과도 떨어져 있다
- 85°C 의 느린 · 느린 노화 형 chip22(1.42)보다도 조금 높다
- 프로그램 시간은 30k 에 1.01 로 평평하다. chip12 · 21 형의 표지(프로그램 불변)와 같은 모양이지만, 30k 에서는 교정 칩 chip03 · 15 도 1.02-1.03 이라 이것으로는 가를 수 없다

마모한 느린 신품은 이제 여덟이다(chip03 · 07 · 08 · 12 · 15 · 21 · 22 · 23). 30k 근처 배율로 늘어놓으면 1.32-1.36(교정 셋) · 1.42(chip22) · 1.51(chip08) · 1.77-1.90(chip12 · 21 · 23)으로,
chip08 이 두 형 사이의 빈자리에 들어왔다. 10/19 에 「느린 신품은 두 종류」 로 적은 것([U52-7])은 그때 본 다섯 칩의 모양이었고, chip08 은 그 둘 중 어느 쪽에도 들지 않는다.
느린 무리 R 은 교정 3칩의 속도 산포(σ_r 0.204)에서 유도한 값이라, 느린 신품 전체의 산포를 덮지 못한다는 것이 이번에는 상온 칩에서 드러났다.
느린 무리 학습 곡선이 교정 3칩에서 아직 오르는 중이라는 로그 52 §16 의 판단과도 맞는다.

## 3. 무엇이 바뀌나

- **[U52-7] (v4.4)**: 결정 재료가 하나 더 생겼다. 선택지 (가) 「두 형에 사전 확률을 나눔」 은 형이 둘이라는 전제를 두는데, chip08 은 그 전제 밖의 중간 속도다.
  (나) 개봉 때 짧은 추가 마모 Δx 로 기울기를 재는 안은 속도를 직접 재므로 형의 수와 무관하다. (다) 느린 신품은 범위로만 답하는 안도 같다. 어느 쪽이든 chip08 은 chip23 과 함께
  v4.4 의 채점 칩이 된다(v4.3 판정은 이 문서 그대로 둔다)
- **보고 범위**: v4.3 의 느린 무리 단일 답은 블라인드 둘(chip23 · chip08)에서 모두 95% 밖이었다 — 고온 이력이 없는 상온 칩도 예외가 아니다. 빠른 무리(v4.3 chip26 합격 · v2 판정 chip06 은 정답을 68% 안에 품음)와
  느린 무리를 보고서에서 나눠 적는다. 느린 신품에 대한 답을 어디까지 줄일지는 [U52-7] 에서 정한다

## 4. 한계

- 정답 봉인이 없다(위). 정답은 세션 A5 · 마지막 A 행 · 장부 증분 합이 모두 30,000 이라 정답 쪽 불확실성은 없다
- 개봉 prep 은 1회다. S-1 §15 10/01 추기의 「개봉 prep 5회」 와 다르고 선례(chip23 · 26)와 같다. ρ_p 0.78 이라 5회로 늘려도 유효 관측 수는 거의 늘지 않는다
  (S-5 §2 v4 열: 1회 2.55 · 5회 2.68) — 2.38배의 오차를 설명하는 크기가 아니다
- 개봉 prep 이 마모 끝 약 2.7시간 뒤라 선례(chip23 14일 · chip26 6일)보다 휴지가 짧다. 휴지 동안의 회복은 소거 시간을 내리는 쪽이라 오래 쉬었다면 관측 배율이 조금
  낮았을 수 있다. 그러나 휴지가 없는 마모 중 곡선이 이미 30k 에 1.51(교정 칩의 45-68k 자리)이라 판정은 바뀌지 않는다고 본다
- 칩 온도를 기록하지 않았다(히터 없음). 기준 섹터 32-127 이 신품의 0.98 이라 측정 온도 차이는 배율 눈금에서 상쇄됐다고 본다
- chip08 의 마모 곡선은 아직 승격하지 않았다 — §2 의 비교는 A 행에서 `build/` 로만 만든 곡선이다(재현 명령은 수치 문서 §6)
- 상온 블라인드 한 칩, 30k 한 점이다. 그림은 만들지 않았다

## 보고서 문장 (제안)

- 「상온에서 30,000회 마모한 느린 무리 칩을 등록된 모델(v4.3, 2026-10-23 등록 · 고정, 이후 바뀌지 않음)로 판정했다. 추정은 71,500회로 정답의 2.38배였고 정답은 95% 구간
  43,001-100,000 밖이었다. 이 칩은 같은 사이클에서 교정에 쓴 느린 칩 셋보다 1.5-2.3배 빨리 늙었다 — 느린 신품의 노화 속도가 교정 3칩이 잰 범위보다 넓다는 것을, 고온 칩(chip23)에 이어
  상온 칩이 보였다. 정답은 봉인하지 않았으나 모델은 판정 전에 고정돼 있었다」
