young-0320/flash-margin-bench/docs/results/blind_temp_chip23_chip26.md

# 블라인드 결과 해석 — chip23 · chip26 (85°C 마모 이력, 정답 26,528 · 70,000)

- **작성일**: 2026-11-01 (개봉 prep · 추정 당일) · **수치**: [`data/blind_temp_chip23_chip26_2026-11.md`](data/blind_temp_chip23_chip26_2026-11.md) — 표를 다시 싣지 않고 거기를 인용한다
- **모델**: S-5 v4.3 7장 판 (2026-10-23 등록, 로그 52 [D52-16] · §17) · **경위**: 로그 52 §18
- **그림**: [`plots/blind_temp_chip23_chip26_2026-11.png`](plots/blind_temp_chip23_chip26_2026-11.png) — 무리별 상온 교정 곡선 위에 마모 중 곡선 · 개봉 관측 배율 · 추정 구간 · 정답
- **온도 런 해석**: [`wear/wear_temperature_85C.md`](wear/wear_temperature_85C.md) (85°C 칩 넷)

## 결론

**빠른 무리 chip26 은 합격, 느린 무리 chip23 은 불합격이다.** chip26 은 정답 70,000 을 68% 구간(31,001-85,000) 안에 품었고 대표값 60,500 은 정답의 0.86배다.
chip23 은 정답 26,528 을 95% 구간(78,001-100,000) 밖에 두고 92,500 으로 **3.5배 과대**하게 읽었다. 실패의 원인은 85°C 이력이 아니라 **칩 종류**다 — chip23 은
「느린 신품 · 빠른 노화」 형(chip12 · 21)이고, v4.3 은 이 형을 교정에 넣지 않은 채 「chip21 형이면 전부 틀린다」 를 한계로 미리 적어 두었다(로그 52 [D52-12], 10/19).

| | chip26 (빠른 · 84°C) | chip23 (느린 · 85°C) |
|---|---|---|
| 정답의 자리 | 61번째 백분위 · 68% 안 | 사후분포 맨 아래 밖(0%) · 95% 밖 |
| 성공 기준 ①②③ | 통과 · 통과 · 통과 | **불통과** · 통과 · 통과 |
| 대표값 ÷ 정답 | 0.86 | 3.49 |

정답을 봉인하지 않았다 — 추정 전에 사이클 수를 알았다. 모델 · 교정 표 · 코드가 10/23 등록 그대로라(추정 파일 git_rev `18e06ad`) 추정값이 정답에 끌릴 길은 없고,
빠진 것은 「봉인」 이라는 절차뿐이다(영웅님 결정, 11/1). 보고서에는 chip06 과 구분해 「모델 고정 판정」 으로 적는다.

## 1. chip26 — 85°C 이력도 상온 빠른 무리 안이다

개봉 관측 2.66배는 상온 빠른 교정 칩들이 50-80k 에서 지나는 자리다(그림 왼쪽). 마모 중 곡선도 70k 에서 2.47 로 chip09(가장 느린 빠른 칩, 70k 2.66) 바로 아래를 따라 왔다.
같은 85°C 의 chip24(70k 2.96)가 상온 한가운데였던 것([`wear_temperature_85C.md`](wear/wear_temperature_85C.md) §1)과 합치면, 빠른 무리에서 85°C 이력은 상온 개체 산포 밖으로
나가지 않는다. 대표값이 정답보다 낮은 것(0.86)은 등록 때 이미 잰 고마모 구간의 치우침(50-100k 추정/정답 0.84, S-5 §9 9번)과 같은 크기라 온도와 무관하다.
68% 구간이 54,000 으로 넓은 것은 빠른 무리의 칩 간 속도 산포(R 2.80) 그대로다.

## 2. chip23 — 실패는 칩 종류에서 왔다

느린 무리 교정 칩 셋(chip03 · 07 · 15)은 100k 에서도 1.59-1.75배다. chip23 의 관측 1.83배는 그 셋이 100k 안에서 한 번도 닿지 않는 값이라, 모델은 속도 배율 r 을 끝까지 당겨
100k 근처로 읽었다. 68% 구간이 9,000 으로 좁은 것은 확신이 아니라 **답 범위(100k)의 벽에 눌린 것**이다 — 모델은 「밴드 밖」 경고도 내지 않았다(r 이 범위 안에서 관측을 흡수).

같은 사이클에서 견주면 원인이 갈린다(수치 문서 §6):

- chip23 의 26k 배율 1.77 은 **상온** chip21(1.79) · chip12(1.69)와 같은 자리다 — 온도 없이도 이 형은 이만큼 늙는다
- 같은 85°C · 같은 배치의 chip22 는 26k 1.40 으로 상온 느린 교정 칩(1.28-1.33) 근처다 — 85°C 가 느린 칩을 일반적으로 빨리 늙게 한다면 chip22 도 이 자리에 있어야 한다
- 첫 1k 의 기울기(1.15)와 프로그램 시간이 평평한 것도 chip12 · 21 형의 모양이다(10/23 에 20k 까지 보고 적은 판단과 같다)

마모한 느린 신품 일곱(chip03 · 07 · 12 · 15 · 21 · 22 · 23) 중 셋(chip12 · 21 · 23)이 이 형이다. 개봉 prep 한 번(신품 소거 · 폭 · 프로그램 · 섹터 산포)으로는 두 형이 갈리지 않는다는 것이 10/19 의 결론이었고
(로그 52 §13), 이번 블라인드는 그 한계가 실제 판정에서 그대로 터진다는 것을 보였다.

## 3. 무엇이 바뀌나

- **온도 축**: 85°C 칩 넷(chip22 · 23 · 24 · 26)을 합쳐도 온도의 일관된 방향은 없다 — 빠른 무리 둘은 상온 한가운데, 느린 무리 둘은 한 칩은 상온 근처(chip22) · 한 칩은 상온의
  다른 형과 같은 자리(chip23). 「고온 이력 칩에는 범위로 답한다」([D53-6]) 는 빠른 무리에서 블라인드로도 섰다
- **[U52-7] (v4.4)**: 결정 재료가 생겼다 — chip23 은 chip12 · 21 형이다. 선택지 (가) 두 형에 사전 확률을 나눔 · (나) 개봉 때 짧은 추가 마모 Δx 로 기울기를 잼 · (다) 느린 신품은
  「두 종류 중 하나」 로만 답함 중 어느 쪽이든, chip23 은 v4.4 의 채점 칩이 된다(v4.3 판정은 이 문서 그대로 둔다)
- **보고 범위**: v4.3 의 단일 답은 빠른 무리 칩과 「느린 · 느린 노화」 형에만 쓴다. 느린 신품은 지금 모델로 「두 형 중 하나」 를 먼저 말해야 한다

## 4. 한계

- 정답 봉인이 없다(위). chip23 의 정답은 마지막 A 행이고 tally 는 읽지 않았다 — 오차가 3.5배라 판정에는 영향이 없다
- 개봉 prep 의 칩 온도를 기록하지 않았다(히터 없이 상온). 기준 섹터 32-127 이 신품의 0.98-0.99 라 측정 온도 차이는 배율 눈금에서 상쇄됐다고 본다
- 온도 칩 블라인드 둘, 무리마다 하나다. chip26 은 100k 를 다 가지 않았다(70k, 이을지는 미정)
- chip08(옛 로트 · 느린 · 상온) 블라인드는 아직이다 — 등록 판정 칩은 그대로 chip08 이다

## 보고서 문장 (제안)

- 「85°C 에서 마모한 두 칩을 등록된 모델(v4.3, 2026-10-23 등록 · 고정, 이후 바뀌지 않음)로 판정했다. 빠른 무리 칩(정답 70,000회)은 68% 구간 31,001-85,000 안에 들었고 추정은 정답의
  0.86배였다. 느린 무리 칩(정답 26,528회)은 3.5배 과대로 읽혔는데, 같은 사이클의 노화 배율이 상온의 '느린 신품 · 빠른 노화' 칩들과 같았다 — 실패는 고온이 아니라 모델 등록 때
  한계로 적어 둔 칩 종류에서 왔다. 정답은 봉인하지 않았으나 모델은 판정 전에 고정돼 있었다」

> **2026-11-11 — 정정.** chip23 은 등록(10/23) 전인 10/18 에 마모가 끝났다 — 등록 뒤 마모를 시작한 것은 chip26 뿐이다. 「등록 뒤 바뀌지 않았다」 는 모델 · 교정 표 · 코드에 대한 말이다 ([D52-17]).
