young-0320/flash-margin-bench/docs/results/blind_chip06.md

# 블라인드 결과 해석 — chip06 (정답 12,000 사이클)

- **작성일**: 2026-10-01 (개봉 당일) · **수치**: [`data/blind_chip06_2026-10.md`](data/blind_chip06_2026-10.md) — 표를 다시 싣지 않고 거기를 인용한다
- **사전 등록**: `docs/spec/s1.wear_bench_spec.md` §15 (2026-09-30 · 10-01 추기) · 로그 48 [D48-47]-[D48-61]
- **그림**: [`plots/wear/wear_ratio_curves_2026-10-04.png`](plots/wear/wear_ratio_curves_2026-10-04.png) — chip06 관측선(1.63배)이 교정 곡선과 만나는 자리. 판정 때의 교정 5칩판(10/2)은
  지웠고, 이 그림은 판정 뒤 교정에 든 chip18 까지 그린 6칩판이다

## 결론

**판정용 v2 는 정답 12,000 을 95% 구간은 물론 68% 구간 안에 품었고, 정답은 v2 사후분포의 거의 한가운데(아래 확률 49%)에 있었다.**
성공 기준은 ① 통과 · ② 통과 · ③ 불통과(68% 폭 16,000 > 10,000)다. 같은 입력을 교정 4칩으로 본 v1 은 세 기준을 다 통과했지만
정답을 68% 구간 밖(79번째 백분위)에 두었다 — 좁은 구간은 운이 따른 것이고, chip09 를 넣어 넓어진 v2 의 구간이 정직했다.

| | v1 (교정 4칩) | v2 (교정 5칩, 판정용) |
|---|---|---|
| 정답의 자리 | 79번째 백분위 · 68% 밖 | **49번째 백분위 · 68% 안** |
| 성공 기준 ①②③ | 통과 · 통과 · 통과 | **통과 · 통과 · 불통과** |

## 1. 왜 v2 가 맞았나 — chip06 은 중간 속도로 늙은 칩이었다

관측 배율 1.63 이 교정 곡선과 만나는 자리는 chip04 약 4천 · chip01 약 8천 · chip09 약 1.6만 회다(그림). 정답 12,000 은 chip01 과
chip09 사이다 — chip06 은 chip01 보다 느리고 chip09 보다 빠르게 늙었다. 교정이 chip01·04 뿐이던 v1 은 "빨리 늙는 칩" 만 알아
구간을 1.1만에서 닫았다. chip09 가 "천천히 늙는 빠른 칩" 을 보여 주자 구간이 1.9만까지 열렸고 정답이 그 안에 들었다. 교정 칩
하나가 블라인드 칩 하나의 판정을 바꾼 것이다 — 칩 둘로는 무리 안 속도 산포를 과소평가한다는 오늘의 결론([D48-60])을 블라인드가
확인했다.

## 2. MAP 은 낮게 치우쳤다

v2 의 MAP 은 7,001-8,000 으로 정답의 약 0.6배다. 사후분포가 오른쪽으로 꼬리가 길어(느리게 늙는 가능성) 최빈값이 중앙값보다
앞에 선다. 점 추정을 하나 낸다면 MAP 보다 **사후 중앙값**이 이 칩에서는 정답에 가까웠다(중앙값 약 1.2만). 블라인드 하나로 정할
일은 아니므로 보고서에는 둘을 나란히 적고, 점 추정 방식은 발표 전 LOCO 로 비교한다.

## 3. ③ 불통과를 어떻게 읽나

③ 의 "MAP 1만 미만이면 68% 폭 ≤ 1만" 은 교정 칩이 무리당 둘이던 9/30 의 모의 블라인드로 정한 값이다. 무리 안 속도 산포가
드러난 뒤의 모델로는 계단 이전 구간에서도 68% 폭이 1-2만이다(5칩 LOCO, x 3-20k 중앙값 23,500). 기준을 바꾸지 않고 불통과로
보고한다 — 사전 등록한 기준에 떨어진 것을 그대로 적는 것이 이 절차의 목적이다. 폭을 정직하게 줄이는 길은 칩별 속도를 직접 재는
Δx(5천 회에 약 45%↓) 와 교정 칩 추가다. (2026-10-05 — Δx 는 교정 7칩에서 x 20k 이하만 좋아지고 후반 · 계단 칩에서 틀린 쪽으로 좁혀 뺐다, 로그 48 [D48-93])

## 4. 한계

- 블라인드 1칩이다. 느린 무리(chip08) 블라인드는 최종 발표까지. 새 로트 블라인드였던 chip15 는 10/4 느린 교정으로 옮겼고(로그 48 [D48-90]), 새 로트 블라인드는 새 10칩에서 다시 뽑는다
- 3인 팀이라 완전 블라인드가 아니다 — 정답은 칩의 tally 로 봉인했고(120/120 바이트, 지민 종이 기록 12,000 과 일치) 추정 v1·v2 를
  tally 를 읽기 전에 커밋했다(`d502468` · `04bab2a`). v2 의 R 은 v2(R 3.8) 결과를 본 뒤 정답 전에 고쳤다([D48-60]) — 버린 설정도
  정답을 품었다(32번째 백분위)
- 개봉 prep 이 프로그램 시간 줄이 없는 옛 빌드라 무리 교차 확인(입력 C)을 하지 못했다

## 보고서 문장

"블라인드 칩(정답 12,000회)에 대해 판정용 모델은 68% 구간 3,001-19,000회, 95% 구간 1,001-34,000회를 내 정답을 두 구간 모두에
품었고, 정답은 사후분포의 중앙(49번째 백분위)에 있었다. 정격 대비로는 실제 사용률 12%를 추정 3-19%(68%) 안에 맞혔다. 교정 칩을
4개에서 5개로 늘리자 구간은 넓어졌지만, 늘리기 전 모델은 정답을 68% 구간 밖에 두었다 — 넓어진 구간이 정직한 불확실성이었다."
