young-0320/flash-margin-bench/docs/results/newchip_survey.md

# 신품 전수 측정 해석 (S-2) — 2026-09

- **수치**: [`data/newchip_survey_2026-09.md`](data/newchip_survey_2026-09.md) (+ 동명 CSV) — 절 번호가 같다. 표는 다시 싣지 않는다
- **절차의 원전**: `docs/spec/s2.newchip_protocol.md` · **경위**: [로그 28](../log/young/28.realchip_day_chip02_chip03.md) ·
  [로그 43](../log/young/43.newchip_survey_anchor_failure.md) · [로그 48](../log/young/48.pilot_wear_handler_and_plan_approval.md) §8-§10
- 2026-09-26 에 집계표에서 해석을 떼어 이 문서로 옮겼다. 문장은 당시 그대로이고, 이후 바뀐 자리에는 추기를 달았다

## 결론

- **M 트랙은 닫혔다 (2026-09-22).** 인수 기준 A1-A4 충족, 분모 `n = 9`(chip05 측정 불가)
- **이상치**: chip10 하나가 후보였고 재측정 2회로 재현되어 **개체 특성으로 채택**했다 (§4)
- **§6.3 분기**: σ_repeat = 13.86ps 에 σ_between 은 어느 집합으로 잡아도 그 3배를 넘는다 → **분해된다, 칩당 1회로 종료** (§6)
- **G-a**: 앵커 chip02 는 판정선 밖이었으나 원인은 **측정계가 아니라 그 조립체의 고장**이었다. 측정계 안정의 근거는
  앵커가 아니라 같은 세션 **chip10 3점**이 대신한다 (§6)
- **방법론에 남는 것**: 절대 소거 시간은 칩 간 비교 지표가 못 된다 — 각 칩 자신의 t=0 대비 상대 변화로 본다 (§1 ①)

> **2026-10-25 추기 — 신품 전수 끝: 31칩 (FV 19 · JV 12).** 위 결론은 n=9 판정의 것이고 그대로다. 그 뒤 추가 구매분을 §1 에 행만 더해 왔고(판정 밖),
> 10/25 FV chip26 · JV chip30-39 로 신품 측정이 끝났다. 무리는 빠른 19 · 느린 12(수치 §1 「무리 정리」). 바뀐 자리는 ① · ② · ④ · §4 의 추기

## 1. 관측

### ① 소거 시간의 개체 차이가 크다

처음 본 것은 chip02 27.2ms vs chip03 51.1ms, 1.88배였다(n=2 시점). 마모 탓이 아니다 — 소거 시간은 마모될수록
늘어나는데, P/E 5회인 chip02 가 1회인 chip03 보다 빠르다. 둘 다 데이터시트 max 400ms 안이고 chip03 은 typ 45ms 에
가깝다. 섹터 간 산포는 두 칩 모두 ±17% 로 같아, 다른 것은 중앙값 자체다. n=9 에서도 25.7-51.1ms 로 두 배 폭이 유지됐다.

- **절대 소거 시간은 칩 간 비교 지표로 쓸 수 없다.** "50ms 면 늙은 칩" 류의 판정이 불가능하다 — 신품 chip03 이 이미 51ms 다
- 교정 곡선과 수명 역산은 **각 칩 자신의 t=0 대비 상대 변화**로 세워야 한다 (S-1 §9 로그 C 의 `chip_id` 가 공통 필수인 이유)
- 전수 신품 측정이 블라인드 추정의 전제라고 보았다 — 블라인드 칩도 신품 때 재두므로 그 개체의 t=0 을 우리가 갖고 있다

> **2026-10-25 — 31칩에서도 두 배 폭, 범위는 넓어졌다.** 분류값(32-127) 24.5-53.4ms. FV 는 빠른 24.9-33.7 · 느린 47.0-51.1 로 n=9 때 띠 그대로이고,
> JV 는 빠른 24.5-36.3 · 느린 52.7-53.4 — 가장 느린 셋이 JV 다. JV `DF` 다섯(chip10 · 14 · 33 · 34 · 35)이 FV 의 빈 구간 근처 33-36ms 에 모인다.
> 「절대값은 칩 간 지표가 못 된다」 는 더 강해졌다 — 같은 마킹 `25Q64JVSIQ` `2505` 여섯 칩이 24.5-53.2ms 에 퍼진다

> **2026-09-26 — 셋째 줄은 전제에서 보조로 내려갔다 (S-1 §15 추기 · 로그 48 §13).** 현장의 칩에는 신품값이 없으므로
> 블라인드 역산의 1차 모델은 칩 안의 대조군 섹터를 그 칩의 t=0 으로 쓴다. 집계표의 신품값은 2차(참조) 모델의 입력이다.

### ② 타이밍 마진은 개체 간 거의 같다

chip02 와 chip03 은 소거 시간이 2배 다른데 윈도우 폭은 22.6ps(0.057%) 차이였다. 두 지표가 서로 독립적이라는 첫 증거이며,
S-1 이 노화 지표를 이중화한 설계를 지지한다. 다만 n=2 시점의 관측이고, n=9 로는 다시 보지 않았다.

> **2026-10-25 — 31칩으로 보면 width 는 UID 꼴로 두 띠다.** UID `DF` JV 7칩 38,704-38,918ps · 나머지 24칩(FV 19 · JV `D16x` 4 · `CA` 1) 39,327-39,821ps,
> 사이 409ps 가 비고 겹치지 않는다. 띠 안에서는 소거 시간과 따로 논다(`DF` 띠 안에 소거 33-53ms, 다른 띠에 24.5-53.2ms) — 「두 지표가 독립」 은 31칩에서도 선다

### ③ 천장 BER 은 패턴이 정한다

천장 BER 0.2466 이 chip02·chip03 에서 같고, chip01 은 25/45/75MHz 세 클럭에서 0.2462 였다. 개체가 달라도 클럭이 달라도
같다 — 이 천장이 칩이 아니라 패턴이 결정하는 값이라는 README 의 논거가 개체 축으로 한 번 더 강해졌다.

### ④ 접촉 품질이 폭을 50ps 급으로 흔든다 (2026-09-16)

chip04 를 같은 날 네 번 쟀다(수치 §1). 정상 재장착은 6ps 안이었고, 접촉이 한 번 흔들린(`FF FF FF`) 세션은 53ps 였다.
변수는 "재장착했는가" 보다 "그 접점이 얼마나 잘 물렸는가" 다. 같은 날 chip02 는 재장착 + prep 이 함께 든 측정에서 −67ps 로
나왔으나 원인이 갈리지 않는다.

- 개체차가 정상 재장착 편차보다 크다 — 4칩이 168ps 에 퍼져 있고 정상 재장착은 6ps 였다. 다만 이것들은 조건이 제각각인
  차이이지 σ 가 아니다. 재장착 σ 는 앵커 측정(§6)으로만 나온다
- **`FF FF FF` 를 한 번이라도 본 세션의 측정은 의심한다.** 접촉이 흔들린 증거이고, 세션 로그에 그 줄이 있는지가 판단 근거다

> **2026-10-25 — 접촉 실패의 두 번째 서명.** JEDEC · UID 는 읽히는데 blank_pre 가 수만 비트(페이지 통째 `00`)이고 이어 첫 소거가 `busy stuck` 으로 멈추는 꼴이
> 3건 나왔다. 한 건은 같은 칩(chip34)이 재장착 뒤 blank_pre 0 · PASS 라 칩이 아니라 접촉이다 — blank_pre 만 보면 「사용 이력」 으로 오독한다(등록부 10/25).
> 이 서명이 나온 런은 버리고 재장착 · 재측정한다. 신품 판정에 blank_pre 를 쓸 때는 같은 런의 `busy stuck` · 이상 UID 와 함께 본다

> **2026-09-20 — "정상 재장착 6ps" 는 과소였다 (§6).** chip10 재장착 3회의 σ 가 13.86ps 로, 재장착 σ 의 정본은 이 값이다.

### ⑤ 9/20 세션 — 앵커가 판정선 밖으로 크게 나갔다

앵커 chip02 가 기준 대비 −302.8ps, G-a 판정선(±약 14ps)의 21배였고 9/16 의 접촉 변동으로도 설명되지 않았다. 비트스트림·PS
소스는 9/16 이후 변경 0건이라 원인이 아니다. 남은 후보는 온도 · 배선과 핀헤더 접점 · 전원 · 재빌드 배치 차이였다.
그날의 4칩은 앵커를 사이에 두고 양쪽으로 퍼져 있었다(chip07 은 앵커보다 높고 chip10 은 600ps 낮다). 세션이 통째로
밀렸다면 한쪽으로 몰려야 하므로, 세션 이동과 산포 확대가 겹쳤거나 칩마다 접촉이 달랐다고 보았다.

> **2026-09-20 — 풀렸다 (§6).** 같은 세션의 chip10 3점이 27ps 안에 머물러 측정계는 드리프트하지 않았고, 이탈은
> chip02 조립체의 고장이었다. 9/20 행 width 의 기울임 표기는 이 유보의 흔적이며, 값은 §4 판정에 그대로 쓰였다.

### chip01 — 파일럿 칩으로 가장 무난한 개체 (2026-09-23, 한영웅)

width 는 9칩 중앙값에서 +6.3 으로 가장 가깝고, 소거는 빠른 무리(chip06·09·02 와 함께 26-29ms)에 들며, 벽은 θ 셋이
33.6ps 안에 모여 얇은 쪽이다. 세 지표 어디에도 특이값이 없어, 마모로 곡선이 움직이면 그 변화가 개체 특성에 가려지지
않고 보인다. 9/22 런은 앵커 없이 쟀지만 4분 뒤 2차 런이 +2.5ps(재현 기준 41.6ps 안)로 재현 증인이 됐고, 이 값이 파일럿
곡선의 x=0 이다. 결과는 [`wear_pilot_chip01.md`](wear/wear_pilot_chip01.md).

7/08 우리 리그 값 대비 −78.3ps 는 반복 σ 의 100배가 넘지만 배선·장착이 다른 세션 간 차이이고, chip01 의 재장착 σ 는
미측정이라([로그 28](../log/young/28.realchip_day_chip02_chip03.md) `[U28-1]`) 세대·리그 몫으로 귀속하지 않는다.

**9/16 지민 PC 런의 처리.** 25MHz 4런은 계약 §6 상 무효라 채택하지 않았다. 같은 날 같은 리그의 75MHz 런(UART 양 1/3)은
무손실이었으므로 원인은 칩·PL 이 아니라 지민 호스트의 수신 처리량이다. 75MHz 1런은 유효하나 조건이 달라 표 밖에 두었고,
7/08 우리 리그 75MHz 와 −22.2ps 로 맞물려 106ps 의 세대·리그 몫을 가늠하게 한다(로그 28 §2.2). 그래서 W10-A 는 파일
회수가 아니라 새 측정이 됐고, 9/22 에 닫았다. 무효 런의 구제 규칙을 둘지는 미결이다.

`blank_pre` 는 chip02 와 같은 이유로 영구 무효다 — 7월에 이미 prep 을 받은 개체라 읽히는 것이 우리가 쓴 PRBS 이지 출고
상태가 아니다(로그 30 §4.2). `blank_post` 는 그와 무관하게 유효하다(§2.3).

## 2. chip02

- 115200 런과 921600 런의 차이 +0.45ps 는 chip01 반복 σ(0.61ps) 안이다 — 보 레이트 상향이 측정값을 바꾸지 않았다(로그 30 §10.3)
- 3회 표준편차 4.65ps 는 당시 유일한 **세션 간** 재현성 값이었다. chip01 의 ±0.61ps 는 한 세션 안 연속 5회라 prep·재프로그래밍·
  재락 성분이 빠져 있다. 재장착 성분은 §6 에서 따로 얻었다
- 신품이 typ 45ms 보다 빠른 것은 정상이다 — typ 은 대표값이고 보장은 max 400ms 다
- 섹터 간 산포 ±17% 가 이 칩의 신품 기준선이다. 마모군의 소거 시간이 이 띠를 벗어나는지가 노화 신호가 되므로, 중앙값
  하나가 아니라 128행을 전부 남긴다(로그 30 §4.4)
- **blank 둘은 서로 다른 질문이다.** `blank_pre` 무효값 2,097,152 bits 는 PRBS 의 0/1 이 반반이라는 서명이라 내적으로 일관된다.
  `blank_post` = 0 은 두 스캔 사이에 소거가 끼어 있어 직전 내용과 무관하게 성립한다. `pre` 는 출고 시점 결함 비트(전역)를,
  `post` 는 소거가 먹었나(소거한 0-2,047)를 본다

## 3. chip03

**`blank_pre` = 0 은 이 프로젝트의 첫 출고 blank 관측이다.** 8MB 전역에 0 으로 굳은 비트가 하나도 없다 — 로그 30 §2 가
"10개 전부 bits=0 이 나올 가능성이 높다, 발견이 아니라 보험" 이라고 사전에 적은 예상의 첫 실측 확인이고, chip02 에서
놓친 항목을 chip03 이 메웠다. 전역 스캔 시간이 chip02 와 출력 몫을 빼면 일치하는 것은 칩이 바뀌어도 타이머와 SPI 경로가
같은 값을 낸다는 확인이다.

## 4. 이상치 판정

보류 사유였던 앵커 이탈이 chip02 조립체 고장으로 판명됐고(§6) 같은 세션의 chip10 3점이 측정계 안정을 보증하므로,
로버스트 판정의 전제가 성립해 사전 규칙을 그대로 적용했다.

- **chip10 은 진짜 개체 특성이다.** 재장착을 두 번 끼고도 재현 기준 안에서 재현됐으므로 규칙대로 세 값 모두 채택하고 빼지 않는다.
  재측정 상한(2개 칩)에는 걸리지 않았다
- **다만 "칩의 것" 인지는 미정이다.** 칩마다 배선이 따로이므로(S-2 §3.3) −911.8ps 가 다이인지 배선인지는 S-2 §8 교차 시험
  전까지 갈리지 않는다. 어느 쪽이든 §6.2 의 처방은 같다(빼지 않는다)
- 벽으로 보면 chip10(가장 두꺼움)과 chip07(가장 얇음)이 6.3배다. 이것이 이 표가 말하는 산포의 실체다
- chip01 을 넣은 n=9 재산출에서 chip01 은 정중앙(+6.3)이고 새 후보는 없다

> **2026-10-25 — chip10 의 −911.8ps 는 칩 쪽으로 기운다.** chip10 은 JV 였고(등록부 10/06), 그 뒤 UID `DF` JV 여섯이 모두 같은 띠(38.7-38.9k)에 들고
> 다른 24칩은 하나도 들지 않았다(② 추기). 칩마다 배선이 따로인데 7/7 · 0/24 로 갈리므로 배선보다 칩 종류의 값이다. S-2 §8 교차 시험은 여전히 안 했고,
> 「다이」 까지는 말하지 않는다 — UID `DF` 꼴의 JV 가 다르게 만들어진 것인지(공정 · 다이 · 패키지)는 이 자료로 갈리지 않는다

**한때 보류됐던 이유.** MAD 가 9/20 값들 때문에 부풀어 있었다. 9/15-16 의 4칩만으로 낸 로버스트 σ 는 42.8ps 인데 8칩으로는
220.5ps — 기준이 스스로 느슨해졌다. 옛 기준으로는 셋이 밖이고, 그러면 S-2 §6.2 의 "후보 3개 이상이면 절차·장비를 의심하고
중단" 에 걸린다. 어느 기준이 옳은지가 곧 앵커 문제였으므로 §6 을 먼저 풀었다.

## 6. 앵커와 재장착 σ

**목적**: 개체 차이와 "꽂았다 빼는 행위 + 장비" 가 만드는 흔들림을 가른다. 같은 칩을 세션 안에서 반복해 재면 개체 성분이 0 이므로
남는 산포가 노이즈 플로어 σ_repeat 이고, 이것이 §6.3 분기의 분모다.

chip10 세 점은 07:29 부터 07:56 까지, chip02 가 −380ps 를 찍던 구간을 가로지르며 27ps 안에 머물렀다. 따라서:

- **측정계는 그날 드리프트하지 않았다.** "세션이 통째로 밀렸다" 는 가설은 폐기
- **σ_repeat 의 정본은 13.86ps 다.** chip02 의 137.33ps 는 노이즈 플로어가 아니라 그 조립체(칩 또는 배선) 하나의 고장 신호다
- **앵커를 chip02 로 둘 수 없다.** 계측계를 재라고 세운 기준 개체가 자기 자신의 열화를 보고 있었다(S-2 §8 「앵커가 재는 것의 한계」)

> **⑤ 가 들어오기 전에는 σ_repeat = 40.25ps(②③④)로 적혀 있었다.** ⑤ 가 ④ 대비 +311.7ps 로 되돌아오면서 ②③④ 의 단조
> 하강은 드리프트가 아니었고 chip02 의 산포는 137ps 로 바뀌었다. 세 점으로 σ 를 확정하면 안 된다는 실물이다.

- G-a 불통과는 확정이다 — 네 번 모두 판정선 밖. 다만 이동이 아니라 산포다
- ⑤ 의 −68.5ps 는 9/16 의 −67.1ps 와 거의 같다. 우연일 수 있으나 같은 값이 두 번 나온 자리라 기록한다
- 이동은 9/16 이후에 생겼다 — 9/16 16:10 은 +3.5ps 로 멀쩡했고, 16:18 의 −67.1 은 재장착과 prep 이 함께 들어 귀속이 안 된다(로그 36 §2-10)
- **같은 세션인데 칩별 재현성이 다르다.** 공유부(JB 헤더·FPGA·전원)의 문제라면 둘 다 흔들려야 하므로 chip02 쪽이 의심된다.
  파일럿 겸 앵커라 JB 에 꽂았다 뺀 횟수가 가장 많았고, 그 배선의 핀헤더가 가장 먼저 상할 자리다
- 칩과 배선은 아직 안 갈렸다 — 지금까지의 칩 간 차이는 전부 "칩 + 그 배선" 의 차이이고, 가르는 절차는 S-2 §8 말미의 교차 시험이다

**§6.3 분기.** 앞서 집합에 따라 결론이 뒤집히던 문제는 분모가 chip02 조립체의 고장값이었기 때문이며, 정상 개체로 분모를 잡으면
사라진다. 어느 집합이든 분해되므로 S-2 §6.3 의 처방(전 칩 3회 재측정, 27 런)은 집행하지 않는다. 단서 — σ_between 은 칩을 각자의
배선으로 잰 값이라 분해된 것은 "칩 + 배선" 이다.

## 7. chip05

직전·직후 칩이 정상이었으므로 배선·전원이 아니라 개체 또는 삽입 상태다. 4회 동일 서명이라 분모를 `n = 9` 로 확정했다
(S-2 의 이상치 판정은 `n = 10` 전제로 설계됐다 — 워크플로 10 미결 #1). `FF FF FF` 는 계약 §6 의 무효가 아니라 JEDEC 불일치
(S-2 §6.1)이므로 재장착 후 재시도가 규정 처리다.

## 8. 인수 판정에 붙는 단서

- **개체 산포는 "칩 + 그 배선" 의 산포다** (S-2 §3.3). 칩만으로 좁히려면 S-2 §8 교차 시험이 선행이며, chip10 이 다이인지
  배선인지도 그때 갈린다
- **chip01 의 9/22 런은 앵커 없이 쟀다** — 대신 같은 세션 4분 뒤의 2차 런이 +2.5ps 로 재현했다
- **9/20 07:16-07:29 구간에는 반복 증인이 없다.** chip10 의 첫 점이 07:29 이므로 그 이전(chip07·09·08)의 측정계 안정은 직접
  관측이 아니라 07:29 이후가 안정했다는 사실로부터의 정황이다. 엄밀히 하려면 그 셋 중 하나를 1회 재측정하면 된다(스윕만, 1분)
