young-0320/flash-margin-bench/docs/results/baseline_compare.md

# 기준선 비교 — 선행식 이진 판별 · 단순 회귀 · 현행 모델(v3.2)

- **작성일**: 2026-10-05 · **결과 갱신** 2026-10-07 (chip02 를 교정에 넣은 뒤 같은 방법으로 다시 계산)
- **무엇**: 같은 모의 블라인드(LOCO) 점(10-07 판 — 교정 8칩 · 94점)에 세 방법을 댄다 — 발표 대본 7장의 표를 채우는 용도 (M1, 워크플로 14)
- **순서**: 이 문서의 「방법」 절을 **결과를 보기 전에** 적고 커밋한다. 「결과」 절은 그 뒤에 채운다 — 기준선을 일부러 약하게 만들지 않았다는 근거
- **수치**: `data/baseline_compare_2026-10.md` (표를 다시 싣지 않고 거기를 인용한다) · **코드**: `host/analysis/baseline_compare.py`
- **근거**: 선행 연구 `../ref/선행논문_재활용판별_NOR소거열화.md` §1 · 데이터시트 `../ref/w25q64fv_datasheet_revl.pdf` · 모델 `../spec/s5.lifetime_inverse_model.md`

## 방법 (결과 전에 고정 — 2026-10-05)

**공통 입력.** 교정 7칩(chip01 · 03 · 04 · 07 · 09 · 15 · 18)의 교정 표와 S-5 §7 의 LOCO 점(1,000 · 3,000 · 10,000 - 100,000, 표에 없는 점은 뺌).
한 점의 관측은 그 1k 구간의 섹터 0-6 소거 p50 일곱 개 — 세 방법이 같은 관측을 본다. 칩의 신품값은 집계표 값(LOCO 와 같다).

### ① 선행식 이진 판별 (Sakib 외 2018)

답은 「썼다 / 안 썼다」 뿐이다. 양성은 LOCO 점(모두 1,000회 이상 쓴 상태), 음성은 **신품을 잰 15칩**(chip05 는 측정 불가)의 신품 측정에서
같은 섹터 0-6. 낼 것은 검출률(양성 중 「썼다」)과 오경보(음성 중 「썼다」) — 전체 · 무리별 · 사이클 지점별. 몇 번 썼는지는 답하지 못한다.

판정 규칙은 논문 4절 식 (1) 그대로다: 신품 분포의 위쪽 끝을 문턱으로 두고, **α = 쓴 칩의 값이 그 문턱 아래로 떨어지는 비율**,
확신도 = (1 − α) × 100%. 관측 일곱 개 중 문턱을 넘은 비율이 확신도이고, **95% 이상이면 「썼다」**(논문은 98% — 일곱 개로는 둘 다
「일곱 개 전부」 다). 문턱만 셋으로 바꾼다.

- **(a) 데이터시트 typ** — 논문의 원래 기준(「데이터시트 중앙값이 신품을 대표한다」). typ 는 칩 마킹의 끝자리로 고른다: IG 60ms · IQ 45ms
  (W25Q64FV Rev L). 끝자리가 등록부에 없는 칩(chip10 · 12 · 14 · 17, 모두 음성 쪽)은 60ms 로 두고, 45ms 였다면 달라지는 판정을 따로 적는다
- **(b) 신품 칩 실측** — 데이터시트 대신 **판정받는 칩을 뺀** 나머지 신품 칩들의 섹터 단위 소거 시간 원자료(칩당 128섹터, newchip prep
  로그의 `#PREP ERASE`)의 최댓값
- **(c) (b) 를 개체차 정규화한 뒤에** — 모든 값을 그 칩의 기준값으로 나눈 배율로 바꿔 (b) 와 같은 판정을 한다. 기준값은 양성 점은 집계표
  신품값, 신품 칩은 자기 섹터 32-127 의 중앙값. 이것은 선행 연구의 방법이 아니라 **선행식 판정 + 우리 정규화**다 — 이진 판별의 약점이
  판정 규칙에 있는지 신품 기준에 있는지를 가른다

신품 로그는 집계표가 소거 값으로 채택한 세션(chip02 는 `20260915T153852Z`, chip14 는 채택 세션이 라벨 없이 끊겨 등록 세션
`20261001T061625Z`). chip12(구매처 미검증)도 신품 15칩에 넣는다.

> **2026-10-05 — 판정 규칙을 논문 식으로 고쳤다 (결과를 본 뒤의 수정).** 처음 커밋(`7ce25fc`)은 α 를 두 분포의 히스토그램 겹침으로
> 적었다 — 원문을 못 읽고 요약만 옮긴 것이었다. 원문(`../ref/sakib2018_recycled_flash_timing_cryptography.pdf` 4절)의 α 는 위와 같은 한쪽
> 방향 기준이라 (a) · (b) · (c) 를 모두 그 식으로 다시 계산했다. 고친 이유는 논문과의 일치이고, 숫자는 기준선에 불리한 쪽으로 움직였다
> (정규화 뒤 검출 75 → 64). ② · ③ 은 그대로다

### ② 단순 회귀 (평균 곡선 거꾸로 읽기)

답은 숫자 하나다. 빠진 칩과 **같은 무리**의 나머지 교정 칩으로 「배율 → 사이클」 곡선을 만든다: 칩마다 1k 구간의 배율(섹터 일곱 p50 의
중앙값 ÷ 신품값)을 구하고, 구간마다 칩 평균을 내고, 사이클에 대해 줄지 않게(누적 최댓값) 다듬는다. 시작점은 (배율 1, 0회), 끝은 100,000회.
관측 배율(일곱 개의 중앙값)이 곡선과 처음 만나는 자리를 직선 보간으로 읽는다 — 곡선 끝보다 크면 100,000, 1 보다 작으면 0.
무리 구분과 배율 정규화는 ③ 과 같은 정보를 준다 — ③ 과의 차이가 「구간이 있느냐」 만 남게 하려는 것이다.

### ③ 현행 모델 v3.2

`wear_inverse.py --loco` 그대로(눈금 ratio · R 빠른 1.6 · 느린 1.3 · 경계 40ms). 점 추정은 사후 중앙값 구간의 가운데.

### 지표

- ② · ③ 의 점 추정: 추정 ÷ 정답의 중앙값 · 절대 오차 중앙값 · |ln(추정 ÷ 정답)| 중앙값 (`data/inverse_v3_probe_2026-10.md` §6 과 같은 셋).
  전체 · 무리별 · x 구간별(20k 이하 · 20-50k · 50k 초과)
- ③ 만: 정답 ∈ 68% · 정답 ∈ 95% · 68% 폭 중앙값. ② 는 구간이 없다 — 칸을 비운다
- ①: 검출률 · 오경보

### 미리 아는 한계

- 82점은 7칩을 지점마다 다시 본 것이라 독립이 아니다
- ③ 의 R 은 같은 82점으로 골랐다(S-5) — ③ 의 포함률은 낙관 쪽이다. ② 는 고른 것이 없다
- ① 의 음성은 신품 15점뿐이라 오경보의 눈금이 거칠다(한 칩이 약 7%p)
- 관측은 섹터 일곱 개다 — 논문은 블록 100개를 쟀다. (b) · (c) 의 문턱은 신품 섹터 하나(최댓값)가 정하므로, 99번째 백분위로 바꾼 값을 수치 문서에 같이 둔다

## 결과 (2026-10-07 판 — 교정 8칩 · 94점)

chip02 를 빠른 무리 교정에 넣은 뒤(로그 48 [D48-103]) 방법 절 그대로 다시 계산했다 — 교정 칩만 7 → 8칩(chip02 추가)이고 나머지는 같다.
10-05 판(7칩 · 82점 — 방법 절 커밋 `7ce25fc` 뒤 계산, 같은 날 판정 규칙 정정 뒤 다시 계산)은 커밋 `fd0f79a`.

수치는 전부 [`data/baseline_compare_2026-10.md`](data/baseline_compare_2026-10.md). 그림: [`plots/baseline_compare_binary_2026-10.png`](plots/baseline_compare_binary_2026-10.png)(① 무리별 검출) ·
[`plots/baseline_compare_estimate_2026-10.png`](plots/baseline_compare_estimate_2026-10.png)(② · ③ 추정 대 정답).

| 방법 | 답 | LOCO 94점 · 신품 15칩에서 |
|---|---|---|
| ① (a) 선행식 — 데이터시트 기준 | 썼다 / 안 썼다 | 검출 64/94 (빠른 무리 2만 회 이하 2/20) · 오경보 0/15 |
| ① (b) 선행식 — 신품 칩 실측 기준 | 썼다 / 안 썼다 | 검출 65/94 (빠른 무리 2만 회 이하 3/20) · 오경보 0/15 |
| ① (c) 선행식 판정 + 우리 정규화 | 썼다 / 안 썼다 | 검출 74/94 (빠른 무리 2만 회 이하 13/20) · 오경보 0/15 |
| ② 단순 회귀 | 숫자 하나 | 절대 오차 중앙값 10,000 · 구간 없음 |
| ③ 현행 모델 v3.2 | 숫자 + 구간 + 등급 | 절대 오차 중앙값 7,500 · 68% 구간 67/94 · 95% 구간 93/94 |

### 1. 데이터시트 기준은 빠른 무리를 3-4만 회까지 신품으로 본다

(a) 는 오경보가 없지만 빠른 무리를 1,000 · 3,000회에서 하나도 잡지 못했고(0/10), 다섯 칩을 다 잡은 것은 5만 회부터다. 신품이 typ(60ms)의
절반(26-34ms)에서 출발하므로 두 배가 되어야 문턱에 닿는다. 느린 무리는 2만 회부터 잡히기 시작한다(2/3). 선행 문서 §1 이 예상한 그대로다 —
「같은 품번이면 신품값이 데이터시트값 근처로 같다」 는 전제가 이 칩에서 깨진다.

### 2. 신품을 직접 재서 기준으로 삼아도 거의 같다 — 문턱이 느린 무리의 신품값에 걸린다

(b) 의 문턱은 신품 섹터 값의 위쪽 끝 55.7ms 다 — 느린 무리 신품의 자리이고, 데이터시트의 60ms 와 별 차이가 없다. 그래서 결과도
65/94 로 (a)(64/94) 와 비슷하다. chip09 · chip02 는 4만 회(54.3 · 54.2ms)까지 놓쳤다. 신품 분포가 두 무리로 갈려 넓은 한, 절대값 문턱 하나는 느린 무리의
신품보다 위에 놓일 수밖에 없고, 빠른 칩은 그 밑에서 수만 회를 지난다.

### 3. 정규화를 넣으면 빠른 무리는 풀린다 — 느린 무리는 느는 폭이 작아 늦게 잡힌다

(c) 는 74/94 · 오경보 0/15 다. 빠른 무리는 **1만 회부터 전부** 잡는다(2만 회 이하 13/20 — (a) 는 2/20). 빠른 무리에서 이진 판별이 약했던
까닭은 판정 규칙이 아니라 신품 기준이었고, 칩 자신의 안 닳은 섹터로 나누면 풀린다.

느린 무리는 오히려 늦어진다(21/34 — (a) 24 · (b) 27). 배율 문턱이 1.28 인데 느린 무리는 10만 회에도 1.6-1.75배라 4만 회가 되어야 전부
넘는다. 이 문턱 1.28 은 신품 섹터 **하나**(chip04 의 43ms 섹터)가 정한 값이다 — 위쪽 끝을 99번째 백분위로 바꾸면 (c) 는 86/94 가 된다.
어느 쪽이든 답은 「썼다」 뿐이고, 1만 회 쓴 칩과 10만 회 쓴 칩이 같은 답을 받는다.

### 4. 점 추정도 현행 모델이 덜 빗나간다 — 느린 무리만 예외이고, 더하는 것의 본체는 구간이다

절대 오차 중앙값은 ② 10,000 대 ③ 7,500, |ln| 중앙값은 0.40 대 0.25 다. x 구간별로도 ③ 이 모두 작다(2만 회 이하 2,662 대 1,500 ·
2-5만 회 13,366 대 8,500 · 5만 회 초과 20,825 대 14,500). 무리로 나누면 엇갈린다 — 빠른 무리는 ③ 이 낫고(16,163 대 9,000 · |ln| 0.51 대 0.34),
느린 무리는 ② 가 낫다(4,106 대 6,500 · |ln| 은 0.19 대 0.18 로 같다).

10-05 판(② 9,254 대 ③ 8,500 — 그때는 「③ 의 숫자가 더 정확하다고 말할 근거는 약하다」 고 적었다)보다 차이가 벌어졌다. chip02 의 12점에서
② 가 크게 빗나간 몫이 있지만(20,861 대 15,000 — ② 는 10만 회를 45,319 로 읽었다), chip02 를 뺀 같은 82점에서도 8,867 대 6,500 이다 —
chip02 가 교정에 들어 ③ 이 chip09 · chip18 을 더 잘 맞히게 된 몫이다. 다만 교정 칩 하나로 이만큼 움직였고 느린 무리는 여전히 ② 가 낫다 —
**「③ 의 숫자가 늘 더 정확하다」 고는 말하지 않는다.** 차이의 본체는 다른 데 있다.

- ② 는 94점 중 17점에서 곡선 끝(100,000)에 붙었다 — 평균 곡선보다 빨리 늙는 칩은 이미 「10만」 이다(chip04 는 4만 회부터 · chip01 은 6만 회부터).
  늦게 늙는 chip02 가 평균 곡선을 낮춘 만큼 빨리 늙는 칩이 더 일찍 끝에 붙는다(10-05 판 12점 — chip04 는 9만 회부터).
  숫자 하나라서 그 답이 끝에 붙은 것인지 읽는 사람은 알 수 없다
- ③ 은 같은 점들에서 구간을 주고, 그 구간이 약속대로 맞는다 — 68% 구간이 67/94(71%), 95% 구간이 93/94(99%)

### 발표 문장

> 선행 연구 방식 그대로 데이터시트 값을 기준으로 하면, 빠른 칩은 3-4만 번을 써도 신품으로 보입니다. 신품을 실제로 재서 기준으로 삼아도
> 문턱이 느린 칩의 신품값에 걸려 결과가 같습니다. 저희 방식대로 칩 자신의 안 닳은 섹터로 나누면 빠른 칩은 1만 번부터 전부 잡힙니다 —
> 하지만 답은 여전히 "썼다" 뿐입니다. 단순 회귀도 숫자를 주지만 저희 모델보다 덜 맞고(오차 중앙값 1만 번 대 7,500 번 — 느린 칩만은
> 회귀가 낫습니다), 얼마나 믿어야 할지는 말하지 않습니다. 저희 모델의 구간은 94번 중 약속한 만큼 정답을 품었습니다.

### 한계

방법 절의 「미리 아는 한계」 에 더해:

- 양성 관측은 1k 구간의 p50(1,000회 평균에 가까운 값)이고 음성은 신품 한 번의 측정이다. 양성 쪽에는 한 번 측정의 튀는 값이 없어
  검출에 유리하다 — 기준선에 불리한 쪽이 아니다
- ② 의 정답 100,000 다섯 점은 곡선 끝에 붙어 오차 0 이 됐다 — ② 의 50k 초과 수치는 그만큼 후하다
- ③ 의 R 은 94점 중 82점(chip02 를 뺀 7칩)으로 골랐다. chip02 의 12점은 R 을 고른 뒤에 들어온 점이고, 그 12점에서 68% 구간은 5/12 ·
  95% 구간은 12/12 를 품었다 — 고르는 데 쓰지 않은 점에서는 68% 가 약속보다 덜 맞았다
