young-0320/flash-margin-bench/docs/results/wear_endurance_chip03.md

# 종단 마모 결과 해석 — chip03, 0 → 100,000 사이클

- **작성일**: 2026-09-27 · **측정**: 2026-09-26 - 09-27 (보드 A)
- **수치**: [`data/wear/wear_endurance_chip03_2026-09.md`](data/wear/wear_endurance_chip03_2026-09.md) (+ 동명 CSV) — 표를 다시 싣지 않고 거기를 인용한다
- **사전 등록**: `docs/spec/s1.wear_bench_spec.md` §15 2026-09-26 추기 (H1′·H2′·H3-H5 · 두 층 역산)
- **비교 대상**: 파일럿 [`wear_pilot_chip01.md`](wear_pilot_chip01.md)
- **경위**: `docs/log/young/48.pilot_wear_handler_and_plan_approval.md` §15

## 결론

**chip03 은 chip01 과 다르게 늙었다.** 마진은 두 칩 다 움직이지 않았지만, chip01 은 소거가 빨리 늘고 프로그램이
늦게 움직인 반면 chip03 은 소거가 느리게 늘고 프로그램이 일찍 움직였다. 그리고 100k 뒤 newchip 이 **마모 섹터
주변 128KB 의 대조군 섹터도 약 10% 느려졌음**을 보였다 — 근접 대조군은 깨끗한 기준이 아니다.

| 가설 | 등록 기준 | 결과 | 판정 |
|---|---|---|---|
| H1′ 100k 안 폭 3σ 안 | 42ps | 25MHz 체크포인트 100 대비 +3.6ps, 45MHz −3.5, 75MHz +8.7, 바닥 0 | **참** |
| H2′ 100k 안 프로그램 7.0ms 불변 | 보이면 깨짐, 시점 기록 | 약 20k 부터 오름, 100k 에 p50 8.60ms (+26%) | **거짓** (§2) |
| H3 계단 양자 21±4ms | 21섹터 전부 | chip03 7섹터 모두 100k 안에 계단이 없음 | **chip03 에서 판정 불가** (§3) |
| H4 전환 순서 · H5 칩 간 산포 | 첫 계단 전환 시점 | 전환 시점이 없음 | **chip03 에서 판정 불가** |
| (전제) 대조군 섹터 소거 불변 | 100k 뒤 newchip | 원격 0.98 · 근접 1.11 | **원격만 성립** (§4) |

## 1. 마진은 세 클럭 모두 움직이지 않았다 — 이번엔 같은 칩 전후 비교다

25·45·75MHz 전부 체크포인트 100(마모 전) 대비 1σ 안이다. 파일럿에서 75MHz 비교가 "약하다" 고 했던 이유(신품값이
다른 보드의 1런)는 여기서 사라졌다. 같은 칩·같은 리그·같은 장착에서 마모 전후를 쟀고, 접근 시간 여유가 가장
작은 75MHz 에서도 +8.7ps(한 스텝 15.9ps 안)다.

9/15 신품값 대비 체크포인트 100 이 +28ps 인 것은 11일과 재장착 차이다. 마모 100사이클로 생길 크기가 아니고, 100
에서 100k 까지는 5.7ps 폭 안에 있다. 그래서 종단 칩의 폭 기준선은 체크포인트 100 이다.

## 2. H2′ 는 깨졌다 — 프로그램 시간이 20k 부터 오른다

파일럿 chip01 은 섹터 0 이 약 145k 에서야 움직였다. 여유 1.5배를 알고 "100k 안에선 안 보인다" 로 걸었는데,
chip03 은 19-20k 구간에 이미 6.9ms 로 올라 100k 에 8.6ms 가 됐다(수치 §4).

모양도 다르다. chip01 은 섹터 0 → 6 순으로 단조 감소하는 **순서 기울기**였고(소거 묶음 직후 효과 후보), chip03 은
7섹터가 **함께** 오른다. 100k 에서 섹터 간 차이가 0.5ms 뿐이고 번호 순서도 없다. 즉 chip01 의 순서 기울기와
chip03 의 균일 상승은 다른 현상일 수 있다. [U48-6] 의 "열인가 과도인가" 는 chip01 모양에 대한 질문이고,
chip03 은 그 질문에 들어가지 않는다.

**보고서 문장**: "프로그램 시간이 100k 안에 움직이지 않는다는 사전 예측은 두 번째 칩에서 깨졌다. 파일럿 한 칩으로
세운 여유가 칩 간 산포를 덮지 못했다."

## 3. 소거는 느리게, 계단 없이 올랐다 — 그리고 계단 문턱에 막 닿았다

칩 p50 은 52 → 89ms(1.7배)로 chip01 의 같은 구간(29 → 약 114ms, 4배)보다 훨씬 완만하다. 신품에 느린 칩이 덜
늘었다. 섹터별로 봐도 chip01 의 18-22ms 도약이 없다 — 1k 구간 중앙값이 6ms 넘게 뛴 자리는 섹터 6 의 한 곳뿐이다.

H3·H4·H5 는 모두 "첫 계단" 을 재는 가설이라, 계단이 없는 chip03 에서는 판정할 수 없다. 등록 문구가 "21섹터
전부" 이므로 이 7섹터는 봐주지 않는다 — 종단 3칩 판정에서 H3 은 최소한 "chip03 에서 미충족" 으로 적힌다.

**문턱 수준에는 왔지만 뛰지 않았다.** chip01 의 첫 계단(섹터의 1k 구간 중앙값이 처음 105ms 를 넘은 구간)은 7섹터 모두
직전 구간 84-93ms 에서 **109.5-109.7ms 로 착지**했다(34-62k). 전환 구간의 A 행은 두 봉우리로 갈린다 — 섹터 0·4 의 55-60k
1만 행 중 94-108ms 는 0건이다. chip03 은 100k 에 섹터 중앙값이 88-93ms 로 chip01 의 출발 수준에 들어와 있지만, 95-100k
의 섹터 5 A 행 5,000건은 75-105ms 에 이어져 있고 105ms 이상은 2건뿐이다. 95ms 초과 사이클(95-100k 에 섹터 2-5 가 12-15%)은
이 덩어리의 꼬리이지 새 봉우리가 아니다. 칩 전체로도 105ms 이상은 70만 행 중 56건(섹터 4·2 가 37건)이다.

그러니 "소거 시간이 약 92ms 에 닿으면 계단이 온다" 는 chip03 으로는 확인도 반박도 안 된다 — 수준에 닿는 것은 필요조건일
수는 있어도 충분조건은 아니다. 확실히 말할 수 있는 것은 **계단이 올 때 착지 수준이 칩 안에서 거의 고정(약 110ms)**
이었다는 chip01 의 관찰뿐이고, 이것을 다음 칩에 대한 예측(H6)으로 S-1 §15 에 날짜를 달아 적는다. 두 칩을 본 뒤의
예측이라 사전 등록이 아니다.

## 4. 대조군 섹터는 128KB 안에서만 늙었다

100k 뒤 newchip 한 번의 prep 이 섹터 0-127 을 같은 패스에서 지웠다(수치 §5).

- **원격 대조군(121-127)과 블록 2-7(32-127) 은 신품 대비 0.98** — 안 늙었다. 신품 대비 조금 빠른 것은 9/15 와
  9/27 의 조건 차이로, 블록 2-7 전체가 같은 폭으로 움직였다
- **근접 대조군(7-13)은 1.11, 64KB 블록 0 의 나머지(14-15)와 블록 1(16-31)도 1.08-1.10** — 마모 섹터를 품은 첫
  128KB 전체가 약 10% 느려졌다. 블록 2 와의 경계가 날카롭다(블록별 중앙값 1.159 · 1.103 · 0.981)

마모 섹터를 지울 때 같은 블록·인접 블록의 셀이 약한 스트레스를 받는 **소거 교란(erase disturb)** 으로 읽힌다.
파일럿이 답하지 못했던 S-1 §15 ③(인접 섹터 간섭이 존재하는가)의 답이 여기서 나왔다 — 존재하고, 범위는 128KB 다.

**두 층 역산에 주는 영향.** 1차 현장 모델의 기준을 "대조군 섹터" 로 적어 두었는데, 근접 대조군은 오염돼 있다.
기준은 **마모 영역에서 128KB 넘게 떨어진 섹터**여야 한다. 그렇게 하면 chip03 의 1차 비율은 91.6 / 49.9 = 1.84,
신품 참조를 쓴 2차 비율은 91.6 / 51.0 = 1.80 로 2% 안에서 같다 — 칩이 자기 신품 기준을 몸에 지닌다는 전제가 원격
섹터로는 성립한다. 기준 섹터를 어디로 정하느냐는 블라인드 착수 전에 닫을 결정이다([U48-8]).

prep 경로의 눈금도 확인됐다. 100k 뒤 prep 소거(마모 섹터 중앙값 91.6ms)와 같은 시점 마모 루프 소거(섹터
중앙값 88-93ms)가 같은 값이다. 블라인드 칩을 개봉 전 prep 한 번으로 재도 교정 곡선과 같은 눈금이다.

## 5. 두 칩을 나란히 놓으면

| | chip01 (파일럿) | chip03 |
|---|---|---|
| 신품 소거 | 28.7ms (빠른 무리) | 51.1ms (느린 무리) |
| 100k 소거 (99-100k 섹터 중앙값) | 약 114ms (4배) | 88.9ms (1.7배) |
| 계단 | 34-62k 에 7섹터 전부, 착지 약 110ms | 100k 까지 없음 (출발 수준 88-93ms 도달) |
| 프로그램 첫 움직임 | 약 145k, 섹터 순서 기울기 | 약 20k, 7섹터 균일 |
| 25MHz 폭 | 불변 | 불변 |

소거 시간 하나로는 두 칩이 같은 곡선 위에 놓이지 않는다. 역산 모델은 **소거와 프로그램 두 축**을 써야 할 수 있고,
그 판단은 chip06·chip04 까지 본 뒤에 한다. 지금 말할 수 있는 것은 "칩마다 늙는 방식이 다르다" 이고, 그것을
블라인드 오차 막대가 그대로 떠안는다.

## 6. chip03 에서 닫힌 것과 넘어간 것

- **닫힘**: H1′(25/45/75MHz, 같은 칩 전후) · H2′ 거짓 · prep 소거 눈금 · 인접 간섭 존재(S-1 §15 ③) · 장부 100,000
- **넘어감**: H3-H5 판정(chip06·chip04) · H6 시험 · 1차 모델의 기준 섹터([U48-8]) · 두 축 역산 여부
- **chip03 의 다음**: 섹터 0-127 이 newchip PRBS 로 써진 상태로 보관. 고온 유지 시험의 100k 시료 후보
