young-0320/flash-margin-bench/docs/results/wear_endurance_chip04.md

# 종단 마모 결과 해석 — chip04, 0 → 100,000 사이클

- **작성일**: 2026-09-30 · **측정**: 2026-09-26 - 09-27 (보드 B, 박지민)
- **수치**: [`data/wear/wear_endurance_chip04_2026-09.md`](data/wear/wear_endurance_chip04_2026-09.md) (+ 동명 CSV) — 표를 다시 싣지 않고 거기를 인용한다
- **사전 등록**: `docs/spec/s1.wear_bench_spec.md` §15 2026-09-26 추기 (H1′·H2′·H3-H5) · 2026-09-27 추기 (H6)
- **비교 대상**: 파일럿 [`wear_pilot_chip01.md`](wear_pilot_chip01.md) · 종단 [`wear_endurance_chip03.md`](wear_endurance_chip03.md) · [`wear_endurance_chip07.md`](wear_endurance_chip07.md)
- **경위**: `docs/log/young/48.pilot_wear_handler_and_plan_approval.md` §21

## 결론

**chip04 는 파일럿 chip01 과 같은 빠른 무리답게 늙었다 — 소거가 3.5배로 크게 늘었고 7섹터 모두 25-47k 에 계단을 탔으며,
프로그램은 100k 까지 그대로였다.** 폭은 세 클럭 모두 움직이지 않았다. 계단이 올 때의 조건을 적은 H6 은 7섹터 전부에서
맞았고, 계단 높이도 7섹터 모두 21±4ms 안이었다. 반면 "신품에 느린 섹터가 먼저 뛴다"(H4)는 반대로 나왔다. chip04 는 종단 3칩
가운데 계단이 온 유일한 칩이라, H3-H6 의 종단 판정이 여기서 닫힌다.

| 가설 | 등록 기준 | 결과 | 판정 |
|---|---|---|---|
| H1′ 100k 안 폭 3σ 안 | 42ps | 25MHz 체크포인트 100 대비 −3.7 에서 +3.2ps, 45MHz +5.3, 75MHz −2.0, 바닥 0 | **참** (§1) |
| H2′ 100k 안 프로그램 7.0ms 불변 | 보이면 깨짐 | 섹터 1k 구간 중앙값 6.94-6.96ms, 100k p50 6.94ms | **참** (§2) |
| H3 계단 양자 21±4ms | 종단 3칩 21섹터 전부 | chip04 7섹터 18.5-22.7ms 로 전부 안 · chip03·chip07 14섹터는 계단 없음 | chip04 **충족** · 종단 판정 **거짓** (§4) |
| H4 전환 순서 = 신품 소거 내림차순 | 칩마다 ρ ≥ 0.5, 3칩 중 2칩 | chip04 ρ −0.31 (방향 반대) · 나머지 두 칩은 계단 없음 | **거짓** (§4) |
| H5 같은 순위 섹터 전환 시점 범위 | 3칩에서 40k 이하 | 계단이 온 종단 칩이 하나 | **판정 불가** (§4) |
| H6 계단이 올 때 ① 직전 84ms 이상 ② 착지 107-112ms | 계단이 온 섹터 전부 | 7섹터 직전 87.8-94.4ms · 착지 110.5-111.0ms | **참** (§3) |
| (전제) 대조군 섹터 소거 불변 | 100k 뒤 newchip | 원격 1.00 · 근접 1.15 · 블록 0·1 1.25·1.18 | **원격만 성립** (§5) |

## 1. 마진은 세 클럭 모두 움직이지 않았다 — 가장 조용한 리그였다

25MHz 체크포인트 14점이 39,771.0-39,777.9ps, 즉 7ps 안에 있다. 75·45MHz 도 마모 전후 차이가 한 스텝(15.9ps) 안이다(수치 §1·§2).
H1′ 은 chip03 에 이어 두 번째로 깨끗하게 섰다.

측정 품질도 기록할 만하다. 스윕 원점 회전(−608/−609 스텝)과 버스트성 F(0.46)가 마모 전부터 newchip 까지 한 번도 바뀌지 않았다.
chip07 에서 계측 사건을 가려낸 두 값이 여기서는 끝까지 고정이었으니, **사건 없는 리그가 100k 동안 어떤 모습인지의 기준**이 된다.
9/16 신품값(39,687.9ps)과 체크포인트 100 의 차이 +87ps 는 10일과 다른 장착의 차이이고, 그래서 기준선은 체크포인트 100 이다.

## 2. H2′ 는 참이다 — 빠른 무리는 프로그램이 버틴다

섹터별 1k 구간 중앙값이 100k 동안 6.94-6.96ms 에 머물렀다(수치 §5). 느린 무리 두 칩(chip03 20k 부터 +26%, chip07 5k 부터 2.1배)과
정반대이고, 파일럿 chip01(145k 까지 7.0ms)과 같다. 종단 3칩에서 H2′ 는 1 참 · 2 거짓이 됐고, 갈린 선이 신품 소거 무리와 겹친다.

## 3. 계단은 7섹터 전부에 왔고, H6 이 맞았다

첫 계단은 섹터 3 이 25-26k 로 가장 먼저, 섹터 4·6 이 46-47k 로 가장 늦었다(수치 §4). 7섹터 모두 직전 1k 구간 중앙값이 87.8-94.4ms 로
H6 ① 의 84ms 를 넘었고, 착지는 110.5-111.0ms 로 ② 의 107-112ms 안이다. 파일럿 chip01 의 착지(109.5-109.7ms)와 1ms 안에서 같다 —
**계단이 오면 칩이 달라도 약 110ms 에 앉는다.**

H6 은 두 칩(chip01·chip03)을 본 뒤 세운 예측이라 사전 등록이라 부르지 않았지만, chip04 데이터를 보기 전에 적었다 — 커밋
2026-09-27 13:08 KST, chip04 의 A 행이 한영웅에게 온 것은 9/29-30 이다. 계단 자체는 그보다 앞서 박지민의 보드에서 이미 일어났다.

섹터 0 만 57-58k 부터 1k 구간 중앙값이 125ms 를 넘나든다(최대 134.6ms). 두 번째 계단으로 가는 전환 구간일 수 있으나, 100k 안에
자리를 잡지 않아 높이를 재지 않았다.

## 4. 종단 3칩의 H3-H5 — chip04 한 칩이 닫는다

**H3.** chip04 7섹터의 계단 높이는 18.5-22.7ms 로 전부 21±4ms 안이다. 파일럿 chip01 7섹터(같은 코드로 19.7-22.8ms)와 합치면
계단이 온 14섹터가 모두 한 양자 근처에 있다. 그러나 등록 문구는 "종단 3칩 21섹터 전부" 이고, chip03·chip07 의 14섹터는 계단이
없어 미충족으로 세기로 했다(로그 48 [D48-24] · [D48-33]). 그래서 **종단 판정은 거짓**이다. 틀린 것은 "양자가 같다" 가 아니라
"100k 안에 모든 칩에 계단이 온다" 는 숨은 전제였다.

**H4.** 파일럿 chip01 은 신품에 느린 섹터가 먼저 뛰는 쪽(순위 상관 +0.64)이었다. chip04 는 −0.31 이다 — 신품이 가장 빠른 섹터
3(31.4ms)이 가장 먼저, 가장 느린 섹터 4(37.9ms)가 가장 늦게 뛰었다. 판정할 수 있는 종단 칩이 chip04 하나라 "3칩 중 2칩" 을 채울 수
없고 그 하나도 어긋났으므로 **거짓**이다. 섹터 안의 신품 소거 차이(chip04 에서 31-38ms)로는 섹터가 뛰는 순서를 예측하지 못한다.

**H5.** 같은 순위 섹터를 칩 사이에 맞대려면 계단이 온 종단 칩이 셋 필요한데 하나다. **판정 불가**로 둔다. 참고로 chip04 의 7섹터
전환은 22k 폭(25-47k)에 있고 파일럿 chip01 은 28k 폭(34-62k)이었다. 두 칩 모두 칩 안의 폭이 H5 의 40k 기준보다 좁다.

## 5. 대조군 교란은 세 칩째 — chip04 가 가장 크다

100k 뒤 newchip 에서 원격 대조군과 블록 2-7 은 1.00, 근접 대조군 1.15 · 블록 0 1.25 · 블록 1 1.18 이고 블록 2 에서 1.00 으로
끊긴다(수치 §6). chip03(1.08-1.16)·chip07(1.06-1.16)과 같은 모양이고 크기는 가장 크다 — 마모 섹터가 가장 많이 닳은 칩(3.7배)에서
교란도 가장 컸다. 세 칩 모두 경계가 128KB 라, 1차 현장 모델의 기준 섹터를 "마모 영역에서 128KB 넘게 떨어진 섹터" 로 좁히는
[U48-8] 의 근거가 셋이 됐다. prep 소거(121.8ms)와 99-100k 마모 루프 소거(117-130ms)는 같은 눈금이다.

## 6. 66,654 에서 칩과의 접촉이 흔들렸다

66,654-66,671 의 18사이클 동안 A 행 126개 중 120개가 소거 8µs · 프로그램 130µs 로 나왔다 — 칩이 명령을 받지 않았는데 상태 레지스터가
"바쁘지 않음" 으로 읽힌 모양이다(수치 §8). 같은 사이클 안에서 정상 행과 섞이고 `ts` 가 연속이라, 파일럿에서 본 타이머 넘침이 아니라
**SPI 접촉 불량**이다. 그 끝에 섹터 0 프로그램이 2초 동안 안 풀려 `wip_timeout` 으로 섰다. 박지민이 66,600 으로 되돌려 복구 prep 뒤 이었다.

곡선에 주는 영향은 작다. 가짜 행 120개는 모든 집계에서 뺐고, x 축은 tally(재개 기준 66,600)를 따른다. 66,601-66,653 은 칩이 두 번
받았으므로 실제 P/E 는 약 53 많고 장부는 71 많다 — 둘 다 100k 의 0.1% 아래다. 이 사건은 chip07 의 USB 끊김과 함께, 리그 접촉이
종단의 가장 약한 고리였다는 기록이다.

## 7. 네 칩을 나란히 놓으면

| | chip01 (파일럿) | chip04 | chip07 | chip03 |
|---|---|---|---|---|
| 신품 소거 | 28.7ms | 33.7ms | 47.0ms | 51.1ms |
| 무리 | 빠름 | 빠름 | 느림 | 느림 |
| 100k 소거 / 신품 (루프 p50) | 3.97 | 3.54 | 1.58 | 1.74 |
| 계단 (100k 안) | 34-62k, 7섹터, 착지 약 110ms | 25-47k, 7섹터, 착지 약 111ms | 없음 | 없음 |
| 100k 프로그램 | 7.0ms 그대로 | 6.94ms 그대로 | 14.19ms (2.1배) | 8.60ms (+26%) |
| 25MHz 폭 | 불변 | 불변 | 불변 (사후 처리) | 불변 |
| 근접 대조군 소거 (100k 뒤) | — | 1.15 | 1.06 | 1.11 |

두 무리가 칩 두 개씩으로 섰다. 빠른 무리는 소거가 3.5-4배로 크게 늘고 100k 안에 계단을 타며 프로그램은 버틴다. 느린 무리는 소거가
1.6-1.7배로 완만하고 계단이 없으며 프로그램이 일찍 오른다. 한 무리 안에서도 신품이 빠를수록 배수가 큰 것은 빠른 무리에서만 맞고
(3.97 > 3.54), 느린 무리에서는 뒤집힌다(1.58 < 1.74).

## 8. chip04 에서 닫힌 것과 넘어간 것

- **닫힘**: H1′ 참(3 클럭) · H2′ 참 · H6 참(7섹터) · H3 종단 판정 거짓(chip04 7섹터는 충족) · H4 거짓 · H5 판정 불가 ·
  128KB 소거 교란 세 칩째 · prep 소거 눈금 · 장부 100,071(겹친 71 포함)
- **넘어감**: 두 층 역산의 형식(소거 한 축인지, 무리를 먼저 가르는지) · 1차 모델의 기준 섹터([U48-8]) · 섹터 0 의 두 번째 계단
- **chip04 의 다음**: 섹터 0-127 이 9/27 newchip PRBS 로 써진 상태(박지민 보관). 100k 계단을 탄 유일한 종단 칩이라 고온 유지 시험 후보로 둘 만하다(정한 것 아님)
