young-0320/flash-margin-bench/docs/results/wear_endurance_chip07.md

# 종단 마모 결과 해석 — chip07, 0 → 100,000 사이클

- **작성일**: 2026-09-29 (9/30 선 복구 뒤 측정 · newchip 추가) · **측정**: 2026-09-27 - 09-30 (보드 A)
- **수치**: [`data/wear/wear_endurance_chip07_2026-09.md`](data/wear/wear_endurance_chip07_2026-09.md) (+ 동명 CSV) — 표를 다시 싣지 않고 거기를 인용한다
- **사전 등록**: `docs/spec/s1.wear_bench_spec.md` §15 2026-09-26 추기 (H1′·H2′·H3-H5) · 2026-09-27 추기 (H6 · chip07 교체와 "계단 없음" 예측)
- **비교 대상**: 파일럿 [`wear_pilot_chip01.md`](wear_pilot_chip01.md) · 종단 1 [`wear_endurance_chip03.md`](wear_endurance_chip03.md)
- **경위**: `docs/log/young/48.pilot_wear_handler_and_plan_approval.md` §16-§20

## 결론

**chip07 은 chip03 과 같은 느린 무리답게 늙었다 — 소거는 완만했고 계단이 없었으며, 프로그램은 chip03 보다 더 일찍·더
크게 올랐다.** 마모 전에 적은 "chip07 도 100k 안에 계단 없음" 예측은 맞았다. 폭(H1′)은 25MHz 에서 참이다 — 70k 직전에
배선을 건드린 **계측 사건**이 폭을 +590ps 옮겨 사건 전후를 나눠 판정했고(사후 처리), 처음 10k 의 −59ps 는 장착 뒤 안정화로
판단했다. 75·45MHz 는 판정 불가다 — 선을 다시 눌러 경로 서명(원점·F)은 돌아왔지만 폭이 마모 전보다 세 클럭 모두 79-185ps 좁았고, USB
접촉이 불안정해 그것이 마모인지 리그 상태인지 가를 자(재접속 재현성)를 재지 못한 채 칩을 뺐다. 100k 뒤 newchip 은 **마모
섹터를 품은 첫 128KB 의 소거 교란**을 chip03 에 이어 다시 보였다.

| 가설 | 등록 기준 | 결과 | 판정 |
|---|---|---|---|
| H1′ 100k 안 폭 3σ 안 | 42ps | 25MHz: 사건 전 구간 최대 −59ps(초기 10k), 사건 뒤 구간 −2ps, 사건 경계 +590ps · 75/45MHz 선 복구 뒤 마모 전 대비 −185·−79ps(리그 재현성 미측정) | **25MHz 참** (사후 처리 · 처음 10k 안정화) · **75/45MHz 판정 불가** (§1·§2·§5) |
| H2′ 100k 안 프로그램 7.0ms 불변 | 보이면 깨짐, 시점 기록 | 섹터별 4-12k 에 7.0ms 를 넘음, 100k 에 p50 14.19ms (2.1배) | **거짓** (§3) |
| H3 계단 양자 · H4 전환 순서 · H5 칩 간 산포 | 첫 계단 전환 | 100k 안에 계단 없음 | **chip07 에서 판정 불가** — H3 은 7섹터 미충족으로 센다 (§4) |
| H6 계단이 올 때의 조건 | 계단이 온 섹터 전부 | 계단 없음. 섹터 1k 구간 중앙값 최대 81ms 로 ① 의 84ms 에도 안 닿음 | **판정에서 빠짐** |
| chip07 "100k 안에 계단 없음" (9/27 예측) | 계단이 오면 깨짐 | 105ms 이상 A 행 0건 | **참** (§4) |
| (전제) 대조군 섹터 소거 불변 | 100k 뒤 newchip | 원격 1.00 · 근접 1.06 · 블록 0·1 1.16·1.07 | **원격만 성립** (§6) |

## 1. 폭이 한 번 뛰었다 — 노화가 아니라 계측 사건이다

25MHz 폭은 50k 까지 39,297-39,356ps, 70k 부터 39,897-39,899ps 다(수치 §1). 뛴 것은 한 번이고, 앞뒤로는 판판하다. 노화로
읽지 않는 근거는 다섯 가지다.

- **시각.** 2026-09-28 02:23:55Z 에 USB 가 10초 빠졌다 붙었다. 새벽의 두 끊김(1초 재열거)과 달리 사람 손의 모양이고, 한영웅이
  "선을 건드렸다" 고 확인했다. 50k 스윕과 70k 스윕 사이에 있다
- **원점이 같이 돌았다.** 스윕 원점 회전이 사건 전 8점 모두 −714/−715 스텝, 사건 뒤 4점 모두 −685/−686 스텝이다(수치 §2).
  체크포인트마다 FPGA 를 다시 프로그래밍해도 사건 전에는 원점이 안 움직였으므로, 바뀐 것은 비트스트림 밖의 물리 경로다.
  비트스트림·ELF 는 9/24 이후 바뀌지 않았다
- **버스트성이 나빠졌다.** F 는 사건 전 0.46 으로 고정이었고 사건 뒤 1.06-2.77 로 올라 세 번 기준(2.0)을 넘었다. 에러가 읽기
  사이에 몰린다는 뜻이고, 접촉이 흔들릴 때의 서명이다
- **에러 구간의 모양이 바뀌었다.** 사건 전 에러 구간은 약 0.7ns 폭에 BER 0.25 고원이 있었고, 사건 뒤는 약 0.1ns 에 고원이
  없다(짝 그림). 셀이 늙어 접근 시간이 늘면 에러 구간이 넓어져야 하는데 반대로 좁아졌다
- **클럭마다 방향이 다르다.** 마모 전 → 100k 로 25MHz 는 +541ps, 45MHz 는 −112ps, 75MHz 는 −788ps 다(수치 §3). 셀 쪽이 느려지는
  노화라면 방향이 한쪽이어야 한다. chip03 은 세 클럭 모두 1σ 안이었다

남은 모름: 건드린 선이 USB 인지 SPI 점퍼·핀헤더인지 확인하지 못했고, 선을 다시 눌러 사건 전 상태(−714 스텝 · F 0.46)로
돌아오는지도 아직 시험하지 않았다.

## 2. H1′ — 25MHz 는 구간을 나눠 참, 75·45MHz 는 판정 불가

**사후 처리.** 등록 기준 "체크포인트 100 대비 3σ(42ps)" 는 100 에서 100k 까지 이어진 한 선을 전제한다. 선 접촉 사고가 그 선을
끊었으므로 사건 전(100-50k)과 사건 뒤(70k-100k)를 **각자의 첫 점과** 비교한다. 사고로 생긴 불연속이라 이렇게 판정하기로 했고,
데이터를 본 뒤 정한 방식이라 사후 처리로 표시한다 (2026-09-29, 한영웅 · 로그 48 [U48-9]).

**사건 뒤 구간.** 70k 대비 90k −2.4 · 100k −2.3ps. 기준 안이다.

**사건 전 구간.** 체크포인트 100 대비 1k −15 · 3k −42 · 10k-50k −47 에서 −59ps 다. 숫자로는 3k 부터 기준을 최대 17ps 넘는다.
이 내려감은 **장착 뒤 안정화**로 판단한다. 10k 이후는 39,297-39,309ps 로 13ps 안이다. 근거는 넷이다.

- 10k 뒤로 40k 동안 다시 움직이지 않았다 — 노화라면 마모가 쌓이는 동안 계속 흘러야 한다
- 10k 는 약 1.4시간이다(사이클 약 0.5초). 장착하고 연속 P/E 로 데우기 시작한 뒤 열·접점이 평형을 찾는 시간 규모다
- chip07 은 접점에 민감한 개체다 — 9/20 신품 측정과 9/27 장착 사이에 이미 −440ps, 9/28 선 접촉 한 번에 +590ps 가 움직였다
- 같은 방식으로 장착한 chip03 은 100k 까지 +3.6ps 였다 — 리그 전체가 아니라 이 칩·이 장착의 현상이다

결과를 본 뒤의 판단이므로 기준 초과라는 숫자는 수치 문서와 이 절에 그대로 둔다.

**75·45MHz 는 판정 불가.** 9/29 까지는 마모 전(사건 전)과 100k(사건 뒤)만 있어 마모와 사건을 가를 수 없었다. 9/30 에 선을 되돌려
다시 쟀지만 판정이 서지 않았다 — §5.

## 3. H2′ 는 두 번째로 깨졌다 — 프로그램이 chip03 보다 일찍, 두 배로

섹터별 1k 구간 중앙값이 처음 7.0ms 를 넘은 곳은 섹터 5·6 이 4-5k, 섹터 0 이 11-12k 다(수치 §5). 100k 에 칩 p50 은 6.72 →
14.19ms(2.1배)로 chip03(6.84 → 8.60ms, +26%)보다 훨씬 크다. 신품 소거는 chip07(47.0ms)이 chip03(51.1ms)보다 조금 빠른데
프로그램은 훨씬 빨리 늙었다 — 같은 느린 무리 안에서도 프로그램 축의 산포가 크다.

**섹터 순서가 있다.** 7.0ms 를 넘는 순서가 섹터 5·6 → 3·4 → 2 → 1 → 0 이고, 39-40k 에서도 섹터 0 이 9.32ms 로 가장 낮고
섹터 5 가 10.80ms 로 가장 높다. chip01 은 섹터 0 → 6 으로 **내려가는** 순서 기울기였고, chip03 은 7섹터가 함께 올랐다.
chip07 은 번호가 큰 섹터가 먼저 가는 **반대 방향** 기울기에 가깝다. 100k 에서는 14.15-14.93ms 로 다시 모인다. [U48-6] 의
"열인가 소거 직후 과도인가" 는 이제 칩마다 방향이 다른 기울기를 설명해야 한다.

**보고서 문장**: "프로그램 시간이 100k 안에 움직이지 않는다는 사전 예측은 느린 무리 두 칩에서 모두 깨졌다. chip07 은 5k
안에 움직여 100k 에 두 배가 됐다."

## 4. 소거는 완만했고 계단은 없었다 — 예측이 맞았다

칩 p50 은 체크포인트 100 의 49.4ms 에서 100k 의 74.1ms 로 1.5배, 신품 47.0ms 대비 1.58배다. 99-100k 섹터 중앙값은 72-81ms 로
chip03(88-93ms)보다 낮다. 105ms 이상 A 행은 62만 행 중 0건, 95ms 초과도 0건이다(수치 §4). chip03 은 100k 에 H6 ① 의 출발
수준(84ms 이상)에 닿았지만 chip07 은 거기에도 못 갔다.

A 행 공백 두 곳(52,671-60,000 · 76,170-80,000)이 계단을 가렸을 가능성은 없다. 계단은 착지한 뒤 그 수준(chip01 약 110ms)에
머무는데, 공백 직후 구간의 섹터 중앙값이 67-77ms · 70-77ms 로 공백 직전과 이어진다.

그래서 9/27 에 chip07 을 고르며 적은 예측 "chip07 은 chip03 처럼 100k 안에 계단이 없다" 는 **참**이다. 대가도 그대로 왔다 —
H3-H6 은 이제 계단이 있을 만한 종단 칩 chip04 에만 걸려 있다. H3 의 "21섹터 전부" 에 chip07 의 7섹터는 미충족으로 센다.

## 5. 선을 되돌리자 경로는 돌아왔고, 폭은 세 클럭 모두 좁았다

9/30 에 칩은 그대로 두고 선(SPI 점퍼·핀헤더·USB)을 다시 누른 뒤 25·75·45MHz 를 쟀다(수치 §3). 스윕 원점 회전이 세 클럭 모두
마모 전 값으로 돌아왔고(−714 → −713 · 105 → 104 · 693 → 689) F 도 0.46 이다. 선 접촉이 만든 상태에서는 빠져나왔고, 9/28 의
계단이 노화가 아니라 선이었다는 판단(§1)이 이것으로 확인됐다.

그런데 폭은 마모 전보다 25MHz −147 · 75MHz −185 · 45MHz −79ps 로 **세 클럭 모두 좁고, 방향이 같다.** 선 접촉 뒤(§1)에는
방향이 제각각이었다. 셋 다 42ps 를 넘는다. 두 읽기가 남는다.

- **마모**: 방향이 한쪽이고, 접근 시간 여유가 가장 작은 75MHz 가 가장 크다
- **리그 상태**: 크기가 클럭 순서가 아니다(75 > 25 > 45) — 접근 시간이 늘었다면 폭은 클럭과 무관하게 비슷한 ps 만큼 줄어야
  한다. chip03 은 100k 동안 세 클럭 모두 1σ 안이었다. 그리고 이날 **USB 접촉이 불안정했다**(한영웅 관찰).
  보드가 USB 에서 전원을 받으면 공급 전압이 흔들리고 FPGA·플래시의 타이밍이 함께 움직인다. chip07 은 세션 사이에 −440ps 가
  움직인 적 있는 접점 민감 개체이기도 하다

둘을 가르려면 재접속을 사이에 둔 반복으로 이 리그의 자를 재야 했는데, 재지 않고 newchip 뒤 칩을 뺐다. 같은 상태 안의 반복은
1.4ps(복구 뒤 스윕과 newchip 직후 스윕)로 좋지만, 그것은 재접속의 흔들림을 재지 않는다. 그래서 **75·45MHz 는 판정 불가**로
적는다. 25MHz 도 이 값은 판정에 넣지 않는다 — 사후 처리 판정(§2)은 사건 전·사건 뒤 두 구간 안의 비교이고, 9/30 값은 세 번째
접점 상태다.

## 6. 100k 뒤 newchip — 128KB 교란은 다시 나왔고, prep 프로그램 시간은 눈금이 달랐다

**128KB 소거 교란** (수치 §7). 마모 섹터 1.58, 근접 대조군 1.06, 64KB 블록 0 1.16 · 블록 1
1.07 이고 블록 2 에서 1.00 으로 끊긴다. 원격 대조군은 1.00 이다. chip03(1.08-1.11, 블록 2 에서 0.98)과 같은 모양이다 — 교란의
범위가 첫 128KB 라는 것은 칩을 바꿔도 재현된다. prep 소거(75.7ms)와 99-100k 마모 루프 소거(72-81ms)도 chip03 처럼 같은 눈금이다.

**prep 프로그램 시간은 A 행과 같은 눈금이 아니다** (수치 §8). 이번 newchip 은 섹터별 프로그램 시간을 내는 새 prep 의 첫
확인 런이었다. 안 닳은 섹터는 prep(PRBS) 6.73ms 와 A 행 초기(0x00) 6.74ms 가 같지만, 닳은 섹터 0-6 은 prep 7.62-7.89ms 대 A 행
14.15-14.93ms 로 약 0.53배다. 패턴 차이(프로그램할 비트 수)는 **마모된 셀에서만** 벌어진다. prep 프로그램 시간도 닳은 섹터와
안 닳은 섹터를 깔끔히 가르므로(7.62-7.89 대 6.69-6.79) 블라인드 지표로 쓸 수는 있지만, A 행 교정 곡선에 그대로 대면 안 되고
따로 교정해야 한다. 근접 대조군의 프로그램 시간은 6.75ms 로, 소거 교란이 프로그램에는 거의 번지지 않았다.

## 7. 두 번 끊겼고, 두 번 다 엔진은 끝까지 갔다

60k·80k 체크포인트가 비었다(수치 §6). 두 번 다 새벽 USB 재열거로 호스트만 죽었고 엔진은 tally 두 벌을 맞춘 채 구간을
끝냈다. 결측의 비용은 작다 — 25MHz 폭은 어차피 사건 전후로 나뉘어 70k 이후 점이 셋 남았고, 소거 시간 곡선은 A 행이 두 공백을
빼고 다 있다. 이 경험으로 실행기가 끊겨도 버티고, 놓친 체크포인트는 재개 때 먼저 재도록 고쳤다(로그 48 §18, 다음 칩 런부터 적용).

## 8. 세 칩을 나란히 놓으면

| | chip01 (파일럿) | chip03 | chip07 |
|---|---|---|---|
| 신품 소거 | 28.7ms (빠른 무리) | 51.1ms (느린 무리) | 47.0ms (느린 무리) |
| 100k 소거 (99-100k 섹터 중앙값) | 약 114ms (4배) | 88-93ms (1.7배) | 72-81ms (1.5-1.7배) |
| 계단 | 34-62k 에 7섹터 전부, 착지 약 110ms | 없음 (출발 수준 도달) | 없음 (출발 수준 미도달) |
| 프로그램 첫 움직임 | 약 145k, 섹터 0 먼저 | 약 20k, 7섹터 함께 | 4-12k, 섹터 5·6 먼저 |
| 100k 프로그램 p50 | 7.0ms 그대로 | 8.60ms (+26%) | 14.19ms (2.1배) |
| 25MHz 폭 | 불변 | 불변 | 불변 (사후 처리 — 계측 사건 전후 구간별) · 75/45MHz 판정 불가 |
| 근접 대조군 소거 (100k 뒤) | — | 1.11 (128KB 교란) | 1.06 (128KB 교란) |

느린 무리 두 칩은 소거가 완만하고 계단이 없다는 점에서 같고, 프로그램이 오르는 시점과 크기는 크게 다르다. 소거 한 축으로는
세 칩이 한 곡선에 놓이지 않고, 프로그램 축을 더해도 느린 무리 안의 산포가 크다. 두 축 역산을 할지는 chip04 까지 본 뒤
정한다는 방침(로그 48 §15)은 그대로다.

## 9. chip07 에서 닫힌 것과 넘어간 것

- **닫힘**: "chip07 도 100k 안에 계단 없음" 예측 참 · H2′ 거짓(두 번째) · H1′ 25MHz 참(사후 처리, [U48-9]) · H1′ 75/45MHz 판정 불가 ·
  128KB 소거 교란 재현 · prep 프로그램 시간은 A 행과 눈금이 다름 · 장부 100,000(정정 행 두 줄 포함) + newchip +1
- **넘어감**: H3-H6 판정(chip04) · 두 축 역산 여부 · 프로그램 섹터 순서 기울기의 원인([U48-6])
- **chip07 의 다음**: 측정 끝. 섹터 0-127 이 9/30 newchip PRBS 로 써진 상태로 소켓에서 빼 보관
- **리그에 남긴 숙제**: 다음 칩 런 전에 보드 전원을 USB 에서 외부 5V 로 바꾸고, 재접속을 사이에 둔 반복으로 리그 재현성을 잰다
