young-0320/flash-margin-bench/docs/results/wear_pilot_chip01.md

# P/E 파일럿 결과 해석 — chip01, 0 → 300,000 사이클

- **작성일**: 2026-09-26 · **측정**: 2026-09-22 - 09-26 (보드 A)
- **수치**: [`data/wear/wear_pilot_chip01_2026-09.md`](data/wear/wear_pilot_chip01_2026-09.md) (+ 동명 CSV) — 이 문서는 표를 다시 싣지 않고 거기를 인용한다
- **사전 등록**: `docs/spec/s1.wear_bench_spec.md` §15 (H1·H2 는 29.6k 시점, H3-H5 는 파일럿 종료일)
- **경위**: `docs/log/young/48.pilot_wear_handler_and_plan_approval.md` §8-§14

## 결론

**정격 내구(10만 회)의 3배까지, 이 벤치의 정밀도로 SPI 타이밍 마진은 움직이지 않았고 소거 시간이 노화를 보였다.**
chip01 의 측정 국면은 여기서 닫는다. 칩은 300k PRBS 가 써진 채 보관되며 고온 유지 시험(베이크, HTDR — JESD22-A117) 시료가 된다.

| 가설 | 등록 기준 | 결과 | 판정 |
|---|---|---|---|
| H1 25MHz 마진 불변 | 측정 불능(기준 1)까지 3σ(42ps) 안 | 신품 대비 +15.5ps, BER 바닥 0 | **참** |
| H2 소거 시간 단조 증가 | — | p50 28.7 → 148ms (5.2배) | **참** |
| (등록 밖) 75·45MHz 에서도 불변 | — | 75MHz 신품 대비 +2.6ps, 두 클럭 모두 바닥 0 | **관측상 불변, 비교는 약함** (§2) |

## 1. 폭은 좁아지지 않았다 — 다만 수 ps 의 기울기가 있다

등록 기준(재장착 σ 13.86ps 의 3배)으로 H1 은 넉넉히 참이다. 그런데 +15.5ps 를 뜯어 보면 두 조각이다.

- **0 → 100 이 +8.8ps.** x=0 은 newchip prep, 100 부터는 범위 prep ELF 로 prep 경로가 다르다. 같은 날 4분 뒤
  2차 newchip 이 +2.5ps 였으므로, 이 한 칸은 마모보다 경로 차이일 가능성이 크다([U48-5] 가 이 점의 오차 막대를 묻는다)
- **100 → 300k 가 +6.7ps, 거의 단조.** 파일럿은 재장착 없이 연속으로 쟀으므로, 제대로 된 자는 재장착 σ 가 아니라
  재장착 없는 반복 σ(0.61ps)다. 그 자로 보면 작지 않다. 그러나 방향은 **넓어지는 쪽**이라 "마모로 마진이 준다"
  와 반대다. 8/23 D 트랙에서도 6주 사이 같은 방향으로 +4.35ps 가 나왔다(로그 22). 드리프트 앵커 chip02 가 조립체
  고장이라 리그 드리프트와 가를 수 없다

**보고서 문장**: "폭은 좁아지지 않았다(재장착 σ 기준 1σ 안). 넓어지는 방향으로 수 ps 의 기울기가 있으나 리그
드리프트와 분리되지 않는다." 경계가 붙은 부정 결과로 쓰고, 기울기를 숨기지 않는다.

**왜 안 움직이나(구조).** 출력 엣지는 클럭에 맞춰 도는 출력 레지스터가 낸다. 셀 열화로 길어지는 어레이 접근 시간은
25MHz 의 40ns 주기 안에서 여유가 커서 엣지에 닿지 못한다(S-1 §15). 반면 소거 시간은 소거 검증 루프가 산화막에
갇힌 전하를 그대로 반영한다.

## 2. 클럭을 올려도 같았다 — 75·45MHz

75MHz 는 주기가 1/3 이라 접근 시간 여유가 가장 작다. S-1 §15 가 "H1 을 더 세게 시험한다" 고 적고 채택을 미뤘던
조건이다. 300k 에서 12,185.7ps 로, 9/16 신품값 12,183.1ps 와 +2.6ps(한 스텝 15.9ps 안) 차이다.

**그러나 비교가 약하다.** 신품값은 보드 B 에서 한 번 잰 값이고, 25MHz 에서 두 리그가 약 44ps 까지 어긋났다.
+2.6ps 가 이만큼 작은 데는 우연도 섞였을 수 있다. 7/08 보드 A 값(12,205.3ps)과는 −19.6ps 인데, 빌드 세대
(2024.2 → 2025.2)와 분리되지 않는다. 45MHz 는 신품값이 어디에도 없다. "UI − width" 가 25 → 45 → 75MHz 에서
325 → 430 → 1,148ps 로 자연스럽게 커지는 것까지가 말할 수 있는 전부다.

**메우는 방법**: 종단 칩을 마모 전에 보드 A 에서 75·45MHz 로 한 번씩 재고(P/E 0) 100k 에서 다시 잰다. 같은 칩·같은
리그 비교가 되어 이 절의 "약함" 을 걷어낸다.

## 3. 소거 시간은 섹터마다 계단으로 올랐다

칩 전체 p50 은 매끈하게 오르는 것처럼 보이지만 섹터로 쪼개면 모양이 다르다(수치 §3). 섹터마다 약 90ms 대에서
약 110ms 대로 한 번에 뛰는 전환이 있고, 그 시점이 섹터별로 다르다.

- 신품에 가장 느렸던 **섹터 3 이 가장 먼저(약 34k)** 뛰었고, 나머지는 50-72k 사이다
- 전환 근처에서는 두 값 사이를 오간다(섹터 2 의 59-70k 가 90 → 112ms 사이를 오감)
- 칩 p50 의 매끈함은 섹터마다 다른 전환 시점이 섞여 뭉개진 모양이다
- **계단 높이는 재는 법에 따라 17-22ms 다.** 칩 p50 의 58k 도약은 92.1 → 109.5ms(17.4ms)이고, 섹터마다 전환 구간의 A 행을
  100ms 로 갈라 두 수준의 중앙값을 내면 약 89-90ms 와 약 110ms, 차이 19.7-22.0ms 다(섹터 3 이 22.0 으로 가장 크다)

이 관측을 종단 데이터를 보기 전에 세 가설로 S-1 §15 에 등록했다 — **H3** 계단의 높이는 양자화돼 있다, **H4** 신품에
느린 섹터가 먼저 뛴다, **H5** 칩 간 산포. 계단 시점·높이는 아직 1k 구간 중앙값에서 읽은 잠정값이고, 판정은 계단
검출 스크립트(할 일 10)로 종단 3칩과 함께 낸다.

**끝자락.** 294.5k → 300k 한 구간(5,500 사이클)에 칩 p50 이 131 → 148ms 로 뛰었고, 섹터 5 가 177ms 로 가장 크다.
두 번째 계단의 후보이지만 이 역시 스크립트의 판정 대상이다.

## 4. 프로그램 시간은 늦게, 섹터 순서대로 벌어졌다

137k 까지 섹터 7개 모두 7.0ms 로 평평했다. 섹터 0 이 약 145k 부터 서서히 오르기 시작해(1k 구간 중앙값 7.1ms, 200k 에 8.0ms) 300k 에서는 섹터 0 이 16.8ms, 섹터 6 이 7.1ms 로
섹터 0 → 6 순으로 단조 감소한다(수치 §4). 엔진은 7섹터를 소거한 직후 섹터 0 부터 프로그램하므로, 위치보다
**소거 뒤 경과 시간**의 효과로 보인다. 137k 까지 없던 것이 생겼으니 마모에 비례한다.

후보는 둘이다 — 열(소거 묶음의 자기 발열이 핫 일렉트론 효율을 깎음)과 소거 직후 과도(트랩 전하 이완). [U48-6] 으로
열려 있으며, 종단 칩의 A 행에서 100k 안에 같은 기울기가 보이는지가 먼저다.

## 5. 이 결과가 보고서에서 하는 일

- "소거 시간이 는다" 는 상식이다. 이 파일럿이 더하는 것은 두 가지다. ① **경계가 붙은 부정** — 13.86ps 의 계측기로
  정격 3배까지 폭이 1σ 안이었다. H1 이 29.6k 시점에 적혀 있었다는 것이 사후 해석이 아니라는 근거다
  ② **방법의 출발점** — 소거 시간 하나로 P/E 이력을 역산하는 모델(S-1 §15 두 층 역산)의 첫 곡선이다
- 쓰지 않는 문장: "제조사 사양이 보수적이다". 사양은 온도·전압·모집단 ppm·**유지 20년**을 보증하는 최소치이고,
  우리 검사는 전부 즉시 판독이다. 유지는 평가하지 않았다

## 6. chip01 에서 닫힌 것과 넘어간 것

- **닫힘**: H1(25MHz) · H2 · 체크포인트 측정 경로([U48-3]) · 300k 의 25/45/75MHz 스냅샷 · 장부 300,000
- **종단 칩으로 넘어감**: 75·45MHz 신품 기준선 · H3-H5 판정 · [U48-5] x=0 오차 막대 · [U48-6]
- **chip01 에 남음**: 고온 유지 시험(히터 도착 뒤, [D48-17]). 가열 뒤 `--mode sweep`(P/E 0)으로 같은 PRBS 를
  다시 읽어 비교한다. 그러므로 **고온 유지 시험 전에 chip01 에 prep·newchip 을 돌리지 않는다** — 돌리면 300k 의 PRBS 가
  새로 써져 비교 기준이 사라진다
