young-0320/flash-margin-bench/docs/workflow/7.realchip_uid_verification_day.md

# 7. 실칩 검증일 — 새 래퍼로 chip01 UID 확보 + 재장착 σ (W5-D 마무리)

- **작성일**: 2026-09-14
- **실행일**: 2026-09-15 (예정)
- **용도**: 9/7\~9/8에 만든 실칩 스윕 래퍼(`host/run/run_sweep_chip.py`)를 **실제 보드에서
  처음 돌리는 날**의 순서표. 로그 24 미결 1·§8(검토 수정) · 로그 22 미결 1·5 · 수정안
  #3 인수 기준 A4가 전부 이 하루에 걸려 있다.
- **원전**: 배선·고장 판독은 런북 3(`3.realchip_day_runbook.md` D0·표 E), 판정 기준은
  워크플로 5 D 트랙(`5.newchip_baseline_and_wear_bench.md` §D), 파일 규칙은 수정안 #3
  (`docs/interface/amendments/3.uid_pipeline.md`). 충돌 시 원전 우선.
- **런북 3 D3의 `--target chip01` 명령은 이 문서로 대체된다.** 캡처를 사람이 직접 띄우지
  않고 래퍼 한 줄이 prep → UID → 등록부 → 스윕을 잇는다 (로그 23).

## 내일 뭘 하는 건가

지난주에 스크립트를 세 개 새로 만들었다. ① 칩의 **고유 번호(UID)** 를 읽는 펌웨어,
② 그 번호로 **등록부에서 칩 이름을 찾아** CSV 파일 이름과 열에 박아 주는 캡처,
③ 이 둘을 **터미널 하나에서 이어 돌리는 래퍼**. 셋 다 가짜 시리얼로만 시험했고
실제 보드에서는 한 번도 안 돌렸다.

내일은 chip01을 꽂고 래퍼를 돌려서 세 가지를 확인한다.

1. **UID가 실제로 읽히는가** — `#PREP UID <16자리>` 줄이 찍히는가
2. **세 곳이 같은 UID를 말하는가** — 세션 로그 · CSV 파일명 · 등록부 chip01 행
3. **칩을 뺐다 꽂으면 폭이 얼마나 흔들리는가** — 3번 재장착해서 표준편차(σ)를 낸다

3번이 나와야 8/23에 미뤄 둔 "장비가 6주 동안 틀어졌나" 판정(W5-D)을 내릴 수 있고,
그 판정이 나야 신품 10개 전수 측정(W5-M)을 시작할 수 있다.

**내일 하지 않는 것**: N=112 스윕(빌드 스크립트에 아직 N 치환이 없다 — 로그 24 미결 2.
내일은 N=100만 된다), 신품 전수 측정, 마모.

---

## 0. 전날 준비 — 보드 없이 (2026-09-14 완료분 포함)

| # | 할 일 | 상태 | 확인 방법 |
| --- | --- | --- | --- |
| 0-1 | **`flash_prep.elf` 재빌드** | **완료 9/14 23:00 (2025.2)** | 로그 24 §8 수정(9/8 00:18, UID 재시도 루프)은 워크트리 브랜치에서 빌드돼**main의 `build/`에는 수정 전 ELF(9/7 23:53)가 남아 있었다.** 21:17에 2024.2로 재빌드했고, 그 뒤 워크플로 8이 `build/` 전체를 2025.2로 다시 빌드했다(로그 27 §3). 소스는 같다 |
| 0-2 | 셀프테스트 4종 | **PASS 9/14** | `bathtub_analysis` · `chip_registry` · `chip_pe` · `run_sweep_chip --help` |
| 0-3 | 등록부 chip01 행 자리표시 문구에 UID가 들어가는가 | **확인 9/14** | 사본에`register("chip01", …)` → `*(D 트랙에서 확보)*`가 UID로 바뀌고 다른 칸 무변경 |
| 0-4 | `git status` 깨끗한가 | 당일 아침 | 실행 후 diff가 등록부 1행 + chip_pe 1행뿐이어야 하므로 시작점이 깨끗해야 한다 |
| 0-5 | 비트스트림·ELF 존재 | 있음 (**2025.2 빌드**) | `build/vivado_g3_25/g3_chip_25.runs/impl_1/g3_wrapper.bit` · `build/vitis_g3_25/g3_sweep/build/g3_sweep.elf` — 둘 다 9/14 23:0x, Vivado 2025.2(워크플로 8 B). **7·8월 곡선은 2024.2 비트스트림**이었다 — §6 주의. 2024.2 산출물(`build_2024.2/`)은 2026-09-21 삭제했다 — 전량 재생성 가능하고 pl4/pl6는 한 번도 안 쓰였다. 보험 비트가 필요하면 굽는다 (`build_g3_chip.tcl -tclargs bit 25 <k>`) |

## 1. 보드 — 배선과 환경 (약 10분)

```
1-1. 칩:   별도 보관된 chip01 을 소켓에 꽂는다 (다른 칩 아님 — 7월 데이터의 원본 개체)
1-2. 배선: 런북 3 D0 표 그대로. 색 관례 — VCC 빨강 · GND 검정 · CS 파랑 · DI 초록 · DO 노랑 · CLK 주황
           순서: 전원 2가닥 먼저 → 3.3V 확인 → 신호 4가닥
1-3. 보드: USB(JTAG+UART) 연결, JP5=JTAG, 전원 ON
1-4. 포트: ls /dev/ttyUSB*      → /dev/ttyUSB1 (다르면 --port 로 지정)
           miniterm 이 떠 있으면 닫는다 — 같은 포트라 래퍼와 동시 사용 불가
1-5. 환경: which xsct             → ~/Xilinx/2025.2/Vitis/... 이어야 한다 (.bashrc 가 2025.2 를 source 한다, 로그 27)
           안 나오면: source ~/Xilinx/2025.2/Vitis/settings64.sh   (2024.2 를 같은 셸에 섞지 않는다)
1-6. 시작점: git status           → 깨끗해야 한다
```

## 2. 1차 실행 — 흐름 확인 + UID 확보 (약 7분)

```
.venv/bin/python host/run/run_sweep_chip.py --mode newchip --mhz 25
```

화면에 이 순서로 나온다. 어긋나는 지점이 있으면 그 지점이 곧 진단이다.

| 순서 | 화면 | 뜻 | 걸리는 시간 |
| ---- | --- | --- | --- |
| ① | `batch <stamp>: mhz=25 pl=None repeat=1 …` | 세션 로그`build/data/session_<stamp>.log` 생성 | 즉시 |
| ② | `세션1 프로그래밍 (g2_jedec + flash_prep): xsct …` | 비트스트림 + prep ELF 굽는 중 | \~30초 |
| ③ | `#PREP JEDEC ef 40 17 …` | 칩과 통신 성립 | |
| ④ | **`#PREP UID XXXXXXXXXXXXXXXX`** | **오늘의 핵심 한 줄.** 대문자 16 hex | |
| ⑤ | `#PREP BEGIN` → (침묵) → `#PREP PASS all 2048 pages verified` | 지우기·쓰기·검증. 침묵 정상 | \~1분 |
| ⑥ | `신규 UID …. 등록부의 UID 공란 라벨: chip01 chip02 … chip10`  `이 칩의 라벨 (chipNN):` | **사람이 입력하는 유일한 지점.** `chip01` 입력. 오타면 다시 묻는다 | |
| ⑦ | `등록부 기입: chip01 ← …`  `chip_pe.md: chip01 0~127 +1` | 등록부·P/E 이력에 기계가 썼다 | |
| ⑧ | `[1/1] 세션2 프로그래밍 (g3_chip_25): xsct …` | 스윕 비트스트림 굽는 중 | \~30초 |
| ⑨ | `#G0 SWEEP BEGIN … n=100 …` → 2,520스텝 → `SWEEP END valid=1 reason=complete` | 스윕 | \~5분 |
| ⑩ | `[1/1] VALID sweep_chip01_<UID>_<stamp>.csv (2520 rows)`  `1/1 완료 (invalid 0)` | exit 0 | |

**④에서 `#PREP FAIL uid transfer` / `uid mismatch`** 가 나오면 래퍼가 멈춘다 — 배선(DO 노랑)
확인 후 재실행. **⑤ 없이 15분 침묵**이면 래퍼가 타임아웃으로 중단한다 — 표 E.

## 3. 세 곳 대조 — 수정안 #3 인수 기준 A4 (약 3분)

한 UID가 네 곳에 있어야 하고 전부 같아야 한다.

```
3-1. 세션 로그:  grep "#PREP UID" build/data/session_chip01_*.log
3-2. 파일명:     ls build/data/sweep_chip01_*_*.csv         → sweep_chip01_<UID>_<stamp>.csv
3-3. CSV 열:     head -2 build/data/sweep_chip01_<UID>_<stamp>.csv   → uid 열에 같은 값
3-4. 등록부:     git diff docs/chip_registry.md docs/chip_pe.md
                 → 등록부 chip01 행의 "*(D 트랙에서 확보)*" 가 UID 로 바뀐 것 1행
                 → chip_pe.md 끝에 "2026-09-15 | chip01 | <UID> | 0~127 | +1 | flash_prep (batch …)" 1행
                 → 그 외 변경 없음
```

넷이 같으면 A4 통과. **하나라도 다르면 손대지 말고** 세션 로그와 함께 그대로 기록한다 —
어느 층이 틀렸는지가 다음 수정의 근거다.

## 4. 1차 분석 — 곡선이 맞는가 (약 1분)

```
.venv/bin/python host/analysis/bathtub_analysis.py build/data/sweep_chip01_<UID>_<stamp>.csv
```

| 결과 | 뜻 | 다음 |
| --- | --- | --- |
| R8 통과, width@1e-2 ≈ 39,74x ps | 정상. 8/23은 39,741.65 | §5로 |
| 전 위상 BER ≈ 0.5, valid=1 | PAY_LEAD 어긋남 (칩 문제 아님) | 미리 구운 보험 비트는 없다 — `build_g3_chip.tcl -tclargs bit 25 4` (\~5분) 후 `run_sweep_chip.py --mhz 25 --pl 4 --no-prep --uid <UID>`. 보험 비트로 찍은 것은 세션 로그에 적는다 |
| 전 위상 BER ≈ 0.51 | 사전 쓰기 안 됨 | prep 로그 재확인. 표 E |
| 전구간 0 | 25MHz에서 벽이 안 보임 | 7·8월과 같은 보드에서 있을 수 없는 결과 — 배선 재확인 |

## 5. 2차 실행 — 재장착 σ (약 25분)

**시작 전에 칩을 한 번 빼서 다시 꽂는다.** 그래야 3회가 전부 1차와 다른 장착이 된다.

```
.venv/bin/python host/run/run_sweep_chip.py --mode sweep --chip chipNN --mhz 25 --repeat 3 --reseat
```

- 2·3회차 앞에서 `[k/3] chip01 을 빼고 다시 꽂은 뒤 엔터:` 가 뜬다. **뺐다 꽂고** 엔터.
- 세 파일은 같은 `batch_id`, `reseat=1`, `repeat_idx=1·2·3` 열을 갖는다 (수정안 #3 §2.2).
- 이번엔 ⑥이 안 뜬다 — 등록부에 chip01이 있으므로 `등록부: <UID> → chip01` 로 자동 통과.
  **이것이 등록 칩 경로의 첫 실측**이다 (1차는 신규 칩 경로).
- prep을 또 돌리는 이유: 사전 쓰기는 비휘발이라 `--no-prep --uid <UID>` 로 건너뛸 수 있지만,
  그 경로는 기계가 UID를 다시 확인하지 않는다(로그 24 미결 6). 1분과 P/E +1을 내고 기계
  확인 경로를 한 번 더 지나는 쪽이 오늘의 목적(래퍼 검증)에 맞다. chip_pe.md에 +1이 자동으로
  한 줄 더 붙는다 — 정상.

집계:

```
세 CSV 각각 bathtub_analysis.py → width@1e-2 세 값 → 평균 · 표준편차(자유도 2) = σ_reseat
```

## 6. W5-D 판정 — 8/23에 미룬 것을 닫는다

워크플로 5 D5의 자는 "재장착 없음" σ=0.61ps였고, 8/23 값(+4.35ps)은 재장착이 들어 있어
그 자로 잴 수 없었다(로그 22 §3). 오늘 σ_reseat이 나오면 자가 생긴다.

```
|평균(2차 3회) − 39,737.3|  ≤  3 × σ_reseat   →  드리프트 없음. W5-M 착수 (S-2 게이팅 G-a 해제)
                             >  3 × σ_reseat   →  장비 드리프트 의심. W5-M 보류, 원인 조사
```

**빌드 세대 주의.** 7월 기준값은 Vivado 2024.2 비트스트림, 오늘 값은 2025.2 비트스트림이다.
재기준선 A/B는 생략하기로 했다(로그 27 추기 — 예상 차이 수 ps). 따라서 판정이 **벗어나면**
장비 드리프트인지 빌드 차이인지 이 값만으로는 못 가른다. 그때는 같은 장착 그대로
2024.2 셸로 g3-25 를 재빌드한 뒤 (`~/Xilinx/Vivado/2024.2` 에 설치가 남아 있다, \~5분)
`BUILD_DIR=<그 폴더> … --no-prep --uid <UID>` 로 1회(6분) 더 찍는다 — 차이가 사라지면
빌드, 남으면 장비. 2024.2 산출물은 2026-09-21 삭제했으므로 즉시는 안 된다. RTL·tcl 이
`e229b04` 이후 무변경이라 재빌드본의 소스는 7·8월과 같다.

판정 문장은 **그날 로그에 쓴다** (로그 22 §0의 교훈 — 측정과 기록 사이에 멈추면 데이터가
문서 밖에 남는다). 부수 소득: σ_reseat은 S-2 §8이 M 트랙에서 재려던 값이라 §6.3의 분모로
그대로 쓰인다.

## 7. 마무리 — 원본 보관과 커밋 (약 10분)

```
7-1. 원본 이동 (런북 3 D7): build/data/sweep_chip01_<UID>_*.csv 와 *_reads.csv → data/
     세션 로그 build/data/session_chip01_<UID>_*.log 도 함께 data/ 로 (첫 UID 확보 근거)
7-2. 유래 한 줄: docs/results/data/sweep_chip01_20260708T164931Z.md 에 "UID <UID> (2026-09-15 확보)" 추가
     오늘 데이터의 유래 md 에는 "빌드: Vivado 2025.2" (워크플로 8 R 절의 기록 의무)
     (등록부 §소급 적용 — 7월 파일명은 바꾸지 않는다)
7-3. 커밋: docs/chip_registry.md · docs/chip_pe.md · 유래 md · 당일 로그
     (data/ 는 gitignore — 원본은 로컬 보관 + 별도 백업)
7-4. 당일 로그: docs/log/young/28.*.md (27 은 Vivado 전환 로그) — UID · 3회 폭 · σ_reseat · W5-D 판정 · 어긋난 지점
```

## 8. 잘못됐을 때

- 래퍼가 멈추면 **세션 로그는 이미 디스크에 있다** (`build/data/session_*.log` — 로그 24 §8
  「중요 2」 수정). 지우지 말고 그대로 둔다. `prepfail` 접미가 붙으면 prep 단계 실패.
- 스윕이 `valid=0`이면 파일이 `_invalid`로 남고 배치는 다음 회차로 넘어간다. 3회 중 하나가
  무효면 σ는 자유도 1이 되므로 **1회 추가** (`--no-prep --uid <UID> --repeat 1`, 재장착 후).
- 고장 서명 판독은 런북 3 표 E가 원전. 새 서명이 나오면 표 E에 추가할 후보로 기록.
- 재실행은 항상 래퍼 전체 — ELF만 재로드하면 `phase_pos_mismatch`로 거부된다(의도된 방어).

## 9. 오늘 닫히는 것 / 안 닫히는 것

| 닫힘 | 근거 |
| --- | --- |
| 로그 24 미결 1 (실칩 1회 미실시) | §2 |
| 수정안#3 인수 기준 A4 | §3 |
| ~~로그 22 미결 5 · S-2 G-c (UID 확보)~~ | **닫힘** — 9/15 chip02·chip03, 9/16 chip01(`D1654CB09B352233`, 지민)·chip04·chip06 이 등록부에 들어갔다. G-c 는 능력 게이트다 |
| ~~로그 22 미결 1 (재장착 σ) → W5-D 판정~~ | **안 닫혔다** — 그날 chip01 이 팀원에게 가 있어 §5·§6 이 실행되지 않았다. 칩은 9/16 회수됐고(워크플로 10 W10-A) 재장착 3~5회는 아직 미실시. 2026-09-18 로그 28 `[U28-1]` 로 옮겼다 |
| 로그 22 미결 2 (루프백 점퍼 가설) | 실칩만 돌리므로**안 닫힘** — 루프백 1회는 별도 |

| 안 닫힘 | 왜 |
| --- | --- |
| ~~수정안#2 §7 D 2단계 (N=112 스윕)~~ | **철회 2026-09-18** — 빌드 N 치환은 로그 29 가 넣어 막힘이 풀렸으나, 그 사이 전환이 2단계 없이 일어났다. 놓을 축이 없어 재지 않는다 — 수정안 #2 §7 부기 |
| 수정안#3 승인 | 박지민·장세은 승인란 공란. 오늘 결과가 승인 근거 자료 |
| ~~로그 24 미결 6 (`--no-prep` 기계 확인 없음)~~ | **닫힘 2026-09-16** — `flash_id`가 세션1에서 UID를 대조한다 (로그 36) |
