young-0320/flash-margin-bench/docs/log/young/52.inverse_v4_measured_not_chosen.md

# 52. 역산 v4 — 고른 값을 잰 값으로, LOCO 는 손잡이가 아니라 채점표

- **작성일**: 2026-10-08
- **발단**: 6장 강의(discriminative 가 기본값)를 복습하다 「우리는 왜 베이즈로 P(x|y) 를 모델링했나」 가 질문으로 섰다(10-07).
  답을 쫓다 보니 모델 계열은 맞는데, 그 안의 상수 넷(정규 셀 · 1/k · R · 검증 방식)이 전부 **결과를 보고 고른 값**이라는 것이 드러났다.
  v4 의 내용을 그 자리에서 정하고 코드까지 넣었다(10-08, 커밋 `aa3048d`). 등록은 원본 A 행이 있는 PC 에서 측정한 뒤다
- **목적**: 생성 모델(GDA 꼴 베이즈 역산)을 고른 것은 합리적이었나, 그 안에서 무엇이 고른 값이고 어떻게 잰 값으로 바꾸나,
  v4 와 v4.1 은 어떤 순서로 만드나?
- **관련**: `docs/spec/s5.lifetime_inverse_model.md` §2 v4 열 · §4 - §9 · `docs/spec/s1.wear_bench_spec.md` §15 2026-10-09 추기 ·
  `docs/results/data/inverse_v4_eval_2026-10.md` · `docs/concepts/15.lifetime_inverse_model.md` ·
  `host/analysis/wear_inverse.py` · `host/analysis/wear_curves.py` · [로그 48](48.pilot_wear_handler_and_plan_approval.md) §22 - §24 · §41 - §45 ·
  [로그 51](51.inverse_model_design_and_blind_procedure.md)

## 결정

- [D52-1] 모델 계열(교정 곡선을 우도로 · 평평한 사전 · 베이즈 사후분포 — GDA 의 혼합·정렬판)은 **유지**한다. 칩 7-8개 체제의 교정 문제에서
  discriminative 는 대안이 아니다 (2026-10-07, 한영웅) — §1
- [D52-2] v4 는 고른 값 다섯을 **잰 값**으로 바꾼다 — ① 셀 분포 정규 → 분위수 21개 ② 증거량 1/k → 상관 ρ_s · ρ_p 의 유효 관측 수 ③ 교정 곡선을
  칩 속도로 정렬 ④ R 을 정렬 뒤 σ_r 에서 유도 ⑤ LOCO 관측을 A 행 그대로 · 합성 복원을 분위수 + 상관으로. **[D48-58] 뒤집음 · [D48-60] 뒤집음 ·
  [D48-94] · [D48-95] 의 R 값 뒤집음** — 등록되면 효력, 그 전까지 현행은 v3.2 (2026-10-08, 한영웅) — §2 - §5 ·
  `host/analysis/wear_inverse.py` `MODELS` · `docs/spec/s5.lifetime_inverse_model.md` §4 - §7
- [D52-3] LOCO 포함률은 **채점표**다. 합격 띠(점 수의 2σ)와 띠 밖일 때의 의심 순서를 돌리기 전에 적고, 결과를 본 뒤 바꾸지 않는다 (2026-10-08, 한영웅) — §5 · S-5 §7
- [D52-4] 순서는 **v4(현 교정) → v4.1(chip06 12k→100k 추가)**. v3.3 은 만들지 않는다. chip14 는 닳게 하지 않는다 — DF 무마모 대조군이고
  `DF` 인 chip10 이 교정 밖이었다 (2026-10-08, 한영웅) — §6 · `docs/chip_registry.md`
  > **2026-10-09 — chip14 는 이미 닳았다 ([로그 48](48.pilot_wear_handler_and_plan_approval.md) §53 [D48-108]).** 지민 묶음으로 100k 까지 닳아 돌아왔고
  > (chip10 모양), 「닳게 하지 않는다」 는 효력이 없다. 교정에 넣을지는 [U48-22]. v4 → v4.1 순서와 v3.3 을 만들지 않는 것은 그대로다
  > **2026-10-12 — v4.1 측정 완료 (§11).** chip06 100k → 9칩 LOCO. chip14 는 JV 로 교정 밖([D53-5]). 등록은 [U52-5]
- [D52-5] 합성 복원은 모델 **고도화의 재료가 아니다**. 보정 점검과 실험 설계(prep 횟수)에만 쓴다 (2026-10-08) — §7
- [D52-6] ρ 에 **칩 효과 ρ_chip** 을 더한다 (n_eff 4항). 칩 안 표의 ρ_s · ρ_p 만으로는 「이 칩이 교정과 다른 몫」이 평균에 묻혀 보이지 않고,
  그 식의 v4 는 95% 가 과신이었다. ρ_chip 은 교정 칩을 하나씩 빼고 나머지 정렬 혼합과 비교한 잔차의 표 간 분산 몫으로 잰다 (2026-10-09, 한영웅) —
  §9 · `host/analysis/wear_inverse.py` `n_eff` · `chip_effect_tables` · S-5 §5
- [D52-7] ρ 셋은 **전체값 하나**로 등록한다. 무리별 ρ_chip(빠른 0.33 · 느린 0.03)은 발견으로만 적고 모수로 두지 않는다 (2026-10-09, 한영웅) — §10
- [D52-8] v4 를 **2026-10-09 등록**한다 — ρ_s 0.00 · ρ_p 0.78 · ρ_chip 0.29, LOCO rows 68% 79.1%(띠 위 · 과소신) · 95% 96.5%(합격). 68% 과소신은
  그대로 적고 등록하며 68 · 95 표시는 유지한다. **[U52-1] 닫음 · [U52-2] 닫음** (2026-10-09, 한영웅) — §10 · S-5 §2 · S-1 §15 추기
- [D52-9] **v4.2(프로그램 축) 폐기** — 구간은 좁아지나 처음 보는 칩에 과신(합성 복원 95% 가 84%). 프로그램이 오르는 양이 칩마다 달라 칩 정체로 읽힌다.
  다음은 v4.3(답 범위 150k+ · chip06 · 09 를 200k 까지) (2026-10-12, 한영웅) — §12

## 근거

### 1. 생성 모델 선택은 맞았다 — 이 문제는 분류가 아니라 교정이다

질문은 Vapnik 의 「더 어려운 문제를 중간 단계로 풀지 마라」 였다. 그 경고의 전제는 P(x|y) 가 경계보다 어렵다는 것인데, 여기서는 반대다.
교정 실험이 원인 x 를 통제하고 결과 e 를 잰 순방향 측정이라 P(e|b) 는 표를 읽는 것이고, 역방향 e → x 는 계단과 다대일(같은 1.7배가
3k 또는 100k)로 모양이 나쁘다. 데이터 체제도 반대다 — 행은 수십만이지만 독립 단위는 칩이라 n 은 한 자리이고, Ng & Jordan(2001)의
결과대로 이 체제에서는 generative 가 먼저 수렴한다. 출력도 라벨이 아니라 「68% 로 25-37k」 라는 분포다.

통계학 용어로는 classical calibration(순방향을 맞추고 뒤집기) 대 inverse calibration(x = g(e) 를 직접 맞추기) 논쟁이고, 잡음이 e 쪽에
있고 x 가 통제된 설계면 **classical 쪽이 일관성**을 가지며 베이즈 역산이 그 현대형이다. 우리 모델은 GDA 와 같은 계열이다 — 클래스 = 1k 구간,
클래스 조건부 = 구성원 혼합, 사전 평평. 쓰지 않은 대안이 logistic regression(GDA 의 discriminative 판)이고, 칩 7개로 100-클래스 LR 의
계수는 추정할 수 없다. 뒤집히는 조건은 교정 칩 수십 개 + 입력 고차원이며 그때 분위수 회귀가 후보다(추정).

### 2. 셀의 정규분포는 데이터가 아니라 표 형식이 강제한 가정이다 — 분위수 21개로

셀 하나에 원본 1,000개가 있는데 p10 · p50 · p90 세 수로 줄이고 종 하나를 씌웠다. 세 수는 곡선 위의 점 셋이고, 점 셋으로는 모수 둘짜리
분포밖에 못 정하니 봉우리 둘(개념 15 §7 의 계단 전환 셀 — chip04 섹터 3 · 26-27k 는 95-110ms 에 0회)은 어떤 세 수를 써도 못 그린다.
정규분포는 거기에 최대 밀도를 준다.

후보와 탈락. ⑴ 무리별 분기 — 빠른 무리는 2-정규 혼합, 느린 무리는 비모수: 방향이 거꾸로다(모양이 복잡한 쪽에 모양 가정) 이고, 계단은 무리
속성이 아니라 셀 속성이라 셀 단위 판정 규칙이 하나 더 생긴다. ⑵ KDE: 대역폭을 골라야 한다. ⑶ 히스토그램: 칸 경계가 ms 에 고정돼 ratio 눈금
(신품값으로 나눔)과 안 맞는다. 채택은 **5% 간격 분위수 21개** — 나누기에 그대로 따라가고(ratio 호환), 해상도가 데이터를 따라가고(빈 곳은 넓은
조각 = 낮은 밀도), 조각당 50개라 추정이 안정적이다. 101개는 조각당 10개라 평활화가 필요해 과하다.

남는 상수 둘은 고르지 않는다 — 조각 폭 하한은 A 행 해상도 1µs, 분위수 밖 밀도는 1/1,001 ÷ 범위(1,001번째 표본의 몫 — add-one).
원본 1,000행은 지금처럼 표를 만들 때 한 번만 읽고, 추론은 표만 본다.

### 3. 「7개 = 증거 1개」 는 재지 않고 고른 극단값이다 — 상관을 재서 유효 관측 수로

[D48-58] 의 1/k 는 섹터 7개를 점수는 따로 매기되 합을 7 로 나눈 것이다. 독립 곱(w = 1)은 과신(95% 가 78%), 1/k 는 과소신(68% 가 91%)이었고
진짜 답은 사이에 있다. 그 자리를 정하는 것이 섹터 간 상관 ρ_s 이고, 나누는 수가 7 에서 1 + 6ρ_s 로 바뀐다(동일 상관이면 정확한 결과이지 근사가
아니다). 같은 관측에서 정답 대 오답 확률비가 ρ = 0 이면 e⁷, 0.5 면 e^1.75, 1 이면 e 다 — 지금 모델은 맨 아래를 쓰고 있었다.

빠뜨릴 뻔한 층이 하나 더 있다. 코드는 prep 끼리를 독립으로 곱하고(`runs`), 합성 복원이 이미 그것을 과신(53/81%)으로 잡아 두었다.
그래서 prep 간 상관 ρ_p 도 함께 재고, 유효 관측 수는 `1/(ρ_s/P + ρ_p/k + (1−ρ_s−ρ_p)/kP)` 다.

측정법의 후보와 탈락. ⑴ 1k 구간 안 피어슨 상관 + 추세 제거: 추세를 덜 빼면 ρ 가 높게 나오고, 중앙값으로 나누는 단계는 상관에 영향이 없어
군더더기였다. ⑵ 섹터별 가중치: 섹터마다 자기 곡선 · 자기 폭으로 점수를 매기므로 이미 처리돼 있고, ρ 는 묶음의 성질이다. ⑶ 7×7 공분산 전체:
칩 몇 개로 상관 21개는 과적합. 채택은 **연속 사이클 P개 × 7섹터 표의 이원 분산 성분** — 실전 prep(연속 소거)과 같은 꼴이라 추세 제거가 필요
없고, 한 표에서 ρ_s 와 ρ_p 가 같이 나온다. 블라인드 chip06 의 prep 5회로 마모 루프의 값과 비슷한지 본다. 이것은 머신러닝이 아니라 분산 분석이고,
GDA 가 Σ 를 표본에서 추정하는 단계와 같은 일이다.

### 4. 「두 번 센다」 는 진단은 맞았고 처방이 틀렸다 — 정렬하고 R 은 유도한다

[D48-60] 은 쌍 규칙이 교정 곡선 혼합과 r 에서 칩 속도 차를 두 번 센다고 바르게 보고, 처방으로 R 을 LOCO 포함률로 골랐다. 그 순간 R 은
「새 칩이 몇 배까지 다르게 늙나」 라는 물리량에서 「포함률을 맞춰 주는 폭」 이 됐고, 1/k 의 과잉 · 정규 셀의 오류 · M 부족을 전부 흡수하게 됐다.
[D48-94] · [D48-95] 의 1.6 · 1.3 도 같은 방식이다. 머신러닝 수업의 「테스트 셋으로 튜닝하지 마라」 가 바로 이 상황이다.

처방은 이중 계산을 **구조에서** 빼는 것이다. 칩마다 속도 ŝ_j 를 쌍별 `pair_speed` 의 최소제곱으로 하나씩 내고(무리 안 합 0), 공통 시계 구간마다
칩 j 의 c/r̂_j 셀을 넣어 같은 마모 상태끼리 섞는다. 그러면 혼합 폭에는 섹터 차이와 측정 흔들림만 남고 속도 차는 r 한 곳에만 있다. R 은
ŝ_j 의 표준편차 σ_r 에서 exp(1.96·σ_r·√(1+1/M)) — v1 규칙의 √2(새 칩 대 교정 칩 하나)가 √(1+1/M)(새 칩 대 교정 M개 평균)으로 준 것이
이중 계산을 뺀 효과다. 탈락한 것은 이웃 셀 분위수의 보간(계단 앞뒤를 섞으면 §2 에서 없앤 가짜 중간값이 다시 생긴다 — 가장 가까운 셀을 그대로)
과 R 재산출 규칙의 「명목 최근접」([U48-18] 의 걱정이었던 블라인드마다 설정이 달라지는 문제는, R 이 유도값이면 사라진다).

가정 하나는 남는다 — 무리에 교정 칩이 하나면(LOCO 의 느린 무리) σ_r 을 두 무리 합쳐 쓴다. 미리보기(교정 8칩 · 정렬 전 곡선에서 속도만):
빠른 σ_r 0.507 → R 2.97(chip04 가 평균의 1.97배 · chip02 0.60배), 느린 0.184 → 1.52. 빠른 쪽이 지금 1.6 보다 훨씬 넓고, 그것이 데이터의
답이다. 좁히려면 모수가 아니라 교정 칩이다.

같은 날 A 행 없이 돌릴 수 있는 셋(정렬 · R 유도 · n_eff 는 ρ 가정)만 v3.2 위에 얹어 본 결과는 `docs/results/data/inverse_v4_probe_2026-10.md`
다. 경위만 적으면 — 정렬만 얹으면 같은 R 에서 68% 폭이 줄고 포함률이 명목 쪽으로 내려온다(튜닝된 R 이 정렬 없는 혼합의 폭을 보상하고
있었다는 뜻). 거기에 유도 R 을 얹으면 빠른 무리 2.97 이 폭을 도로 넓혀 68% 가 띠 위(과소신)로 간다. 띠의 의심 순서대로 보면 ρ 는 가정값이라
먼저이고, 다음이 R 인데, chip04 가 낀 쌍의 맞춤 rmse 가 0.10 으로 나쁘다 — **빠른 무리가 「모양이 같고 가로축만 늘어난」 한 가족이 아닐**
가능성(chip02 는 계단이 없고 chip04 는 가장 이르다)이 σ_r 을 부풀린다. 튜닝된 R 은 이 구조 문제를 가리고 있었고 유도 R 은 드러낸다.
결론은 미리 내지 않는다 — 분위수 셀과 rows 관측이 들어간 뒤의 띠 판정이 정본이고, 그때도 과소신이면 빠른 무리의 속도 모델이 안건이 된다.

### 5. 검증이 가정을 못 찌른다 — 시험지를 실전 난이도로, 띠는 먼저

LOCO 관측은 빠진 칩의 p50(1,000번의 중앙값)이라 실전(한 번 잰 값)보다 쉽다. 합성 복원은 모델의 정규분포로 가짜 칩을 만들어 정규분포가
틀려도 검출 불가이고, 그 조건에서도 66/91% 로 과신이 남은 것은 M 이 1-2 인 구조적 과신이다. v4 는 LOCO 관측을 **같은 사이클의 7섹터 A 행
그대로**(prep 수만큼) 넣어 섹터 상관이 실전처럼 들어가게 하고, 합성은 분위수 역변환 + ρ 의 가우스 코퓰러로 뽑는다. 정렬 · σ_r 은 빠진 칩 없이
다시 내 누수가 없게 한다.

[D52-3] 의 띠 — 정답 n 점 · 명목 q 에서 n·q ± 1.96√(n·q(1−q)). 94점이면 68% 는 56-72점, 95% 는 86-93점이고, 띠 밖이면 과신 · 과소신이
방향을 말한다. 의심 순서를 고정한다 — 과신: 분위수 바닥 · 폭 하한 → 정렬 부족 → M, 과소신: ρ 측정 → R. 단서: 점들이 칩 8개에서 나와 독립이
아니라 띠는 실제보다 좁고, 띠 안은 「틀렸다는 증거 없음」 이다.

### 6. v4 가 먼저, 칩 추가는 v4.1 — 한 번에 하나만 바꾼다

v3.3(칩 먼저) 대 v4(모델 먼저). 비교 사슬이 v3.2(8칩) → v4(8칩) → v4.1(+chip06) 이면 모델 효과와 데이터 효과가 갈라 읽히고, 모델 작업(호스트)과
마모(보드)는 서로 안 기다린다. 결정적 이유는 S-5 에 이미 적힌 약속 — 남은 블라인드는 v4 로, v4 는 개봉 전 등록. v3.2 코드를 더 큰 표에 돌린
숫자 한 줄은 참고로 남기되 판정 버전으로 등록하지 않는다.

chip06 은 정답 12,000 이 tally 로 확정됐으니 거기서 100k 까지 닳게 하면 12k-100k 교정 곡선이 된다(1k-12k 는 구성원 하나 적은 채 — chip01 의
100k 너머가 지금 그런 상태라 새 문제가 아니다). ρ_p 측정에 쓰는 prep 5회 데이터는 이미 있어 마모와 무관하다. chip14 는 셋이 걸린다 — 10-03 에
DF 무마모 대조군으로 배정됐고, 같은 `DF` 인 chip10 이 100k 뒤 어느 무리와도 안 맞아 교정 밖이었으며, 신품 36.3ms 로 40ms 경계의 빈 틈 안의
유일한 칩이라 「DF 가 제3의 무리인가」 라는 별개 질문의 자료다. 그 질문은 대조군 배정을 바꾸는 결정부터 따로 해야 한다.

### 7. 합성 복원은 고도화 재료가 아니다

「합성 복원도 함께 적용해 품질을 올릴 수 없나」 에 대한 답은 원칙적으로 아니다. 합성 데이터는 모델 자신의 가정으로 만든 것이라 실제 칩에 대한
정보를 **더하지 않는다** — 그것으로 모수를 맞추면 자기 가정에 맞추는 것이고, R 을 LOCO 로 고른 것과 같은 오류를 더 정교한 모양으로 반복한다.
탈락: 합성으로 학습하는 discriminative 보정기(순환), 합성 포함률로 온도 모수 튜닝(손잡이 부활).

쓸 수 있는 자리는 둘이다. ⑴ 보정 점검 — 명목 대 실제 포함률 그림(지금 하는 것). 모델이 자기 가정 아래서조차 정직하지 않으면(M 부족)
그 구조적 과신의 크기를 안다. ⑵ 실험 설계 — prep 을 몇 회 돌리면 폭이 얼마나 주는지, 어느 섹터 수가 필요한지는 실제 칩을 쓰지 않고도 합성으로
답할 수 있다. 이것은 모델을 바꾸는 것이 아니라 측정 절차를 정하는 것이라 순환이 없다. [U52-3].

### 8. 등록 전 남은 것 — 측정 셋

이 세션의 환경에는 원본 A 행(`data/wear/`, 저장소 밖 666MB)이 없다. 그래서 코드와 시험(합성 교정 표 · 심은 ρ 복원 · 늘린 곡선의 속도 복원)
은 됐지만 등록값은 비어 있다 — 분위수 열이 있는 교정 표(재생성), ρ_s · ρ_p(`--rho`), LOCO rows 결과. `--model v3.2 --loco` 가 10-07
기준선(68% 67/94 · 95% 93/94)을 그대로 내는 것은 확인했다. 절차는 S-5 §9. v4 의 성능 수치는 측정 뒤 `results/` 에 두고 여기에는 적지 않는다.
그래서 「v3.2 대 v4 의 성능 차이」 는 아직 답이 없다 — 있는 것은 §4 의 부분 탐색(`inverse_v4_probe_2026-10.md`)뿐이고, 그것은 정규 셀 · p50
관측이라 v4 가 아니다.

> **2026-10-09 — 셋 다 쟀고 등록했다 (§9 - §10 · [D52-8]).** 수치는 `docs/results/data/inverse_v4_eval_2026-10.md`.

### 9. 등록하며 드러난 것 — ρ 가 재지 못하던 몫

A 행이 있는 PC 에서 §8 의 절차를 돌리자 ρ_s 는 0.00, ρ_p 는 0.78 이 나왔다(chip06 개봉 prep 5회도 0.00 · 0.72). 한 번의 소거에서 7섹터가 같이
흔들리는 일은 없고 섹터 오프셋은 끈질기다 — 둘 다 실제 사실이다. 그런데 이 값을 §3 의 식에 넣으면 n_eff 가 7(prep 1회) · 8.5(5회)가 되어,
[D48-58] 이 과신으로 버렸던 「독립 곱」 자리로 돌아간다. LOCO rows 는 68% 74.2% 합격 · **95% 90.2% 과신**(띠 86-93/94)이었고, 증거를 1 로
강제하면 반대로 68% 84% · 95% 100% 과소신이었다. 답은 사이에 있었다.

§3 의 전제(섹터 7개는 증거 7개가 아니다)는 맞았고, 어긋난 것은 그 이유의 자리였다. 7개가 따로 놀지 않는 이유는 셋이다 — ⑴ 한 번 소거에서
같이 흔들림(ρ_s) ⑵ 섹터 고유 오프셋(ρ_p) ⑶ **이 칩 자체가 교정 칩들과 다름**(칩 효과). §3 은 ⑴ ⑵ 로만 번역했고, 측정은 그 둘을 정확히 재서
본체가 ⑶ 이라고 답했다. ⑶ 은 칩 하나 안의 표에서는 원리상 보이지 않는다 — 표 전체에 같은 상수로 깔려 평균으로 빠진다. 체온계 7개로 한 사람을
여러 번 재도 「이 사람이 남보다 체온이 낮다」 는 안 나온다. 그것은 여러 사람을 놓고 비교해야 보이고, 그 자리가 LOCO 다. [D48-58] 의 문장
「반복 prep 은 측정 잡음을 줄이지만 칩과 교정 곡선의 차이는 못 줄인다」 가 이미 ⑶ 을 말하고 있었는데, §3 이 ⑴ ⑵ 의 언어로 옮기며 빠뜨렸다.

측정은 교정 칩 j 를 빼고 그 칩의 A 행 한 줄(7섹터)을 나머지 칩의 정렬된 혼합(공통 시계 b·r̂_j 의 구성원 p50 중앙값)과 비교한 로그 잔차 표의
일원 랜덤효과 — 표 간 분산 몫이 ρ_chip 이다. 전체 0.29, 빠른 0.33 · 느린 0.03. 느린 무리는 정렬하면 한 가족이고, 빠른 무리는 chip04 가 속도를
맞춰도 12% 낮게 남는다. n_eff 는 `1/(ρ_chip + (1−ρ_chip)(ρ_s/P + ρ_p/k + …))` 로 2.6 - 2.7 이 됐고, LOCO rows 는 68% 79.1% · 95% 96.5% 로 95% 가
띠 안에 들었다. chip07 이 37/64% 에서 64/92% 로 돌아왔다(§10 의 M=2 문제와 겹친 자리). 이것은 결과를 보고 고른 값이 아니라 재는 양의 정의를
고친 것이다 — 다만 S-5 §7 의 의심 순서가 ρ 를 과소신 쪽에만 둔 것은 이 정의 문제를 못 본 것이라, 그 자리에 경위를 적었다.

같은 날 고친 것 하나 — 합성 생성기가 정체 칩의 셀을 자기 시계 x·r 에서 뽑고 있었다. 정렬 모델은 그 칩의 셀을 공통 시계 b·r̂_j 에 두므로 유효
속도가 r·r̂_j 로 [1/R, R] 을 벗어나, 「자기 가정 아래 정직한가」 를 재지 못했다(LOO prep 5 가 59/87). 자기 시계 x·r/r̂_j 로 고치자 73/96 이 됐다.

### 10. 등록 판단 — 68% 과소신은 그대로, 표시는 68 · 95 그대로, ρ 는 전체값 하나

68% 가 79.1% 로 띠 상한(76.6%)을 2-3점 넘는다. 출처는 무리별로 다르다. 느린 무리(65 → 78%)는 ρ_chip 전체값 0.29 가 그 무리의 0.03 보다 큰
탓이고, 빠른 무리(79-80%)는 ρ_chip 을 0.03 으로 두든 0.33 으로 두든 꼼짝 않는다 — 원인은 R 2.97 이고, 그것은 chip04 의 모양 차이가 σ_r 에
속도 흩어짐으로 들어간 결과다(§4 의 가설이 숫자가 됐다). 등록한다 — 과소신은 「말한 것보다 자주 맞는」 안전한 쪽의 오차이고, 과소신 의심
순서 ①(ρ)은 ρ_chip 으로 소화했으며, ②(R)는 모수가 아니라 교정 칩이 늘어야 푸는 문제다. 띠 자체도 칩 8개의 점들이라 실제보다 좁다.

후보와 탈락. ⑴ **ρ_chip 무리별 등록** — 느린 무리가 띠 안으로 들어오지만, 칩 셋에서 나온 0.03 은 운일 수 있고 규칙이 둘이 되어 「교정 칩이
늘면 저절로 따라오는 한 규칙」에서 멀어진다(영웅님: 지금 데이터에 과적합하는 방향). ⑵ **1.96 대신 t 분위수** — σ_r 을 표본에서 추정한
예측구간의 정석이고 M=2 의 느린 무리 LOCO(chip07 을 빼면 chip03 · 15 둘뿐이라 R 이 좁아짐)를 고치지만, 빠른 무리(M 5 · t 2.78)에도 같이 걸려
R 이 4.7 로 커져 과소신이 더 심해진다. 기록만. ⑶ **σ_r 을 두 무리 합쳐** — 자유도는 늘지만 한 가족(느린)과 아닌 가족(빠른)을 섞는다.
⑷ **LOCO 실측 79% 를 구간 라벨로** — 시험지로 라벨을 고치는 것이라 R 을 포함률로 고르던 오류의 표시판이다. 모델이 말한 값과 실측을 나란히 적는
것까지만 한다. ⑸ **68 · 95 대신 의미 있는 범위의 사후 확률** — 시연 화면의 등급 확률이 이미 그것이고, 범위를 먼저 정하면 된다. 다만 블라인드
기록 형식([D48-69])과 성공 기준 ③ 이 68 · 95 로 등록돼 있어 바꾸려면 S-5 에 새 형식을 먼저 등록해야 한다. 지금은 유지.

공모전 보고서 · 발표의 수치는 v3.2 그대로([D48-107]) — 시연에서 v3.2 를 보이려면 `--model v3.2`. 남은 블라인드(chip08 · 새 10칩)는 v4.

### 11. 후속 (2026-10-12) — v4.1 측정: chip06 을 더한 9칩, 띠 판정은 v4 와 같고 R 이 2.97 → 2.72

chip06(블라인드 12k 칩)이 10/12 100k 에 닿아 교정 9칩째로 승격했다(커밋 `ea951bf`). §6 의 순서대로 모델 · ρ 등록값 · 관측 방식은 v4 그대로 두고
교정 표에 `wear_curves_chip06_2026-10.csv` 하나만 더해 S-5 §9 의 1 - 6 을 다시 돌렸다 — 수치는 전부
`docs/results/data/inverse_v4_1_eval_2026-10.md`, S-5 §2 에 v4.1 열을 **미등록 초안**으로 붙였다.

**띠 판정은 v4 와 같다.** 106점 띠(68% 63-81 · 95% 97-105)에 rows P5 반복 20 이 **80.4% · 94.9%** — 68% 과소신 · 95% 합격, v4(94점)의 79.1 · 96.5
와 같은 모양이다. p50 은 86 · 100 / 106. 느린 무리는 교정이 안 바뀌어 수치가 그대로이고, 빠른 무리는 60 → 72점에 95% 96.0 → 93.7%.

**ρ 는 9칩에서 다시 재도 같다.** ρ_s 0.00 · ρ_p 0.78 그대로, ρ_chip 0.29 → 0.27 — chip06 의 잔차 +0.018 이 chip09(+0.019) 자리라 전체값이 조금 준 것뿐이다.
0.27 로 LOCO 를 돌려도 80.3 · 94.6% 로 등록값과 구별이 안 된다. chip06 마모 루프의 ρ_p 0.77 은 같은 칩의 개봉 prep 5회(0.72, §9)와 맞아, 마모 루프 =
prep 이라는 [U52-1] 의 근거가 한 칩 더 늘었다.

**R 이 2.97 → 2.72 로 준 것이 v4.1 의 유일한 실질 변화이고, 그 값이 chip04 를 더 밀어낸다.** chip06 의 속도 r̂ 0.771 은 chip09 0.758 · chip18 0.834
· chip02 0.636 묶음이라 σ_r 이 0.507 → 0.473, M 이 5 → 6 이 되어 R 이 준다. §10 이 「R 은 교정 칩이 늘어야 준다」 고 적은 그대로다. 그런데 좁아진 R 이
r̂ 2.10 인 chip04 를 [1/R, R] 가장자리로 밀어 chip04 의 95% 가 80 → **62%**(3k · 30k · 40k 가 20회 전부 빗나감)로 나빠졌다. 68% 과소신의 출처가
R 이라던 §10 의 진단은 맞았지만, 그 R 이 주는 쪽이 chip04 하나를 희생해 나머지를 조이는 방향이라는 것이 이번에 숫자로 보였다 — §4 의 「빠른 무리는
모양이 같고 가로축만 늘어난 가족이 아니다」 가 chip04 에서 그대로다. 교정 칩을 더 넣어도 chip04 같은 칩은 R 로는 안 덮인다는 뜻이고, 이것은 v4.1 의
등록을 막는 이유가 아니라 보고서의 한계 문장이다(chip04 는 교정 9칩 중 하나이고 블라인드가 아니다).

**chip06 자신은 잘 맞는다.** chip06 을 뺀 8칩이 chip06 12점을 95% 12/12 · 68% 11/12(90k 하나)로 품고, 블라인드 정답 자리(10k 점)의 사후 중앙값이
12,001-13,000 이다 — 9/30 의 v2 판정(68% 3,001-19,000, 로그 48)보다 좁다. 50k 이상에서 점 추정이 55-63k 에 머무는 것은 [D48-107] 의 고마모 한계 그대로.

합성 복원(정체 칩 뺌 · prep 5회)은 68% 71 · 95% 96 으로 v4 의 73 · 96 과 같은 자리. 등록 여부는 [U52-5] — 영웅님 결정. 등록하면 바꾸는 것은
`MODEL_VERSION` "v4.1" · S-5 §2 의 「미등록」 · S-1 §15 추기이고, RHO 는 재측정값 0.27 로 바꾸든 0.29 로 두든 LOCO 가 같아 v4 원칙(잰 값)대로면 0.27.

### 12. 후속 (2026-10-12 저녁) — 프로그램 축(v4.2)을 브랜치에서 만들어 재 보고 폐기했다

§11 뒤 영웅님이 「v4.2 = 프로그램 축」 으로 정해 브랜치 `inverse-v4.2-program-axis` 에서 만들었다. 먼저 잰 것: 개봉 prep(PRBS)의 프로그램은 100k
닳은 섹터에서도 기준 섹터의 1.00 - 1.15배(chip02 1.15 · 15 1.02 · 18 · 16 · 12 1.00)라 마모 루프 0x00 프로그램(chip02 2.06배 · 15 1.19)의 신호가
PRBS 에서는 뭉개진다([D48-37] 의 0.53배가 이것). 그래서 관측은 개봉 때 엔진 1사이클(0x00)로 재는 것으로 두고, 교정 표에 프로그램 분위수 21열을 붙이고
(`wear_curves.py` · 소거 열은 바이트 그대로), 구성원 셀을 소거 × 프로그램 둘로 하되 프로그램은 그 칩의 초기 구간(≤ 3k) 대비 비율 눈금(칩 간 신품 오프셋
6.50 - 6.95ms 가 셀 안 산포 0.6% 보다 커서 절대 눈금은 안 됨), 증거는 셀 안 소거-프로그램 순위상관 ρ_ep(A 행 6칩 중앙값 0.05 — 잰 값)만큼 깎아 더했다.

**결과 — 좁아지지만 과신한다.** 9칩 106점 rows P5: 68% 폭 34,000 → 29,000 인데 정답∈95 94.9 → 92.5%(띠 하한 91.5 바로 위) · 추정/정답 0.96 → 0.90,
느린 무리 95% 97.4 → 88.5%. 합성 복원(정체 칩 뺌 · prep 5회)은 **68% 71 → 60 · 95% 96 → 84** — v4 가 막으려던 「처음 보는 칩에 대한 과신」 이
그대로 돌아온다. 칩별로는 68% 가 chip06 88 → 55% · chip03 76 → 50% · chip07 64 → 52%(95% 92 → 70%), 평탄한 04 · 09 · 18 은 그대로.
원인은 프로그램이 오르는 양이 칩마다 달라서다(100k 에서 chip02 2.06 · 07 2.1 · 06 1.37 · 03 1.26 · 15 1.19배). 셀 안 산포가 0.6 - 9% 로 좁으니 빠진 칩의
프로그램 궤적은 남은 칩 누구와도 안 맞고, 그 불일치가 마모가 아니라 「이 칩은 누구냐」 로 읽힌다 — 소거는 ρ_chip 이 그 몫을 깎는데 프로그램에는
그 장치가 없다. 가중을 줄이면(ρ_ep 0.5 → 76.2 · 94.1% · 합성 65 · 89, ρ_ep 0.8 → 79.4 · 95.0% · 합성 70 · 95) 과신은 사라지지만 폭이 34k → 32k 로
2k 차이뿐이라 v4.1 과 구별이 없다. 프로그램의 칩 효과를 따로 재서 깎아도 오르는 칩이 5개뿐이라 그 근처로 수렴할 것이다.

- [D52-9] **v4.2(프로그램 축)는 폐기한다** — 브랜치를 지웠고 교정 표의 프로그램 분위수 열도 넣지 않는다. 오르는 칩이 더 쌓이기 전에는 다시 보지
  않는다 (2026-10-12, 한영웅). 다음은 v4.3 — 답 범위를 150k 너머로 넓히기 위해 chip06 · 09 를 200k 까지 더 닳게 한다(§11 의 고마모 치우침이 가장 큰 오차)
  > **2026-10-19 — 「답 범위 150k 너머」 는 뒤집힘 ([D52-13]).** 답 범위는 100k 그대로, 200k 곡선은 고마모 과소추정 교정용. 칩을 200k 까지 닳리는 일 자체는 그대로
  > **2026-10-14 — chip06 · 09 200k 끝 · 승격 (§13).** 둘 다 110k-158k 에 7섹터 계단, 160k-200k 평탄. 다음은 느린 무리 chip03 200k, 그 뒤 v4.3

### 13. 후속 (2026-10-14) — chip06 · chip09 를 200k 까지: 계단은 「언제」 였고, 160k 너머는 평탄하다

[D52-9] 대로 chip06(10/12 19:25 → 10/13 20:19 KST, 세션 `1791800419`) · chip09(10/14 00:20 → 23:16, `1791904816`, `--confirm-first 0` 무인)를 보드 A 에서 100k → 200k 로
더 닳게 했다. `run_wear.py accept --to 200000 --checkpoints 110000,…,200000` — 체크포인트 격자를 옵션으로 주는 자리가 있어 실행기는 손대지 않았다. `pe_end.py` 도 200k 를
그대로 처리했다 — 걸린 것은 셋뿐: ① 체크포인트 CSV 의 수기 비고(재장착 · 개봉 prep · 휴지)를 재생성본이 지우므로 승격 전에 합쳤고(`--overwrite`), ② 이름의 달이
마지막 스윕의 달이라 chip09 는 `_2026-09` → `_2026-10` 으로 `git mv`(참조 4곳), ③ 배율 겹침 · 한눈 그림은 x 100k 클립이라 새 판이 바이트 동일 → 안 남겼다. 교정 glob 에
100k 너머 구간이 들어갔지만 현행 v4/v4.1 은 M = x·r 지점으로만 쓰고 답 범위는 100k 그대로(테스트 45 통과). `A_SESSIONS` 의 새 세션은 v4.3 때 같이.

**결과**(`docs/results/wear/wear_endurance_200k.md` — 두 칩의 물음이 같아 한 편, 수치는 `data/wear/wear_endurance_chip06_2026-10.md` · `chip09_2026-10.md`).
100k 안에 계단이 없던 12섹터가 전부 110k-158k 에 전환했고(chip06 116-158k · chip09 110-157k, 10/14 00:20 전에 적은 「chip09 160k 안」 예측이 맞음), 높이는
14섹터 18.1-21.3ms 로 H3 안. 160k 부터는 두 칩이 같은 104-109ms 평탄 구간이고 2차 계단(chip01 203-283k)은 오지 않았다. 폭은 200k 까지 3σ 안(chip06 보드 A 구간
±8ps · chip09 120k 부터 +21-25ps 로 한 번 옮김, 창 위치 미확인). 프로그램은 chip06 1.9배 · chip09 1.01배 — §12 의 「프로그램 상승량은 칩마다 다르다」 의 가장 센 예.
H6 ② 「착지 107-112ms」 는 14섹터 전부 94.6-104.2 로 아래 — 직전 수준 + 21ms 라 고정 띠가 아니다(S-1 §15 10/14 추기, 다음 칩 예측은 「직전 + 21±4」). H4 는
0.32 · −0.29 로 못 미침. chip09 13일 휴지 전후 소거는 이어졌다(73.0 → 73.7).

**v4.3 에 주는 것.** 빠른 무리 100k-200k 곡선 두 장(150k 배율 4.08 · 3.98)은 생겼고 느린 무리는 없다 → 다음은 chip03(100k 에 88-93ms, 문턱 턱밑 — 느린 무리도
밟는지와 교정 곡선을 한 번에). 소거 축이 160k-200k 에서 평탄하므로 v4.3 의 답 상한(150k 또는 200k)은 평탄 구간 처리와 같이 정한다. chip02(100k 68-72ms)는
「빠른 무리는 무조건 밟는다」 를 쓰려면 봐야 하지만 모델에는 필수가 아니다 — 여유 있으면 chip03 뒤.

> **2026-10-16 추기 — chip03(느린 무리) 200k: 10/14 예측이 틀렸다.** 10/15 00:04 → 10/16 00:13 KST(세션 `1791990254`, 24h09m, 무인). 100k 에 88-93ms 로 chip06 · 09 가
> 뛰기 직전과 같은 수준이라 S-1 §15 10/14 추기에 「110-130k 에 계단 · 착지 = 직전 + 21」 을 걸었는데, 계단 없이 미끄러졌다 — 한 구간 상승 최대 5-12ms, p10-p90 20-25ms 로
> 벌어진 채 p50 86 → 107ms, 105ms 이상 A 행 비율이 70k 에 걸쳐 0 → 66%(chip09 는 20k 안에). 섹터 5 는 190k-200k 에 114-127 로 한 수준 더. **계단은 빠른 무리의 표지** —
> 0 → 100k 의 「느린 세 칩 계단 없음」 이 「아직 못 와서」 가 아니라는 것이 이 칩으로 섰고, 「계단 경계 = 소거 시간 85-95ms, 무리 무관」 은 못 쓴다(S-1 §15 10/16 추기).
> 폭 +3 - +16ps(19일 휴지 뒤 재장착, 3σ 안) · 프로그램 1.7-2.3배 · 휴지 회복 없음. 승격은 chip09 와 같은 길(`_2026-09` → `_2026-10` git mv, 참조 5곳, 수기 비고 합침 —
> 사다리 · newchip 행은 C 행이 없어 cycle 을 손으로, 배율 그림 중복 지움, 테스트 45 통과). **v4.3 에는 좋은 쪽** — 느린 무리 소거 축은 100k-200k 에서 평탄 구간 없이
> 1.74 → 2.10 이라 소거만으로 150k 와 200k 를 가른다(빠른 무리는 160k-200k 평탄). 다음 chip15 예측 「계단 없이 미끄럼 · 200k 배율 약 2.1」, 그 뒤 v4.3.

> **2026-10-17 추기 — chip15(느린 두 장째) 200k: 예측 맞음.** 10/16 01:03 → 10/17 01:24 KST(세션 `1792080192`, 24h21m, 무인). 한 구간 상승 4-11ms · p10-p90 18-25ms 로 chip03 과
> 같은 미끄럼, 200k 배율 2.25(예측 약 2.1 보다 조금 높음). 섹터 4(124k 부터) · 2(180k 부터)는 128-131ms 로 한 수준 더 — 그것도 미끄럼. 폭 +7 - +13ps(재장착 뒤, 3σ 안) ·
> 프로그램 1.49-1.96배 · 휴지 12일 회복 없음. 승격은 `--drop-cycles 69109-69109` 를 다시 줘야 했다(69,109 가짜 행 — §5 사건, 1단계를 옵션 없이 돌리면 곡선에 되들어간다;
> 수기 비고 합침 · 사다리/newchip 행 cycle 손으로 · 배율 그림은 x 100k 클립이라 동일 → 안 남김 · 테스트 45). **느린 무리 100k-200k 가 두 장(03 · 15, 150k 1.87 · 1.88 ·
> 200k 2.10 · 2.25, 평탄 없음)** 이라 v4.3 의 느린 LOCO 채점이 가능해졌다. 다음: chip21 0 → 200k(느린 세 장째, 예측 「미끄럼 · 2.1-2.3」) → v4.3.

> **2026-10-19 추기 — chip21 0 → 200k: 예측이 틀렸고, 모델 전제가 깨졌다.** 10/17 02:12 → 10/19 10:32 KST(세션 `1792170748`, 56h20m, 23점 무인, 사건 없음). 신품 48.9ms 로
> 느린 무리에 배정한 칩이 10k 1.49 · 50k 2.19 · 100k 2.63 · 200k 2.93 으로 빠른 무리 속도로 늙었다. 미끄럼(한 구간 5-8ms)이고 프로그램은 150k 까지 불변 — 알리 chip12(1.40 ·
> 1.99 · 2.58 · 불변)와 같은 꼴. [D48-73] 이 chip12 를 「구매처」 로 설명했는데 같은 FV(`1647`)에서 재현됐으니 구매처가 아니라 **세 번째 종류**다(느린 신품 5칩 중 2).
> 상온 9칩 모델로 chip21 을 맞히면 **68% 0/12 · 95% 2/12** — 느린 교정에 대져 50k 까지 3-6배 높게, 60k 뒤엔 두 봉우리로 낮게. 교정에 넣어도 느린 세 칩 LOCO 는 11 → 10 ·
> 7 → 8 · 10 → 9 로 거의 그대로(118점 68% 합격 · 95% 과신은 chip21 자신 12점). 승격은 배정대로 교정 glob 에 넣었고(`wear_curves_chip21_2026-10.csv`, 그림은 회색 —
> CHIP_COLORS 미지정) 같은 날 [D52-12] 로 `_nocal` 로 바꿔 뺐다. 개봉 전 한 점(신품 소거 · 폭 · 프로그램 · 섹터 산포)으로는 chip22 · 23 과 안 갈리고, 노화 기울기(첫 1k 1.22 대 1.04-1.09)만 가른다.

- [D52-10] **200k 연장은 chip06 · 09 → chip03 순, 300k 는 가지 않는다** — 2차 계단은 chip01 한 장으로 충분하고, 같은 구간에 칩이 여럿이어야 ρ_chip 을 잰다. v4.3 은
  chip03 200k 뒤에 만든다 (2026-10-14, 한영웅) — §13 · `docs/chip_registry.md` chip06 · 09
  > **2026-10-15 — chip15 를 더한다.** 느린 무리 100k 너머가 chip03 한 장이면 LOCO 로 채점할 수 없어(빼면 빈다) chip15 를 200k 까지(영웅님 동의). v4.3 은 chip15 뒤.
  > chip14(JV) · 10 · 12 · 16 · 17 은 교정 밖 그대로
  > **2026-10-16 — chip03 200k 끝 · 승격 (§13 추기).** 계단 없이 미끄럼 — 느린 무리에는 H6 가 서지 않는다. 느린 소거 축은 평탄 구간 없이 1.74 → 2.10
  > **2026-10-17 — chip15 200k 끝 · 승격 (§13 추기).** 예측대로 미끄럼(2.25). 느린 두 장이 같은 모양 → v4.3 재료는 빠른 3(01 · 06 · 09) · 느린 2(03 · 15), chip21 이 느린 세 장째
  > **2026-10-21 — chip07 200k 끝 · 승격.** 느린 세 장째(1.91배 · 미끄럼). A 행 결손 두 곳(전원 상실 · 내 프로브 kill). v4.3 6장 판 재료
  > **2026-10-19 — chip21 0 → 200k 끝 · 승격 (§13 추기).** 느린 세 장째가 아니었다 — 신품 48.9 인데 빠른 속도(2.93배), chip12 형. 같은 날 교정에서 뺌 [D52-12]
- [D52-12] **chip21 은 교정에서 뺀다(`_nocal`). v4.3 은 chip21 없이 — 200k 다섯 장(빠른 01 · 06 · 09 · 느린 03 · 15)으로 답 범위만 넓힌다. 느린 신품의 두 종류(chip12 · 21 형)는
  v4.4 에서 다룬다** — 종류 문제는 chip22 · 23 이 어느 쪽인지 나와야 설계 재료가 있고, 답 범위 확장은 그와 무관하게 필요하다 (2026-10-19, 한영웅) — §13 · [U52-7] ·
  `docs/results/wear/wear_endurance_200k.md` §8. v4.3 의 느린 신품 답에는 「chip21 형이면 전부 틀린다」 가 한계로 붙는다

### 14. 후속 (2026-10-19) — v4.3 설계: 답 범위는 100k 그대로, 200k 곡선은 고마모 과소추정을 고치는 재료

§12 끝에 「v4.3 = 답 범위를 150k 너머로」 라고 적었고 §13 까지 그렇게 끌고 갔는데, 영웅님이 바로잡았다 — 우리가 답할 칩은 정격 100k 안의 칩이고 블라인드도 그 안에서
나오므로 답 범위와 LOCO 채점은 100k 그대로여야 한다. 200k 까지 닳린 이유는 **고마모(50k 이상)에서 점 추정이 55-63k 에 눌리는 과소추정**(§11)을 고치는 것이었다.

**왜 눌렸나.** 모델은 사이클 x 인 칩을 교정 곡선의 M = x·r 지점으로 본다(S-5 §5, r ∈ [1/R, R], 빠른 무리 R 2.72). x 80k 면 M 은 29k-218k 를 훑는데 100k 너머 곡선은
chip01 하나뿐이라 그 구간의 우도가 거의 비어 있었고(코드 주석 「교정 범위 밖은 0 — 큰 x 는 r 이 작은 쪽만 기여」), 사후가 아래로 눌렸다. 200k 곡선 네 장(06 · 09 ·
03 · 15)이 그 구간을 채우면 같은 식 · 같은 범위에서 큰 x 의 우도가 서야 한다. 코드는 이미 「곡선이 있는 곳까지」 쓰게 돼 있고 네 장은 승격돼 있어 지금 glob 이 그 상태다.

**설계** (S-5 §9 9번): ① 답 범위 · 사전 · 대표값(중앙값) · HPD · 무리 경계 · LOCO 106점은 그대로 ② `A_SESSIONS` 에 200k 세션 4개 — 합성 복원 · ρ 가 100k 너머 행을 읽게
③ ρ · R · LOCO · 합성 재측정 ④ 채점 기준을 결과 전에 고정 — 106점 띠 통과 + 고마모 버킷 50-100k 추정/정답 중앙값 **0.90 이상(v4.1 0.84)** · 68% **74% 이상(v4.1 74.2%)**
(처음엔 「0.6대 → 0.8」 로 적었다가 LOCO 전에 고침 — 0.6대는 §11 의 chip06 held-out 점 추정이었다) ⑤ 5장 판 → chip07 200k 뒤
6장 판 → chip02 200k 뒤 7장 판, 마지막 판으로 등록. chip21 은 밖([D52-12]), 온도 칩은 검증 세트로 밖([U52-6] 의견 그대로 — 상온 교정이 chip22 를 93-94k 로 맞힌 것이
밖에 둬야 쓸 수 있는 문장이다).

- [D52-13] **v4.3 은 답 범위 100k 를 그대로 두고, 200k 곡선으로 고마모 과소추정만 고친다** — 코드 변경은 `A_SESSIONS` 와 버전 문자열뿐, 나머지는 측정. 채점은 §9 9번의
  고마모 버킷 기준을 결과 전에 고정했다(0.90 · 74% — v4.1 의 0.84 · 74.2% 대비). 등록은 chip07 · 02 200k 까지 들어온 마지막 판으로 한 번 (2026-10-19, 한영웅) — §14 · S-5 §2 v4.3 열 · §9 9번
  > [D52-9] 의 「답 범위를 150k 너머로」 는 이 결정으로 **뒤집힘** — 200k 마모의 목적은 범위가 아니라 과소추정이었다

> **2026-10-19 추기 — 5장 판 결과: 곡선은 68% 를 올렸지만 점 추정의 과소추정은 그대로다.** `inverse_v4_3_eval_2026-10.md`. 106점 rows P5: 82.6 · 94.7%(v4.1 80.4 · 94.9),
> 50-100k 버킷 68% 74.2 → 79.1%(기준 ① 충족) · 추정/정답 0.84 → 0.84(② 미충족). 느린 세 칩이 전부 좋아졌고(03 76 → 84 · 15 91 → 99 · 07 95% 92 → 97) ρ_chip 은 0.20 으로 줄었다 —
> 200k 곡선이 「r 이 큰 쪽의 우도」 를 채운 효과는 실재한다. 그런데 점 추정은 정답 x 별로 50k 1.13 · 60k 1.04 · 70k 0.85 · 80k 0.84 · 90k 0.75 · 100k 0.71 — **상한 100k 에 가까울수록
> 단조로 눌리고**, 200k 곡선이 있는 칩(06 · 09 · 03 · 15)과 없는 칩(02 · 04 · 18)의 차이가 없다. 즉 §14 가 짚은 「곡선 결핍」 은 68% 쪽 원인이었고, 점 추정의 원인은 **사전을
> 1-100k 로 자른 절단**이다: 정답이 90k 면 사후의 오른쪽 절반이 100k 에서 잘려 중앙값이 왼쪽으로 밀린다. 설계 ③ 의 「안 오르면 곡선 결핍이 아니라는 답」 이 그대로 나왔다.
> 처리 선택지는 [U52-8].

### 15. 후속 (2026-10-21, 브랜치 `inverse-v4.3-ceiling`) — 6장 판과 상한 처리 후보 일곱: 고를 수 있는 건 대표값뿐이고 상한은 안 풀린다

영웅님 지시: 지금까지 PE 데이터를 다 반영(6장 판 — chip07 200k 추가)한 뒤 상한 근처 점 추정 처리를 v4.3.0-v4.3.6 으로 각각 만들어 이론적으로 타당한 채점으로 고르고,
만족스럽지 않으면 그것도 브리핑. main 머지는 지시 전까지 하지 않는다. 수치는 `docs/results/data/inverse_v4_3_ceiling_2026-10.md`.

**채점 방식을 먼저 정했다** (`host/analysis/inverse_ceiling_study.py` 머리). 후보가 두 부류라 둘을 따로 채점한다 — 지지나 사전을 바꾸면 **예측 분포**가 바뀌므로 분포 전체를
채점하는 적정 점수 규칙(로그 눈금 CRPS)으로, 대표값만 바꾸면 분포는 같으니 **점 추정 손실**(|ln(추정/정답)| — 배율 오차, 칩 간 속도가 배율로 흩어지니 로그가 자연스럽다)로.
보정(68 · 95% 띠)은 조건, 구간별 치우침은 동점 처리용.

**6장 판** — chip07 200k 를 넣어도 LOCO 는 사실상 그대로(82.5 · 94.7%, 50-100k 0.84). 느린 R 1.52 → 1.59, ρ_chip 0.21, 합성 69 · 95.

**후보 결과.** 분포는 지지 1-100k · 평평한 사전이 가장 좋다(CRPS 0.219 대 지지 200k 0.251 · 로그 균등 사전 0.248). 그 위에서 대표값은 평균 0.310 < 중앙값 0.329 < MAP 0.471 <
q16 0.600 — 규칙대로 **v4.3.2 (사후 평균)** 을 골라 브랜치에 넣었다(`MODEL_VERSION` v4.3). (마) 규칙은 한 번도 걸리지 않았다.

**왜 상한이 안 풀리나 — 브리핑.** ① 50-100k 의 0.84 는 분포를 그대로 둔 모든 대표값에서 같다(평균 · 중앙값 0.84, MAP 0.86). 사후가 정답 100k 근처에서 넓고 왼쪽으로
기울어 있어 어떤 요약을 골라도 왼쪽이다. ② 분포를 바꾸는 길은 지지를 넓히는 것뿐인데, 빠른 무리 160k-200k 평탄 때문에 소거 시간이 100k 너머를 구별하지 못해 과대(1.11)로
넘어가고 CRPS 가 14% 나빠진다 — 측정(소거 시간 한 지표)의 정보 한계다. ③ 그 0.84 는 사전 1-100k 아래의 베이즈 축소(정답이 사전 끝에 있으면 추정이 안쪽으로 당겨짐)로,
모델 오류가 아니라 「이 데이터로 90k 와 100k 를 가를 정보가 없다」 는 뜻이다 — 95% 는 정답 100k 를 9/9 품는다. ④ 만족스럽지 않은 나머지도 그대로다: 68% 과소신(82.5% >
띠 76.4%, 구간이 필요보다 넓다), chip04 95% 57%(r̂ 2.07 이 R 가장자리), chip12 · 21 형 느린 신품은 전부 틀림(v4.4). 상한을 정말 풀려면 모델이 아니라 **측정**이 필요하다
— 고마모 칩만 움직이는 두 번째 지표(빠른 무리 160k 뒤 평탄 구간의 섹터 분포 폭 · 2차 계단 · 프로그램)나 개봉 때 짧은 추가 마모(Δx)의 기울기. v4.4 의 Δx 와 같은 장치다.

- [D52-14] **v4.3 의 대표값을 사후 평균으로 바꾼다 (브랜치에서, 머지 대기)** — 6장 판 교정 · ρ 등록값 그대로, 결과 전 고정한 채점(CRPS → |ln|)대로. 상한 근처 과소추정(0.84)은
  이 결정으로 풀리지 않으며 한계로 남는다(정보 한계 — 측정으로만 풀림) (2026-10-21, 영웅님 위임 · 머지는 영웅님) — §15 · `inverse_v4_3_ceiling_2026-10.md`
  > [U52-8] 은 이것으로 닫힘 — (가)(라)(다)(마)와 로그 균등 사전을 같은 점에서 재고 평균을 골랐다
- [D52-15] **v4.3 확정 (브랜치, 머지 대기)** — 6장 판 교정 · ρ_chip 재측정 0.21(잰 값 원칙, LOCO 81.6 · 94.1% 로 판정 불변) · 대표값 사후 평균. 점검에서 화면 문구가 실제 모델이
  아니라 기본 버전을 보던 것을 고쳤다. 85°C 칩 현장 역산은 구간 불변 (2026-10-23, 한영웅) — `inverse_v4_3_ceiling_2026-10.md` §5 · §6

- [D52-16] **v4.3 을 main 에 머지하고 등록한다 — 블라인드 chip08 은 이 판으로 판정** (2026-10-23, 한영웅) — 머지 커밋 · S-5 §2 v4.3 열(등록일 · ③ 1.33 · 판정 칩 chip08) · S-1 §15 10/23 추기.
  [U52-5](v4.1 등록)는 v4.3 이 대신해 닫힘
  > **2026-11-11 — chip08 도 봉인 없는 모델 고정 판정으로 바꿨다 ([D52-18]).** 정답이 대장 커밋 제목과 대화로 판정자에게 드러났다 — 모델은 10/23 뒤 그대로

### 16. 후속 (2026-10-23, 브랜치) — 학습 곡선: 빠른 무리는 교정 3칩에서 포화한다

영웅님 의도: 교정 칩이 9개뿐인 것을 「더 넣어도 안 좋아진다(포화)」 로 뒷받침. 판 비교(8 → 9칩 · 5 → 6장)는 일화라, 같은 무리에서 교정 칩 k 개만 골라 나머지를
맞히는 학습 곡선을 모든 조합으로 그렸다(`docs/results/data/inverse_learning_curve_2026-10.md`). 빠른 무리는 1 → 3칩에서 68% 27 → 73% · 95% 46 → 90% · 배율 오차
0.51 → 0.37 로 오르고 3 → 5칩은 표준오차 안 — **k = 3 에서 포화**. k = 1 은 R 을 잴 수 없어 과신(폭 6,700 · 68% 27%)이다. 느린 무리는 3칩이라 k = 2 까지(43 → 79% ·
78 → 99%, 아직 오르는 중) — 판정 불가, 상온 느린 칩 하나를 더 돌리면 k = 3 이 생긴다. 포화 뒤 남는 약 1.4배 오차는 칩 개체 속도 차이라 칩 수로 안 준다.
판정 규칙을 측정 전 시험(반복 1회)에서 한 번 고쳤다 — 배율 오차 하나로는 k = 1 의 큰 표준오차 때문에 「k = 1 포화」 가 나와 세 지표를 다 보도록. 결과를 본 뒤의 수정이라
스크립트 · 수치 문서에 경위를 남겼다.

### 17. 후속 (2026-10-23) — 등록 뒤 chip02 200k 가 들어와 7장 판: 판정 그대로, 이 판으로 개봉

v4.3 등록([D52-16]) 직후 chip02 100k → 200k 를 승격하면서 교정 glob 의 100k 너머 곡선이 6장 → 7장이 됐다. 블라인드 개봉 전이라 등록 수치가 그대로인지 확인했다 — 7장 판 LOCO
(rows P5 × 20 · 106점) 68% 81.7% · 95% 94.5% · 폭 34,000 · 바깥 폭/대표값 90분위 1.33 · 추정/정답 1.02 · 50-100k 0.84, 등록 수치(81.6 · 94.1 · 34,000 · 1.33 · 0.98 · 0.84)와
같은 판정이고 성공 기준 ③ 값도 같다. 6장 → 7장이 학습 곡선의 포화(빠른 무리 k=3)와 맞게 아무것도 바꾸지 않았다. chip08 은 7장 판으로 개봉한다(S-5 §9 9번 추기).
영웅님 「7장으로 모델 완전하게」 — `A_SESSIONS` 에 chip02 세션 `1792520588` 을 넣고 ρ · R · 합성을 다시 쟀다: R 빠른 2.72 → 2.80(chip02 속도 0.636 → 0.608), ρ 0.00 · 0.78 · 0.21 그대로,
합성 71 · 96. S-5 §2 v4.3 열을 7장 판 수치로 고쳤다(`inverse_v4_3_ceiling` §7).

### 18. 후속 (2026-11-01) — 85°C 온도 칩 둘의 블라인드: 빠른 chip26 은 맞고, 느린 chip23 은 [D52-12] 의 한계가 그대로 터졌다

영웅님 지시: 모델이 확정됐으니 지민 묶음(chip23 · 26, 85°C 온도 PE)을 받아 그것으로 블라인드를 하고, 정답을 같이 받아도 상관없다. 묶음에는 마모 뒤 0-127 newchip 이 없어
(체크포인트 prep 은 섹터 0-6 만) 등록한 입력이 없었고, 영웅님이 보드 A 에서 상온 newchip 1회씩을 바로 쟀다. 그 로그로 `wear_inverse.py` 기본값(v4.3 7장 판)을 돌린 뒤 장부를 열었다.
**chip26**(빠른, 정답 70,000): 관측 2.66배 → 60-61k · 68% 31-85k · 95% 25-100k, 정답 68% 안 · 0.86배 — 성공 기준 셋 통과. 0.86 은 등록 때 잰 50-100k 치우침(0.84) 그대로다.
**chip23**(느린, 정답 26,528): 관측 1.83배 → 92-93k · 68% 91-100k · 95% 78-100k, 정답 밖 · 3.5배 과대 — ① 불통과. 느린 교정 셋은 100k 에서도 1.59-1.75배라 1.83 을 답 범위의
벽까지 밀어 읽었고, 「밴드 밖」 경고는 r 이 흡수해 나오지 않았다. 같은 사이클 배율(26k 1.77)이 상온 chip21(1.79) · chip12(1.69)와 같고 같은 85°C 의 chip22(1.40)와 달라,
원인은 온도가 아니라 [D52-12] 에 「chip21 형이면 전부 틀린다」 로 적어 둔 칩 종류다. 수치 `docs/results/data/blind_temp_chip23_chip26_2026-11.md` · 해석
`docs/results/blind_temp_chip23_chip26.md` · 그림 `plots/blind_temp_chip23_chip26_2026-11.png`.

- [D52-17] **85°C 온도 칩 chip23 · chip26 을 정답 봉인 없이 v4.3 으로 판정하고, 보고서에는 chip06 과 구분해 「모델 고정 판정」 으로 적는다** — 모델 · 교정 표 · 코드는 10/23
  등록 그대로(추정 파일 git_rev `18e06ad`)라 추정이 정답에 끌릴 길이 없고, 빠진 것은 봉인 절차뿐이다. 등록 판정 칩은 chip08 그대로 (2026-11-01, 한영웅) — §18 ·
  S-1 §15 11/01 추기 · S-5 §2

### 19. 후속 (2026-11-11) — chip08 도 봉인 없는 모델 고정 판정으로

chip08 은 등록 판정 칩([D52-16])이었지만 11/5 마모 기록이 대장 커밋(`17b93c6`, 제목 포함 · 푸시됨)과 대화로 판정할 사람(한영웅)에게 이미 드러났다. 봉인을 다시 세우는 안(대장을 안 본 사람이 판정)은 3인 팀이라 가려낼 사람이 없어 버렸다. 남는 것은 [D52-17] 과 같은 근거다 — v4.3 은 10/23 등록 뒤 바뀌지 않았고 chip08 마모(11/5)는 그 뒤라, 추정이 정답에 끌릴 길은 모델 쪽에 없다.

- [D52-18] [D52-16] 의 「chip08 은 봉인 판정」 뒤집음 — **chip08 도 정답 봉인 없이 v4.3 으로 판정하고 「모델 고정 판정」 으로 적는다.** 봉인 판정은 chip06 하나로 남는다 (2026-11-11, 한영웅) — §19
- [D52-19] **chip08 마모 곡선은 교정에서 뺀다** — 30,000 에서 멈춰 0 → 100k 교정 곡선의 재료가 아니다. 승격할 때는 교정 밖(`pe_end.py --no-calib`)으로 한다. 나중에 끝까지 마모하면 그때 교정에 넣을지 다시 정한다 (2026-11-11, 한영웅) — §19

판정 결과(2026-11-11) — 11/5 newchip(`20261105T235448Z`, 관측 1.60배)으로 `wear_inverse.py` 기본값(v4.3 7장 판)을 돌려 기록을 먼저 남긴 뒤 장부와 세션을 열었다.
**chip08**(느린, 정답 30,000): 71-72k · 68% 58-96k · 95% 43-100k, 정답 밖 · 2.38배 과대 — ① 불통과(② ③ 통과). 정답 출처 넷(A5 · 마지막 A 행 · A 행 ÷ 7 · 장부 accept 합)이 같다.
개봉 prep 3분 뒤에 돌린 `build/` 기록(git_rev `452386e`)도 답 줄이 같다. 같은 30k 의 마모 중 배율 1.51 은 느린 교정 셋(1.32-1.36)과 chip12 · 21 형(1.79-1.90) 사이라,
chip23 과 달리 그 형도 아니다 — 교정 셋보다 1.5-2.3배(가운데 chip03 대비 약 1.8배) 빨리 늙어 R 1.59 너머의 중간 속도다. 「밴드 밖」 경고는 이번에도 r 이 흡수해 나오지 않았다. 수치 `docs/results/data/blind_chip08_2026-11.md` · 해석
`docs/results/blind_chip08.md`. 판정 방식은 [D52-18] 그대로라 새 결정은 없다.

## 미결

- **[U52-1] ρ_s · ρ_p 의 등록값** — `--rho --prep-k 5`(교정 8칩 A 행)와 chip06 prep 5회의 값이 비슷하면 중앙값을, 다르면 prep 쪽(실전)을.
  둘이 크게 다르면 마모 루프의 소거와 prep 의 소거가 다른 측정이라는 뜻이라 그 차이부터 적는다
  > **2026-10-09 — 닫음 ([D52-8] · §9).** 0.00 · 0.78, chip06 prep 0.00 · 0.72 로 같아 마모 루프 전체 중앙값. 거기에 ρ_chip 0.29 가 더해졌다
- **[U52-2] v4 등록 여부** — 표 재생성 · ρ · LOCO rows(띠 판정)가 끝나면 한영웅이 S-1 §15 추기로. 띠 밖이면 §5 의 의심 순서대로 하나씩
  > **2026-10-09 — 닫음 ([D52-8] · §10).** 등록했다. 95% 는 ρ_chip 뒤 합격, 68% 는 과소신 그대로
- **[U52-3] 합성 복원을 실험 설계에 쓸 것인가** — prep 횟수 P 를 합성 폭 감소로 정하는 것. 새 10칩 블라인드 절차(개봉 prep 횟수)와 묶인다
- **[U52-5] v4.1 등록 여부** — 9칩 측정(§11, `inverse_v4_1_eval_2026-10.md`)이 끝났다. 등록하면 `MODEL_VERSION` v4.1 · RHO ρ_chip 0.27(잰 값) · S-5 §2 「미등록」 →
  날짜 · S-1 §15 추기. 안 하면 chip08 · 새 10칩 블라인드는 v4(8칩) 그대로. chip04 95% 62% 는 한계 문장으로
  > **2026-10-23 — 닫음 ([D52-16]).** v4.1 은 등록하지 않고 v4.3 을 등록했다
- **[U52-8] 답 범위 상한 100k 의 절단을 어떻게 둘 것인가 (v4.3 의 점 추정)** — 5장 판(§14 추기)에서 과소추정의 원인이 곡선 결핍이 아니라 사전 절단으로 드러났다. 선택지:
  (가) **사후는 곡선이 있는 200k 까지 계산하고, 답은 100k 에 잘라 말한다** — 점 추정은 전체 사후의 중앙값(100k 를 넘으면 「정격 끝」 으로 표기), 구간은 100k 에서 자르되
  「100k 를 넘을 확률 P(x > 100k)」 를 한 줄 더 낸다. 절단 편향이 사라지고 200k 곡선을 쓴 이유가 그대로 설명된다. 블라인드 정답 ≤ 100k · LOCO 채점 ≤ 100k 는 그대로.
  코드는 `posterior()` 의 격자를 지지 상한(200k)과 답 상한(100k)으로 나누는 20줄 안팎 (나) 지금대로 두고 「90k 이상은 범위만 준다」 를 한계 문장으로 (다) 점 추정을
  중앙값 대신 하한 분위수(q10 등)로 바꿔 「적어도」 문장으로 쓴다 — 절단과 무관하게 보수적. 내 제안은 (가), LOCO 로 같은 106점을 다시 채점해 ② 가 0.90 을 넘는지 본다
  (2026-10-19, 영웅님 결정 대기)
  > **2026-10-20 — (가)를 만들어 재 보고 기각했다** (`inverse_v4_3_eval` §3.3). 영웅님이 (가)로 정해 구현(SUPPORT_MAX 200k · p_over · 100k 절단 표시, 테스트 178 통과)하고
  > 106점을 다시 채점하니 50-100k 추정/정답 0.84 → **1.24**(과소 → 과대), 68% 폭 44,000 → **93,000**, 전체 폭 33,000 → 49,000. 빠른 무리 곡선이 160k-200k 에서 평탄해
  > 100k 너머 x 의 우도가 100k 안과 구별이 안 되고, 평평한 사전은 그 질량을 전부 답에 섞는다 — **소거 시간은 100k 너머를 식별하지 못하므로 100k 절단은 편향의 원인이
  > 아니라 「블라인드는 정격 안」 이라는 옳은 사전 지식**이다. 코드는 되돌렸다. MAP 은 상한 근처만 덜 눌리고(100k 0.84) 낮은 x 에서 0.55 라 대안이 못 된다.
  > 남는 것은 (나)+(마): 상한 근처 중앙값 편향(90k 0.75 · 100k 0.72)을 한계로 적고, 95% 상한이 100k 에 닿는 사후는 「정격 끝 근처」 로 표기. 영웅님 결정 대기
  > **2026-10-20 새벽 — 영웅님 「좀 더 고민」 으로 보류.** 고민 재료(`inverse_v4_3_eval` §3.3 · §3.4): ① 왜 200k 곡선이 못 고치나 — 과소추정이 두 종류였고(곡선 결핍 ·
  > 100k 절단) 200k 데이터는 앞 것만 고쳤다(68% 74 → 79%). 절단 쪽은 「정답 100k 의 사후 봉우리를 반으로 자르면 중앙값은 왼쪽」 이라는 산수이고, 자르지 않으면 빠른
  > 무리 160k-200k 평탄 때문에 사후가 200k 까지 늘어져 과대(1.24) · 폭 2배 — 소거 시간은 100k 너머에 눈금이 없는 자다. ② 그 편향은 모델 전체가 아니라 정답 80k
  > 이상에 한정(≤3k 1.17 · 3-20k 1.08 · 20-50k 1.21 · 50-100k 0.84). 실제 블라인드 자리(chip06 12k)는 12-13k 로 정확, 12점 95% 12/12. ③ 블라인드 관점의 진짜 위험은
  > 상한보다 chip21 형(느린 신품 · 빠른 노화, [U52-7])과 20-50k 의 1.2배 과대. ④ 선택지: (나) 한계 문장 「80k 이상은 중앙값이 낮고 구간이 품는다」 · (마) 95% 상한이
  > 100k 에 닿으면 「정격 끝 근처」 표기(코드 10줄) · (다) 하한 분위수 「적어도」 문장 · 또는 조합. 200k 곡선의 값은 1번과 「답 범위 100k 가 데이터로 정한 상한이 됐다」 는
  > 것. v4.3 은 5장 판 상태 그대로, chip07 · 02 200k 뒤 6장 · 7장 판
- **[U52-7] 느린 신품의 두 종류를 어떻게 둘 것인가 (v4.4)** — chip12 · 21 (신품 47-49ms · 빠른 노화 · 미끄럼 · 프로그램 불변) 대 chip03 · 07 · 15. 선택지: (가) 느린 신품은
  두 종류에 사전 확률(2/5 · 3/5)을 나눠 두 교정을 다 쓴다 — 정직하지만 두 봉우리 · 넓은 답 (나) 블라인드 개봉 절차에 짧은 추가 마모 Δx(약 5k)를 넣어 기울기로 가른다 —
  [U52-3] 과 같은 장치, 가장 세다 (다) 적용 범위를 「신품 40ms 미만」 으로 좁히고 느린 신품은 「두 종류 중 하나」 로만 답한다. chip21 의 교정 유지 여부도 여기서(넣으면
  느린 무리 교정이 아니라 세 번째 무리로 가르는 것이 맞다). chip22(65°C) · 23(블라인드)이 어느 종류인지가 결정 재료 (2026-10-19, 영웅님 결정 대기)
  > **2026-10-19 — 순서만 정함 ([D52-12]).** chip21 은 일단 교정에서 빼고(`_nocal`), v4.3 은 답 범위 확장만, 이 종류의 처리는 v4.4 로. 선택지 (가)(나)(다)는 그대로 열림
  > **2026-11-01 — 결정 재료가 생겼다 (§18).** chip23(85°C 블라인드)은 chip12 · 21 형이었고 v4.3 은 3.5배 과대로 틀렸다. chip22 는 느린 · 느린 노화 형. 마모한 느린 신품 일곱 중 셋이 이 형 — 미결 유지, chip23 은 v4.4 의 채점 칩
  > **2026-11-11 — 재료가 하나 더 (§19).** 상온 chip08(블라인드)은 30k 배율 1.51 로 교정 셋(1.32-1.36)과 chip12 · 21 형(1.79-1.90) 사이 — 두 형 어느 쪽도 아니고 v4.3 은 2.38배 과대로 틀렸다.
  > 마모한 느린 신품 여덟. (가)의 「두 형」 전제는 chip08 을 담지 못하고, (나)(다)는 형의 수와 무관하다 — 미결 유지, chip08 도 v4.4 의 채점 칩
  > **2026-11-11 — 방향: 느린 무리 교정 칩을 늘려 모델을 보정한다 (한영웅).** chip08 블라인드 불합격(2.38배 과대, 30k 배율 1.51 = 교정 1.32-1.36 과 빠른 노화 형 1.79-1.90 사이 중간 속도)으로 느린 무리 블라인드 두 칩이 모두 95% 밖이다. 지금 쓸 수 있는 느린 FV 후보는 chip08(30k → 끝까지 이어 마모, [D52-19]) · chip25(미배정 신품) 둘이고, 그 너머는 추가 구매다(신품 측정 전에는 무리를 모른다). 형이 몇 개인지는 칩이 늘어야 보인다
- **[U52-6] 온도 PE 데이터를 모델에 넣을 것인가** — 세은 · 지민은 넣자는 쪽, 영웅님은 이득이 작다는 쪽(10/14). 내 의견은 v4.3 에는 안 넣는다 — 온도 런이 2칩(chip16 · 17,
  둘 다 65°C 설정 · 칩 온도 미확인 · 서로 반대로 늙음)뿐이라 축으로 넣으면 교정이 아니라 칩 정체가 되고, 블라인드는 상온에서 재므로 답에 온도가 없다. 「상온 모델의 적용
  범위(25°C)」 한 줄과 온도 런 해석 문서의 LOCO(상온 모델이 chip16 68% 10/12 · chip17 v2 2/12 — 같은 65°C 가 반대로 읽힘)로 충분. 영웅님 결정 대기
- **[U52-4] 40ms 경계 ±3ms 의 칩** — v4 밖. 틈(34-47ms)에 든 칩은 아직 없고, 블라인드는 우리가 고르지 않으므로 보고서에 「미검증」 한 줄.
  chip14 를 닳게 할지는 [D52-4] 와 함께 다시 결정
  > **2026-10-09 — chip14 는 이미 닳았다 ([D52-4] 추기).** 교정 편입은 [U48-22]. 틈 안의 칩 문제는 그대로 미결
