young-0320/flash-margin-bench/docs/results/data/blind_chip08_2026-11.md

# 블라인드 chip08 — 추정과 판정 (2026-11)

> 수치·절차 기록만 둔다. 해석은 [`../blind_chip08.md`](../blind_chip08.md). 모델은 S-5 v4.3(2026-10-23 등록, 로그 52 [D52-16]) · 판정 방식은 로그 52 §19 [D52-18](모델 고정 판정 — 정답 봉인 없음).

- **칩**: chip08 · UID `D16414615B564524` · 느린 무리(신품 소거 49.5ms, 9/20) · 마킹 `25Q64FVSIG` `1423`(원 배치). 등록 판정 칩([D52-16])이라 교정 밖이다
  - 2026-11-05 상온 섹터 0-6 0 → 30,000 — 세션 `1793893689`, 15:48Z - 21:10Z, 체크포인트 100 · 1k · 3k · 10k · 20k · 30k, 6구간 모두 A1 - A7 PASS. 히터 없음 · 칩 온도 기록 없음
- **정답을 먼저 알았다.** 11/5 마모 기록이 대장 커밋(`17b93c6`, 제목 포함)과 대화로 판정자에게 드러나 봉인하지 않았다([D52-18]). 모델(`wear_inverse.py` · 교정 표 · ρ · R)은
  10/23 등록 뒤 수치가 바뀌지 않았다 — chip23 · 26 추정 때(`18e06ad`) 이후 `wear_inverse.py` 의 변경은 화면 스파크라인 두 줄 주석 처리(`4ead523`)뿐이고, 교정 표 폴더에는
  glob 밖의 온도 곡선 둘(`_85C` · `_84C`)만 늘었다. 추정 기록의 교정 표 9장은 chip26 기록과 같다
- **개봉 prep 직후의 기록도 같다.** 개봉 prep 3분 뒤(2026-11-05 23:59Z, git_rev `452386e`) 같은 입력(sha256 같음)으로 돌린 기록이 `build/inverse/blind_chip08_2026-11-06.txt` 에 있고
  답 줄이 아래 기록과 한 글자도 다르지 않다. 커밋되지 않은 파생물이라 정본은 아래 기록이다
- **개봉 prep**: 상온 newchip 1회 — 2026-11-05 23:54Z, 마모가 끝나고(30k 체크포인트 스윕 21:09Z) 약 2.7시간 뒤, 히터 없이(온도 로그 없음). 보드는 마모와 같은 Digilent `…BFB07D`
  (박지민 보드 B 의 chip26 마모는 `…BE5E74`)
  - `data/session_chip08_D16414615B564524_20261105T235448Z.log` (sha256 `041dffbd…`)
- **추정 기록**: [`chip08_estimate_v4.3.txt`](chip08_estimate_v4.3.txt) — 머리말에 코드(git_rev `caa77c8`) · 인자 · 입력 sha256 · 교정 표 9장

## 1. 관측

| 칩 | 기준 32-127 (신품 대비) | 근접 7-13 (신품 대비) | 마모 0-6 중앙값 | 관측 배율 0-6 ÷ 32-127 | 섹터 0-6 소거 (ms) |
|---|---|---|---|---|---|
| chip08 | 48.7ms (49.5 · 0.98) | 50.2ms (49.4 · 1.02) | 77.9ms | **1.60** | 77.9 · 80.1 · 80.0 · 72.2 · 86.2 · 72.5 · 73.9 |

prep PASS(2,048 페이지 검증 · blank_post 0) · 스윕 VALID 2,520 행. 신품값은 9/20 newchip(`data/session_chip08_D16414615B564524_20260920T072456Z.log`)의 같은 섹터군.

## 2. 추정 (v4.3 7장 판, `--model v4.3` 기본값)

| 칩 | 무리 · 교정 칩 | R | 대표값 (사후 평균) | 중앙값 | MAP | 68% | 95% |
|---|---|---|---|---|---|---|---|
| chip08 | 느린 · chip03 · 07 · 15 | 1.59 | **71,001-72,000** | 71,001-72,000 | 76,001-77,000 | 58,001-96,000 | 43,001-100,000 |

재현: `uv run python host/analysis/wear_inverse.py data/session_chip08_D16414615B564524_20261105T235448Z.log --out <파일>` (ρ_s 0 · ρ_p 0.78 · ρ_chip 0.21 · n_eff 3.10).
기록에 「주의」 줄(곡선 최우 지점의 밴드 밖 관측)은 없다. 화면의 판정은 고마모(정격의 60% 이상) · 확률 72%.

## 3. 정답

| 칩 | 정답 x | 정본 | 섹터 0-6 이 겪은 P/E 전부 |
|---|---|---|---|
| chip08 | **30,000** | 세션 `1793893689` 마지막 구간(20,000 → 30,000) A5 — 카운터 30,000 · A 행 ÷ 7 30,000 · tally × 100 30,000 · B 의 cycle 30,000. 마지막 A 행 cycle 30,000, A 행 210,000 에 cycle 1-30,000 이 빠짐없이 7행씩. 장부의 `run_wear accept` 증분 합(100 + 900 + 2,000 + 7,000 + 10,000 + 10,000)도 30,000 | 30,008 (+ 신품 prep 1 · 체크포인트 6 · 개봉 prep 1) |

정답 x 는 마모 사이클만 센 값으로 교정 곡선의 x 와 같은 정의다(chip06 · 23 · 26 과 같음). 출처 넷이 같아 고를 것이 없다.

## 4. 성공 기준 (S-5 §8)

| 기준 | chip08 |
|---|---|
| ① 정답 ∈ 95% | 43,001-100,000 — **불통과** |
| ② 68% 바깥 폭 ≤ 60,000 | 38,000 — 통과 |
| ③ 68% 바깥 폭 ÷ 대표값 ≤ 1.33 | 38,000 ÷ 71,500 = 0.53 — 통과 |
| (참고) 정답 ∈ 68% | 아니오 |
| (참고) 대표값 ÷ 정답 | **2.38** |

## 5. 정답의 자리 (같은 입력 · 같은 코드로 사후분포를 다시 계산)

| 칩 | 정답이 든 구간 | 그 구간보다 아래일 확률 | 정답 구간의 확률 순위 | 정답 구간의 확률 |
|---|---|---|---|---|
| chip08 | 29,001-30,000 | 0.02% | 71 / 100 | 0.017% |

`main` 과 같은 경로(기본 인자)로 `invert` 의 사후분포를 받아 셌다. 같은 계산이 chip26 · chip23 의 선례 값(60.5% · 37 / 100 · 1.27%, 0.00% · 74 / 100)을 그대로 다시 낸다.

## 6. 같은 사이클의 마모 중 곡선 (참고 — 추정에는 쓰지 않음)

섹터 0-6 의 1k 구간 p50 중앙값 ÷ 신품값(`temp_wear_summary.ratio_curve`, 선례 §6 과 같은 계산). chip08 곡선은 승격 전이라 A 행에서 `build/` 로만 만들었다 —
`uv run python host/analysis/wear_curves.py --chip chip08 data/wear/1793893689 -o build/scratch/chip08_blind/wear_curves_chip08_2026-11.csv`(A 행 210,000 · 뺀 구간 없음), 신품값 49,528us(집계표).

| 칩 (이력) | 10k | 20k | 26k | 30k | 60k | 70k | 100k |
|---|---|---|---|---|---|---|---|
| **chip08 (상온)** | 1.29 | 1.36 | 1.45 | **1.51** | - | - | - |
| chip03 · 07 · 15 (상온 느린 교정) | 1.17-1.22 | 1.26-1.30 | 1.28-1.33 | 1.32-1.36 | 1.51-1.54 | 1.49-1.61 | 1.59-1.75 |
| chip22 (85°C) | 1.24 | 1.35 | 1.40 | 1.42 | 1.62 | 1.75 | 1.90 |
| chip12 (상온, 교정 밖 `_ali` · 느린 신품 빠른 노화) | 1.41 | 1.62 | 1.69 | 1.79 | 2.06 | 2.22 | 2.58 |
| chip21 (상온, 교정 밖 `_nocal` · 같은 형) | 1.49 | 1.72 | 1.79 | 1.90 | 2.53 | 2.56 | 2.64 |
| chip23 (85°C, 같은 형) | 1.40 | 1.61 | 1.77 | - | - | - | - |

- 60k 의 교정 범위에 chip07 은 없다(결측). chip08 의 30k 는 마모 중 1.51, 개봉 newchip(같은 prep 의 32-127 로 나눔) 1.60 이다
- 교정 칩이 1.51 에 처음 닿는 1k 구간: chip15 45k · chip03 54k · chip07 68k (chip22 44k). chip08 은 30k 에 닿았다
- 프로그램 시간(1k 구간 p50 중앙값 ÷ 첫 1k 구간)의 30k 값: chip08 1.01 · chip03 1.03 · chip15 1.02 · chip07 1.36 · chip12 1.00 · chip21 1.01 · chip22 1.15 —
  30k 에서는 느린 교정 칩 둘(chip03 · 15)도 평평해 형을 가르지 못한다
