young-0320/flash-margin-bench/docs/results/data/sweep_chip01_20260708T164931Z.md

# sweep_chip01_20260708T164931Z — 실칩 반복 5회 대표 런 (게재 4번 후보)

**※ 3인 회의 안건** — 채택 클럭(25MHz)·체크1 거취(로그 15 상정안)가 정해져야 확정된다.
체크리스트는 셋이 동시에 지키는 판정 규약이라 혼자 정하지 않는다.

- **무엇**: chip01(W25Q64) 25MHz 스윕, D5 연속 반복 5회 중 1회차(대표).
  짝 그림: `../plots/bathtub/v1/bathtub_chip01_repeat5.png` (곡선 1장 + 에러바 = 게재 4번 양식)
- **집계 (n=5, 재장착 없음, 2026-07-09 01:49~02:14 KST 연속)**:
  - width@1e-2 = **39,737.3 ± 0.61 ps** (min 39,736.6 / max 39,738.0)
  - width@1e-3 = 39,724.2 ± 0.79 ps · width@1e-4 = 39,710.6 ± 0.95 ps
  - θ 3값 폭 수렴(총 27ps) — 로그 15 "θ-수렴 직독" 상정안의 근거
- **5회 원본**: `data/sweep_chip01_20260708T16{4931,5433,5935}Z.csv`,
  `...T170437Z.csv`, `...T170939Z.csv` (+각 `_reads`) — D7 보관, 전부 valid=1
- **체크리스트**: 2(floor≤3.3e-9)·4(F=0.48)·5 PASS / 1 SKIP(구조적 — 로그 15)
- **재현**: `#PREP PASS` 상태에서
  `sweep_uart_capture.py --target chip01` + `xsct ps/scripts/program_g3.tcl 25` ×5
  → `.venv/bin/python host/analysis/repeatability_aggregate.py <5개 csv>`
- 관련: 로그 15 (사다리 3점·상정안) · 런북 3 D5·D6 · git_rev 724baf9
