young-0320/flash-margin-bench/docs/results/data/temp_chip17_2026-10.md

# temp_chip17_2026-10 — chip17 온도 마모 런의 칩 위 온도 (전체 · 구간별 · 시간별)

> 수치와 표만 둔다. 해석·판정은 [`../wear/wear_temperature_chip17.md`](../wear/wear_temperature_chip17.md). 마모 수치는 [`wear/wear_endurance_chip17_2026-10.md`](wear/wear_endurance_chip17_2026-10.md).

- **무엇**: chip17 65°C 마모 런(2026-10-01 19:43 → 10-02 12:40 KST) 동안 `hw/temp_logger.py` 가 1초마다 남긴 온도를, 마모 세션 로그의
  시각(UTC)으로 마모 구간 13개와 체크포인트 측정 26개(prep · 스윕)에 나눠 낸 통계. 표본 60,908 개
- **센서**: TMP117 을 칩 위 필름 히터 곁에 붙였다 — **다이 온도가 아니라 센서 자리 온도**다. 제어는 아두이노 PWM(최대 220/255 = 86.3%)
- **파일**: [`temp_chip17_intervals_2026-10.csv`](temp_chip17_intervals_2026-10.csv) (구간·측정·전체, 한 행 = 시간 창 하나) ·
  [`temp_chip17_hourly_2026-10.csv`](temp_chip17_hourly_2026-10.csv) (KST 시간별). 열: `mean_c`·`sd_c`·`min_c`·`p5_c`·`p95_c`·`max_c` ·
  `in_63_67_pct`(63-67°C 안 비율) · `run_pct`(히터 RUN 상태 비율) · `setpoint_c`(그 창의 RUN 설정값) · 시간별 표의 `wear_pct`·`measure_pct`(마모·측정 중 비율)
- **짝 그림**: [`../plots/temp/temp_chip17_timeline_2026-10.png`](../plots/temp/temp_chip17_timeline_2026-10.png) — 시계 축, 1초 측정 · 시간별 평균 · 설정 온도 ·
  체크포인트 측정 띠 · [`../plots/wear/wear_temp_chip17_2026-10.png`](../plots/wear/wear_temp_chip17_2026-10.png) 윗칸 — 사이클 축, 구간 평균(띠 5-95%) · prep 중 온도
- **원본**: `data/temp_chip17_65C_20261001T104343Z.csv` · `data/temp_chip17_68C_20261002T023819Z.csv` · `data/temp_chip17_68C_20261002T032602Z.csv`
  (파일 이름의 65C·68C 는 로거를 켤 때 붙인 라벨이다. 설정값은 CSV `target_c` 열이 정본). 사이에 42초·21초 공백

## 1. 전체

| 창 | 길이 | 평균 (°C) | sd | 5-95% | 최저 | 63-67°C 안 |
|---|---|---|---|---|---|---|
| **마모 구간 전체 (시간 가중)** | 15.1 시간 | **65.22** | 1.18 | 64.37 - 66.47 | 44.91 | 97.2% |
| 마모 구간 전체 (사이클 가중) | 100,000 사이클 | 65.17 | — | — | — | — |
| 체크포인트 측정 전체 | 1.4 시간 | 64.39 | 1.80 | 62.95 - 65.48 | 46.98 | 94.9% |
| 로그 전체 | 16.9 시간 | 65.14 | 1.28 | 63.95 - 66.45 | 44.91 | 96.9% |

사이클 가중 = 구간 평균을 그 구간의 사이클 수로 가중한 값(마모 1회가 겪은 평균 온도).

## 2. 설정 온도와 상태 (로그의 `target_c`·`state` 가 바뀐 자리, KST)

| 시각 | 설정 · 상태 | 길이 | 평균 (°C) | PWM 듀티 평균 | 무엇 |
|---|---|---|---|---|---|
| 10-01 19:43:46 | 80 · OFF | 13초 | 62.5 | 0% | 로거 시작 → 아두이노 리셋(기본값) |
| 10-01 19:44:00 | **65 · RUN** | 3.5시간 | 64.40 | 76.4% | 제어 중 — 출력이 0 근처로 내려갔다 늦게 회복하는 골이 12번(62°C 아래, 최저 58.3) |
| 10-01 23:11:37 | **68 · RUN** | 12.4시간 | 65.39 | 86.3% | 듀티가 상한에 붙음 — 제어 없이 열평형, 65-66.5°C |
| 10-02 11:38:21 | 80 · OFF | 55초 | 53.8 | 0% | 로거 재시작 → 리셋. 최저 44.9°C (90k → 100k 구간 중) |
| 10-02 11:39:18 | 68 → 66 → 67 · RUN | 46분 | 61.4 - 66.2 | 77-86% | 회복 · 설정 조정 |
| 10-02 12:26:05 | 80 · OFF | 41초 | 55.3 | 0% | 로거 재시작 → 리셋. **100k 체크포인트 prep·스윕과 겹침**, 최저 47.0°C |
| 10-02 12:26:47 | 66 · RUN | 13분 | 63.57 | 85.3% | 마모 끝난 뒤 |

## 3. 마모 구간별

| 구간 | 길이 (분) | 평균 (°C) | sd | 5-95% | 최저 | 63-67°C 안 | 설정 |
|---|---|---|---|---|---|---|---|
| 0 → 100 | 0.7 | 65.12 | 0.06 | 65.00 - 65.19 | 64.99 | 100% | 65 |
| 100 → 1,000 | 6.0 | 65.05 | 0.06 | 64.96 - 65.16 | 64.94 | 100% | 65 |
| 1,000 → 3,000 | 13.8 | 63.37 | 2.35 | 58.55 - 65.24 | 58.31 | 68.6% | 65 |
| 3,000 → 10,000 | 50.7 | 64.10 | 1.54 | 59.73 - 65.07 | 58.37 | 86.5% | 65 |
| 10,000 → 20,000 | 76.8 | 64.89 | 0.72 | 64.84 - 65.16 | 58.43 | 97.8% | 65 |
| 20,000 → 30,000 | 81.8 | 64.98 | 1.39 | 61.53 - 65.88 | 58.41 | 92.4% | 65 → 68 |
| 30,000 → 40,000 | 86.1 | 64.90 | 0.22 | 64.57 - 65.29 | 64.44 | 100% | 68 |
| 40,000 → 50,000 | 89.1 | 64.89 | 0.20 | 64.66 - 65.25 | 64.05 | 100% | 68 |
| 50,000 → 60,000 | 92.2 | 66.26 | 0.25 | 66.04 - 66.56 | 64.61 | 100% | 68 |
| 60,000 → 70,000 | 97.0 | 65.50 | 0.21 | 65.23 - 65.91 | 65.16 | 100% | 68 |
| 70,000 → 80,000 | 102.0 | 65.16 | 0.14 | 64.96 - 65.39 | 64.28 | 100% | 68 |
| 80,000 → 90,000 | 104.4 | 65.33 | 0.26 | 64.85 - 65.72 | 64.24 | 100% | 68 |
| 90,000 → 100,000 | 108.2 | 65.73 | 2.30 | 61.92 - 66.66 | 44.91 | 94.0% | 66 · 67 · 68 |

체크포인트 26개 창(prep 약 25초 · 스윕 약 6분)의 같은 통계는 CSV 의 `checkpoint_prep`·`checkpoint_sweep` 행이다. 체크포인트별 평균은
[`wear/wear_endurance_chip17_2026-10.md`](wear/wear_endurance_chip17_2026-10.md) §1 의 온도 열에 옮겼다 — 3,000 prep 61.4°C 와 100,000 prep 62.8 · 스윕 60.9°C 말고는 63.9-66.1°C.

## 4. 시간별 (KST)

| 시각 | 평균 (°C) | sd | 최저 | 최고 | 63-67°C 안 | 설정 | 마모 중 | 측정 중 |
|---|---|---|---|---|---|---|---|---|
| 10-01 19시 (19:43-) | 64.50 | 1.73 | 55.59 | 67.49 | 91.2% | 65 · 70 | 6.5% | 41.2% |
| 20시 | 64.08 | 1.65 | 58.31 | 65.32 | 85.5% | 65 | 76.8% | 21.9% |
| 21시 | 64.64 | 1.05 | 58.50 | 65.94 | 94.6% | 65 | 88.3% | 11.1% |
| 22시 | 64.62 | 1.17 | 58.43 | 65.34 | 93.2% | 65 | 88.3% | 11.1% |
| 23시 | 64.95 | 1.34 | 58.41 | 65.94 | 92.7% | 65 → 68 | 100% | 0% |
| 10-02 00시 | 65.25 | 0.38 | 64.62 | 66.23 | 100% | 68 | 88.2% | 11.1% |
| 01시 | 64.71 | 0.34 | 63.70 | 65.59 | 100% | 68 | 88.3% | 11.0% |
| 02시 | 64.80 | 0.09 | 64.56 | 65.17 | 100% | 68 | 100% | 0% |
| 03시 | 65.55 | 0.66 | 64.46 | 66.55 | 100% | 68 | 87.0% | 11.0% |
| 04시 | 66.29 | 0.13 | 66.01 | 66.59 | 100% | 68 | 100% | 0% |
| 05시 | 65.71 | 0.23 | 65.21 | 66.23 | 100% | 68 | 88.2% | 11.1% |
| 06시 | 65.21 | 0.29 | 64.36 | 65.50 | 100% | 68 | 88.2% | 11.1% |
| 07시 | 65.19 | 0.12 | 65.01 | 65.43 | 100% | 68 | 100% | 0% |
| 08시 | 64.94 | 0.42 | 63.52 | 65.32 | 100% | 68 | 88.2% | 11.1% |
| 09시 | 65.33 | 0.14 | 65.12 | 65.68 | 100% | 68 | 100% | 0% |
| 10시 | 65.69 | 0.41 | 64.94 | 66.52 | 100% | 68 | 88.3% | 11.1% |
| 11시 | 65.24 | 2.99 | 44.91 | 66.66 | 89.1% | 66 · 67 · 68 | 100% | 0% |
| 12시 (-12:40) | 65.35 | 2.86 | 46.98 | 66.71 | 92.3% | 66 · 67 | 64.6% | 16.2% |

## 재현

```bash
uv run python host/analysis/temp_wear_summary.py --chip chip17 --sessions data/wear/1790851785 data/wear/1790879592 \
    --temp 'data/temp_chip17_*.csv' --curves build/data/wear_curves_chip17_65C.csv
# → build/data/temp_chip17_intervals.csv · temp_chip17_hourly.csv · build/plots/temp_chip17_timeline.png (이 폴더로 옮기며 _2026-10 을 붙였다)
```
