young-0320/flash-margin-bench/docs/results/data/temp_chip22_2026-10.md

# temp_chip22_2026-10 — chip22 85°C 마모 런의 센서 온도

> 수치와 표만 둔다. 해석은 [`../wear/wear_temperature_85C.md`](../wear/wear_temperature_85C.md). 마모 수치는 [`wear/wear_endurance_chip22_2026-10.md`](wear/wear_endurance_chip22_2026-10.md).

- **무엇**: 온도 컨트롤러(TMP117 + 필름 히터 + 아두이노 PWM)가 1초마다 남긴 센서 온도를 마모 세션 시각으로 구간 · 체크포인트 · 시간별로 나눈 통계. 설정 85°C(로그의 `target_c`)
- **요약**: 마모 구간 시간 가중 85.01°C · sd 0.23 · 82.8-85.9 · 85±2 안 100%
- **파일**: [`temp_chip22_intervals_2026-10.csv`](temp_chip22_intervals_2026-10.csv) · [`temp_chip22_hourly_2026-10.csv`](temp_chip22_hourly_2026-10.csv) · 그림 [`../plots/temp/temp_chip22_timeline_2026-10.png`](../plots/temp/temp_chip22_timeline_2026-10.png) · [`../plots/wear/wear_temp_chip22_2026-10.png`](../plots/wear/wear_temp_chip22_2026-10.png).
  열 `in_63_67_pct` 는 65°C 런 때 이름 그대로이고 이 런에서는 **설정 ±2°C(83-87) 안** 비율이다(`temp_wear_summary.py` 10/23)
