young-0320/flash-margin-bench/docs/results/data/temp_chip23_2026-10.md

# temp_chip23_2026-10 — chip23 85°C 마모 런의 센서 온도

> 수치와 표만 둔다. 해석은 [`../wear/wear_temperature_85C.md`](../wear/wear_temperature_85C.md). 마모 수치는 [`wear/wear_endurance_chip23_2026-10.md`](wear/wear_endurance_chip23_2026-10.md).

- **무엇**: 온도 컨트롤러(TMP117 + 필름 히터 + 아두이노 PWM)가 1초마다 남긴 센서 온도를 마모 세션 시각으로 구간 · 체크포인트 · 시간별로 나눈 통계. 설정 85°C(로그의 `target_c`) · 마모는 2026-10-18 13:50Z USB 끊김 · 13:57Z 히터 센서 FAULT 로 26,528 에서 멈췄다
- **요약**: 마모 구간 시간 가중 85.01°C · sd 0.23 · 84.2-85.8 · 85±2 안 100%
- **파일**: [`temp_chip23_intervals_2026-10.csv`](temp_chip23_intervals_2026-10.csv) · [`temp_chip23_hourly_2026-10.csv`](temp_chip23_hourly_2026-10.csv) · 그림 [`../plots/temp/temp_chip23_timeline_2026-10.png`](../plots/temp/temp_chip23_timeline_2026-10.png) · [`../plots/wear/wear_temp_chip23_2026-10.png`](../plots/wear/wear_temp_chip23_2026-10.png).
  열 `in_63_67_pct` 는 65°C 런 때 이름 그대로이고 이 런에서는 **설정 ±2°C(83-87) 안** 비율이다(`temp_wear_summary.py` 10/23)
