young-0320/flash-margin-bench/docs/results/data/temp_chip26_2026-10.md

# temp_chip26_2026-10 — chip26 85°C 마모 런의 센서 온도

> 수치와 표만 둔다. 해석은 [`../wear/wear_temperature_85C.md`](../wear/wear_temperature_85C.md). 마모 수치는 [`wear/wear_endurance_chip26_2026-10.md`](wear/wear_endurance_chip26_2026-10.md).

- **무엇**: 온도 컨트롤러(TMP117 + 필름 히터 + 아두이노 PWM)가 1초마다 남긴 센서 온도를 마모 세션 시각으로 구간 · 체크포인트 · 시간별로 나눈 통계. 설정 85°C(로그의 `target_c` — 05:27Z 에 80°C 로 잠깐 줬다가 05:29Z 부터 85°C, 마모 시작은 06:42Z)
- **요약**: 마모 구간 시간 가중 84.08°C · sd 1.29 · 78.6-85.4 · 85±2 안 68%(설정 85°C 인데 초반 0-30k 는 79-83°C 에 머물렀고 30k 체크포인트 무렵 85°C 에 닿았다 · 33,100 이후는 85.0°C 로 평탄 — 원인은 로그에 없다)
- **파일**: [`temp_chip26_intervals_2026-10.csv`](temp_chip26_intervals_2026-10.csv) · [`temp_chip26_hourly_2026-10.csv`](temp_chip26_hourly_2026-10.csv) · 그림 [`../plots/temp/temp_chip26_timeline_2026-10.png`](../plots/temp/temp_chip26_timeline_2026-10.png) · [`../plots/wear/wear_temp_chip26_2026-10.png`](../plots/wear/wear_temp_chip26_2026-10.png).
  열 `in_63_67_pct` 는 65°C 런 때 이름 그대로이고 이 런에서는 **설정 ±2°C(83-87) 안** 비율이다(`temp_wear_summary.py` 10/23)
