young-0320/flash-margin-bench/docs/results/wear/wear_temperature_85C.md

# 85°C 온도 마모 결과 해석 — chip22 (느린 무리) · chip24 (빠른 무리), 0 → 100,000 사이클 (+ 2026-11-01 chip26 · chip23)

- **작성일**: 2026-10-23 · **측정**: chip22 2026-10-17 - 10-18 · chip24 2026-10-20 - 10-21 (박지민, 보드 B)
- **수치**: [`data/wear/wear_endurance_chip22_2026-10.md`](../data/wear/wear_endurance_chip22_2026-10.md) · [`data/wear/wear_endurance_chip24_2026-10.md`](../data/wear/wear_endurance_chip24_2026-10.md) ·
  온도 [`data/temp_chip22_2026-10.md`](../data/temp_chip22_2026-10.md) · [`data/temp_chip24_2026-10.md`](../data/temp_chip24_2026-10.md) — 표를 다시 싣지 않고 거기를 인용한다
- **2026-11-01 추기**: chip26(빠른 · 84°C · 0 → 70,000) 과 chip23(느린 · 85°C · 0 → 26,528) 을 승격하고 상온 newchip 으로 블라인드 판정했다 — §5 · [`../blind_temp_chip23_chip26.md`](../blind_temp_chip23_chip26.md). 수치 [`data/wear/wear_endurance_chip26_2026-10.md`](../data/wear/wear_endurance_chip26_2026-10.md) · [`data/wear/wear_endurance_chip23_2026-10.md`](../data/wear/wear_endurance_chip23_2026-10.md) · 온도 [`data/temp_chip26_2026-10.md`](../data/temp_chip26_2026-10.md) · [`data/temp_chip23_2026-10.md`](../data/temp_chip23_2026-10.md)
- **비교 대상**: 65°C 칩 [`wear_temperature_chip16.md`](wear_temperature_chip16.md) · [`wear_temperature_chip17.md`](wear_temperature_chip17.md), 상온 교정 칩(같은 무리), chip23(85°C · 느린 · 26.5k 에서 중단)
- **경위**: 로그 53 §5

## 결론

**65 · 85°C 마모 이력 네 칩의 소거 · 프로그램 노화는 상온 칩의 개체 산포 안에 있었고, 온도에 따른 일관된 방향은 보이지 않았다.** 빠른 무리는 온도 칩 셋(65°C chip16 · 17,
83°C chip24)이 상온 6칩 사이에 고르게 흩어졌고(100k 배율 순위 1 · 5 · 9 / 9), 느린 무리의 chip22(85°C)는 상온 느린 세 칩보다 조금 빨리 늙었지만 상온 느린 신품의 개체 산포(5칩 중
2칩이 빠른 형)를 넘지 않는다. 상온 교정 모델의 95% 구간은 네 칩 48점 중 47점을 품었고(68% 는 22/48), **85°C 까지 범위 답은 유지된다.** 설정은 85°C 가 의도였다(영웅님).

| 칩 | 온도 (마모 구간) | 무리 | 소거 100k (÷ 신품) | 계단 | 프로그램 100k (÷ 첫 1k) | 상온 모델 held-out 68% · 95% |
|---|---|---|---|---|---|---|
| chip24 | 83.5°C (79.6-85.9) | 빠른 | 3.47 | 3섹터 78-100k | 1.00 | 12/12 · 12/12 |
| chip22 | 85.0°C (82.8-85.9) | 느린 | 1.90 | 없음 | 1.64 | 3/12 · 12/12 |
| chip26 (11/1) | 약 84°C (처음 30k 81-83) | 빠른 | 70k 2.47 (newchip 2.66) | 없음(70k 까지) | 1.00 | 블라인드 60.5k · 68% 31-85k — 정답 70k 안 |
| chip23 (11/1) | 85.0°C | 느린 | 26k 1.77 (newchip 1.83) | 없음 | 평평 | 블라인드 92.5k · 95% 78-100k — 정답 26.5k 밖 |
| chip16 | 65°C 설정 | 빠른 | 4.34 | 7/7 | 1.00 | 6/12 · 12/12 |
| chip17 | 65.2°C | 빠른 | 2.44 | 없음 | 1.20 | 1/12 · 11/12 |
| 상온 빠른 6칩 | 25°C | 빠른 | 2.60-3.97 | 6/6(chip02 는 200k 안) | 1.00-2.09 | 약 80% · 95% (LOCO) |
| 상온 느린 3칩 | 25°C | 느린 | 1.59-1.75 | 없음 | 1.21-2.15 | 〃 |

## 1. 빠른 무리 — 85°C 도 상온 한가운데

chip24 는 소거 100k 3.47배로 상온 빠른 6칩(2.60-3.97) 한가운데이고, 계단(섹터 1 · 3 · 5 가 78-100k, 높이 17-21ms) · 프로그램 불변(6.86-6.91ms)까지 상온 빠른 칩과 같다.
상온 교정 모델로 held-out 채점하면 68% 12/12 · 95% 12/12 로 상온 칩보다도 잘 맞는다. 65°C 의 chip16(가장 빠름) · chip17(가장 느림)과 합쳐 온도 칩 셋의 평균 순위가 정확히
가운데(5/9)다 — 빠른 무리에서 25°C 와 65 · 85°C 를 가를 근거가 없다.

## 2. 느린 무리 — 신호는 있으나 개체차와 겹친다

chip22 는 10k 1.24 · 50k 1.54 · 100k 1.90 으로 상온 느린 세 칩(100k 1.59-1.75) 위에 있고, 상온 모델은 10k-70k 에서 사이클을 1.4-1.9배 높게 읽는다(68% 3/12, 95% 는 12/12).
같은 85°C 의 chip23 도 20k 에 1.53 으로 상온 느린 칩(1.26-1.30)보다 위였다. 그러나 ① 상온에서도 느린 신품 5칩 중 2칩(chip12 · 21)이 20k 1.62-1.72 · 100k 2.6 으로
더 빨리 늙었고, chip23 은 프로그램이 평평해 그 형의 모양이다 ② 고온에서는 갇힌 전하가 더 잘 빠져 마모가 덜 쌓이는 것이 일반적 기대라 관찰과 방향이 반대다. 느린 85°C 의
신호는 사실상 chip22 한 칩이고, n=1 로는 온도와 개체를 가르지 못한다.

## 3. 마진 · 대조군

폭은 chip22 체크포인트 100 대비 +17ps 안 · chip24 +6ps 안으로 3σ 안(H1′ 참). 100k 뒤 기준 섹터 32-127 은 chip22 1.00 · chip24 1.11, 근접 7-13 은 1.11 · 1.43 —
chip24 의 근접 교란이 지금까지 칩 중 가장 크다(상온 1.06-1.15). 고온에서 근접 섹터 교란이 커지는지는 이 한 칩으로 말하지 않는다.

## 4. 한계

- 칩 온도는 센서 자리 온도(센서 · 히터 위치 기록 없음). chip24 는 초반 30k 동안 81-84°C 로 설정보다 낮았다
- 느린 무리 85°C 는 한 칩(chip22)뿐 *(11/1 — chip23 은 chip12 · 21 형이라 이 짝에 못 쓴다, §5)*. chip23 을 100k 까지, 같은 배치 느린 신품 하나를 상온으로 돌리면 「같은 배치 · 25 대 85°C」 짝이 생긴다
- 모델에 온도 축을 넣지 않는다(로그 52 [U52-6]) — 고온 이력 칩에는 범위(95%)로 답한다

## 5. 2026-11-01 추기 — chip26 · chip23 과 블라인드

**빠른 무리는 세 번째 85°C 칩도 상온 안, 느린 무리의 두 번째 85°C 칩은 상온의 다른 형과 같은 자리였다.** chip26 은 70k 에서 멈췄고(설정 85°C, 센서 처음 30k 81-83°C ·
뒤 85.0°C) 마모 중 배율 2.47 로 상온 빠른 교정 칩 중 가장 느린 chip09(2.66) 바로 아래를 따라 왔다 — chip24 와 함께 빠른 무리 85°C 둘이 상온 산포 안이다. 폭은 40k 에서 −32ps
한 번 내려가 그대로(33.1k 재개 세션의 재장착, 3σ 안). chip23 은 26k 배율 1.77 로 상온 chip21(1.79) · chip12(1.69)와 같은 자리, 같은 배치 · 같은 85°C 의 chip22(1.40)와는
멀다 — §2 의 「chip12 · 21 형 모양」 이 맞았고, 느린 무리의 85°C 신호는 여전히 chip22 한 칩이다.

두 칩을 상온 newchip 1회로 v4.3 블라인드 판정했다(정답 봉인 없이 모델 고정): chip26 은 68% 안 · 0.86배로 합격, chip23 은 3.5배 과대 · 95% 밖으로 불합격 —
실패는 온도가 아니라 v4.3 이 한계로 적어 둔 칩 종류([D52-12] · [U52-7])에서 왔다. 해석은 [`../blind_temp_chip23_chip26.md`](../blind_temp_chip23_chip26.md).
그림 [`../plots/wear/wear_temp_chip26_2026-10.png`](../plots/wear/wear_temp_chip26_2026-10.png) · [`../plots/wear/wear_temp_chip23_2026-10.png`](../plots/wear/wear_temp_chip23_2026-10.png) ·
[`../plots/blind_temp_chip23_chip26_2026-11.png`](../plots/blind_temp_chip23_chip26_2026-11.png). 11/1 에 `temp_wear_summary.py` 의 온도 축 · x 축을 설정값 · 칩 끝에 맞게 고쳐
chip22 · 24 의 두 그림도 다시 그렸다(전에는 85°C 선이 55-69°C 축 밖이라 위 칸이 비어 있었다).

## 보고서 문장 (제안)

- 「65-85°C 마모 이력 네 칩의 소거 · 프로그램 노화는 상온 칩의 개체 산포 안에 있었고 온도에 따른 일관된 방향은 보이지 않았다. 상온 교정 모델의 95% 구간은 이 칩들에서도
  48점 중 47점을 품어 85°C 까지 범위 답은 유지되지만, 68% 구간과 점 추정은 상온보다 넓게 빗나갔다(22/48) — 고온 이력 칩에는 범위로 답한다」
