young-0320/flash-margin-bench/docs/results/wear/wear_temperature_chip16.md

# 온도 마모 결과 해석 — chip16, 히터 설정 65°C (센서 평균 64°C), 0 → 100,000 사이클

- **작성일**: 2026-10-12 · **측정**: 2026-10-08 13:46 - 10-09 15:01 KST (보드 B, 박지민) · 100k 뒤 사다리 · newchip 10-09 15:01 - 15:15 KST (식히지 않음)
- **수치**: [`data/wear/wear_endurance_chip16_2026-10.md`](../data/wear/wear_endurance_chip16_2026-10.md) (체크포인트 · 1k 구간 배율 · 100k 뒤 사다리 · 현장 역산) ·
  [`data/temp_chip16_2026-10.md`](../data/temp_chip16_2026-10.md) (온도 전체 · 상태 변화 · 구간별 · 시간별) ·
  [`data/chip16_loco_2026-10.md`](../data/chip16_loco_2026-10.md) (상온 v4 모델로 맞히기 · 교정에 넣었을 때) — 표를 다시 싣지 않고 인용한다
- **그림**: [`plots/wear/wear_temp_chip16_2026-10.png`](../plots/wear/wear_temp_chip16_2026-10.png) (사이클 축: 온도 · 폭 변화 · 소거 배율) ·
  [`plots/temp/temp_chip16_timeline_2026-10.png`](../plots/temp/temp_chip16_timeline_2026-10.png) (시계 축 온도)
- **사전 등록**: 없다 — chip16 은 **상온** 0 → 100k · 곡선 무관 빠른 무리 교정으로 등록된 칩이었다(`docs/spec/s1.wear_bench_spec.md` §15 2026-10-03 · 로그 48
  [D48-74] · [D48-75]). 지민이 히터를 설정 65°C 로 무장한 채 돌렸고(로그 53 §1), 영웅님이 2026-10-12 에 **온도 축(두 번째 65°C 칩) · 교정 밖**으로 정했다
  (로그 53 [D53-4]). 판정 기준은 chip17 과 같이 상온 종단 칩의 H1′ · H2′ · H6 를 그대로 적용했다
- **비교 대상**: 상온 빠른 무리 교정 5칩(chip01 · 02 · 04 · 09 · 18) · 65°C chip17
- **경위**: [`../../log/young/53.chip16_100k_with_temperature_log.md`](../../log/young/53.chip16_100k_with_temperature_log.md)

## 결론

**같은 히터 · 같은 설정 65°C 인데 chip16 은 chip17 과 반대로, 상온 빠른 무리의 가장 빠른 쪽처럼 늙었다.** 폭은 100k 동안 100 사이클 대비
−8.3 - +4.6ps 로 3σ(42ps) 안 — H1′ 은 이번에도 섰다. 소거 배율은 100k 에 4.34 로 상온 빠른 무리 5칩(2.60 - 3.97) 위, chip17(2.44)의 1.8배이고,
섹터마다 84ms 를 넘은 뒤 1.19 - 1.22 의 계단이 왔다(H6 와 맞음 — chip17 은 계단이 없었다). 프로그램은 100k 까지 평탄(1.00, H2′ 참 — chip17 은 +20%).
상온 v4 모델로 이 칩을 맞히면 68% 10/12 · 95% 11/12 로 상온 칩처럼 맞고(chip17 은 2/12 · 10/12), 100k 뒤 newchip 현장 역산도 91 - 92k 다.
**chip17 에서 본 「65°C 는 소거 노화를 늦춘다」 를 chip16 은 지지하지 않는다** — 두 칩이 같은 설정에서 반대로 갔으므로 chip17 의 차이는 온도보다
개체차 쪽으로 기운다([D48-65] 의 문장이 더 서는 방향). 다만 chip16 의 온도 로그는 히터가 꺼진 채 3.6시간을 66 - 67°C 에, 켜진 채 10시간을 60 - 63°C 에
머물러 **센서가 칩 · 히터와 열적으로 붙어 있었다고 볼 수 없다**(§1). 「chip16 이 65°C 에서 닳았다」 는 이 로그로 확인되지 않는다 — 그래서 위 문장은
「설정 65°C 두 칩이 반대로 갔다」 까지이고, 「65°C 에서 상온처럼 늙었다」 까지는 아니다.

| 질문 | 기준 | 결과 | 판정 |
|---|---|---|---|
| H1′ 100k 안 폭 3σ 안 | 42ps | −8.3 - +4.6ps | **참** (§2) |
| H2′ 100k 안 프로그램 불변 | 보이면 깨짐 | 1k 6.89 → 100k 6.89ms (1.00) | **참** — 상온 빠른 무리와 같고 chip17(+20%)과 다름 (§3) |
| 계단 (H6 ① 섹터 1k 구간 중앙값 84ms) | 닿으면 계단 | 섹터 7개 모두 25k - 61k 에 닿고 42k - 69k 에 점프 1.19 - 1.22 | **H6 와 맞음** — chip17 은 없었음 (§3) |
| 소거 노화가 상온 빠른 무리와 같은가 | 상온 5칩 범위 2.60 - 3.97 | 100k 4.34 · 예측구간(3칩) p 0.36 | **위쪽 끝** — chip01(3.97) 다음 · 느린 쪽 chip17 과 반대 (§3) |
| 상온 모델(v4)이 이 칩을 맞히는가 | LOCO 68% · 95% | 10/12 · 11/12, 중앙값 0.95 - 3.1배 | **예** — chip17(아니오)과 반대 (§4) |
| 칩 온도가 65°C 였나 | 온도 로그 | 센서 평균 63.7°C 지만 히터 상태와 안 맞음 | **확인 못 함** (§1) |

## 1. 온도 — 설정은 65°C 였지만 센서는 히터를 따라가지 않았다

로그는 10-08 03:58Z `T65` 무장부터 10-09 06:17Z 까지 이어지고 설정은 끝까지 65 다. 마모 구간 시간 평균은 63.67°C(사이클 가중 63.9), 63 - 67°C 안이
49.7% — chip17(65.22 · 97.2%)의 절반이다. 그런데 **히터 상태와 온도가 거꾸로 간 자리가 둘이다**(`temp_chip16_2026-10.md` §2).

- 10-08 10:39 - 14:13Z, 3.6시간: 상태 RUN 인데 PWM 0 — 설정을 넘어 출력을 끈 것인데 66 - 67°C 가 **그대로** 다. chip17 은 히터가 55초 꺼지자
  44.9°C 까지 떨어졌다(`wear_temperature_chip17.md` §1). 40k 체크포인트가 이 안이다
- 14:13Z - 10-09 00:50Z, 10.6시간: PWM 이 상한(86%)에 붙어 있는데 60 - 63°C 에 머물렀고, 00:50Z 센서 FAULT 로 히터가 영구히 꺼진 뒤 5.5시간은
  오히려 62 → 64°C 로 올랐다. 90k · 100k 체크포인트와 97,957 → 100k, 100k 뒤 사다리가 이 안이다

히터가 꺼져도 안 식고 켜져도 안 오르는 센서는 히터 · 칩과 열적으로 붙어 있지 않은 것이다(센서 자리가 다르거나 떨어졌거나). 그러면 「63.7°C」 는 센서
자리의 온도이지 칩의 온도가 아니고, 칩이 몇 도였는지는 이 로그로 알 수 없다 — 히터가 켜져 있던 시간(04:59 - 10:39Z · 14:13 - 00:50Z, 마모의 약 73%)
만큼은 상온보다 높았을 것이지만 얼마나인지는 모른다. **배치는 chip17 과 같았다**(영웅님, 2026-10-12) — 그러면 센서 접촉 · 값 고정 · 컨트롤러 쪽 문제이고,
온도 컨트롤러 담당(세은)의 답으로 이 절을 고친다(로그 53 [U53-2]).

마모 세션 쪽에도 사건이 하나 있다. 90k → 100k 구간 97,957 에서 `wip_timeout` 으로 멈췄고(10-09 03:47Z), 1.5시간 뒤 resume 판정(tally 97,900 일치 · 섹터 0-4
reerase 586.7ms 뒤 잔류 0)을 거쳐 97,957 → 100,000 을 다시 돌렸다. 100k 체크포인트의 소거 p99 · max(141 · 175ms)와 프로그램 max(22.5ms)가 긴 것은 이
2,043 사이클만 담은 분포라서다 — p50 은 90k 와 이어진다.

## 2. 마진 — 100k 동안 움직이지 않았다

25MHz 폭 @1e-2 는 13점이 39,781.5 - 39,794.4ps, 100 사이클 대비 −8.3 - +4.6ps 로 재장착 3σ(42ps) 안이다. 1e-3 · 1e-4 도 같은 범위. 창 위치는
−613 - −608 스텝(5스텝 · 약 80ps 안, 100k 한 점이 −608 로 4스텝 움직였고 나머지 12점은 2스텝 안). 센서 온도가 60 → 67°C 사이를 오가는 동안에도
폭은 그대로였다 — 온도가 폭에 주는 효과를 보려던 축은 아니었지만, 적어도 이 범위의 센서 온도 변화는 폭에 안 보였다.

100k 뒤 newchip 25MHz(39,781.9 · −608)는 100k 체크포인트(39,781.5 · −608)와 0.4ps 차 — 같은 장착 · 같은 온도의 재현성이다. chip17 처럼 25°C 로
식혀 잰 점은 없다(§6).

## 3. 소거와 프로그램 — 상온 빠른 무리의 빠른 쪽, chip17 과 반대

소거 p50(섹터 중앙값 ÷ 신품 26.79ms)은 10k 1.81 · 50k 3.11 · 100k 4.34 다. 같은 x 에서 상온 빠른 무리 5칩은 1.47 - 1.93 · 2.13 - 3.31 · 2.60 - 3.97,
chip17 은 1.33 · 1.82 · 2.44. chip16 은 세 점 모두 chip04 · chip01 과 같은 쪽에 있고 100k 에서는 다섯 칩 위다 — chip01 이 4.34 에 닿는 사이클은 176,000.
13점 곡선을 나란히 두면 chip01(35.5 · 47.8 · 81.4 · 114.1ms @ 1k · 10k · 50k · 100k)과 1 - 2ms 안에서 겹친다(로그 53 §3 추기).

**계단.** 상온 빠른 무리의 계단은 섹터 소거가 약 84ms 에 닿은 뒤에 왔다(H6 ①). chip16 은 섹터 7개가 25k(섹터 2) - 61k(섹터 5)에 84ms 를 넘었고
그 뒤 42k - 69k 에 1.19 - 1.22 의 점프가 하나씩 있다. 섹터 중앙값 곡선의 점프 1.19(64k → 65k, 92 → 109ms)는 빠른 무리 교정 칩(1.17 - 1.20)과 같다.
chip17 은 섹터 최대 69.9ms 로 84ms 에 닿지 않았고 점프 1.04 였다.

**프로그램.** 섹터 중앙값 6.89(1k) → 6.93(10k - 50k) → 6.89ms(100k), 100k/1k 1.00 — 상온 빠른 무리(chip04 · 09 · 18 1.00 - 1.01)와 같다.
chip17 은 7.00 → 8.41ms(+20%)로 올랐었다.

**chip17 과 무엇이 달랐나.** 히터 · 설정 · 보드 · 사람이 같고 칩만 다르다(둘 다 빠른 무리 · 9/30 배치 · 디바이스마트, 날짜 코드 chip16 `1551` ·
chip17 미판독). 온도 로그는 chip17 쪽이 믿을 만하고(97% 가 63 - 67°C, 히터 꺼지면 바로 식음) chip16 쪽은 §1 대로 센서가 떠 있었다. 그래서
가능한 설명은 둘이다 — (ㄱ) chip16 은 실제로 65°C 근처였고 두 칩의 차이는 개체차다 (ㄴ) chip16 의 센서가 떠 있던 만큼 칩도 덜 뜨거웠고(히터가
센서를 못 보고 상한으로 돌았으니 오히려 더 뜨거웠을 수도 있다) 온도가 달랐다. 어느 쪽이든 **chip17 하나로 「65°C 가 소거 노화를 늦춘다」 고 말할 수
없다는 [D48-65] 는 그대로이고, chip16 은 그 반대 증거를 하나 더한 것이 아니라 「같은 설정에서 반대 결과」 를 더해 온도 축의 통제가 아직 안 된다는 것을 보였다.**

## 4. 상온 모델로 이 칩을 보면 — 상온 칩처럼 맞는다

v4(상온 교정 8칩)로 chip16 의 체크포인트 12점(p50 관측)을 맞히면 68% 10/12 · 95% 11/12, 중앙값은 정답의 0.95 - 3.1배(1k - 60k 는 위로, 70k 부터 1.1 - 1.2배)
— 상온 빠른 무리 chip01 과 같은 모양이고, chip17(2/12 · 10/12 · 0.15 - 0.35배 아래)과 반대다. 100k 뒤 newchip 한 번으로 돌린 현장 역산(기준 섹터 27.7ms ·
마모 섹터 116.3ms)은 91,001 - 92,000(68% 87k - 100k)으로 정답 100k 를 68% 안에 품었다. **상온 역산이 「덜 썼다」 고 보는 chip17 의 위험(남은 수명을
부풀림)은 chip16 에는 없다** — 모델의 적용 범위를 「상온 사용 이력」 으로 둔 로그 51 §3 의 선은 그대로 두되, 그 선 밖에서 어느 쪽으로 틀리는지는 칩마다 다르다.

## 5. 교정 곡선에 넣지 않는다 — 온도 축 칩이다 (영웅님 결정 2026-10-12, 로그 53 [D53-4])

[D48-75] 는 「상온에서 같은 절차로 마치면 곡선 무관 빠른 무리 교정」 이었다. 전제(상온)가 깨졌으므로 그 결정을 적용하지 않고, chip17 과 같이 온도
축 · 교정 밖으로 둔다. 곡선 이름 `_64C` 가 교정 glob 에서 뺀다. 넣었을 때를 보면(`chip16_loco_2026-10.md`): 상온 8칩 94점의 68% 적중 75 → 74,
95% 91 → 93, 빠른 무리 R 2.97 → 2.92(chip16 r̂ 1.59 로 chip04 다음), chip02 의 68% 가 4점 나빠지고 chip04 가 2점 좋아진다 — 얻는 것이 거의 없고,
온도 통제가 안 된 이력이 상온 교정에 들어간다. v4 교정 8칩 · v4.1(chip06 추가) 순서([D52-4])에도 영향이 없다.

## 6. 100k 뒤 사다리 — 식히지 않았다

75 · 45MHz 와 newchip 을 100k 스윕 직후(06:01 - 06:15Z) 히터 FAULT · 센서 62 - 63°C 인 채로 쟀다. 25MHz 폭 · 창 위치는 §2 대로 100k 와 같고,
45 · 75MHz(21,844.5 · 12,166.5ps)는 마모 전 짝이 없어 기록만 한다. chip17 의 25°C 사다리(21,976.5 · 12,224.6)보다 132 · 58ps 좁지만 온도 · 장착이 달라
빼지 않는다. **측정 온도와 이력 온도를 가르는 25°C newchip(prep)은 chip17 처럼 아직이다.**

## 한계

- 온도가 통제되지 않았다 — 센서가 히터 · 칩과 열적으로 붙어 있었다고 볼 수 없고(§1), 배치 기록 · 사진이 없다. 「65°C 이력」 이라고 쓸 수 없다
- 사전 등록된 온도 런이 아니다 — 상온 교정으로 등록된 칩을 지민이 65°C 설정으로 돌렸다(로그 53 §1)
- 90k · 100k 체크포인트와 사다리가 센서 FAULT 뒤, 40k 가 히터 꺼짐 안 · 97,957 `wip_timeout` 재개(§1)
- 온도 칩 2개지만 같은 설정에서 결과가 반대라 온도 효과의 추정에 쓸 수 없다 · 비교 집단은 상온 빠른 무리 5칩
- 25°C 로 식힌 측정이 없다(§6)

## 발표 · 논문 문장 (제안 — 영웅님 확정 전)

> 온도 축은 두 칩이다. chip17(칩 위 65°C, 로그 97% 가 63 - 67°C)은 소거가 상온 빠른 무리보다 덜 늘었고(10만 회 2.44배 대 2.60 - 3.97배) 상온 모델이
> 사용량을 0.15 - 0.35배로 낮게 봤다. 같은 히터 · 같은 설정으로 돌린 chip16 은 반대로 상온 빠른 무리의 빠른 쪽처럼 늙었고(4.34배 · 계단 있음 · 프로그램 불변)
> 상온 모델이 12점 중 10점을 68% 안에 맞혔다 — 다만 이 칩의 온도 로그는 히터 상태와 맞지 않아 칩 온도를 확인하지 못했다. 두 칩 모두에서 유효 창 폭은
> 10만 회 동안 3σ 안이었다. 65°C 효과는 여전히 개체차와 구별되지 않으며, 온도 축은 센서 · 히터 배치를 기록한 재실험이 필요하다.

## 다음

1. 지민의 배치 설명 · 사진(히터 · 센서가 chip16 보드 위 어디에 · 꺼진 뒤 왜 안 식었나) — [U53-2]. 오면 §1 · 한계를 고친다
2. chip16 · chip17 을 25°C 에서 newchip(prep 0-127) 1회 → `wear_inverse.py`(정답 100k) — 측정 온도와 이력 온도를 가른다
3. 온도 런 절차에 **센서 · 히터 배치 사진과 「히터 끔 → 식는지」 점검**을 시작 조건으로 넣는다(런북 3 · M3 온도 두세 점의 전제)
4. 날짜 코드: chip17 IC 마킹 판독(등록부 빈칸) — chip16 `1551` 과 같은 로트인지
