young-0320/flash-margin-bench/docs/results/wear/wear_temperature_chip17.md

# 온도 마모 결과 해석 — chip17, 칩 위 65°C, 0 → 100,000 사이클

- **작성일**: 2026-10-02 · **측정**: 2026-10-01 19:51 - 10-02 12:32 KST (보드 B, 박지민) · 100k 뒤 25°C 사다리 10-02 18:47 KST
- **수치**: [`data/wear/wear_endurance_chip17_2026-10.md`](../data/wear/wear_endurance_chip17_2026-10.md) (체크포인트 · 1k 구간 배율 · 100k 뒤 25°C 사다리) ·
  [`data/temp_chip17_2026-10.md`](../data/temp_chip17_2026-10.md) (온도 전체 · 구간별 · 시간별) ·
  [`data/chip17_loco_2026-10.md`](../data/chip17_loco_2026-10.md) (상온 모델로 맞히기 · 교정에 넣었을 때) — 표를 다시 싣지 않고 인용한다
- **그림**: [`plots/wear/wear_temp_chip17_2026-10.png`](../plots/wear/wear_temp_chip17_2026-10.png) (사이클 축: 온도 · 폭 변화 · 소거 배율) ·
  [`plots/temp/temp_chip17_timeline_2026-10.png`](../plots/temp/temp_chip17_timeline_2026-10.png) (시계 축 온도)
- **사전 등록**: `docs/spec/s1.wear_bench_spec.md` §15 2026-10-01 추기 (chip17 80°C 종단 — 온도 축) · 로그 51 §3 (모델 전제는 상온 마모 이력 ·
  온도와 로트가 겹친다) · 로그 48 §26 (히터 한계로 65°C). 온도 칩에 따로 등록한 가설은 없어, 상온 종단 칩의 H1′·H2′·H6 기준을 그대로 적용했다
- **비교 대상**: 상온 빠른 무리 chip01(파일럿) · chip04(종단) · chip09(교정)
- **경위**: `docs/log/young/48.pilot_wear_handler_and_plan_approval.md` §27

## 결론

**65°C 에서도 마진은 움직이지 않았다. 그런데 소거 시간은 상온보다 느리게 늘었고, 그래서 상온 교정 모델은 이 칩의 사용량을
0.15-0.35배로 낮게 봤다.** 폭은 100k 동안 100 사이클 대비 −3.4 - +14.8ps 로 3σ(42ps) 안이다 — 고온에서도 마모가 타이밍 마진을
줄이지 않는다는 H1′ 이 온도를 바꿔서도 섰다. 반면 소거 배율은 100k 에 2.44 로 상온 빠른 무리 세 칩(2.80-3.97)보다 낮았고, 열두
체크포인트 모두에서 가장 낮았다. 세 칩과의 검정은 유의하지 않지만(p 0.19-0.25) 모델은 그 차이에 민감하다. 프로그램 시간은 상온
빠른 무리와 달리 20k 부터 올라 100k 에 +20% 였다. 두 차이가 온도 때문인지 이 칩의 개체차(·로트)인지는 칩 하나로 가를 수 없다 —
65°C 효과는 개체차와 구별되지 않는다(로그 48 [D48-65]). 마모 중 칩 위 온도는 시간 평균 65.22°C(97.2% 가 63-67°C)다.
100k 뒤 25°C 로 식혀 재도 창 위치는 같았고, 25MHz 폭은 40-58ps 넓은 정도라 유의미한 변화로 보지 않는다(§6).

| 질문 | 기준 | 결과 | 판정 |
|---|---|---|---|
| H1′ 100k 안 폭 3σ 안 (65°C) | 42ps | −3.4 - +14.8ps | **참** (§2) |
| H2′ 100k 안 프로그램 7.0ms 불변 (65°C) | 보이면 깨짐 | 20k 부터 오름, 100k p50 8.41ms (+20%) | **거짓** — 상온 빠른 무리(참)와 다름 (§3) |
| 계단 (H6 ① 섹터 1k 구간 중앙값 84ms) | 닿으면 계단 | 최대 69.9ms, 계단 없음 | **H6 와 맞음** (§3) |
| 소거 노화가 상온 빠른 무리와 같은가 | 상온 3칩 범위 | 100k 배율 2.44 대 2.80-3.97 · 예측구간 p 0.25 | **구별 못 함** — 단 전 체크포인트에서 최저 (§3) |
| 상온 모델(v2)이 65°C 이력 칩을 맞히는가 | LOCO 68% · 95% | 2/12 · 10/12, MAP 0.15-0.35배 | **아니오 — 낮게 본다** (§4) |
| 25°C 로 식히면 폭 · 창 위치가 달라지는가 | 재장착 3σ 42ps | 폭 +39.7 - +57.8ps (100 대비 +54.5) · 창 위치 같음 | **유의미한 변화 아님** — 3σ 를 조금 넘는 한 번 측정 · 장착 미확인 (§6) |

## 1. 온도는 65°C 였다 — 히터 한계의 평형, 그리고 두 번의 이탈

설정 65°C 로 시작한 3.5시간은 제어가 출렁였다 — 출력이 0 근처로 내려갔다가 늦게 회복하며 62°C 아래 골이 12번(최저 58.3°C) 생겼다.
23:11 에 설정을 68°C 로 올린 뒤 12.4시간은 PWM 듀티가 상한(86.3%)에 붙어 제어 없이 열평형으로 65-66.5°C 에 머물렀다. **"65°C" 는 이
히터의 한계 온도이고, 설정 68°C 쪽이 오히려 안정했다.** 마모 구간 평균은 63.4-66.3°C, 전체 시간 평균 65.22°C · 사이클 가중 65.17°C.

이탈은 두 번 다 같은 원인이다. 온도 로거(`hw/temp_logger.py`)를 다시 켜면 시리얼 포트를 여는 순간 아두이노가 리셋되어 히터가 꺼진다
(기본값 80 · OFF). 10-02 11:38 에는 55초 꺼져 44.9°C 까지(90k → 100k 구간 108분 중 약 7분), 12:26 에는 41초 꺼져 47.0°C 까지 떨어졌는데
두 번째가 **100k 체크포인트의 prep·스윕과 겹쳤다**(prep 평균 62.8 · 스윕 60.9°C). 3k 체크포인트의 prep 도 출렁임 골(61.4°C)에 걸렸다.
나머지 체크포인트 측정은 63.9-66.1°C 다.

## 2. 마진 — 65°C 에서도 100k 동안 움직이지 않았다

25MHz 폭 @1e-2 는 39,760.4-39,778.5ps, 100 사이클 대비 −3.4 - +14.8ps 다. 상온 종단 칩의 판정선(재장착 3σ 42ps) 안이다. 가장 큰
+14.8ps 는 100k — 히터가 꺼졌다 켜지는 도중(47-65°C)에 잰 점이다. 창 위치(recenter)는 −597 - −594 스텝으로 1.5스텝(약 24ps) 안이다.

이 런 안에서는 온도가 거의 일정했으므로 창 위치가 안 움직인 것은 예상대로이고, **계측기가 온도에 반응하는지(양성 대조)는 이 런으로
보이지 못한다.** 보드 A 상온 newchip(9/30, 폭 39,774.8 · 창 −630)과 보드 B 65°C 100 사이클(39,763.7 · −596)의 차이는 리그와 온도가 겹쳐
온도 효과로 읽지 않는다. → 10/2 에 같은 리그에서 25°C 로 식혀 쟀다(§6).

## 3. 소거와 프로그램 — 상온 빠른 무리보다 느리게 늙었고, 프로그램은 올랐다

소거 p50(섹터 중앙값 ÷ 신품 26.43ms)은 10k 1.33 · 50k 1.82 · 100k 2.44 다. 같은 x 에서 상온 빠른 무리는 1.53-1.93 · 2.29-3.31 · 2.80-3.97 이다.
chip17 의 100k 배율에 상온 칩이 닿은 사이클로 보면 chip09 의 1.6배 · chip01 의 2.9배 · chip04 의 4.2배 느리게 늙었다. 상온 세 칩의 로그 배율로
만든 예측구간(자유도 2)에 넣으면 t −1.6 - −2.0 · p 0.19-0.25 — 비교 칩이 셋이라 유의하다고 말할 수 없다. 다만 상온 빠른 무리 안의 속도 차
(chip04 대 chip09 2.9배)보다 chip17 이 한쪽으로 더 나가 있다.

**측정 온도 탓인가.** 100 사이클에서 chip17 의 배율(65°C 에서 잰 체크포인트 p50 ÷ 상온 신품값)은 1.05 로 chip09(상온) 1.08 과 거의 같다.
뜨겁게 재서 소거가 짧아 보이는 효과가 있다면 처음부터 낮았어야 하는데, 차이는 사이클을 따라 벌어졌다 — 오프셋이 아니라 늙는 속도의
차이다. 다만 온도 계수 자체가 마모 정도에 따라 달라지는 2차 효과(로그 51 §3)는 25°C 측정 없이는 뺄 수 없다.

**개체차로 설명된다.** 상온 빠른 무리끼리도 늙는 속도가 2.9배 다르고(chip04 대 chip09), chip17 은 가장 느린 chip09 보다 1.6배 더
나갔을 뿐이다. 신품 소거 시간(26.4ms)도 chip09(26.0ms)와 거의 같은데, 상온 세 칩은 신품이 짧을수록 느리게 늙었다(50k 배율 2.29 ·
2.83 · 3.31 대 신품 26.0 · 28.7 · 33.7ms — 세 칩의 경향일 뿐이다).

**온도로도 설명된다.** "고온이면 더 닳는다" 는 직관은 소거 시간에는 거꾸로 갈 수 있다. 소거를 늦추는 갇힌 전자는 열로 빠져나가고
(활성화 에너지 1.1-1.2eV 로 보고 — 65°C 에서 25°C 의 약 160-250배 빠르다), 프로그램의 채널 열전자 주입은 고온에서 효율이 떨어진다.
"소거는 덜 늘고 프로그램은 일찍 올랐다" 는 두 차이를 한 번에 설명하는 것이 온도 쪽의 강점이다. 로트 쪽 근거는 아직 없다 — 같은 날 들인
chip12 는 구매처가 달라 같은 칩으로 보지 않고(로그 48 [D48-77]), 새 배치의 상온 비교는 chip16 · 18 이 맡는다. 로그 51 §3 이 미리 적은 대로 칩 하나로는 못 가른다.

**계단 없음.** 상온 빠른 무리의 계단은 섹터 소거가 약 84ms 에 닿은 뒤에 왔다(H6 ①). chip17 은 섹터 1k 구간 중앙값이 최대 69.9ms 라 그
수준에 닿지 않았다 — 65°C 가 계단을 막았다기보다 소거가 거기까지 안 올라갔다.

**프로그램.** 섹터 중앙값 7.00ms(1k) → 7.03(10k) → 7.23(20k) → 7.85(50k) → 8.41ms(100k), 100k/1k 1.20. 상온 빠른 무리는 100k 안에
평탄했다(1.00 · 1.00 · 1.01, chip01 은 약 145k 부터 오름). 옛 로트 느린 무리는 일찍 올랐다(chip03 1.27 · chip07 2.15).
chip17 은 chip03 과 비슷한 폭으로 올랐다. 1k 의 7.00ms 는 상온 빠른 무리 범위(6.50-6.98) 끝이라, 열이
프로그램 여유를 줄여 둔 자리에서 마모가 먼저 드러났다는 해석이 가능하다(가설).

## 4. 상온 모델로 이 칩을 보면 — 사용량을 낮게 본다

v2(상온 5칩 · R 2.0)로 chip17 의 체크포인트 12점을 맞히면 68% 구간이 2/12, 95% 구간이 10/12 정답을 품었고 MAP 은 모든 점에서 정답의
0.15-0.35배였다(100k → MAP 34-35k · 68% 17-62k). **65°C 에서 쓰인 칩을 상온 모델로 진단하면 "덜 썼다" 고 나온다** — 중고 등급 판별에서는
남은 수명을 부풀리는 쪽이라 위험한 방향이다. 그래서 모델의 적용 범위는 로그 51 §3 대로 "상온 사용 이력" 으로 남고, 그 범위를 이번에는
데이터로 그었다.

단서가 하나 있다. 이 검증의 관측도 65°C 에서 잰 값이다. 실제 진단처럼 25°C 로 식혀 재면 소거가 길어져 배율이 올라갈 수 있고, 그만큼 정답
쪽으로 다가간다. 그 측정이 다음 단계 1번이다.

## 5. 교정 곡선에 넣지 않는다

chip17 을 교정 6번째로 넣어 LOCO 를 돌리면 상온 빠른 무리 세 칩의 68% 적중은 21/36 그대로다(chip09 6점 좋아지고 chip01·04 6점 나빠짐),
68% 폭 중앙값은 44,000 → 49,500 으로 넓어진다. 느린 무리는 그대로이고, 남은 블라인드 chip08·chip15 는 둘 다 느린 무리라 영향이 없다(chip15 는 10/4 느린 교정으로 옮겼다 — `wear_endurance_chip15.md`).
얻는 것 없이 상온 칩의 구간만 넓어지고, 측정 온도 · 이력 온도 · 로트가 섞인 곡선이 상온 진단에 들어간다. **교정이 아니라 외부 검증
점으로 쓰고**, 온도를 변수로 넣는 모델(온도 둘 이상 × 칩 둘 이상 + 25°C 측정)이 생기면 그때 첫 점이 된다. 영웅님 동의(2026-10-02) — 로그 48 [D48-64].

## 6. 25°C 로 식혀 잰 사다리 — 유의미한 변화는 없었다

박지민이 100k 를 마친 칩을 히터 없이 25°C 에서 25 · 45 · 75MHz 로 한 번씩 쟀다(10-02 18:47 KST, 65°C 런이 끝나고 약 6시간 뒤).
리그(보드 B)와 `git_rev` 가 65°C 체크포인트와 같다. 수치는 [`data/wear/wear_endurance_chip17_2026-10.md`](../data/wear/wear_endurance_chip17_2026-10.md) §3.

**25MHz 폭은 65°C 때보다 40-58ps 넓었고, 유의미한 변화로 보지 않는다.** 25°C 의 39,818.2ps 는 65°C 체크포인트 13점(39,760.4-39,778.5)보다
+39.7 - +57.8ps 넓다. 100 사이클 기준선 대비 +54.5ps 는 재장착 3σ(42ps)를 조금 넘지만, 한 번 잰 값이고 65°C 런과 같은 장착인지 기록이
없다(영웅님 판단, 로그 48 [D48-72]).

**창 위치는 그대로다.** 25°C 의 −596 은 65°C 13점(−597 - −594) 안이다. 그래서 §2 의 보드 A 상온 −630 과 보드 B 65°C −596 의 차이는
온도가 아니라 리그 · 장착 쪽이다. 폭은 리그 · 장착 · 마모가 겹쳐 보드 A 상온 newchip(39,774.8)과 빼지 않는다.

**45 · 75MHz 는 기록만 한다.** 21,976.5 · 12,224.6ps 다. chip17 은 마모 전 사다리를 재지 않아 비교할 짝이 없다.

**소거 시간은 이번 측정에 없다**(스윕만, prep 없음). §4 의 단서(25°C 로 재면 배율이 올라 정답 쪽으로 다가가는가)는 여전히 25°C prep 이
있어야 닫힌다.

## 한계

- 온도 칩 1개 · 온도 1점(65°C) · 새 로트(로트와 겹침) · 체크포인트와 A 행 모두 65°C 에서 잰 값 · TMP117 은 다이가 아니라 센서 자리 온도
- 비교 집단은 상온 빠른 무리 3칩 — 검정력이 낮다
- 100k 체크포인트와 90k → 100k 구간 일부가 히터 꺼짐과 겹쳤다(§1)
- 25°C 는 사다리 한 번이고, 같은 장착인지 미확인 · 소거 시간 없음 (§6)

## 보고서 문장 (2026-10-02 확정, 로그 48 [D48-65])

> 온도 축(chip17, 칩 위 65°C, 10만 회): 25MHz 유효 창 폭은 10만 회 동안 −3 - +15ps 로 상온과 같이 움직이지 않았다(3σ 42ps 안) — 고온에서도
> 마모가 타이밍 마진을 줄이지 않았다. 소거 시간은 상온 빠른 무리보다 덜 늘었고(10만 회 2.44배 대 2.80-3.97배) 프로그램 시간은 20% 올랐지만,
> 65°C 효과는 개체차와 구별되지 않는다(온도 칩 1개). 이 칩을 상온 역산 모델로 진단하면 사용량을 낮게 봐(0.15-0.35배), 모델의 적용 범위는
> 상온 사용 이력으로 둔다.

25°C 사다리(§6)는 이 문장을 정한 뒤에 나왔고, 유의미한 변화로 보지 않아 더하지 않는다(로그 48 [D48-72]).

## 다음

1. chip17 을 25°C 로 식혀 newchip(prep 0-127) 1회 → `wear_inverse.py` (정답 100k) — 측정 온도와 이력 온도를 가른다.
   25°C 스윕은 10/2 에 받았고(§6) prep 은 아직이다
2. 무마모 온도 스윕(chip09 등, 25 → 45 → 65 → 25°C) — 소거 시간 온도 계수와 계측기 양성 대조(창 위치)
3. 온도 로거를 다시 켜도 아두이노가 리셋되지 않게(DTR) 하거나, 런 중 로거 재시작 금지를 런북에 적는다
4. 새 배치 빠른 칩 chip16 · 18 의 상온 종단(2026-10-03 결정, 로그 48 [D48-74]) — 온도와 로트를 가른다
   > **2026-10-04 — chip18 이 절반을 답했다 ([`wear_endurance_chip18.md`](wear_endurance_chip18.md)).** 같은 9/30 등록 배치의 chip18 은 상온에서
   > 옛 로트 빠른 무리 띠 안(100k 3.68배)이었다. 80k 까지는 chip09 처럼 늦게 늙어 2.73 이었고, chip17(65°C)은 80k 2.18 · 100k 2.44 로 그보다도
   > 낮다 — 「새 배치라 덜 늙는다」 는 쪽은 약해졌다. 온도인지 개체차인지는 chip16 이 끝나도 칩 하나로는 못 가른다
   > **2026-10-12 — chip16 은 상온이 아니라 설정 65°C 로 돌아왔고, 반대로 갔다 ([`wear_temperature_chip16.md`](wear_temperature_chip16.md) · 로그 53 [D53-4]).**
   > 같은 히터 · 설정에서 소거 100k 4.34배 · 계단 있음 · 프로그램 불변, 상온 v4 가 10/12 맞힘. chip17 의 느린 노화는 개체차 쪽으로 기울지만 chip16 의 온도
   > 로그가 히터 상태와 맞지 않아 칩 온도 미확인 — 온도 축은 배치를 기록한 재실험이 필요하다
