young-0320/flash-margin-bench/docs/results/data/blind_temp_chip23_chip26_2026-11.md

# 블라인드 chip23 · chip26 (85°C 이력) — 추정과 판정 (2026-11)

> 수치·절차 기록만 둔다. 해석은 [`../blind_temp_chip23_chip26.md`](../blind_temp_chip23_chip26.md). 모델은 S-5 v4.3(2026-10-23 등록, 로그 52 [D52-16]) · 경위는 로그 52 §18.

- **칩**: 둘 다 박지민이 보드 B 에서 섹터 0-6 을 설정 85°C 로 마모한 온도 칩이다(교정 밖)
  - chip23 · UID `D16660141F1B132F` · 느린 무리(신품 소거 49.4ms, 10/15). 2026-10-18 0 → 26,528 에서 USB 끊김 · 히터 센서 FAULT 로 멈춤
  - chip26 · UID `D16518B58F503638` · 빠른 무리(신품 소거 25.7ms, 10/25). 2026-10-26 - 10-27 0 → 70,000 에서 멈춤(100k 까지 이을지는 미정)
- **정답을 먼저 알았다.** chip06 과 달리 정답을 봉인하지 않았다 — 지민 묶음(세션 폴더 · 장부)을 받은 뒤 개봉 prep 을 쟀고, 추정 전에 사이클 수를 알고 있었다.
  모델(`wear_inverse.py` · 교정 표 · ρ · R)은 2026-10-23 등록 뒤 바뀌지 않았으므로(추정 파일 머리말 git_rev `18e06ad`, `wear_inverse.py` 수정 없음) 추정값은
  정답과 독립이다. 결과를 보고 고칠 손잡이가 없다는 뜻에서 판정은 성립하고, 「정답 봉인」 만 빠졌다(영웅님 결정, 2026-11-01)
- **개봉 prep**: 상온 newchip 1회씩 — 보드 A, 2026-11-01, 히터 없이(온도 로그 없음). 마모가 멈춘 지 chip23 14일 · chip26 6일
  - chip23 `data/session_chip23_D16660141F1B132F_20261101T142549Z.log` (sha256 `5e976cc4…`)
  - chip26 `data/session_chip26_D16518B58F503638_20261101T142328Z.log` (sha256 `02c4d690…`)
- **추정 기록**: [`chip23_estimate_v4.3.txt`](chip23_estimate_v4.3.txt) · [`chip26_estimate_v4.3.txt`](chip26_estimate_v4.3.txt) — 머리말에 코드 · 인자 · 입력 sha256 · 교정 표 9장

## 1. 관측

| 칩 | 기준 32-127 (신품 대비) | 근접 7-13 (신품 대비) | 마모 0-6 중앙값 | 관측 배율 0-6 ÷ 32-127 | 섹터 0-6 소거 (ms) |
|---|---|---|---|---|---|
| chip23 | 48.8ms (49.4 · 0.99) | 51.8ms (48.9 · 1.06) | 89.4ms | **1.83** | 96.8 · 88.6 · 85.2 · 106.3 · 89.4 · 89.3 · 97.4 |
| chip26 | 25.3ms (25.7 · 0.98) | 28.7ms (24.4 · 1.17) | 67.1ms | **2.66** | 67.1 · 68.6 · 67.5 · 70.7 · 62.5 · 61.2 · 64.7 |

두 prep 모두 PASS(2,048 페이지 검증 · blank_post 0) · 스윕 VALID 2,520 행.

## 2. 추정 (v4.3 7장 판, `--model v4.3` 기본값)

| 칩 | 무리 · 교정 칩 | R | 대표값 (사후 평균) | 중앙값 | MAP | 68% | 95% |
|---|---|---|---|---|---|---|---|
| chip23 | 느린 · chip03 · 07 · 15 | 1.59 | **92,001-93,000** | 94,001-95,000 | 99,001-100,000 | 91,001-100,000 | 78,001-100,000 |
| chip26 | 빠른 · chip01 · 02 · 04 · 06 · 09 · 18 | 2.80 | **60,001-61,000** | 60,001-61,000 | 51,001-52,000 | 31,001-85,000 | 25,001-100,000 |

재현: `uv run python host/analysis/wear_inverse.py data/session_chip2N_<UID>_20261101T*.log --out <파일>` (ρ_s 0 · ρ_p 0.78 · ρ_chip 0.21 · n_eff 3.10).

## 3. 정답

| 칩 | 정답 x | 정본 | 섹터 0-6 이 겪은 P/E 전부 |
|---|---|---|---|
| chip23 | **26,528** | 세션 `1792312282` 의 마지막 A 행(cycle 26,528 · 섹터 0-6 모두). 20,000 체크포인트까지는 A5 검사(카운터 = A 행 ÷ 7 = tally × 100) 통과, 그 뒤는 세션이 죽어 tally 를 읽지 않았다 | 약 26,535 (+ 신품 prep 1 · 체크포인트 5 · 개봉 prep 1 · resume 재소거 섹터 0-2 각 ±1) · 장부는 20,000 체크포인트까지만 있고 20k → 26,528 은 정정 행 대기 |
| chip26 | **70,000** | 세션 `1793025714` A5 — 카운터 70,000 · A 행 ÷ 7 70,000 · tally × 100 70,000 · B 의 cycle 70,000 | 70,012 (+ 신품 prep 1 · 체크포인트 10 · 개봉 prep 1) |

정답 x 는 마모 사이클만 센 값으로 교정 곡선의 x 와 같은 정의다(chip06 과 같음).

## 4. 성공 기준 (S-5 §8)

| 기준 | chip23 | chip26 |
|---|---|---|
| ① 정답 ∈ 95% | 78,001-100,000 — **불통과** | 25,001-100,000 — **통과** |
| ② 68% 바깥 폭 ≤ 60,000 | 9,000 — 통과 | 54,000 — 통과 |
| ③ 68% 바깥 폭 ÷ 대표값 ≤ 1.33 | 9,000 ÷ 92,500 = 0.10 — 통과 | 54,000 ÷ 60,500 = 0.89 — 통과 |
| (참고) 정답 ∈ 68% | 아니오 | **예** |
| (참고) 대표값 ÷ 정답 | **3.49** | 0.86 |

## 5. 정답의 자리 (같은 입력 · 같은 코드로 사후분포를 다시 계산)

| 칩 | 정답이 든 구간 | 그 구간보다 아래일 확률 | 정답 구간의 확률 순위 | 정답 구간의 확률 |
|---|---|---|---|---|
| chip23 | 26,001-27,000 | 0.00% | 74 / 100 | 0.000% (사실상 0) |
| chip26 | 69,001-70,000 | 60.5% | 37 / 100 | 1.27% |

## 6. 같은 사이클의 마모 중 곡선 (참고 — 추정에는 쓰지 않음)

섹터 0-6 의 1k 구간 p50 중앙값 ÷ 신품값. 그림 [`../plots/blind_temp_chip23_chip26_2026-11.png`](../plots/blind_temp_chip23_chip26_2026-11.png) (`host/analysis/plot_blind_temp.py`).

| 칩 (이력) | 20k | 26k | 60k | 70k | 100k |
|---|---|---|---|---|---|
| **chip23 (85°C)** | 1.61 | **1.77** | - | - | - |
| chip21 (상온, 교정 밖 · 느린 신품 빠른 노화) | 1.72 | 1.79 | 2.53 | 2.56 | 2.64 |
| chip12 (상온, 교정 밖 `_ali` · 같은 형) | 1.62 | 1.69 | 2.06 | 2.22 | 2.58 |
| chip22 (85°C) | 1.35 | 1.40 | 1.62 | 1.75 | 1.90 |
| chip03 · 07 · 15 (상온 느린 교정) | 1.26-1.30 | 1.28-1.33 | 1.51-1.54 | 1.49-1.61 | 1.59-1.75 |
| **chip26 (84°C)** | 1.64 | 1.72 | 2.28 | **2.47** | - |
| chip24 (83°C) | 1.84 | 2.05 | 2.63 | 2.96 | 3.47 |
| chip09 (상온 빠른 교정, 가장 느린 축) | 1.71 | 1.86 | 2.40 | 2.66 | 2.80 |

chip26 의 70k 는 마모 중(85°C 루프) 2.47, 개봉 newchip(상온, 같은 prep 의 32-127 로 나눔) 2.66 이다.
