young-0320/flash-margin-bench/docs/results/data/newchip_survey_2026-09.md

# 신품 전수 측정 집계 (S-2) — 2026-09

> 수치·표·측정 기록만 둔다. 관측의 해석과 판정의 근거는 [`../newchip_survey.md`](../newchip_survey.md) — 절 번호가 이 문서와 같다.
> 절 번호(§1-§8)는 다른 문서가 "집계표 §N" 으로 인용하므로 바꾸지 않는다.

- **상태: 판정 완료 (2026-09-20), 분모 `n = 9`.** 2026-09-30 새 배치 4칩과 2026-10-01 2칩(chip14·16)은 §1 에 행만 추가했다 (판정 밖). 그 뒤 10/15 - 10/25 3차 FV 6 · JV 10 도 행만 — **10/25 신품 전수 끝 31칩**(§1 「무리 정리」). chip05 는 측정 불가(§7). width 는 9칩 전부 — chip01 은
  2026-09-22 우리 리그 25MHz 재측정(§1). 판정(§4·§6·§8)은 n=8 로 내렸고 chip01 을 넣은 n=9 재산출도 결론이 같다
- **절차의 원전**: `docs/spec/s2.newchip_protocol.md` — 이 문서는 그 §9 산출물 2·3·4 를 담는다
- **짝 파일**: `newchip_survey_2026-09.csv` (기계가 읽는 요약 1행/칩). 11열 —
  `label,uid,date,width_1e2_ps,erase_us_{median,min,max},blank_{pre,post}_bits,git_rev,note`
- **여기 두지 않는 것**: P/E 누적(원본은 `docs/chip_pe.md` — 사본을 두면 어긋난다, 9/16 에 3 vs 5 로 벌어진 적이 있다) ·
  스윕 횟수·표준편차(이 표의 전제가 칩당 1회, 재장착 σ 는 §6)
- **측정 조건 (전 칩 공통)**: 25MHz · N = 112 · B = 2,048 · PRBS-15 시드 {1, page} ·
  BASE_SECTOR = 0 · UART 921600 · Vivado/Vitis 2025.2
- **원본 위치**: `data/sweep_<label>_<uid16>_<stamp>.csv` (+ `_reads`) · `data/session_*.log`.
  용량상 커밋하지 않는다 — 재현은 생성 스크립트 + 파라미터 + UID + git_rev 로 확보한다

---

## 1. 칩별 요약

| 라벨 | UID | 일자 | width @ θ=10⁻² (ps) | 소거 median (µs) | 소거 min - max | blank_pre | blank_post |
| --- | --- | --- | --- | --- | --- | --- | --- |
| chip01 | D1654CB09B352233 | 2026-09-22 | **39,659.0** | **28,737**  | 25,660 - 32,663 | *(무효 — PRBS)* | 0 |
| chip02 | D1642C74E7134527 | 2026-09-15 | **39,630.2** | **27,151**  | 23,945 - 33,092 | *(무효 — PRBS)* | 0 |
| chip03 | D1628C10C3433F33 | 2026-09-15 | **39,652.8** | **51,129**  | 46,888 - 55,443 | **0** | 0 |
| chip04 | D16484578B525622 | 2026-09-16 | **39,687.9** | **33,743**  | 29,889 - 43,273 | **0** | 0 |
| chip05 | *(읽기 불가)* | 2026-09-16 | — | — | — | — | — |
| chip06 | D16428231B4E182B | 2026-09-16 | **39,798.0** | **25,674** | 22,152 - 31,030 | **0** | 0 |
| chip07 | D1629835DB334534 | 2026-09-20 | *39,795.7* | **47,010** | 46,218 - 55,693 | **0** | 0 |
| chip08 | D16414615B564524 | 2026-09-20 | *39,498.3* | **49,528** | 45,791 - 55,207 | **0** | 0 |
| chip09 | D1657C9713633921 | 2026-09-20 | *39,326.7* | **25,987** | 22,358 - 30,132 | **0** | 0 |
| chip10 | DF685453E7791531 | 2026-09-20 | *38,729.6* | **33,003** | 31,428 - 36,073 | **0** | 0 |
| chip12 | D165B43013742436 | 2026-09-30 | **39,681.8** | **47,752** | 46,481 - 54,080 | **0** | 0 |
| chip15 | D16314314B671B24 | 2026-09-30 | **39,685.5** | **49,794** | 48,274 - 55,645 | **0** | 0 |
| chip17 | D1642C325331242E | 2026-09-30 | **39,774.8** | **26,430** | 23,233 - 31,135 | **0** | 0 |
| chip18 | D1652C218B613936 | 2026-09-30 | **39,602.8** | **29,448** | 24,625 - 33,911 | **0** | 0 |
| chip14 | DF678C14CF384F30 | 2026-10-01 | **38,803.0** | **36,239** | 34,147 - 41,682 | **0** | 0 |
| chip16 | D165906063442A33 | 2026-10-01 | **39,801.5** | **26,793** | 25,306 - 30,759 | **0** | 0 |
| chip21 | D1659431272A2339 | 2026-10-15 | **39,649.3** | **48,862** | 44,804 - 54,324 | **0** | 0 |
| chip22 | D163C424D305372D | 2026-10-15 | **39,588.5** | **49,527** | 45,555 - 52,743 | **0** | 0 |
| chip23 | D16660141F1B132F | 2026-10-15 | **39,679.0** | **49,368** | 45,091 - 53,341 | **0** | 0 |
| chip24 | D1656C51CF672034 | 2026-10-19 | **39,583.2** | **24,866** | 22,823 - 28,737 | **0** | 0 |
| chip25 | D1666C67A72B2835 | 2026-10-19 | **39,572.5** | **50,584** | 46,503 - 64,183 | **0** | 0 |
| chip26 | D16518B58F503638 | 2026-10-25 | **39,638.1** | **25,656** | 23,518 - 31,565 | **0** | 0 |
| chip30 | D1628C6597471430 | 2026-10-25 | **39,696.8** | **53,166** | 49,645 - 60,730 | **0** | 0 |
| chip31 | D1641086635D0E37 | 2026-10-25 | **39,621.5** | **26,543** | 22,855 - 28,855 | **0** | 0 |
| chip32 | DF603D0357252F26 | 2026-10-25 | **38,897.3** | **52,619** | 48,848 - 56,504 | **0** | 0 |
| chip33 | DF6858705F745F33 | 2026-10-25 | **38,790.2** | **35,462** | 32,185 - 43,305 | **0** | 0 |
| chip34 | DF6738825B416137 | 2026-10-25 | **38,851.8** | **34,398** | 32,685 - 39,781 | **0** | 0 |
| chip35 | DF6994870F4F412F | 2026-10-25 | **38,917.5** | **36,900** | 33,198 - 43,543 | **0** | 0 |
| chip36 | CA6194A2C32F0733 | 2026-10-25 | **39,717.3** | **24,509** | 24,487 - 24,523 | **0** | 0 |
| chip37 | D166B805DF3C2638 | 2026-10-25 | **39,820.8** | **26,313** | 23,158 - 29,520 | **0** | 0 |
| chip38 | D163808443284C2D | 2026-10-25 | **39,813.3** | **30,160** | 28,132 - 37,893 | **0** | 0 |
| chip39 | DF603D0357693E33 | 2026-10-25 | **38,704.4** | **53,364** | 49,778 - 58,932 | **0** | 0 |

- **표기**: 9/20 행의 width 기울임은 "그 세션의 앵커가 −302.8ps 이탈해 귀속을 유보했다" 는 당시 표시다. 네 런 모두
  `#PREP PASS` · `valid=1 reason=complete` 로 유효하며, §6 에서 측정계 안정이 확인된 뒤 §4 판정에 그대로 쓰였다
- 소거 median·min·max 는 prep 소거 n=128 섹터(0-127)의 값이다
- **2026-09-30 행(chip12·15·17·18)**: 추가 구매 배치 — chip12 만 알리익스프레스(검증 안 된 판매자)에서 사 다른 칩과 같은 칩으로 보지 않는다(로그 48 [D48-77], 신품 측정값에는 이상이 없었다). §4·§8 판정(n=9) 뒤에 잰 것이라 그 분모에 들지 않는다.
  네 런 모두 `#PREP PASS` · 2,520/2,520 행 `complete` · R8 통과, `git_rev` `aa74c33`, 리그는 우리, 칩당 newchip 1회.
  같은 시간대에 `#PREP FAIL jedec mismatch` 5건(`session_prepfail_20260930T160656Z`·`160945Z`·`161340Z`·`161419Z`·`162125Z`,
  JEDEC `00 00 00`·`FF FF FF`·`80 00 00`)이 있다 — UID 를 읽기 전에 멈춰 칩 귀속은 없고, 재장착 뒤 위 런이 PASS 했다
- **무리 분류값 (섹터 32-127 소거 중앙값, µs)**: chip12 47,782 · chip15 49,724.5 · chip17 26,408 · chip18 29,492.5.
  무리는 이 값으로 가른다(경계 40ms, 로그 48 [D48-40]) — 위 표의 0-127 median 과의 차는 70µs 이하
- **2026-10-01 행(chip14·16)**: 추가 구매 배치, 박지민 리그(보드 B), `git_rev` `29e5fb4`, n=9 판정 밖. 무리 분류값(32-127) chip14 36,313 ·
  chip16 26,862.5 µs. chip16 은 newchip 1회(batch `20261001T063724Z`, 스윕 `063914Z`).
- **2026-10-15 행(chip21 · 22 · 23)**: 3차 구매분 10개 중 셋 *(10/25 정정 — 3차는 6칩)*(10/16 00:43 - 00:55 KST, 보드 A · 921600, `git_rev` `a349d63`, 칩당 newchip 1회, 세 런 모두 `#PREP PASS` ·
  2,520/2,520 행 `complete` · BER 바닥 0, blank_pre 0 = 출고 상태 증거). 무리 분류값(32-127) chip21 48,892 · chip22 49,527 · chip23 49,391.5 µs — **셋 다 느린 무리**
  (chip03 · 07 · 15 · 08 의 47-53ms 띠 안). 마킹 `25Q64FVSIG`, 날짜 코드 1647 · 1413 · 1642(영웅님 판독). prep 프로그램(PRBS) 중앙값 6.74 · 6.61 · 6.66ms.
  n=9 판정 밖, 라벨 상한은 이날 chip30 까지 열었다(등록부 10/16). 배정은 등록부(chip21 교정 0 → 200k · chip22 65°C 온도 PE · chip23 블라인드). 나머지 7개는 뒤이어 잰다
- **2026-10-19 행(chip24 · 25)**: 3차 구매분 넷 · 다섯째(13:38 · 13:44 KST, 보드 A, `git_rev` 9a37c9e, newchip 1회씩 · 전부 `#PREP PASS` · 2,520/2,520 행 · blank_pre 0).
  무리 분류값(32-127) **chip24 24,866 — 빠른 무리, 전 칩 중 최소**(기존 빠른 26.0-33.7) · chip25 50,584 느린 무리. 마킹 chip24 `25Q64FVSIQ` `1542` · chip25 `????FVSIG`(앞 판독 불가) `1645`.
  prep 프로그램 6.67 · 6.97ms. 같은 날 `--mode sweep` 재측정(P/E 0): chip24 39,556.0(재장착, −27ps) · chip25 39,567.2(같은 장착, −5ps). chip25 의 세 번째 sweep(14:03)은
  호스트 프레이밍 슬립으로 무효(8,880ps · 체크 4 · 5 FAIL, `build/` 에만). 칩을 갈아 꽂은 직후 `JEDEC FF FF FF`(응답 없음) 10건 — 전부 재장착으로 풀림(접촉, 9/30 과 같음)
- **2026-10-25 행(chip26)**: 3차 구매분 여섯째(22:05 KST, 보드 A, `git_rev` 56f3b47, newchip 1회 · `#PREP PASS` · 2,520/2,520 행 `complete` · R8 통과 · BER 바닥 0 · blank_pre 0).
  무리 분류값(32-127) 25,697 — **빠른 무리**(chip24 24,866 다음). θ=1e-3 39,616.5 · 1e-4 39,604.0ps. prep 프로그램 6.61ms. 마킹 `25Q64FVSIG` `2122` — FV 중 가장 늦은 날짜 코드.
  0-6 ÷ 32-127 소거 비 0.98 · 7-31 ÷ 32-127 0.99(등록부 10/05 점검 범위 안). 배정 85°C 종단(등록부). **FV 신품 측정은 chip26 으로 끝** — JV 칩은 chip30 부터(영웅님, 10/25)
- **2026-10-25 JV 행(chip30-39)**: 디바이스마트 구매 JV 10칩, 전부 마킹 `25Q64JVSIQ`. 22:14 - 23:06 KST, 보드 A, `git_rev` 56f3b47, newchip 1회씩 · 전부 `#PREP PASS` · 2,520/2,520 행 `complete` · BER 바닥 0 · 체크 2 · 4 · 5 PASS · blank_pre 0.
  무리 분류값(32-127, µs) 30 53,165 · 31 26,597 · 32 52,732 · 33 35,478 · 34 34,409 · 35 36,053 · 36 24,516 · 37 26,321 · 38 30,133 · 39 53,364.
  θ=1e-3 (ps) 30 39,678.1 · 31 39,604.5 · 32 38,877.6 · 33 38,772.8 · 34 38,829.0 · 35 38,890.2 · 36 39,694.0 · 37 39,809.4 · 38 39,798.5 · 39 38,685.1. prep 프로그램(ms) 30 6.73 · 31 6.62 · 32 5.80 · 33 5.79 · 34 5.79 · 35 6.14 · 36 10.66 · 37 6.74 · 38 6.76 · 39 5.91.
  0-6 ÷ 32-127 소거 비 30 1.04 · 31 0.99 · 32 0.99 · 33 1.02 · 34 1.00 · 35 1.02 · 36 1.00 · 37 0.92 · 38 1.02 · 39 1.03. 날짜 코드 30 2505 · 31 2505 · 32 2033 · 33 1836 · 34 1736 · 35 2505 · 36 2505 · 37 2505 · 38 2505 · 39 2033.
  chip36 의 소거 min - max 는 24,487 - 24,523µs(폭 36µs). 같은 날 실패 런: `JEDEC FF FF FF` 8건 · 접촉 실패 서명(blank_pre 수만 비트 → `busy stuck`) 3건(`132724Z` — 뒤의 chip34, 13:45 재측정 blank_pre 0 · `140239Z` · `140430Z` — UID `0000000000000000`)
- **chip14 의 측정 기록** — 같은 날 prep 4회(섹터 0-127 P/E +4), 앞의 둘은 라벨 입력 전에 Ctrl-C 로 멈춰 장부에 자동 기록되지 않았다:

  | batch | 결과 | blank_pre (bits) | 소거 median / min - max (µs) | width @1e-2 / 1e-3 / 1e-4 (ps) | 채택 |
  |---|---|---|---|---|---|
  | `20261001T060304Z` | prep PASS → 라벨 단계 Ctrl-C | **0** | 36,239 / 34,147 - 41,682 | — | **소거·blank 의 값** (출고 상태) |
  | `20261001T061018Z` | prep PASS → Ctrl-C | 2,097,152 (앞 prep 의 PRBS) | 36,007 / 33,992 - 40,021 | — | — |
  | `20261001T061625Z` | 완료, chip14 등록 | 2,097,152 | 36,414 평균 | 38,803.0 / 38,774.4 / 38,723.5 (스윕 `061755Z`) | **width 의 값** |
  | `20261001T062828Z` | 완료 | 2,097,152 | 35,867 평균 | 38,810.3 / 38,786.6 / 38,728.9 (스윕 `062946Z`) | 재현 증인 (+7.3ps) |

  같은 시간대 `session_prepfail_20261001T*` 6건은 전부 JEDEC 불일치(`00 00 00` · `FF FF FF` · `EF 40 15`)로 P/E 0. `062946Z` 의 요약 CSV 는
  처음 받은 사본이 0 바이트였고, 지금 `data/` 의 파일은 온전하다(2,520행 `complete` · 오류 열이 `_reads` 위상 스텝별 합과 일치).
- **UID 앞바이트 `DF` 두 칩**: chip10(38,729.6ps · 33.0ms · 산포 1.15배)과 chip14(38,803.0ps · 36.3ms · 1.22배)는 width 가 나머지 13칩
  (39,326.7-39,801.5ps)보다 약 900ps 낮고, 소거 median 이 빈 구간(33.7-47.0ms) 안(chip14)이거나 바로 아래(chip10)이며, 섹터 산포가 느린 무리 쪽이다
- **chip01 이후**: 이 행은 신품값이다. chip01 은 이후 P/E 파일럿으로 섹터 0-6 이 300,000 사이클 마모됐다
  (`wear/wear_pilot_chip01_2026-09.md`)

### chip01 행의 측정 기록

| batch | 일자 | 리그 | 모드 | 결과 | width @10⁻² / 10⁻³ / 10⁻⁴ (ps) | 소거 (µs) | 채택 |
|---|---|---|---|---|---|---|---|
| `20260708T164931Z` 외 4 | 2026-07-08 | 우리 (2024.2 · N=100) | 스윕 ×5 | 유효 | 39,737.3 ± 0.61 | — | 7월 게재분 (`sweep_chip01_20260708T164931Z.md`) |
| `20260916T080924Z` | 2026-09-16 | 지민 PC | flash_prep | UID 확보 | — | median 28,567.5 | 등록·`chip_pe.md` +1 |
| 25MHz 4런 | 2026-09-16 | 지민 PC | 스윕 | **무효** (UART 결측) | 참고 39,703.4 ± 1.3 | — | 채택 안 함 |
| `20260916T120331Z` | 2026-09-16 | 지민 PC | 75MHz 스윕 | 유효, 840/840 | 12,183.1 | — | 조건이 달라 표 밖 |
| `20260922T153213Z` (스윕 `153305Z`) | 2026-09-22 | 우리 | newchip | 유효, 2,520/2,520 · R8 통과 | **39,659.0** / 39,640.0 / 39,625.4 | median 28,737 · mean 28,763 · >400ms 0 | **표의 값** |
| `20260922T153648Z` | 2026-09-22 (4분 뒤) | 우리 | newchip | 유효 | 39,661.5 / 39,644.8 / 39,631.3 | mean 29,024 | 재현 증인 (+2.5ps) |

- 25MHz 무효 4런: 112행 중 77·41·65·46 번째 스텝이 도중에 잘리고 뒤따르는 1-14 스텝이 빠졌다. 결측은 전부 창 안쪽
  평탄부이고 욕조 가장자리(step 589-610)는 온전하다
- 7/08 75MHz 런: `20260708T164038Z`, 12,205.3ps (2024.2 · N=100)
- `blank_pre` 는 2,097,152 bits(9/16 prep 이 쓴 PRBS 를 읽은 값)라 무효, `blank_post` 0
- 원본: `sweep_chip01_D1654CB09B352233_20260922T153305Z.csv` · `session_chip01_D1654CB09B352233_20260922T153213Z.log`

### chip04 — 같은 날 4회 (2026-09-16)

| 시각 | width @ 1e-2 | 직전에 있었던 일 | 12:57 대비 |
| ---- | --- | --- | --- |
| 12:57 | 39,687.9 | 신품 prep | — |
| 15:19 | 39,689.8 | 소켓 그대로 | +1.9 |
| 16:15 | 39,694.0 | 칩 교체 여러 번 뒤 재장착 | +6.1 |
| 16:25 | 39,740.6 | 접촉 실패(`FF FF FF`) 후 재장착 | **+52.7** |

### 세션별 width 범위

| | 9/15-16 (chip02·03·04·06) | 9/20 (chip07-10) |
| --- | --- | --- |
| width 범위 | 39,630 - 39,798 = **168ps** | 38,730 - 39,796 = **1,066ps** |
| 앵커 chip02 | 39,630.2 (기준값) | 39,327.4 — 기준 대비 **−302.8ps** |

- 9/16 이후 9/20 까지 `fpga/`·`ps/` 커밋 0건(chip06 `727a7be` → `02c78d0`). 측정 파라미터는 CSV 헤더에서 전 칩 동일
  (25MHz · N=112 · B=2,048 · dphi 15.873016ps)
- 천장 BER: chip02·chip03 0.2466, chip01 은 25/45/75MHz 세 클럭에서 0.2462 (7월)

### 무리 정리 — 신품 전수 끝 (2026-10-25)

무리 분류값 = 섹터 32-127 소거 중앙값(없는 칩은 위 표의 0-127 median, 차 70µs 이하). 경계 40ms([D48-40]). 측정 불가 chip05 · 11 · 13 은 뺐다.

| 무리 | 세대 | UID 앞 | 칩 (분류값 ms · 날짜 코드) | 수 |
| --- | --- | --- | --- | --- |
| 빠른 (40ms 미만) | FV | `D16x` | chip24 (24.9 · 1542) · chip06 (25.7 · 1430) · chip26 (25.7 · 2122) · chip09 (26.0 · 1548) · chip17 (26.4 · 1430) · chip16 (26.9 · 1551) · chip02 (27.2 · 1434) · chip01 (28.7 · 1541) · chip18 (29.5 · 1529) · chip04 (33.7 · 1450) | 10 |
| 빠른 (40ms 미만) | JV | `D16x` | chip37 (26.3 · 2505) · chip31 (26.6 · 2505) · chip38 (30.1 · 2505) | 3 |
| 빠른 (40ms 미만) | JV | `DF` | chip10 (33.0 · 1850) · chip34 (34.4 · 1736) · chip33 (35.5 · 1836) · chip35 (36.1 · 2505) · chip14 (36.3 · 1749) | 5 |
| 빠른 (40ms 미만) | JV | `CA` | chip36 (24.5 · 2505) | 1 |
| 느린 (40ms 이상) | FV | `D16x` | chip07 (47.0 · 1333) · chip21 (48.9 · 1647) · chip23 (49.4 · 1642) · chip22 (49.5 · 1413) · chip08 (49.5 · 1423) · chip15 (49.7 · 1327) · chip25 (50.6 · 1645) · chip03 (51.1 · 1309) | 8 |
| 느린 (40ms 이상) | 마킹 지워짐 · 별개 칩 | `D16x` | chip12 (47.8 · —) | 1 |
| 느린 (40ms 이상) | JV | `D16x` | chip30 (53.2 · 2505) | 1 |
| 느린 (40ms 이상) | JV | `DF` | chip32 (52.7 · 2033) · chip39 (53.4 · 2033) | 2 |

- 합계 31칩 = 빠른 19 · 느린 12. FV 19(chip12 포함) = 빠른 10 · 느린 9 · JV 12 = 빠른 9 · 느린 3
- 33-37ms 에 모인 칩: chip04(FV 33.7) · JV `DF` 의 chip10 33.0 · 34 34.4 · 33 35.5 · 35 36.1 · 14 36.3 — 40ms 경계로 빠른 무리로 센다
- 분류값 범위: FV 빠른 24.9-33.7 · FV 느린 47.0-51.1 · JV 빠른 24.5-36.3 · JV 느린 52.7-53.4 (전 칩 중 최대 3개가 JV)

## 2. chip02 상세

### 2.1 width — 같은 칩 3회

| 스윕 | UART | git_rev | width @ 10⁻² | @ 10⁻³  | @ 10⁻⁴  |
| --- | --- | --- | --- | --- | --- |
| `20260915T152201Z` | 115200 | c8b7b9f | 39,633.86 | 39,623.78 | 39,613.70 |
| `20260915T153944Z` | 921600 | c8b7b9f | 39,634.31 | 39,616.43 | 39,604.76 |
| `20260915T154600Z` | 921600 | a6e874d | 39,626.03 | 39,611.45 | 39,596.59 |

- **채택값 39,630.2 ps** = 921600 두 런의 평균. 115200 런은 조건 통일을 위해 채택에서 빼고 기록에는 남긴다
- 115200 런 − 921600 런 = +0.45ps · 3회 전체 표준편차 **4.65ps** (세 런 사이에 prep · 재프로그래밍 · MMCM 재락이
  매번 끼었고 칩은 JB 에 꽂힌 그대로)

### 2.2 소거 시간 — prep 3회 × 128섹터

| prep 세션 | median | min | max | mean | >400ms |
| --- | --- | --- | --- | --- | --- |
| `20260915T152106Z` | 27,233 | 23,945 | 31,542 | 27,097 | 0 |
| `20260915T153852Z` | 27,151 | 24,346 | 33,092 | 27,199 | 0 |
| `20260915T154507Z` | 26,797 | 24,125 | 32,827 | 27,322 | 0 |

- 채택 median **27,151µs** — 세 prep 중앙값의 중앙값. 섹터 간 범위 23.9-33.1ms (±17%)
- 데이터시트 W25Q64JV 4KB sector erase: typ 45ms · max 400ms
- 섹터별 128행 원본은 `data/session_chip02_*.log` 의 `#PREP ERASE` 행. 기계가 읽는 CSV 는 미구현(로그 30 §6 2단)

### 2.3 blank check

- `blank_post` = **0 bits** (3회 전부)
- `blank_pre` = **무효** — 관측값 2,097,152 bits(= 페이지 0-2,047 비트의 정확히 절반). 2026-09-15 첫 prep 이 UART
  단절로 호스트 모르게 완주해 이후의 `blank_pre` 는 우리가 쓴 PRBS 를 읽은 값이다. 출고 상태는 복원 불가
  (로그 30 §10.4, 등록부 chip02 비고)

## 3. chip03 상세

- 스윕 `20260915T155602Z` (git_rev `61b0d1e`) · prep 1회 · UART 921600

| 항목 | 값 |
| --- | --- |
| width @ 10⁻² / 10⁻³ / 10⁻⁴ | **39,652.76** / 39,636.49 / 39,622.75 ps |
| 천장 BER · 벽 폭 | 0.2466 · 6스텝 |
| 소거 (128섹터) | median **51,129** · min 46,888 · max 55,443 · mean 50,693 µs · >400ms 0건 |
| `blank_pre` | **0 bits** (페이지 0-32,767 전역, t=27.1s) |
| `blank_post` | 0 bits (페이지 0-2,047, t=1.7s) |

- 전역 스캔 시간: chip03 27.1s · chip02 29.8s (chip02 는 `BLANKADDR` 1,024행을 115200 으로 출력한 3.1s 포함, 빼면 26.7s)

## 4. 이상치 판정 기록 (S-2 §6)

산출 (n=8, 2026-09-20 — chip01 25MHz 유효 런 없음 · chip05 측정 불가로 제외) — 중앙값 **39,641.5** · MAD 148.7 ·
로버스트 σ 220.5 · 3σ 661.4:

| 칩 | width @ 1e-2 | 중앙값 대비 | 후보 여부 | 재측정 | 판정 |
| --- | --- | --- | --- | --- | ---- |
| chip02 | 39,630.17 | −11.3 | 아니오 | — | 보류 |
| chip03 | 39,652.76 | +11.3 | 아니오 | — | 보류 |
| chip04 | 39,687.93 | +46.5 | 아니오 | — | 보류 |
| chip06 | 39,798.01 | +156.6 | 아니오 | — | 보류 |
| chip07 | 39,795.67 | +154.2 | 아니오 | — | 보류 |
| chip08 | 39,498.27 | −143.2 | 아니오 | — | 보류 |
| chip09 | 39,326.73 | −314.7 | 아니오 | — | 보류 |
| chip10 | 38,729.64 | **−911.8** | **예** (3σ 밖)  | **2회** | **개체 특성 — 채택** |

### 2026-09-22 재산출 — chip01 을 넣은 n=9

중앙값 **39,652.76** · MAD 142.9 · 로버스트 σ 211.9 · 3σ 635.6. 새 후보 없음.

| 칩 | 중앙값 대비 (n=9) | 칩 | 중앙값 대비 (n=9) |
| -- | --- | -- | --- |
| chip01 | +6.3 | chip07 | +142.9 |
| chip02 | −22.6 | chip08 | −154.5 |
| chip03 | 0.0 | chip09 | −326.0 |
| chip04 | +35.2 | chip10 | **−923.1** (3σ 밖) |
| chip06 | +145.2 | | |

### chip10 재측정

| 시각 | width | 직전 값과의 차이 |
| ---- | ----- | --- |
| 07:29 (1차) | 38,729.64 | — |
| 07:43 (2차) | 38,710.05 | −19.6 |
| 07:56 (3차) | 38,702.86 | −7.2 |

- 범위 26.8ps · 재현 기준 41.6ps(= 3 × σ_repeat, S-2 §6.2 2026-09-20 개정). 매 런 `#G2 UID DF685453E7791531`, 세 런 모두
  `valid=1 reason=complete`. 세 값 모두 채택
- 벽 폭: chip10 1,270-1,297ps(최대) · chip07 204.3ps(최소)

### 참고 — 9/15-16 4칩만으로 낸 기준

중앙값 39,670.3 · MAD 28.9 · 로버스트 σ **42.8** · 3σ 128.5. 이 기준으로는 chip08(−172.1) · chip09(−343.6) ·
chip10(−940.7)이 밖, chip07(+125.3)은 안.

### 무효·제외 런

- 9/20 의 네 런과 재측정분: 무효 0 (전부 `#PREP PASS` · `valid=1 reason=complete`). 규칙 밖 제외 0 (A3)
- `sweep_chip02_..._20260915T150640Z_invalid` — 스윕 시작 직후 19스텝 결측(계약 §6 ⑤). 원인: 호스트가 xsct 구간에
  UART 를 읽지 않아 버퍼가 넘침, 그 자리에서 수정(로그 30 §10.3). 집계에서 제외, 파일 보존

## 5. 재현

```bash
uv run python host/run/run_sweep_chip.py --mode newchip --mhz 25   # prep + 스윕 + 분석 (칩당 약 3분)
uv run python host/analysis/bathtub_analysis.py data/sweep_<label>_<uid16>_<stamp>.csv
```

소거 시간은 세션 로그의 `#PREP ERASE SUMMARY` 행, blank 는 `#PREP BLANK` 행에서 읽는다.

## 6. 앵커 기록 — 재장착 MSA (S-2 §8)

| # | 일자 | 시각 | 스윕 | 재장착 | width @ 1e-2 | 기준(39,630.2) 대비 |
| - | ---- | ---- | ---- | --- | --- | --- |
| ① | 2026-09-15 | — | 3회 (`152201Z`·`153944Z`·`154600Z`) | 없음 | 39,630.2 (평균) · σ 4.65 | 기준값 자체 |
| — | 2026-09-16 | 16:10 | `20260916T161026Z` | 없음 | 39,633.72 | +3.5 |
| — | 2026-09-16 | 16:18 | `20260916T161820Z` | 있음 + prep | 39,563.12 | −67.1 |
| ② | 2026-09-20 | 07:37 | `20260920T073705Z` | 있음 | **39,327.43** | **−302.8** |
| ③ | 2026-09-20 | 07:39 | `20260920T073918Z` | 있음 | **39,307.57** | **−322.6** |
| ④ | 2026-09-20 | 07:41 | `20260920T074058Z` | 있음 | **39,249.94** | **−380.2** |
| ⑤ | 2026-09-20 | 07:45 | `20260920T074539Z` | 있음 (chip10 을 거친 뒤) | **39,561.66** | **−68.5** |

- ②-⑤ 는 `--mode sweep`(prep 없음, P/E 불변), 매번 `#G2 UID` 확인, `git_rev` `02c78d0`
- G-a 판정선: 39,630.2 ± 3σ(약 14ps)
- chip02 ②-⑤ 의 σ = 137.33ps (범위 311.7)
- **`reseat` 열 주의**: chip10 세 런의 CSV `reseat` 열은 `0` 이지만 실제로는 세 번 다 재장착했다. 이 표의 「재장착」 칸이 정본

### 대조군 chip10 — 같은 세션, 3회 재장착

| 시각 | width | 벽 폭 | 벽 중심 |
| ---- | ----- | ----- | --- |
| 07:29 | 38,729.64 | 1,270.4 | 10,481.7 |
| 07:43 | 38,710.05 | 1,289.9 | 10,551.7 |
| 07:56 | 38,702.86 | 1,297.1 | 10,505.8 |

**σ_repeat = 13.86 ps (범위 26.8)** — 이 값이 이후 문서가 쓰는 재장착 σ 의 정본이다. 3 × σ_repeat = 41.6ps.

### §6.3 분기

| σ_between 을 무엇으로 잡나 | 값 | `> 41.6`? |
| --- | -- | ---- |
| 9/15-16 의 4칩 | 74.4 | 예 |
| 8칩 전체 | 353.3 | 예 |
| 9칩 전체 (2026-09-22, chip01 포함) | 333.9 | 예 |

→ 분해된다. 칩당 1회 측정으로 종료, S-2 §6.3 의 전 칩 3회 재측정은 집행하지 않는다.

## 7. chip05 — 측정 불가 (누적 4회)

| 일자 | 시도 | 결과 |
| ---- | ---- | ---- |
| 2026-09-16 | 3회 | `#PREP JEDEC FF FF FF` → `#PREP FAIL jedec mismatch` |
| 2026-09-20 | 1회 (07:34) | 〃 (`data/session_prepfail_20260920T073408Z.log`) |

같은 리그에서 직전·직후 칩은 정상. 분모에서 제외해 `n = 9`. 시도 기록과 파일은 보존.

## 8. 인수 판정 (S-2 §10) — 2026-09-20

| # | 기준 | 판정 | 근거 |
| - | ---- | ---- | ---- |
| A1 | 전부 유효 런 확보 | **충족** (2026-09-22) | 9칩 전부 `#PREP PASS` + `valid=1 reason=complete`, `_invalid` 0건. chip05 는 분모에서 제외. 9/20 에는 조건부였다 — chip01 25MHz 유효 런이 없었고 2026-09-22 우리 리그 재측정으로 채워졌다 |
| A2 | UID 중복 없음 | **충족** | 확보된 UID 9건이 서로 다르다. chip10 의 `DF68…` 는 앞바이트가 유일하게 다르나 재측정 3회에서 같은 값으로 재독됐다 |
| A3 | §6 판정이 사전 규칙대로 | **충족** | §4 에 후보·재측정·채택이 전부 기록. 규칙 밖 제외 0건. 재현 기준은 2026-09-20 개정분(`3 × σ_repeat`), 개정 근거는 S-2 §6.2 |
| A4 | §6.3 분기 판정 기록 | **충족** | §6. `353.3 > 3 × 13.86` → 1회 측정으로 종료. chip01 포함 n=9 로도 `333.9 > 41.6` |

M 트랙 종료: 2026-09-22.
