young-0320/flash-margin-bench/docs/results/data/inverse_v4_3_ceiling_2026-10.md

# inverse_v4_3_ceiling_2026-10 — v4.3 6장 판 · 상한 근처 점 추정 후보 비교 (v4.3.0-v4.3.6)

> 수치와 표만 둔다. 판단은 로그 52 §15. **브랜치 `inverse-v4.3-ceiling` 의 결과 — main 에 머지 전.**
> 5장 판 수치와 (가) 기각은 `inverse_v4_3_eval_2026-10.md` §3.3 · §3.4.

- **교정 (6장 판, 2026-10-21)**: 교정 9칩 그대로(chip01 · 02 · 03 · 04 · 06 · 07 · 09 · 15 · 18), 100k 너머 곡선 6장 — chip01 300k · chip03 · 06 · 07 · 09 · 15 200k.
  chip21(교정 밖, [D52-12]) · 온도 칩 · JV · 알리는 밖. `A_SESSIONS` 에 chip07 연장 세션 `1792429510` · `1792494559` 추가. 모델 식 · ρ 등록값(0.00 · 0.78 · 0.29) · R 유도 ·
  관측(rows P5 × 반복 20) · LOCO 106점(정답 ≤ 100k) 그대로
- **후보**: 상한 근처 점 추정 처리 일곱 가지 — 대표값만 바꾼 넷(1-4), 분포(지지 · 사전)를 바꾼 둘(5 · 6), 기준(0). 정의는 `host/analysis/inverse_ceiling_study.py` 머리
- **채점 (스크립트 머리에 결과 전 고정)**: ① 로그 눈금 CRPS 평균(적정 점수 규칙 — 예측 분포 전체) ② 점 추정 평균 |ln(추정/정답)|(배율 오차 — 이 손실의 베이즈
  최적은 사후 중앙값) ③ 68 · 95% HPD 포함률(106점 띠 68% 63-81 · 95% 97-105)과 폭 ④ 정답 구간별 추정/정답. 선택: ① 로 분포 → 95% 띠 합격 조건 → ② 최소 → ② 차 0.01 안이면 ④
  (rows P5 × 1 의 동작 확인을 한 번 본 뒤 20회 본 측정을 돌렸다 — 규칙은 그 전에 적혀 있었다)

## 1. 6장 판 기준 측정 (v4.3.0 = 대표값 중앙값)

| 항목 | 5장 판 (10/19) | **6장 판 (10/21)** |
|---|---|---|
| ρ_s · ρ_p · ρ_chip (재측정) | 0.00 · 0.78 · 0.20 | 0.00 · 0.78 · **0.21** (빠른 0.24 · 느린 0.01) |
| R 빠른 · 느린 | 2.72 · 1.52 | 2.72 · **1.59** (느린 r̂ chip03 1.056 · 07 0.798 · 15 1.187) |
| 106점 68% / 95% (rows P5 ×20) | 82.6% / 94.7% | 82.5% / 94.7% — 68% 과소신 · 95% 합격 |
| 68% 폭 | 33,000 | 34,000 |
| 50-100k 68% · 추정/정답 | 79.1% · 0.84 | 79.1% · 0.84 |
| p50 관측 | 87 · 102 / 106 | 87 · 102 / 106 |
| 합성 복원 (정체 칩 뺌 · prep 5회) 68 · 95 | 66 · 96 | 69 · 95 |
| 칩별 68% (03 · 07 · 15) | 84 · 67 · 99% | 84 · 67 · 98% |

- chip07 200k 곡선은 느린 무리의 R 만 조금 넓혔고(1.52 → 1.59) LOCO 는 사실상 같다. chip04 95% 57%(r̂ 2.07)는 그대로. 그림 `../plots/synthetic_recovery_v4_3_6curves_2026-10.png`

## 2. 후보 비교 (rows P5 × 20 · 106점 · 2,120 판정)

| 후보 | 내용 | CRPS(log) | 평균 \|ln(추정/정답)\| | 중앙 \|ln\| | 68% | 95% | 68% 폭 | 추정/정답 | 최대 구간 치우침 \|ln\| |
|---|---|---|---|---|---|---|---|---|---|
| v4.3.0 | 중앙값 (기준) | 0.2192 | 0.329 | 0.214 | 82.5% | 94.7% | 34,000 | 0.96 | 0.192 |
| v4.3.1 | MAP | 0.2192 | 0.471 | 0.421 | 82.5% | 94.7% | 34,000 | 0.78 | 0.692 |
| v4.3.2 | 사후 평균 | 0.2192 | 0.310 | 0.216 | 82.5% | 94.7% | 34,000 | 1.00 | 0.278 |
| v4.3.3 | 하한 q16 | 0.2192 | 0.600 | 0.598 | 82.5% | 94.7% | 34,000 | 0.56 | 0.692 |
| v4.3.4 | 상한 규칙 (P(x>90k)≥0.5 → 95k) | 0.2192 | 0.329 | 0.214 | 82.5% | 94.7% | 34,000 | 0.96 | 0.192 |
| v4.3.5 | 지지 200k · 중앙값(100k 에서 자름) | 0.2506 | 0.341 | 0.223 | 84.4% | 95.6% | 33,000 | 1.18 | 0.223 |
| v4.3.6 | 로그 균등 사전 · 중앙값 | 0.2475 | 0.461 | 0.381 | 56.3% | 92.2% | 34,000 | 0.71 | 0.692 |

| 후보 | ≤3k 추정/정답 · 평균 |ln| | 3-20k 추정/정답 · 평균 |ln| | 20-50k 추정/정답 · 평균 |ln| | 50-100k 추정/정답 · 평균 |ln| |
|---|---|---|---|---|
| v4.3.0 | 1.17 · 0.695 | 1.08 · 0.371 | 1.21 · 0.245 | 0.84 · 0.210 |
| v4.3.1 | 0.50 · 0.788 | 0.55 · 0.572 | 0.79 · 0.449 | 0.86 · 0.311 |
| v4.3.2 | 1.32 · 0.565 | 1.15 · 0.379 | 1.23 · 0.250 | 0.84 · 0.212 |
| v4.3.3 | 0.50 · 0.844 | 0.55 · 0.594 | 0.69 · 0.424 | 0.57 · 0.611 |
| v4.3.4 | 1.17 · 0.695 | 1.08 · 0.371 | 1.21 · 0.245 | 0.84 · 0.210 |
| v4.3.5 | 1.17 · 0.695 | 1.08 · 0.372 | 1.25 · 0.341 | 1.11 · 0.181 |
| v4.3.6 | 0.50 · 0.861 | 0.73 · 0.510 | 0.82 · 0.306 | 0.69 · 0.371 |

- v4.3.4 의 규칙(P(x > 90k) ≥ 0.5)은 한 번도 걸리지 않았다 — 정답 100k 의 사후도 90k 너머 질량이 절반에 못 미친다(사후가 넓다). 결과가 v4.3.0 과 같다
- 대표값만 바꾼 후보(1-4)는 분포가 같아 CRPS · 포함률 · 폭이 v4.3.0 과 같다

## 3. 선택 — v4.3.2 (사후 평균)

- ① 분포: 지지 1-100k · 평평한 사전(v4.3.0 계열) 0.2192 이 지지 200k(0.2506) · 로그 균등 사전(0.2475)보다 낫다. 95% 94.7%(100.4/106)로 띠 안
- ② 그 분포 위의 대표값: 평균 0.310 · 중앙값 0.329 · MAP 0.471 · q16 0.600 — **평균** (차 0.019 > 0.01 이라 ④ 로 넘어가지 않음)
- 브랜치에 `MODEL_VERSION` "v4.3" · `MODELS["v4.3"] = v4 + point mean` 으로 넣고 등록 LOCO 를 다시 돌렸다: 106점 82.5% · 94.7% · 폭 34,000 · 추정/정답 0.99
  (구간별 ≤3k 1.50 · 3-20k 1.15 · 20-50k 1.22 · 50-100k 0.84 — 평균이 든 1k 구간 기준이라 ≤3k 는 위 표의 1.32 보다 크게 나온다)

## 4. 상한 문제는 풀리지 않았다

- 고마모 50-100k 의 추정/정답은 분포를 바꾸지 않는 후보 전부에서 0.84(빠른 0.82 · 느린 0.88)이고, 이를 바꾼 유일한 후보(지지 200k)는 1.11 로 넘어가며 CRPS 가 14% 나빠진다
- 결과 전 기준(50-100k 추정/정답 ≥ 0.90)을 만족하는 후보는 없다

## 5. 확정 전 점검 (2026-10-23)

- **코드**: 브랜치 diff 는 `A_SESSIONS`(chip07 연장) · 연구용 인자(support · prior · keep_post, 기본값은 그대로) · `MODELS["v4.3"]`(point mean) · 화면/기록 줄뿐. 화면의
  「사후 평균/중앙값 활용」 문구가 실제로 쓴 모델이 아니라 기본 버전을 보고 있던 것을 고쳤다(`point_kind`). 테스트 178 통과
- **ρ_chip 등록값**: v4 원칙(잰 값을 쓴다)대로 6장 판 재측정값 0.21 로 바꿨다. 등록 LOCO(v4.3 · rows P5 × 20): 0.29 → 0.21 에서 68% 82.5 → 81.6% · 95% 94.7 → 94.1% ·
  폭 34,000 그대로 · 50-100k 0.84 그대로 — 판정 같음(68% 과소신 · 95% 합격)
- **현장 역산(85°C 칩, 상온 교정)**: chip22 정답 100k — v4 중앙값 95-96k → v4.3 평균 93-94k(68% 92-100k 같음) · chip24 정답 100k — 65-66k → 65-66k(68% 45-92k 같음).
  대표값 교체가 구간에는 영향 없고 점 추정은 1k 구간 안팎으로만 움직인다
- **1k 구간 표기의 한계**: 대표값을 1k 구간으로 내므로 정답 1k · 3k 의 추정/정답은 구간 중앙(1,500 · 3,500)으로 계산돼 ≤3k 버킷이 1.50 으로 보인다(중앙값도 같은 구간에 든다). 저마모의 판정(신품/저마모)에는 영향 없다

## 6. 확정 — v4.3

| 항목 | v4.3 |
|---|---|
| 교정 | 9칩 · 100k 너머 곡선 6장(chip01 300k · chip03 · 06 · 07 · 09 · 15 200k), chip21 · 온도 · JV · 알리 밖 |
| 셀 · 증거량 · 정렬 · R | v4 그대로 (분위수 21 · n_eff · 칩 속도 정렬 · σ_r 유도 — 빠른 2.72 · 느린 1.59) |
| ρ_s · ρ_p · ρ_chip | 0.00 · 0.78 · **0.21** (재측정) |
| 사전 · 답 범위 | 1-100k 평평 (지지 200k · 로그 균등 사전은 CRPS 로 기각) |
| 대표값 | **사후 평균** (배율 오차 0.310 — 중앙값 0.329 · MAP 0.471) |
| 구간 | 68 · 95% HPD |
| LOCO (rows P5 × 20 · 106점) | 68% 81.6% 과소신 · 95% 94.1% 합격 · 폭 34,000 · 50-100k 추정/정답 0.84 |
| 알려진 한계 | 정답 80k 이상 과소추정(정보 한계) · 68% 과소신 · chip04 95% 57% · chip12 · 21 형 느린 신품 · 고온 이력 칩은 68% 22/48(95% 47/48) |

## 7. 7장 판 — 등록 뒤 chip02 200k 를 넣어 완성 (2026-10-23)

chip02 100k → 200k 승격으로 100k 너머 곡선이 7장(chip01 300k · chip02 · 03 · 06 · 07 · 09 · 15 200k)이 됐고, `A_SESSIONS` 에 chip02 연장 세션 `1792520588` 을 넣었다.
모델 식 · ρ 등록값 · 대표값은 그대로.

| 항목 | 6장 판 (등록 때) | **7장 판 (현행)** |
|---|---|---|
| R 빠른 · 느린 | 2.72 · 1.59 | **2.80** · 1.59 (chip02 r̂ 0.636 → 0.608, σ_r 0.472 → 0.486) |
| ρ_s · ρ_p · ρ_chip 재측정 | 0.00 · 0.78 · 0.21 | 0.00 · 0.78 · 0.21 (빠른 0.25 · 느린 0.01) — 등록값 그대로 |
| LOCO 106점 68% · 95% | 81.6% · 94.1% | 81.7% · 94.5% (과소신 · 합격) |
| 68% 폭 · 바깥 폭/대표값 90분위(③) | 34,000 · 1.33 | 34,000 · 1.33 |
| 추정/정답 전체 · 50-100k | 0.98 · 0.84 | 1.02 · 0.84 |
| 합성 복원 (정체 칩 뺌 · prep 5) 68 · 95 | 69 · 95 | 71 · 96 |

- 판정 · ③ 값이 같다. 학습 곡선(빠른 무리 k = 3 포화)대로 곡선 한 장이 늘어도 숫자는 움직이지 않는다. **chip08 은 이 7장 판으로 개봉한다.** 그림 `../plots/synthetic_recovery_v4_3_7curves_2026-10.png`

## 재현

```bash
uv run python host/analysis/wear_inverse.py --rate-rule ; uv run python host/analysis/wear_inverse.py --rho --prep-k 5
uv run python host/analysis/wear_inverse.py --loco --loco-obs rows --prep-k 5 --reps 20 --study --model v4      # §1 (v4.3.0)
uv run python host/analysis/wear_inverse.py --loco --loco-obs rows --prep-k 5 --reps 20 --study                 # §3 (v4.3 = 평균)
uv run python host/analysis/wear_inverse.py --synthetic 500 --plot build/inverse/v43_6/synthetic_v43_6.png --model v4
uv run python host/analysis/inverse_ceiling_study.py --reps 20 --out build/inverse/v43_6/ceiling.md                 # §2
```
