young-0320/flash-margin-bench/docs/results/wear/wear_endurance_200k.md

# 200k 연장 마모 결과 해석 — chip06 · chip09 (빠른 무리) · chip03 · chip15 (느린 무리) · chip21 (신품 느린 · 빠른 노화) · chip07 (느린) · chip02 (빠른), 100,000 → 200,000 사이클

- **작성일**: 2026-10-14 · **chip03 추기** 2026-10-16 · **chip15 추기** 2026-10-17 · **chip21 추기** 2026-10-19 · **측정**: chip06 2026-10-12 - 10-13 · chip09 2026-10-13 - 10-14 · chip03 2026-10-14 - 10-15 · chip15 2026-10-15 - 10-16 · chip21 2026-10-16 - 10-19 (0 → 200k 한 세션, 다섯 다 보드 A · 921600)
- **수치**: [`data/wear/wear_endurance_chip06_2026-10.md`](../data/wear/wear_endurance_chip06_2026-10.md) ·
  [`data/wear/wear_endurance_chip09_2026-10.md`](../data/wear/wear_endurance_chip09_2026-10.md) · [`data/wear/wear_endurance_chip03_2026-10.md`](../data/wear/wear_endurance_chip03_2026-10.md) §6 ·
  [`data/wear/wear_endurance_chip15_2026-10.md`](../data/wear/wear_endurance_chip15_2026-10.md) §6 ·
  [`data/wear/wear_endurance_chip21_2026-10.md`](../data/wear/wear_endurance_chip21_2026-10.md) (+ 동명 CSV) — 표를 다시 싣지 않고 거기를 인용한다
- **왜 200k 인가**: 역산 v4/v4.1 의 답 범위는 교정 칩이 모두 닿는 100k 까지이고, 블라인드가 100k 근처면 점 추정이 낮게 치우쳐 범위만 준다([D48-107] · 로그 52 §11).
  답 범위를 150k 너머로 넓히려면 100k 너머의 교정 곡선이 있어야 한다 — v4.2(프로그램 축)를 폐기한 자리에서 정한 다음 단계다(로그 52 [D52-9]).
  300k 는 가지 않는다 — 2차 계단은 chip01 300k 한 장으로 모양을 알고, 같은 구간에 칩이 여럿 있어야 칩 간 흩어짐(ρ_chip)을 잴 수 있으며, 200k 너머는 사이클당 1초를 넘는다
- **한 편으로 묶은 이유**: 물음이 같다(100k 안에 계단이 없던 칩은 100k 너머에 밟나) — 칩마다 한 편이라는 `wear/` 규칙의 예외. 느린 무리 chip03 은 §6(10/16) · chip15 는 §7(10/17) · chip21(0 → 200k)은 §8(10/19)
- **사전 등록**: `docs/spec/s1.wear_bench_spec.md` §15 — H1′·H2′(2026-09-26) · H3·H4 · H6(2026-09-27). 200k 구간은 사전 등록 범위(100k) 밖이라 판정이 아니라 **관측**이다.
  단, 10/14 chip06 결과를 본 뒤 chip09 에 대해 「160k 안에 7섹터 전부 전환」 을 돌리기 전에 적었고(맞음), chip03 에 대해서는 S-1 §15 10/14 추기에 「① 직전 84ms 이상 · ② 착지 = 직전 + 21±4ms」
  를 돌리기 전에 적었다(**틀림** — §6). chip15 에 대해서는 chip03 을 본 뒤 S-1 §15 10/16 추기에 「계단 없이 미끄럼 · 200k 배율 약 2.1」 을 적었다(**맞음** — §7, 2.25). chip21 에 대해서는 「미끄럼 · 200k 배율 2.1-2.3」 을 적었다(**틀림** — §8, 2.93: 미끄럼은 맞고 속도가 빠른 무리)
- **경위**: 로그 52 §13

## 결론

**100k 안에 계단이 없던 빠른 칩 둘이 모두 110k-158k 에 7섹터 전부 계단을 밟았고, 160k 부터 200k 까지는 두 칩이 같은 104-109ms 평탄 구간에 있다.
폭은 200k 까지 3σ 안이고, 프로그램은 chip06 이 1.9배 오르는 동안 chip09 는 1.01배로 움직이지 않았다.** 계단은 빠른 무리의 「있고 없고」 가 아니라
「언제」 의 문제였고, 그 시점은 100k 시점의 소거 수준이 말해 준다. **느린 무리 chip03 은 같은 85-93ms 에서 출발해 같은 105ms 를 지났지만 계단이 아니라
미끄럼이었다** — 한 구간 상승 5-12ms, 분포 폭 20-25ms 로 벌어진 채 70k 에 걸쳐 올라, 「계단 = 빠른 무리의 표지」 가 200k 에서도 선다(§6). **느린 두 장째 chip15 도 같은 미끄럼이었고(§7), 느린 무리 100k-200k 곡선이 두 장이 돼 v4.3 의 느린 무리 LOCO 채점이 가능해졌다.** 그런데 **느린 신품(48.9ms)으로 들어간 chip21 은
빠른 무리 속도로 늙었다(200k 2.93배, chip12 와 같은 꼴) — 「신품 소거가 느리면 느리게 늙는다」 는 전제가 두 번째로 깨졌고, 상온 모델은 이 칩을 68% 0/12 로 전부 틀린다(§8).**

| 가설 | 등록 기준 | chip06 | chip09 | 읽기 |
|---|---|---|---|---|
| H1′ 폭 3σ 안 | 42ps | 보드 A 안(20k-200k) ±8ps — 20k 의 −55ps 는 재장착 단차 | 체크포인트 100 대비 +22-25ps(120k 부터) | **둘 다 안** — 200k 까지 관측 (§1) |
| H2′ 프로그램 불변 | 보이면 깨짐 | 6.55 → 12.4ms(1.9배, 20k 부터 계속) | 6.50 → 6.56ms(1.01) | chip06 거짓(100k 안에서 이미) · chip09 참 (§3) |
| H3 계단 양자 21±4ms | 전 섹터 | 18.6-21.3ms | 18.1-20.9ms | 14/14 안 (§2) |
| H4 전환 순서 = 신품 소거 내림차순 | ρ ≥ 0.5 | 0.32 | −0.29 | 둘 다 못 미침 — 신품값은 첫 구간 대리 (§2) |
| H6 ① 직전 84ms 이상 ② 착지 107-112ms | 계단 온 섹터 전부 | ① 83.0-86.8 ② 103.3-104.2 | ① 83.0-87.7 ② 94.6-103.2 | ① 13/14 ② **0/14 — 착지가 3-5ms 낮다** (§2) |
| (chip03, 10/14 예측) 110-130k 에 계단 · 착지 = 직전 + 21±4 | 느린 무리 첫 200k | — | — | **틀림 — 계단 없이 미끄럼** (§6, chip03 열은 §6 표) |
| (chip15, 10/16 예측) 계단 없이 미끄럼 · 200k 배율 약 2.1 | 느린 무리 두 장째 | — | — | **맞음 — 미끄럼, 2.25** (§7) |
| (chip21, 10/17 예측) 미끄럼 · 200k 배율 2.1-2.3 | 느린 신품 세 장째 | — | — | **틀림 — 미끄럼은 맞고 2.93 (빠른 무리 속도)** (§8) |

## 1. 폭은 200k 까지 움직이지 않았다

chip06 은 보드 A 에 꽂은 20k 부터 200k 까지 19점이 39,603-39,618ps(±8ps)다. 1k-12k(보드 B · 박지민)와의 −55ps 는 장착이 바뀐 자리에서 한 번에
생겼고 그 뒤 180k 동안 다시 움직이지 않았으므로 마모가 아니라 재장착 단차로 읽는다(chip14 90k 의 −43ps 와 같은 종류 — 창 위치는 보지 않았다).
chip09 는 같은 장착으로 0 → 200k 를 갔는데 100k 까지 +11ps 안이던 폭이 110k +15 · 120k +21 로 한 번 옮겨 200k 까지 +21-25ps 에 머문다.
13일 휴지 뒤 재개한 자리와 겹치지만 소거 시간은 휴지 전후가 이어지므로(수치 §1) 칩이 변한 것은 아니다 — 3σ(42ps) 안이라 H1′ 은 깨지지 않았고,
창 위치를 보지 않아 장착인지 다른 무엇인지는 이 데이터로 가르지 못한다. **정격 내구의 2배까지 25MHz 마진은 3σ 안** — 파일럿 chip01 300k(+15ps)에 이어 두 칩째다.

## 2. 계단은 「언제」 의 문제였다 — 그리고 두 칩이 같은 곳에 착지했다

100k 시점에 chip06 은 섹터 0 만(90k), chip09 는 섹터 6 만(92k) 105ms 를 넘었고 나머지 12섹터는 67-85ms 였다. 200k 까지 가자 12섹터 전부가
110k-158k 에 전환했다 — chip06 116 · 126 · 132 · 132 · 152 · 158k, chip09 110 · 129 · 130 · 131 · 133 · 157k. 높이는 14섹터 전부 18.1-21.3ms 로 H3 의
21±4ms 안이고, chip18(19.7-23.1) · chip01(19.7-22.0)과 같은 양자다.

**착지가 낮다.** H6 ② 는 「착지 107-112ms」 인데 두 칩 14섹터의 전환 구간 중앙값은 94.6-104.2ms 다. 전환 구간 A 행을 chip18 의 눈금(94 · 108ms)으로
가르면 94-108 사이가 50-62% 로, chip18 의 「가운데 0%」(두 봉우리)와 다르다 — 두 칩은 약 85 → 약 103 으로 뛰고 그 뒤 200k 까지 천천히 107-109 로 올랐다.
chip01 이 110 에 착지해 116 까지 기어오른 것과 같은 모양이고, 착지 수준만 chip18 · chip01 보다 한 눈금 낮다. 계단 높이(21ms 양자)는 같으므로 **직전 수준이
낮은 칩이 낮은 곳에 착지한 것**이다 — ① 의 「84ms 이상」 은 13/14 가 지켰고(chip06 섹터 0 · chip09 섹터 5 가 83.0), ② 는 직전 수준에 따라 움직이는 값이라
고정 띠로 둘 수 없다. H6 는 「①·② 모두 참」 에서 「① 참 · ② 는 직전 + 약 21ms」 로 고쳐 쓰는 것이 맞다(S-1 §15 10/14 추기).

**전환 뒤 수천 사이클을 오간다.** chip06 섹터 2 · 3 · 6 과 chip09 섹터 0 · 1 · 2 는 전환 3-5k 뒤 다시 문턱 아래(78-87ms)로 내려갔다가 160k 전에 올라섰다.
chip01 의 「두 값 사이를 수천 사이클 오감」 이 두 칩에서도 보인다. H4(신품에 느린 섹터가 먼저)는 0.32 · −0.29 로 두 칩 다 0.5 에 못 미친다 — chip06 은
1-100 로그가 없어 101-1,000 구간을 신품 대리로 썼고, 두 칩 모두 섹터 간 신품 차이가 28-37ms 로 좁아 순서가 설 자리가 작다.

**160k 부터 200k 는 평탄 구간이다.** 7섹터가 전부 넘은 뒤 두 칩의 섹터 중앙값은 104-109ms 로 40k 동안 3-5ms 만 오른다. 2차 계단(chip01 203-283k, 116 → 137ms)은
200k 안에 오지 않았다.

## 3. 프로그램은 칩을 가른다 — chip06 1.9배, chip09 1.01배

0x00 마모 루프 프로그램 p50 은 chip06 이 20k 부터 꺾이지 않고 올라 200k 에 첫 구간의 1.83-1.97배(12.1-12.9ms)다. chip09 는 같은 200k 동안 7섹터 전부
1.01배(6.50 → 6.56ms). 같은 빠른 무리 · 같은 FV · 같은 계단을 밟은 두 칩이 프로그램에서는 정반대다. v4.2 를 폐기한 이유(「프로그램이 오르는 양이 칩마다 달라
칩 정체로 읽힌다」, 로그 52 §12)의 가장 센 예이고, 150k 너머 평탄 구간에서 프로그램을 보조 신호로 쓰는 길은 chip09 같은 칩에는 없다.

## 4. 역산 v4.3 에 주는 것

- **답 범위를 넓힐 재료는 생겼다** — 빠른 무리 두 칩이 100k-200k 를 같은 모양으로 덮고(150k 배율 4.08 · 3.98, 200k 4.18 · 4.15), 느린 무리도 두 장(chip03 1.88 · 2.10 · chip15 1.87 · 2.25,
  §6 · §7)이라 100k 너머에서 양쪽 다 LOCO 채점이 된다. chip21 은 느린 세 장째가 아니라 세 번째 종류다(§8) — 무리를 신품 소거로만 가르는 v4 의 전제를 v4.3 에서 다시 정해야 한다(로그 52 [U52-7])
- **소거 축은 160k-200k 에서 평탄하다.** 두 칩 모두 그 40k 안에서 섹터 중앙값이 3-5ms 만 오르고 섹터 간 띠(104-109)와 겹치므로, 소거만으로는 160k 와 200k 를 가르기
  어렵다. v4.3 의 답 상한을 150k 로 둘지 200k 로 둘지는 이 평탄 구간을 어떻게 다룰지(범위만 주고 점 추정은 하한에 둔다 등)와 같이 정한다
- **계단 시점이 칩 속도의 가장 큰 표지다** — 100k 에서 chip06 · 09 · 02 · 17 은 계단 없이 60-85ms 였고 chip04 · 01 · 18 · 16 은 25-100k 에 밟았다. 200k 까지 가면
  둘은 110-158k 에 밟았다. chip02(100k 68-72ms)가 200k 안에 밟을지는 열린 질문이고, 모델에는 필수가 아니다
- **휴지는 무시해도 된다** — chip09 13일 휴지 전후 소거 p50 73.0 → 73.7 로 이어졌다(chip09 100k 휴지 점에 이어 두 번째 관측)

## 5. 한계

- 200k 구간은 사전 등록 밖이라 표의 판정은 관측이다. H6 ② 수정안은 두 칩을 본 뒤 적은 것이고 chip03 에 대한 예측으로 돌렸다가 틀렸다 — 느린 무리에는 H6 자체가 서지 않는다(§6).
  chip15 에 대한 예측 「계단 없이 미끄럼 · 200k 에 배율 약 2.1」 은 맞았다(§7). chip21 예측 「미끄럼 · 2.1-2.3」 은 속도에서 틀렸다(§8) — 신품 소거만으로는 다음 칩의 속도를 못 적는다
- 두 칩 모두 100k 뒤 45·75MHz 사다리 · newchip 을 돌리지 않았다 — H1′ 은 25MHz 로만, 대조군 섹터(7-13 · 2,041-2,047) 불변은 보지 않았다
- chip09 의 110k-200k 폭 +21-25ps 는 창 위치를 보지 않아 장착인지 칩인지 못 가른다. 3σ 안이라 판정에는 영향 없음

## 6. 느린 무리 chip03 — 같은 문턱을 계단 없이 지났다 (2026-10-16 추기)

chip03 은 100k 에 7섹터가 88-93ms 로, chip06 · 09 가 계단을 밟기 직전과 같은 수준에 있었다. 10/14 에 적은 예측은 「110k-130k 에 계단, 착지 = 직전 + 21」 이었다.
결과는 다르다 — 섹터 p50 이 86 → 107ms 로 100k 에 걸쳐 **완만히** 올랐고(수치 §6), 한 구간 상승은 최대 5-12ms(빠른 무리 전환 구간 18-21), p10-p90 폭은
20-25ms(빠른 무리 전환 밖 8-12)로 벌어진 채였다. 섹터 0 의 10k 묶음에서 105ms 이상 A 행은 130k 0% → 150k 12% → 170k 42% → 180k 66% 로 70k 에 걸쳐 늘었다 —
chip09 섹터 4 가 같은 비율을 20k 안에(6 → 47 → 77%) 바꾼 것과 대비된다. 섹터 5 는 190k-200k 에 114-127ms 로 한 수준 더 올라 체크포인트 p99 129 · max 134 를 만들었다.

읽기는 둘이다. ① **계단은 빠른 무리의 표지다** — 0 → 100k 에서 느린 세 칩(03 · 07 · 15)에 계단이 없던 것이 「아직 문턱에 못 왔기 때문」 이 아니라는 것이 이 칩으로
섰다. 같은 문턱(85-93ms)에서 빠른 칩은 뛰고 느린 칩은 미끄러진다. 소거 펄스 양자(21ms)가 같은 칩이라면, 빠른 칩은 섹터의 셀이 함께 한 펄스를 더 요구하고
느린 칩은 사이클마다 요구 펄스 수가 흔들리며 그 비율이 천천히 바뀐다고 읽힌다 — 분포 폭이 두 배로 벌어진 것이 그 흔적이다. ② **느린 무리의 소거 축은 100k-200k 에서
평탄하지 않다** — 배율 1.74 → 2.10 으로 꾸준히 오르고, 빠른 무리의 160k-200k 평탄 구간 같은 자리가 없다. v4.3 에서 느린 무리는 소거만으로 150k 와 200k 를 가를 수 있다.

폭은 19일 휴지 뒤 재장착한 110k 부터 체크포인트 100 대비 +3 - +16ps(100k 까지 −2 - +4) — 3σ 안이고 chip09 의 +21-25 와 같은 종류(장착 쪽)로 본다.
프로그램은 7섹터 전부 올라 200k 에 1.70-2.32배 — 느린 무리의 프로그램 상승(H2′ 거짓, 0 → 100k 해석 §)이 100k 너머에서 더 가팔라졌다. 휴지 회복은 없다(88.9 → 88.8).

## 7. 느린 무리 chip15 — 두 장째도 미끄럼, 예측대로 (2026-10-17 추기)

chip15(100k 에 75-99ms, 섹터 6 이 이미 99)는 chip03 을 본 뒤 걸어 둔 예측대로 갔다(수치 §6). 섹터 p50 이 85 → 112ms 로 올랐고 한 구간 상승은 4-11ms, p10-p90 은
18-25ms — chip03(5-12 · 20-25)과 같은 미끄럼이다. 200k 배율은 2.25 로 예측(약 2.1)보다 조금 높다. 섹터 4 는 124k 부터, 섹터 2 는 180k 부터 128-131ms 로 105 를 지나 한 수준 더
올랐는데(chip03 섹터 5 와 같음), 그 올라감도 한 구간 5-11ms 씩이라 계단이 아니다. 가장 느린 섹터 5 는 200k 에도 103 이다. 폭은 12일 휴지 뒤 재장착한 110k 부터 체크포인트 100 대비
+7 - +13ps(100k 까지 −19 - +5)로 3σ 안이고, 프로그램은 7섹터 전부 1.49-1.96배(느린 무리 네 장째 상승). 휴지 회복은 없다(86.4 → 85.8).

**느린 무리 두 장이 같은 모양이다.** 150k 배율 1.87 · 1.88, 200k 2.10 · 2.25 로 chip03 · 15 가 붙어 가고, 둘 다 160k-200k 에 평탄 구간이 없다. v4.3 에서 느린 무리는 소거만으로
150k 와 200k 를 가르고, 두 장이라 한 장을 빼고 채점(LOCO)할 수 있다. 빠른 무리(계단 뒤 평탄)와 느린 무리(미끄럼 · 계속 상승)의 100k 너머 모양 차이가 이제 네 칩으로 섰다.

## 8. chip21 — 신품은 느린 무리인데 빠른 무리 속도로 늙었다 (2026-10-19 추기)

chip21(3차 구매, 신품 48.9ms)은 느린 무리 세 장째로 0 → 200k 를 한 세션에 돌렸다(수치 문서). 예측은 「미끄럼 · 200k 배율 2.1-2.3」 이었는데 결과는 10k 1.49 · 50k 2.19 ·
100k 2.63 · 200k 2.93 — 느린 chip03 · 15(100k 1.74 · 1.75)가 아니라 빠른 chip09(2.80)에 가깝다. 오르는 방식은 미끄럼이고(한 구간 상승 5-8ms · p10-p90 14-19), 7섹터가
24k-56k 에 105 를 넘어 70k 부터 125-145ms 띠에서 천천히 오른다. 프로그램은 150k 까지 불변이다가 섹터 0 · 1 만 1.26-1.29 배 — 느린 무리(전부 상승)와 다르고 빠른 무리와 같다.
폭은 200k 까지 체크포인트 100 대비 −6 - +3ps.

**chip12 와 같은 꼴이다.** 알리익스프레스 구매분 chip12(신품 47.8ms)가 10k 1.40 · 50k 1.99 · 100k 2.58, 계단 없음(최대 상승 11ms), 프로그램 불변이었고 그래서 「구매처가 달라
같은 칩이 아니다」 로 교정에서 뺐다(로그 48 [D48-73]). chip21 은 마킹 `25Q64FVSIG` `1647` 로 같은 FV 이고 같은 궤적이다. 구매처 때문이 아니라 **FV 안에 세 번째 종류**
(신품 느림 · 노화 빠름 · 미끄럼 · 프로그램 불변)가 있고, 느린 신품 5칩(03 · 07 · 15 · 12 · 21) 중 둘이 이 종류다.

**모델에는 가장 센 반례다.** 상온 9칩 모델로 이 칩을 맞히면(수치 §3) 신품값이 느린 무리 교정으로 보내 50k 까지 3-6배 높게 읽고, 60k 부터는 느린 곡선의 끝을 넘어 사후가
두 봉우리로 갈려 낮게 읽는다 — **68% 0/12 · 95% 2/12**. 블라인드로 왔다면 전부 틀렸다. 신품 소거(개봉 전 한 점)만으로는 이 종류를 느린 무리와 못 가른다 — 폭 · 프로그램 ·
섹터 산포 모두 chip22 · 23 과 겹친다. 가르는 것은 노화 **기울기**뿐이다(첫 1k 에 1.22 대 1.04-1.09, 10k 에 1.49 대 1.17-1.22). 그래서 v4.3 에는 (가) 느린 신품을 두 종류에
확률을 나눠 두 교정을 다 쓰거나, (나) 개봉 때 짧은 추가 마모(Δx)로 기울기를 재서 가르거나, (다) 적용 범위를 「빠른 신품」 으로 좁히는 선택이 남는다(로그 52 [U52-7]).
교정에서는 뺐다(승격 당일 영웅님 결정, 로그 52 [D52-12] — 곡선 `_nocal`). 넣어도 느린 세 칩의 LOCO 는 11 → 10 · 7 → 8 · 10 → 9 로 거의 안 움직이지만, 느린 무리 교정에 섞으면
종류가 다른 곡선이 들어가는 것이라 v4.3 은 이 칩 없이(빠른 3 · 느린 2 의 200k) 답 범위만 넓히고, 두 종류 처리는 v4.4([U52-7])에서 한다.

## 9. 느린 무리 chip07 — 세 장째 미끄럼, 가장 느린 칩 (2026-10-21 추기)

chip07(신품 47.0ms, 100k 에 1.59배로 느린 셋 중 가장 느림)을 10cm 점퍼선으로 바꿔 200k 까지 갔다(수치 §9). 소거 100k 74.8 → 150k 83.6 → 200k 89.7ms(**1.91배**),
한 구간 최대 상승 3.1-4.7ms · p10-p90 8-12ms 로 chip03 · 15 보다도 완만한 미끄럼이고 105ms 를 넘은 섹터가 없다. 예측 「약 2.1」 보다 낮다 — 느린 형 세 칩의 200k 배율은
1.91 · 2.10 · 2.25 로 100k 배율 순서(1.59 · 1.74 · 1.75)를 그대로 따랐다. 프로그램은 100k 14.5 → 200k 19.5ms(신품 대비 2.9배, 전 칩 최대). 폭은 39,707-39,741ps.
A 행 결손 두 곳(100.0-103.6k 전원 상실 · 178.1-178.8k 작업 실수)은 곡선에서 직선으로 이어지고, 판정(계단 유무)은 경계 구간을 빼고 했다.
**느린 무리 100k-200k 곡선이 세 장(03 · 07 · 15)** — 빠른 무리(01 · 06 · 09)와 같은 두께가 됐다.

## 10. chip02 — 빠른 무리의 마지막 미계단 칩도 180k 에 계단 (2026-10-23 추기)

chip02(신품 27.2ms, 100k 에 68-72ms 로 빠른 무리 중 가장 느렸고 계단이 없던 칩)를 200k 까지 갔다(`data/wear/wear_endurance_chip02_2026-10.md`). 7섹터가 148k-178k 에
105ms 를 넘었고 한 구간 상승 17.5-21.0ms — 미끄럼이 아니라 계단(H3 양자 안)이다. 체크포인트 중앙값은 170k 88.6 → 180k 106.2ms, 180k-200k 는 106-109ms 평탄(chip06 · 09 와 같음).
200k 배율 4.00. **빠른 FV 칩 7개가 모두 계단을 밟았다**(2.5만-17.8만 회) — 「계단은 빠른 무리의 공통 사건, 시점만 다르다」 가 7/7 이 됐다. 프로그램은 200k 에 첫 구간 대비 약 3배로,
빠른 무리인데 느린 식으로 늙는다는 기존 관찰 그대로. 폭은 13일 휴지 뒤 재장착에서 +128ps 단차(110k-200k 안 ±3ps). v4.3 은 이 칩을 넣기 전(6장)으로 등록됐고, 7장 판은 §
재측정 기록만 남긴다(로그 52 §17).

## 보고서 문장 (제안)

- 「정격 내구 10만 회의 2배(20만 회)까지 25MHz SPI 타이밍 마진은 재장착 3σ(42ps) 안에서 움직이지 않았다(2칩, 파일럿 30만 회 1칩 포함 3칩)」
- 「빠른 무리 FV 칩 7개 모두 2.5만-17.8만 회 사이에 약 21ms 계단을 밟았다(10만 회 안에 없던 셋은 11만-17.8만 회) — 10만 회 안에 계단이 없던 빠른 무리 칩도 더 닳으면 밟는다 — 계단은 빠른 무리의 공통 사건이고 시점이 칩마다 다르다(2.5만-16만 회)」
- 「신품 소거가 느린 칩 5개 중 2개(chip12 · 21)는 빠른 무리 속도로 늙었다 — 신품 소거는 빠른 노화를 예측하지만 느린 노화를 보증하지 않는다. 개봉 전 한 점으로는 못 가르고, 노화 기울기가 가른다」
- 「느린 무리 두 칩은 같은 소거 수준(85-93ms)에서 출발해 같은 105ms 를 지나면서도 계단이 없었다 — 분포가 두 배로 벌어진 채 10만 회에 걸쳐 미끄러졌다. 계단의 유무가 두 무리를 가른다」
- 「프로그램 시간은 같은 무리 · 같은 계단의 두 칩에서 1.9배와 1.0배로 갈렸다 — 노화 지표로는 소거 시간만 쓴다」
