young-0320/flash-margin-bench/docs/results/data/inverse_v4_3_eval_2026-10.md

# inverse_v4_3_eval_2026-10 — v4.3 측정 · 5장 판 (교정 9칩, 100k 너머 곡선 5장 · ρ · LOCO · 칩별 · 합성)

> 수치와 표만 둔다. 설계와 채점 기준은 S-5 §9 9번 · 로그 52 §14 [D52-13], 판단은 로그 52 §14 추기. v4.1 의 같은 측정은 `inverse_v4_1_eval_2026-10.md`(9칩 · 100k 곡선).

- **무엇**: v4.1 과 같은 교정 9칩(chip01 · 02 · 03 · 04 · 06 · 07 · 09 · 15 · 18)에서 **100k 너머 곡선이 chip01(300k) 하나에서 다섯 장(+ chip06 · 09 · 03 · 15 의 200k)** 으로 늘어난
  상태로 S-5 §9 1 - 6 을 다시 돌린 수치. 모델 식 · 답 범위(x ≤ 100k) · ρ 등록값(0.00 · 0.78 · 0.29) · 관측 방식 · LOCO 106점(정답 ≤ 100k)은 v4.1 그대로. 코드 변경은
  `A_SESSIONS` 에 200k 세션 4개(`1791800419` · `1791904816` · `1791990254` · `1792080192`)뿐. chip21 은 밖(`_nocal`, [D52-12]). 모든 명령은 §7
- **날짜**: 2026-10-19 (5장 판). chip07 · 02 의 200k 가 오면 6장 · 7장 판을 같은 표로 쌓는다(§9 9번 ④)
- **합격 띠 (106점 · 2σ)**: 68% 63-81점 · 95% 97-105점. **고마모 기준(결과 전 고정)**: 50-100k 버킷 추정/정답 중앙값 **0.90 이상**(v4.1 0.84) · 정답∈68 **74% 이상**(v4.1 74.2%)

## 1. ρ 재측정 (9칩 · 200k 행 포함 정렬 혼합)

| 칩 | 표 수 | ρ_s 중앙값 (p10-p90) | ρ_p 중앙값 (p10-p90) |
| chip01 | 2000 | 0.00 (0.00-0.03) | 0.81 (0.54-0.96) |
| chip02 | 2000 | 0.00 (0.00-0.06) | 0.57 (0.28-0.79) |
| chip03 | 2000 | 0.00 (0.00-0.08) | 0.42 (0.15-0.71) |
| chip04 | 2000 | 0.00 (0.00-0.02) | 0.86 (0.64-0.93) |
| chip06 | 2000 | 0.00 (0.00-0.03) | 0.77 (0.55-0.90) |
| chip07 | 1800 | 0.00 (0.00-0.04) | 0.74 (0.45-0.88) |
| chip09 | 2000 | 0.00 (0.00-0.02) | 0.82 (0.62-0.92) |
| chip15 | 2000 | 0.00 (0.00-0.03) | 0.78 (0.50-0.90) |
| chip18 | 2000 | 0.00 (0.00-0.01) | 0.89 (0.79-0.96) |

| 전체 | 17800 | 0.00 (0.00-0.04) | 0.78 (0.39-0.92) |
| 무리 | 표 수 | ρ_chip | 칩별 잔차 평균 (7섹터 평균의 중앙값) |
| 빠른 | 3000 | 0.24 | chip01 +0.017 · chip02 +0.003 · chip04 -0.115 · chip06 +0.019 · chip09 +0.021 · chip18 +0.031 |
| 느린 | 1450 | 0.01 | chip03 +0.006 · chip07 +0.013 · chip15 -0.003 |
| 전체 | 4450 | 0.20 | chip01 +0.017 · chip02 +0.003 · chip03 +0.006 · chip04 -0.115 · chip06 +0.019 · chip07 +0.013 · chip09 +0.021 · chip15 -0.003 · chip18 +0.031 |

- ρ_s 0.00 · ρ_p 0.78 그대로. **ρ_chip 0.29(v4 등록) · 0.27(v4.1 재측정) → 0.20** — 100k 너머 곡선이 혼합에 들어가자 칩별 잔차가 줄었다. chip04 −0.115 만 혼자 크다.
  LOCO 는 등록값 0.29 로 돌렸다(한 번에 하나만)

## 2. 속도 · R (정렬 뒤 · 100k 안)

- v4 fast: 칩 속도 r̂ chip01 1.568 · chip02 0.636 · chip04 2.068 · chip06 0.769 · chip09 0.753 · chip18 0.838 → σ_r 0.472 · M 6 · R = exp(1.96·σ_r·√(1+1/M)) = 2.72
- v4 slow: 칩 속도 r̂ chip03 1.031 · chip07 0.819 · chip15 1.183 → σ_r 0.186 · M 3 · R = exp(1.96·σ_r·√(1+1/M)) = 1.52
- v4.1 과 같다 — 정렬은 100k 안에서 하므로 200k 곡선이 영향을 주지 않는다

## 3. LOCO (교정 9칩 · 106점)

### 3.1 등록 방식(rows P5 · 반복 20) — 무리 · 구간별

| 조건 | 부분 | 점 | 정답∈68 | 정답∈95 | 68% 바깥 폭 중앙값 | 바깥 폭/추정 중앙값 | 90분위 | 추정/정답 중앙값 |
|---|---|---|---|---|---|---|---|---|
| rows k=5 · Δx 0 | 전체 | 106 | 82.6% | 94.7% | 33,000 | 0.92 | 1.45 | 0.96 |

| rows k=5 · Δx 0 | 빠른 무리 | 72 | 81.8% | 92.8% | 40,000 | 1.01 | 1.60 | 0.96 |

| rows k=5 · Δx 0 | 느린 무리 | 34 | 84.3% | 98.8% | 23,000 | 0.59 | 1.33 | 0.98 |

| rows k=5 · Δx 0 | x ≤3k | 18 | 81.7% | 93.6% | 3,000 | 1.60 | 4.00 | 1.17 |

| rows k=5 · Δx 0 | x 3-20k | 18 | 82.5% | 93.3% | 17,000 | 1.11 | 1.26 | 1.08 |

| rows k=5 · Δx 0 | x 20-50k | 27 | 88.9% | 89.1% | 41,000 | 0.88 | 1.10 | 1.21 |

| rows k=5 · Δx 0 | x 50-100k | 43 | 79.1% | 99.3% | 44,000 | 0.65 | 1.01 | 0.84 |

| rows k=5 · Δx 0 | 빠른 · x 50-100k | 30 | 80.0% | 100.0% | 53,000 | 0.86 | 1.01 | 0.82 |

| rows k=5 · Δx 0 | 느린 · x 50-100k | 13 | 76.9% | 97.7% | 31,000 | 0.44 | 0.63 | 0.91 |

| 비교 | 전체 68% | 전체 95% | 폭 | 50-100k 68% | 50-100k 95% | 50-100k 추정/정답 | 느린 50-100k 추정/정답 |
|---|---|---|---|---|---|---|---|
| v4.1 (100k 곡선, 10/12) | 80.4% | 94.9% | 34,000 | 74.2% | 98.1% | 0.84 | 0.89 |
| **v4.3 5장 판** | **82.6%** | 94.7% | 33,000 | **79.1%** | 99.3% | **0.84** | 0.91 |

- 띠: 68% 과소신(82.6 > 76.4) · 95% 합격 — v4.1 과 같은 판정. **고마모 기준 ① 68% ≥ 74% 충족(79.1), ② 추정/정답 ≥ 0.90 미충족(0.84 그대로)**
- p50 관측: 정답∈68 87/106 · 정답∈95 102/106 · 폭 33,000 (v4.1 86 · 100)

### 3.2 정답 x 별 추정/정답 (p50 관측 · 9칩 중앙값)

| 정답 x | 추정/정답 | 정답∈68 | 정답∈95 | 칩별 (01 · 02 · 03 · 04 · 06 · 07 · 09 · 15 · 18) |
|---|---|---|---|---|
| 50,000 | 1.13 | 8/9 | 8/9 | 1.31 · 0.95 · 1.21 · 1.55 · 1.11 · 0.83 · 1.11 · 1.29 · 1.13 |
| 60,000 | 1.04 | 7/8 | 8/8 | 1.12 · 0.86 · 1.14 · 1.27 · 0.96 · — · 0.96 · 1.18 · 0.96 |
| 70,000 | 0.85 | 8/9 | 9/9 | 1.08 · 0.81 · 1.02 · 1.08 · 0.84 · 0.79 · 0.85 · 1.05 · 0.85 |
| 80,000 | 0.84 | 8/8 | 8/8 | 0.97 · 0.73 · 0.91 · 0.94 · 0.74 · — · 0.76 · 0.98 · 0.77 |
| 90,000 | 0.75 | 5/9 | 9/9 | 0.82 · 0.66 · 0.87 · 0.83 · 0.68 · 0.75 · 0.68 · 0.92 · 0.69 |
| 100,000 | 0.71 | 6/9 | 9/9 | 0.74 · 0.60 · 0.83 · 0.77 · 0.62 · 0.71 · 0.61 · 0.86 · 0.70 |

- 과소추정은 정답이 100k 에 가까울수록 단조로 커진다(50k +13% → 100k −29%), 속도 r̂ 이 1 근처인 느린 칩(03 · 15)도 100k 에서 0.83 · 0.86. 곡선이 있는 칩(06 · 09 · 03 · 15)과
  없는 칩(02 · 04 · 18)의 차이가 없다 — **곡선 결핍이 아니라 답 범위 상한 100k 에서 사후가 잘리는 절단 효과**다(로그 52 §14 추기)

### 3.3 [U52-8] (가) 시험 — 사후 지지를 200k 로 넓혔을 때 (2026-10-20, 코드는 되돌림)

`posterior()` 의 x 격자만 1-200k 로 넓히고(사전 평평 그대로, 답은 100k 에서 자름) 같은 106점을 다시 채점했다 — `build/inverse/v43ga/`.

| 지지 | 전체 68% / 95% | 68% 폭 | 추정/정답 전체 | 50-100k 68% | 50-100k 추정/정답 | 50-100k 68% 폭 |
|---|---|---|---|---|---|---|
| 100k (5장 판) | 82.6% / 94.7% | 33,000 | 0.96 | 79.1% | 0.84 | 44,000 |
| **200k** | 84.5% / 95.6% | **49,000** | **1.22** | 83.7% | **1.24** | **93,000** |

p50 관측 · 정답 x 별(9칩 중앙값):

| 정답 x | 지지 100k: 중앙값/정답 · MAP/정답 · 68% 폭 | 지지 200k: 중앙값/정답 · MAP/정답 · 68% 폭 |
|---|---|---|
| 10,000 | 1.05 · 0.55 · 12,000 | 1.05 · 0.55 · 12,000 |
| 50,000 | 1.13 · 0.79 · 48,000 | 1.31 · 0.79 · 66,000 |
| 70,000 | 0.85 · 0.88 · 40,000 | 1.28 · 0.88 · 93,000 |
| 80,000 | 0.84 · 0.96 · 45,500 | 1.27 · 0.96 · 99,000 |
| 90,000 | 0.75 · 0.88 · 37,000 | 1.18 · 0.88 · 99,000 |
| 100,000 | 0.72 · 0.84 · 35,000 | 1.21 · 0.84 · 99,000 |

- 절단을 풀자 과소추정(0.72)이 **과대추정(1.21)** 으로 뒤집히고 68% 폭이 35,000 → 99,000 으로 터졌다. 50k 부터 이미 1.3 배다. 빠른 무리 곡선이 160k-200k 에서 평탄해
  (`wear_endurance_200k.md` §2) 100k 너머 x 의 우도가 100k 안과 거의 같고, 사전이 평평하면 그 질량이 전부 답에 섞인다 — 소거 시간은 100k 너머를 **식별하지 못한다**.
  칩별로는 chip01 68% 100 → 75%, |중앙값−정답| 12,500 → 41,000. 합성 복원은 70 · 95 (정체 칩 뺌 · prep 5회). 그림 `../plots/synthetic_recovery_v4_3_support200k_2026-10.png`
- MAP 은 상한 근처(80-100k)에서 0.84-0.96 으로 중앙값(0.72-0.84)보다 덜 눌리지만 낮은 x 에서 0.55-0.79 로 크게 낮다 — v3 에서 MAP 을 버린 이유 그대로
- **결론**: (가)는 기각. 100k 절단은 「블라인드는 정격 안」 이라는 사전 지식이고, 그 사전 아래서 상한 근처의 중앙값 편향(90k 0.75 · 100k 0.72)은 추정량의 성질이다.
  코드는 되돌렸다(5장 판 상태). 남은 선택지는 로그 52 [U52-8] (나) · (마)

### 3.4 정답 구간별 치우침 · chip06 held-out (5장 판 · [U52-8] 고민 재료)

| 정답 구간 | 점 | 정답∈68 | 정답∈95 | 추정/정답 중앙값 |
|---|---|---|---|---|
| ≤3k | 18 | 81.7% | 93.6% | 1.17 |
| 3-20k | 18 | 82.5% | 93.3% | 1.08 |
| 20-50k | 27 | 88.9% | 89.1% | **1.21** |
| 50-100k | 43 | 79.1% | 99.3% | **0.84** (빠른 0.82 · 느린 0.91) |

chip06(실제 블라인드, 정답 12,000)을 8칩으로 맞힌 p50 관측 12점: 1k → 1-2k · 3k → 3-4k · 10k → 12-13k · 20k → 24-25k · 50k → 55-56k · 100k → 62-63k, 정답∈68 11/12(90k 만 X) ·
정답∈95 12/12. 낮은 구간은 조금 높게, 80k 이상만 낮게 읽는다 — 상한 효과는 모델 전체가 아니라 **정답 80k 이상에 한정**된 성질이다.

## 4. 칩별 (rows P5 · 반복 20 · 정답∈68 / 정답∈95 / 68% 바깥 폭 중앙값 / |중앙값−정답| 중앙값)

| 칩 (무리) | 점 | v4.3 5장 판 | v4.1 |
|---|---|---|---|
| chip01 (빠른) | 12 | 100% / 100% / 36,000 / 12,500 | 100% / 100% / 32,500 / 10,000 |
| chip02 (빠른) | 12 | 82% / 100% / 43,000 / 4,500 | 82% / 100% / 43,000 / 5,000 |
| chip04 (빠른) | 12 | **34% / 57%** / 33,000 / 19,500 | 34% / 62% / 36,000 / 18,500 |
| chip06 (빠른) | 12 | 90% / 100% / 51,500 / 5,500 | 88% / 100% / 53,000 / 5,000 |
| chip09 (빠른) | 12 | 85% / 100% / 52,500 / 4,500 | 85% / 100% / 53,000 / 5,000 |
| chip18 (빠른) | 12 | 100% / 100% / 50,000 / 6,500 | 100% / 100% / 51,000 / 6,000 |
| chip03 (느린) | 12 | **84%** / 99% / 30,000 / 5,500 | 76% / 99% / 34,000 / 6,000 |
| chip07 (느린) | 10 | 67% / 97% / 13,000 / 2,500 | 64% / 92% / 13,000 / 3,000 |
| chip15 (느린) | 12 | **99%** / 100% / 23,000 / 6,500 | 91% / 100% / 24,000 / 7,000 |

- 느린 세 칩이 전부 좋아졌다(03 · 07 · 15 의 68%, 07 의 95%). chip04 는 95% 62 → 57% 로 더 나빠졌다(r̂ 2.07 로 [1/R, R] 가장자리)
- 95% 빗나간 점(칩 정답:반복수 / 20): chip04 1k:10 · 3k:13 · 10k:20 · 20k:2 · 30k:20 · 40k:20 · 50k:19 · chip03 10k:2 · chip07 100k:6 — v4.1(chip04 1k:10 · 3k:17 · 10k:20 ·
  20k:4 · 30k:20 · 40k:20 · chip03 10k:2 · chip07 100k:16)과 거의 같고 chip04 50k 가 새로 빗나갔다. chip07 100k 는 16 → 6 으로 줄었다(200k 곡선 효과)

## 5. 합성 복원 (500회 · seed 0 · 명목 → 실제 포함률 %)

| 조건 | 10 | 20 | 30 | 40 | 50 | 60 | 68 | 80 | 90 | 95 |
|---|---|---|---|---|---|---|---|---|---|---|
| v4.3 · 교정에 정체 칩 포함 · 기본 · prep 5회 | 14 | 24 | 33 | 44 | 53 | 64 | 73 | 82 | 93 | 98 |

| v4.3 · 교정에 정체 칩 포함 · 기본 · prep 1회 | 13 | 24 | 33 | 44 | 53 | 64 | 74 | 84 | 93 | 98 |

| v4.3 · 정체 칩을 교정에서 뺌 · 기본 · prep 5회 | 12 | 22 | 30 | 39 | 49 | 58 | 66 | 78 | 89 | 96 |

| v4.3 · 정체 칩을 교정에서 뺌 · 기본 · prep 1회 | 13 | 24 | 35 | 43 | 54 | 66 | 73 | 84 | 91 | 95 |
| v4.1 · 정체 칩을 교정에서 뺌 · prep 5회 | 14 | 23 | 33 | 42 | 51 | 62 | 71 | 81 | 91 | 96 |

- 정체 칩을 뺌 · prep 5회: 68% 71 → 66 · 95% 96 → 96. 그림 `../plots/synthetic_recovery_v4_3_5curves_2026-10.png`

## 6. 교정 표

접미사 없는 `docs/results/data/wear_curves/wear_curves_chip*_2026-*.csv` 9장 — chip01 300k · chip03 · 06 · 09 · 15 200k · chip02 · 04 · 07 · 18 100k. 밖: chip10 · 14 `_nocal`(JV) · chip12 `_ali` · chip16 `_64C` · chip17 `_65C` · chip21 `_nocal`

## 7. 재현

```bash
uv run python host/analysis/wear_inverse.py --rate-rule                                              # §2
uv run python host/analysis/wear_inverse.py --rho --prep-k 5                                         # §1
uv run python host/analysis/wear_inverse.py --loco --loco-obs rows --prep-k 5 --reps 20 --study     # §3.1
uv run python host/analysis/wear_inverse.py --loco                                                   # §3 p50 · §3.2
uv run python host/analysis/wear_inverse.py --synthetic 500 --plot build/inverse/v43/synthetic_v43.png   # §5
uv run python build/inverse/v43/perchip.py                                                           # §4 (일회성 — loco_study 를 부르는 스크립트, 리포에 없음)
# §3.3: wear_inverse.posterior 의 격자를 1-200k 로 바꾼 임시 판으로 위 세 명령 + build/inverse/v43ga/ceiling_study.py(지지 100k/200k · 중앙값/MAP 비교, 리포에 없음)
```
