young-0320/flash-margin-bench/docs/results/wear/wear_endurance_chip07.md

# 종단 마모 결과 해석 — chip07, 0 → 100,000 사이클

- **작성일**: 2026-09-29 (9/30 선 복구 뒤 측정 · newchip 추가) · **측정**: 2026-09-27 - 09-30 (보드 A)
- **수치**: [`data/wear/wear_endurance_chip07_2026-10.md`](../data/wear/wear_endurance_chip07_2026-10.md) (+ 동명 CSV) — 표를 다시 싣지 않고 거기를 인용한다
- **사전 등록**: `docs/spec/s1.wear_bench_spec.md` §15 2026-09-26 추기 (H1′·H2′·H3-H5) · 2026-09-27 추기 (H6 · chip07 교체와 "계단 없음" 예측)
- **비교 대상**: 파일럿 [`wear_pilot_chip01.md`](wear_pilot_chip01.md) · 종단 1 [`wear_endurance_chip03.md`](wear_endurance_chip03.md)
- **경위**: `docs/log/young/48.pilot_wear_handler_and_plan_approval.md` §16-§20

> **2026-10-05 — chip07 만 점퍼선이 20cm 였다 (다른 칩 10cm, 한영웅 확인).** 아래 폭 해석(세션 사이 이동 · 계측 사건 · 75/45MHz 판정 불가)은
> 다른 칩과 배선 조건이 달랐다는 단서 아래서 읽는다. 소거 · 프로그램 결과는 칩 내부 동작이라 영향이 작다 — `docs/chip_registry.md` 마킹 절
> **2026-10-19 추기 — 10cm 로 바꾸고 다시 쟀다: 선이 원인이었다.** 같은 200k 전 상태(100k · PRBS 기록)에서 `--mode sweep` 25MHz 2회 · 45 · 75MHz(수치 §1 끝 4행, 75MHz 는
> 한영웅 부재 중 원격 실행). 25MHz 39,747 · 39,746ps(9/30 20cm 39,209 대비 **+538**, 다른 칩 띠 39,600-39,800 안) · 45MHz 21,804(+957, chip03 21,744 수준) · 75MHz 12,161(−184,
> chip03 12,226 수준). 20cm 에서 25 · 45MHz 만 500-950ps 좁고 75MHz 는 안 좁았던 것이 선 하나로 전부 띠 안으로 돌아왔다 — 이 문서의 「접점에 민감한 개체」(§1 끝)는 개체가
> 아니라 선 길이였다고 읽는다. **10/21 — 100k → 200k 연장 끝**: 1.91배 · 미끄럼 · 프로그램 2.9배, `wear_endurance_200k.md` §9. 재장착 3회는 안 했다(같은 장착 2회 −0.4ps). 14:06 의 25MHz 1회는 호스트 프레이밍 슬립으로 무효(2,022ps, data/ 에 안 올림). 200k 연장은 이 선으로 간다

## 결론

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

## 1. 폭이 한 번 뛰었다 — 노화가 아니라 계측 사건이다

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

## 2. H1′ — 25MHz 는 구간을 나눠 참, 75·45MHz 는 판정 불가

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

**사건 뒤 구간.** 70k 대비 90k −2.4 · 100k −2.3ps. 기준 안이다.

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

결과를 본 뒤의 판단이므로 기준 초과라는 숫자는 수치 문서와 이 절에 그대로 둔다.

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

## 3. H2′ 는 두 번째로 깨졌다 — 프로그램이 chip03 보다 일찍, 두 배로

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

## 4. 소거는 완만했고 계단은 없었다 — 예측이 맞았다

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

## 5. 선을 되돌리자 경로는 돌아왔고, 폭은 세 클럭 모두 좁았다

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

## 6. 100k 뒤 newchip — 128KB 교란은 다시 나왔고, prep 프로그램 시간은 눈금이 달랐다

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

## 7. 두 번 끊겼고, 두 번 다 엔진은 끝까지 갔다

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

## 8. 세 칩을 나란히 놓으면

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

## 9. chip07 에서 닫힌 것과 넘어간 것

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
