young-0320/flash-margin-bench/docs/results/wear/wear_endurance_chip12.md

# 종단 마모 결과 해석 — chip12(구매처 미검증), 0 → 100,000 사이클

- **작성일**: 2026-10-03 · **측정**: 2026-10-01 - 10-03 (보드 A, 상온)
- **수치**: [`data/wear/wear_endurance_chip12_2026-10.md`](../data/wear/wear_endurance_chip12_2026-10.md) (+ 동명 CSV) · 1k 구간 곡선
  [`data/wear_curves/wear_curves_chip12_ali_2026-10.csv`](../data/wear_curves/wear_curves_chip12_ali_2026-10.csv) — 표를 다시 싣지 않고 인용한다
- **판정 기준**: 다른 칩과 같은 칩으로 보지 않으므로(로그 48 [D48-77]) 상온 칩의 가설(S-1 §15 H1′·H2′·H6)로 판정하지 않는다. 같은
  항목을 관찰로 적어 두 무리와 맞댄다
- **비교 대상**: 빠른 무리 [chip01](wear_pilot_chip01.md) · [chip04](wear_endurance_chip04.md) · chip09, 느린 무리 [chip03](wear_endurance_chip03.md) ·
  [chip07](wear_endurance_chip07.md) — 모두 디바이스마트 구매
- **경위**: `docs/log/young/48.pilot_wear_handler_and_plan_approval.md` §25(배정) · §27(7,400 접촉 고장) · §34-§35(교정 제외 · 같은 칩으로 보지 않음)

- **2026-10-19 추기**: 같은 꼴(신품 느림 · 노화 빠름 · 미끄럼 · 프로그램 불변)이 디바이스마트가 아닌 3차 구매 chip21(FV `1647`)에서 재현됐다 — 「구매처가 달라 같은 칩이 아니다」 는 접고 FV 안의 세 번째 종류로 본다. [`wear_endurance_200k.md`](wear_endurance_200k.md) §8 · 로그 52 [U52-7]

## 결론

**chip12 는 W25Q64 로 읽히고 신품 때는 느린 무리처럼 보였지만, 늙는 모양은 어느 무리와도 맞지 않았다.** 소거 시간은 10만 회에 신품의
2.58배로 빠른 무리만큼 늘었는데, 빠른 무리라면 84ms 를 넘은 뒤 오던 계단(약 85 → 111ms 의 도약)이 일곱 섹터 어디에도 없었다. 느린
무리라면 오르던 프로그램 시간은 10만 회 동안 6.8ms 그대로였다. 알리익스프레스의 검증 안 된 판매자에게서 산 유일한 칩이라는 점과 겹쳐,
다른 칩과 같은 칩으로 다루지 않는다 — 교정에서 빼고(로그 48 [D48-73]) 무리 비교와 칩 간 표에도 넣지 않는다([D48-77]). 무엇이 다른지
(다른 세대 · 다른 공정 · 재생품)는 이 데이터로 가를 수 없다. 마진(25MHz 폭)은 다른 칩처럼 움직이지 않았고, 현장 역산은 이 칩을 판정
보류로 걸렀다.

| 항목 | chip12 | 빠른 무리 (01 · 04 · 09) | 느린 무리 (03 · 07) |
|---|---|---|---|
| 신품 소거 | 47.8ms | 26.0-33.7ms | 47.0-51.1ms |
| 10만 회 소거 배율 (1k 구간 섹터 중앙값) | 2.58 | 2.80-3.97 | 1.59-1.74 |
| 계단 (약 85 → 111ms 도약) | 없음 (§3) | 있음 (chip09 는 60-70k, 일부 섹터) | 없음 |
| 프로그램 시간 | 6.8ms 그대로 (§4) | 그대로 | 오름 (100k 에 1.27 · 2.15배) |
| 25MHz 폭, 체크포인트 100 대비 | −9.5 - +28.7ps (재장착 단차 포함, §1) | 3σ(42ps) 안 | 3σ 안 (chip07 은 계측 사건 전후를 나눠서) |
| 기준 섹터 32-127, 100k 뒤 | 0.99 (§5) | 1.00 | 1.00 |

## 1. 마진 — 다른 칩처럼 움직이지 않았다

25MHz 폭은 체크포인트 100 대비 −9.5 - +28.7ps 로 3σ(42ps) 안이다. 큰 쪽은 전부 재장착 뒤다 — 7,400 에서 보드와 칩 사이 접촉이 끊겨
칩을 다시 꽂았고(로그 48 §27), 3,000 이전(39,642.5-39,657.1ps)과 10,000 이후(39,675.5-39,680.7ps)가 약 30ps 어긋난다. 재장착 뒤 10개 점은
5.2ps 안에 머물렀다. 재장착 σ(약 14ps)의 두 배쯤인 단차라 장착 차이로 읽고, 마모로 폭이 줄었다는 신호는 없다.

## 2. 소거 — 빠른 무리만큼 늘었다

1k 구간 섹터 중앙값의 신품 대비 배율은 10k 1.41 · 50k 1.99 · 100k 2.58 이다. 같은 자리에서 느린 무리(chip03 · 07)는 1.17-1.18 · 1.40-1.45 ·
1.59-1.74 다. chip12 의 10k 배율에 chip03 은 40k, chip07 은 52k 에 닿았고, 30k 의 1.72 부터는 느린 무리 어느 칩도 100k 안에 닿지 않는다.
배율로는 빠른 무리 가운데 가장 느린 chip09(1.53 · 2.29 · 2.80) 바로 아래다. 섹터 사이 차이는 작다 — 100k 에 일곱 섹터가 2.50-2.66배다.

## 3. 계단이 없다 — 빠른 무리의 표지가 빠졌다

빠른 무리는 섹터 소거가 약 84ms 를 넘은 뒤 몇 천 회 안에 약 111ms 로 뛰어올랐고, 전환 구간에서는 A 행이 두 봉우리로 갈려 94-108ms 가
비었다(S-1 §15 H6). chip12 는 일곱 섹터 모두 20-34k 에 84ms 를 넘었지만 뛰지 않고 계속 올랐다. 섹터마다 처음 105ms 를 넘은 구간(45-69k)
에서도 A 행의 24-76% 가 94-108ms 에 있다 — 두 봉우리가 아니라 한 덩어리로 지나갔다. 한 구간(1k)에 오른 최대 폭은 섹터별 5.0-11.0ms 로,
계단이 있던 chip01 · chip04 의 16.3-25.2ms 에 못 미친다.

## 4. 프로그램 — 느린 무리의 표지도 없다

체크포인트 프로그램 p50 은 100k 동안 6.78-6.85ms, 1k 구간 섹터 중앙값은 6.80 → 6.82ms 다. 신품 소거가 같은 자리(47-51ms)인 chip03 ·
chip07 은 일찍부터 올라 100k 에 1.27 · 2.15배였다. 10/3 newchip 의 prep(PRBS)에서도 마모 섹터 프로그램이 신품과 같다(6.76 대 6.79ms).

## 5. 100k 뒤 newchip — 기준 섹터는 신품 그대로

마모 섹터 0-6 은 신품 대비 2.60배, 바로 옆 7-31 은 1.11배(다른 칩의 128KB 교란 1.06-1.25 범위), 기준 섹터 32-127 은 0.99배다. 칩이 자기
신품값을 지니고 있다는 현장 모델의 전제는 이 칩에서도 섰다.

## 6. 현장 역산은 판정을 보류했다

newchip prep 을 수명 역산(교정 v2)에 넣으면 입력 A(기준 섹터 47.1ms)는 느린 무리를 고르는데, 입력 C(마모 섹터 프로그램 6.76ms)가
「빠른 무리와 맞음 — 입력 A 의 무리 선택과 어긋난다」 로 걸리고, 관측 7개가 모두 교정 밴드 밖이라 판정을 보류한다. MAP 은
56,001-57,000 으로 정답 100,000 의 0.57배다. 모델이 모르는 칩에 조용히 틀린 값을 내지 않고, 두 안전장치(무리 교차 확인 · 밴드 밖
경고)에서 멈췄다.

## 7. 왜 같은 칩으로 보지 않나

받았을 때의 검사(JEDEC `EF 40 17` · blank_pre 0 · 폭 39,681.8ps · 128섹터 소거 분포 · prep 프로그램)로는 다른 칩과 구별되지 않았다.
그런데 늙는 동안 두 무리의 표지 — 빠른 무리의 계단, 느린 무리의 프로그램 상승 — 가 둘 다 없었고, 이 칩만 구매처가 다르다. 같은 JEDEC
ID 를 내는 다른 세대(W25Q64FV 와 JV)이거나, 다른 공정 · 다른 등급이거나, 재생품일 수 있지만 칩 하나로는 가를 수 없다. UID 가 `D165` 로
시작하는 칩이 chip12 말고 전부 빠른 무리(chip01 · 09 · 16 · 18)라는 점은 UID 구조가 공개돼 있지 않아 약한 단서로만 둔다.

그래서 chip12 의 곡선은 교정 묶음 밖 이름(`_ali_2026-10`)으로 두고, 칩 간 한눈 표 · 그림에서 뺐다. chip17(65°C)의 「온도인가 로트인가」
를 가르는 상온 비교에도 쓰지 않는다 — 그 몫은 새 배치 디바이스마트 칩 chip16 · 18 이 맡는다(로그 48 [D48-74]). 거꾸로, 검증 안 된
판매처의 칩이 받을 때는 멀쩡해 보이다가 늙는 모양에서 드러났다는 것 자체는 재생 · 위조 칩 판별이라는 목표 쪽에서 쓸 만한 관찰이다.

## 한계

- 칩 하나 · 판매처 하나 — 「알리 칩이 다르다」 인지 「이 한 개가 다르다」 인지 모른다
- 7,400 재장착 단차가 폭에 약 30ps 들어 있고, 3,014-7,400 사이 끊김 · 가짜 사이클 78개를 곡선에서 뺐다
- 마킹 · 칩 안 식별 정보(SFDP 등)로 정체를 확인하지 않았다

## 다음

1. 윗면 마킹 사진 비교 (chip12 대 chip15 · 17 · 18) — 품번 끝자리 · 날짜 코드 · 인쇄 상태
2. 새 배치 디바이스마트 칩 chip16 · 18 상온 종단 — 새 배치가 옛 로트처럼 늙으면 chip12 의 차이는 판매처 · 개체 쪽으로 기운다
   > **2026-10-04 — chip18 이 절반을 답했다 ([`wear_endurance_chip18.md`](wear_endurance_chip18.md)).** 새 배치 chip18 은 옛 로트 빠른 무리
   > 띠 안에서 늙었다(소거 100k 3.68배 · 5/7섹터 계단 · 프로그램 불변) — 차이는 판매처 · 개체 쪽으로 기운다. chip16 이 끝나면 닫는다
3. (선택) SFDP · 상태 레지스터 같은 칩 안 정보로 세대를 가를 수 있는지 확인 — 펌웨어 명령이 필요하다
