young-0320/flash-margin-bench/docs/results/wear/wear_endurance_chip15.md

# 종단 마모 결과 해석 — chip15 (새 배치 · 느린 무리), 0 → 100,000 사이클

- **작성일**: 2026-10-05 · **측정**: 2026-10-04 - 10-05 (보드 A)
- **수치**: [`data/wear/wear_endurance_chip15_2026-10.md`](../data/wear/wear_endurance_chip15_2026-10.md) (+ 동명 CSV) — 표를 다시 싣지 않고 거기를 인용한다
- **사전 등록**: `docs/spec/s1.wear_bench_spec.md` §15 — H1′·H2′(2026-09-26) · H6(2026-09-27) · 교정 편입은 마모 전 결정(로그 48 [D48-90])
- **비교 대상**: 같은 느린 무리 [`wear_endurance_chip03.md`](wear_endurance_chip03.md) · [`wear_endurance_chip07.md`](wear_endurance_chip07.md) ·
  같은 새 배치 빠른 무리 [`wear_endurance_chip18.md`](wear_endurance_chip18.md)
- **경위**: `docs/log/young/48.pilot_wear_handler_and_plan_approval.md` §40
- **2026-10-17 추기**: 100k → 200k 연장(세션 `1792080192`)의 해석은 [`wear_endurance_200k.md`](wear_endurance_200k.md) §7 — chip03 과 같이 계단 없이 미끄러졌고, 예측(미끄럼 · 배율 약 2.1)과 맞았다(2.25)

## 결론

**새 배치 chip15 는 옛 로트 느린 무리처럼 늙었다 — 소거가 100k 에 1.75배로 완만하게 늘었고 계단이 없었으며, 프로그램은 약 25k 부터
7섹터가 함께 올라 100k 에 +21% 가 됐다. 마진은 그대로였다.** 배율 곡선은 chip03 과 거의 겹친다(100k 1.75 대 1.74). 느린 무리의 세
표지(완만한 소거 · 계단 없음 · 프로그램 상승)가 모두 맞아, 느린 교정 세 칩째로 넣었다.

| 가설 | 등록 기준 | 결과 | 판정 |
|---|---|---|---|
| H1′ 100k 안 폭 3σ 안 | 42ps | 25MHz 체크포인트 100 대비 −18.7 - +5.3ps, 바닥 0 · 45·75MHz 는 재지 않음 | **참 (25MHz)** (§1) |
| H2′ 100k 안 프로그램 7.0ms 불변 | 보이면 깨짐 | 섹터별 24-37k 에 +0.1ms, 100k 에 섹터 중앙값 8.25ms (+21%) | **거짓** — 느린 무리 세 칩째 (§2) |
| H6 계단이 올 때 ① 직전 84ms 이상 ② 착지 107-112ms | 계단이 온 섹터 전부 | 7섹터 모두 100k 안에 계단 없음 | **chip15 에서 판정 불가** (§3) |
| (전제) 대조군 섹터 소거 불변 | 100k 뒤 newchip | 원격 121-127 0.96 · 기준 32-127 0.98 · 근접 7-13 1.09 · 블록 1 1.05 | **원격만 성립** — 다섯 칩째 (§4) |

## 1. 마진은 움직이지 않았다 — 다만 후반 30k 에 조금 내려앉았다

25MHz 폭은 60k 까지 체크포인트 100 대비 +1 - +5ps 안에 있다가 70-100k 에 −3 - −19ps 로 내려왔다(최저 80k, 수치 §1). 3σ 42ps 의 절반 아래라
H1′ 은 참이다. 내려앉은 시점이 69,109 사건(§5) 뒤와 겹치지만 칩을 뺐다 꽂지 않았고 70k 값(−6.9ps)은 그 앞 60k 와 10ps 차이라, 사건이 폭을
옮겼다고 할 근거는 없다 — chip07 의 계측 사건(+590ps 한 번에)과는 크기가 두 자리 다르다. 45·75MHz 사다리는 돌리지 않아 25MHz 로만 판정한다.

## 2. 프로그램은 느린 무리답게 올랐다 — chip03 쪽이다

프로그램은 7섹터 모두 24-37k 에 처음 0.1ms 넘게 올랐고, 100k 에 섹터별 7.85-8.51ms(중앙값 8.25ms, 신품 6.84 대비 +21%)다(수치 §2).
섹터 번호 순서가 없고 섹터 간 차이가 0.7ms 안이라, chip03 의 **7섹터 균일 상승**(약 20k 부터, 100k +26%)과 같은 모양이다. chip07(4-12k 에
섹터 5·6 먼저, 100k 2.1배)처럼 크게 튀지 않았다. H2′ 는 느린 무리 세 칩 모두에서 깨졌고, 상온 빠른 무리 네 칩(chip01 · 04 · 09 · 18)에서는
100k 까지 섰다 — **「프로그램이 오른다」 가 느린 무리의 표지**라는 것이 세 칩으로 굳었다.

## 3. 소거는 느리게, 계단 없이 — 섹터 6 만 문턱 근처까지

칩 배율은 10k 1.22 · 50k 1.50 · 100k 1.75 로, chip03(1.17 · 1.45 · 1.74)보다 초반에 조금 빠르고 100k 에 같은 자리에 닿았다. chip07(100k 1.59)은
아래에 있다(수치 §2). 섹터별 최대 한 구간 상승이 3.3-7.7ms 로 chip03(3.5-6.8)과 같은 크기라, 빠른 무리의 18-22ms 도약이 없다.

1k 구간 중앙값이 105ms 를 넘은 섹터가 없어 H6 은 이 칩에서 판정할 수 없다. 섹터 6 하나가 89k 에 100ms 를 넘어 100k 에 98.8ms(신품의 1.92배)로
가장 멀리 갔지만, 95-100k A 행은 94-108ms 에 75% 가 이어진 한 덩어리이고 108ms 이상은 2% 뿐이다. chip03 섹터 5 처럼 **수준에는 닿았는데
뛰지 않은** 모양이다. 「약 90ms 에 닿으면 계단이 온다」 는 느린 무리에서 다시 성립하지 않는다 — H6 의 ① 은 충분조건이 아니다.

## 4. 128KB 소거 교란은 다섯 칩째

100k 뒤 newchip 에서 근접 대조군 7-13 1.09 · 블록 0 나머지 1.05 · 블록 1 1.05 이고 블록 2(32-47)에서 0.96 으로 끊긴다(수치 §3). 원격 대조군
0.96 · 기준 섹터 32-127 0.98 이다. chip03 · 07 · 04 · 18 과 같은 모양 · 같은 경계이고, 근접 교란 크기 1.09 는 그 범위(1.06-1.15) 안이다.
수명 역산의 입력 A(기준 섹터 32-127 = 신품값)가 다 쓴 칩에서도 그대로 나온다는 전제가 느린 무리 새 배치에서도 섰다.

prep(PRBS) 프로그램은 마모 섹터 6.88ms 로 신품 대비 1.02 다. 같은 때 0x00 마모 루프는 8.25ms 라 prep 이 0.83배로 덜 오른다 — chip07 에서
처음 본 「prep 은 A 행과 눈금이 다르다」 가 다시 나왔다.

## 5. 69,109 에서 USB 가 흔들렸다 — 엔진이 그 자리에서 섰다

손이 케이블에 닿아 69,109 섹터 6 소거가 8µs 가짜로 끝나고 다음 프로그램에서 `wip_timeout` 으로 섰다(수치 §5). 커널 로그로 보면 USB 데이터가
끊긴 것은 엔진이 선 뒤 6초다 — 보드가 USB 로 전원을 받아 **칩 쪽이 먼저 흔들렸다.** chip07 은 반대로 USB 데이터만 끊겨 호스트가 죽고
엔진이 체크포인트를 지나쳤다(60k · 80k 결측). chip15 는 엔진이 70k 전에 섰으므로 결측이 없다.

resume 이 tally 69,100 과 A 로그 69,109 를 맞춰 69,109 를 채택했고, 섹터 6 의 덜 지워진 한 섹터(32,768비트)를 재소거했다. 두 번 돈
사이클이 없어 chip04(되돌려 53사이클을 두 번)보다 깨끗하다. 곡선에서는 사이클 69,109 의 7행만 뺐다. chip04 · chip07 · chip15 세 번의
사건이 모두 USB 케이블 · 접점이었다 — chip07 결과가 남긴 「외부 5V 전원」 숙제가 그대로 남아 있다.

## 6. 수명 역산 — 넣기 전에도 95% 안, MAP 은 낮게

chip15 를 넣기 **전**의 현장 역산은 100k 칩을 MAP 61-62k 로 읽었다 — 68%(조각 8개) 와 95% 모두 정답을 품었고, 판정 등급 「고마모
(정격의 60% 이상)」 이 65% 로 맞는 쪽이었다(수치 §3). 다만 입력 C(prep 프로그램 6.88ms)가 「빠른 무리와 맞음 — 무리 선택과 어긋난다」 를
띄웠다. 교차 확인이 prep 프로그램을 쓰는데, 느린 무리라도 prep 은 0x00 루프만큼 오르지 않아(§4) 다 쓴 느린 칩을 빠른 무리처럼 보이게
한다. **이 경고는 느린 칩에서 헛울린다** — 시연 화면에서 이 줄을 근거로 무리를 바꾸면 안 된다.

넣은 뒤의 LOCO 에서 chip15 자신은 12점 모두 68% 안이지만 MAP 은 80-100k 에서 61-62k 로 머문다(수치 §4). 느린 무리 배율 곡선이 50k
뒤로 1.5-1.75 사이에서 완만해, 관측 하나로 50k 와 100k 를 가르는 힘이 약하다 — chip07 의 100k 점이 넣은 뒤에도 68% 밖(MAP 49-50k)인 것과
같은 이유다. 교정 7칩 전체 68% 포함은 60/70 → 72/82(88%), 95% 는 82/82 이고, 68% 폭 중앙값이 40,000 → 43,000 으로 넓어졌다. 명목 68%
보다 많이 품는 쪽이 커져, R 2.0 이 넓다는 [D48-86] 의 읽기가 한 번 더 섰다.

## 7. 느린 무리 세 칩을 나란히 놓으면

| | chip03 | chip07 | chip15 |
|---|---|---|---|
| 로트 · 구매처 | 옛 로트 | 옛 로트 | 새 배치 · 디바이스마트 |
| 신품 소거 | 51.1ms | 47.0ms | 49.8ms |
| 100k 소거 배율 (1k 곡선) | 1.74 | 1.59 | 1.75 |
| 계단 (100k 안) | 없음 (출발 수준 도달) | 없음 (출발 수준 미도달) | 없음 (섹터 6 만 출발 수준 넘음) |
| 프로그램 첫 움직임 | 약 20k, 7섹터 함께 | 4-12k, 섹터 5·6 먼저 | 24-37k, 7섹터 함께 |
| 100k 프로그램 | 8.60ms (+26%) | 14.19ms (2.1배) | 8.25ms (+21%, 섹터 중앙값) |
| 25MHz 폭 | 불변 | 불변 (사후 처리) | 불변 (후반 −19ps 까지) |
| 근접 대조군 소거 (100k 뒤) | 1.11 | 1.06 | 1.09 |
| 리그 사건 | 없음 | USB 재열거 2번 · 배선 접촉 | USB 흔들림 1번 (엔진 정지 · 결측 없음) |

소거 · 계단 · 프로그램 셋 다 chip03 과 같은 쪽이고, chip07 이 느린 무리 안에서 혼자 프로그램이 크게 튄 칩이었다는 것이 세 칩째에서 보인다.
로트가 달라도 느린 무리의 모양은 같았다 — chip18 이 빠른 무리에서 보인 것과 같은 답이다.

## 8. chip15 에서 닫힌 것과 넘어간 것

- **닫힘**: 새 배치 느린 무리가 옛 로트처럼 늙는가 — 그렇다, chip03 과 거의 겹친다. 교정 편입([D48-90])은 마모 전 결정대로 넣었다
  (느린 교정 03 · 07 · 15)
- **닫힘**: H1′ 25MHz 참 · H2′ 거짓(느린 무리 세 칩째) · 128KB 교란(다섯 칩째) · 장부 100,000 + newchip +1
- **닫힘 (10/5)**: 역산 교차 확인(입력 C)이 다 쓴 느린 칩에서 헛울린다 — v3 에서 그 줄을 뺀다(로그 48 [U48-16] · [D48-94])
- **넘어감**: R · ③ (v3) — 교정 7칩, 빠른 칸 chip16 이 끝나면 함께 정한다([D48-86])
- **넘어감**: 섹터 6 이 100k 너머에서 뛰는가 — 정격 밖이라 재지 않는다
- **chip15 의 다음**: 측정 끝. 섹터 0-127 이 10/5 newchip PRBS 로 써진 상태
