young-0320/flash-margin-bench/docs/results/data/chip16_loco_2026-10.md

# chip16_loco_2026-10 — 설정 65°C 칩(chip16)을 넣은 모의 블라인드(LOCO, v4)

> 수치와 표만 둔다. 해석은 [`../wear/wear_temperature_chip16.md`](../wear/wear_temperature_chip16.md) §4 · §5.

- **무엇**: v4 등록 설정(눈금 ratio · R 은 σ_r 유도 · 경계 40ms · ρ 등록값)의 LOCO(p50 관측)를 교정 표 9장 — 등록 교정 8칩(chip01·02·03·04·07·09·15·18) +
  chip16 의 `_64C` 곡선 — 으로 돌린 결과. chip17 때(`chip17_loco_2026-10.md`)와 같은 두 가지가 한 번에 나온다:
  ① **chip16 을 뺀 차례** = 교정은 상온 8칩 그대로(v4)이고 관측은 설정 65°C 칩 — 상온 모델이 이 칩을 맞히는가 (외부 검증)
  ② **상온 칩을 뺀 차례** = chip16 이 교정에 들어간 경우 — 넣으면 상온 칩 LOCO 가 어떻게 되는가
- **입력**: 관측은 구간별 p50(섹터 7개, LOCO 기본). chip16 의 관측은 마모 중 A 행(센서 60 - 67°C 에서 잰 값)
- **파일**: [`chip16_loco_2026-10.txt`](chip16_loco_2026-10.txt) — `wear_inverse.py --loco` 출력 그대로(106점). 기준선(8칩 · 94점)은 `inverse_v4_eval_2026-10.md` §2 의 p50 행과 같다(75 · 91 / 94)
- **교정 표 원본**: `wear_curves/wear_curves_chip{01,03,04,07,09}_2026-09.csv` · `_chip{02,15,18}_2026-10.csv` · `wear_curves/wear_curves_chip16_64C_2026-10.csv`.
  교정 폴더는 건드리지 않았다 — 임시 폴더에 복사해 glob 을 맞췄다(재현 명령)

## 1. 요약

| 맞힌 칩 | 교정 | 68% 적중 | 95% 적중 | 68% 폭 중앙값 |
|---|---|---|---|---|
| 상온 8칩 (94점) | v4 (상온 8칩) | 75/94 | 91/94 | 34,000 |
| 상온 8칩 (94점) | + chip16 | 74/94 | 93/94 | — |
| **chip16 (설정 65°C, 12점)** | v4 (상온 8칩) | **10/12** | **11/12** | — |
| 9칩 합계 (106점) | + chip16 | 84/106 (띠 63-81 → 과소신) | 104/106 (띠 97-105 → 합격) | 34,000 |

chip16 을 넣었을 때 68% 적중이 바뀐 점: chip01 100k X → O · chip04 20k·30k X → O · **chip02 20k·60k·70k·80k O → X**. 95% 는 chip04 2점 X → O.
빠른 무리 R 은 2.97(5칩) → **2.92**(6칩, chip16 r̂ 1.588 — chip04 1.768 다음으로 빠름). 느린 무리 1.52 그대로.

## 2. chip16 을 상온 모델로 맞힌 결과 (v4 교정 8칩 그대로)

| 정답 x | 중앙값 | 68% | 95% | 68% | 95% |
|---|---|---|---|---|---|
| 1,000 | 2,001-3,000 | 1-3,000 | 1-6,000 | O | O |
| 3,000 | 6,001-7,000 | 1,001-9,000 | 1,001-17,000 | O | O |
| 10,000 | 30,001-31,000 | 7,001-41,000 | 6,001-59,000 | O | O |
| 20,000 | 53,001-54,000 | 15,001-72,000 | 13,001-96,000 | O | O |
| 30,000 | 58,001-59,000 | 28,001-85,000 | 21,001-100,000 | O | O |
| 40,000 | 61,001-62,000 | 36,001-89,000 | 25,001-100,000 | O | O |
| 50,000 | 63,001-64,000 | 49,001-100,000 | 29,001-100,000 | O | O |
| 60,000 | 64,001-65,000 | 51,001-100,000 | 30,001-100,000 | O | O |
| 70,000 | 85,001-86,000 | 80,001-100,000 | 70,001-100,000 | X | X |
| 80,000 | 89,001-90,000 | 85,001-100,000 | 72,001-100,000 | X | O |
| 90,000 | 90,001-91,000 | 87,001-100,000 | 79,001-100,000 | O | O |
| 100,000 | 94,001-95,000 | 91,001-100,000 | 82,001-100,000 | O | O |

중앙값은 정답의 0.95 - 3.1배(1k - 60k 는 위로, 70k - 80k 는 1.1 - 1.2배) — chip17 의 0.15 - 0.35배(전 점 아래)와 반대 방향이고, 상온 빠른 무리
chip01(10k 2.2배 · 20k 2.6배)과 같은 모양이다.

## 재현

```bash
L=build/inverse/loco16 && mkdir -p $L/base $L/with16
cp docs/results/data/wear_curves/wear_curves_chip0{1,2,3,4,7,9}_2026-*.csv docs/results/data/wear_curves/wear_curves_chip1{5,8}_2026-10.csv $L/base/ && cp $L/base/*.csv $L/with16/
cp docs/results/data/wear_curves/wear_curves_chip16_64C_2026-10.csv $L/with16/wear_curves_chip16_2026-10.csv
uv run python host/analysis/wear_inverse.py --loco --curves "$L/base/wear_curves_*.csv"       # v4 기준선 (94점)
uv run python host/analysis/wear_inverse.py --loco --curves "$L/with16/wear_curves_*.csv"     # 이 파일 (106점)
uv run python host/analysis/wear_inverse.py --rate-rule --curves "$L/with16/wear_curves_*.csv" # R 2.92 · 1.52
```
