young-0320/flash-margin-bench/docs/results/wear/wear_endurance_chip10.md

# 종단 마모 결과 해석 — chip10 (W25Q64JV), 0 → 100,000 사이클

- **작성일**: 2026-10-06 · **측정**: 2026-10-05 - 10-06 (보드 A)
- **수치**: [`data/wear/wear_endurance_chip10_2026-10.md`](../data/wear/wear_endurance_chip10_2026-10.md) (+ 동명 CSV) — 표를 다시 싣지 않고 거기를 인용한다
- **사전 등록**: `docs/spec/s1.wear_bench_spec.md` §15 — H1′·H2′(2026-09-26) · H6(2026-09-27). 교정 편입은 곡선을 본 뒤 정하기로 했다(로그 48 [D48-97])
- **범위**: **chip10 한 칩의 소거 · 프로그램 시간만 본다.** 다른 칩과의 비교는 보류했다(2026-10-06, 로그 48 §50)
  > **2026-10-12 — 두 번째 JV 가 왔다 ([`wear_endurance_chip14.md`](wear_endurance_chip14.md), 로그 53 [D53-5]).** chip14(`25Q64JVSIQ` `1749`)가 같은 모양으로
  > 늙었다(계단 없음 · 100k 2.65배 · 프로그램 1.03) — 「JV 둘」 비교는 그 문서에. 7섹터가 84ms 를 넘고도 계단이 없어, 이 문서 §2 의 「H6 판정 밖」 은 JV 에선
  > 「성립 안 함」 으로 올라간다
- **경위**: `docs/log/young/48.pilot_wear_handler_and_plan_approval.md` §50

## 결론

**chip10 은 이 리포의 다른 칩들(W25Q64FV)과 세대가 다른 W25Q64JV 다**(마킹 `25Q64JVSIQ` `1850`, 2018년 50주). 0 → 100k 동안 소거 시간이
계단 없이 꾸준히 늘어 100k 에 신품의 2.55배가 됐고, 프로그램 시간은 처음 20k 동안 거의 그대로이다가 갈수록 빨리 올라 100k 에 1.11배가 됐다.
마진(25MHz 창 폭)은 움직이지 않았다. FV 칩으로 만든 수명 모델은 이 칩을 교정 밖으로 읽어 100k 를 약 절반(MAP 54-55k)으로 봤다.

| 가설 | 등록 기준 | 결과 | 판정 |
|---|---|---|---|
| H1′ 100k 안 폭 3σ 안 | 42ps | 25MHz 체크포인트 100 대비 −3.2 - +8.5ps, 바닥 0 · 45·75MHz 는 재지 않음 | **참 (25MHz)** (§1) |
| H2′ 100k 안 프로그램 불변 | 보이면 깨짐 | 섹터 1k 구간 중앙값 5.96 → 6.63ms(1.11배), 섹터별 1.08-1.16배 | **거짓** (§3) |
| H6 계단이 올 때 ① 직전 84ms 이상 ② 착지 107-112ms | 계단이 온 섹터 전부 | 100k 안에 계단이 없다(105ms 이상 A 행 0) | **판정 밖** (§2) |
| (전제) 대조군 섹터 소거 불변 | 100k 뒤 newchip | 근접 7-13 0.98 · 블록 1 0.99 · 원격 1.02 · 기준 1.02 | **성립** — 교란 없음 (§4) |

## 1. 마진은 움직이지 않았다

25MHz 폭이 체크포인트 13점 모두 11.7ps 안에 있다(수치 §1). 끊김 · 재장착이 없는 런이라 리그 사건 없이 H1′ 을 읽었다. 이 칩의 창 폭은 약
38,850ps 로, 9/20 신품 측정(다른 장착) 38,730ps 와는 장착이 달라 직접 빼지 않는다.

## 2. 소거는 계단 없이 꾸준히 늘었다

섹터 중앙값이 1k 구간마다 거의 일정하게 늘어(10k 당 6-10ms) 100k 에 83.7ms(체크포인트 p50)가 됐다. 어느 섹터도 1k 구간 중앙값이 105ms 를 넘지
않았고 한 구간 사이 최대 상승이 1.7-5.1ms 라, 「두 상태 사이를 건너뛰는」 계단이 없다. 그래서 H6 은 이 칩에서 판정할 대상이 없다.

80k 이후 섹터 0 · 4 는 85-87ms 에서 거의 멈췄고(80 → 100k +1.4 · +2.3ms), 나머지도 100k 에 78-85ms 로 그쪽에 다가간다. 소거 시간이 85-87ms 근처에서
포화하는지는 100k 너머를 재지 않아 **가설**로만 둔다.

## 3. 프로그램은 늦게, 그러나 점점 빨리 올랐다

신품 근처(1k)에서 7섹터가 모두 5.96ms 로 같았다. 1-20k 에 +0.09ms 로 거의 그대로였다가 20-50k +0.15 · 50-100k +0.43ms 로 상승이 빨라졌고, 100k 에
섹터마다 1.08-1.16배로 벌어졌다(섹터 0 · 1 이 가장 크고 6 이 가장 작다). 등록한 H2′(100k 안 프로그램 불변)은 이 칩에서 거짓이다. newchip prep(PRBS)
에서는 마모 섹터가 기준 섹터보다 1.03배로, 0x00 마모 루프에서 본 것보다 작게 보인다 — 패턴이 달라 눈금이 다르다.

## 4. 닳은 섹터 밖은 그대로였다

100k 뒤 newchip 에서 마모 섹터 0-6 은 신품의 2.61배인데, 바로 옆 근접 대조군 7-13 은 0.98, 블록 1 은 0.99 로 **교란이 없다**. 기준 섹터 32-127
도 1.02 로, 칩 자신의 안 닳은 섹터를 신품값으로 쓰는 정규화(수명 역산의 입력)가 이 칩에서도 섰다.

## 5. 수명 역산은 사용량을 절반으로 봤다

FV 칩 교정(v3.2)은 chip10 을 신품값으로 빠른 무리에 넣고 100k 를 MAP 54-55k · 68% 25-73k · 95% 21-98k, 「중마모」 로 읽었다 — 정답이 95% 구간에서도
빠졌다(수치 §3). 이 칩의 소거가 FV 빠른 무리 곡선보다 느리게 늘어 덜 쓴 칩으로 보인 것이다. 모델은 경고 없이 판정을 냈다 — 교정 범위 밖의
칩을 스스로 알리지 못한다는 한계다.

## 6. chip10 에서 닫힌 것과 넘어간 것

- **닫힘**: chip10 이 「어느 무리에도 맞지 않는」 이유 — 무리가 아니라 세대(JV)다(마킹 판독, 로그 48 §50)
- **넘어감**: 다른 칩(FV)과의 비교 — 보류(2026-10-06). 교정 편입 여부 · JV 를 따로 모을지는 로그 48 [U48-21]
- **넘어감**: 소거가 85-87ms 근처에서 포화하는가 — 100k 너머는 재지 않는다
- **넘어감**: 같은 JV 의 두 번째 칩(졸업논문 시료 Adafruit 5633 — W25Q64JVSSIQ)이 같은 모양으로 늙는가
