young-0320/flash-margin-bench/docs/results/data/blind_chip06_2026-10.md

# 블라인드 chip06 — 추정과 판정 (2026-10)

> 수치·절차 기록만 둔다. 해석은 [`../blind_chip06.md`](../blind_chip06.md). 결정의 경위는 로그 48 §23-§24 [D48-47]-[D48-60] · S-1 §15.

- **칩**: chip06 · UID `D16428231B4E182B` · 빠른 무리(신품 소거 25.7ms, 2026-09-16) · 섹터 0-6 을 박지민이 보드 B 에서 마모. 사이클 수는 지민이
  1,000-80,000 안에서 골랐다
- **정답의 정본**: 칩의 tally (로그 48 [D48-51]). 지민의 종이 기록은 대조용
- **개봉 prep**: newchip 5회 — `session_chip06_D16428231B4E182B_20260930T{210515Z,211318Z,224142Z,224956Z,225928Z}.log` (리포 루트 `data/`).
  sha256 은 추정 파일 머리말. 마모 종료 후 24시간 이내(영웅님 확인, 2026-10-01). 프로그램 시간 줄이 없는 옛 prep 빌드라 입력 C(무리 교차 확인)는 생략됐다
- **지민 쪽 스윕 원본 (2026-10-09 수령)**: 마모 중 체크포인트 4점 `sweep_chip06_D16428231B4E182B_20260930T{172830Z,175141Z,185235Z,191537Z}`
  (1k · 3k · 10k · 12k, 세션 `1790788847`) 와 개봉 prep 5회의 스윕 `{210635Z,211435Z,224301Z,225115Z,230045Z}` — CSV · `_reads` · analysis.json · 세션 로그,
  리포 루트 `data/`. 판정 뒤의 자료라 추정에는 쓰지 않았다
- **관측**: 기준 섹터(32-127) 소거 중앙값 25.3ms → 빠른 무리. 마모 섹터 0-6 소거 35개(5회 × 7), 신품 대비 배율 중앙값 1.63 (p10-p90 1.55-1.88).
  네 번째 prep(`224956Z`)의 섹터 2-6 이 44.9-48.9ms 로 다른 회차(38-44ms)보다 높다

## 1. 추정 (모두 tally 를 읽기 전 커밋)

| 추정 | 교정 | R | MAP | 68% | 95% | 코드 | 파일 | 커밋 |
|---|---|---|---|---|---|---|---|---|
| v1 (참고) | chip01·04 | 2.0 | 5,001-6,000 | 2,001-11,000 | 1,001-18,000 | `a320c98` | `chip06_estimate_v1.txt` | `d502468` |
| R 3.8 (버린 설정) | chip01·04·09 | 3.8 | 6,001-7,000 | 2,001-30,000 | 1,001-61,000 | `648defb` | `chip06_estimate_v2_R3.8_discarded.txt` | `e3a925c` |
| **v2 (판정용)** | chip01·04·09 | 2.0 | **7,001-8,000** | **3,001-19,000** | **1,001-34,000** | `318dee7` | `chip06_estimate_v2.txt` | `04bab2a` |

세 추정의 입력 로그 sha256 은 같다. 우도는 셋 다 기존(prep 전부를 관측 하나로) — [D48-58].

## 2. 정격(100,000 회) 대비 — v2

| | 사용 | 사용률 | 남은 수명 |
|---|---|---|---|
| MAP | 7,001-8,000 | 약 7.5% | 약 92.5% |
| 68% | 3,001-19,000 | 3-19% | 81-97% |
| 95% | 1,001-34,000 | 1-34% | 66-99% |

## 3. 성공 기준 (S-1 §15 2026-10-01 추기 · 로그 48 [D48-49]·[D48-54]·[D48-60])

| 기준 | v1 | v2 (판정) |
|---|---|---|
| ① 정답(12,000) ∈ 95% | 1,001-18,000 — 통과 | 1,001-34,000 — **통과** |
| ② 68% 바깥 폭 ≤ 60,000 | 9,000 — 통과 | 16,000 — 통과 |
| ③ MAP < 10,000 이므로 68% 바깥 폭 ≤ 10,000 | 9,000 — 통과 | 16,000 — **불통과** |

③ 의 비율 기준(폭/MAP ≤ v1 2.0 · v2 2.80)은 MAP 이 1만 미만이라 쓰이지 않았다.

## 4. 개봉

| 항목 | 값 |
|---|---|
| tally (a / b) | 120 / 120 바이트 · 불일치 0 → **12,000 / 12,000 사이클** |
| 정답 x | **12,000** |
| 지민 종이 기록 | 12,000 — tally 와 일치 |
| 개봉 일시 · 읽은 사람 | 2026-10-01 10:55 UTC · 한영웅 · 보드 A (`run_wear.py uid` → chip06 확인, `tally` — 읽기 전용, P/E 0) |

## 5. 정답의 자리 (같은 입력·같은 코드로 사후분포를 다시 계산)

| 추정 | 정답이 든 구간 | 그 구간보다 아래일 확률 | 정답 구간의 확률 순위 | 68% 안 |
|---|---|---|---|---|
| v1 | 11,001-12,000 | 79% | 10 / 100 | 아니오 (68% 2,001-11,000) |
| **v2** | 11,001-12,000 | **49%** | 8 / 100 | **예** |
| R 3.8 (버림) | 11,001-12,000 | 32% | 8 / 100 | 예 |

정격 대비 실제 사용률 12% · 남은 수명 88% — v2 의 68% 구간(사용률 3-19% · 남은 수명 81-97%) 안.

## 6. 장부 (개봉 뒤 지민 장부에서 기입, 2026-10-01)

마모 세션 `1790788847`(보드 B): 0→100(호스트 로그 유실 — tally 로 보정한 정정 행) · 100→1,000 · 1,000→3,000 · 3,000→10,000 ·
10,000→12,000, 체크포인트 1,000 · 3,000 · 10,000 · 12,000 (각 섹터 0-6 소거+PRBS). 장부의 마모 합계 12,000 = tally.
세션 폴더는 2026-10-08 지민 묶음으로 받아 리포 루트 `data/wear/1790788847/` 에 두었다 — verdict 4구간 PASS(A1-A7 · C · probe), A 행 83,300(cycle 101-12,000) ·
체크포인트 C 행 4개(소거 p50 31.6 · 34.7 · 38.8 · 41.1ms). 체크포인트 스윕 CSV 4개(`sweep_chip06_<UID>_20260930T{172830,175141,185235,191537}Z`)와 그 세션
로그는 묶음에 없어 아직 못 받았다.
섹터 0-6 이 실제로 겪은 P/E 는 12,010 이다 — 마모 12,000 + 체크포인트 4 + 신품 prep 1 + 개봉 prep 5. 정답 x 는 마모 사이클만 센 값으로,
교정 곡선의 x(체크포인트 prep 을 세지 않음)와 같은 정의다.
