young-0320/flash-margin-bench/docs/results/data/inverse_v4_probe_2026-10.md

# inverse_v4_probe_2026-10 — v4 의 정렬 · R 유도 · n_eff 가 교정 8칩 LOCO 에서 하는 일 (등록 전 · 부분 탐색)

> 수치와 표만 둔다. 판단은 로그 52 §4 · §8 — v4 결정 [D52-2] · 띠 [D52-3]. v4 의 등록 수치가 아니다.

- **무엇**: v4 다섯 항목 중 원본 A 행 없이 돌릴 수 있는 셋 — ③ 교정 곡선 정렬 · ④ R 유도 · ② 유효 관측 수(ρ 는 **가정값**) — 를 v3.2 위에 하나씩
  얹어 모의 블라인드(LOCO)를 돌렸다. 셀은 정규분포(분위수 표가 아직 없다), 관측은 v3 방식(구간별 섹터 7개 p50 · P 1), 눈금 ratio · 경계 40ms.
  ① 분위수 셀과 ⑤ rows 관측은 표 재생성 뒤에만 가능하다 (S-5 §9)
- **날짜**: 2026-10-08. 코드 `aa3048d` 뒤 (모델은 `MODELS["probe"]` 를 임시로 두고 돌렸다 — 등록 경로가 아니다)
- **교정 표**: 접미사 없는 8칩 — `wear_curves_chip{01,03,04,07,09}_2026-09.csv` · `wear_curves_chip{02,15,18}_2026-10.csv`
- **합격 띠 (94점 · 2σ)**: 68% 는 56-72점 · 95% 는 86-93점 (S-5 §7)

## 1. 하나씩 얹은 LOCO

| 조건 (정규 셀 · p50 관측 · ratio) | 점 | 정답∈68 | 정답∈95 | 68% 폭 중앙값 | \|중앙값−정답\| 중앙값 |
|---|---|---|---|---|---|
| v3.2 (R 빠른 1.6 · 느린 1.3 · 증거 1) | 94 | 67 (71%) | 93 (99%) | 33,000 | 7,500 |
| +③ 정렬 (R 1.6 · 1.3 그대로) | 94 | 61 (65%) | 86 (91%) | 28,500 | 7,500 |
| +③ 정렬 +④ R 유도 (빠른 2.97 · 느린 1.52) | 94 | 79 (84%) | 93 (99%) | 37,500 | 8,000 |
| +③④ +② n_eff (ρ_s 0.9 가정 · P 1) | 94 | 79 (84%) | 93 (99%) | 37,000 | 8,000 |
| +③④ +② n_eff (ρ_s 0.7 가정) | 94 | 78 (83%) | 93 (99%) | 36,000 | 8,000 |
| +③④ +② n_eff (ρ_s 0.5 가정) | 94 | 79 (84%) | 91 (97%) | 35,500 | 7,500 |
| +③④ +② n_eff (ρ_s 0.3 가정) | 94 | 74 (79%) | 89 (95%) | 34,500 | 7,500 |

- 띠 판정: v3.2 합격 · 합격. 정렬만 — 68% 합격 · 95% 합격(86, 띠 아래 끝). 정렬 + R 유도 — 68% **과소신**(79 > 72) · 95% 합격. n_eff 를 얹어도
  68% 는 74-79 로 띠 위다
- 정렬은 같은 R 에서 68% 폭을 33,000 → 28,500 으로 줄이고 포함률을 명목 쪽으로 내린다. R 유도는 빠른 무리를 2.97 로 넓혀 폭을 37,500 으로 되돌린다

## 2. 칩 속도 (정렬 전 곡선에서 · `--rate-rule` v4 줄)

| 무리 | 칩 속도 r̂ (무리 기하 평균 = 1) | σ_r | M | R = exp(1.96·σ_r·√(1+1/M)) |
|---|---|---|---|---|
| 빠른 | chip01 1.470 · chip02 0.604 · chip04 1.974 · chip09 0.719 · chip18 0.794 | 0.507 | 5 | 2.97 |
| 느린 | chip03 1.036 · chip07 0.819 · chip15 1.177 | 0.184 | 3 | 1.52 |

쌍 맞춤의 rmse(로그 배율 차): 빠른 무리에서 chip01-04 0.10 · chip04-09 0.05 · chip04-18 0.05 · 나머지 0.02-0.04, 느린 무리 0.02 이하.
chip04 와 chip02 가 양끝이고 chip04 가 낀 쌍은 「모양이 같고 가로축만 늘어난다」 가 잘 안 맞는다.
