young-0320/flash-margin-bench/docs/results/data/baseline_compare_2026-10.md

# baseline_compare_2026-10 — 기준선 비교 (선행식 이진 판별 · 단순 회귀 · 현행 모델 v3.2)

> 수치와 표만 둔다. 방법(결과 전에 커밋 — `7ce25fc`)과 해석은 [`../baseline_compare.md`](../baseline_compare.md).

- **무엇**: 교정 8칩(chip01 · 02 · 03 · 04 · 07 · 09 · 15 · 18)의 모의 블라인드(LOCO) 94점에 세 방법을 댄 결과. ① 의 음성은 신품을 잰 15칩.
  **2026-10-07 판** — chip02 를 교정에 넣은 뒤 같은 방법으로 다시 돌렸다. 10-05 판(교정 7칩 · 82점)은 커밋 `fd0f79a`
- **그림**: [`../plots/baseline_compare_binary_2026-10.png`](../plots/baseline_compare_binary_2026-10.png) — ① 세 변형이 지점마다 쓴 칩 중 「썼다」 로 잡은
  비율, 무리별 두 칸(빠른 5칩 · 느린 3칩, 60k · 80k 는 느린 2칩). 점선 100% 가 정답.
  [`../plots/baseline_compare_estimate_2026-10.png`](../plots/baseline_compare_estimate_2026-10.png) — 지점마다 정답(검은 선) · 우리 모델의 추정과
  68% 구간 · 단순 회귀의 추정, 칩 8개를 나란히
- **입력**: 교정 표 `wear_curves/wear_curves_chip*_20*.csv`(접미사 없는 8장) · 집계표 `newchip_survey_2026-09.csv` · 신품 섹터 원자료
  `data/session_<chip>_<uid>_<stamp>.log` 의 `#PREP ERASE`(리포 밖 — 세션 목록은 스크립트의 `FRESH_SESSIONS`)
- **표기**: 확신도 = 관측 일곱 개 중 신품 문턱을 넘은 비율(논문 4절 식 (1) 의 1 − α), 95% 이상이면 「썼다」. 문턱은 (a) 데이터시트 typ ·
  (b) 판정받는 칩을 뺀 신품 칩 섹터 값의 최댓값 · (c) (b) 를 배율로. 아래는 `baseline_compare.py` 출력 그대로다(절 번호만 붙였다).
  첫 줄: 기준선 비교 · 교정 칩 ['chip01', 'chip02', 'chip03', 'chip04', 'chip07', 'chip09', 'chip15', 'chip18'] · LOCO 94점 · 신품 15칩 · 모델 v3.2
- **신품 세션과 집계표의 차이**: chip02 는 채택 세션의 0-127 중앙값 27,154.5µs(집계표 27,151) · chip14 는 등록 세션 35,907µs(집계표 36,239 는
  라벨 없이 끊긴 첫 prep 의 값). 나머지 13칩은 집계표 값과 같다
- **③ 대조**: `wear_inverse.py --loco` 의 요약 줄(정답∈68 67/94 · 정답∈95 93/94 · 68% 폭 중앙값 33,000)과 §1 전체 행이 같다

## 1. 점 추정 (② · ③) — 추정 ÷ 정답 중앙값 · 절대 오차 중앙값 · |ln(추정 ÷ 정답)| 중앙값

| 부분 | 점 | ② 단순 회귀 | ③ 현행 모델 | ③ 정답∈68% | ③ 정답∈95% | ③ 68% 폭 중앙값 |
|---|---|---|---|---|---|---|
| 전체 | 94 | 0.91 · 10,000 · 0.40 | 0.95 · 7,500 · 0.25 | 67/94 | 93/94 | 33,000 |
| x ≤ 20k | 32 | 0.81 · 2,662 · 0.54 | 1.16 · 1,500 · 0.47 | 27/32 | 32/32 | 10,000 |
| x 20-50k | 24 | 0.89 · 13,366 · 0.39 | 1.00 · 8,500 · 0.23 | 16/24 | 23/24 | 34,500 |
| x 50k 초과 | 38 | 0.99 · 20,825 · 0.33 | 0.82 · 14,500 · 0.19 | 24/38 | 38/38 | 38,500 |
| 빠른 무리 | 60 | 0.67 · 16,163 · 0.51 | 0.88 · 9,000 · 0.34 | 36/60 | 59/60 | 37,500 |
| 느린 무리 | 34 | 0.99 · 4,106 · 0.19 | 1.01 · 6,500 · 0.18 | 31/34 | 34/34 | 31,500 |

② 가 곡선 끝(100,000)에 붙은 점: 17/94

## 2. ① 이진 판별 — 검출 (「썼다」 로 판정한 점 / 점)

| 정답 x | 빠른 (a) 데이터시트 | 빠른 (b) 신품 분포 | 빠른 (c) 정규화 뒤 | 느린 (a) | 느린 (b) | 느린 (c) |
|---|---|---|---|---|---|---|
| 1,000 | 0/5 | 0/5 | 1/5 | 0/3 | 0/3 | 0/3 |
| 3,000 | 0/5 | 0/5 | 2/5 | 0/3 | 0/3 | 0/3 |
| 10,000 | 1/5 | 1/5 | 5/5 | 0/3 | 2/3 | 0/3 |
| 20,000 | 1/5 | 2/5 | 5/5 | 2/3 | 3/3 | 0/3 |
| 30,000 | 4/5 | 2/5 | 5/5 | 3/3 | 3/3 | 2/3 |
| 40,000 | 4/5 | 3/5 | 5/5 | 3/3 | 3/3 | 3/3 |
| 50,000 | 5/5 | 5/5 | 5/5 | 3/3 | 3/3 | 3/3 |
| 60,000 | 5/5 | 5/5 | 5/5 | 2/2 | 2/2 | 2/2 |
| 70,000 | 5/5 | 5/5 | 5/5 | 3/3 | 3/3 | 3/3 |
| 80,000 | 5/5 | 5/5 | 5/5 | 2/2 | 2/2 | 2/2 |
| 90,000 | 5/5 | 5/5 | 5/5 | 3/3 | 3/3 | 3/3 |
| 100,000 | 5/5 | 5/5 | 5/5 | 3/3 | 3/3 | 3/3 |
| **전체** | 40/60 | 38/60 | 53/60 | 24/34 | 27/34 | 21/34 |

전체(두 무리): (a) 64/94 · (b) 65/94 · (c) 74/94
(a) 가 놓친 점 (확신도): chip01 1,000 (0%) · chip01 3,000 (0%) · chip01 10,000 (0%) · chip01 20,000 (43%) · chip02 1,000 (0%) · chip02 3,000 (0%) · chip02 10,000 (0%) · chip02 20,000 (43%) · chip03 1,000 (0%) · chip03 3,000 (0%) · chip03 10,000 (57%) · chip04 1,000 (0%) · chip04 3,000 (0%) · chip07 1,000 (0%) · chip07 3,000 (0%) · chip07 10,000 (14%) · chip07 20,000 (29%) · chip09 1,000 (0%) · chip09 3,000 (0%) · chip09 10,000 (14%) · chip09 20,000 (29%) · chip15 1,000 (0%) · chip15 3,000 (14%) · chip15 10,000 (71%) · chip18 1,000 (0%) · chip18 3,000 (0%) · chip18 10,000 (0%) · chip18 20,000 (14%) · chip18 30,000 (43%) · chip18 40,000 (71%)
(b) 가 놓친 점 (확신도): chip01 1,000 (0%) · chip01 3,000 (0%) · chip01 10,000 (0%) · chip02 1,000 (0%) · chip02 3,000 (0%) · chip02 10,000 (0%) · chip02 20,000 (0%) · chip02 30,000 (29%) · chip02 40,000 (0%) · chip03 1,000 (14%) · chip03 3,000 (86%) · chip04 1,000 (0%) · chip04 3,000 (14%) · chip07 1,000 (0%) · chip07 3,000 (14%) · chip07 10,000 (43%) · chip09 1,000 (0%) · chip09 3,000 (0%) · chip09 10,000 (0%) · chip09 20,000 (14%) · chip09 30,000 (29%) · chip09 40,000 (29%) · chip15 1,000 (14%) · chip15 3,000 (71%) · chip18 1,000 (0%) · chip18 3,000 (0%) · chip18 10,000 (0%) · chip18 20,000 (14%) · chip18 30,000 (71%)
(c) 가 놓친 점 (확신도): chip01 1,000 (43%) · chip02 1,000 (0%) · chip02 3,000 (57%) · chip03 1,000 (0%) · chip03 3,000 (0%) · chip03 10,000 (0%) · chip03 20,000 (29%) · chip07 1,000 (0%) · chip07 3,000 (0%) · chip07 10,000 (14%) · chip07 20,000 (29%) · chip09 1,000 (14%) · chip09 3,000 (57%) · chip15 1,000 (0%) · chip15 3,000 (0%) · chip15 10,000 (14%) · chip15 20,000 (71%) · chip15 30,000 (86%) · chip18 1,000 (14%) · chip18 3,000 (71%)

## 3. ① 이진 판별 — 신품 칩 (오경보)

| 칩 | 무리 | 섹터 0-6 중앙값 ms | (a) typ ms | (a) 확신도 | (b) 문턱 ms | (b) 확신도 | (c) 문턱 배율 | (c) 확신도 |
|---|---|---|---|---|---|---|---|---|
| chip01 | 빠른 | 28.2 | 60 | 0% | 55.7 | 0% | 1.28 | 0% |
| chip02 | 빠른 | 27.2 | 45 | 0% | 55.7 | 0% | 1.28 | 0% |
| chip03 | 느린 | 51.0 | 60 | 0% | 55.7 | 0% | 1.28 | 0% |
| chip04 | 빠른 | 34.7 | 60 | 0% | 55.7 | 0% | 1.22 | 0% |
| chip06 | 빠른 | 25.8 | 45 | 0% | 55.7 | 0% | 1.28 | 0% |
| chip07 | 느린 | 46.4 | 60 | 0% | 55.6 | 0% | 1.28 | 0% |
| chip08 | 느린 | 49.1 | 60 | 0% | 55.7 | 0% | 1.28 | 0% |
| chip09 | 빠른 | 26.1 | 45 | 0% | 55.7 | 0% | 1.28 | 0% |
| chip10 | 빠른 | 32.8 | 60 (끝자리 미확인) | 0% | 55.7 | 0% | 1.28 | 0% |
| chip12 | 느린 | 47.2 | 60 (끝자리 미확인) | 0% | 55.7 | 0% | 1.28 | 0% |
| chip14 | 빠른 | 36.9 | 60 (끝자리 미확인) | 0% | 55.7 | 0% | 1.28 | 0% |
| chip15 | 느린 | 51.7 | 60 | 0% | 55.7 | 0% | 1.28 | 0% |
| chip16 | 빠른 | 27.0 | 60 | 0% | 55.7 | 0% | 1.28 | 0% |
| chip17 | 빠른 | 25.6 | 60 (끝자리 미확인) | 0% | 55.7 | 0% | 1.28 | 0% |
| chip18 | 빠른 | 28.3 | 60 | 0% | 55.7 | 0% | 1.28 | 0% |

오경보: (a) 15칩 0/15 · 교정 8칩 0/8 · (b) 15칩 0/15 · 교정 8칩 0/8 · (c) 15칩 0/15 · 교정 8칩 0/8
끝자리 미확인 칩을 IQ(45ms)로 보면 (a) 가 「썼다」 로 바뀌는 칩: chip12

## 4. 신품 위쪽 끝의 정의 민감도 — (b) · (c) 의 검출 / 오경보

| 신품 위쪽 끝 | (b) 검출 | (b) 오경보 | (c) 검출 | (c) 오경보 |
|---|---|---|---|---|
| 최댓값 (논문 그대로) | 65/94 | 0/15 | 74/94 | 0/15 |
| 99번째 백분위 | 68/94 | 0/15 | 86/94 | 0/15 |

## 재현

```bash
uv run python host/analysis/baseline_compare.py --plot build/plots   # 그림 두 장 — 사람이 ../plots/ 로 옮긴다
```
