young-0320/flash-margin-bench/docs/results/wear/wear_endurance_chip18.md

# 종단 마모 결과 해석 — chip18 (새 배치 · 빠른 무리), 0 → 100,000 사이클

- **작성일**: 2026-10-04 · **측정**: 2026-10-03 - 10-04 (보드 A)
- **수치**: [`data/wear/wear_endurance_chip18_2026-10.md`](../data/wear/wear_endurance_chip18_2026-10.md) (+ 동명 CSV) — 표를 다시 싣지 않고 거기를 인용한다
- **사전 등록**: `docs/spec/s1.wear_bench_spec.md` §15 — H1′·H2′(2026-09-26) · H6(2026-09-27 — 「다음 칩에 대한 예측」) · 교정 편입은 결과 전
  결정(로그 48 [D48-75])
- **비교 대상**: 같은 빠른 무리 [`wear_pilot_chip01.md`](wear_pilot_chip01.md) · [`wear_endurance_chip04.md`](wear_endurance_chip04.md) · chip09(수치 문서만)
  · 같은 새 배치 상온 종단 chip16(진행 중, 박지민)
- **경위**: `docs/log/young/48.pilot_wear_handler_and_plan_approval.md` §38

## 결론

**새 배치 chip18 은 옛 로트 빠른 무리처럼 늙었다 — 소거가 100k 에 3.68배로 늘었고, 7섹터 중 5개가 53-100k 에 약 21ms 높이의 계단을 탔으며,
프로그램과 마진은 그대로였다.** 계단 직전 · 착지 수준은 H6 이 예측한 그대로다. 다만 계단이 옛 빠른 칩들(chip04 26-47k · chip01 35-63k)보다
늦게 와서, 80k 까지는 가장 늦게 늙던 chip09 와 같은 길을 가다가 마지막 20k 에 chip04 와 chip01 사이로 올라섰다.

| 가설 | 등록 기준 | 결과 | 판정 |
|---|---|---|---|
| H1′ 100k 안 폭 3σ 안 | 42ps | 25MHz 체크포인트 100 대비 −6.8 - 0.0ps, 바닥 0 · 45·75MHz 는 재지 않음 | **참 (25MHz)** (§1) |
| H2′ 100k 안 프로그램 7.0ms 불변 | 보이면 깨짐 | 섹터 1k 구간 중앙값 6.75-6.83ms, newchip prep 신품 대비 1.00 | **참** (§1) |
| H6 계단이 올 때 ① 직전 84ms 이상 ② 착지 107-112ms | 계단이 온 섹터 전부 | 5섹터 직전 89.2-91.3ms · 착지 108.1-108.8ms | **참** (§2) |
| (추가 관측) H3 계단 양자 21±4ms | 종단 판정은 닫힘 (거짓, chip04) | 5섹터 19.7-23.1ms 로 전부 안 | 충족 (§2) |
| (추가 관측) H4 전환 순서 = 신품 소거 내림차순 | 칩마다 ρ ≥ 0.5 | 계단 온 5섹터 ρ 0.70 | 충족 (§2) |
| (추가 관측) H5 칩 간 같은 순위 섹터 전환 시점 | 40k 이하 | chip18 이 53-100k 로 늦어 넘는 순위가 있다 | 충족 못 함 (§3) |
| (전제) 대조군 섹터 소거 불변 | 100k 뒤 newchip | 원격 121-127 · 기준 32-127 0.98 · 근접 7-13 1.09 · 블록 1 1.10 | **원격만 성립** (§4) |

## 1. 마진과 프로그램은 움직이지 않았다

25MHz 폭은 체크포인트 1,000 부터 100k 까지 2.7ps 안에 있다(수치 §1). 끊김 · 재장착 · 재개가 한 번도 없는 첫 상온 종단이라, 리그 사건 없이
H1′ 을 읽은 칩이다. 45·75MHz 사다리는 돌리지 않아 25MHz 로만 판정한다. 프로그램은 0x00 마모 루프 기준 6.74 → 6.82ms(p50)로, 빠른 무리
세 칩(chip01 · 04 · 09)이 100k 까지 그대로였던 것과 같다. 느린 무리(chip03 · 07)처럼 오르지 않았다.

## 2. 계단은 H6 그대로 왔다 — 두 상태 사이를 건너뛴다

계단이 온 5섹터 모두 직전 구간이 89-91ms(① 84ms 이상)였고 착지가 108-109ms(② 107-112ms)였다. 첫 계단 구간의 A 행은 94ms 미만과
108ms 이상으로만 갈리고 그 사이가 **0%** 다(수치 §2) — chip01 에서 처음 보았던 「두 봉우리」 그대로이며, 계단 없이 중간값이 24-76% 였던
chip12 와 정반대다. 높이 19.7-23.1ms 는 H3 의 21±4ms 안이고, 늦게 계단을 탄 섹터일수록 신품에 빨랐다(ρ 0.70, H4 방향과 같음).

계단이 없는 섹터 5 · 6 도 100k 에 88-90ms 로 ① 의 84ms 를 넘었다. chip03 이 보였듯 ① 은 충분조건이 아니어서, 100k 너머에서 이 둘이 언제
뛸지는 이 데이터로 말할 수 없다.

## 3. 같은 빠른 무리 안에서도 계단 시점은 칩마다 크게 다르다

첫 계단 시점이 chip04 26-47k, chip01 35-63k, chip18 53-100k(2섹터는 100k 안에 없음)이고, chip09 는 100k 안에 하나도 없다(105ms 정의 — 100ms 를 넘은 섹터는 93k 에 하나). 칩 전체 배율도 그래서
갈린다 — chip18 은 60k 까지 chip09 와 0.08 안(10k 1.53 대 1.53 · 50k 2.26 대 2.29)으로 붙어 가고 70-80k 에 ±0.15 로 엇갈리다가, 89-100k 에 계단 셋이 몰려 100k 3.68 로
chip04(3.55)와 chip01(3.97) 사이에 섰다(수치 §2). H5 가 말한 「같은 순위 섹터는 칩 사이에서 비슷한 때 뛴다」는 chip18 을 넣으면 서지
않는다. 빠른 무리의 노화 속도 차이(로그 48 §22 의 속도 배율 r)가 계단 시점에서 가장 크게 드러난다.

## 4. 새 배치는 옛 로트 빠른 무리의 띠 안에 있다

chip18 의 배율 곡선은 옛 로트 빠른 세 칩이 만든 띠의 아래쪽 가장자리(chip09) 위를 따라가다 띠 안으로 들어왔다. 소거 증가 · 계단 · 프로그램
불변이라는 빠른 무리의 세 표지가 모두 맞아, 구매처가 달라 어느 무리의 표지와도 맞지 않던 chip12 와 다르다. 기준 섹터 32-127 은 100k 뒤에도
신품 대비 0.98 로, 수명 역산의 입력 A(신품값)가 쓰던 칩에서도 그대로 나온다는 전제가 새 배치에서도 섰다. 근접 대조군(7-13)은 1.09,
블록 1(16-31)은 1.10 으로 옛 로트 세 칩의 근접 교란(chip07 1.06 · chip03 1.11 · chip04 1.15) 범위 안이다 — 「원격만 성립」 이 네 칩째다.

## 5. 수명 역산 — 넣기 전에는 낮게 봤고, 넣은 뒤 교정은 넓어졌다

chip18 을 교정에 넣기 **전**의 현장 역산은 100k 칩을 MAP 54-55k 로 읽었다 — 68% 밖, 95% 안(수치 §3). 80k 까지 chip09 처럼 늙은 칩이라
교정이 그 길로 읽은 것이다. 넣은 뒤의 모의 블라인드(LOCO)에서도 chip18 자신의 MAP 은 정답의 약 절반에 머물렀고(100k 에서 49-50k), 68% 는
12점 중 100k 만 놓쳤다(수치 §4). 교정 6칩 전체로는 68% 포함이 42/58 → 60/70, 95% 가 57/58 → 70/70 으로 늘었고, 가장 크게 좋아진 것은
chip09(68% 1/12 → 9/12)다 — 혼자 늦게 늙던 칩에 같은 길을 가는 짝이 생겼다. 대가로 68% 폭(구간 조각 길이의 합) 중앙값이 39,500 → 40,000 사이클로 조금 넓어졌다.

빠른 무리의 사용량 추정은 **계단이 늦게 오는 칩을 낮게 본다**는 것이 chip18 이 남긴 한계다. 판정 등급은 「고마모 (정격의 60% 이상)」 이 55%
로 맞는 쪽이었지만, MAP 숫자 하나로 읽으면 약 절반을 놓친다 — 시연 화면이 구간과 등급을 앞세우는 이유와 같다.

## 6. chip18 에서 닫힌 것과 넘어간 것

- **닫힘**: 새 배치 빠른 무리가 옛 로트처럼 늙는가(로그 48 §34 의 물음) — 그렇다, 띠 안. 교정 편입([D48-75])은 결과를 보기 전 결정대로 넣었다
- **닫힘**: H6 — chip04 에 이어 chip18 5섹터에서도 참
- **넘어감**: chip16(같은 새 배치 · 빠른 무리, 박지민)이 끝나면 새 배치 두 칩째로 같은 물음을 다시 본다 — chip18 처럼 늦게 계단을 타는지가
  역산의 과소 추정이 칩 하나의 사정인지 새 배치의 성질인지를 가른다
- **넘어감**: 계단이 없는 섹터 5 · 6 이 100k 너머에서 언제 뛰는가 — 정격 밖이라 재지 않는다
