young-0320/flash-margin-bench/docs/results/data/chip17_loco_2026-10.md

# chip17_loco_2026-10 — 65°C 칩(chip17)을 넣은 모의 블라인드(LOCO)

> 수치와 표만 둔다. 해석은 [`../wear/wear_temperature_chip17.md`](../wear/wear_temperature_chip17.md) §4.

- **무엇**: v2 설정(눈금 ratio · R 2.0 · 무리 경계 40ms)의 LOCO 를 교정 표 6장 — 상온 5칩(chip01·03·04·07·09) + chip17 의 65°C 곡선 — 으로
  돌린 결과. 한 칩을 빼고 나머지로 맞히므로 두 가지가 한 번에 나온다:
  ① **chip17 을 뺀 차례** = 교정은 상온 5칩 그대로(v2)이고 관측은 65°C 칩 — 상온 모델이 65°C 이력 칩을 맞히는가 (외부 검증)
  ② **상온 칩을 뺀 차례** = chip17 이 교정에 들어간 경우 — chip17 을 교정에 넣으면 상온 칩 LOCO 가 나아지는가
- **입력**: 관측은 구간별 p50(섹터 7개, LOCO 기본). chip17 의 관측도 **65°C 에서 잰** A 행이다(상온으로 식혀 잰 prep 이 아니다)
- **파일**: [`chip17_loco_2026-10.txt`](chip17_loco_2026-10.txt) — `wear_inverse.py --loco` 출력 그대로(70점)
- **교정 표 원본**: `../wear_curves/wear_curves_chip0{1,3,4,7,9}_2026-09.csv` · `wear_curves/wear_curves_chip17_65C_2026-10.csv`.
  교정 폴더는 건드리지 않았다 — 임시 폴더에 복사해 glob 을 맞췄다(재현 명령)

## 1. 무리별 요약

| 맞힌 칩 | 교정 | 68% 적중 | 95% 적중 | 68% 바깥 폭 중앙값 |
|---|---|---|---|---|
| 빠른 무리 상온 3칩 (chip01·04·09) | v2 (상온 5칩) | 21/36 | 35/36 | 44,000 |
| 빠른 무리 상온 3칩 (chip01·04·09) | + chip17 | 21/36 | 35/36 | 49,500 |
| 느린 무리 (chip03·07) | v2 / + chip17 | 21/22 / 21/22 | 22/22 / 22/22 | 44,000 / 44,000 |
| **chip17 (65°C)** | v2 (상온 5칩) | **2/12** | **10/12** | 22,000 |

chip17 을 넣었을 때 68% 적중이 바뀐 점: chip09 의 3k-50k 6점 X → O · chip01 30k·40k 와 chip04 1k-20k 6점 O → X (순 변화 0).

## 2. chip17 을 상온 모델로 맞힌 결과 (v2 교정 그대로)

| 정답 x | MAP | 68% | 95% | 68% | 95% |
|---|---|---|---|---|---|
| 1,000 | 1-1,000 | 1-2,000 | 1-4,000 | O | O |
| 3,000 | 1-1,000 | 1-3,000 | 1-6,000 | O | O |
| 10,000 | 1,001-2,000 | 1-5,000 | 1-11,000 | X | O |
| 20,000 | 3,001-4,000 | 1,001-11,000 | 1-21,000 | X | O |
| 30,000 | 6,001-7,000 | 2,001-19,000 | 1,001-36,000 | X | O |
| 40,000 | 8,001-9,000 | 3,001-24,000 | 2,001-44,000 | X | O |
| 50,000 | 8,001-9,000 | 4,001-27,000 | 2,001-51,000 | X | O |
| 60,000 | 16,001-17,000 | 6,001-33,000 | 4,001-59,000 | X | X |
| 70,000 | 20,001-21,000 | 9,001-41,000 | 6,001-72,000 | X | O |
| 80,000 | 26,001-27,000 | 11,001-49,000 | 8,001-85,000 | X | O |
| 90,000 | 32,001-33,000 | 14,001-57,000 | 10,001-91,000 | X | O |
| 100,000 | 34,001-35,000 | 17,001-62,000 | 13,001-94,000 | X | X |

MAP 은 정답의 0.15-0.35배 — 모든 점에서 낮은 쪽으로 빗나갔다. 95% 구간은 12점 중 10점이 정답을 품었지만 위쪽 끝에 걸쳐서다.

## 재현

```bash
L=build/inverse/loco17 && mkdir -p $L/base $L/with17
cp docs/results/data/wear_curves/wear_curves_chip0{1,3,4,7,9}_2026-09.csv $L/base/ && cp $L/base/*.csv $L/with17/
cp docs/results/data/wear_curves/wear_curves_chip17_65C_2026-10.csv $L/with17/wear_curves_chip17_2026-09.csv
uv run python host/analysis/wear_inverse.py --loco --curves "$L/base/wear_curves_*.csv"     # v2 기준선 (58점)
uv run python host/analysis/wear_inverse.py --loco --curves "$L/with17/wear_curves_*.csv"   # 이 파일 (70점)
```
