young-0320/flash-margin-bench/docs/results/data/synthetic_recovery_2026-10.md

# 수명 역산 모델 합성 복원 — 2026-10

> 수치·조건·재현만 둔다. 해석과 결정은 로그 48 §24 [D48-58] · S-1 §15 2026-10-01 저녁 추기.

- **그림**: [`../plots/synthetic_recovery_2026-10.png`](../plots/synthetic_recovery_2026-10.png) — 가로 모델이 말한 확률(최고밀도 구간), 세로 참값이 그 구간에 든 비율. 대각선이 정직
- **코드**: `host/analysis/wear_inverse.py` `synthetic()` · §1-§3 은 교정 표 4칩(chip01·03·04·07, `wear_curves/`) · R 2.0 · §4 는 chip09 를 더한 5칩 · R 3.8 · 눈금 ratio · 무리 경계 40ms
- **생성 (모델 가정대로)**: 무리를 고르고 x 는 U(1, 100,000) · r 은 로그균등 [1/2, 2] · 곡선 지점 M = x·r 에 구간이 있는 그 무리 교정 칩 하나를
  정체로 고른다. prep 마다 섹터 0-6 을 그 칩·그 섹터·그 구간의 N(p50, (p90−p10)/2.56) 에서 뽑는다(σ 하한 p50 의 2%). 한 prep 의 섹터들은 같은
  칩·같은 r 을 공유한다
- **두 조건**: 정체 칩 포함(추론 코드 점검 — 가정이 딱 맞는 세계) · 정체 칩을 교정에서 뺌(처음 보는 칩 — 블라인드·현장과 같은 조건).
  지금 빠른 무리는 교정 2칩이라 빼면 하나만 남는다 — 블라인드(v2 는 빠른 무리 3칩)보다 가혹하다
- **두 우도**: 기본 = prep 전부를 관측 하나로(관측 수로 나눈 기하 평균) · prep 독립 = 따로 돌린 prep 을 독립으로(prep 횟수를 곱함, `--prep-indep`)

## 1. 명목 확률별 포함률 (%, 각 500회, seed 0)

| 조건 | 10% | 20% | 30% | 40% | 50% | 60% | 68% | 80% | 90% | 95% |
|---|---|---|---|---|---|---|---|---|---|---|
| 정체 칩 포함 · 기본 · prep 5회 | 14 | 23 | 30 | 42 | 52 | 65 | 78 | 91 | 97 | 100 |
| 정체 칩 포함 · 기본 · prep 1회 | 13 | 25 | 35 | 44 | 56 | 69 | 76 | 88 | 97 | 100 |
| 정체 칩 포함 · prep 독립 · prep 5회 | 11 | 19 | 30 | 40 | 50 | 59 | 69 | 82 | 93 | 98 |
| 정체 칩 뺌 · 기본 · prep 5회 | 10 | 17 | 27 | 37 | 49 | 58 | 68 | 80 | 91 | 96 |
| 정체 칩 뺌 · 기본 · prep 1회 | 9 | 19 | 30 | 40 | 50 | 61 | 69 | 79 | 90 | 95 |
| 정체 칩 뺌 · prep 독립 · prep 5회 | 11 | 17 | 26 | 33 | 40 | 47 | 53 | 67 | 77 | 82 |

500회의 표본 흔들림은 68% 에서 약 ±2%p, 95% 에서 약 ±1%p.

## 2. 재현성 — 정체 칩 뺌 · prep 5회 (68% / 95% 포함률, 각 500회)

| seed | 기본 | prep 독립 |
|---|---|---|
| 0 | 68 / 96 | 53 / 82 |
| 1 | 68 / 96 | 54 / 84 |
| 2 | 65 / 94 | 55 / 81 |

## 3. x 구간·무리별 — 정체 칩 뺌 · prep 5회 (68% / 95% 포함률, seed 0, 800회)

| 우도 | x < 20k | 20-50k | 50k 이상 | 빠른 무리 | 느린 무리 |
|---|---|---|---|---|---|
| 기본 | 72 / 98 (172점) | 80 / 97 (266) | 59 / 94 (362) | 62 / 94 (433) | 76 / 98 (367) |
| prep 독립 | 56 / 82 | 64 / 88 | 49 / 79 | 51 / 75 | 61 / 91 |

§2·§3 은 같은 `synthetic()` 생성 규칙을 seed·표본 수만 바꿔 별도 스크립트로 셌다(같은 날, 커밋 전 작업 트리).

## 4. 교정 5칩(chip09 추가) · R 3.8 — 버린 설정 (각 500회, seed 0)

> 2026-10-01 같은 날 R 3.8 은 버렸다(로그 48 [D48-60]). v2 는 5칩 · R 2.0 — 같은 5칩 LOCO 포함률 68% 72% · 95% 98% · 폭/MAP 90분위 2.80.

| 조건 | 10% | 20% | 30% | 40% | 50% | 60% | 68% | 80% | 90% | 95% |
|---|---|---|---|---|---|---|---|---|---|---|
| 정체 칩 포함 · 기본 · prep 5회 | 12 | 22 | 32 | 44 | 53 | 63 | 71 | 84 | 94 | 97 |
| 정체 칩 포함 · 기본 · prep 1회 | 12 | 20 | 30 | 40 | 50 | 59 | 68 | 80 | 92 | 97 |
| 정체 칩 포함 · prep 독립 · prep 5회 | 12 | 24 | 34 | 42 | 53 | 62 | 68 | 79 | 91 | 95 |
| 정체 칩 뺌 · 기본 · prep 5회 | 12 | 21 | 29 | 39 | 49 | 58 | 63 | 74 | 86 | 91 |
| 정체 칩 뺌 · 기본 · prep 1회 | 13 | 20 | 27 | 35 | 44 | 52 | 60 | 73 | 83 | 89 |
| 정체 칩 뺌 · prep 독립 · prep 5회 | 9 | 17 | 27 | 32 | 40 | 49 | 56 | 68 | 80 | 84 |

같은 실데이터 LOCO(관측 p50, 58점): 68% 81% · 95% 98% · 68% 폭 중앙값 52,500. 폭/MAP 90분위 5.99(전체 58점), MAP 1만 이상 44점만 3.24.
4칩·R 2.0 의 같은 값은 2.00(전체 46점) · 1.52.

## 4b. v2 설정 (판정용) — 교정 5칩 · R 2.0 (각 500회, seed 0)

| 조건 | 10% | 20% | 30% | 40% | 50% | 60% | 68% | 80% | 90% | 95% |
|---|---|---|---|---|---|---|---|---|---|---|
| 정체 칩 포함 · 기본 · prep 5회 | 14 | 26 | 36 | 46 | 57 | 67 | 76 | 87 | 96 | 99 |
| 정체 칩 포함 · 기본 · prep 1회 | 13 | 27 | 38 | 46 | 55 | 67 | 77 | 88 | 95 | 99 |
| 정체 칩 포함 · prep 독립 · prep 5회 | 11 | 21 | 32 | 42 | 51 | 61 | 69 | 78 | 88 | 94 |
| 정체 칩 뺌 · 기본 · prep 5회 | 9 | 18 | 26 | 37 | 46 | 57 | 66 | 75 | 84 | 91 |
| 정체 칩 뺌 · 기본 · prep 1회 | 10 | 19 | 29 | 38 | 48 | 59 | 68 | 78 | 85 | 90 |
| 정체 칩 뺌 · prep 독립 · prep 5회 | 10 | 16 | 24 | 32 | 38 | 47 | 53 | 65 | 76 | 81 |

같은 설정의 실데이터 LOCO(58점)는 68% 72% · 95% 98%. 합성에서는 처음 보는 칩의 95% 구간이 91% 를 품어 명목보다 조금 낮다 — 생성이 r 을
[1/2, 2] 전 범위에서 뽑아 곡선 끝(100k 너머) 경계에 닿는 경우가 섞인다.

## 5. 재현

```bash
uv run python host/analysis/wear_inverse.py --synthetic 500 --plot docs/results/plots/synthetic_recovery_2026-10.png   # §1 표 + 그림
uv run python host/analysis/wear_inverse.py --synthetic 500 --seed 1                                                   # §2 의 seed 1
uv run python host/analysis/wear_inverse.py --rate-rule                                                                # R 의 규칙 계산 (§4 의 R)
```
