young-0320/flash-margin-bench/docs/results/captures/jedec_chip01_20260708.png

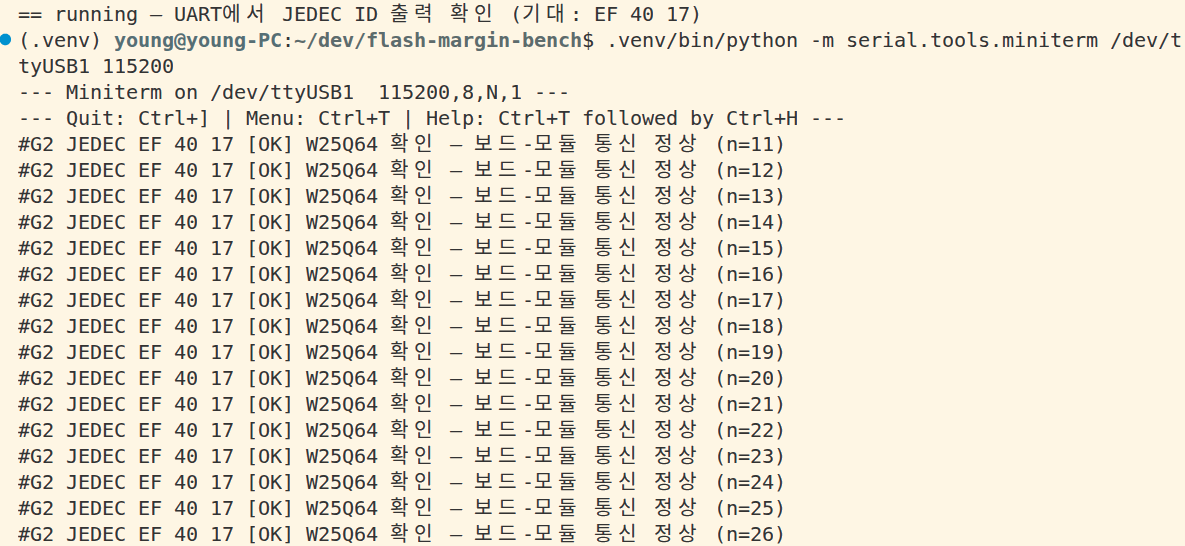
docs/results/captures/jedec_chip01_20260708.png
