young-0320/flash-margin-bench/docs/results/captures/jedec_nomodule_20260708.png

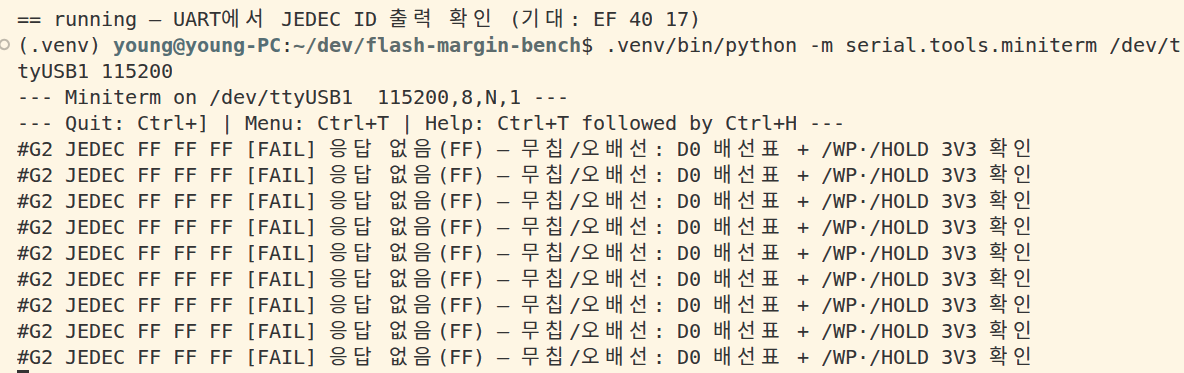
docs/results/captures/jedec_nomodule_20260708.png
