young-0320/flash-margin-bench/docs/results/captures/prep_pass_20260709.png

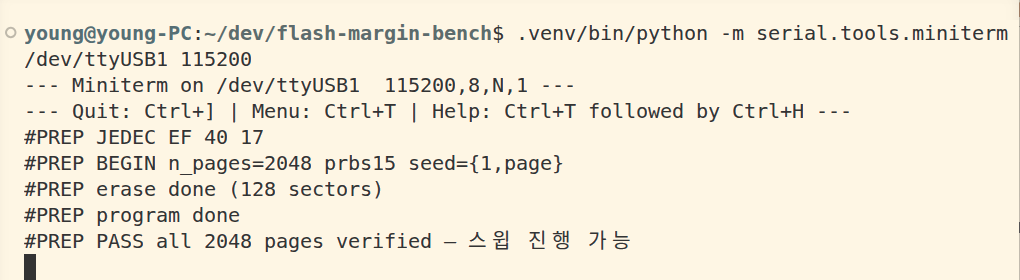
docs/results/captures/prep_pass_20260709.png
