young-0320/flash-margin-bench/docs/results/plots/baseline_compare_binary_2026-10.png

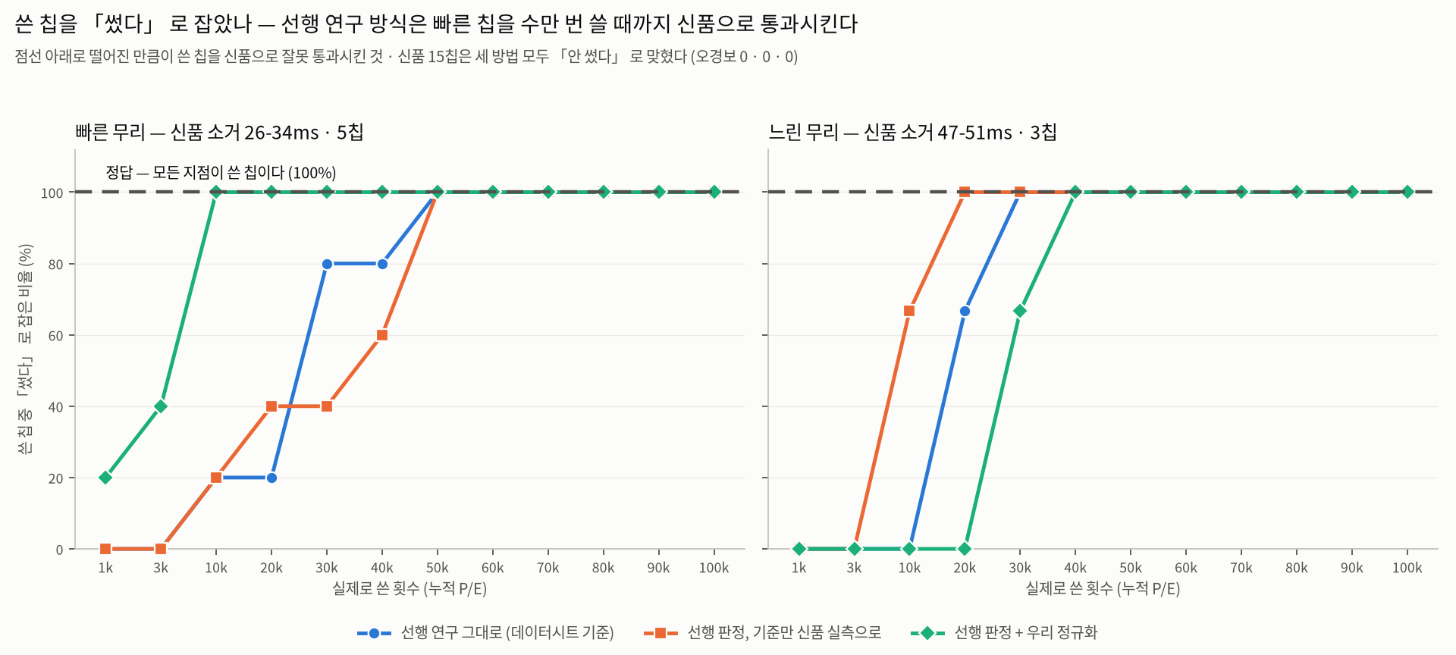
docs/results/plots/baseline_compare_binary_2026-10.png
