young-0320/flash-margin-bench/docs/results/plots/bathtub/v1/bathtub_sweep_chip01_D1654CB09B352233_20260926T070639Z.png

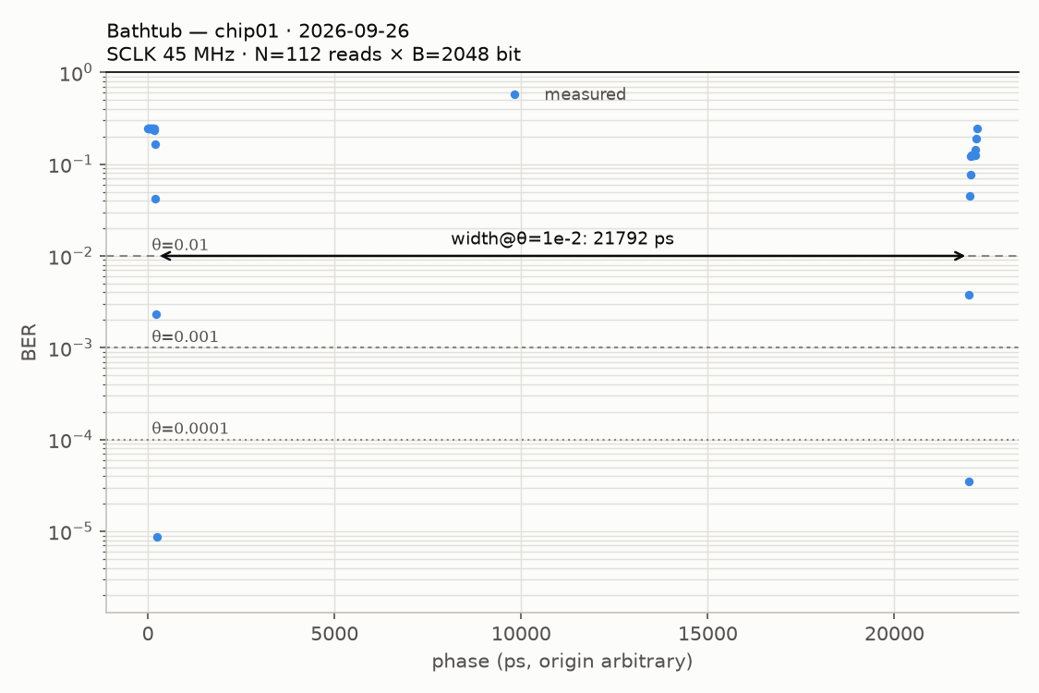
docs/results/plots/bathtub/v1/bathtub_sweep_chip01_D1654CB09B352233_20260926T070639Z.png
