young-0320/flash-margin-bench/docs/results/plots/bathtub/v1/bathtub_sweep_chip02_D1642C74E7134527_20260915T152201Z.png

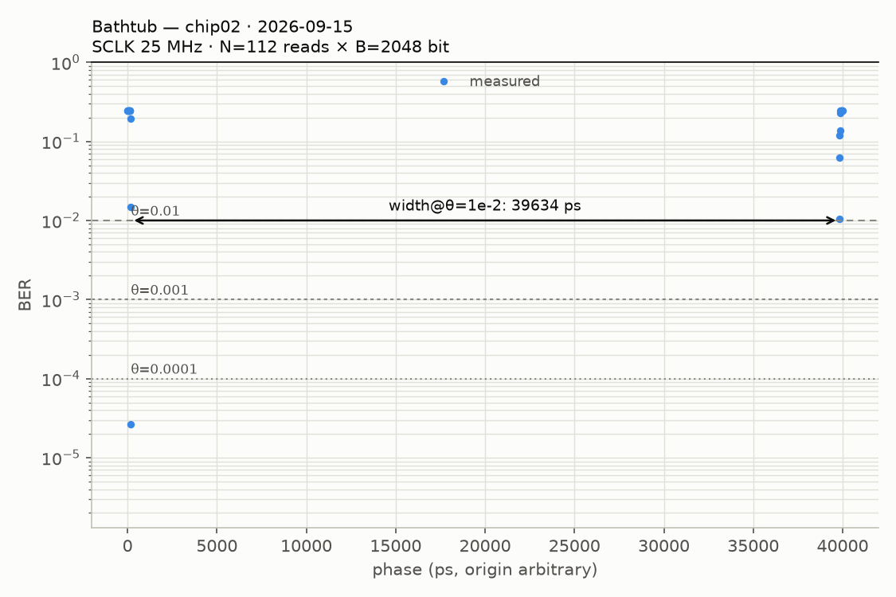
docs/results/plots/bathtub/v1/bathtub_sweep_chip02_D1642C74E7134527_20260915T152201Z.png
