young-0320/flash-margin-bench/docs/results/plots/blind_temp_chip23_chip26_2026-11.png

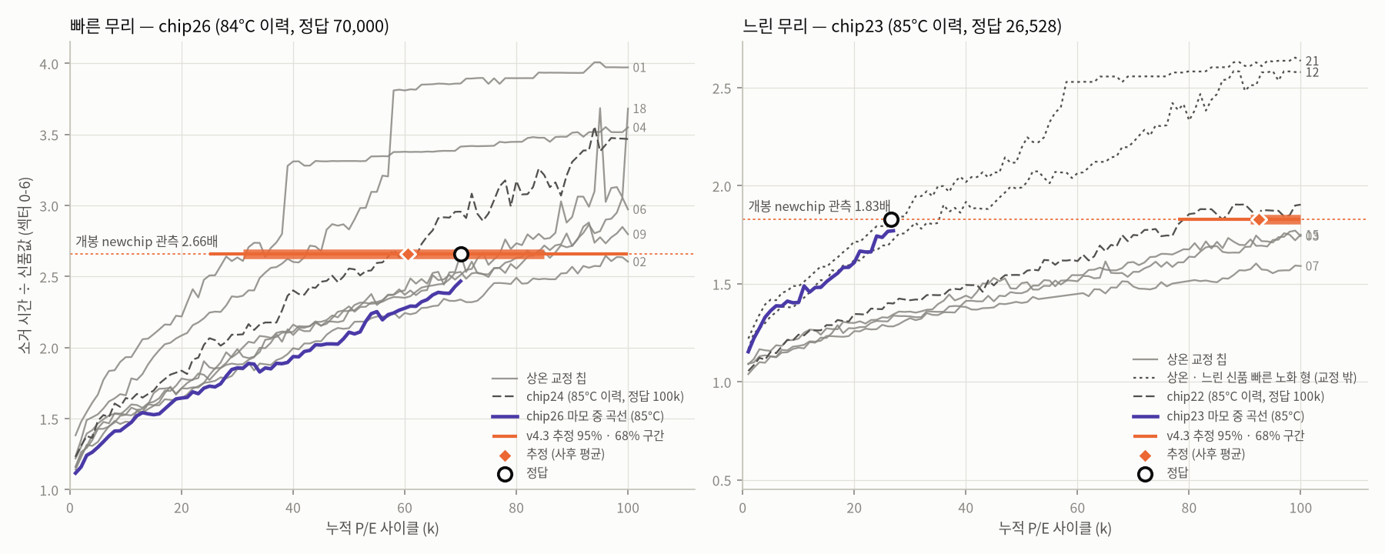
docs/results/plots/blind_temp_chip23_chip26_2026-11.png
