young-0320/flash-margin-bench/docs/results/plots/monte_carlo_n112_20260823.png

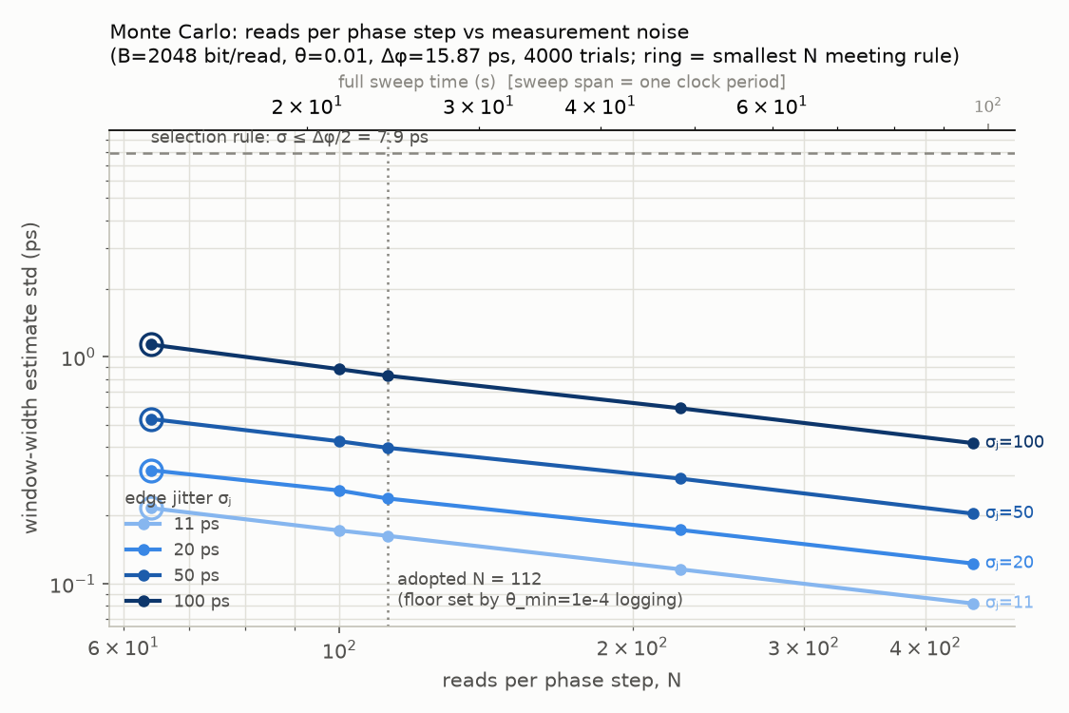
docs/results/plots/monte_carlo_n112_20260823.png
