young-0320/flash-margin-bench/docs/results/plots/synthetic_recovery_v4_1_2026-10.png

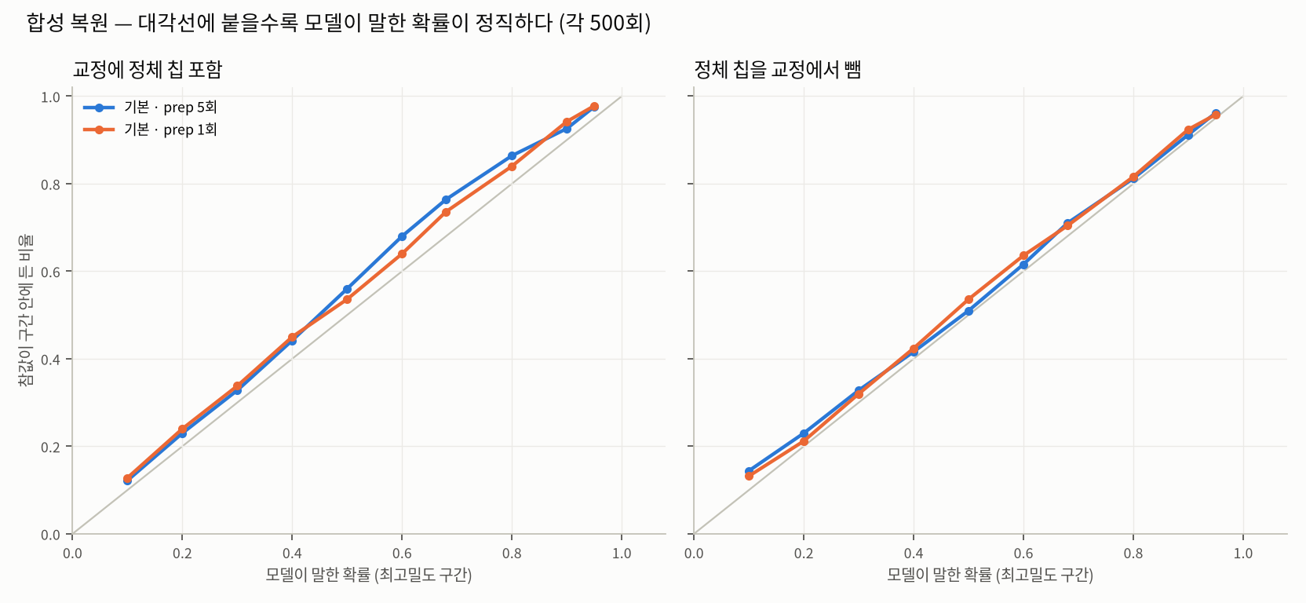
docs/results/plots/synthetic_recovery_v4_1_2026-10.png
