young-0320/flash-margin-bench/docs/results/plots/synthetic_recovery_v4_3_support200k_2026-10.png

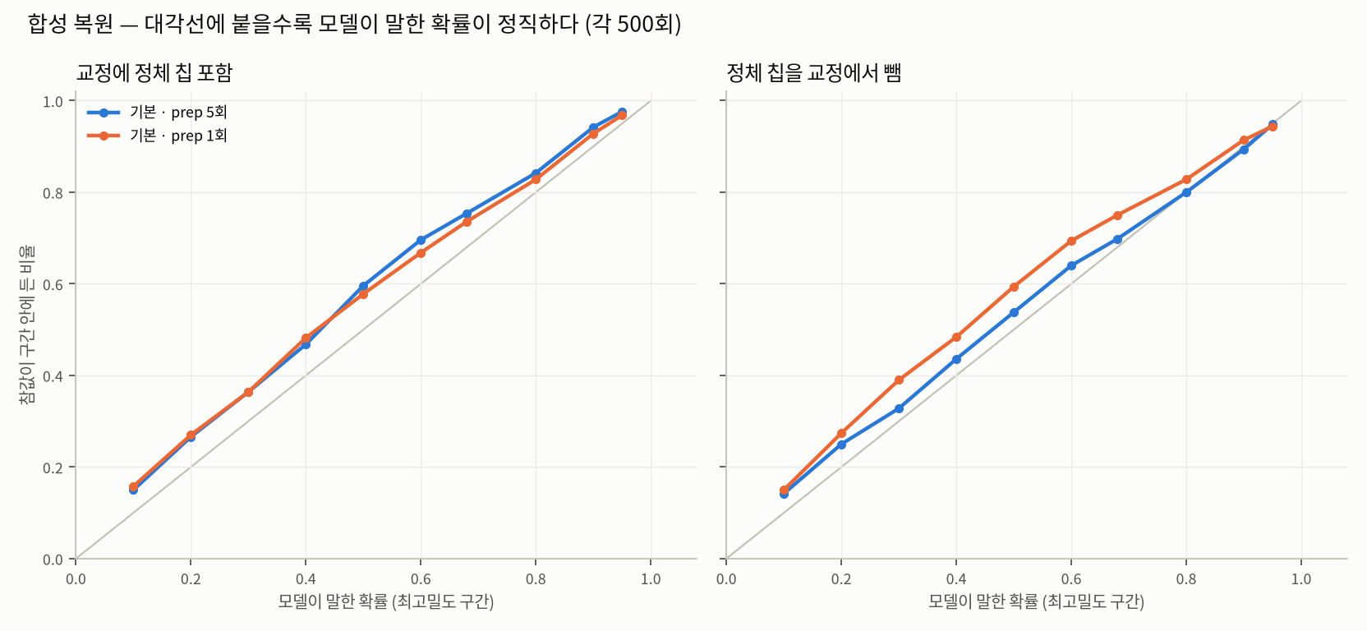
docs/results/plots/synthetic_recovery_v4_3_support200k_2026-10.png
