young-0320/flash-margin-bench/docs/results/plots/temp_chip16_timeline_2026-10.png

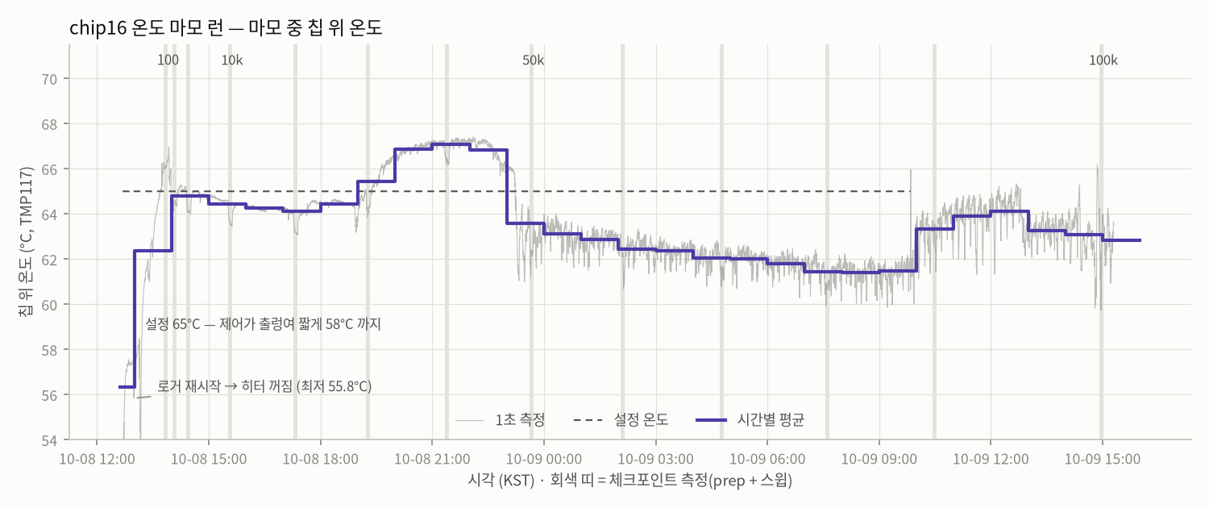
docs/results/plots/temp_chip16_timeline_2026-10.png
