young-0320/flash-margin-bench/docs/results/plots/wear/wear_curves_2026-09.png

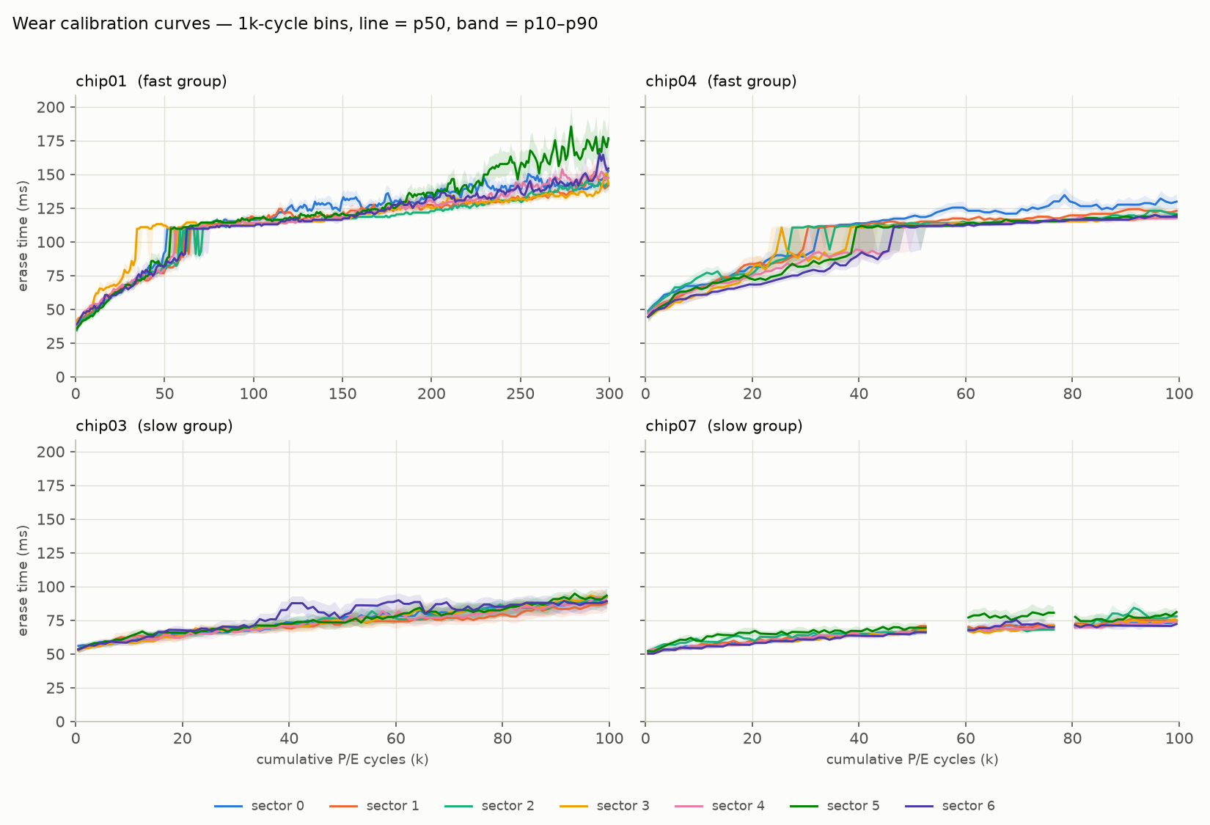
docs/results/plots/wear/wear_curves_2026-09.png
