young-0320/flash-margin-bench/docs/results/plots/wear/wear_curves_chip03_2026-10.png

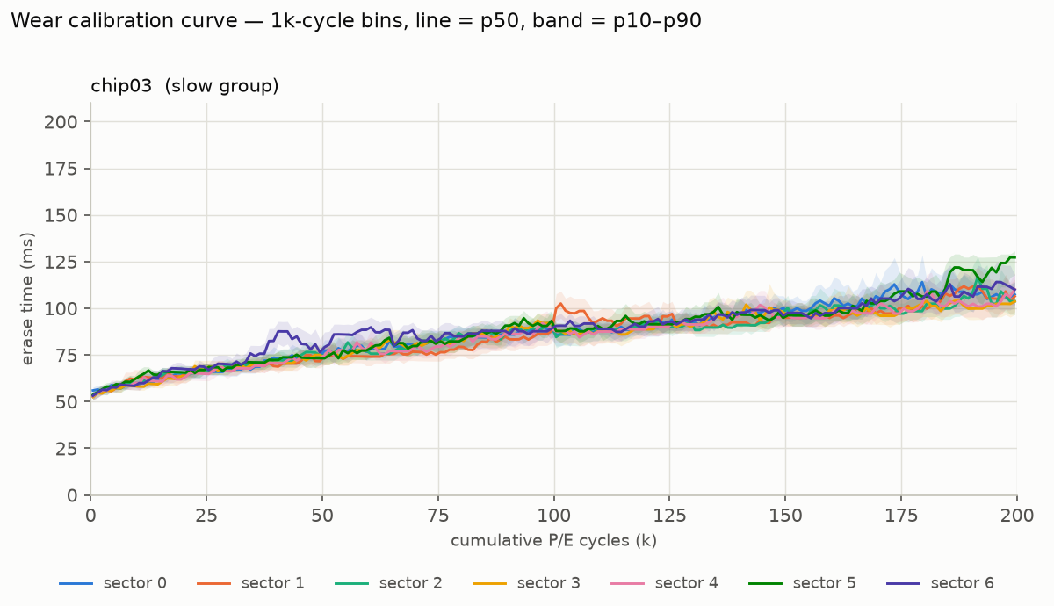
docs/results/plots/wear/wear_curves_chip03_2026-10.png
