young-0320/flash-margin-bench/docs/results/plots/wear/wear_temp_chip24_2026-10.png

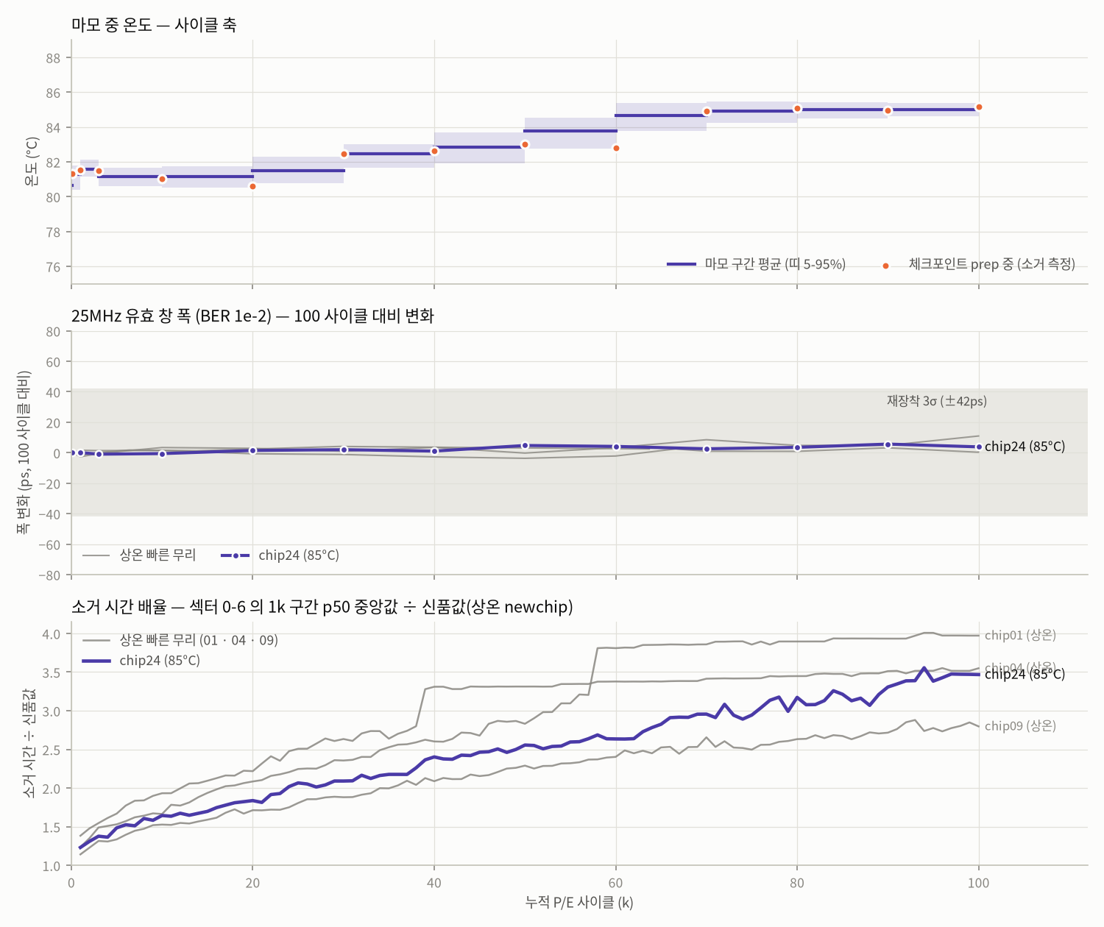
docs/results/plots/wear/wear_temp_chip24_2026-10.png
