young-0320/flash-margin-bench/docs/results/plots/wear_checkpoint_width_program_2026-10.png

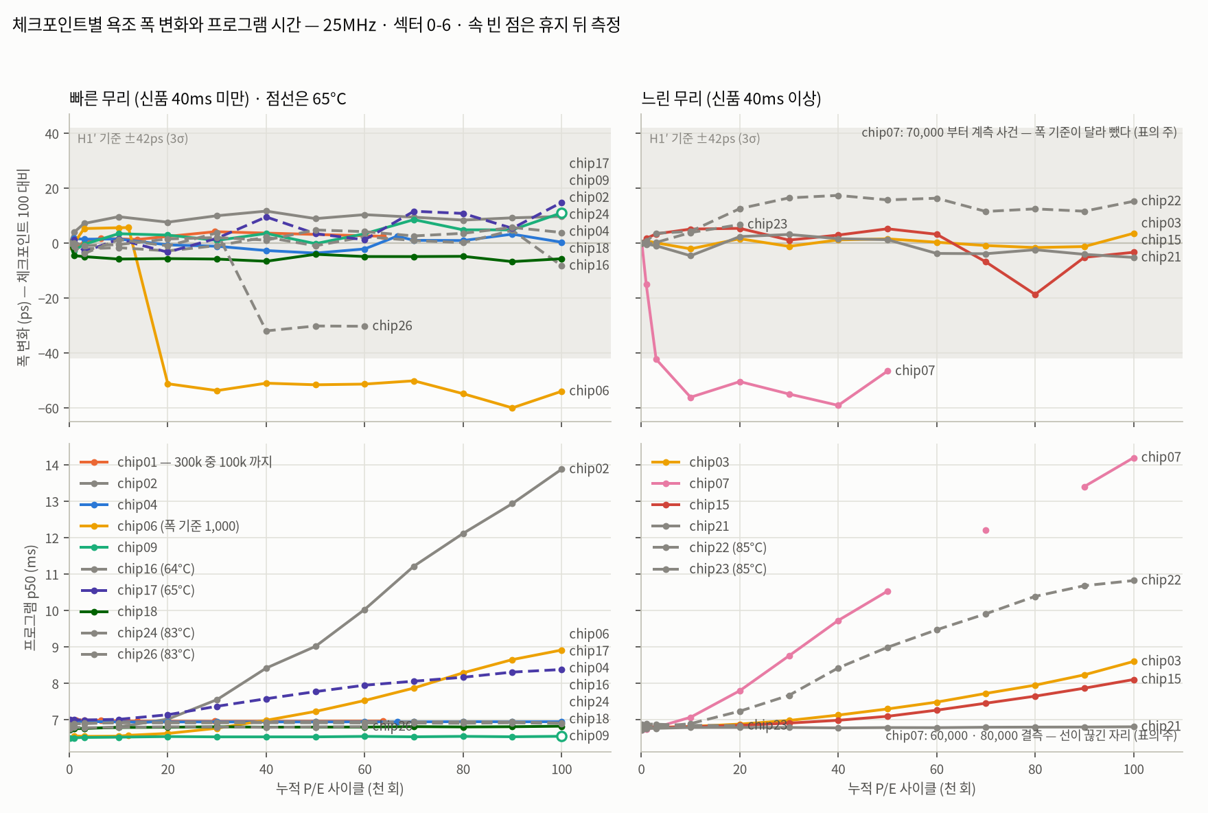
docs/results/plots/wear_checkpoint_width_program_2026-10.png
