young-0320/flash-margin-bench/docs/results/plots/wear_curves_chip01_2026-09.png

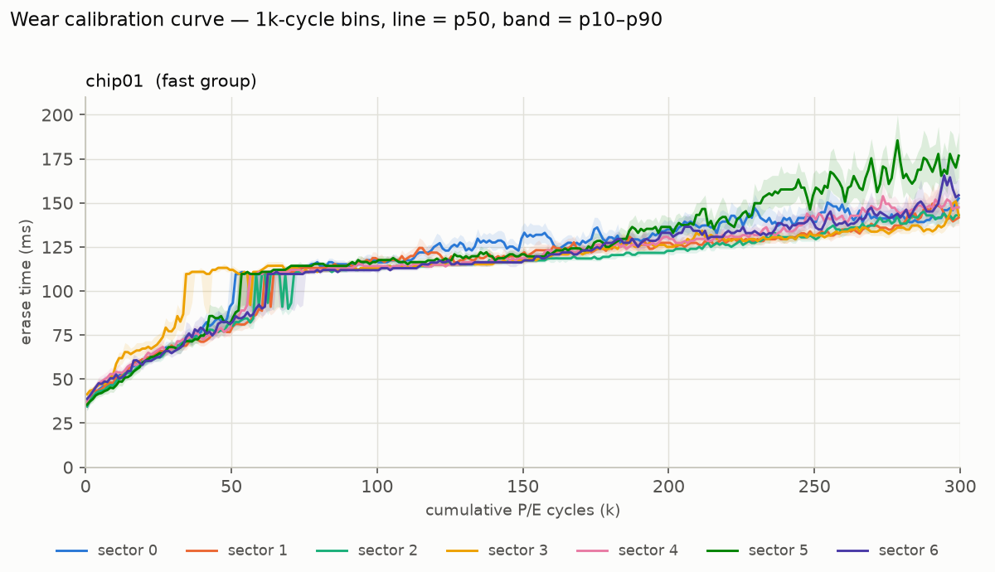
docs/results/plots/wear_curves_chip01_2026-09.png
