young-0320/flash-margin-bench/docs/results/plots/wear_curves_chip02_2026-10.png

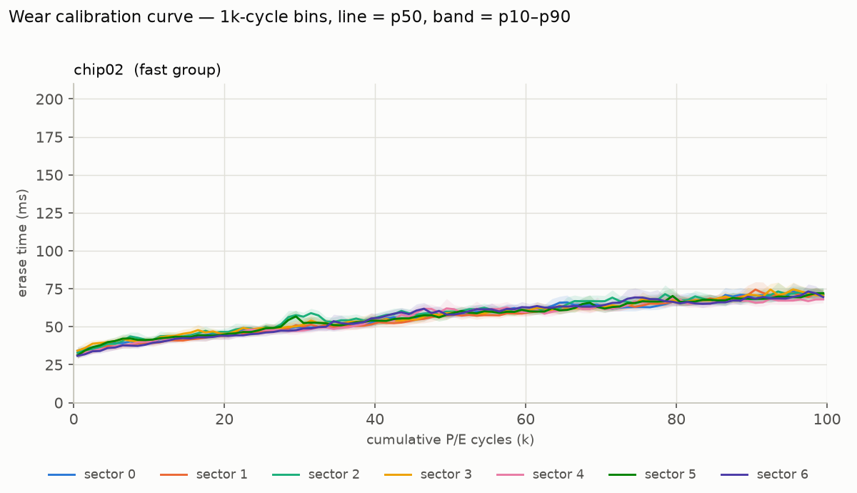
docs/results/plots/wear_curves_chip02_2026-10.png
