young-0320/flash-margin-bench/docs/log/young/13.first_loopback_bathtub_and_linedead_fix.md

# 13. 첫 루프백 욕조 곡선 (valid=1) + line_dead 자가진단 오발 수정

- **작성일**: 2026-07-08 (런북 C 실행)
- **발단**: 런북 3 트랙 C 를 돌려 첫 유효 루프백 스윕을 받았는데, 그 전에 세은 노트북
  원격 실행이 실패했고 스윕 자체도 940스텝에서 자가진단에 걸려 중단됐다
- **목적**: 첫 곡선이 나왔는데 θ 를 확정할 수 있나? 자가진단은 왜 정상 스윕을 죽였나?
- **관련**: `ps/src/g0_sweep.c` · `docs/results/data/sweep_loopback_20260708T131310Z.md` ·
  `docs/workflow/3.realchip_day_runbook.md` · [로그 12](12.realchip_prep_batch.md)

## 결정

- [D13-1] `line_dead` 자가진단에 `!low_seen` 게이트를 단다 — 저에러 스텝을 한 번이라도 본
  스윕은 오발에서 면제 — §1 · `ps/src/g0_sweep.c`
- [D13-2] 원격 실행(세은 노트북)은 철수하고 리눅스에서 돌린다. 다만 `program_g0.tcl` 은
  원격 hw_server 인자를 받게 남긴다 — §2 · `ps/scripts/program_g0.tcl`
- [D13-3] θ 확정 체크리스트는 5항 중 ①(probit 직선성)만 FAIL — θ 확정을 보류한다 — §3

## 근거

### 1. 자가진단의 가정이 저노이즈 결정론 채널에서 깨졌다

940스텝 무에러 뒤 벽에 진입하던 중 스텝 952 = 953 의 100읽기 에러 벡터가 비트 단위로
동일해 진단이 발동했고 스윕이 중단됐다.

자가진단의 가정은 "창 밖 = 노이즈라 연속 스텝이 동일할 수 없다"였다. 루프백 같은 저노이즈
결정론 채널의 **벽 평탄부** 에서는 이 가정이 깨진다 — 엣지가 다음 Δφ 안에 없으면 틀리는
비트 집합이 불변이다.

`err_reads==N && !low_seen` 게이트로 닫았다. 죽은 라인은 저에러 스텝을 낼 수 없으므로
원 목적은 보존된다 — 설계 의도였던 "스텝 2에서 중단"도 `low_seen=0` 구간이다. 벽에 도달한
정상 스윕만 오발에서 면제된다.

### 2. 문제 두 개가 겹치면 하나를 고쳐도 증상이 남는다

세은 노트북(Windows + Vivado 2025.2)에서 xsdb 프로그래밍은 성공했으나(DONE 점등) 캡처가
BEGIN 을 못 들었다. 유력 원인은 FT2232 듀얼 채널(A=JTAG, B=UART)이 Windows 에서 구분 없이
COM 으로 잡혀 JTAG 채널을 청취한 것이다 — 다른 COM 을 시도하지 않고 철수해 미확정으로
남는다. 리눅스는 UART 만 `ttyUSB1` 로 바인딩되어 모호성이 없다.

여기에 **점퍼 접촉 불량이 중첩** 돼 있었다. 귀가 후 첫 실행이 timeout 으로 난 것이 그
증거다. 문제가 둘이면 하나를 고쳐도 증상이 남아 "재현성 문제"로 오인된다 — 측정 시스템
자체는 양쪽에서 동일하게 동작했다.

> **2026-09-17 — 이 로그에 있던 「Windows 에서 재현하는 법」 절을 삭제했다
> ([로그 39](39.log_convention_enforcement.md)).** `reproduce.py` 가 대체했고
> ([로그 32](32.reproduce_script.md) · [33](33.reproduce_windows_support.md)), COM 판별은
> `docs/workflow/3.realchip_day_runbook.md` 판독표 E 에 행이 있다. 사람은 날짜를 보고
> 걸렀지만 AI 는 검색으로 그 절을 찾아 **그대로 실행한다** —
> [로그 38](38.log_format_convention.md) §1 이 그 절을 「나간다」로 판정한 자리다.

### 3. 체크리스트 — 넷은 통과, probit 직선성만 FAIL

- ② BER floor (상한 3.7e-9) PASS
- ③ σⱼ 29.1·29.2ps — MC 재실행 N=100 재확인 PASS (σ_width 0.30ps @θ=10⁻² ≪ 기준 7.5ps,
  최저 θ=10⁻⁴ 에서도 2.0ps)
- ④ 과분산 F=0.48 PASS
- ⑤ 프레이밍 슬립 없음 PASS
- ① probit 직선성 **FAIL** — 좌 0.993 / 우 0.9742 (기준 0.98)

곡선 자체는 valid=1 완주에 폭 34,693ps @θ=10⁻²(UI 40ns), 양벽 σⱼ 대칭이다. 그런데 사전
등록한 기준([로그 10](10.realchip_sweep_decisions.md) [D10-1])은 4항 통과를 요구하므로,
하나라도 FAIL 이면 θ 는 확정되지 않는다. 기준을 나중에 무르는 것이 사전등록을 깨는 일이다.

## 산출물

| # | 산출물 | 위치 |
| - | --- | ---- |
| 1 | 첫 유효 루프백 스윕 (요약본·유래) | `docs/results/data/sweep/sweep_loopback_20260708T131310Z.{csv,md}` |
| 2 | 루프백 욕조 곡선 | `docs/results/plots/bathtub/v1/bathtub_sweep_loopback_20260708T131310Z.png` |
| 3 | Windows COM 모호성 (판독표 E 행 추가) | `docs/workflow/3.realchip_day_runbook.md` |

## 미결

- **[U13-1] θ=10⁻² 확정 보류** — 체크리스트 ① 우벽 probit FAIL. 원인 가설은 [D13-1] 과
  같은 뿌리인 **벽의 결정론적 평탄부**(BER~0.1대 선반)가 가우시안 erfc 모델을 위반한다는
  것이다. 선택지는 (a) 피팅 범위 규칙 조정(BER 상한 제한 — 사전등록 규칙 변경이라 MC
  주석·보고서 문구 동시 갱신) / (b) 보류 상태로 실칩 진행(θ 잠정 유지) / (c) 재측정.
  **3인 논의 필요.**

  > **2026-09-17 — 닫혔다 ([로그 15](15.g3_25mhz_wall_too_narrow.md)).** 벽 천이가 Δφ 보다
  > 가팔라 probit 대역 표본이 두 클럭 모두 3점뿐이고, 체크1 은 구조적으로 SKIP 이라는
  > 결론이다. 두 달간 표시가 없어 열린 안건으로 읽혔다.
- **[U13-2] `line_dead` 무효 사유의 계약 §6 정식화** ([U12-1] 승계) — 논의 시 `!low_seen`
  으로 의미가 바뀐 것을 박지민에게 공유해야 한다 (검증 분담 [D10-6] 관련)

  > **2026-09-18 — 닫혔다. 계약 §6 에 ⑦ `line_dead_*` · ⑧ `no_window` 로 올렸다**
  > (`docs/interface/contract.md` §6, 한영웅 단독 판단). **현상만 올리고 판정 로직은
  > 구현에 남겼다** — §6 은 원래 현상만 정하고 검출 방법은 구현에 맡기는 절이라
  > (⑤ 가 그렇다), 로직을 고치는 데 계약 변경이 필요하지 않다.
- **[U13-3] C8 게재 승격** — θ 확정 후로 보류

  > **2026-07-08 — 승격됐다 (커밋 `d108558`).** θ 확정을 기다리지 않고 루프백 곡선과 요약
  > CSV 가 올라갔다. 승격처가 `docs/reports/` 에서 `docs/results/` 로 바뀐 것도 같은 커밋이다.
