young-0320/flash-margin-bench/docs/log/young/43.newchip_survey_anchor_failure.md

# 43. 앵커가 고장난 채로 전수 측정을 끝냈다 — 판정은 대조군이 구했다

- **작성일**: 2026-09-20
- **발단**: 9/20 아침에 chip07\~10 을 연달아 재고 전수 측정의 측정분을 닫았다. 네 런 모두
  `#PREP PASS` · `valid=1 reason=complete` 로 흠이 없는데, **마지막에 넣은 앵커 chip02 가
  기준값에서 −302.8ps 나가 있었다.** 판정선은 ±14ps 다
- **목적**: 유효한 런 여덟 개를 손에 쥐고도 개체 산포를 말할 수 없는 이유는 무엇이고, 그 값들을
  어디까지 채택하나?
- **관련**: `docs/spec/s2.newchip_protocol.md` §2·§6·§8 · `docs/results/data/newchip_survey_2026-09.md`
  §6·§7 · `docs/workflow/10.newchip_survey_completion.md` G ·
  [로그 28](28.realchip_day_chip02_chip03.md) · [로그 30](30.flash_prep_newchip_survey.md) ·
  [로그 36](36.flash_id_and_sweep_uid_check.md) §2-10

## 결정

- [D43-1] **이상치 판정을 강행하지 않고 보류한다** — 앵커가 이탈한 세션의 산포는 개체 산포가
  아닐 수 있다 — §1
- [D43-2] **9/20 의 네 런을 무효 처리하지 않는다.** 무효 사유(S-2 §6.1)에 해당하는 것이 하나도
  없다. 보류되는 것은 런이 아니라 **귀속**이다 — §2
- [D43-3] **지표별로 가른다 — 소거 시간·blank 는 채택, width 만 보류한다** — §3
- [D43-4] **`n = 9` 확정을 지금 하지 않는다.** chip05 는 4 회차도 같은 서명이지만, 분모를
  정해도 판정을 못 하므로 순서상 앵커 뒤다 — §4
- [D43-5] **chip10 의 UID 를 의심 표기하지 않고 재독으로 확인한다** — 등록부에 확인 예정만
  적는다 — §5 · `docs/chip_registry.md`
- [D43-6] **σ_repeat 를 얻고도 §6.3 분기를 닫지 않는다.** 분자를 무엇으로 잡느냐로 판정이
  뒤집히고, **오염이 의심되는 쪽을 넣어야 통과가 나온다** — §7
- [D43-7] **§6.3 의 처방(전 칩 3회 재측정)을 집행하지 않고 접촉 원인 분리를 먼저 한다** —
  산포가 측정계가 아니라 chip02 한 개체에서 나올 가능성이 있다 — §8
- [D43-8] **σ_repeat 의 정본은 13.86ps(chip10 n=3)다.** chip02 의 137.33ps 는 노이즈 플로어가
  아니라 그 조립체의 고장 신호다 — §9
- [D43-10] **§6.2 의 재현 기준을 `3ps` → `3 × σ_repeat` 로 개정한다.** 3ps 는 재장착이 없는
  0.61ps 에서 빌려온 값이고 그 전제가 실측으로 반증됐다. **수를 박지 않고 세션마다 다시 낸다** —
  σ_repeat 은 조립체가 몇 번 꽂혔느냐에 따라 커진다 — §11 · `docs/spec/s2.newchip_protocol.md` §6.2
- [D43-11] **M 트랙을 조건부 종료한다** — chip10 은 개체 특성으로 채택, §6.3 은 분해, A1\~A4 는
  A1 만 조건부(chip01 수치 미회수). 분모는 `n = 9` — §11 · `docs/results/data/newchip_survey_2026-09.md` §8
- [D43-9] **칩별 배선 구성을 S-2 §3.3 에 명문화한다.** 사양서가 배선 한 벌을 전제하고 있어
  "재장착 σ" 가 무엇의 산포인지 문서만 봐서는 알 수 없었다 — §10 · `docs/spec/s2.newchip_protocol.md`

## 근거

### 1. 앵커는 판정의 부속이 아니라 전제다

이탈 폭이 판정선의 21배다. 9/16 에 관측된 접촉 변동으로는 설명되지 않는다 — 정상 재장착이 6ps,
접촉 실패 뒤 재장착이 53ps 였다([로그 36](36.flash_id_and_sweep_uid_check.md) §2-10). 300ps 는
다른 크기의 사건이다.

**소스 차이는 배제됐다.** chip06 의 `727a7be` 부터 오늘의 `02c78d0` 까지 `fpga/`·`ps/` 커밋이
0 건이고, 측정 파라미터도 CSV 헤더에서 전 칩 동일하다. 남는 후보는 온도·배선과 핀헤더 접점·전원,
그리고 비트스트림을 다시 빌드했다면 배치 차이다.

> **2026-09-20 — 이 절의 진단이 틀렸다 (§9).** *"측정계가 이동했다"* 로 읽었으나, 같은 세션의
> chip10 3 점이 27ps 안에 있었다. 이동한 것은 측정계가 아니라 **chip02 조립체 하나**다.
> 아래 두 「탈락시킨 안」의 판단(강행하지 않는다 · 무효로 돌리지 않는다)은 그대로 유효하고,
> **원인 귀속만 뒤집혔다.** 이 절만 읽고 "9/20 세션은 오염됐다"로 가져가면 안 된다.

탈락시킨 안 둘:

- **그냥 로버스트 판정을 돌린다** — n=8 로 계산하면 chip10 하나만 3σ 밖으로 떨어져 그림이
  깔끔해진다. 그런데 그 깔끔함이 가짜다. **MAD 가 오늘 값들로 부풀어 기준이 스스로 느슨해졌다**
  — 9/15\~16 의 4 칩만으로 낸 로버스트 σ 는 42.8ps 인데 지금은 220.5ps 다. 옛 기준으로는 세 칩이
  후보이고, 그러면 S-2 §6.2 의 "후보 3 개 이상이면 절차·장비를 의심하고 중단" 조항에 걸린다.
  **어느 기준이 옳은지가 곧 앵커 문제**이므로 앵커를 건너뛴 판정은 자기 참조다
- **오늘 4 칩을 무효로 돌리고 다시 잰다** — 빠르지만 근거가 없다. §2

사후 해석 금지(S-2 §6)의 실제 얼굴이 이것이다. 규칙은 데이터를 보기 전에 등록돼 있었고, 오늘
그 규칙이 "멈춰라"라고 말한다. 여기서 규칙을 고치면 규칙을 미리 등록한 의미가 사라진다.

### 2. 유효한 런과 해석 가능한 런은 다르다

무효 처리는 S-2 §6.1 의 사전 등록 목록으로만 한다 — 타임아웃·CFG_ERR·MMCM 언락·R8 불일치·
미완주·CMD_ERR, 그리고 JEDEC 불일치·prep 검증 실패·전 위상 BER≈0.5. 오늘 네 런은 어느 것도
아니다. 파일을 `_invalid` 로 돌리면 **"측정이 깨졌다"와 "측정은 됐는데 원인이 안 갈린다"가 같은
표기를 받는다.** 나중에 세는 쪽이 둘을 구분할 방법이 없어진다.

그래서 집계표에서 9/20 행의 width 만 기울임으로 두고 사유를 적었다. **값을 지우는 대신 값의
지위를 적는 쪽**이며, `chip_pe.md` 의 `미상(≥1)` 과 같은 태도다.

### 3. 두 지표가 같은 경로를 타지 않는다

width 는 PL 스윕 경로의 타이밍에서 나오고, 소거 시간과 blank 는 PS 가 SPI 로 칩에서 직접 받는
값이다. 앵커가 흔들렸다는 것은 **전자의 경로가 의심된다**는 뜻이지 후자까지 의심된다는 뜻이
아니다. 소거 시간은 칩 내부가 스스로 소비한 시간이고 blank 는 읽어 온 내용이다.

그래서 9/20 네 칩의 소거 median·min·max 와 `blank_pre = 0` 은 그대로 채택한다. 신품에서만
얻히는 값이라 보류할수록 잃을 위험이 크다는 점도 같은 방향이다 — 마모가 한 번 들어가면 `pre` 는
영원히 못 잰다([로그 30](30.flash_prep_newchip_survey.md) §2).

### 4. 분모를 정해도 판정이 안 된다

chip05 는 9/16 에 3 회, 9/20 에 1 회, 누적 4 회 전부 `FF FF FF` 다. `n = 9` 로 굳히는 쪽이
자연스럽지만 그 결정이 지금 사는 자리가 없다 — 분모는 이상치 판정과 로버스트 σ 에 쓰이는데
그 판정 자체가 §1 로 멈춰 있다. **먼저 정해도 되는 것과 먼저 정해야 하는 것은 다르다.**

### 5. UID 앞바이트 하나로 등록부를 흔들지 않는다

chip10 의 UID 는 `DF68…` 이고 나머지 아홉은 전부 `D1 6x…` 다. 다만 같은 세션에서 JEDEC 은
`EF 40 17` 로 정상이었고 스윕도 완주했다 — 접촉 불량의 서명이 없다. 로트가 다를 수도 있다.

등록부에 물음표를 달면 그 표기가 혼자 오래 살아남는다. UID 는 불변이고 그 칩을 다시 꽂을 때마다
공짜로 다시 읽히므로, **확인 수단이 이미 절차 안에 있다.** 마침 width 이상치 후보도 같은 칩이라
재측정이 예정돼 있다.

부수적으로 드러난 것: CSV 의 `reseat` 열이 전 런 `0` 이다. 재장착 여부가 데이터에 남지 않고
사람 기억에만 있는데, 그 열이 바로 §6.3 분모의 정의다. [로그 36](36.flash_id_and_sweep_uid_check.md)
`[U36-2]` 가 "재장착을 안 했다는 못 잡는다"로 지적한 구멍이 **기록 층에서도 비어 있었다**는 확인이다.

### 6. 앵커 배치 실패가 판정을 막았다

워크플로 10 의 미결 #2 가 "chip07\~10 세션에서 처음부터 ②③④ 를 배치하는 쪽"이라고 미리
적어 두었는데, 실제로는 아홉 칩을 다 재고 **끝에 한 번**만 넣었다. 그 결과 둘을 잃었다 —
자유도 2 의 σ_repeat 를 못 얻었고, 처음·중간·끝이 없어 **단조 이동(발열·소켓 마모)인지 튐인지**
가릴 수도 없다.

지금 아는 것 하나: 오늘 네 칩이 앵커를 사이에 두고 양쪽으로 퍼져 있다. 세션 전체가 통째로 밀린
것이라면 한쪽으로 몰려야 하는데 그렇지 않다. **세션 이동과 산포 확대가 함께 일어났거나 칩마다
접촉 상태가 달랐다**는 뜻이고, 앵커 하나로는 더 못 나간다.

### 7. 재장착 3회 — 노이즈 플로어는 얻었고, 그 값이 판정을 못 닫는다

07:37\~07:41 에 chip02 를 재장착하며 세 번 쟀다(prep 없음, `#G2 UID` 로 매번 개체 확인).
σ_repeat = **40.25ps** 로 이 프로젝트의 첫 재장착 노이즈 플로어가 나왔다. 세션 간 σ 4.65ps 의
8.7 배이며, 재장착이 지배적 성분이라는 실측이다.

같은 데이터가 **G-a 불통과를 확정**시킨다. 세 번 다 −300ps 대이고 재장착으로 돌아오지 않는다 —
한 번의 접촉 사고라면 세 번 중 한 번은 기준 근처로 왔어야 한다. **이동 시점은 9/16 이후로
좁혀진다**: 9/16 16:10 의 chip02 가 기준에서 +3.5ps 였다.

분기가 닫히지 않는 이유는 분모가 아니라 분자다. `3 × σ_repeat = 120.7ps` 를 두고 σ_between 을
깨끗한 4 칩으로 잡으면 74.4 로 **불통과**(전 칩 3회 재측정)인데, 9/20 을 넣으면 449.2 로 통과한다.
**재측정을 면하려면 의심스러운 데이터를 채택해야 하는 구조**이고, 그 선택은 S-2 §6 이 금지한
사후 해석 그 자체다.

덧붙여 분모도 깨끗하지 않다 — 이탈한 세션에서 나온 값이라 드리프트가 섞여 있으면 부푼다. 다만
부푼 분모는 판정을 재측정 쪽으로 기울이므로 **틀리는 방향이 안전한 쪽**이다.

②③④ 가 단조 하강(39,327 → 39,308 → 39,250)한 것은 드리프트처럼 보이지만 **n=3 에서 단조가
우연일 확률은 1/6** 이다. 서명으로 쓰기에는 약하고, 점이 더 있어야 한다.

> **2026-09-20 — 점이 하나 더 붙어 뒤집혔다 (§8).** ⑤(07:45)가 39,561.66 으로 ④ 대비
> **+311.7ps** 올라왔다. 단조 하강은 없었고, σ_repeat 은 40.25 가 아니라 **137.33ps** 다.
> 위 문단의 "약한 증거"는 증거가 아니었던 것으로 판명됐다.

### 8. 노이즈 플로어는 측정계가 아니라 한 개체의 것일 수 있다

chip10 을 사이에 끼우고 chip02 를 다시 재자 ⑤ 가 −68.5ps 로 올라왔다. 네 점의 범위가 311.7ps 다.
같은 세션·같은 소켓에서 **chip10 은 2 회에 19.6ps 로 재현**되는데 chip02 만 이렇게 흔들린다.
소켓이나 장비의 성질이라면 두 칩이 같이 흔들려야 한다.

chip02 는 파일럿 겸 앵커라 **삽입 횟수가 가장 많은 개체**다. 리드 변형이나 접점 오염이라면
지금 그림과 맞는다. 그렇다면 σ_repeat 137ps 는 측정계의 노이즈 플로어가 아니라 **chip02 의
접촉 산포**이고, 그것을 분모로 쓴 §6.3 판정은 전부 무의미하다.

여기서 나오는 결과 하나: **S-2 §6.3 의 처방(전 칩 3 회 재측정, 27 런)을 지금 집행하지 않는다.**
그 처방은 노이즈가 측정계의 성질일 때 성립한다. 원인이 한 개체의 접촉이면 27 런을 태우고도
같은 자리로 돌아온다. 규정을 어기는 것이 아니라 **규정이 전제한 상황인지를 먼저 확인**하는 것이다.

### 9. 대조군 하나가 세 질문을 한 번에 닫았다

chip10 을 세 번 재장착해 쟀다 — 07:29 · 07:43 · 07:56, **σ = 13.86ps(범위 26.8)**. 같은 세션의
chip02 는 137.33ps(범위 311.7)다. 열 배다.

결정적인 것은 σ 자체가 아니라 **세 점이 놓인 자리**다. 07:29 부터 07:56 까지는 chip02 가
−380ps 를 찍던 구간을 포함한다. 그동안 chip10 은 27ps 안에 머물렀다. 한 조립체가 흔들리는
동안 다른 조립체가 가만히 있었다면 **공유부는 멀쩡하다.**

여기서 셋이 동시에 닫힌다:

- **세션 드리프트 가설 폐기** — §1 에서 "측정계가 통째로 밀렸다"고 본 것은 틀렸다
- **σ_repeat 정본 확보** — 13.86ps. 정상 조립체의 재장착 노이즈다
- **§6.3 분기** — `3σ = 41.6ps` 를 분모로 두면 σ_between 74.4 도 353.3 도 전부 위다.
  **집합에 따라 뒤집히던 문제(§7)가 사라진다.** 분모가 고장값이었던 것이 원인이었다

앵커 교체가 따라온다. 계측계를 감시하라고 세운 기준 개체가 **자기 자신의 열화를 보고 있었다**.

### 10. 배선이 칩마다 따로라는 사실이 문서에 없었다

이 프로젝트는 칩 10 개가 배선을 공유하지 않는다 — 칩마다 점퍼 6 가닥이 딸려 있고 그 끝의
핀헤더를 JB 에 꽂는다. **S-2 §4 는 "소켓 교체", 런북 3 은 "모듈 암수 점퍼 직결" 한 벌로
적혀 있어 공유 배선처럼 읽혔다.**

이 차이가 수치의 의미를 바꾼다. 재장착이란 칩을 소켓에 다시 앉히는 일이 아니라 **칩과 배선을
한 벌로 다시 꽂는 일**이고, 따라서 칩 간 차이는 전부 **칩 + 그 배선**의 차이다. §6 의 이상치
판정이 무엇의 이상치를 말하는지가 여기에 달려 있다.

같은 사실이 오늘의 진단도 설명한다 — 앵커 칩은 가장 자주 꽂았다 빼는 개체이므로 **그 배선의
핀헤더가 가장 먼저 상한다.** 앵커 역할 자체가 앵커를 망가뜨리는 구조다.

핀헤더라 배선을 뗄 수 있으므로 **칩과 배선은 교차로 가를 수 있다**(S-2 §8 말미). 그 전까지
"개체 산포"는 조립체 산포로 읽는다.

### 11. 판정은 규칙을 고친 뒤에야 규칙대로 돌아갔다

이상치 후보는 chip10 하나였고 재측정 두 번이 26.8ps 안에 재현됐다. 그런데 **사전 등록된 재현
기준 3ps 로는 "재현 실패"** 다 — 세 번 다 같은 값이 나온 칩을 버리라는 답이 나온다.

규칙을 고친 근거는 데이터가 아니라 **전제의 반증**이다. 3ps 는 chip01 을 빼지 않고 연속 5회 재서
얻은 0.61ps 에서 왔는데, §6.2 가 판정하는 절차는 빼고 다시 꽂아 재기다. 잰 것과 판정하는 것이
다른 양이었다. 이 구분이 서야 "데이터를 보고 기준을 바꿨다"와 갈린다 — 후자면 S-2 §6 이 금지한
사후 해석이다.

같은 실수를 반복하지 않기 위해 **수를 고정하지 않았다.** σ_repeat 은 그 조립체가 몇 번 꽂혔느냐에
따라 커지고(chip02 는 같은 날 같은 절차로 137.33ps), 정상 개체에서 세션마다 다시 내는 것이 맞다.
3ps 의 잘못은 값이 작았다는 것이 아니라 **한 조건에서 잰 값을 모든 조건의 상수로 박았다**는 것이다.

나머지는 사전 규칙이 그대로 돌았다 — 후보 1개(상한 2개 이내), 재현되었으므로 채택하고 빼지 않는다,
§6.3 은 `353.3 > 41.6` 으로 분해. **전 칩 3회 재측정(27 런)은 집행하지 않는다.**

남은 빚 둘을 판정문에 함께 적었다: 개체 산포가 아직 "칩 + 배선"이라는 것(§10), 그리고
07:16\~07:29 구간에는 반복 증인이 없어 안정성이 직접 관측이 아니라 정황이라는 것.

## 미결

- **[U43-1] σ_repeat 를 어떤 배치로 다시 얻을 것인가** — 전수 세션은 이미 끝났으므로 S-2 §8 의
  "세션 안에 끼운다"를 그대로 쓸 수 없다. 별도 세션에서 재장착 3 회를 잡으면 세션 간 성분이
  섞이고, 그러면 §6.3 의 분모가 노이즈를 과대평가한다. **어느 쪽을 감수할지가 결정 대상**이다

  > **2026-09-20 — 닫혔다. 전수 세션 직후(07:37\~07:41)에 이어서 재장착 3 회로 얻었다 (§7).**
  > σ_repeat = 40.25ps. 우려한 대로 이탈 세션의 값이라 드리프트가 섞여 있을 수 있는데, 그 오염은
  > 분모를 부풀려 판정을 재측정 쪽으로 기울이므로 감수하는 쪽으로 정했다. 남은 문제는 분모가
  > 아니라 분자이며 `[U43-5]` 로 옮긴다.
- **[U43-2] 분모 `n = 9`** — §4. chip05 를 한 번 더 시도할지, 4 회로 닫을지

  > **2026-09-20 — `n = 9` 로 닫았다 (§11).** 4 회차까지 같은 서명이고, 앵커 문제가 풀려
  > 판정을 미룰 이유가 사라졌다. 등록부 chip05 행과 집계표 §7·§8 에 기록.
- **[U43-3] `reseat` 열을 사람이 채울 것인가 절차가 채울 것인가** — §5. 프롬프트로 물으면
  거짓 입력이 가능하고, 안 물으면 기록이 없다. [로그 36](36.flash_id_and_sweep_uid_check.md)
  `[U36-2]` 와 같은 뿌리다
- **[U43-7] 칩과 배선 중 무엇이 값을 만드나** — §10. 교차 시험(S-2 §8 말미)이 답한다.
  결과에 따라 §9 산출물 2「개체 산포 σ」의 정의부터 다시 써야 할 수 있다
- **[U43-6] 앵커를 chip02 로 유지할 것인가** — §8. 삽입 횟수가 가장 많은 개체이고 오늘 4회에
  311.7ps 로 흔들렸다. chip10 은 같은 세션에서 19.6ps 로 재현됐다. 앵커 교체는 기준값을 새로
  세우는 일이라 비용이 있고, 9/16 에 chip01→chip02 로 이미 한 번 옮겼다
- **[U43-5] §6.3 의 σ_between 을 어느 집합으로 잡나** — §7. 깨끗한 4 칩이면 전 칩 3회 재측정,
  9/20 을 넣으면 1회로 종료다. **원인이 밝혀지기 전에는 고를 수 없다** — 고르는 행위 자체가
  결론을 정한다

  > **2026-09-20 — 닫혔다. 문제는 분자가 아니라 분모였다 (§9).** σ_repeat 를 정상 조립체
  > (chip10, 13.86ps)로 잡으면 어느 집합을 쓰든 분해 쪽이다. 집합 선택이 결론을 정하던 구조가
  > 사라졌다.
- **[U43-4] 9/20 width 를 끝내 못 가르면 무엇을 하나** — 재측정으로 앵커가 돌아오면 그날의
  값을 쓸 수 있는가, 아니면 chip07\~10 을 다시 재는가. 재측정은 P/E 를 또 +1 한다

  > **2026-09-20 — 가를 필요가 없어졌다 (§9).** chip10 3점이 세션을 가로지르며 측정계가
  > 안정했음을 보증하므로 9/20 의 width 를 그대로 채택한다. 재측정도 P/E 도 들지 않았다.
  > 다만 07:16\~07:29 구간은 증인 밖이라 그 단서를 판정문에 남겼다.
