young-0320/flash-margin-bench/ps/sim/xil_types.h

/* xil_types.h 심 — 호스트 시뮬레이션에서 flash_io.h 가 요구하는 정수형만 */
#ifndef XIL_TYPES_H
#define XIL_TYPES_H
#include <stdint.h>
typedef uint8_t  u8;
typedef uint16_t u16;
typedef uint32_t u32;
typedef uint64_t u64;
#endif
