young-0320/flash-margin-bench/(commit log)

2026-07-04 중간보고서 작성
2026-07-05 docs: 초기 프로젝트 개요 및 Git 가이드 문서 추가
2026-07-05 docs: 중간계획서 docx를 docs/로 이동
2026-07-05 fpga: Zybo Z7 마스터 constraints 템플릿 추가
2026-07-05 chore: .gitignore 추가
    Vivado/Vitis 빌드 산출물, Python 캐시, cocotb 시뮬레이션 산출물,
    KiCad 백업, 측정 데이터(data/) 등 생성물이 커밋되지 않도록 정리.
2026-07-05 docs: CONTRIBUTING.md 폴더 구조 설명 및 배치 원칙 보강
    각 폴더 옆에 소유자·역할 주석을 달고, 배치 기준을 원칙 4가지
    (명명 기준 통일, 폴더=소유자 1명, 소스와 생성물 분리, 하위 폴더는
    창발)로 정리. 폴더별 역할 상세 표를 추가해 판별 규칙과 배치 근거를
    명시.
2026-07-05 docs: 역할 분담 정리 (roles.md)
    한영웅/팀원 A/팀원 B 세 사람의 소유 폴더와 담당 업무를 항목별로
    정리. 각자 "하지 않는 것"·결정권 범위·착수 순서 주의사항 포함.
2026-07-05 chore: 폴더별 소유권·TODO README 스캐폴딩 추가
    각 폴더(fpga/rtl/core, fpga/rtl/flash, fpga/constraints, fpga/scripts,
    ps, host/analysis, host/viz, sim, hw, docs/interface, data)에 소유자·
    역할·TODO를 적은 짧은 README를 배치해 빈 폴더의 빈 커밋 문제를 방지.
2026-07-05 docs: 검증 이관 반영 — sim/ 소유 분할 (tb/ 팀원 A, golden/ 한영웅)
    코어 RTL은 한영웅, 검증 인프라는 팀원 A로 확정한 결정을 반영:
    - 한영웅 소유는 sim/golden/(golden model)만으로 축소, "하지 않는 것"에
    검증 환경 구축·회귀 실행 추가
    - 팀원 A로 cocotb 환경 구축·Winbond 모델 통합 격상, 소유 폴더에
    sim/tb/ 추가
    - CONTRIBUTING.md 폴더 표·트리, sim/README.md를 같은 내용으로 일치
2026-07-05 docs: 역할 분담 정리
2026-07-06 docs: project_context.md로 개명 + 마일스톤 보강
    - G0∥G1 병렬 트랙 명시 (둘 다 PASS 후 G2 진입)
    - G5 마모 개시 게이트 추가 (전수 신품 측정·노이즈 플로어·체크포인트 계획 충족 전 마모 금지)
    - 확장 항목에 제조사별 비교 축 추가
2026-07-06 docs: 중간보고서(7/10) 게재 항목 작업 워크플로 추가 (workflow/1.md)
2026-07-06 feat: 위상 스윕 파라미터 근거 시뮬레이션 및 욕조 곡선 분석기
    - mc_reads_per_phase.py: N·θ 선정 몬테카를로 (비트 단위 집계, log 보간 경계 판정,
    θ 스윕, UI 정합 시간 모델, git 스탬프). 채택: N=100, θ=1e-2(잠정, G0 확정 게이트)
    - bathtub_analysis.py: 실측 곡선 → 폭 3종 + θ 확정 체크리스트 4항 자동 판정
    (probit 직선화, floor, σⱼ 추출, 과분산). 합성 데이터 자기 검증 통과
    - docs/reports/plots: N 선택 곡선·θ 스윕 곡선 승격본
2026-07-06 docs: 생성물 흐름(build/→docs/reports) 규정, 개념 정리·작업 로그 신설
    - CONTRIBUTING: 재현 가능 생성물은 build/ 하위, 보고서 게재분만 사람이
    docs/reports/로 수동 승격 후 커밋
    - concepts/1.monte_carlo.md: 몬테카를로 역할·파라미터 개념 (θ 채택 근거 포함)
    - log/young/1: 작업 로그 (산출물/작업 내용/미결 의사결정)
2026-07-06 docs: 중간보고서 스프린트 계획 확정 및 개념 문서 보강
    - workflow/1.md: 게재 확정 목록(4항목+cocotb 줍기) 및 7/8 담당 배정
    (한영웅: 인터페이스 계약→루프백→실칩 통합 / 장세은: SPI·JEDEC ID 브링업 /
    박지민: cocotb 사다리 — 환경→Winbond 모델→JEDEC ID 시뮬), 총력전 운영 모드
    - concepts/1.monte_carlo.md: 위상 스윕·욕조 곡선 기초 설명 추가 (개념 사슬:
    위상 스윕 → 욕조 곡선 → 비탈과 θ → 파라미터 → 몬테카를로)
    - roles.md: 실명·직무 매핑 (한영웅 설계+PE, 박지민 설계+DV, 장세은 HW+TE)
    - log/young/2: 스프린트 모드 전환·배정 기록
2026-07-06 refactor: mc_reads_per_phase.py를 monte_carlo_sweep_params.py로 개명
    - 이름이 불투명한 약어(mc)였고 실제 범위(N + theta 스윕 근거)보다 좁았음
    - 출력 파일명 동기화: mc_reads_per_phase.{png,csv} -> monte_carlo_n_selection.png
    / monte_carlo_sweep_params.csv, mc_theta_sweep.png -> monte_carlo_theta_selection.png
    - bathtub_analysis.py의 import·docstring 상호 참조, concepts/1.monte_carlo.md,
    이전 작업 로그의 경로 언급 동기화. docs/reports/ 승격본도 재생성 후 교체
2026-07-06 chore: uv 기반 파이썬 의존성 관리 도입 (pyproject.toml + uv.lock)
    - 팀원 온보딩 = uv sync 한 줄, 락파일로 3인 동일 환경 보장
    - CONTRIBUTING §1.5 파이썬 환경 절 신설 (uv 설치·sync·run 사용법)
    - workflow: 박지민 cocotb 항목에 WSL2 환경 안내 추가
2026-07-06 chore: 파이썬 인터프리터 3.13 고정 (.python-version)
    - uv python pin — 세 명 모두 정확히 3.13으로 .venv 생성 (없으면 uv가 자동 설치)
    - requires-python도 >=3.13으로 정렬
2026-07-06 chore: pyproject에 readme 필드 추가
2026-07-07 docs: 인터페이스 계약 v1 확정 (결정 21건 + contract.md 통합)
    core-flash-host 3인 병렬 개발의 충돌 방지 장치인 인터페이스 계약을 v1으로
    확정한다. 위상 아키텍처·핸드셰이크·레지스터 맵·에러 카운터·CSV 스키마·클럭
    플랜·PRBS 패턴·핀 배치·호스트 플랫폼까지 21건 결정을 contract.md 하나로
    통합하고, 결정 과정 전문은 decision_records.md로 분리 보관한다. 계약 이해에
    필요한 개념(위상 스윕·MMCM, CDC, AXI-Lite, PRBS)도 문서화했다.
2026-07-07 feat: bathtub_analysis.py 계약 v1 업그레이드 (R8 무결성·프레이밍 슬립 검출)
    인터페이스 계약 v1(§6 CSV 스키마) 확정에 맞춰 실측 욕조 곡선 분석기를
    업그레이드한다. 위상 원점이 임의라 윈도우가 배열 경계에 걸치는 케이스를
    원형 재중심화로 처리하고, 인접 스텝 BER 점프로 프레이밍(비트 정렬) 슬립을
    잡는 체크 5를 신설했다. 동반 _reads.csv 자동 인식과 R8 무결성 검사(Σe_i·
    count·e_i≤B), _invalid 파일명 거부, phase_step 연속성 검증도 추가해 계약의
    무효 런 규약을 소비자 쪽에서 집행한다. selftest를 계약 스키마 그대로(동반
    파일·메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
2026-07-07 feat: G0 루프백 core·flash RTL 구현 + 스모크 검증
    core 블록(fpga/rtl/core/): MMCM 위상 제어(M=9·D=1, Δφ=15.87ps),
    위상 시프트 핸드셰이크, AXI-Lite 레지스터 파일(맵 v0). flash 블록
    (fpga/rtl/flash/): PRBS-15, clk_sample 캡처, 버스트별 3-오프셋 프레이밍
    재정렬, e_i BRAM, R10 워치독, R11 검증, CDC.
    검증(sim/smoke/): core 단독·flash 단독·통합 TB 전부 PASS, Vivado OOC
    합성 통과(xc7z020). 위상 스윕 14점 에러 0으로 프레이밍 재정렬 실증.
    계약 변경 제안 4건을 contract.md에 "※7/8 추인 대상"으로 표기
    (§2 meas_timeout·cfg_err, §3 CMD_ERR, R11 유효 START 정의, §6 무효⑥).
    경위: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
2026-07-07 chore: 문서 정리
2026-07-07 feat: G0 Vivado 통합 + 베어메탈 스윕 + UART 수신기 (bit+elf 원샷, 실보드 스모크 통과)
2026-07-07 docs: workflow 파일명 스네이크케이스화 + Vivado/XDC를 concepts에서 이관
    워크플로 파일명을 번호만으로 두지 않고 내용이 드러나는 스네이크케이스로
    바꾼다(1.md -> 1.midterm_report_workflow.md). Vivado 통합·XDC 제약은 물리
    개념이 아니라 G0 빌드 시 실제로 수행하는 절차라 concepts/6에서
    workflow/2로 옮기고, 개념 설명 위주 서술을 단계별 체크리스트(→ verify)
    구조로 다시 썼다.
2026-07-08 feat: G2 JEDEC 브링업 Vivado 절반 — PS SPI(EMIO)→JB 미니 BD·핀 확정·원샷 프로그래밍 + JTAG 재시도
2026-07-08 feat: 실칩 스윕 앞 결정 5건 확정 + 분석기 phase_ps 교차검사·문턱값 동결 (로그 10)
2026-07-08 feat: SPI 마스터(0x0B) 실칩 프런트엔드 — 합성 프리앰블로 flash_rx 무수정 재사용, 스모크 9종 PASS
    [flash_spi_ctrl.v, flash_spi_shim.v, flash_top_spi.v, tb_flash_smoke.v, tb_flash_spi_smoke.v, unisim_stub.v]
2026-07-08 docs: cocotb 회귀 승인 기준 테스트 계획 (flash F1~F10·core·통합)
2026-07-08 feat: flash_prep — PS SPI 사전 쓰기·전수 검증 ELF (전 범위 2,048페이지, PRBS 시드=페이지)
2026-07-08 feat: 클럭 사다리 빌드 인프라(O_DIV·PAY_LEAD 보험·G3 XDC) + 스윕 C 무칩 자가진단 2층·phase_ps 클럭 독립화
2026-07-08 docs: 개념 문서 확장·신설(BER·SPI와 클럭 포워딩·프레이밍 정렬·클럭 사다리) + 실칩의 날 런북
2026-07-08 docs: 계약 v1 추인 완료(7/8 3인) — 추인 대상 표기 걷어내고 동결
2026-07-08 docs: ⑥ 검증 분담 확정 + 지민·세은 읽기 목록을 런북 B에 명시
2026-07-08 feat: program_g0.tcl 원격 hw_server 지원 — 인자로 tcp:<호스트>:3121 접속 (무인자 = 기존 로컬 동작)
2026-07-08 docs: 로그 13(첫 루프백 곡선·Windows 재현법) + concepts/9(JTAG·UART와 OS 열거)
2026-07-08 fix: line_dead 자가진단
2026-07-08 docs: 런북 3 판독표 E에 Windows COM 채널 오선택 행 추가 — BEGIN 안 뜸 → COM 전부 시도 (로그 13)
2026-07-08 docs: 게재 1·3번 승격 — docs/reports→docs/results 이전, 루프백 곡선+요약 CSV+동명 유래 md, MC 그림 실측 σⱼ 갱신판 교체
    [sweep_loopback_20260708T131310Z.csv]
2026-07-08 feat: 세은 브링업 C 2종 리뷰·수용 — core_smoke(PS↔PL 스모크, %lu→%u 정정·개명)·flash_jedec(게재 2번, 로그 9 ③ 스펙 신규) + 빌드·프로그래밍 스크립트, program_g2 완료 안내문에 앱명 표기
2026-07-08 docs: contract §6 승격처 표기 정정 docs/reports→docs/results — 3인 동의, 의미 변경 없음 (로그 15)
2026-07-08 docs: 실칩의 날 기록 — 로그 14(세은 코드 리뷰)·15(사다리 3점·체크1 구조적 SKIP·3인 상정안), concepts 10(JEDEC)·11(BER 스케일·자 해상도), 게이트 지도(워크플로 4), 런북 3 D0 모듈 배선표, 게재 2번·D2 캡처 승격(captures/ g2·g3)
2026-07-08 feat: D5~D7 야간 배치 — 25MHz 반복 5회(5/5 valid) 집계 스크립트 신설, width@1e-2 = 39737.3±0.61ps (게재 4번 후보, 3인 추인 대기), 원본 20파일 data/ 보관, 로그 15 갱신
    [sweep_chip01_20260708T164931Z.csv]
2026-08-13 docs: 계약 v1 동결 표기 정정 — 7/8 3인 추인은 실제로 없었음
    계획돼 있던 추인 절차(런북 3 트랙 A, 로그 3 미결)는 수행되지 않았고
    예선 일정에 밀려 단독 판단으로 동결했다. 정정 주석을 본문에 남긴다
    (지우지 않고 정정 — e3ab303 표기 정정 선례와 동일 방식).
    계약 내용 변경은 없다.
2026-08-13 docs: README 보강 — 측정 파라미터 근거 절 신설, 고도화 방향 8축 추가
    - '측정 파라미터 근거' 절 신설 (결과 절 앞): N=100의 몬테카를로 사전등록
    근거(sigma_width <= dphi/2, 하한은 최저 theta=1e-4의 N·B·theta>=20),
    monte_carlo_{n,theta}_selection.png 최초 참조, 스윕 1회 규모(2,520x100x2,048
    = 5.16억 비트, ~5분)와 클럭별 스텝 수, 시료 W25Q64 x10 배분.
    게재 수치가 전부 chip01 단일 개체임을 명시.
    - '고도화 방향' 절 추가: PE 관점 8축(MSA·테스트 시간·코너·가드밴드·노화·
    지터 분해·correlation·outlier)을 추가 장비 요부와 함께 표로. 개인 제안이라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
2026-08-20 docs: README 역할 표 정정 — 세은·지민 배정이 뒤바뀌어 있던 것을 커밋 증거대로 수정
    roles.md(7/6)와 README(8/13)가 두 사람의 담당을 정반대로 기술하고 있었다.
    실제 납품 기록이 roles.md 쪽과 일치하므로 README를 정정한다.
    - 로그 11: "fpga/rtl/flash/(A 소유)", "박지민 합류 시 이 로그가 인수인계·리뷰
    기준" → flash RTL·빌드 플로우 = 박지민
    - 로그 14 / 커밋 acc42c2: core_smoke.c 작성 장세은, flash_jedec.c 스펙·캡처
    소유 장세은, 둘 다 ps/src/ → PS 펌웨어·DUT 보드·시각화 = 장세은
    디렉토리 안내의 fpga/rtl/flash/ 소유자 태그도 [장세은]→[박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
2026-08-20 docs: roles.md v2 — 한영웅 역할을 총괄+PE로 재정의, 협업 원칙 신설 (3인 추인 대기)
    문서 성격 변경: 개별 작업 목록이 아니라 "각자 어떤 역할을 맡고 그 역할이
    일반적으로 무슨 일을 하는가"를 본문으로 두고, 구체적 산출물은 사례로 붙인다.
    주요 변경
    - 한영웅: "설계+PE 겸업" → 총괄 + PE(Product Engineer). 판정 기준·MSA·
    가드밴드·사양서를 신설 항목으로 명시. 계측 대상 코드가 아니라 판정 코드를
    직접 만든다는 선을 기술
    - 협업 원칙 신설: 폴더=소유자는 책임 소재이지 출입 금지가 아니며, 주 역할은
    명확히 인지하되 팀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
2026-08-20 docs: 범위 표기 물결표 이스케이프 — 문장 중간이 취소선으로 렌더링되던 문제 수정
    GFM은 홑 물결표(~text~)도 취소선으로 처리한다. "3~4", "G0~G5", "0~99" 같은
    범위 표기가 한 문장에 둘 이상 나타나면 그 사이 전체가 그어져 보였다.
    9개 파일 42곳을 \~ 로 이스케이프. 화면 표기는 동일하고 취소선만 사라진다.
    로그 7개 파일은 이스케이프를 되돌려 HEAD와 바이트 비교해 기록 내용이
    변경되지 않았음을 확인했다. 파일별 원래 줄바꿈(CRLF/LF)도 유지.
2026-08-20 docs: 5.workflow 한계 추가
2026-08-20 docs: 워크플로 5 신설 + 마모 벤치 사양 결정 (로그 16, 시료 등록부)
    6주 공백 후 재개 계획을 세우고, S-1(마모 벤치 사양서) 작성에 필요한 판단을
    데이터시트 원전 대조로 확정했다.
    신설
    - docs/workflow/5.newchip_baseline_and_wear_bench.md — 재개 워크플로.
    트랙 S(사양 3건)·D(드리프트 확인)·M(신품 전수)·B(벤치 구현)·V(G1)·G(G5 판정),
    계약 변경 안건(BASE_SECTOR + UID), 파일럿 칩 절
    - docs/log/young/16.wear_bench_spec_decisions.md — 결정 근거 기록
    - docs/chip_registry.md — 시료 등록부. 개체 정본 식별자를 하드웨어 UID로 규정
    데이터시트로 확정한 것 (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
2026-08-22 docs: 계약 수정안 2건 발의 + S-1 벤치 사양서 확정 (로그 17)
    계약 v1 수정안 (미승인, 3인 합의 대기):
    - #1 BASE_SECTOR — 읽기 창 위치 지정. 마모군·대조군이 읽기를 나눠 가지면
    θ=1e-4에서 양쪽 다 검정력 미달. 도달 범위를 칩 전역(섹터 0~2047)으로.
    R11에 랩어라운드 방지 범위 검사 추가. UID CSV 헤더 병기
    - #2 N 100 → 112 — 마모 단위(16페이지)와 읽기 단위 정합. 그룹마다 남던
    12페이지 미측정 소거 + 섹터 경계 정렬 + 칩 최종 페이지 도달
    S-1 스트레스 벤치 사양서 (수신자 장세은):
    - 수치·절차만 싣는 건조판. 채택 근거는 전부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
    [monte_carlo_n112_20260823.csv]
2026-08-23 chore: README 줄바꿈 CRLF→LF 정규화
    core.autocrlf=input 설정 이전에 커밋된 파일이라 리포에 CRLF로 남아 있었다.
    내용 변경 없음 — 이후 커밋의 실질 diff가 전체 파일 치환에 묻히지 않도록 분리.
2026-08-23 docs: docs/spec/ 신설 — 사양서 2건을 계약·검증 폴더에서 분리
    계약과 사양서의 변경 절차가 다르면 폴더도 달라야 한다. 계약(interface/)은
    3인이 동시에 지키는 합의라 변경에 3인 합의가 필요하고, 사양서는 수신자 한 명에게
    보내는 구현 지시라 작성자가 혼자 고쳐도 된다.
    - docs/interface/s1.wear_bench_spec.md → docs/spec/ (amendments 링크 상대경로 정정)
    - sim/test_plan.md → docs/spec/s3.g1_test_plan.md
    (워크플로 5가 S-3 산출물로 지목한 문서. "규율 대상 옆"이 아니라 "문서끼리
    모은다"는 판례는 fpga/rtl을 규율하면서 docs/에 있는 contract.md)
    - docs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
2026-08-23 docs: ref PDF 2건 규칙대로 개명 + 등록부 판번 기입
    ref/README.md가 정한 `<대상>_<문서종류>_rev<판번>.pdf` 규칙을 정작 수록된
    파일 2건이 지키지 않았고, 등록부 표는 판번·수록일이 전부 "(예정)"이었다.
    인용할 때 판번을 적으라는 규칙이 근거 없이 떠 있던 상태.
    - W25Q64JV.PDF → w25q64jv_datasheet_revc.pdf (Revision C, 2016-06-03)
    - zybo-z7_ref.pdf → zybo_z7_refmanual_rev20180221.pdf (2018-02-21 개정, 보드 rev.B)
    - 등록부 표에 판번·출처·수록일·용도 기입, 파일명 소문자+언더스코어 규칙 명시
2026-08-23 docs: CONTRIBUTING 폴더 지도·소유자 표를 리포 실제와 정합
    "폴더 = 소유자 1명"을 규칙으로 세운 문서에서 docs/ 하위 신설 폴더들의 소유자가
    미기재였다. S-1/S-2/S-3을 각각 다른 사람에게 보내는 국면이라 실제 비용이 된다.
    - 폴더 지도에 docs/ 하위 7종(interface·spec·concepts·workflow·log·ref·results) 반영
    - 소유자 표에 하위 폴더 6행 추가, 각 폴더의 성격과 소유자 명시
    - 실재하지 않는 문서 3건(milestone-bathtub·decisions-hyw·decisions) 기재 삭제,
    실제 루트 문서(project_context·roles·chip_registry)로 교체
    - "문서 배치" 한 줄을 계약/사양서 구분 기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
2026-08-23 docs: 문서 이동·개명에 따른 상호참조 일괄 갱신 (10+ 파일)
    이번 이동분:
    - sim/test_plan.md → docs/spec/s3.g1_test_plan.md (로그 10·12·16, roles,
    워크플로 3·5, sim/README)
    - docs/interface/s1.wear_bench_spec.md → docs/spec/ (로그 17)
    - ref PDF 2건 개명 반영 (로그 16·17)
    이전 개명에서 갱신되지 않고 남아 있던 잔재:
    - docs/reports/ → docs/results/ (로그 1·4·5)
    - docs/workflow/1.md → 1.midterm_report_workflow.md (계약 서문, 로그 1·2·7)
    - docs/concepts/6.vivado_integration_and_xdc.md → workflow/2.g0_... (로그 8)
    - docs/milestone-bathtub.md → docs/workflow/4.gate_map.md (project_context)
    - 삭제된 docs/inter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
2026-08-23 docs: 작업 로그 18 — docs 구조 감사 기록
    spec/ 신설 판단 기준(계약 vs 사양서), test_plan 위치 판례, CONTRIBUTING이
    리포와 어긋나 있던 항목 대조표, ref 판번 확보 경위.
2026-08-23 docs: S-3 G1 합격 기준 동결 — 오라클 출처와 판정 3단 (24항목)
    박지민 착수의 전제 문서. 이후 변경은 착수를 중단하고 재발행하는 절차로만.
    범위 축소안 기각 — 판단 기준이 작업량이 아니라 오라클의 순환 논증이다.
    smoke의 내장 슬레이브는 우리가 짠 모델이라, 우리가 프로토콜을 오해했다면
    잘못된 RTL이 잘못된 모델을 상대로 통과한다. 그래서 축소 대신 항목마다
    오라클 출처(V 벤더 모델 / S 자기 정합)를 명시해 G1의 주장 범위를 정한다.
    - W1~W3 신설 — 내장 모델이 원리상 못 보는 것(명령 오인식·tSHSL 위반·mode
    경계).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
2026-08-23 docs: 수정안 #1 §4 인수 절차를 S-3 동결본과 정합 (A2·A3)
    §2 계약 변경분은 불변 — 상정 내용 자체는 바뀌지 않으므로 승인 절차에 영향 없다.
    바뀐 것은 각 인수 항목을 무엇으로 판정하느냐다.
    - A3(범위 거부) → F12로 이관, 실측 불요. 조건식 하나 들어갔는지 보려고
    보드·칩·UART를 쓰는 것은 낭비이고 시뮬은 START 한 번이면 끝난다.
    G1 미착수 상태에서 인수해야 하면 종전대로 실측
    - A2(읽기 창 이동)는 시뮬 선행 권장으로만 — 주소·시드 미동반은 F11이 몇 초에
    잡지만, 정확히 1,024섹터 배수로 어긋나는 aliasing 구멍은 먼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
2026-08-23 docs: S-3 동결 반영 — 판정 3단 명시, roles 미결 2건 정리
    - roles.md §검증(G1) — 합격 기준 동결 완료 표기, 판정 3단 표 추가.
    판정을 한 사람에게 몰면 분리가 절반만 성립한다는 근거 명시
    - roles.md 미결 1번(G1 범위 축소안) 해소 — 축소하지 않고 오라클 출처
    명시로 주장 범위를 정하는 쪽으로 확정
    - roles.md 미결 2번(golden model 독립성) — S-3 범위 밖으로 경계 확정,
    G1 게이트 판정 시점 별건 처리
    - sim/README.md — 동결 표기, 판정 3단, 테스트 함수명 규약,
    `check_coverage.py` 소유(한영웅) 및 TODO 추가
2026-08-23 docs: 작업 로그 19 — S-3 동결 근거 기록
    범위 축소안을 기각한 근거(작업량이 아니라 오라클 순환 논증), 항목별 오라클
    출처 판정, 3인 겸직 구조에서 판정을 셋으로 나눈 이유, 커버리지 대조의 한계.
2026-08-23 docs: 워크플로 6 신설 — G1 착수와 기준 정밀화 (H·R·C 트랙)
    워크플로 5를 대체하지 않는다. S-3이 나오면서 파생된 후속과, 동결본 자체
    재검토에서 나온 미비점을 모은다. 5의 D·M·B·V·G 트랙은 그대로 유효.
    원칙은 박지민의 착수를 막지 않는 것 — 19항목(F1~F10·C1~C6·I1~I3)은 확정적이라
    cocotb 환경 구축과 기존 항목 이관은 지금 시작할 수 있고, H가 건드리는 것은
    신설 5항목과 운영 절차뿐이다.
    - H 트랙(미비점 8건) — 정확성 3건: W3의 mode 기준이 추측 근거(W25Q64JV는
    mode 0·3 둘 다 지원해 "실패할 것"이 성립 안 할 수 있음) / F11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
2026-08-23 docs: 동결본에 단독 동결·미비점 8건을 사전 명시 (S-3 개정)
    동결본 자체 재검토 결과를 문서 머리말에 반영한다. 사후 정정을 피하는 유일한
    방법은 사전에 정직하게 적는 것 — contract.md는 단독 동결을 3개월 뒤에야
    표기 정정했다.
    - 상태를 "단독 동결 — 3인 추인 미완"으로 고쳐 적는다. 워크플로 5의 S-3
    verify는 3인 회의였으나 일정상 단독으로 정했다. 추인 절차는 워크플로 6 R4
    - 미비점 8건 포인터(워크플로 6 H 트랙) + 19항목은 확정적이라 착수를 막지
    않는다는 단서
    - §1에 항목 내력 구분 신설 — 기존 19항목은 smoke 통과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
2026-08-23 docs: S-2 착수 전 확인사항 — 시료 배분표 불일치 기록
    chip_registry.md는 파일럿 칩 1개를 포함하나 project_context.md §7 배분표에는
    없다. S-1이 파일럿을 도입하면서 §7이 따라 갱신되지 않은 것으로 보이며,
    S-2의 첫 항목(시료 배분표 확정)이 어느 쪽을 정본으로 삼을지 먼저 정해야 한다.
2026-09-07 docs: G1 기준 개정 2 — 미비점 8건 해소 (H 트랙) + 커버리지 대조 스크립트 (C 트랙)
    워크플로 6의 H·C 트랙을 닫는다. 남은 것은 3인 합의가 정의상 필요한 R 트랙뿐.
    - H1: W3(mode 경계) 폐기 — 칩이 mode 0·3을 둘 다 지원하고(데이터시트 §6.1),
    우리 SCLK 유휴 low는 ODDR(D1=0)이 강제하는 배선 상수라 실패 방향이 양쪽 다 없다.
    지키려던 성질은 F2로 흡수 (CS↓·CS↑ 시점 SCLK 레벨의 와이어 관측)
    - H2: F11 지점 249 → 0/1/1,024/2,041 재선정. 시드 14비트 별칭 탓에 BER은 상위
    주소 비트 유실을 원리상 못 잡으므로 와이어 주소 디코드를 동등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
2026-09-07 docs: S-2 신품 전수 측정 프로토콜 확정 — 배분표 정본 이관, 사전 등록 규칙
    워크플로 5 S 트랙의 마지막 미작성 문서. M 트랙(장세은 실행)의 착수 전제였다.
    이 측정은 마모를 한 번이라도 시작하면 영원히 확보 불가능하므로 절차를 사전 등록한다.
    - 시료 배분표 불일치 해소: 정본을 s2 §1로 이관 (파일럿 1 / 종단 3 / 블라인드 2 /
    무마모 2 / 예비 2 = 10). project_context.md §7이 범위(3~4, 1~2)로 열어 둔 것을
    S-1의 파일럿 도입이 닫은 것이므로 §7을 갱신하고, §7·등록부가 s2를 가리키게 했다.
    전수 신품 측정은 용도가 아니라 단계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
2026-09-07 docs: 런북 3 점퍼 색 관례 정정 (DO 노랑 · CLK 주황) + 표 정렬 재포맷
    - D0 6핀 모듈 배선표의 색 관례를 실제 사용 점퍼에 맞춤: DO 흰/보라 → 노랑,
    CLK 노랑 → 주황. 라벨→라벨 연결이라 색은 관례일 뿐이지만, 현장에서 표와
    손에 든 케이블이 다르면 확인 비용이 든다
    - 나머지는 마크다운 표 열 폭 재정렬 (내용 변화 없음)
2026-09-07 docs: 작업 로그 22 — 8/23 D 트랙 1차 실측 기록과 판정 보류 근거
    2026-08-23 저녁 스윕 2건(chip01·loopback)이 어느 로그에도 잡히지 않은 채 남아
    있던 것을 파일에서 역추적해 기록한다. 판정은 내리지 않는다 — 기준값 ±0.61ps가
    "재장착 없음" 편차라 재장착 성분이 든 8/23 측정을 잴 자가 아니며, 분리 수단인
    재장착 σ는 S-2 §8이 M 트랙에서 재도록 한 값이라 순환이 된다.
    - chip01 width@1e-2 39,741.65ps (7/8 기준 39,737.3±0.61, +4.35ps)
    - loopback -385ps·σ_j +15% — 점퍼 접촉 잠정 설명, 확인 전 _invalid 처리 보류
    - 두 경로가 반대로 움직여 공통 장비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
2026-09-07 docs: 작업 로그 23 — 실칩 스윕 래퍼·UID 파이프라인 설계 결정 8건
    터미널 다중 실행과 UID 3주 미구현이 같은 원인(세션 경계)에서 나온 것을 확인하고,
    래퍼를 시나리오 단위로 셋으로 나눈다. 구현은 다음 작업.
    - 라벨을 사람이 입력하지 않는다 — UID 로 chip_registry.md 역조회
    - 파일명 sweep_<label>_<uid16>_<stamp>.csv, 루프백은 종전 유지
    - UID 3회 읽어 일치 요구 (전송 성공 != 값이 맞다, JEDEC 검사와 같은 층)
    - 불변식을 래퍼가 아니라 캡처에 둔다 — 모든 경로가 캡처를 지난다
    - host/run/ 신설, run_sweep_chip / run_newchip / run_wear, 루프백 분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
2026-09-07 docs: 트랙 이름 규칙 신설 — 문서 접두 W<번호>-<문자> (게이트 지도가 원전)
    트랙 문자가 문서 로컬인데 문서 밖에서 인용되어 충돌하고 있었다.
    D 둘(W3-D 실칩 곡선 / W5-D 드리프트), B 둘, C 둘, 그리고 W5-G(게이트 판정
    트랙)와 게이트 G5 자체가 겹친다.
    - 게이트 지도의 기존 규칙(대문자 G#=전역 / 소문자 g#_*=로컬)의 연장
    - 게이트 G0~G5 는 전역·유일이라 접두 없음
    - 접두가 문서를 가리키므로 성격(W3 당일 런북 / W5 재개 국면 / W6 동결 후속)도 드러남
    - 워크플로 3·5·6 트랙 표와 W5 의존성 문장에 적용. 로그·사양서 인용부 소급은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
2026-09-07 docs: 로그 23 부록 — 후속 결정 4건 (flash_uid 기각 · chip_pe 장부 · 트랙 접두 · 블라인드 미결)
    - flash_uid.c 안 만든다: W5-D 는 칩이 하나라 방어 대상이 없다. W5-M 에서 필요
    - docs/chip_pe.md 신설, append-only: 칩 단위 누적 P/E 로는 섹터 그룹별 마모를
    표현할 수 없고, 누적값을 들면 범위가 계속 쪼개진다. 누적은 파생량, 이력이 원시값
    - 트랙 접두 W<번호>-<문자> (커밋 a891653)
    - 블라인드: 절차가 어느 사양서에도 없음을 확인. 자동 P/E 기록이 등록부의
    '블라인드 공란 유지' 규칙과 충돌. 설계 시 다룰 4건을 남기고 미정
2026-09-07 feat: flash_prep에 4Bh UID 읽기 추가 — 3회 일치 요구, #PREP UID <16hex> 출력
2026-09-07 docs: 계약 수정안 #3 상정 — UID 파일명·메타 열 4개·chip 생성 거부 (§6, 미승인)
2026-09-07 feat: 등록부 파서 chip_registry.py — md 표 정본, 빡빡한 검증, 공란 채우기·행 추가만 허용
2026-09-07 feat: 캡처 라이브러리화 + 수정안 #3 형식 — 메타 16열, UID 파일명, chip 생성 거부, --raw, 셀프테스트 열 동기
    [sweep_uart_capture.py]
2026-09-07 docs: chip_pe.md 신설 (P/E 증분 이력, append-only) + 등록부 정정 — 누적 P/E 열 비움, #UID 주석 → uid 열
2026-09-07 feat: 실칩 스윕 래퍼 run_sweep_chip.py — 한 프로세스가 prep→UID→등록부→스윕 ×N, host/run/ 신설 (CONTRIBUTING·README·워크플로 갱신)
2026-09-07 docs: 작업 로그 24 — 래퍼·UID 파이프라인 구현 기록, 프롬프트와 다르게 간 결정 3건과 미결 9건
2026-09-07 fix: 검토(로그 25) 중요 4건 — UID 재시도 중 #PREP ERROR 미출력, 세션 로그를 시작부터 디스크에, 라벨 재입력 루프, 캡처 #G0 find, 예외 시 요약
    [flash_prep.c, run_sweep_chip.py, sweep_uart_capture.py]
2026-09-07 docs: 작업 로그 25 — 래퍼·UID 파이프라인 검토 보고(치명 0/중요 4/경미 7)와 후속 수정 기록
2026-09-11 docs:선행논문 조사 추가
2026-09-14 docs: 해외 논문 조사 추가
2026-09-14 docs: 워크플로 7 — Vivado 2025.2 통일(설치·재빌드·재기준선 A/B·조원 전개) + 작업 로그 26
2026-09-14 build: Vivado 버전 가드 2024.2→2025.2 이전(워크플로 7 B1) + 런북·program_g3의 --target 잔재 정정(W7-D)
2026-09-14 docs: 워크플로 7 설치 경로를 2025.2 실제 배치(~/Xilinx/2025.2/<툴>)로 정정
2026-09-14 ps: program_g0/g3.tcl에 BUILD_DIR 환경변수(기본 build) — 재기준선 A/B에서 2024.2 보관본 선택용 (워크플로 7 미결 1 결정)
2026-09-14 docs: 작업 로그 26 — 팀원 논문 조사 반영, 9/15 실칩 검증일 순서표(워크플로 7), project_context 정합; Vitis 잔재 dfx_runtime.txt 제거
2026-09-14 docs: 로그 26→27·워크플로 7→8 재번호(main의 9/15 검증일 문서와 충돌) + 9/15 결합 제안 절
2026-09-14 docs: 재기준선 A/B 생략 결정 반영 — 워크플로 8 R 트랙 생략·B0 rm -rf build, 로그 27 추기
2026-09-14 docs: 조원용 빌드·측정 가이드(docs/build_and_run_guide.md) 신설 — 준비물·환경·빌드·루프백·실칩·분석·판독표; README·워크플로 8에서 참조
2026-09-14 docs: 가이드 재현성 확인을 WNS·자원 수치 비교로 정정(.bit md5 불가), 로그 27에 2025.2 g0 빌드 결과 표
2026-09-14 docs: 가이드를 빌드 재현 문서(docs/build_reproduction.md)로 재작성 — 산출물·순서·명령·검증 중심; 설치 함정은 워크플로 8 I절로 이동
2026-09-14 docs: 2025.2 전 빌드 통과 기록 — build_reproduction §5 기준값 표, 워크플로 8 I·B 완료, 로그 27 결과 표
2026-09-14 docs: build_reproduction — g1이 없는 이유(시뮬레이션 게이트) 한 줄
2026-09-14 docs: build_reproduction 단계별 빈 헤더 표 4개 → 불릿 목록 (렌더링 폭 문제)
2026-09-14 docs: build_reproduction을 getting_started 형식으로 재작성 — 전체 흐름(검증/빌드 루프)·앵커 목차·Quick Setup·Prerequisites·단계별 명령→기대 산출물·Board Programming·Verification·Fast Rebuild·Debug 절
2026-09-14 docs: build_reproduction 절 제목을 main판 체계로 환원 — 영문 제목 15개 한국어화, 번호를 1~8/3.x·5.x로 통일
    재작성 과정에서 절 제목만 영문(## Build Pipeline)이고 본문은 한국어로 남아 톤이
    갈렸다. main판의 "번호 + 한국어 제목" 체계로 되돌리고, 3장·5장 하위 절은 3.1~3.5 /
    5.1~5.2로 상위 번호를 물리게 했다. 목차 앵커 15개 재작성(전부 헤딩과 대조 확인),
    본문 상호참조 §Quick Setup→§1 · §Build Pipeline→§3 · §5→§3.5 갱신,
    "1~4 전부"→"3.1~3.4 전부". 표 머리 Host OS/Tool도 한국어로. 내용 변경 없음.
2026-09-14 docs: 워크플로 9 — 9/15 회의 안건(역할 배분 변경안·확정 3건·서명 목록·각자 할 일); 워크플로 7을 2025.2 재빌드에 맞춤(환경 경로·빌드 세대·판정 시 BUILD_DIR A/B); 로그 26 추기
2026-09-14 docs: P/E 스트레스 벤치 아이디어와 구현 프롬프트 추가
2026-09-14 docs: 지민 P/E 스트레스 벤치 로그 추가
2026-09-14 docs: 지민 로그 번호를 1과 2로 변경
2026-09-14 docs: cocotb 검증 계획과 Winbond 모델 요청 기록
2026-09-15 docs: Vivado Vitis 빌드 명령어 정리
2026-09-15 build: 실칩 스윕 N_READS 112 치환 (수정안 #2 승인) + 결정 로그 29
    수정안 #2(N 100→112) 2026-09-15 승인. N 은 AXI 레지스터 0x0C 라 RTL 변경은
    불요하고, PS 가 써 넣는 값이 C 상수였던 것만 바꾸면 된다.
    - build_g3_sweep.py 의 치환 목록에 N_READS_CFG 추가 (N_READS = 112)
    - ps/src/g0_sweep.c 는 무수정 — build_g0_sweep.py 가 같은 원본을 그대로 쓰므로
    고치면 G0 루프백까지 끌려간다. 루프백은 자기 이력과만 비교하므로 100 유지
    (수정안 #2 §4.3 측정 모드)
    - done 줄에 n_reads 표기 — 어느 빌드인지 화면에서 보이게
    검증: 정규식 단독 실행으로 세 치환 패턴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
2026-09-15 docs: 로그 30 flash_prep 신품 조사 구현 명세 (G-b·G-d) + 구현 중 정정(xiltimer.h, 글로벌 타이머 수동 enable, WARN 행)
2026-09-15 feat: flash_prep 신품 조사 3종 — blank_pre(전역)/blank_post(소거 범위)/섹터별 소거 시간 (로그 30)
    - blank_scan(): 03h 판독으로 0으로 굳은 비트·바이트 수 + 주소를 그 자리에서 UART 출력 (배열 없음, tx/rx 260B 재사용, 판정 없음)
    - 소거 루프: SE 전송 완료~WIP 해제를 XTime으로 계측, 섹터마다 #PREP ERASE 출력 + min/max/mean/over400ms 요약
    - 새 토큰 BLANK/BLANKADDR/ERASE만 사용 — 호스트 파서 수정 불요
    - 2025.2 BSP(xiltimer)는 글로벌 타이머를 자동 시작하지 않아 main 초입에서 enable
    - _Static_assert로 addr3() 3바이트 주소 절단을 빌드 타임 차단
    [flash_prep.c]
2026-09-15 fix(ps): flash_prep 소거 시간이 4배 작게 나오던 문제
    BSP(xtimer_config.h)의 COUNTS_PER_SECOND 가 `XPAR_CPU_CORE_CLOCK_FREQ_HZ/2` 로
    괄호 없이 정의돼 있어, 나눗셈에 직접 쓰면 X/(A/2) 가 아니라 X/A/2 로 전개된다.
    결과가 정확히 4배 작아지고, 에러 없이 값만 틀리는 유형이라 조용히 지나간다.
    2026-09-15 chip02 실측에서 드러났다. blank_post 가 423ms 로 찍혔는데, 2,048페이지
    (4.26Mbit)를 2.6MHz SPI 로 읽는 물리적 최소가 1.64초라 나올 수 없는 값이었다.
    blank_pre·blank_post·소거 시간 셋이 전부 4.00/4.01/4.02 배로 어긋나 있었다.
    수정 후: 소거 mean 6,739us → 27,097us (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
    [flash_prep.c]
2026-09-15 feat: UART 전송 경로 — xsct 구간 드레인 · 보 레이트 921600 통일 · 진행률 출력
    2026-09-15 chip02 스윕이 2,501/2,520 행으로 끝나(무효 ⑤) 원인을 팠다. 스텝당 1,467B를
    115200(11,520B/s)으로 흘리면 UART 이용률이 98%라 여유가 0이고, 래퍼는 xsct 종료를
    기다리느라 그 1~2초 동안 포트를 읽지 않는다. 커널·FTDI 버퍼(≈10KB = 6~7스텝)가 넘쳐
    step 7~25가 통째로 사라졌다. 커널 로그상 그 구간 USB 이벤트는 0건 — 케이블이 아니다.
    셋을 함께 넣는다. 드레인 없이 보만 올리면 같은 2초에 8배가 쏟아져 오히려 악화된다.
    - run_xsct(ser=...) 가 xsct 구간 UART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
2026-09-15 docs: 파이프라인 지도 문서 + README 정합 (N=112 · 시료 배분)
    docs/project_pipeline.md — 뼈대만 있던 문서를 재작성했다. 층위 4단(빌드→측정→분석→기록)
    × 경로 2개(측정=PL / 마모=PS SPI)를 축으로 잡고, 신품 측정 → 마모 체크포인트 루프 →
    온도 축 순으로 놓았다. 절마다 [동작]/[부분]/[미구현] 을 붙여 점선이 실선으로 읽히는 것을
    막는다. 수치·합격 기준은 복제하지 않고 원전 표(build_reproduction · gate_map · 런북 3 ·
    계약 §6 · S-1 · S-2)로 넘긴다.
    종전 뼈대의 문제 셋:
    - "신품 측정 = flash_prep.c" — 실제 실행 단위는 prep(PS SPI) + 스윕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
2026-09-15 docs: chip02 첫 투입 기록 — 실행 로그 · 등록부 · P/E 이력 · 측정 원본 보관
    로그 30 §10 (실행 기록·버그 리포트): 신품 조사 3종을 실칩에 처음 돌린 결과. 기능은 셋 다
    동작했고 버그 2건(타이머 4배, UART 포화)과 사고 1건이 나왔다. 머리말 성격도 "구현 명세 +
    실행 기록" 으로 정정. 미결 3(75MHz ELF 세대 혼재)은 보 레이트 전환 재빌드로 해소.
    chip02 (UID D1642C74E7134527):
    - 등록부에 UID·최초 측정일 기입, 비고에 **출고 blank 미관측** 명시. 첫 시도가 UART 단절로
    호스트만 죽고 보드는 완주했다 — 다음 런의 blank_pre 가 bits=2097152(페이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
2026-09-15 docs: 스윕 1회 59초 실측 반영 — S-1 §12 시간 예산 개정
    §12의 "스윕 1회 약 5.6분"은 115200bps 계산치였고 "(실측 확인 대상)"으로 열어 둔
    항목이었다. 2026-09-15 보 레이트 921600 전환 후 chip02(25MHz·N=112)에서 59초를 실측해
    닫는다. UART 전송이 지배 항이었고 순수 측정 시간은 약 23초다.
    스윕 1회 5.6분 → 59초
    체크포인트 1점 — 파일럿 17분 → 약 3분 (3영역 × 1회)
    체크포인트 1점 — 본 실험 84분 → 약 15분 (5영역 × 3회)
    사이클링 300k 33.7h (불변 — tSE 가 지배하는 칩 물리)
    효과는 §11 적응적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
2026-09-15 docs: 로그 30 §10.3 — 보 레이트 구현 경위 정정 + 검증 결과 기록
    - 구현 형태: 레지스터 직접 쓰기 → XUartPs_SetBaudRate 로 바뀐 것이 별도 후속 커밋이
    아니라 같은 커밋(56a5ee4) 안이었음을 명시. 그 커밋 메시지에 직접 쓰기 시절 문구가
    남아 있다는 점도 함께 적어, 나중에 메시지와 소스가 어긋나 보이는 것을 막는다
    - 검증 결과 추가: 115200 런과 921600 런의 width·천장 BER·벽 폭 대조 (+0.45ps, 반복 σ 안),
    θ를 조인 쪽 7~9ps 차이는 세션 간 성분이며 아직 정량화되지 않은 값임을 명시
    - 드레인이 보 레이트 상향의 전제였다는 근거: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
2026-09-15 docs: 신품 전수 집계표 개설 + 드리프트 앵커를 chip02 로 교체 (S-2 개정)
    집계표 (docs/results/data/newchip_survey_2026-09.{md,csv}) — S-2 §9 산출물 2·3·4의 자리를
    지금 연다. 9칩을 다 돌고 나서 만들면 세션 로그 9개를 거꾸로 파싱해야 하고, 무엇보다
    §6.2 이상치 판정(중앙값 ± 3×로버스트σ)을 **칩이 소켓에 꽂혀 있는 동안** 해야 재장착
    재측정이 가능하다. 머리말에 진행 상태(1/10)를 박아 미완성임을 표시한다.
    chip02 기록:
    - width 채택 39,630.2ps = 921600 두 런의 평균. 115200 런(39,633.86)은 조건 통일을 위해
    채택에서 빼되 기록에 남긴다 — 제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
    [newchip_survey_2026-09.csv]
2026-09-15 docs: 신품 전수 집계에 chip03 — 출고 blank 첫 관측, 소거 시간 개체차 1.88배
    chip03 (UID D1628C10C3433F33): width@θ=10⁻² 39,652.8ps · 소거 median 51,129us ·
    blank_pre 0 bits · blank_post 0 bits. 스윕 VALID 2,520/282,240행, 체크 2·4·5 PASS.
    **출고 blank 최초 관측.** 8MB 전역에 0으로 굳은 비트 0개 — 로그 30 §2가 사전에 적어 둔
    "10개 전부 bits=0일 가능성이 높다, 발견이 아니라 보험"의 첫 실측 확인이다. chip02에서
    UART 단절로 놓친 항목을 chip03이 메웠다.
    **소거 시간 개체차 1.88배 (chip02 27.2ms vs chip03 51.1ms).** 마모 탓이 아니다 — 소거
    시간은 마모될수록 늘어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
    [newchip_survey_2026-09.csv]
2026-09-15 docs: 로그 28(9/15 실칩 검증일) + 워크플로 10(다음 작업)
    로그 28 — 로그 26 미결 1에서 예약해 둔 자리를 채운다. 버그·사고의 진단과 처치는 로그 30
    §10이 정본이므로 중복하지 않고, 측정 결과와 그날의 결정을 담는다.
    - chip02·chip03 측정치, 얻은 값 셋(출고 blank 첫 관측 / 소거 시간 개체차 1.88배 /
    세션 간 σ 4.65ps), chip01↔chip02 106ps의 귀속 미정
    - 결정 4건: S-1 §12 개정 · 드리프트 앵커 교체 · 집계표 개설 시점 · 측정 원본을
    build_*/에 두지 않는다. 앞의 둘은 사양 개정이라 해당 문서에 개정 일자를 달았다
    워크플로 10 — 전수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
2026-09-15 feat: reproduce.py — 빌드·검증 원샷 재현 + 채점 (+ 로그 32)
    build_reproduction.md §3(빌드)·§5(검증)를 순서대로 돌리고 §3.5 기준으로 단계마다 채점한다.
    §4(보드 굽기)는 하지 않는다. 전체 약 20분, --only/--vitis-only 로 골라 돌릴 수 있다.
    발단은 2026-09-15 에 ELF 를 7개 다시 구우면서 45·75MHz 가 구형인 채로 남아 세대가 섞여
    있던 것을 사람이 ls -l 로 눈치채서 알았다는 것이다(로그 30 §9-3). 그래서 채점의 핵심을
    "종료 코드로 판정하지 않는 것"에 뒀다 — vitis -s 는 빌드가 깨져도 0 을 돌려줄 수 있고,
    산출물이 이번 실행 이후에 생겼는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
2026-09-15 docs: build_reproduction.md 최상단에 reproduce.py 안내 절 신설
    손으로 §3·§5를 치기 전에 스크립트가 있다는 것을 먼저 보게 한다. 채점 5종을 표로 싣고,
    그중 ③(산출물이 이번 실행 이후에 생겼는지)이 2026-09-15에 45·75MHz ELF가 구형인 채
    세대가 섞였던 유형을 잡는 검사임을 명시했다.
    - 범위를 못박는다: §3·§5·§6 을 돌고 §4(보드 굽기)는 하지 않는다. §8의 PAY_LEAD 보험
    비트도 범위 밖이므로 그것만은 §8의 명령을 직접 친다
    - 문서와 스크립트가 어긋나면 문서가 옳고 스크립트를 고친다 — 원전 관계를 적어 둔다
    - 목차에 0번으로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
2026-09-15 fix(reproduce): 빈 단계 목록이 성공으로 끝나던 문제 + --only/--vitis-only 충돌
    1. --only sim --no-sim 처럼 --only 와 --no-* 가 서로를 지우면 단계 목록이 비는데 그대로
    종료 코드 0 으로 끝났다. 아무것도 안 돌고 초록이 뜨는 것이라 CI 에 걸면 최악이다.
    시작 전에 죽인다 — check_coverage.py 의 "0행 파싱 → 파서 고장", chip_registry.py 의
    "비어 있음을 정상으로 받지 않는다"와 같은 자다.
    2. --vitis-only --only g3-25 를 주면 `args.only or (...)` 때문에 --only 가 조용히 이겨
    Vivado 합성이 돌았다 — Vivado 를 생략하려던 의도와 정반대다. argparse 상호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
2026-09-15 fix(reproduce): 검증을 실행 순서 맨 앞으로 + 파싱 실패 오진 + g0e 산출물 누락
    1. sim·selftest 가 맨 뒤에 있었다. 둘을 합쳐 10초가 안 되는데 빌드는 20분이라, RTL 이
    깨져 있으면 스모크 5초로 알 수 있는 것을 Vivado 16분 태우고 나서 알게 된다.
    build_reproduction.md 「전체 흐름」이 이미 검증 루프를 먼저 적고 "RTL을 바꾸면 검증
    루프부터"라고 말하고 있었는데 스크립트만 반대였다. FULL·VITIS_ONLY 앞으로 옮긴다.
    2. Vivado 리포트에서 WNS/WHS 를 못 읽으면 note 가 "(PL 로직 없음)"으로 찍혔다. g2 는
    실제로 PL 로직이 없어 맞는 표기지만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
2026-09-15 feat(reproduce): 채점에 ⑥ 빌드 파라미터 대조 — 산출물을 "무엇으로 구웠는지" 본다
    채점 ③(산출물이 이번 실행 이후에 생겼는가)은 "다시 구웠다"만 말하지 "무엇으로 구웠는가"는
    보지 않는다. 2026-09-15 에 45·75MHz ELF 가 N=100 인 채 남아 세대가 섞였던 것이 정확히 그
    구멍이었고, 잡은 것은 스크립트가 아니라 사람의 ls -l 이었다.
    build_g3_sweep.py 가 이미 `== done (45MHz, steps=1400, n_reads=112): …` 를 찍으므로
    비용 0 으로 닫힌다. STEPS 에 expect 를 두고 run_step 이 로그에서 대조한다.
    tcl 이 vitis 를 체인 호출하므로 g3-*(Vivado 전체) 로그에도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
2026-09-15 docs: 채점 ⑥(빌드 파라미터 대조) 반영 — build_reproduction 최상단 표 · 로그 32
    직전 커밋 126638f 가 코드만 담았다 (문서 편집 스크립트가 표 서식 불일치로 죽었는데
    커밋은 진행됐다). 문서 쪽을 마저 넣는다.
    - build_reproduction.md 최상단 채점 표에 ⑥ 행
    - 로그 32 §2.1 에 ⑥ 행 + 미결 5 로 "비트스트림 내용 검증은 없다"를 명시
    (.bit 은 헤더 생성 시각 때문에 해시 비교가 안 되므로 ⑤ 가 대용이고 그 이상은 방법이 없다)
2026-09-15 docs: 워크플로 10 에 W10-B (reproduce.py 후속) 추가
    2026-09-16 에 reproduce.py 가 들어왔으므로(로그 32) 다음 국면 문서에 자리를 만든다.
    - 트랙 표에 W10-B, 병렬 트랙 절에 도구 소개(채점 6종)
    - §B 에 남은 결정 둘:
    ① g0·g3 Vivado 전체 경로가 아직 미검증 — 보드 불필요, 약 16분이면 닫힌다
    ② --check-only 는 출처 기록이 선행이다. mtime 판정은 git checkout 이 mtime 을 흔들고,
    입력 목록을 빠뜨리면 조용히 통과하며, 무엇보다 툴 버전(2024.2↔2025.2 세대 혼합,
    chip01↔chip02 106ps 의 원인 후보)을 못 잡는다. 산출물 옆에 git_rev·tool·params·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
2026-09-16 fix(reproduce): Windows 대응 — 셸 의존 제거 · .bat 런처 · tcl 의 exec env 제거
    세은 PC(Windows + Vivado)에서 계속 실패하던 원인 네 가지:
    1. vivado/vitis 가 .bat 인데 CreateProcess 는 .exe 만 붙인다.
    shutil.which 는 PATHEXT 를 보므로 도구 선검사만 통과하고 실행에서 WinError 2.
    → tool() 로 .bat/.cmd 는 cmd /c 로 감싼다
    2. sim/selftest 가 셸 문자열이라 cmd.exe 가 *.v 를 못 펴고, {log_dir} 치환값에
    인용이 없었다. → 셸을 걷어내고 cmd 를 argv 리스트(들)로. glob 은 Path.glob 이 편다
    3. build_g3_chip.tcl 의 `exec env G3_MHZ=...` — env(1) 은 POSIX 전용이라
    Windows 에 없다.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
2026-09-16 윈도우환경에서의 빌드방법
    Document troubleshooting steps for Windows build issues with FPGA/Vitis, including automation script failures and manual build instructions.
2026-09-16 docs: add WSL USB JTAG UART connection guide
2026-09-16 fix(reproduce): 자식 env 에 PYTHONUTF8 — Windows cp949 로 selftest·Vitis 가 죽던 문제
    로그 33 의 Windows 대응(.bat 런처·셸 제거·exec env)을 적용하고도 세은 PC 가 막혔다.
    남은 벽이 인코딩이었고, 증상이 둘로 나뉘어 있었다:
    1. selftest — 자식 파이썬이 한글 출력을 cp949 로 인코딩하다 UnicodeEncodeError
    2. Vitis 빌드 — 내장 파이썬이 ps/src/*.c 를 cp949 로 읽다 UnicodeDecodeError
    (PS 소스 4개 전부 한글을 담고 있다. 주석만이 아니라 xil_printf 문자열 리터럴에도)
    로그 33 의 utf-8 고정은 로그 '파일' 인코딩이라 이게 안 닫힌다 — 자식은 파이프에 쓰기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
2026-09-16 feat(reproduce): 단계 진행 표시 — 5초마다 경과·이정표 한 줄 갱신
    [3/8] g0 ... 이 8분 동안 그대로였다. 죽은 건지 도는 건지 알 방법이 터미널을 하나 더 열어
    tail -f 하는 것뿐이었다. watch() 가 같은 줄을 제자리에서 다시 그린다:
    [3/8] g0 0:55 Phase 9 Verifying routed nets ← 5초마다
    [3/8] g0 PASS (113s) WNS=29.811 … ← 끝나면 같은 자리를 덮어쓴다
    이정표: 우리 마커(== ) · Vivado 임플 단계(Phase n) · Vitis 컴파일([2/3]).
    설계 판단 셋:
    - 파이프로 빨아들이지 않는다. 자식 출력은 지금처럼 로그 파일로 보내고 그 꼬리에서 주워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
2026-09-16 docs: 세은 로그 첫 줄의 GitHub 첨부 링크 제거
    웹 에디터로 md 를 올릴 때 본문과 같은 문서의 사본이 user-attachments 에 따로
    업로드되며 박힌 줄이다. 저장소 밖을 가리키는 군더더기라 지운다. 본문 483줄은 그대로.
2026-09-16 docs: 로그 34 — cp949 벽·진행 표시·전체 재현 2회, 빌드 신원 관리 논의(보류)
    §2 고친 것 둘(PYTHONUTF8, watch)의 경위와 설계 판단.
    §3 전체 재현 2회 결과 표 — 8/8 PASS, g0·g3×3 수치가 9/14 기준값과 소수점까지 일치.
    로그 33·34 의 이식성 수정이 산출물을 바꾸지 않았다는 근거. 전체 약 9분(문서는 20분).
    §4 빌드 신원 관리 논의 전체 — 문제(3인이 든 산출물에 라벨이 없다), 후보 셋(rev·입력
    내용 해시·결과 수치)과 각자의 한계, 2×2 판정표, 3단계 로드맵, 그리고 보류 이유.
    rev 만 쓰면 문서 커밋에도 값이 바뀌어 거짓 불일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
2026-09-16 docs: 전체 재현 실측 반영 — 소요 9분 정정 · §3.5 재검증 · W10-B ① 닫힘
    build_reproduction: "약 20분"은 2024.2 시절 값이다. 2026-09-16 실측 535초 → 약 9분.
    §3.5 기준값 표 아래에 재검증 결과 한 줄 (맨바닥 재빌드 2회, 네 수치 전부 일치).
    워크플로 10 §B: ① "아직 한 번도 안 돌린 경로"가 닫혔다 — g0·g3 Vivado 전체 경로
    8/8 PASS. ③ 으로 빌드 신원 관리의 보류 결정과 재개 시 정할 것을 남긴다 (로그 34 §4).
2026-09-16 docs: chip04 측정 기록 — UID 등록 · P/E +1
    2026-09-16 신품 전수 측정 3번째 칩. run_sweep_chip.py 가 기계로 쓴 두 줄이다.
    chip04 ← D16484578B525622 (flash_prep 이 4Bh 를 3회 읽어 일치 확인한 값)
    chip_pe.md: chip04 0~127 +1 (batch 20260916T125643Z)
2026-09-16 docs: 신품 집계 — chip04 기입 · chip01 자리 · CSV 스키마 14열→11열
    chip04: width@1e-2 = 39,687.9ps · 소거 median 33,743µs (29,889~43,273) ·
    blank_pre/post = 0/0 · git_rev f3a6958. 상태 2/10 → 3/10.
    세 칩의 폭이 39,630 / 39,653 / 39,688ps 로 58ps 안에 모인 반면 소거 시간은
    27 / 51 / 34ms 로 1.9배까지 벌어진다 — "소거 시간은 개체차가 큰데 타이밍 마진은
    거의 같다"가 n=3 에서 더 뚜렷해졌다.
    chip01: 회수 대기(W10-A) 자리만 만들어 둔다. UID 미확보라 전 열 공란.
    상태 줄은 3/10 그대로 — 자리는 측정이 아니다.
    스키마에서 세 열을 뺀다:
    - n_preps: chip_pe.md(증분 이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
    [newchip_survey_2026-09.csv]
2026-09-16 docs: 배스텁 플롯 승격 — chip02 3장 · chip03 · chip04
    build/plots/ 는 지워지는 곳이다(오늘 build/ 를 새로 만들면서 실제로 잃을 뻔했다).
    집계표에 수치로만 남아 있던 곡선을 docs/results/plots/ 로 올린다.
    스윕 원본 CSV 는 승격하지 않는다 — 집계표 머리말의 "원본은 용량상 커밋하지 않는다,
    재현은 생성 스크립트 + 파라미터 + UID + git_rev 로 확보한다" 규칙 그대로.
    chip02 는 플롯이 3장인데 집계표 n_sweeps 는 2였다(그 열은 이번에 제거). 어느 것을
    뺐는지 판단할 근거가 없어 3장 모두 올린다 — 빼야 할 것이 있으면 별도 커밋으로.
2026-09-16 feat(analysis): bathtub_analysis --json — 수치를 파일로도 남긴다
    run() 이 폭 3종·체크리스트·sigma_j 를 담은 dict 를 돌려주는데 main() 이 print 만
    하고 버렸다. 화면을 닫으면 사라져서, 집계표에 옮기려면 분석을 다시 돌려야 했다.
    --json 이면 <입력>.analysis.json 으로도 쓴다. '_' 로 시작하는 내부 값은 빼고,
    numpy 스칼라가 섞여 있어 default=float 로 덤프한다. 화면 출력은 그대로.
    이것이 래퍼의 분석 자동 호출(다음 커밋)과 배치 후처리의 전제다.
    chip04 실제 CSV 로 확인.
2026-09-16 feat(run): run_sweep_chip 을 --mode 구조로 + 분석 자동 호출 + xsct .bat
    --no-prep / --prep-only 옵션을 --mode {newchip,sweep} 로 바꾼다. 모드가 '무엇을
    하는가'(= P/E 를 쓰는가)를, 나머지 옵션이 '어떻게'를 정한다. 모드가 정한 것은
    옵션으로 뒤집지 못한다:
    --mode newchip --chip … → "newchip 은 UID 를 기계가 읽는다" 로 거부
    --mode sweep (칩 미지정) → "어느 칩인지 알 길이 없다" 로 거부
    앵커 재측정에서 --no-prep 을 빠뜨려 칩을 한 번 더 마모시키던 사고(2026-09-15
    chip02: 하루 4회)를 표현 불가능하게 만드는 것이 목적이다.
    --chip chip02 로 라벨을 주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
2026-09-16 feat(analysis): prep_survey_parse.py — 세션 로그에서 신품 조사 수치를 뽑는다 (W10-P)
    flash_prep 이 UART 로 뿜는 #PREP ERASE / #PREP BLANK 를 세션 로그에서 읽어
    집계표 형식(md 행 · --csv 로 CSV 행)으로 찍는다. 소거 median/min/max 와
    blank_pre/post, 라벨·UID·일자.
    검증: chip03 세션 로그 → 51,129 / 46,888 / 55,443. 집계표에 사람이 손으로 넣은
    값과 세 개 모두 일치한다.
    파서가 드러낸 것: chip02 의 첫 세션만 median 6,609µs 로 나머지(약 27,000)의 1/4 이다
    — 커밋 90d8234 로 고친 "소거 시간이 4배 작게 나오던 문제" 그 세션이다. 즉 집계표의
    chip02 값은 사람이 그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
2026-09-16 docs: 로그 35 — flash_id 설계 결정 (sweep 모드가 칩을 확인하지 않는 문제)
    --mode sweep 은 P/E 를 아낀 대가로 확인을 통째로 잃은 상태다. flash_prep 이 안 도니
    JEDEC(접촉·배선)도 UID(신원)도 검사하지 않고 곧장 스윕에 들어간다. 잘못 집은 칩으로
    재면 CSV 에 남의 UID 가 박히고 사후 판별이 불가능하다.
    로그 23 부록 A 가 "W5-M(10칩 배치)에서는 flash_uid.c 가 필요하다"고 예고했다 —
    과거 판단을 뒤집는 게 아니라 조건이 도래한 것이다.
    결정 다섯과 근거를 남긴다:
    D1 flash_jedec 확장 대신 새 앱 — 장세은 소유(게재 2번) · 앱 하나 = 목적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
2026-09-16 feat(ps): flash_io — 베어메탈 앱 공용 배관 (UART·SPI·JEDEC·UID)
    앱들이 각자 들고 있던 같은 코드를 부품으로 뺀다. main 이 없고, 구현은
    flash_prep.c 의 검증된 코드를 그대로 옮긴 것이다 — 프리스케일러(PRESCALE_64),
    보 레이트(921600), UID_LEN=8, 4Bh 3회 읽기 값을 바꾸지 않았다.
    출력을 하지 않는 것이 유일한 차이다. 실패 문구의 접두(#PREP / #G2)가 앱마다
    다르고 호스트 파서가 그 접두로 종료를 판정하므로 판정·출력은 앱이 한다.
    UID 실패는 전송 실패(-1)와 3회 불일치(-2)로 갈라 원본의 두 FAIL 문구를 앱이
    그대로 낼 수 있게 했다.
    지금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
    [flash_io.c, flash_io.h]
2026-09-16 feat(ps): flash_id — P/E 를 쓰지 않는 신원 확인 앱 + 빌드 스크립트
    UID 는 g2 비트스트림(PS SPI) 위에서만 읽히는데 그 위에서 돌던 앱이 flash_prep
    하나뿐이고 걔는 반드시 소거·쓰기를 한다. 그래서 --mode sweep(재측정, P/E 불변)은
    칩 신원을 사람 선언에 의존해 왔다. 10칩 배치에서 앵커를 사이사이 끼우면 잘못 집은
    측정이 엉뚱한 칩에 영구히 귀속된다 (CSV 에 UID 가 박히므로 사후 판별 불가).
    flash_id 는 flash_io 의 첫 소비자로 JEDEC 과 UID 만 읽는다. 쓰기 명령을 한 바이트도
    내보내지 않는다 — 소거·프로그램·WREN 없음. 그것이 이 앱의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
2026-09-16 feat(run): sweep 모드 세션 1 — flash_id 로 UID 를 읽어 --chip 과 대조
    --mode sweep 은 등록부 역조회만 하고 소켓의 칩을 확인하지 않았다. 책상에 육안
    구분이 안 되는 칩 10개가 널려 있고 앵커를 사이사이 끼우는 중이라, 잘못 집으면
    엉뚱한 칩에 귀속된 측정이 영구히 남는다 — CSV 에 UID 가 박히므로 사후 판별이 안 된다.
    run_id() 가 세션 1 을 돈다. program_g2 + flash_id 를 굽고 #G2 UID 를 파싱해
    역조회한 기대 UID 와 대조하며, 어긋나면 스윕 전에 Abort 한다. 메시지에 읽은 UID·
    그 칩의 라벨(등록부에 있으면)·기대 UID·기대 라벨을 모두 찍는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
2026-09-16 docs: 로그 36 — flash_id 와 sweep UID 대조, 개념 12(개체 식별·비파괴 확인)
    - 로그 36: 산출물 6건 · 왜 새 앱이 필요했나 · 왜 기존 4개 앱을 안 건드렸나 ·
    검증 현황(호스트 회귀 PASS, 보드 2건 미실행) · 미결 3건
    - 로그 23 부록 A: "2026-09-16 조건 도래, 구현함" 추기. 과거 결정을 뒤집은 것이
    아니라 거기 적힌 조건(W5-M 10칩 배치)이 온 것이라는 표시
    - 개념 12: 품종 식별자(JEDEC)와 개체 식별자(UID)의 층위, 재는 행위가 대상을
    닳게 하는 계측에서 왜 검사가 비파괴여야 하는가, 선언과 검증의 차이
    - build_reproduction: flash_id 빌드·프로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
2026-09-16 docs: 로그 36 §2-6 — ELF 빌드 실측 반영 (경고 0), 남은 보드 검증 4단계
    Vitis 가 PATH 에 있어 실제로 빌드했다. -Wall -Wextra 경고 0, text 36,033 /
    data 1,528 / bss 23,172. reproduce --only id 도 PASS(16초). 스텁 헤더 문법
    검사는 실빌드가 대신하므로 표에서 뺐다.
    검증 절차 2(flash_prep 교차 확인)에 경고를 붙였다 — 그것은 P/E 를 하나 쓴다.
    앵커나 마모 이력이 있는 칩에서 할 것, 신품 chip05~10 으로는 하지 말 것.
2026-09-16 refactor(ps): flash_prep 을 flash_io 위로 — 사본이 아니라 이전
    flash_io 는 원래 flash_prep 의 코드였다. flash_id 가 그것을 빌려 쓰는 동안 두 앱이
    같은 배관을 들고 있었는데, 그럴 이유가 없다. 부품 쪽을 단일 원본으로 삼는다.
    flash_prep.c 에서 나간 것: uart_set_baud · SPI0 초기화 · XSpiPs_PolledTransfer ·
    JEDEC 읽기·대조 · UID 3회 읽기. 순 -20줄이고 XSpiPs/XUartPs 참조가 0이 됐다.
    남은 SPI 코드는 "#PREP ERROR" 를 입히는 xfer() 껍데기뿐이다 — 부품은 출력하지 않고
    호스트 래퍼가 그 줄을 종료 신호로 읽으므로(로그 25 중요 1) 접두는 앱에 남아야 한다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
    [flash_io.c, flash_io.h, flash_prep.c]
2026-09-16 docs: 워크플로 9 flash_uid.c 행 닫음(한영웅) · 로그 36 에 flash_prep 이전 반영
    워크플로 9 §2-3: 행을 "완료 — 한영웅, 2026-09-16" 으로 닫고 **모양이 왜 달라졌는지**를
    표 아래 남겼다. "UID 만 읽는 소형 앱" 으로 출발했으나 배관이 flash_prep 과 통째로
    겹쳐서 부품(flash_io.h/.c) + 앱(flash_id.c) 으로 갈린 것이다. 항목이 없어진 게 아니라
    자란 것이므로 경위가 표에 남아야 한다 — 안 남기면 다음에 "그래서 flash_uid.c 는
    어떻게 됐나" 를 다시 묻는다. 남은 것은 B-0·B-1 담당뿐이다.
    같이 갱신한 현재 상태 문서:
    - project_pipeline: flash_uid.c 미구현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
2026-09-16 feat(reproduce): id 를 기본 단계로 — sweep 모드가 이 ELF 없이는 시작도 못 한다
    jedec·smoke 처럼 default=False 로 왔으나, --mode sweep 은 flash_id.elf 가 없으면
    "missing … — vitis -s ps/scripts/build_flash_id.py 먼저" 로 멈춘다. 선택으로 두면
    "빌드는 8/8 PASS 인데 보드 앞에서 측정을 못 하는" 상태가 만들어지고, 그 사실을 빌드
    시점이 아니라 측정 시점에 알게 된다. 앵커 재측정(chip02 ②③④)이 W10-M 일정에 있어
    측정하는 사람은 전부 필요하다. 비용 17초.
    id 는 g2 XSA 를 쓰므로 g2 뒤, prep 옆이다. VITIS_ONLY(빠른 재빌드)에도 넣는다 — ELF 다.
    확인: --on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
2026-09-16 docs: 로그 36 — 보드 실측 부분 결과(1·3 통과, 2 절반, 4 미검증) · §2-8 id 승격
    2026-09-16 23:19, ELF 존재만 확인하려던 명령이 보드가 붙은 채 끝까지 돌았다. 의도한
    검증이 아니라 우발 실행이라, 무엇이 증명됐고 무엇이 아닌지 구분해 적는다.
    --mode sweep 이라 P/E 는 늘지 않았다.
    통과: flash_id 단독 실행(JEDEC·UID 가 등록부와 일치) · --mode sweep 대조 OK 후
    스윕 VALID · 분석 자동 호출
    절반: flash_prep 교차 확인. flash_id 가 읽은 UID 는 어제 flash_prep 이 읽은 값과 같지만
    그 어제 값은 리팩터 '이전' 앱이 읽은 것이다. 즉 flash_io 의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
2026-09-16 fix(run): N 불일치 조기 차단 · 기본 N=112 · 재장착 직후 UID 재확인
    래퍼가 목표대로 만들어졌는지 점검하다 나온 셋이다.
    1. N 불일치를 스윕이 끝난 뒤에 잡고 있었다. #G0 SWEEP BEGIN 의 n= 은 첫 줄인데 검사는
    캡처가 끝난 뒤라, 오늘 실측에서 59초를 다 받고 버렸다. capture_sweep(…, expect_n=) 으로
    BEGIN 직후 끊는다. 래퍼의 N 검사는 valid 판정보다 앞으로 옮겼다 — 안 그러면 조기 중단이
    invalid 로 분류돼 조용히 다음 회차로 넘어간다.
    단위 시험(가짜 시리얼): 불일치 → 0행 수신 후 중단 · 일치 → 정상 완주 ·
    expect_n 미지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
    [newchip_survey_2026-09.csv]
2026-09-16 docs: 로그 36 — 검증 4 통과 기록 (15:34, 대조가 실제로 막은 첫 사례)
    §4 ② 는 "4는 아직 한 번도 안 걸렸다"로 남아 있었다. 그 판단은 15:17 실행(ELF 누락으로
    그 앞에서 멈춤)까지만 본 것이고, ELF 를 빌드한 뒤 15:34 에 실제로 걸렸다.
    소켓에 chip04 가 꽂힌 채 --chip chip01 을 준 실행이다. 지민이 직전에 chip01 UID 를
    등록해 인자 검증은 통과했고 보드까지 가서 대조에서 막혔다. 스윕 전 중단, P/E 불변,
    세션 로그는 session_idfail_… 로 남았다. 이 작업이 없었다면 chip04 의 곡선이 chip01 의
    UID 를 달고 CSV 에 박혔을 것이다.
    §2-6 표에 8행 추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
2026-09-16 docs: 등록부 — 누적 P/E 열 제거, 용도·파일럿 표기 정리
    값을 두 곳에 두면 어긋난다. 누적 P/E 의 원본은 chip_pe.md(증분 이력)이고
    등록부는 불변 사실(UID·최초 측정)만 든다 — 열 자체를 없애 참조조차 남기지 않는다.
    chip02 를 앵커로, chip01·02 를 파일럿 칩으로 표기. chip04 최초 측정일 기입.
    chip02 의 blank 미관측 경위는 신품 집계(newchip_survey)와 chip_pe.md 에 있다.
2026-09-16 fix(run): idfail 개명을 UID 불일치 지점으로 — 빌드 누락까지 삼키던 문제
    session_idfail_*.log 라는 이름은 "꽂힌 칩이 다르다" 를 뜻해야 하는데, verify_uid
    호출 전체를 try 로 감싸고 있어 ELF 누락·flash_id FAIL·타임아웃까지 같은 이름으로
    남았다. 2026-09-16 15:17 실행이 실제로 그랬다 — 내용은 missing flash_id.elf 인데
    파일명은 idfail 이라, 나중에 그 파일만 보면 칩을 잘못 집은 기록으로 읽힌다.
    rename("idfail") 을 verify_uid() 안의 UID 불일치 지점으로 옮기고 호출부의
    try/except 를 걷었다. 둘을 같이 두면 바깥 except 가 안쪽에서 걸러낸 것을 도로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
    [run_sweep_chip.py]
2026-09-16 chore: .claude/settings.json — 백그라운드 세션 격리 해제 · worktrees 는 ignore
    Claude Code 를 백그라운드로 돌리면 기본적으로 .claude/worktrees/ 에 별도 브랜치를
    파서 거기서만 파일을 고친다. 병렬 작업이 서로를 덮지 않게 하는 장치인데, 수정이
    main 작업본에 안 보여서 VSCode 로 확인이 안 된다. bgIsolation=none 으로 끈다.
    대신 같은 파일을 사람과 동시에 만지면 충돌하므로, 어느 파일을 건드릴지 먼저 말하고
    들어가는 규칙이 필요하다.
    .claude/worktrees/ 는 도구가 만드는 작업 폴더라 ignore. settings.json 은 공유 설정이라
    커밋한다 (개인 설정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
2026-09-16 refactor(run): 옵션 13 → 9 · --chip 단축 표기 · 보드 접촉 전 선검사
    인터페이스를 목표 대비로 훑고 정리했다.
    제거 (셋 다 실사용 0건을 확인했다):
    - --uid: 쓸 수 있는 값은 전부 등록부에 있고 그건 곧 --chip 이다. 16hex 를 손으로 치게
    만들어 오타 위험만 더했다
    - --n-reads: 설정이 아니라 대조값이다. 실칩은 112 고정(build_g3_sweep.py 가 치환)이라
    상수 EXPECT_N 으로 내렸다. ELF 가 다른 값이면 BEGIN 첫 줄에서 중단하는 검사는 그대로다.
    선택지에 있던 448 은 그 값으로 빌드되는 ELF 가 없는 유령이었다
    - --no-analyze: 분석이 실패해도 CSV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
2026-09-16 docs: 조작 설명서 신설 — 사람이 치는 명령의 정본
    명령어가 워크플로 5·7·10 · project_pipeline §6 · 집계표 다섯 곳에 흩어져 있어,
    오늘 --mode 를 도입할 때 그 다섯 곳을 찾아 고쳐야 했다. 한 곳을 정본으로 둔다.
    docs/operating_manual.md:
    - §0 계층 — 사람이 치는 최상단 / 그것이 부르는 중하단 / 보드 위 ELF.
    "터미널은 하나면 된다"(최상단이 UART 를 쥔 채 xsct 를 부른다)와, 직접 부를 때만
    "수신 먼저 송신 나중"을 사람이 지켜야 한다는 것
    - §1 reproduce.py — 옵션·단계·채점 읽는 법
    - §2 run_sweep_chip.py — 모드 비교표, 옵션 9개, 상황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
2026-09-16 docs: 로그 36 §2-10 — 보드 검증 2 통과, 그리고 폭이 70ps 움직였다
    chip02 를 --mode newchip 으로 돌려 flash_prep 이 flash_io 위에서 완주하는지 봤다.
    #PREP PASS all 2048 pages verified 까지 갔고, 소거 시간 평균 27,411µs 가 chip02 의
    기존값 27,151µs 와 사실상 같다. §2-7 의 "문구 19개 동일"이 호스트 파서에 대한 증거였다면
    이것은 칩에 대한 증거다 — SPI 타이밍이 같다는 것은 칩이 대답해야 증명된다.
    그런데 폭이 39,633.7(16:10) → 39,563.1(16:18) 로 67ps 줄어 G-a 기준(39,630.2 ± 14ps)
    밖으로 나갔다. 8분 전 같은 칩이 기준 안이었으므로 장비 드리프트가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
2026-09-16 docs: 앵커는 prep 없이 잰다 — S-2 §8 확정
    ②③④ 는 재장착 성분만 보는 절차인데 prep(소거·정답지 재작성)을 끼우면 재장착·쓰기·마모가
    한 값에 섞여 σ_repeat 가 무엇의 산포인지 알 수 없게 된다. P/E 도 매번 오른다.
    2026-09-16 에 재장착 + prep 이 함께 든 측정이 기준 대비 -67ps 로 나왔고, 원인이 무엇이든
    그 값은 앵커로 쓸 수 없다(로그 36 §2-10).
    같은 날 관측된 칩 개체차가 58ps(당시 3칩)인데 재장착 1회 변화가 70ps 였던 것도 적는다 —
    ②③④ 를 빠뜨리면 §6.3 의 분모가 없는 채로 판정하게 된다는 근거다.
    워크플로 10 W10-M 에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
2026-09-16 docs: chip06 편입 (4/10) · chip05 무응답 기록
    chip06: UID D16428231B4E182B · width@1e-2 39,798.0ps · 소거 median 25,674µs
    (22,152~31,030) · blank_pre 0 — 출고 blank 3번째 관측. 등록부·chip_pe 는 측정이 기계로 썼다.
    chip05: #PREP JEDEC FF FF FF 3회(16:22·16:23·16:26)로 UID 미확보. 같은 리그에서 직전
    chip04(16:25)와 직후 chip06(16:28)이 정상 동작했으므로 배선·전원이 아니라 개체 또는 삽입
    상태 문제다. 방향·핀 접촉 재확인 혹은 점퍼선 교환이 남았다. 집계표에는 "(읽기 불가)" 행으로
    자리만 둔다 — 빠뜨리면 10개 회계가 맞지 않는다. 상태를 4/10 (chip05 측정 불가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
    [newchip_survey_2026-09.csv]
2026-09-16 docs: 로그 37 — 2026-09-16 측정일 (chip06 편입 · chip05 무응답 · 재장착 편차 첫 실측)
    오늘 14건을 돌렸고 P/E 를 쓴 것은 둘뿐이다(chip02 검증, chip06 신품). 나머지는 sweep 이거나
    차단이라 P/E 불변이다 — flash_id 가 없었다면 차단 5건이 P/E 를 태웠거나 잘못된 라벨로
    측정됐을 것이다.
    재장착·접촉 편차를 처음으로 크기까지 봤다. chip04 를 같은 날 네 번 쟀는데:
    12:57 신품 39,687.9 / 15:19 소켓 그대로 +1.9 / 16:15 재장착 +6.1 /
    16:25 접촉 실패(16:14 FF FF FF) 후 재장착 +52.7
    정상 재장착은 6ps 안이고 접촉이 한 번 흔들린 세션은 53ps 였다. 변수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
2026-09-16 docs: 로그 37 을 걷어내고 내용을 각자 자리로
    로그는 "왜 이렇게 만들었나"에 대한 답이지 일지가 아니다. 그 기준으로 보면 37 은 결정이
    없는 날의 기록이었고, 다섯 절 중 넷이 이미 다른 문서에 있는 내용이었다 — 14건 실행 표는
    세션 로그가 원본이고, chip05·chip06 은 등록부와 집계표에, 현황은 집계표 그 자체다.
    고유했던 것은 재장착 편차 분석 하나였다. 그것을 집계표의 "현재까지의 관측"으로 옮긴다
    (n=2 → n=4). 관측 ④: chip04 를 같은 날 네 번 잰 결과 정상 재장착은 6ps 안이고 접촉이
    한 번 흔들린 세션은 53ps 였다 — 변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
2026-09-16 docs: 로그 35 를 36 §5 로 흡수 — 뒤집힌 결정은 그 자리에 적는다
    35(설계 결정)와 36(구현)은 같은 날 같은 주제였고, 저장소 전체에서 로그 35 를 가리키는
    참조가 한 건도 없었다. 반대로 36 은 12곳이 가리킨다 — 소스 주석(flash_io.h/c,
    flash_prep.c, run_sweep_chip.py)까지 포함해서. 그래서 흡수 방향은 35 → 36 하나뿐이고,
    36 의 절 번호는 건드리지 않았다. 35 는 결번으로 남긴다. 번호는 주소이므로 당기지 않는다.
    D1~D5 · 검증 계획 · 미결 5건을 그대로 옮기고 §5-1~5-5 로만 재번호했다.
    읽을 때의 문제가 하나 있었다. D2("기존 앱은 flash_i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
2026-09-16 docs: 로그 목록 신설 — 세 사람을 한 자리에
    로그가 34편 5,477줄이 되면서 "어느 로그에 뭐가 있나"를 파일명으로 찾게 됐다.
    docs/log/README.md 에 한영웅(34) · 장세은(1) · 박지민(5) 을 섹션으로 나눠 모은다.
    ref/ · spec/ 이 이미 README.md 를 쓰고 있어 같은 관례를 따랐고, 개인 폴더가 아니라
    세 사람의 공통 진입점인 log/ 바로 밑에 둔다.
    한 줄 요약은 "무엇을 했나"가 아니라 그 로그에만 있는 판단을 가리킨다. 수치를 찾는
    사람이 로그로 오지 않게 하려는 것이고, 기준은 커밋 1535ad8 과 CONTRIBUTING §1 이
    이미 정한 것 — 수치·현황은 re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
2026-09-16 docs: 워크플로 10 W10-L — 로그 서식 규약, 내일 정할 것
    로그의 내용 성격은 정해져 있다(결정 근거·의도·경위). 정해진 적 없는 것은 형식이고,
    CONTRIBUTING 에도 로그 서식 규정은 비어 있다. 34편을 계측해 무엇을 정할지 모아 둔다.
    증상 넷. 볼드 과다 — 전체는 100줄당 24개지만 표 셀·불릿 머리의 라벨 볼드를 빼면
    문장 속 강조는 12.4개다. 그래도 8줄마다 한 번이라 강조가 배경이 된다. 결정이 본문 끝에
    흩어짐 — 헤더가 작성일·배경·성격·참조·산출물까지 챙기는데 "무엇을 정했나"가 없다.
    연속 문단 18~21줄. 헤더 항목 불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
2026-09-17 docs: 로그 서식 규약 확정 — 로그는 다른 문서가 가질 수 없는 것만 담는다
    W10-L 을 닫는다. 규약은 docs/log/README.md 「서식 규약」, 근거와 전 로그 계측은 로그 38.
    - 판별선 — git · results/ · spec/ · workflow/ 가 답할 수 있으면 로그에 쓰지 않는다.
    절차·측정 수치·파일 목록·작업 실적이 이 선에서 나간다
    - 골격 다섯 — 머리말 → 결정 → 근거 → 산출물 → 미결
    - 머리말 작성일·발단·목적·관련 (측정일은 작성일과 다를 때만). 작성·성격은 뺀다 —
    폴더와 발단·목적이 이미 답한다. 목적은 질문, 결정은 답
    - 뒤집히거나 닫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
2026-09-17 docs: 서식 규약 3건 보완 — 검사할 수 없는 조문을 검사 가능하게
    규약을 스킬로 집행하려다 검사가 성립하지 않는 것을 발견했다.
    - `## 결정` 은 본문 복사가 아니라 결론의 유일한 자리. 복사본은 §4 가
    금지한 이중 출처이고, 본문을 다듬으면 한쪽만 낡는다
    - 추기 첫 줄을 `> **YYYY-MM-DD — …**` 로 고정. 형식이 제각각이라
    grep 으로 세지지 않았다 — 로그 38 이 "추기 4편"이라 센 12·26·27 중
    26·27 은 규약이 폐기한 말미형이다
    - 미결 불릿에 ID. 닫는 로그가 기억이 아니라 검색으로 자리를 찾는다
    새 로그 등재를 규약에 한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
2026-09-17 feat(skills): 로그 작성 스킬 — 규약을 읽히는 문서에서 도는 절차로
    docs/log/README.md 「서식 규약」은 열어야 열린다. 규약을 확정한 커밋이
    그 규약의 목록 등재를 빠뜨린 것이 증거다.
    스킬은 규약 본문을 복제하지 않고 README 를 가리킨다(복제하면 드리프트).
    고유하게 갖는 것은 넷 — 트리거, 절차 체크리스트(번호·추기·목록 등재),
    TEMPLATE.md, 검사 명령.
    적용 범위는 young/ 강제, jimin·seeun 은 제안(로그 38 §8).
    Claude-Session: https://claude.ai/code/session_01YCZTULa13geRZgk9dzd8x1
2026-09-17 docs: 추기에 출처 표기 · 로그 번호는 마크다운 링크로
    스킬로 로그를 한 편 써 보고 나온 두 건이다.
    - 추기 첫 줄 끝에 무엇이 이 결정을 바꿨는지를 단다. 기존 실물(로그
    23·36)은 전부 출처를 가리키는데 규약은 예시로만 보여줬고, 그래서
    어제 단 추기가 "누가" 만 적고 "무엇 때문에" 를 빠뜨렸다. 사람은
    본인이 아닐 때만, 폴더명으로
    - 로그 번호는 첫 등장에 마크다운 링크로. 경로를 손으로 붙이는 규칙은
    적혀 있어도 안 지켜졌다(38·13 은 달고 15·23·36 은 흘렸다). 링크면
    사람은 눌러서 가고 없는 파일은 검사에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
2026-09-17 refactor(skills): 규약 복제를 걷어내고 산문 경고를 검사기로 바꾼다
    스킬로 로그를 써 보니 값을 한 것은 절차와 검사였고, 실패한 것은
    「자주 틀리는 것」 4불릿이었다. 거기 글자 그대로 적힌 규칙을 읽고도
    틀렸다 — 산문 주의사항은 체크리스트가 아니다.
    그 절은 docs/log/README.md 판별선의 요약이기도 해서, 스킬이 규약을
    복제하지 않는다던 설계를 그 자리에서만 어기고 있었다. 통째로 뺐다.
    TEMPLATE 의 내용 지침 주석도 같은 이유로 줄였다.
    grep 세 줄을 check.py 하나로 합쳤다. 골격 누락 · 링크 안 걸린 로그
    번호 · 깨진 링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
2026-09-17 docs: 로그 39 — 규약을 집행하는 것
    규약을 확정한 커밋이 자기 자신을 목록에 등재하지 않았고, 스킬로 옮겨
    보니 조항 중 지켜졌는지 확인할 수 있는 것이 없었다. 그래서 규범은
    README 에 두고 집행은 스킬이 맡는 구조로 갈랐다.
    스킬로 한 편 써 보고 절반을 잘라냈다. 절차 체크리스트는 로그 38 의
    추기가 출처를 안 가리키는 것을 잡아냈고, 「자주 틀리는 것」 네 줄은
    아무것도 막지 못했다 — 거기 글자 그대로 적힌 규칙을 읽고도 틀렸다.
    로그 38 의 추기가 로그 39 를 가리키도록 갱신하고, 목록에 등재했다.
    규약 확정 후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
2026-09-17 docs: 결정 절은 항상 둔다 · 측정일 범위 · 분리 임계 · 로그 13 절차 제거
    남아 있던 다섯 건 중 넷을 닫았다.
    - `## 결정` 절 생략을 없앤다. check.py 가 이미 필수로 요구하고 있어
    규약과 어긋나 있었고, 결정 없는 로그를 찾아보니 없었다 — 로그 22
    조차 "판정하지 않는다"·"승격하지 않는다"가 결정이다
    - `측정일` 은 세션이 여럿이면 범위로 쓰거나 등록부로 넘긴다
    - 규약이 120줄을 넘기면 FORMAT.md 로 분리한다 (U39-3 닫음)
    - 로그 13 의 Windows 재현 절차를 걷어내고 그 자리에 추기를 남겼다.
    reproduce.py 가 대체했는데도 AI 가 검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
2026-09-17 docs: 로그 32 의 reproduce.py 사용법도 걷어낸다 — 이미 낡아 있었다
    현행이라 위험이 없다고 판단했던 것이 틀렸다. 정본
    docs/build_reproduction.md 와 대조하니 로그 36 에서 id 가 기본 단계로
    승격되며(커밋 db9bad3) 8단계·20분이 9단계·9분으로 바뀌어 있었다.
    판별선이 "로그는 갱신되지 않는 문서라 절차를 담으면 반드시 거짓말이
    된다"고 한 그대로다. 블록을 걷어내고 정본을 가리키는 추기를 남겼다.
    로그 39 의 추기도 같이 정정했다.
    절차가 남은 로그는 이제 없다.
    Claude-Session: https://claude.a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
2026-09-17 docs: 서식 규약을 FORMAT.md 로 분리 — README 는 목록 전용
    임계(120줄)를 기다리지 않고 지금 갈랐다. 규약 105줄이 README 202줄의
    절반을 넘어, 로그 목록이 119줄째에서야 시작하고 있었다. 이 파일의
    본래 일은 목록이고 규약은 로그를 쓸 때 한 번 여는 참고 문서다 —
    독자도 읽는 빈도도 다르다.
    내용은 그대로 옮겼다. 분리로 뜻이 달라지는 두 문장만 손봤다
    (「새 로그를 추가하면」의 "아래 목록 표", 임계 조항 자체).
    로그 38 §8 이 규약 위치를 결정으로 박아 뒀으므로 그 자리에 추기를
    달았다 — §8 이 정한 "CONTRIBUTING.md 가 아니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
2026-09-17 docs: 측정일이 여럿이면 등록부로 넘긴다 — 범위 표기는 뺀다
    같은 날 정한 규칙을 한 번 더 좁혔다. 범위(2026-09-15 ~ 09-16)를
    적어도 어느 칩이 어느 날인지는 chip_registry.md 를 봐야 알 수 있어,
    칸만 채우고 정보는 주지 않는다. 길을 둘 열어 두는 대신 등록부
    하나로 통일한다 — 칩별 이력은 거기가 정본이다.
    로그 39 의 추기도 최종 결정에 맞춰 고쳤다.
    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
2026-09-17 docs(log): 검사기 오탐 3종 수정, 옛 로그 34편 머리말 소급 정규화
    check.py — 통과할 수 없는 로그가 있었다.
    - 결번(31·35·37) 참조: 링크를 걸면 「깨진 링크」, 안 걸면 「링크 안 걸림」으로
    어느 쪽으로도 통과 불가. README 「결번」 줄을 파싱해 제외한다
    - 자기 번호 언급: 자기 자신에게 링크할 수 없으므로 영구 FAIL. 참조 집합에서 뺀다
    - 링크 탐지: `[로그 23 부록 A](...)` 처럼 대괄호 안에 절·부록이 붙으면 링크를
    걸고도 FAIL 이었다. 규약 본문부터 쓰는 관용구다
    머리말 소급 — 소급 금지는 원칙이 아니라 비용이었다(로그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
2026-09-17 docs(log): 결정 ID 도입 — 추기 누락을 기계가 잡는다
    추기는 규약의 핵심 장치인데 붙었는지 확인할 방법이 없었다. 검사기도
    "추기 11곳 — 다 붙었는지는 사람이 본다"까지만 셌다. 분자만 세고 분모를
    못 세는 이유는 결정이 그냥 문장이라 어느 불릿이 뒤집혔는지 기계가
    가리킬 수 없었기 때문이다. 미결에는 `U` ID 가 있어 되던 일이다.
    - `## 결정` 불릿마다 `[D40-1]` ID. 뒤집는 로그는 `[D40-1] 뒤집음` 으로 인용
    - check.py: 인용된 ID 와 추기가 붙은 ID 를 빼서 누락을 MISS 로 뱉는다.
    단순 참조(`[D40-1] 의 연장이다`)는 걸리지 않는다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
2026-09-17 docs: 로그 39 — 근거 포인터 정정과 §1 압축
    - `## 결정` 목록 등재 줄의 근거를 §1 → §2 로. 등재 조항의 실물(로그 38
    자신의 누락)은 §2 에 있다
    - §1 앞 두 문단을 한 문단으로. 이중 출처 원칙과 소비자 둘은 로그 38 §4·§1
    의 재서술이라 걷어내고, 39 고유인 "절별 규칙이 `## 결정` 에 본문 복사를
    시키고 있었다"만 남겼다
2026-09-17 docs(log): 미결 ID 도 검사기가 본다, 결정 ID 소급 제한 해제
    전수조사로 34편을 규약에 맞추기로 했으므로 "로그 40 부터" 는 성립하지 않는다.
    - `FIRST_ID` 삭제 — 결정 ID 를 전편에 요구한다
    - 미결 `U` ID 를 결정 `D` 와 같은 수준으로: 정의·중복·추기 대조
    - ID 는 그 ID 가 사는 절에서만 찾는다 (`D`=`## 결정`, `U`=`## 미결`).
    자기 번호만 정의로 치고 남의 번호가 붙은 불릿은 인용으로 넘긴다 —
    전에는 인용 불릿이 정의로 잡혀 추기 자리를 엉뚱한 파일로 가리켰다
    - ID 안 붙은 불릿과 중복 ID 를 FAIL 로 뱉는다
2026-09-17 docs(log): 「뒤집힌 결정」 절 문장 순서 복구, U 대조를 규약에 반영
    - ID 인용 문장이 추기 첫 줄 설명 한가운데 끼어들어 앞뒤 문장이 갈라져
    있었다. 순서를 되돌리고 ID 인용은 `grep` 예시 뒤 독립 문단으로
    - 인용 형태에 미결을 같이 적는다 — 결정 `[D23-2] 뒤집음`, 미결 `[U38-1] 닫음`
    - `## 결정` 절별 규칙의 "다른 점은 누락을 기계가 센다는 것" 을 걷어냈다.
    검사기가 U 도 대조하게 되어 더는 다른 점이 아니다
2026-09-17 docs(log): 소급 금지를 푼다 — 옛 로그도 규약으로 옮길 수 있다
    소급 금지에는 처음부터 근거가 없었다. 로그 38 결정 불릿에 달린 `— §7` 은
    「대조군 여섯 편」을 가리켜 소급과 무관했고, 규약 확정 커밋(288a523)에도
    한 줄뿐이었다. 지킬 근거가 없으니 옛 로그를 규약으로 옮기는 편이 싸다.
    - FORMAT.md 머리 — "새 로그부터" → "옛 로그도 소급이 가능하다". 강제가
    아니라 허용이라, 한 편씩 옮기는 중간 상태가 정상 상태다
    - 로그 38 그 결정 자리에 추기, 허공을 가리키던 `— §7` 제거
    - 로그 39 가 물려받은 "§7 소급 금지" 오기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
2026-09-17 docs(log): 「규약 이전 서식」 배너 34편에서 제거
    전수조사로 옛 로그를 규약에 맞출 것이므로 배너가 가리킬 상태가 곧 사라진다.
    어느 로그가 아직 옛 서식인지는 파일 안 표시가 아니라 check.py 가 답한다 —
    배너는 이행이 끝나도 남아 스스로 거짓말이 되는데 그걸 잡는 장치가 없었다.
    - 로그 33편에서 배너 블록 제거 (34.md 는 별도 — 표 정렬이 함께 바뀌어 되돌리고
    배너만 다시 걷었다)
    - FORMAT.md 첫 문단에서 배너 전제 삭제
2026-09-17 docs(workflow): 11 신설 — 로그 전수조사 계획
    규약과 검사기가 동결됐으므로 옛 로그 35편을 규약으로 옮긴다. 다섯 단계로 끊고
    단계마다 컨텍스트를 새로 한다 — W11-C(1,738줄)·W11-E(2,264줄)는 그 안에서 또
    쪼갠다.
    - 경계를 먼저 못박았다 — 옮기고 지우기만 한다. 없던 근거를 지어내거나 문장을
    고쳐쓰지 않는다. 편당 diff 에서 추가된 산문이 0줄인지로 검증한다
    - "무엇을 했다"만 있고 결정이 문장으로 없는 편은 채우지 않고 보류 목록에 남겨
    한영웅에게 넘긴다 — 추론해서 채우면 그 추론이 정본이 된다
    - 진행 상태는 기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
2026-09-17 docs(workflow): 11 을 다시 쓴다 — 목표는 서식이 아니라 분량이다
    이 작업의 발단은 로그가 길고 많다는 것이었다. 그러면 본체는 서식을 맞추는
    것이 아니라 지우는 것이고, check.py 통과는 목표가 아니라 검증이다.
    - 삭제를 세 층으로 갈랐다. 판별선에 걸리는 절·블록은 바로 지우고, 로그를
    통째로 지우거나 다른 로그로 흡수하는 것은 제안만 해서 한영웅이 정한다
    - 회색지대는 지우는 쪽으로만 보수적이다 — 애매하면 남기고 보류 목록에
    올린다. 남길까 말까의 비용은 한 편 읽는 값이지만 잘못 지우면 git 뿐이다
    - 삭제보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
2026-09-17 docs(workflow): 11 에 층 4 — 여러 편에 흩어진 하나의 작업을 합친다
    편수를 줄이는 제일 큰 지렛대인데 빠져 있었다. 삭제 3층은 전부 "한 편 안에서
    뭘 지우나" 만 보고, 애초에 한 편이었어야 할 것이 둘·셋으로 갈린 자리를
    못 본다. 전수 훑기로 후보 다섯을 찾았다.
    - 3+4 (결론과 근거가 두 파일) · 6+7+8 (G0 세 조각) · 19+20 (같은 날 G1 기준)
    23+24+25 (설계·구현·검토) · 32+33+34 (reproduce.py 연속 수정)
    - 다섯 묶음이 모두 한 단계 안에 든다 — 기수별로 끊은 덕이라 순서는 그대로다
    - 권한은 층 2·3 과 같이 제안만. 제안에는 본체·넣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
2026-09-17 docs(workflow): 11 재검사 — 구멍 여섯을 메운다
    시작 전에 계획을 다시 훑어 실패 지점을 찾았다. 둘은 그대로 두면 손해가 난다.
    - 층 1 을 절 단위에서 **불릿 단위**로 내렸다. `## 작업 내용` 이라는 이름만
    보고 지우면 본체가 날아간다 — 로그 5 의 그 절 안에 결정·근거·경위·수치가
    섞여 있다. 그런 편이 15편이다
    - 로그를 지우거나 합치면 `docs/log/young/` **밖의 참조 160군데**가 깨지는데
    check.py 는 그 밖을 안 본다. 뒷정리에 전역 grep 을 넣고, 후보별 외부 인용
    수를 표로 실었다 — 23(21건)·24(10건) 은 비싸고 4·19·20 은 0 이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
2026-09-17 docs(workflow): 11 — 자를 글자수로, 못 지킬 조항을 걷어낸다
    로그 5 를 실제로 이행해 보고 고쳤다. 읽어서는 안 나왔을 것들이다.
    - **지표를 줄수에서 글자수로.** 로그 5 는 23줄 1,645자 → 39줄 1,162자였다.
    옛 로그는 한 불릿에 300자씩 밀어넣어 줄수가 적은 것이지 짧은 것이 아니다.
    줄수로 재면 일을 잘할수록 숫자가 나빠진다. 기준선 245,068자
    - **전체가 줄면 된다. 편당 강제는 두지 않는다** — 압축된 불릿을 읽을 수 있게
    펴면 한 편은 늘 수도 있고, 그걸 FAIL 로 잡으면 품질을 깎는다
    - **"추가된 산문 0줄" 을 걷어냈다.** 규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
2026-09-18 docs(log): 전수조사 W11-A·C 이행 — 로그 4·20 병합 결번
    로그 1·2·3·5(A)와 16·17·18·19·21(C)을 서식 규약 골격으로 옮겼다.
    병합 둘을 승인·이행했다.
    - 3 + 4 → 로그 3: 결론과 근거가 두 파일로 갈려 있었다
    - 19 + 20 → 로그 19: 한 문서(s3.g1_test_plan)의 동결 → 개정 2 이고,
    19 만 읽으면 같은 날 뒤집힌 값 넷을 현행으로 읽는다
    로그 4·20 은 결번. 뒷정리로 목록·결번 줄, 외부 앵커(로그 22·23·28 ·
    spec/s1·s3 · workflow/6)를 맞췄다.
    판단 경위 전문은 docs/workflow/11 의 W11-A·W11-C 절.
2026-09-18 docs(log): 전수조사 W11-B·D·E 이행과 마감 — 36편 → 33편
    남은 세 단계를 옮기고 병합 둘을 이행했다.
    - 24 + 25 → 로그 24: 25 의 머리말이 "로그 24가 기록한 커밋 7개"로 대상을
    명시한다. 24 단독은 25 가 반증한 근거를 들고 있었다
    - 33 + 34 → 로그 33: 질문이 "Windows 에서 왜 안 됐나" 하나다.
    미결 승계 중복 두 벌이 한 벌로 걷혔다
    - 6 + 7 + 8 은 합치지 않았다. 같은 날 같은 사슬이지만 결정 집합도
    수신자도 셋으로 갈린다
    로그 25·34 는 결번. 밖에서 절 단위로 인용하는 자리가 많아 근거 절
    안에서는 옛 절 번호를 그대로 뒀다.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
2026-09-18 docs: 「3인 추인」을 걷는다 — 합의된 적 없는 표기였다
    전수조사 중 로그 6·8 이 "7/8 추인 대기"로 두 달 넘게 열려 있는 것을
    발견했다. 계약은 이미 2026-07-08 에 단독 판단으로 확정돼 있었고,
    확인하니 추인 절차 자체가 합의된 적이 없다 — AI 가 문서에 얹은 표기가
    제지 없이 굳은 것이다.
    그런데 표기가 제도처럼 작동해서 workflow/6 R 트랙 5건이 「대기 — 우리가
    못 닫는다」로 통째로 멈춰 있었다. 성질이 다른 다섯을 일괄 게이트가
    묶어 세운 것이다.
    폐지가 아니라 표기를 걷는 것으로 처리했다. 실제 3인 결정은 이미 정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
2026-09-18 feat(contract): §6 — 무효 사유 ⑦⑧ · CSV 17열로 무효 사유를 기록한다
    구현이 앞서가고 계약이 안 따라온 자리 둘을 닫았다.
    1. 무효 사유 ⑦ line_dead_* · ⑧ no_window
    2026-07-08 구현에 들어갔으나 계약에는 없었다. 처음엔 "①~⑥ 은 계약
    위반, line_dead 는 하드웨어 고장이라 성질이 다르다"로 봤는데 그
    논거가 틀렸다 — ③(MMCM_LOCKED=0)이 이미 하드웨어 상태다. 무엇보다
    ①과 line_dead 는 같은 고장의 두 얼굴이다: 루프백은 단선이 TIMEOUT
    으로 나타나지만 합성 프리앰블을 쓰는 실칩 SPI 는 단선에도 완주한다.
    현상만 올리고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
2026-09-18 docs: cocotb 환경 및 smoke 기준선 기록
2026-09-18 docs(seeun): add temperature bench design
2026-09-18 young@young-PC:~/dev/flash-margin-bench$ uv run python host/analysis/bathtub_analysis.py data/sweep_chip01_20260823T130847Z.csv --json [R8] 동반 원본(sweep_chip01_20260823T130847Z_reads.csv) 무결성 검사 통과 [r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
    == 폭 3종 (병행 기록) ==
    width @ BER=0.01 : 39741.65 ps
    width @ BER=0.001 : 39729.82 ps
    width @ BER=0.0001: 39717.99 ps
    == theta 확정 체크리스트 ==
    1. 가우시안(probit R²): SKIP(적합점 부족) [- / -, 기준 0.98]
    2. BER floor : PASS [실측 0.0 (상한 3.25e-09), 기준 < 1e-05]
    3. sigma_j 추출 : left - ps / right - ps ->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
2026-09-18 docs(interface): 수정안 #1·#2 를 「한영웅 확정 — 본문 반영 대기」로 표기
    #3 과 같은 상태가 됐다. 본문은 v1 그대로이며 표기만 바뀐다.
2026-09-18 feat(interface): P/E 엔진 경계 7개 — 상정안
    마모 엔진(박지민 스펙) ↔ 호스트·TB(한영웅) 의 경계를 상정안으로 세운다.
    로그 29 §9 의 초안으로 S-1 §13 을 두드려 보니 A5(경로 간 일치)가 성립하지
    않았다 — tally 를 읽을 수단이 없어 네 경로 중 하나가 통째로 빠져 있었다.
    더한 셋은 전부 A5 를 보기 위한 것이다 (tally_read · uid_read · wear_resume).
    뺀 둘은 wear_times(§9 A 로그와 이중 출처) 와 log_tail(로그는 호스트가 갖는다).
    박지민 스펙이 이 경계를 받아 확정한다. 층위(RTL / PS C)는 스펙이 정하고
    이 문서는 밖에서 보이는 모양만 정한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
2026-09-18 docs(spec): S-4 블랙박스 TB 사양서
    구현자가 짠 채점표를 무엇으로 믿나 — 엔진 스펙이 확정되기 전에 커밋해
    「판정하는 쪽이 답을 모르는 상태에서 기준을 세운다」를 시각으로 성립시킨다.
    - §2 항목별 판정처 — mock 에서 보는 것과 실칩에서만 보는 것을 가른다
    - §3 주입 고장 — 중단 5종(진행이 멈춘다) · 전송 손상 5종(바이트가 틀리다).
    고르는 기준은 빈도가 아니라 「채점표를 틀리게 만드나」
    - §4 경계 오용 — tally 섹터 침범·용량 초과·tally 미초기화 등 거부 7줄
    - §5 「제안-」 6건 — 경계에 없어서 아직 채점 못 하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
2026-09-18 test(host): 블랙박스 TB — 가짜 엔진·채점표·자기검증
    S-4 의 채점표를 pytest + Hypothesis 로 실행한다. 33개 통과.
    - mock_engine.py 경계 7개 + 고장 주입(10) + 버그 주입(6)
    - host_side.py 행 문법·파서·재개 판단 — 제안-1·3·4·5 의 실물
    - harness.py check_A1~A5 · C · resume. 검사를 테스트가 아닌 함수로 둔다
    - test_faults.py §13 B 를 Hypothesis 로 — 시점을 나열하지 않고 성질을 적는다
    - test_tb_catches_bugs.py 버그를 심어 지정한 항목이 깨지는지 본다
    경계는 Python 함수다. 제안-1(호출면 문법)이 닫히기 전에 UART 문자열을
    고르면 그것은 발명이고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
2026-09-18 docs(concepts): 13 — 마모의 두 얼굴
    마모가 드러나는 방식이 둘이고 뜻이 아주 다르다.
    - ① 셀 죽음: 값이 안 써진다. 위상을 옮겨도 안 고쳐진다 → 바닥이 들린다
    - ② 여유 축소: 값은 있는데 읽을 여유가 없다 → 벽이 눕는다
    차이는 「많이 vs 적게」가 아니라 **「고칠 방법이 있나」**다. ②는 클럭을
    낮추면 여전히 읽히고 ①은 어떤 타이밍으로도 못 읽는다.
    그래서 ②를 재서 ①까지 남은 거리를 역산하는 것이 이 프로젝트의 논지다 —
    타이어가 터질 때까지 기다리는 대신 홈 깊이를 재는 것과 같다. 관계를
    세우려면 ①까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
2026-09-18 docs(log): 41 — 블랙박스 TB 와 엔진 인터페이스
    구현자가 짜는 채점표를 어떻게 믿나. 결정 25건, 미결 1건.
    되짚어 고친 것들을 그 자리에 남겼다 —
    - 「스펙을 읽어야 제안을 만든다」는 순환이라고 본 것이 틀렸다. TB 가 막히는
    자리가 그대로 제안이 된다 (§7)
    - 주입 목록을 두 번 잘못 그었다. 「전부」도 「자주 만나는 것」도 기준이
    틀렸고, 맞는 기준은 「채점표를 틀리게 만드나」다 (§6)
    - §8.3 의 「큰 쪽 채택」과 U41-4 의 전제가 둘 다 틀렸다. tally 해상도가
    100 이라 부등호로는 아무것도 안 가려진다 (§12)
    - TB 전용 tal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
2026-09-18 docs: 「폴더 = 소유자 1명」을 권장으로 · host/tests 등재
    가짜 P/E 엔진이 갈 곳을 잃는 자리가 있었다 — 흉내 내는 대상은 엔진(박지민
    영역)인데 쓰는 쪽은 호스트 TB(한영웅)다. 소유자가 애매하다는 이유로 파일을
    엉뚱한 곳에 두는 것이 더 나쁘므로 필수에서 권장으로 낮춘다.
    판단 기준은 「누가 만드나」가 아니라 「누가 쓰나」다.
    표에 host/tests/ 를 넣고, interface/ 항목에 pe_engine.md 를 붙였다.
2026-09-18 docs(spec): T5 를 사실에 맞추고 열람 금지선을 커밋 시점으로
    T5 가 「커밋 시각이 스펙 도착보다 앞선다」였는데 스펙은 이미 한영웅에게 와
    있었다. 지켜진 것은 **구현자의 열람 전**이므로 문구를 고친다. 그 시점은
    570a0c29(태그 tb-pre-spec)이고 GitHub 원격에 올라가 있다.
    증거는 태그가 아니라 커밋 해시와 push 다 — 태그는 -f 로 옮길 수 있지만
    해시는 못 옮기고, 원격에 올라간 것은 셋이 같이 보는 기록이다.
    §8 의 금지선을 ③ 에서 ② 로 앞당긴다. 커밋 전에는 「안 봤다」를 사람의
    진술로만 증명할 수 있었지만, 커밋·push 뒤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
2026-09-18 docs(spec): S-4 머리말 — 지민의 커밋된 로그와 설계 스펙을 구분
    로그 41 이 docs/log/jimin/ 의 작업 로그 2·3 을 인용한다. 리포에 공개된
    참조이지 이번에 온 P/E 엔진 설계 스펙이 아니다 — 적어 두지 않으면 나중에
    「지민 문서를 인용했는데 안 봤다고?」가 된다.
2026-09-18 docs(spec): 지민 스펙 대조 — S-1 §1·§8 개정 · 경계 3·4 · S-4 §5 뼈대/재량
    박지민 P/E 엔진 스펙(docs/log/jimin/2, 2026-09-15)을 S-4 §5 제안 6건과 줄 단위로
    대조한 결과를 반영한다. 스펙이 S-1 을 따랐던 두 곳은 우리 쪽이 틀린 것이어서 먼저
    고쳤다 — 고치지 않고 요구하면 그대로 되돌아온다.
    - S-1 §8.2 「큰 쪽 채택」을 tally 2벌 병합으로 한정하고 이름을 가른다.
    |a-b| > 100 은 정상 차단으로 설명되지 않으므로 중단하고 사람을 부른다
    - S-1 §8.3 tally 와 호스트 로그의 부등호 비교를 폐기하고 d 3구간 + d>=100 분기로
    대체한다 ([D41-20]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
2026-09-18 test(host): 개정 사양에 TB 를 맞춘다
    - decide_resume 에 2벌 차이 > 100 중단 갈래 (S-1 §8.2 개정) + 케이스 1건.
    「큰 쪽 채택」이 아니라 「병합」이라는 것을 함수 주석에도 반영한다
    - B 행과 blank_check 에 worst_page_idx·worst_page_bits (경계 4 개정)
    - test_every_fault_has_a_case 의 read_text 에 인코딩을 고정한다 —
    Windows 기본 cp949 로 한글 소스를 읽다 UnicodeDecodeError 로 죽어
    「한 명령으로 재실행된다」(S-4 §7 T4)가 이 노트북에서 서지 않았다
2026-09-19 docs(spec): S-1 개정 4건 — 2벌 병합·d 규칙·카운터 계수·검사 순서
    로그 41 [D41-20]·[D41-21] 과 로그 42 에서 정해 놓고 본문에 반영하지 않았던 것들을
    반영한다. 지민에게 "S-1 을 고쳤다" 고 보내면서 열어 보면 옛 문장인 상태를 없앤다.
    - §8.2 「큰 쪽 채택」을 tally 2벌 사이로 한정하고 「2벌 병합」으로. 차이가 1바이트(100)
    이하면 큰 쪽 병합 + 불일치 기록, 넘으면 중단하고 사람을 부른다
    - §8.3 호스트 로그 대조의 「큰 쪽 채택」을 폐기하고 d 규칙으로. tally 해상도가 100 이라
    tally < 호스트로그 가 늘 참이어서 부등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
2026-09-19 docs(interface): P/E 경계 3·4 개정 — 재료 반환·worst_page·재소거 구멍
    블랙박스 TB 를 채점 가능한 형태로 짜다 경계 쪽에서 세 가지가 드러났다.
    - 경계 3 wear_resume() → (tally_a, tally_b, mismatch, next_tally_byte, write_ok).
    초안의 source("tally 에서 왔는지 호스트 로그에서 왔는지")는 엔진이 호스트
    로그를 모르므로 성립하지 않았다. 엔진은 재료만 주고 판단은 호스트가 한다
    - 경계 4 defect_addr_count·worst_page_idx·worst_page_bits 추가. §9 B 로그가
    요구하는데 초안 경계에 빠져 있었다
    - 제안-9 §8.3 4 의 재소거를 부를 수단이 7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
2026-09-19 docs(spec): S-4 보완 — 기본값 전문·제안 7~10·집행 장치
    회신이 가리키는데 실재하지 않던 절을 만들고, 표에만 적혀 있던 조건에 집행 장치를 붙인다.
    - §5.2 신설 행 문법·체크섬·거부 코드 6종·인코딩·단위의 기본값 전문. 회신이 세 군데서
    인용하는데 이 절이 없었다
    - §5 제안-7(checkpoint_due)·제안-8(카운터)·제안-9(재소거)·제안-10(검사 순서)
    - §2 B 는 통과 조건이 둘이라는 것, A7 은 절반이 로그 쪽이라는 것을 명시.
    표 밖 항목(resume·probe)도 적는다
    - §3.2 비트 반전 주입은 숫자가 숫자로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
2026-09-19 test(host): 블랙박스 TB 미비점 보완 — B 두 조건·양성 대조·집행 장치
    사양서가 "본다" 고 적은 것과 코드가 재는 것이 갈라져 있었다. 33 → 48 케이스.
    - §13 B 의 두 번째 통과 조건(소거 중 차단 → 부분 소거 → 재소거)에 assertion 이 하나도
    없었다. mock 이 잔류를 "있다/없다" 까지만 들고, host_side.resume() 이 §8.3 을
    엔진/호스트로 갈라 밟고, check_B 가 두 조건을 다 잰다
    - T6 를 양방향으로. 「항목마다 그것을 깨뜨리는 버그」를 켜니 A2·A7·B 가 비어 있었다.
    버그 6 → 10종
    - T1·T3 에 집행 장치. 표에서 항목이 빠져도 초록불이 나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
2026-09-19 docs(log): 42 — 블랙박스 TB 미비점과 지민 회신 정합
    표에 적힌 것과 실제로 재는 것이 갈라지지 않게 하려면 무엇이 집행되어야 하나.
    - 집행 장치가 없는 인수 조건은 비어도 초록이 난다 — T1·T3·T6 역방향
    - tally 는 장부이지 마모의 증거가 아니다. 증명은 상태 전이의 쌍뿐이고,
    S-1 §7 이 그것을 요구하는데 §6 루프가 자리를 안 만들고 있었다
    - "구조적으로 안 보인다" 가 과장이었던 경위와, 세 안(A/C/B) 중 C 를 고른 이유
    - 로그 41 [D41-9] 에 부분 소거 예외 추기
2026-09-19 docs: P/E 엔진 스펙 회신 — 박지민 전달본
    docs/log/jimin/2 (9/15 구현용 AI 프롬프트) 에 대한 회신. 전달용 임시본이고 정본은
    docs/spec/s4.blackbox_tb.md §5·§5.2 와 docs/interface/pe_engine.md §2 다.
    - 표지 — 답이 꼭 필요한 것 4개, 기본값 없이 지민이 정하는 것 3개, 안 읽고 넘기면
    굳는 §4 표 10줄, 무엇이 바뀌나 5줄
    - §1 S-1 개정 4건(반영 완료) · §2 경계 7개 · §3 뼈대 8건 · §4 재량 13줄
    - §5 첫 프롬프트 수정사항 — HEAD 의 실제 코드와 대조한 것만
    - §8 TB 가 보증하는 것과 못 하는 것
2026-09-19 docs(log): 42 정정 — fetch 를 안 해 같은 일을 두 번 했다
    §6 이 "'고쳤습니다' 는 사실이 아니었다" 로 적혀 있었는데 그 전제가 틀렸다. 로컬이
    d6f6a28 에서 fetch 되지 않은 상태였고 S-1 §8.2·§8.3·§1 개정은 9/18 에 이미 원격에
    있었다. 회신의 원래 문장이 맞았다.
    - [D42-7] 에 되돌림 추기, [D42-10] 추가 (겹친 작업을 고르는 기준)
    - §6-1 로 오판이었음을 표시하고, 당시 기록은 §9 의 근거라 남긴다
    - §9 신설 — 세 가지를 사실과 다르게 적은 경위, 9/19 의 순 기여가 무엇인지,
    합칠 때 원격이 이긴 자리들, 교훈(진단 전에 fetch)
2026-09-19 docs: 회신 최종 검토 — 인용·숫자 정정
    보내기 전 전문 대조에서 나온 것들.
    - S-1 §8.3 의 재소거가 4번 → **5번** 이 됐다(머지로 절차가 6단계가 됐다). 회신 3곳과
    pe_engine·로그 42·host/tests 의 참조 4곳을 같이 고친다
    - 본문이 제안-2·3·4 를 쓰는데 §4 표에 그 라벨이 없어 지민이 번호를 찾을 수 없었다 —
    로그 행 문법=제안-3, 체크섬=제안-4, 오류 코드=제안-2 로 표기
    - 기준을 "커밋 d6f6a28" 에서 "GitHub main 최신(2026-09-19)" 으로. §5 머리말·§5.3 도 같이
    - 표지 크기 29KB → 40KB · §5.2 항목 수 여섯 → 일곱 · 중복 구분선 제거
    - 정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
2026-09-19 docs: 회신을 to_jimin_20260919.md 로 옮기고 표지 D-1 정정
    표지 D-1 이 폐기 대상을 잘못 짚고 있었다. 지민 프롬프트에 「큰 값」이 나오는 자리가
    둘이고 서로 다른 일이다.
    - :353-354 "두 tally가 다르면 큰 값을 채택하되 불일치와 두 원래 값을 기록" — 2벌은
    눈금이 같아 이것은 **병합**이고 살아 있다. S-1 §8.2 가 그 문장을 거의 그대로 두고
    >100 중단 상한만 더했다
    - :365 "가장 큰 확실한 완료값을 후보로 선택" — tally 와 호스트 로그는 눈금이 달라
    (100 대 1) 부등호로 아무것도 안 갈린다. [D41-20] 이 폐기한 것이 이쪽이다
    표지만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
2026-09-20 docs(log): P/E 엔진 스펙 검토 학습 기록 추가
2026-09-20 docs: 전수 측정 chip07~10 기입 — UID 4건 · chip05 는 분모에서 뺀다
    2026-09-20 에 chip07~10 을 마쳤다. UID 와 최초 측정일을 등록부에,
    P/E 증분 4행을 이력에 넣는다 (기계가 기입한 것을 확인).
    chip05 는 JEDEC 무응답이 누적 4회(9/16 3회 · 9/20 1회)라 UID 를
    확보하지 못했다. 전수 측정의 분모를 n=9 로 확정하고 그 사실을
    등록부 용도 칸에 적는다 — 빈칸으로 두면 "아직 안 쟀다"로 읽힌다.
    chip10 의 UID 는 앞바이트가 DF 로 나머지 아홉(D1 6x)과 다르다.
    같은 날 재측정 3회에서 같은 값으로 재독돼 오독이 아님을 확인했다.
2026-09-20 docs(spec): S-2 — 칩별 배선 명문화 · 재현 기준 3ps→3σ_repeat · 앵커의 한계
    세 가지가 문서와 실물이 어긋나 있었다.
    1. 측정 구성 (§3.3 신설). 칩 10개는 배선을 공유하지 않는다 — 칩마다
    점퍼 6가닥이 딸려 있고 핀헤더를 JB 에 꽂는다. 사양서는 "소켓 교체",
    런북은 "모듈 암수 점퍼 직결" 한 벌로 적혀 있어 공유 배선처럼 읽혔다.
    이 차이가 수치의 의미를 바꾼다 — 칩 간 차이는 전부 "칩 + 그 배선"이고,
    재장착이란 칩과 배선을 한 벌로 다시 꽂는 일이다.
    2. 재현 기준 (§6.2 개정). 3ps 는 chip01 을 빼지 않고 연속 5회 재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
2026-09-20 docs(results): 전수 측정 판정과 인수 — 이상치 채택 · §6.3 분해 · A1~A4
    chip07~10 네 행을 채우고 판정을 닫는다.
    이상치: 후보는 chip10 하나(−911.8ps, 3σ 밖). 재측정 2회가 26.8ps 안에
    재현돼 개체 특성으로 채택하고 빼지 않는다 (재현 기준은 S-2 §6.2 개정분).
    다이인지 그 배선인지는 미정이나 어느 쪽이든 처방은 같다.
    §6.3: σ_repeat = 13.86ps(chip10 재장착 3회) · σ_between = 353.3ps
    → 분해된다. 칩당 1회로 종료하고 전 칩 3회 재측정은 집행하지 않는다.
    G-a: 앵커 chip02 는 판정선 밖(−302.8 ~ −380.2ps)이었으나 원인이
    측정계가 아니라 그 조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
    [newchip_survey_2026-09.csv]
2026-09-20 docs(workflow): 10 — M·G 닫고 N·V·C 를 연다
    W10-M(전수 측정)과 W10-G(판정)를 종료 처리한다. G5 ① 이 임계 경로에서
    빠지고, 남은 셋이 드러난다.
    새 트랙 셋:
    - W10-N 예상 노화 이동량 Δ. G5 ② 는 "노이즈 플로어가 예상 노화 이동량
    대비 충분히 작음"인데 분모(13.86ps)만 있고 분자가 문서 어디에도 없다.
    실측으로 정하려면 마모를 시작해야 하는 순환이라, 하한을 사전 등록하는
    쪽을 후보로 적었다. 착수 전에 수치가 있어야 사후 해석을 면한다.
    - W10-V 전원 장애 복구 시험(S-1 §13 B). 6일 무인 구동의 전제인데
    한 번도 안 돌려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
2026-09-20 docs(log): 43 — 앵커가 고장난 채로 전수 측정을 끝냈다
    하루에 진단이 세 번 뒤집혔고 그 경위가 이 로그의 재산이다.
    측정계가 밀렸다 → 아니다, 한 조립체가 고장났다.
    σ_repeat 40.25 → 137.33 → 13.86ps.
    담은 것: 유효한 런과 해석 가능한 런의 구분, 지표별로 채택을 가른 이유
    (width 만 보류하고 소거·blank 는 채택), 기준 개체가 자기 열화를 보고
    있으면 게이트가 자기 참조가 된다는 것, 배선이 칩마다 따로라는 사실이
    문서에 없어 "재장착 σ"가 무엇의 산포인지 알 수 없었다는 것.
    미결 일곱 중 넷은 같은 날 닫혀 그 자리에 추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
2026-09-20 docs(spec): 경계 9개·S-4·S-1 잠금 — 로그 44 결정 반영, 로그 29 추기
2026-09-20 docs(results): 신품 조사 — chip01 회수분 (소거·blank_post 채움, 25MHz 4런 무효)
    [newchip_survey_2026-09.csv]
2026-09-20 test(host): TB 를 잠근 정본에 맞춤 — S-4 §5.2 문법 정본화 · 경계 9개 · 거부 11종 · J · HALT · R 행
2026-09-20 feat(ps): flash_prep 체크포인트 모드 — 빌드 타임 base·n, tally·TB 영역 하드 가드 (_Static_assert)
2026-09-20 feat(ps): 마모 엔진 flash_wear — UART 명령 채널·상태기계·S-1 §6 루프·tally·R 행, flash_io 프리스케일러 진입점
2026-09-20 feat(sim): 호스트 시뮬레이션(fake NOR·파이프)과 UART 어댑터 — C 엔진을 같은 TB 로 채점
2026-09-20 feat(host): run_wear 실행기 — accept·resume·status·halt·tally·dump·uid, 승인 플래그 없이는 START 없음
2026-09-20 docs(log): 45 — P/E 엔진 구현, 실칩 앞에서 멈췄다 (44·45 등재)
2026-09-20 docs(workflow): 12 — P/E 엔진 실칩 인수 런북 (돌리는 법·읽는 법)
2026-09-21 docs: build_2024.2 삭제 반영 — 보험 비트 pl4/pl6 은 미리 굽지 않는다 (어긋났을 때 굽는다)
2026-09-21 chore(ps): program_g0·g3 주석의 죽은 BUILD_DIR=build_2024.2 예시 정리
2026-09-21 docs(data): data/README 최신화 — 9월 실칩·세션 로그까지 보관 현황에 넣고, _reads 유일본 경고
2026-09-21 feat(reproduce): tb·wear 단계 추가, prep 완료 문구 갱신 — WSL 조원 절차(usbipd)와 §3.5·§5.3 문서
    - tb: 블랙박스 TB(pytest) 를 검증 루프에 넣고 gcc 를 선검사에 넣는다
    - wear: flash_wear.elf 를 굽고 로그의 git_rev 가 HEAD 와 같은지 ⑥ 으로 대조한다
    - prep: 체크포인트 모드 커밋 뒤 바뀐 '== done (default 0~127):' 를 채점 문구로
    - 문서: §3.5 wear · §5.3 TB · §1 WSL2(usbipd --auto-attach, 미검증 표시) · §7 트리
2026-09-21 feat(wear): accept 의 probe 와 tally 소거(경계 10 TALLY_ERASE) — 실칩 전 마지막 두 자물쇠
    - probe: accept 가 멈춘 직후 BLANK, program_fail_bits 가 전량(229,376)이어야 PASS. verdict 9번째 줄
    - TALLY_ERASE uid=<16hex>: idle 에서만, UID 가 소켓의 칩과 같을 때만(E_UID), 범위는 상수 512·1,536
    - run_wear.py tally-erase: --i-approve-tally-erase + 사람이 UID 타이핑 + 지우기 전 값을 chip_pe.md 에 먼저
    - 문법 정본: uid 는 문자열로 고정(숫자 UID 가 int 로 새지 않게), clean 은 int, 거부 12종
    - 사양: pe_engine §2 경계 10 · §3 예외, S-4 §4 E_UID · §5.2 · §9, S-1 §8.1, 런북 12 §3.3·§4·§7
    - TB 114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
2026-09-21 docs(log): 46 — probe 와 tally 소거, reproduce 가 wear 를 굽는다 (등재)
2026-09-21 docs: 문서 3층 — 명령은 commands.md 한 곳, 흐름은 파이프라인, 워크플로는 그날의 순서 (로그 47)
    - operating_manual.md → commands.md 개명. 명령만(언제·무엇·남는 것·실패 시 볼 곳), 「왜」 문단은 project_pipeline §2.1 로
    - 최상단은 reproduce · run_sweep_chip · run_wear 셋. 분석기는 중하단(§4 「분석만 다시」)
    - gate_map: 명령 블록을 commands 절 링크로, G5 절 신설. build_reproduction 최상단 사용법은 §1 링크로
    - workflow/README.md 색인 신설(12편 · 지금 열). 런북 12 에 명령 정본 표시
    - README: 담당 역할·디렉토리 안내·진행 상태 절 제거(정본 roles·CONTRIBUTIN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
2026-09-21 feat: add TMP117 Arduino bring-up test
2026-09-21 fix(rtl): enforce watchdog timeout at T_max
    [flash_ctrl.v, flash_spi_ctrl.v]
2026-09-21 feat(wear): 계획 승인 화면·체크포인트 자동 측정·칩과 장부 대조 — accept 한 줄로 파일럿을 돈다
    사람이 주는 것은 칩과 「앞 몇 점을 볼지」 둘뿐이다. 나머지는 기본값이고, START 전에
    계획 한 장을 띄운 뒤 enter 를 받는다 — 승인의 자리를 플래그에서 화면으로 옮겼다.
    --i-approve-real-pe 는 그 화면을 건너뛰는 비대화형 열쇠로 남는다.
    - 태울 자리를 --base-sector 로 연다 (기본 마모 그룹 0~6, TB 1,000 은 인수 시험에서 명시).
    TB_BASE → WEAR_BASE_*, 스윕의 --base-sector(읽는 창)와 도움말에서 갈랐다
    - 체크포인트 고정 12점 (S-1 §11 을 tally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
2026-09-21 docs: 파이프라인을 축 중심으로 · 명령 싱크 · 문서 다섯의 성격을 머리 한 줄로
    - project_pipeline: 축 넷(계측기·신품·마모·환경)을 「무엇을 하는가 · 사람이 하는 일 ·
    나오는 것 · 지금 막힌 것」 네 칸으로 통일. 파일의 흐름은 있었는데 사람이 무엇을 판단하는지가
    없었다. 낡은 사실도 걷었다 — 마모 엔진 「미구현」, 없는 옵션(--n-reads), 해소된 미결
    - commands §3: --base-sector·--to·--confirm-first·--checkpoints·--no-measure 반영,
    --delta 제거. sim 연습은 임시 장부를 쓰고, probe 는 --base-sector 를 명시한다
    - 런북 12: 인수 시험의 위상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
2026-09-21 docs(log): 48 — 파일럿 마모 실행기, 승인은 계획 화면에서 (등재)
    tally 는 영역을 세지 않아 안 지우면 x축이 통째로 밀린다 · 플래그는 읽지 않고도 칠 수 있다 ·
    누적으로 채점하면 이어 돌리기가 영원히 FAIL · 계측기 교체는 곡선 안이 아니라 칩 경계에서.
    [D41-23]·[U44-8] 에 추기, README 목록에 등재.
2026-09-22 feat(uart): 보 레이트를 옵션으로 — xsct 가 ELF 의 g_uart_baud 를 실행 직전에 덮어쓴다
    - 펌웨어: UART_BAUD 상수 → 전역 변수 g_uart_baud(초기값 921600). flash_io.c 와 g0_sweep.c
    - program_g2/g3.tcl: dow 뒤 con 앞에 UART_BAUD 환경변수가 있으면 print -set 으로 덮어쓴다. 없으면 그대로
    - run_wear.py: --baud → --wear-baud(마모 링크·prep) + --sweep-baud(체크포인트 스윕). 기본 둘 다 921600.
    921600 스윕에서 CSV 행이 빠지는 PC(지민)는 --sweep-baud 115200 만 붙인다
    - run_sweep_chip.py: --baud 가 펌웨어까지 걸린다 (종전엔 호스트 포트만)
    - 계획 화면: baud rate 행(마모 · 스윕) 추가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
2026-09-22 docs(log): 49 — 보 레이트는 옵션, xsct 가 실행 직전에 덮어쓴다 (등재 · 워크플로 11·12 추기)
2026-09-22 docs: chip01 신품 25MHz x=0 확보 — 집계표 n=9 · W10-A 닫음 · 파일럿 선행 조건 (로그 50 등재 · 28·45·48·49 추기)
    - 집계표 §1 chip01 39,659.0ps(2차 39,661.5 재현 증인), §4 n=9 재산출(결론 불변), §6.3 σ_between 333.9, §8 A1 충족·M 트랙 닫음
    - 워크플로 10 W10-A 종료·G5 ① 충족 / 워크플로 12·commands.md 에 신품 스윕 선행 한 줄
    - run_wear.py CHECKPOINTS 주석의 '0 은 이미 있다' 전제 정정
    - 등록부: chip01 파일럿에 가장 무난한 개체 · chip02 드리프트 앵커 마모 금지
    - chip_pe.md 는 파일럿이 체크포인트마다 행을 붙이는 중이라 제외
    [newchip_survey_2026-09.csv]
2026-09-22 docs(log): 46→45 · 50→48 병합 — 후속 로그는 원 로그의 절로 (46·50 결번)
    - 45 §12~§16 · D45-12~17 · U45-4~6 (구 46), 48 §8~§11 · D48-9~13 · U48-4~5 (구 50)
    - 다른 로그의 '로그 46/50' 인용을 새 자리로, README 요약 합치고 결번 등재
2026-09-24 fix(wear): 타이머 µs 변환 15.37h 오버플로 — 가짜 wip_timeout · A6 는 인수 시험에서만 (로그 45 §17 · 48 §12)
    - ps/src/wear_plat_zynq.c: t×10⁶/cps → 초·나머지 분리. chip01 파일럿 122,164사이클(부팅 15.37h)에서 실제로 넘쳐 섰다
    - run_wear.py judge_accept(erase_check=): A6 는 TB 영역 인수 시험에서만, 마모 런 verdict 8줄. 시험 +1 (128)
    - S-1 §15 추기(파일럿 정지 기준·가설 H1/H2), 워크플로 12·commands 정정, chip_pe.md 파일럿 행
    [run_wear.py, wear_plat_zynq.c]
2026-09-24 fix(wear): 구간 대기 상한 2.0 → 4.0 s/사이클 — 소거가 길어진 마모 런에서 호스트가 엔진보다 먼저 죽지 않게
    [run_wear.py]
2026-09-24 fix(wear): START 전 장부 보정은 장부가 못 따라온 만큼만 — error 정지 뒤 재개에서 +64 이중 기입 방지
    - ledger_correction(cycle, tally, wear): tally 가 아니라 장부 합계 기준. host_died 는 종전대로 +37, error 정지(+done 기록됨)는 0
    - 시험 +1 (129)
    [run_wear.py]
2026-09-26 docs(wear): chip01 파일럿 300k 장부 기입 · 등록부 비고 — 소켓에서 빼 보관, 고온 유지 시험 전 prep 금지
2026-09-26 docs(concepts): 개념 14 NOR 프로그램·소거와 마모 신설 · 개념 13 에서 링크
2026-09-26 docs(results): 수치(data/)와 해석(results/ 바로 아래)을 가른다 — 신품 집계표를 표·기록과 해석 문서로 분리 (절 번호 유지)
2026-09-26 docs(results): P/E 파일럿 chip01 0→300k 승격 — 체크포인트 12점·300k 25/45/75MHz·섹터별 소거/프로그램 표와 해석 (H1·H2 참)
    [wear_pilot_chip01_2026-09.csv]
2026-09-26 docs(log): 로그 48 §13·§14 — 파일럿 300k 결정(종단 100k·13점 격자·보드 배분)과 결과 승격·75/45MHz 기준선·고온 유지 시험 전 prep 금지
2026-09-26 feat(wear): 종단 3칩 사전 등록 — CHECKPOINTS 13점 100k 격자 · S-1 §15 H3-H5·두 층 역산 (H3 추정법·21±4ms·21섹터 전부)
    - run_wear.py CHECKPOINTS = 100 · 1k · 3k · 10k-100k(10k 간격), --to 기본 = 100,000 (정격 내구)
    - S-1 §15 2026-09-26 추기: 파일럿 결과, 종단 결정, 사전 가설 H3-H5 · H1'·H2', 블라인드 역산 두 층
    - H3 판정식에 추정법을 박음 — 칩별 상대 문턱(최대 상승의 중점), 두 수준 중앙값의 차. chip01 19.7-22.0ms
    - 프로그램 시간 벌어짐 시점 227k → 약 145k 정정 (A.txt 섹터별 1k 중앙값)
    - 시험: 13점 격자에 맞춰 갱신, 긴 간격 쪼개기는 파일럿 간격으로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
2026-09-26 fix(wear): --chip 기본값(chip01) 제거 — accept·resume·tally-erase 필수
    chip01 이 소켓에 꽂힌 채 --chip 을 빼먹으면 기본값과 UID 가 우연히 맞아 고온 유지 시험 시료를
    태울 수 있었다. 사람이 선언하고 기계가 UID 로 검증한다. 읽기 명령은 그대로.
    - 명령 예시(commands §3 · 런북 12 · build_reproduction) 에 --chip 을 붙임
    - 연습 명령의 임시 장부에서 chip01 행을 뺌 — 장부의 chip01 300k 와 sim 칩 0 이 어긋나 연습이 막혔다
    - 시험 130 passed (--chip 없이 거부하는 시험 추가) · 로그 48 [D48-23]
    [run_wear.py]
2026-09-27 docs(wear): chip03 종단 100k 장부 기입 · 등록부 — chip03 종료(100k 뒤 75/45MHz · newchip), chip04 종단 2 · chip06 종단 3
2026-09-27 docs: to_jimin_20260919.md 삭제 — 내용은 S-4 §5.1·§5.2 와 pe_engine.md §2 에 편입, 로그 42 에 원문 위치 추기
2026-09-27 docs(results): 종단 chip03 0→100k 승격 · S-1 §15 판정과 H6 예측 — H1′ 참 · H2′ 거짓 · H3-H5 판정 불가 · 근접 대조군 128KB 교란 (로그 48 §15)
    [wear_endurance_chip03_2026-09.csv]
2026-09-29 feat(ps): flash_prep 섹터별 프로그램 시간 출력 — #PREP PROGRAM <sector> <us> · SUMMARY
    페이지 프로그램 루프에서 PP 전송 완료~WIP 해제를 재고 섹터마다 16페이지 합을
    "#PREP PROGRAM <sector> <us>" 로, 끝에 "#PREP PROGRAM SUMMARY" 로 낸다. 전송
    시간을 빼고 WIP 만 더한 것이라 마모 루프 A 행 t_program_us(S-4 §9)와 같은
    정의다. 단 prep 패턴은 PRBS, A 행은 0x00 이라 프로그램할 비트 수가 달라 값이
    다를 수 있다 — 맞대기 전에 확인 런으로 본다 (S-2 확인 출력 목록에 명시).
    기존 문구는 그대로다 — run_prep 은 UID/PASS/FAIL/ERROR 토큰만 보므로 새 줄은
    통과하고,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
    [flash_prep.c]
2026-09-29 docs(wear): 종단 3 을 chip06 → chip07 로 교체 — 느린 무리임을 알고 고르고 "계단 없음" 예측을 마모 전에 (로그 48 §16)
    chip06 이 박지민 쪽에 있어 보드 A 에서 못 돌린다. chip07(신품 소거 47.0ms)은 chip03 과 같은 느린
    무리라 종단 3칩이 중간 하나·느림 둘이 되고, chip07 에도 계단이 없으면 H3-H6 은 chip04 한 칩으로만
    판정된다. 빠른 무리의 대체(chip09)를 두고 골랐으므로, 교체와 "chip07 도 100k 안에 계단 없음"
    예측을 S-1 §15 에 chip07 마모 전에 적었다. 등록부 chip06 미배정 · chip07 종단 3.
2026-09-29 docs(wear): chip07 종단 0→100k 장부 · 60k·80k 결측 사유 — USB 재열거로 호스트만 죽고 엔진은 완주 (로그 48 §17)
    세션 1790494073·1790562456·1790643103 의 구간·체크포인트 행과, 호스트가 죽어 빠진 두 구간
    (50k→60k · 70k→80k)의 정정 행. 두 번 다 새벽 USB 재열거(커널 error -71)로 실행기가 끝났고
    엔진은 tally 두 벌을 맞춘 채 구간을 끝냈다 — resume 판정 host_died, 채택 60,000 · 80,000.
    60k·80k 체크포인트는 결측으로 두고 그 자리만 재는 경로를 만들지 않았다 ([D48-28]·[D48-29]).
2026-09-29 fix(wear): 링크가 끊겨도 호스트가 버틴다 · 놓친 체크포인트는 재개 때 먼저 잰다 · resume 안내의 없는 --delta 제거 (로그 48 §18)
    chip07 의 60k·80k 결측은 실행기가 포트 예외 한 번에 끝나고, 재개 계획이 시작점과 같은
    체크포인트를 넣지 않아서였다.
    - 링크가 닫히면 by-id 고정 이름으로 30초 동안 다시 연다(엔진은 다시 프로그래밍하지 않는다).
    읽기 명령은 새 req 로 다시 묻고, 다시 붙은 구간은 행 수 항목(A2·A3)을 SKIP 으로 채점한다.
    "링크가 닫혔다" 에 예외 이유를 붙인다
    - accept 시작 자리가 체크포인트인데 장부에 그 체크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
    [run_wear.py, wear_link.py]
2026-09-29 docs(results): 종단 chip07 0→100k 승격 · S-1 §15 판정 — 계단 없음 예측 참 · H2′ 거짓 · H1′ 25MHz 참(사후 처리) · 70k 직전 계측 사건 (로그 48 §19)
    - 계단 없음: 105ms 이상 A 행 0건(621,872행). 9/27 에 적은 "chip07 도 100k 안에 계단 없음" 참.
    H3-H5 판정 불가, H6 빠짐 — H3-H6 은 chip04 한 칩에 남는다
    - H2′ 거짓(두 번째): 섹터별 4-12k 에 7.0ms 초과, 100k 에 p50 14.19ms. 섹터 5·6 이 먼저 오른다
    - 9/28 11:23:55 KST 선 접촉(USB 10초 단절)이 25MHz 폭을 +590ps 옮겼다. 스윕 원점 −714→−686 스텝,
    버스트성 F 0.46→2 이상이 같은 자리에서 바뀌어 노화가 아니라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
    [wear_endurance_chip07_2026-09.csv]
2026-09-29 docs(log): 로그 51 — 역산 모델은 소거 시간 하나, 두 무리(신품 40ms), 두 번째 dose 로 칩 속도 소거 · 블라인드 절차 (로그 23 부록 D·워크플로 5 추기)
    Claude-Session: https://claude.ai/code/session_01LvNTwhiP2gWm9tHPYUFzpt
2026-09-30 docs(results): chip07 선 복구 뒤 측정과 newchip — 75/45MHz 판정 불가 · 128KB 교란 재현 · prep 프로그램은 A 행과 눈금이 다름 (로그 48 §20)
    - 9/30 칩은 그대로 두고 선을 다시 누른 뒤 25·75·45MHz(P/E 0): 원점 회전(−713 · 104 · 689)과
    F 0.46 이 마모 전 값으로 돌아와 9/28 계측 사건 판단이 확인됐다. 폭은 마모 전 대비 −147 · −185 ·
    −79ps 로 세 클럭이 같은 방향으로 좁았지만, USB 접촉이 불안정했고 리그 재현성을 재기 전에 칩을
    뺐다 — H1′ 75·45MHz 는 보류에서 판정 불가로 ([D48-33] 뒤집음 · [D48-36])
    - newchip(0-127 +1): 마모 1.58 · 근접 대조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
    [wear_endurance_chip07_2026-09.csv]
2026-09-30 docs(results): 종단 chip04 0→100k 승격 · S-1 §15 판정과 종단 3칩 종합 — H1′·H2′·H6 참 · H3 종단 거짓(chip04 7섹터 충족) · H4 거짓 · H5 판정 불가 (로그 48 §21)
    박지민(보드 B)이 9/27 에 끝낸 chip04 의 누락 세션 1790423530(0-60k)·1790482991(60k-66,671)을
    받아 A 행 0-100k 가 이어졌다.
    - H1′ 참: 25MHz 14점이 7ps 안, 75MHz −2.0 · 45MHz +5.3ps. 스윕 원점·F 가 끝까지 고정
    - H2′ 참: 섹터 1k 구간 중앙값 6.94-6.96ms 그대로
    - H6 참: 7섹터 첫 계단(25-47k) 직전 87.8-94.4ms · 착지 110.5-111.0ms — chip04 데이터를 보기 전의 예측
    - H3: chip04 7섹터 계단 높이 18.5-22.7ms 로 전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
    [wear_endurance_chip04_2026-09.csv]
2026-09-30 feat(analysis): wear_curves.py — 마모 A 행을 1k 구간·섹터 분위수 표로 (수명 역산 교정 곡선의 입력)
    - host/analysis/wear_curves.py: 세션 폴더들의 A.txt → chip,bin,sector,n,erase/program p10·p50·p90 CSV.
    뒤 세션이 겹친 사이클을 덮어쓴다(x 축 = tally) · --drop-cycles 로 명시한 사이클만 뺀다(값으로 거르지 않음)
    - host/tests/test_wear_curves.py: 합성 A.txt 로 구간·겹침·drop·체크섬 규칙 검사
    - docs/results/data/wear_curves_2026-09.md: 칩별 세션·뺀 사이클·열 정의·재현 명령. CSV 는 로컬 A.txt 로 만들어 승격한다
    - docs/commands.md §4: 항목 등록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
2026-09-30 feat(analysis): wear_inverse.py 수명 역산 1차 모델 뼈대 · S-1 §15 2026-09-30 추기 초안 (입력 A·B·C · 눈금 선택 규칙 · 블라인드 절차)
    - host/analysis/wear_inverse.py: prep 로그 → 입력 A(32-127 신품값, 무리 분류 40ms) · B(0-6 소거) · C(프로그램, 교차 확인만).
    wear_curves CSV 를 무리 안 칩×섹터 구성원의 정규 혼합으로 두고, 관측별 밀도의 기하 평균으로 구간별 확률 → MAP · 68% · 95%.
    --loco: 교정 칩 하나씩 빼고 자기 p50 으로 맞히는 모의 블라인드. --scale ms|ratio 는 S-1 의 규칙으로 고른다
    - host/tests/test_wear_inverse.py: 합성 곡선 4칩 — 무리 선택·정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
2026-09-30 docs(results): data/ 를 축별 하위 폴더로 — monte_carlo · sweep · newchip · wear · wear_curves (참조 경로 일괄 갱신)
    - 평평하던 docs/results/data/ 17개 파일을 5개 하위 폴더로 옮겼다 (git mv). 내용은 바꾸지 않았다
    - 리포 전체의 경로 참조(해석 문서 · 사양 · 로그 · 워크플로 · data/README · commands · 분석 스크립트)를 새 경로로 갱신.
    자료 md 안의 ../plots · ../해석.md 는 한 단계 깊어진 만큼 ../../ 로, 자료 md 사이의 링크는 ../<축>/ 로
    - docs/results/README.md 에 하위 폴더 표 추가
    - host/analysis/wear_inverse.py 의 교정 표 glob · 집계표 경로 갱신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
    [monte_carlo_n112_20260823.csv, newchip_survey_2026-09.csv, sweep_chip01_20260708T164931Z.csv, sweep_loopback_20260708T131310Z.csv, wear_endurance_chip03_2026-09.csv, wear_endurance_chip04_2026-09.csv, wear_endurance_chip07_2026-09.csv, wear_pilot_chip01_2026-09.csv]
2026-09-30 docs(results): 수명 역산 교정 표 4장 승격 — wear_curves_<chip>_2026-09.csv
    [wear_curves_chip01_2026-09.csv, wear_curves_chip03_2026-09.csv, wear_curves_chip04_2026-09.csv, wear_curves_chip07_2026-09.csv]
2026-09-30 docs(results): 수명 역산 교정 곡선 그림 승격 — plot_wear_curves.py · wear_curves_2026-09.png (칩별 2×2 · 섹터 p50 선 + p10-p90 띠)
2026-09-30 feat(registry): 칩 라벨 상한 chip10 → chip20 (칩 추가 구매) · 신규 UID 의 라벨 후보에 아직 행이 없는 라벨도 낸다
    - host/capture/chip_registry.py: LABELS 1~20, 문구·셀프테스트(범위 밖 사례 chip11 → chip21)
    - host/run/run_sweep_chip.py resolve_label: 후보 = UID 공란 행 + 등록부에 없는 라벨. 종전엔 빈 행(chip05, 죽은 칩)만 내밀어
    새 칩이 chip05 로 등록될 위험이 있었다
    - host/capture/sweep_uart_capture.py 문구 · docs/interface/contract.md §6 target 범위 · docs/chip_registry.md 머리말
    Claude-Session: https://claude.ai/code/session_01TEgpKPk1vK8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
    [chip_registry.py, run_sweep_chip.py, sweep_uart_capture.py]
2026-09-30 fix(analysis): wear_inverse 답을 100k 안으로 — 교정 구성원에서 100k 너머 구간 제외 (MAX_CYCLE) · 테스트 추가
2026-09-30 docs(concepts): 개념 15 수명 역산 모델 — 두 무리 · 눈금 · 베이즈 우도·사후확률 수식 · MAP·HPD · LOCO 포함률 · 2차 참조 모델
2026-09-30 docs(concepts): 개념 14 문단 줄바꿈·표 정렬 정리
2026-09-30 feat(analysis): 수명 역산에 속도 배율 r 적분 (R=2.0, 규칙) · 눈금 기본 ratio · 블라인드 장부 표기 (봉인) → (MASK)
    - wear_inverse.py: P(N) ∝ Σ_r L(곡선 지점 N·r), r ∈ [1/R, R] 로그 균등 41점. --rate-range (기본 2.0, 1 이면 끔).
    --scale 기본 ratio (4칩 LOCO 36/46 대 19/46). 밴드 검사는 r 없는 곡선 최적점에서
    - LOCO (ratio, 4칩 46점): R=1 26/46·36/46 · R=1.4 35/46·45/46 · R=2.0 42/46·46/46 (68% 폭 중앙값 39.5k) · R=3.0 39/46·46/46
    - S-1 §15 추기 초안: 눈금 확정 · r 규칙과 R=2.0 · 계단 하한 불채택 · LOCO 표 · 남는 것 갱신
    - (봉인) → (MASK): chip_pe.py · run_sweep_chip.py · run_w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
2026-09-30 docs: 수명 역산 1차 모델 확정 — 로그 48 §22 [D48-40]~[D48-45] · S-1 §15 추기 확정(X 60k · Y 24h · 교정 2+블라인드 2) · 개념 15 에 속도 배율 r · 로그 51 추기
    - 로그 48: 후속 §22(무엇을 버렸나 — 계단 하한·프로그램 축·모수 회귀·Δx), 결정 6행, [U48-7] 표기·[U48-8] 닫음, README 행
    - 로그 51(다른 세션, 9/29): 머리에 형식 변경 추기, D51-3 뒤집힘·D51-4 보류 표시. 로그 23 의 (봉인) 추기
    - S-1 §15 2026-09-30 추기: 초안 표시 제거, X·Y·배분 채움, 남는 것 갱신. S-2 §1 에 교정 추가 2 행
    - 개념 15: (라) 100k 는 답의 범위(곡선 지점은 chip01 300k 까지), (마)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
2026-09-30 fix(sim): cocotb 회귀가 지민 PC 밖에서도 돈다 — runner 빌드 폴더 선생성 · F5/W1 skip 을 데코레이터로(cocotb 2.x 에 cocotb.skip 없음) · F2 타이밍을 ps 정수로 계산(절대 시각에 따른 float 오차)
    모델 없는 환경: 종전 FAIL 3(F2·F5·W1, 전부 테스트 코드 결함) → 16/21 PASS · F2 PARTIAL · F3/F5/W1/W2 SKIPPED · OVERALL INCOMPLETE
    [F5_output_delay_sweep.py, W1_vendor_invalid_opcode_rejection.py, flash_spi_test_helpers.py, runner.py]
2026-09-30 docs/code: 누적 P/E 사이클 기호 N → x (로그 51 [D51-1] 채택, [D48-46]) · 개념 15 관측 기호 x → e
    - wear_inverse.py 주석·docstring·posterior 루프 변수, S-1 §15(9/26 추기의 "블라인드 N" 포함, 날짜 표기), 개념 15(사이클 x · 관측 e ·
    용어표), 로그 48 §22 · 결정 [D48-46], 로그 51 머리 추기. N 은 위상당 읽기 112 에만 남긴다. 옛 로그 본문은 기록이라 두었다
    Claude-Session: https://claude.ai/code/session_01TEgpKPk1vK855wyxbLTwcM
2026-09-30 docs: 블라인드는 코드 아닌 규칙으로(--blind 취소, 봉인 지민) · 성공 기준 ③ 폭/MAP ≤ 2.0(모의 90분위) · 개봉 prep 5회 · chip09 교정·06/08 블라인드·10 예비 — 로그 48 §23 [D48-47]~[D48-50] · S-1 §15 10-01 추기 · 등록부 · 로그 51 추기
2026-09-30 feat(analysis): wear_inverse 부속 연구 옵션 — --loco-obs single(prep k회 표본) · --dx(두 번째 dose 기울기, r 반영) · --study 무리·x 구간별 요약 (기본 동작 불변)
2026-09-30 docs: 새 배치 4칩(chip12·15·17·18) 신품값을 집계표 §1·CSV 에 추가 (n=9 판정 밖) · 등록부에 섹터 32-127 소거 중앙값과 무리(느림 12·15 · 빠름 17·18, 경계 40ms [D48-40]) · commands.md 표 정렬
    [newchip_survey_2026-09.csv]
2026-10-01 docs/code: 블라인드 chip06 추정 전 등록 — 정답 봉인은 tally(sha256 생략) · v1(교정 4칩)·v2(chip09 추가) 두 번, 판정용 v2 · R 은 쌍 확장 · ③ 은 자기 설정 90분위 · 계단 뒤 MAP 편향은 한계로 등록 — 로그 48 §24 [D48-51]~[D48-56] · [U48-10] 닫음 · S-1 §15 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
    wear_inverse.py: --out <경로> 추가 — 결과 + 머리말(git_rev · 인자 · 입력 로그 sha256 · 교정 표). 출력단만 손댔다:
    수정 전후 --loco 출력 cmp 동일 · 로그 입력 추정 출력 동일 · test_wear_inverse 9 passed.
2026-10-01 docs: 새 배치 4칩 배정 — chip12 느린 교정(로트 브릿지) · chip08 느린 블라인드 확정 · chip15 2차 블라인드 · chip17 80°C 종단 · chip18 대조군 (로그 48 §25 [D48-57] · S-1 §15 · 등록부) · fix(wear): 계획 화면 단가 출처 문구 — '세션 N' 을 '단가 출처: 이전 세션 N'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
    [run_wear.py]
2026-10-01 data(blind): chip06 v1 추정 (교정 4칩 · 참고용, 판정용은 v2) — 빠른 무리 · MAP 5,001-6,000 · 68% 2,001-11,000 · 95% 1,001-18,000
    개봉 tally 를 읽기 전 커밋 (S-1 §15 2026-10-01 저녁 추기 · 로그 48 [D48-51]·[D48-55]).
    코드 a320c98 · 입력 개봉 prep 5회(20260930T210515Z·211318Z·224142Z·224956Z·225928Z, sha256 은 파일 머리말) · 관측 35개.
2026-10-01 feat(analysis)/docs: chip06 v2 추정 전 등록 — 교정 5칩(chip09 100k) · R 3.8(rate_rule: 무리 안 4쌍 곡선 맞춤) · ③ 5.99 · 우도는 기존 그대로(합성 복원) · 새 칩 chip14·16
    - wear_inverse: --synthetic(합성 복원 + 그림) · --rate-rule(쌍 속도 비 → R) · --prep-indep(시험용, 기본 꺼짐) · RATE_RANGE 2.0 → 3.8.
    기본 계산은 RATE_RANGE 외 불변 — --loco 출력이 R 2.0 에서 수정 전과 동일 · test_wear_inverse 9 passed
    - 합성 복원: prep 독립 우도는 처음 보는 칩에서 과신(95% → 82%) → 되돌림 [D48-58]. v2 설정에서 기본 우도 63/91%
    - chip09 교정 표 wear_curves_chip09_2026-09.csv (A 행 700,00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
    [newchip_survey_2026-09.csv, wear_curves_chip09_2026-09.csv]
2026-10-01 data(blind): chip06 v2 추정 (판정용 · 교정 5칩 · R 3.8) — 빠른 무리 · MAP 6,001-7,000 · 68% 2,001-30,000 · 95% 1,001-61,000
    개봉 tally 를 읽기 전 커밋 (로그 48 [D48-55]·[D48-59]). 코드 648defb · 입력은 v1 과 같은 개봉 prep 5회(sha256 동일, 파일 머리말).
2026-10-01 docs(chip_pe): chip09 종단 교정 0→100k (세션 1790786787 · 90k→100k 는 호스트 종료로 누락 — resume 채택값으로 정정) · chip12·15·17·18 신품 newchip · chip14 prep 4회(2회는 라벨 전 Ctrl-C 로 누락 — 로그로 정정) · chip16 newchip
2026-10-01 fix(analysis)/docs: v2 의 R 3.8 → 2.0 — 교정 곡선 혼합과 r 이 칩 산포를 두 번 셌다 · 5칩 LOCO 68/95% 포함률 R 2.0 72/98 (3.8 은 81/98) · ③ 2.80 · R 3.8 추정은 _R3.8_discarded 로 보존 — 로그 48 [D48-60] ([D48-53] 뒤집음) · S-1 §15 (정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
2026-10-01 data(blind): chip06 v2 추정 (판정용 · 교정 5칩 · R 2.0) — 빠른 무리 · MAP 7,001-8,000 · 68% 3,001-19,000 · 95% 1,001-34,000 — 개봉 tally 를 읽기 전 커밋 (로그 48 [D48-55]·[D48-60]) · 코드 318dee7 · 입력은 v1 과 같은 개봉 prep 5회
2026-10-01 docs(results): 보고서 재료 — 노화 배율 곡선 5칩(+chip06 관측선) · 블라인드 chip06 기록(개봉 전) · 핵심 수치·계획 대비 달성 표 · 판정용 설정 합성 복원(66/91%) · chip17 65°C 정정 · 로그 48 §26 [D48-61] (chip09 마감 사고·0 사이클 구간 버그) · wear_inverse --dx 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
2026-10-01 feat(hw): temp_logger.py — 온도 제어 아두이노 출력을 화면 + 파일로 (시리얼 모니터 대체, 스케치 불변) · data/temp_<label>_<UTC>.csv(1초 데이터, host_utc 열) + _events.txt(응답·보낸 명령) · 가짜 시리얼 포트로 데이터·과열·명령 전달·종료 시험
2026-10-01 docs(results): 블라인드 chip06 개봉 — tally 120/120 바이트 = 12,000 (지민 기록 일치) · 판정용 v2 가 68%·95% 구간에 품음(49번째 백분위) · 기준 ① 통과 ② 통과 ③ 불통과 · v1(교정 4칩)은 68% 밖(79번째) · 해석 blind_chip06.md · 로그 48 §26 개봉·읽기 명령 E_DUP
2026-10-01 docs(chip_pe): chip06 블라인드 마모 개봉 뒤 기입 — 지민 장부 14행(세션 1790788847 · 0→12,000 · 체크포인트 4 · 개봉 prep 5) · 마모 합계 12,000 = tally · 블라인드 문서 §6
2026-10-01 docs(spec): S-1 §15 블라인드 chip06 판정 추기 — 정답 12,000(tally) · v2 ① 참 ② 참 ③ 거짓 · 정답 49번째 백분위 · v1 은 68% 밖
2026-10-01 docs(results): 집계표 노트 정정 — chip14 062946Z 요약 CSV 는 data/ 에 온전(2,520행 complete · 오류 열 = _reads 스텝별 합, '0 바이트·다시 받는다' 는 낡은 기록) · DF 두 칩 비교 대상 14칩 → 13칩 · chip10 소거 33.0ms 는 빈 구간 바로 아래 · 상태 줄에 10/01 chi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
2026-10-02 feat(analysis): temp_wear_summary.py — 온도 마모 런 요약 · 세션 로그 시각으로 1초 온도를 마모 구간·체크포인트 prep/스윕·KST 시간별로 나눔(평균·sd·5-95%·63-67°C 비율·설정값) · 체크포인트 표(상온 칩과 같은 열 + 창 위치·온도) · 그림 2장(시계 축 온도 · 사이클 축 온도/폭 변화/소거 배율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
2026-10-02 docs(results): 온도 마모 chip17 칩 위 65°C 0→100k 승격 — 폭 −3.4-+14.8ps(H1′ 참) · 소거 100k 2.44배(상온 빠른 2.80-3.97, p 0.25) · 계단 없음(최대 69.9ms < H6 84ms) · 프로그램 +20%(H2′ 거짓) · 65°C 효과는 개체차와 구별되지 않음 · 상온 v2 는 사용량 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
    [temp_chip17_hourly_2026-10.csv, temp_chip17_intervals_2026-10.csv, wear_curves_chip17_65C_2026-10.csv, wear_endurance_chip17_2026-10.csv]
2026-10-02 docs(log): 로그 48 §27 chip12 7,400 SPI 접촉 고장 — 재장착 뒤 tally 7,400 재개, 가짜 7,331-7,400 은 곡선에서 뺌 [D48-62] · §28 chip17 65°C — 상온 기준 적용 [D48-63] · 교정 제외 [D48-64] [U48-11] 닫음 · 보고서 문장 '65°C 효과는 개체차와 구별되지 않는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
2026-10-02 fix(wear): 누적이 이미 --to 면 START 를 보내지 않는다 — 빈 계획에 넣던 0 사이클 대체 구간 제거 · 빠진 체크포인트만 재고 끝 · 계획 화면 '목표 N 에 이미 닿았다' · chip09 100k probe FAIL 의 원인 (로그 48 §26·§29 [D48-66])
    [run_wear.py]
2026-10-02 docs(chip_pe): chip12 0→70,000 · chip17 지민 장부 26행 — chip12 세션 1790852877(0→7,400 · error 정지) · resume 재소거 6행(1790864208 · 1790880901) · 세션 1790880923(7,400→70,000, 진행 중) · chip17 65°C 0→100k(세션 17908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
2026-10-02 docs: 등록부 정리 — chip17 행을 chip18 위로(라벨 순) · 표 열 정렬 · '왜 UID를 쓰는가' 절 삭제 (chip17 용도 칸은 아직 '5만 회')
2026-10-02 docs(results): 보고서 재료 — 신품 창 폭·측정 칩 16칩 → 15칩 · chip09 프로그램 칸 '불변 (6.50-6.56ms)' · docx 판 추가 (§1.7 은 아직 'chip17 5만 회 진행 중')
2026-10-02 feat(analysis): 교정 곡선 칩별 그림 — plot_wear_curves.py --per-chip (교정 칩마다 한 장 · y 는 전 칩 공통 · 이름은 교정 표와 짝 wear_curves_<chip>_2026-09.png) · 5장 승격 (chip01·03·04·07·09 — chip09 가 처음 섹터별 그림에 들어감) · 9월 4칩 2×2 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
2026-10-02 docs: results 해석 문서를 축 폴더로 — wear/ (chip01·03·04·07·17, 영웅님 이동) · newchip/ · blind/ · 중간계획서 docx 는 results/reports/ (영웅님 이동) · 옮긴 문서의 상대 링크와 다른 문서의 경로 갱신 (21개 파일, HEAD 대비 깨진 링크 0) · results README·pr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
2026-10-02 docs: 해석 문서 링크의 라벨도 새 경로로 — data md 9개의 [`../../<문서>.md`] 라벨이 옛 자리를 보이고 있었다 (9a77ab7 에서 대상만 고침)
2026-10-02 docs: 보고서 재료 §1.4 · 개념 15 — 쓰던 칩에서 신품값이 나오는 이유 한 문단 (섹터 단위 마모 · 32-127 = 1.00 실측 · 적용 조건)
    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
2026-10-02 docs(results): 보고서 Ⅱ. 개요 개념도 2장 — 칩 안의 신품 섹터(§2) · 시스템 블록도(§3), host/viz/overview_figures.py 로 생성
    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
2026-10-02 docs(results): 개요 개념도 — 넓은 한글 글꼴 대비 상자 확장·문구 단축, SVG 텍스트 XML 이스케이프
    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
2026-10-02 docs(results): 개요 개념도 간결판 — 상자에 굵은 제목만, 설명은 본문·캡션으로
    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
2026-10-02 docs: 하위 문서 2-3개짜리 폴더를 펼친다 — results 의 newchip/·blind/ · data/ 의 blind·inverse·monte_carlo·newchip·sweep·temperature · captures/g2·g3 (이동 25건) · 남는 폴더는 칩마다 쌓이는 wear/·data/wear/·data/wear_curves/ 와 pl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
    [monte_carlo_n112_20260823.csv, newchip_survey_2026-09.csv, sweep_chip01_20260708T164931Z.csv, sweep_loopback_20260708T131310Z.csv, temp_chip17_hourly_2026-10.csv, temp_chip17_intervals_2026-10.csv]
2026-10-02 feat(analysis)/docs: 칩 × 체크포인트 한눈 표 — wear_checkpoint_table.py (칩별 체크포인트 CSV → 폭·소거·프로그램 표 셋 md · --plot 은 폭 변화·프로그램 칩 간 그림, 무리별 칸 · 칸마다 색 --pairs all 검증) · 표 문서 맨 위에 그림 링크 (plots/ 에서 찾아 단다) · chip09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
    [wear_endurance_chip09_2026-09.csv]
2026-10-02 feat(analysis): 수명 역산 시연 화면 — 계획 화면 꼴 (칩 · 측정 · 무리 · 교정 곡선 · 마모 섹터 · 교차 확인 → 추정 사용량 · 68/95% · 정격 대비 · 사후 분포 한 줄 막대 · 판정) · 판정은 정격 대비 1·20·60% 경계로 신품·저마모·중마모·고마모 중 사후 확률이 가장 큰 등급과 그 확률만 · --out 기록은 입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
2026-10-02 feat(analysis): 수명 역산 시연 화면 2차 — 분포 막대를 숫자 위로 · 점자 막대(1k 구간이 점 한 열, 높이 4단) · 'MAP 추정' · '68%/95% 신뢰구간' · 정격 대비를 '10만 회 중 약 8% 사용 (95% 상한으로 잡아도 34%)' 로 · UID 괄호 · '소거 시간' · 판정을 구분선 사이에 · 곡선 첫 구간보다 덜 닳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
2026-10-02 docs(reports): 최종보고서 원고 — Ⅰ 작품요약 보강 문장 · Ⅱ 개요 확정 원고 · 그림 삽입 위치와 캡션
    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
2026-10-02 docs(reports): 작품요약·개요 원고 파일 제거 — 보고서 원고는 리포 밖에서 관리
    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
2026-10-02 docs: chip17 100k 뒤 25°C 클럭 사다리 (박지민, 25·45·75MHz 스윕) — 수치 문서 §3 · CSV 끝 3행 (75MHz 는 요약 CSV 미수신이라 _reads 재집계) · 해석 문서 §6 (25MHz 폭 +40-58ps 는 유의미한 변화로 보지 않음 · 창 위치 −596 그대로 → 보드 A −630 은 리그·장착 쪽) · 등록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
    [wear_endurance_chip17_2026-10.csv]
2026-10-03 docs: 10/3 결정 — chip12 는 교정에서 뺀다(구매처 알리익스프레스 · 소거·프로그램이 빠른 무리처럼 늙음, [D48-57] 의 「느린 교정 · 로트 브릿지」 뒤집음) · chip16·18(새 배치 · 디바이스마트) 상온 0 → 100k, 마치면 빠른 무리 교정에 넣는다(결과 전 결정, [U48-13] 닫음) · 무마모 대조군은 chip14 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
2026-10-03 feat(analysis)/docs: chip12 0 → 100k 승격 — 같은 칩으로 보지 않는다 [D48-77] · 체크포인트 표 CSV·md(13점 · 9/30 신품 · 10/3 newchip) · 1k 곡선 wear_curves_chip12_ali_2026-10(교정 glob 밖) · 해석 문서(계단 없음 — 첫 105ms 구간도 한 봉우리 · 프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
    [wear_curves_chip12_ali_2026-10.csv, wear_endurance_chip12_2026-10.csv]
2026-10-03 docs: 문서 정합성 점검 — S-1 §15 10-03 추기(65°C·10만 회 · chip12 제외·같은 칩 아님 · chip16·18 교정 편입은 결과 전 약속 · chip14 대조군) · 개념 15 v2 갱신(§10 — 교정 5칩, R 2.0 은 LOCO 로 고름, 쌍 규칙 3.8 버림) · 폴더 펼치기 잔재 본문 경로 8곳 · data/READM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
2026-10-03 feat(analysis)/docs: PE 종료 뒤 기계적 갱신 1차 — pe_end.py 두 단계(1단계 build/pe_end/<chip>/ · --promote 로 docs/results/ 승격, 다른 내용은 --overwrite 로만 · 같은 칩 곡선 다른 이름은 멈춤) · 옵션 없으면 교정 · --no-calib(_nocal) · --temp(마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
2026-10-04 fix(analysis): 새 교정 칩에서 승격이 멈추던 두 곳 — plot_wear_curves 의 무리를 고정 사전(GROUP) 대신 집계표 신품 소거 40ms 로 가른다(chip18 에서 KeyError, 기존 5칩 그림 바이트 동일) · wear_checkpoint_table 한눈 그림 chip18 색 #006300(빠른 칸 5번째, 팔레트 44단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
2026-10-04 docs(chip_pe): chip12 70,000→100,000 · 100k 뒤 newchip(10/3) · chip18 0→100,000(세션 1790989701, 체크포인트 13) · 100k 뒤 newchip(10/4) — 실행기 자동 기입분
2026-10-04 docs(results): chip18(새 배치 빠른 무리) 0 → 100k 승격 · 교정 편입 — pe_end.py 첫 실전 · 소거 100k 3.68배(옛 로트 빠른 띠 안, 80k 까지 chip09 와 같은 길) · 5/7섹터 53-100k 계단(H6 참 · 높이 19.7-23.1ms) · 프로그램·폭 불변(H1′ 25MHz · H2′ 참) · 원격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
    [wear_curves_chip18_2026-10.csv, wear_endurance_chip18_2026-10.csv]
2026-10-04 feat(analysis): pe_end 가 bathtub 그림과 교정 배율 그림도 만든다 — 1단계에 첫 · 마지막 체크포인트 bathtub 한 쌍(build/plots 에 없으면 data/ 의 CSV 로 다시 그림) · --promote 가 교정 칩이면 wear_ratio_curves_calib.png 를 다시 그림(관측선 chip06 1.63배 그대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
2026-10-04 docs(results): chip18 bathtub 한 쌍(체크포인트 100 · 100k, 폭 39,585 · 39,579ps) · 교정 6칩 배율 겹침 wear_ratio_curves_calib.png — 10/2 wear_ratio_curves_2026-10.png 는 교정 5칩 기록으로 둠(chip06 판정 · 보고서 재료가 가리킴) · 수치 md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
2026-10-04 fix(analysis): 교정 배율 그림 — 색 사전에 없는 새 교정 칩(chip16 등)을 회색으로 그리고 알린다(KeyError 로 --promote 가 멈추던 것, 6칩 그림 바이트 동일) · pe_end 가 그 그림을 승격한 날짜로 한 장씩 wear_ratio_curves_<YYYY-MM-DD>.png (덮어쓰던 _calib 버림) · 로그 48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
2026-10-04 docs(workflow): 워크플로 13 — chip18 실전에서 거친 일 반영 · 새 칩 색은 COLORS · CHIP_COLORS 두 곳 + 칸마다 --pairs all, 한 칸 6색부터 팔레트 통과 0(칸 나누기 · 선 모양) · note 단 뒤 재승격 대신 직접 칠 그림 명령 · bathtub 한 쌍 · 수치 md 일회성 집계(105ms 첫 계단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
2026-10-04 docs: R 은 지금 단계(교정 6칩) 1.6 이 적정하나 모델에는 반영하지 않는다 — 교정 곡선이 계속 늘어 v3 는 더 쌓인 뒤(로그 48 [D48-86], [U48-14] 추기 · S-1 §15 · chip18 수치 §4) · 교정 배율 그림 이름 wear_ratio_curves_calib.png → wear_ratio_curves_2026-10-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
2026-10-04 docs: 10/2 교정 5칩 배율 그림(wear_ratio_curves_2026-10.png) 삭제 — 필요 없음(영웅님) · 가리키던 chip06 해석 · 보고서 재료 · 곡선 짝 문서를 10-04 6칩판으로 · 한눈 표 다시 뽑음 · 워크플로 13 · pe_end 주석 · 로그 48 [D48-88]([D48-85] 일부 뒤집음)
2026-10-04 docs: 그림 색 합격 기준을 프로젝트 기준으로 완화 — 정상 시각 12 이상(검증기 15) · 색각 이상 6 이상(끝 라벨 · 범례가 보조 단서) · 명도 · 채도 그대로, 빠른 칸 7색까지(연보라 #9085e9 + 노랑 #eda100 또는 분홍 #e87ba4) · 워크플로 13 §4 · 로그 48 [D48-89] · 직전 커밋에서 빠진 [D48-85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
2026-10-04 docs: chip15 를 2차 블라인드에서 빼고 상온 0 → 100k 뒤 느린 무리 교정에 넣는다 — 곡선 무관, 마모 시작 전 등록(로그 48 §39 [D48-90] · [D48-57] 일부 뒤집음 · S-1 §15 10-04 추기 · 등록부) · 「다른 로트」 블라인드는 새 10칩에서 다시 뽑는다 [U48-15] · 등록부 표 열 정렬과 chip12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
2026-10-05 docs(results): chip15 종단 결과 승격 · 느린 교정 편입 — 0 → 100k(보드 A) · 소거 100k 1.75배 · 계단 없음 · 69,109 USB 사건 7행만 제외([D48-91]) · 느린 칸 색 · 끝 라벨 겹침([D48-92]) · 한눈 표 · 곡선 · 등록부 · 장부 · S-1 §15 추기 · 로그 48 §40
    [wear_curves_chip15_2026-10.csv, wear_endurance_chip15_2026-10.csv]
2026-10-05 feat(inverse): v3 — 교정 7칩 · R 1.6 · 대표값 사후 중앙값 · 입력 C 삭제([D48-94]) · Δx 제외([D48-93]) · 수치 inverse_v3_probe §1-§4(v1 · v2 · v3 비교) · S-1 §15 추기 · 개념 15 §11 · 로그 48 §41-§42
2026-10-05 feat(inverse): v3.1 — 속도 배율 R 을 무리별로(빠른 1.6 · 느린 1.3, [D48-95]) · 전체 LOCO 68% 60/82 · 95% 81/82 · 폭 33,000 · --loco --study 대표값을 사후 중앙값으로 · 낡은 주석 · 밴드 경고 문구 · 수치 §5 · S-1 §15 추기 · 개념 15 · 로그 48 §43
2026-10-05 docs(spec): S-5 수명 역산 모델 판별 사양 신설 — v1 - v3.1 한 표 · 공통 사양 · 성공 기준([D48-96]) · 색인 · S-1 · 개념 15 · 코드 머리 주석에서 가리킴
2026-10-05 feat(inverse): 시연 화면 문구 정리 — 라벨 「추정 결과」 · 기준 섹터 → 마모 섹터 → 교정 곡선 순서 · 배율은 기준 소거 시간으로 표기 · R= 표기
2026-10-05 docs(results): 대표값 후보 비교 — MAP · 중앙값 · 평균 · 기하평균 · 68% 가운데 · 혼합 규칙(수치 §6) · 중앙값 유지 경위(로그 48 §43)
2026-10-05 docs: chip10(DF)을 무마모 대조군 · 예비에서 상온 0 → 100k 마모로 — 새 10칩 전에 DF 칩이 어떻게 늙는지 본다 · 교정 편입은 곡선을 본 뒤 판단(사전 등록 안 함) · DF 대조군은 chip14 (로그 48 §44 [D48-97] · 등록부)
2026-10-05 feat(inverse): v3.2 — r 적분을 격자 없이(걸치는 곡선 1k 구간을 로그 길이 가중으로 모두 더함, [D48-98]) · 7칩 LOCO 68% 60/82 그대로 · 95% 81 → 80 · 조각난 68% 구간 16 → 0 · chip06 동일 · S-5 v3.2 열 · 수치 §7 · 개념 15 · 로그 48 §45
2026-10-05 feat(inverse): 모델 버전 표기 — 파일 머리 주석에 현재 버전(v3.2) · 최종 수정일 · 버전별 한 줄 이력, 기록 파일(--out) 머리말에 「모델 v3.2」 줄(MODEL_VERSION) · S-5 §6
2026-10-05 docs: 역산 모델 용어를 「판」 에서 「버전」 으로 통일 — S-5 · 수치 inverse_v3_probe · 개념 15 · S-1 §15 추기 · 로그 48 §42-§45 · 색인 · 코드 주석 (「판별 사양」 → 「버전별 사양」, 그림의 5칩판 · 6칩판은 그대로)
2026-10-05 fix(run_wear): 계획 화면의 옵션 예시를 --confirm-first 0 으로 — 묻지 않고 끝까지 도는 꼴을 예로 든다 · commands.md 의 같은 예시도 맞춤 (맨 위 사용법 주석의 명령 예시는 그대로)
    [run_wear.py]
2026-10-05 docs(registry): chip10 신품 소거 33.0ms · 빠른 무리(40ms 경계, chip04 33.7ms 바로 아래)를 등록부에 적음
2026-10-05 docs: 배경 · 파이프라인 · 명령 · 빌드 재현 문서를 2026-10-05 상태로 — 파이프라인 축 2-4 를 실제 결과로(15칩 신품 · 파일럿 300k · 종단 100k 8칩 · 교정 7칩 · 수명 역산 v3.2 · 블라인드 chip06 · 65°C 1점) · 닫힌 G5 정리 · 스크립트 색인에 분석 스크립트 · 배경 문서의 가설 결과와 시료 배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
2026-10-05 docs(readme): 결과 4)-6) 추가 — 신품 15칩 산포와 두 무리 · 마모(마진 불변 · 소거 시간이 노화 지표 · 교정 7칩 표와 배율 그림) · 수명 역산과 블라인드 chip06 · 한계와 고도화 표를 현재 상태로
2026-10-05 docs: 칩은 W25Q64FV 였다 — IC 윗면 마킹 · 날짜 코드 10칩을 등록부에, 두 무리가 날짜 코드로 갈림(≤1423 느린 · ≥1430 빠른) · 남은 칩(chip10 · 14 · 16 · 17) 예측을 판독 전에 등록 · chip07 만 점퍼선 20cm · chip12 품번 지워짐 · Voltly 모듈 30개 고정과 「날짜 코드 → 무리 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
2026-10-05 docs: 최종 발표 대본 초안 — 5단계 흐름에 방법론(사전 등록 · 블라인드 · LOCO · 합성 복원 · 버린 것들)을 중심축으로, 선행 연구 한계 표현 · 「가설 기각」 의 대상 정정 · 칩 세대(FV) 주의 · project_context 의 측정 구성을 「6핀 모듈 직결(ZIF 는 계획뿐)」 으로 정정 · results README 색인
2026-10-05 docs(ref): 선행 연구 — 재활용 플래시 판별(Sakib 외 2018 Cryptography · NAND · 데이터시트 기준 이진 판별, 원문 확인)과 NOR 섹터 소거 열화 기전(LIU 외 2019, 65nm 128Mb SPI NOR · 사전 프로그램 · 소거 · 과소거 교정 · 비선택 섹터 복구) — 우리 관찰(계단 · 128KB 교란 · 두 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
2026-10-05 docs(report): 발표 대본 — 1장 선행 연구를 원문 근거로(UAH 2018 한 편, 「재활용 플래시 판별 연구는 아주 적다」 인용, 데이터시트 기준 전제가 같은 품번 신품 2배 차이로 깨짐) · 4장 소거 시간이 느는 이유 한 문장 · 예상 질문에 날짜 코드 무리와 NOR 소거 4단계(LIU 2019) · 칩 표기를 W25Q64FV 로
2026-10-05 docs(registry): chip02 를 상온 종단 예정으로 — 앵커 · 마모 금지 표시를 지우고 신품 소거 27.2ms 빠른 무리(6.6ms 는 첫 prep 빌드의 4배 단위 버그) · 마킹 chip05 25Q64FVSIG 1212 · chip16 25Q64FVSIG 1551(판독 전 예측 「1430 이후」 와 맞음) · 표 열 정렬
2026-10-05 docs(results): 기준선 비교 방법 — 결과를 보기 전에 고정(선행식 이진 판별 (a) 데이터시트 typ 문턱 · (b) 신품 칩 섹터 단위 분포와의 겹침 α · 확신도 95% · (c) 정규화 뒤, 단순 회귀는 같은 무리 평균 곡선 거꾸로 읽기, 현행 v3.2 는 LOCO 그대로) · LOCO 82점 · 신품 15칩 · 결과 절은 비움
2026-10-05 docs(ref): W25Q64FV 데이터시트 Rev L 수록 — 우리 칩의 실제 세대, 4KB 섹터 소거 typ 60ms(IG) · 45ms(IQ · IF) · max 400ms · 선행 문서의 기준선 ① 지침에 끝자리별 typ 를 적음
2026-10-05 docs(ref): 선행 논문 원문 두 편 수록 — Sakib 외 2018(Cryptography 2(3):17) · LIU 외 2019(JUESTC 48(4)) · Sakib 의 판정을 원문 4절 식 (1) 로 바로 적음(α = 쓴 칩의 값이 신품 위쪽 끝 아래로 떨어지는 비율, 98% 이상) · LIU 제1저자 표기를 원문대로(刘璟)
2026-10-05 docs(results): 옛 서식 욕조 곡선 6장을 현행 bathtub_analysis.py 로 재산출 — chip02 3장 · chip03 · chip04(9/15-16) · loopback(7/8), 제목이 「Bathtub — 대상 · 날짜 / SCLK · N × B」 두 줄로 · 폭 수치는 그대로
2026-10-05 feat(analysis): 기준선 비교 — 선행식 이진 판별 · 단순 회귀 · 현행 v3.2 를 LOCO 82점 · 신품 15칩에서(baseline_compare.py) · 선행식 검출 56/82(데이터시트) · 59/82(신품 실측) · 64/82(정규화 뒤) · 오경보 0, 회귀 오차 중앙값 9,254 대 현행 8,500 · 68% 구간 60/82 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
2026-10-06 feat(analysis): 교정 밖 칩도 섹터별 소거 · 프로그램 그림을 그린다 — plot_wear_curves.py --single CSV -o PNG(두 칸, 선 p50 · 띠 p10-p90, 기존 칩별 그림 바이트 동일) · 한눈 표 · 그림에서 chip10 을 뺀다(SEPARATE, 사유 W25Q64JV — 다른 칩들(FV)과 세대가 다르다)
2026-10-06 docs: chip10 0 → 100k 종료 — 마킹 판독 W25Q64JV(`25Q64JVSIQ` `1850`, 다른 칩은 FV) · 교정 밖으로 승격(--no-calib, 곡선 _nocal) · 한 칩만의 수치 · 해석 문서와 섹터별 소거 · 프로그램 그림(다른 칩과의 비교는 보류) — 소거 계단 없이 100k 2.55배(85-87ms 포화 가설) · 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
    [wear_curves_chip10_nocal_2026-10.csv, wear_endurance_chip10_2026-10.csv]
2026-10-06 docs(workflow): 워크플로 13 §6.2 — 교정 밖 칩의 섹터별 소거 · 프로그램 그림(plot_wear_curves.py --single) · 다른 세대 · 별개 칩은 한눈 표 · 그림에서 SEPARATE 로 뺀다(chip12 · chip10)
2026-10-06 docs(chip_pe): chip10 0 → 100,000 (세션 1791175305, 체크포인트 13, 보드 A) · 100k 뒤 newchip prep(batch 20261006T002446Z) — 실행기 자동 기입분 27행
2026-10-06 docs(commands): 표 열 정렬 · 백틱 주변 띄어쓰기 정리 — 내용 변경 없음(편집기 정리분)
2026-10-06 fix(analysis): pe_end 1단계 요약의 「교정: 넣음」 을 「--promote 하면 넣는다 (빼려면 --no-calib 으로 1단계를 다시) — 1단계는 아직 아무것도 승격하지 않았다」 로 — 승격된 것처럼 읽혀 chip10 이 교정에 든 줄 오해했다
2026-10-06 docs: chip02 를 0 → 100k 뒤 곡선 무관 빠른 무리 교정에 넣는다 — 마모 START(10-06 09:56:29Z) 직후 · 첫 체크포인트 결과 전 커밋(로그 48 §51 [D48-103] · S-1 §15 10-06 추기 · 등록부) · tally-erase(세션 1791280528) 뒤 accept(세션 1791280572) · 로그 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
2026-10-07 fix(analysis): 세션 로그의 「[1/1] INVALID sweep_…_invalid.csv」 줄 안의 VALID 를 유효 스윕으로 읽던 정규식을 \bVALID 로(wear_checkpoint_csv · temp_wear_summary) — chip02 의 9/15 무효 런이 세션이 되어 pe_end 1단계가 bathtub_analysis 의 무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
2026-10-07 docs(chip_pe): chip02 0 → 100,000 (세션 1791280572, 체크포인트 13, 보드 A) · 앞서 tally-erase(세션 1791280528, 9/21 TB 영역 100사이클 집계 지움) · 100k 뒤 newchip prep(batch 20261007T034458Z) — 실행기 자동 기입분 29행
2026-10-07 docs(chip_pe): chip16 newchip prep (batch 20261007T034756Z) — 실행기 자동 기입분 1행 · 10/01 뒤 두 번째 신품 측정(소거 27.7ms · 빠른 무리)
2026-10-07 docs(results): chip02 0 → 100k 기계적 승격(pe_end --promote) — 체크포인트 표 CSV 15행(x=0 은 9/16 newchip — 집계표 신품값과 같은 prep 로그 없음) · 1k 곡선 wear_curves_chip02_2026-10(교정 glob 안 · 빠른 무리 교정 5칩) · 욕조 체크포인트 100 · 100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
    [wear_curves_chip02_2026-10.csv, wear_endurance_chip02_2026-10.csv]
2026-10-07 docs(ref): 선행 연구 Guo 외 2017(FFD, DAC) 원문 수록 · 요약 §3 — 사용량 추정의 선례(raw MLC NAND · 부분 프로그래밍 실패 지도 · 신품 때 칩마다 등록 전제 · 점 추정 · 같은 칩 안에서만 검증) → 「정량 추정 최초」 는 쓰지 않는다 · 우리와의 차별화 표(SPI NOR · 소거 시간 · 등록 없음 · 구간 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
2026-10-07 docs(results): 기준선 비교를 교정 8칩(chip02 포함) · LOCO 94점으로 같은 방법으로 다시 계산해 10-07 판으로 갈아 끼움(10-05 판은 fd0f79a) — 선행식 검출 64 · 65 · 74/94 · 오경보 0 · 단순 회귀 10,000 대 현행 7,500(chip02 를 뺀 82점에서도 8,867 대 6,500) · 68%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
2026-10-07 docs: 로그 48 §52 — chip02 끝(빠른 무리인데 계단 없음 · 프로그램 2.09배, 늙는 모양의 경계는 가설로만) · 기준선 비교 10-07 판 [D48-104] · chip10 은 별개 [D48-105] · [U48-21] 닫음 · chip02 색은 회색 [D48-106] · 공모전은 v3.2 그대로 두고 고마모를 한계로 말한다 [D48-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
2026-10-07 docs(registry): 칩 마킹 표 · 등록부 표 열 정렬(편집기 정리분) · chip16 비고 「측정불가」 → 「빠른 무리」(10-07 newchip 27.7ms) · chip14 마킹 `25Q64FV` → `25Q64` · 「chip10 · 14 같은 로트」 판정은 확인 후 작성 예정으로 · chip07 점퍼선 문장 다듬기 · 로그 48 §50 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
2026-10-08 feat(inverse): 수명 역산 v4 코드 — 고른 값을 잰 값으로 (등록 전, --model v3.2 로 이전 모델 그대로)
    ① 셀 분포: wear_curves.py 가 5% 분위수 21열(erase_us_q00…q100)을 같이 쓰고, 구성원(Quant)은 조각별 균일 밀도 — 계단 셀의 빈 구간이
    그대로 낮은 밀도. 조각 폭 하한 1µs · 분위수 밖 1/1,001÷범위 (표본 수·해상도에서 오는 값)
    ② 증거량: 1/k 대신 n_eff = 1/(ρ_s/P + ρ_p/k + (1−ρ_s−ρ_p)/kP). ρ 는 --rho 로 A 행(연속 사이클 P개 × 7섹터 표의 이원 분산 성분)과 prep 로그에서
    잰다. RHO 미등록이면 v4 는 돌지 않는다(--rho-sector/--rho-prep 는 시험용)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
2026-10-08 docs(log): 로그 52 — 역산 v4 결정 경위(생성 모델 유지 · 고른 값 다섯을 잰 값으로 · 띠는 채점표 · v4→v4.1 · 합성은 고도화 재료 아님) + v4 부분 탐색
    로그 48 추기: [D48-58] · [D48-60] · [D48-95](와 [D48-94] 의 R 값) 는 v4 에서 뒤집힘, [U48-18] 은 유도값이면 걱정이 사라짐.
    README 등재. results: inverse_v4_probe_2026-10.md — A 행 없이 정렬 · R 유도 · n_eff(ρ 가정)만 v3.2 위에 얹은 8칩 LOCO 94점
    (정렬만: 68% 폭 33,000→28,500 · 포함 71→65% / +R 유도 2.97·1.52: 68% 84% 띠 위 과소신 · 폭 37,500) 과 칩 속도표.
    S-5 §9 에 탐색 포인터. wear_inverse: 같은 교정 집합의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
2026-10-09 feat(inverse): v4 에 칩 효과 ρ_chip — n_eff 4항(ρ_chip + (1−ρ_chip)·칩 안 몫) · 칩을 하나씩 빼고 나머지 정렬 혼합과 비교한 A 행 잔차의 일원 랜덤효과로 --rho 가 같이 잰다(--rho-chip 시험용) · 합성 생성기가 정체 칩의 셀을 공통 시계 x·r 의 자기 시계 x·r/r̂_j 에서 뽑도록(유효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
2026-10-09 docs(results): 교정 8칩 wear_curves 표를 분위수 21열(erase_us_q00…q100)을 붙여 재생성 — p10·p50·p90 불변(v3.2 LOCO 67/94 · 93/94 그대로) · chip02·09·15·18 은 줄끝 LF 유지 · wear_curves md 에 재생성 기록
    [wear_curves_chip01_2026-09.csv, wear_curves_chip02_2026-10.csv, wear_curves_chip03_2026-09.csv, wear_curves_chip04_2026-09.csv, wear_curves_chip07_2026-09.csv, wear_curves_chip09_2026-09.csv, wear_curves_chip15_2026-10.csv, wear_curves_chip18_2026-10.csv]
2026-10-09 docs(results): inverse_v4_eval_2026-10 — v4 등록 측정 수치 (ρ_s · ρ_p 칩별, ρ_chip 무리별 · n_eff · LOCO 8조건 · 무리·구간별 · 칩별 · ρ_chip 감도 · 합성 복원 수정 전후 · 셀 날카로움 · 재현 명령) · results README 한 줄
2026-10-09 docs: v4 등록 (2026-10-09) — S-5 현행 v4 · §2 v4 열(ρ 0.00 · 0.78 · 0.29 · LOCO 79.1% 과소신 · 96.5%) · §5 n_eff 4항과 ρ_chip 측정법 · §7 의심 순서 경위 · §9 실행 기록 · chip14 는 이미 닳음 · S-1 §15 2026-10-09 추기(등록 원문) · 로그 5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
2026-10-09 docs(log): 로그 48 머리에 절 색인(§ · 날짜 · 안건 · 결정 ID, 2026-10-09) · README 48번 행을 한 줄 요약 + 「색인은 본문 머리 · 역산 v4 부터는 로그 52」 로 줄임 — 48 에는 이제 인용구 추기만 붙고 새 안건은 새 로그로
2026-10-09 docs: 지민 묶음 수령(10/08) — chip06 12k 세션 1790788847 은 data/wear 보관만 · chip14 0 → 100k(세션 1791204058)는 pe_end 1단계까지, 승격 안 함(세션 로그 없어 폭 · batch 빈칸 · 대조군이던 칩) · 장부 chip14 행 40 · 등록부 chip14 · blind_chip06 수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
2026-10-09 docs(log): 로그 48 [U48-22] 추기 — chip14 는 (다) 먼저: 마킹 재판독 → JV 면 chip10 과 「JV 둘」, FV 면 별개 승격, v4 교정엔 안 넣음 (2026-10-09)
2026-10-09 docs: 지민 2차 묶음 수령(10/09) — chip16 0 → 100k(세션 1791523150 만 · 앞 세션 1791434740·1791523104 미수령)와 65°C 온도 로그 · chip14 앞 세션 폴더 넷(체크포인트 100 유효 스윕은 없음 · 세션 로그 15 는 아직) · chip06 스윕 9런 → data/ 보관 · pe_end 1단계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
2026-10-09 docs(log): 로그 53 신설 — chip16 100k 가 온도 로그와 함께 왔다(상온 교정 칩의 마모 전 구간을 65°C 로그가 덮는데 히터 꺼진 채 67°C 3시간 · 소거 4.2배는 상온 모양) [D53-1] 승격 보류 · [U53-1] 축 · [U53-2] 온도 로그 해석 · 로그 48 [D48-74] [D48-75] §53 [U48-22] 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
2026-10-09 docs(workflow): 14 에 지민과 묶인 할 일 추가 (2026-10-09) — M1: 지민 요청 넷(chip16 세션 둘 · 배치 설명 · chip14 세션 로그 · 마킹 사진) · chip06 12k → 100k 시작 결정 / M2: chip16 축 [U53-1] → 승격 · chip14 [U48-22] · v4.1 순서
2026-10-11 docs(results): chip16 을 온도 축(설정 65°C · 교정 밖)으로 승격 — 지민 3차 묶음(세션 1791434740 · 1791523104) 수령 → 1단계 1-100,000 완성 · --temp --promote(곡선 _64C) · 수치 · 온도 · LOCO · 해석 문서(chip17 과 반대로 상온 빠른 무리처럼 늙음, 센서가 히터를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
2026-10-11 docs(results): chip14 를 JV 별개로 승격(chip10 과 「JV 둘」) — 마킹 25Q64JVSIQ 1749 판독 → [U48-22] 닫음 · SEPARATE 에 chip14 · --no-calib --promote · 세션 로그 16개 수령(TalkFile_14) 반영(창 위치 80k-100k 이동 · 현장 역산 59-60k · 근접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
2026-10-12 docs(chip_pe): chip06 12,000 → 100,000 장부 행 — 세션 1791740291(보드 A, 10/11-12, 체크포인트 9점 전 구간 PASS)
2026-10-12 fix(wear_checkpoint_table): 체크포인트 100 이 없는 칩은 첫 점을 폭 기준으로 — chip06 은 블라인드라 0 → 100 의 호스트 로그가 없어 그림이 KeyError 로 멈췄다. 범례에 「(폭 기준 1,000)」 을 붙인다
2026-10-12 docs(results): chip06 을 교정 9칩째로 승격 — 블라인드 12k 칩을 12k → 100k 마저 닳게 해(세션 1791740291, 보드 A) pe_end 1단계 · --promote. 100k 소거 74.6ms(신품 25.7 의 2.9배) · 프로그램 6.55 → 8.91ms · 계단 없음(chip09 · 02 식). 개봉 prep 5회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
2026-10-12 docs(plots): chip06 색 노랑 #eda100(영웅님 지정 — 빠른 칸 안에서만 비교하므로 느린 칸 chip03 과 같은 색이어도 된다) · 배율 겹침 2026-10-12 9칩판 · 한눈 그림 재생성
2026-10-12 docs(inverse): v4.1 측정 — chip06 을 더한 교정 9칩으로 S-5 §9 1-6 재실행(미등록). 106점 띠에 rows P5 80.4% 과소신 · 95% 94.9% 합격(v4 와 같은 판정) · ρ 재측정 0.00 · 0.78 · 0.27 · R 빠른 2.97 → 2.72 가 chip04 를 95% 80 → 62% 로 밀어냄 · ch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
2026-10-12 docs(log): 로그 52 §12 — v4.2(프로그램 축)를 브랜치에서 만들어 재 보고 폐기 [D52-9]. 개봉 prep(PRBS)에는 프로그램 신호가 1.00-1.15배로 뭉개져 0x00 엔진 1사이클 관측으로 두고 초기 구간 대비 비율 눈금 · ρ_ep 0.05 로 더했더니 9칩 106점 68% 폭 34k → 29k 이나 95% 94.9 → 9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
2026-10-13 docs(results): chip06 100k → 200k 승격 — 세션 1791800419(보드 A, 10/12 19:25 → 10/13 20:19, 24h54m) pe_end 1단계 · --promote --overwrite. 소거 p50 74.6 → 106.9ms(신품 4.16배), 계단 140k 87.8 → 150k 103.5ms(섹터별 105m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
2026-10-13 docs(data): chip06 200k 반영 — wear_curves md 세션 행(1791800419 추가 · 100k 너머 구간은 현행 모델에서 M=x·r 지점으로만 쓰임) · 행 수 1,399,300 · data/README sweep·wear 보관 현황 (2026-10-14)
2026-10-14 docs(results): chip09 100k → 200k 승격 — 세션 1791904816(보드 A, 10/14 00:20 → 23:16 KST, 22h56m, --confirm-first 0 무인) pe_end 1단계 · --promote --overwrite. 마지막 스윕이 10월이라 endurance · 곡선 · 칩별 그림을 _2026-09 → 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
2026-10-14 docs(results): 200k 연장 해석 wear/wear_endurance_200k.md(chip06 · 09 한 편, chip03 절 예정) + 수치 md — chip06 2026-10 새로, chip09 _2026-09 → _2026-10 에 200k 절. 100k 안에 계단이 없던 12섹터 전부 110k-158k 에 전환, 높이 14섹터 18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
2026-10-14 docs: 200k 연장 추기 — 등록부 chip06(블라인드 → 교정 → 200k 연장 종료) · chip09(교정 4 · 200k 연장 종료) 용도 · 비고, S-1 §15 10/14 추기(사전 등록 밖 관측 · H6 ② 는 직전 + 21±4 로 다음 칩 예측), 로그 52 §13 · [D52-9] 추기 · [D52-10](chip06 · 09 → c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
2026-10-14 docs(chip_pe): chip06 100k → 200k(세션 1791800419) · chip09 100k → 200k(세션 1791904816) 마모 · 체크포인트 장부 행 — run_wear 가 쓴 그대로 (2026-10-12 - 10-14)
2026-10-15 docs(results): chip03 100k → 200k 승격 — 세션 1791990254(보드 A, 10/15 00:04 → 10/16 00:13 KST, 24h09m, --confirm-first 0 무인) pe_end 1단계 · --promote --overwrite. 마지막 스윕이 10월이라 endurance · 곡선 · 칩별 그림을 _2026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
2026-10-15 docs: chip03 200k 해석 · 추기 — 10/14 예측(110-130k 계단 · 착지 = 직전 + 21) 틀림: 느린 무리는 같은 85-93ms 에서 출발해 105ms 를 계단 없이 미끄러져 지났다(105ms 이상 A 행 비율 70k 에 걸쳐 0 → 66%, chip09 는 20k 안) → 계단은 빠른 무리의 표지, 「계단 경계 = 소거 85-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
2026-10-15 feat(registry): 라벨 상한 chip20 → chip30 — 3차 구매 10칩 신품 전수용. chip_registry.LABELS range(1, 31) · 오류 문구(둘 다, 하나는 옛 chip10 문구) · sweep_uart_capture 허용 문구 · 등록부 제목과 10/16 기록(빈 라벨 chip19 · 20 · 21-30, chip0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
2026-10-15 docs(newchip): 3차 구매분 chip21 · 22 · 23 신품 전수(10/16 00:43-00:55 KST, 보드 A, git a349d63, newchip 1회씩, 전부 PASS · 2520/2520 · blank_pre 0) — 셋 다 느린 무리(32-127 중앙값 48.9 · 49.5 · 49.4ms), width 39,649 · 39,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
2026-10-15 fix(docs): 등록부 복구 — dd8932d 에 편집기 표 정렬(전 칸 패딩)과 마킹 문단이 표 행으로 흡수된 판이 들어갔다(chip23 행 뒤 빈 줄이 빠진 상태에서 정렬이 돌았고 되돌리기가 반만 됨). c71f740 의 등록부에 chip21-23 행(배정 · 비고) · 마킹 행 3개만 다시 얹음. 파서 통과 19행 (2026-10-16)
2026-10-15 docs(registry): chip22 용도 변경 — 상온 0 → 100k 교정 → 65°C 온도 PE 0 → 100k(느린 무리 첫 온도 칩, chip16 · 17 은 빠른 무리) · 교정 밖, pe_end --temp. 워크플로 14 · 집계표 bullet 같이 (2026-10-16, 영웅님)
2026-10-15 docs(registry): 표 칸 정렬(영웅님 편집기) — 내용 변경 없음, 파서 19행 · 빈 줄 · 마킹 문단 표 밖 확인 (2026-10-16)
2026-10-15 docs(registry): chip11 · chip13 측정 불가 행(UID 미확보 — 9/30 JEDEC 무응답 7건 중 귀속 불가, chip05 와 같은 종류) · 9/30 배치 8칩 = 알리 2(chip11 · 12) + 디바이스마트 6(chip13-18) · chip19 · 20 은 빈 번호 · 구매 누계 28(측정 불가 3) · 3차 10칩은 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
2026-10-16 docs(results): chip15 100k → 200k 승격 — 세션 1792080192(보드 A, 10/16 01:03 → 10/17 01:24 KST, 24h21m, --confirm-first 0 무인) pe_end 1단계(--drop-cycles 69109-69109 — 연장 뒤에도 매번) · --promote --overwrite. 느린 무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
2026-10-16 docs: chip15 200k 해석 · 추기 — 10/16 예측(계단 없이 미끄럼 · 배율 약 2.1) 맞음(2.25). 느린 무리 100k-200k 가 두 장(03 · 15, 150k 1.87 · 1.88 · 200k 2.10 · 2.25, 평탄 구간 없음)이라 v4.3 느린 LOCO 채점 가능, chip21 예측 「미끄럼 · 2.1-2.3」. wea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
2026-10-17 Increase PWM_LIMIT from 128 to 220
2026-10-19 docs(chip_pe): 장부 증분 10/14-10/19 — chip03 100k → 200k(세션 1791990254) · chip15 100k → 200k(1792080192) · chip21 0 → 200k(1792170748) · chip22 65°C 0 → 100k(1792205864) · chip21-25 flash_prep (2026-10-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
2026-10-19 docs(registry): chip23 블라인드 → 65°C 종단 예정(온도 축 · 느린 무리)으로 변경 · chip11 · 13 · 15 행 칸 정렬(내용 변경 없음) (2026-10-19)
2026-10-19 docs(results): chip24 · 25 신품 등록 — 10/19 newchip 1회씩(보드 A). chip24 `25Q64FVSIQ` `1542` 신품 소거 24.9ms(전 칩 중 최소, 빠른 무리) · chip25 `????FVSIG` `1645` 50.6ms(느린 무리), 둘 다 미배정. 3차 구매분 다섯 장 = 느린 4(21 · 22 · 2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
2026-10-19 docs(results): chip07 점퍼선 20cm → 10cm 교체 뒤 재측정 — 선이 원인이었다. 같은 100k · PRBS 상태에서 --mode sweep 25MHz 2회(39,747 · 39,746ps, 9/30 20cm 39,209 대비 +538 · 같은 장착 2회 −0.4ps) · 45MHz 21,804(+957, chip03 수준) · 7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
2026-10-19 docs(results): chip21 0 → 200k 승격 · 문서화 — 예측 틀림, 「신품 소거 느림 = 노화 느림」 두 번째로 깨짐 ([D52-12]). 세션 1792170748(보드 A, 10/16 17:12Z → 10/19 01:32Z, 56h20m, --confirm-first 0 무인) 23구간 전부 PASS · 재접속 없음 · pe_end 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
2026-10-19 feat(inverse): v4.3 설계 · 5장 판 측정 — 답 범위 100k 그대로, 200k 곡선은 고마모 과소추정을 고치는 재료 ([D52-13] · [U52-8]). §12 의 「v4.3 = 답 범위 150k 너머」 는 뒤집힘([D52-9] 추기) — 200k 마모의 목적은 범위 확장이 아니라 M = x·r 이 100k 너머 곡선을 쓰는 큰 r 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
2026-10-20 feat(registry): 라벨 상한 chip30 → chip40 (4차 구매 10칩, 누계 38) — LABELS range(1, 41) · 오류 · 허용 문구 · 등록부 제목과 10/20 줄. 같은 파일에 chip07 행 200k 연장 종료 추기 (2026-10-21)
2026-10-20 docs(results): chip07 100k → 200k 승격 — 세션 1792429510(103.6k → 178.1k, wip_timeout 접촉) · 1792494559(178.8k → 200k), 10cm 선. pe_end · --promote --overwrite, 마지막 체크포인트가 10월이라 _2026-09 → _2026-10 이름 변경(참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
2026-10-20 docs: chip07 200k 해석 · 추기 — 수치 md(_2026-09 → _2026-10) §9 세션 · 결손 두 곳 · 배율표 · 200k 문서 §9(느린 형 세 장째, 200k 배율 1.91 · 2.10 · 2.25 가 100k 순서를 따름) · chip07 해석 · S-1 §15 10/21 · 보고서 재료 · 워크플로 14. 같은 파일의 v4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
2026-10-20 docs(inverse): v4.3 [U52-8] (가) 시험 기록 — 사후 지지를 200k 로 넓히자 50-100k 추정/정답 0.84 → 1.24(과대) · 68% 폭 44k → 93k · 전체 폭 33k → 49k(빠른 무리 160k-200k 평탄이라 100k 너머 식별 불가) → 기각, 코드 되돌림. 평가 문서 §3.3 · §3.4(정답 구간별 치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
2026-10-20 docs(results): 칩별 0 → 100k 소거 · 프로그램 시간 추이 표(쌍둥이 문서, 빠른 · 느린 무리로 나눔) — 1k · 3k · 10k-100k 의 1k 구간 섹터 중앙값과 배율, 곡선이 있는 15칩. 생성 스크립트 wear_trajectory_table.py (2026-10-21)
2026-10-20 feat(inverse): v4.3 6장 판 · 대표값 사후 평균 — A_SESSIONS chip07 연장 세션 2개(103.6k → 178.1k · 178.8k → 200k), posterior/invert/loco_study 에 연구용 support · prior · keep_post(기본값은 그대로), 후보 비교 스크립트 inverse_ceiling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
2026-10-20 docs(inverse): v4.3 6장 판 측정 · 상한 처리 후보 일곱 비교 결과 — 6장 판 82.5 · 94.7% · 50-100k 0.84 · R 느린 1.59 · ρ_chip 0.21. CRPS 로 지지 100k · 평평한 사전, |ln| 로 사후 평균(0.310 < 중앙값 0.329) 선택 [D52-14] · [U52-8] 닫음. 상한 과소추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
2026-10-23 fix(inverse): v4.3 확정 전 점검 — 화면의 「사후 평균/중앙값」 문구가 쓴 모델이 아니라 기본 버전을 보던 것을 point_kind 로 고침 · ρ_chip 0.29 → 0.21(6장 판 재측정, 잰 값 원칙 — LOCO 68% 82.5 → 81.6 · 95% 94.7 → 94.1, 판정 불변). 테스트 178 (2026-10-23)
2026-10-23 docs(inverse): v4.3 확정 [D52-15] — 점검 결과(§5: 코드 diff · ρ_chip 감도 · 85°C 칩 현장 역산 v4 대 v4.3 · 1k 구간 표기 한계)와 확정 사양표(§6) · S-5 §2 v4.3 열 · 로그 52. main 머지 대기 (2026-10-23)
2026-10-23 feat(inverse): 학습 곡선 — 같은 무리에서 교정 칩 k 개 모든 조합으로 교정 · 나머지 칩 LOCO(v4.3 · rows P5 × 5). 빠른 무리 k = 3 에서 포화(68% 27 → 73 → 81% · 95% 46 → 90 → 91% · 배율 오차 0.51 → 0.37 → 0.35), 느린 무리 k ≤ 2 라 판정 불가. 스크립트 · 그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
2026-10-23 docs(inverse): v4.3 등록 (블라인드 chip08 개봉 전) [D52-16] — S-5 §2 v4.3 열 등록일 · 성공 기준 ③ 1.33(대표값 사후 평균 기준) · 판정 칩 chip08, S-1 §15 10/23 추기, 로그 52 [U52-5] 닫음, 워크플로 14. 등록부 chip23 85°C 0 → 26.5k 중단 기록 (2026-1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
2026-10-23 docs(chip_pe): 장부 합침 — 이 PC 의 chip02 100k → 200k(세션 1792520588) · chip07 100k → 200k(세션 1792429510 · 1792494559, 정정 행 +3,600 전원 상실 · +663 프로브, resume 재소거 ±1) 행과 지민 묶음의 chip22 100k 뒤 newchip · chip23 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
2026-10-23 fix(temp_wear_summary): 승격으로 이름의 달이 바뀐 교정 파일(_2026-09 → _2026-10)을 latest() 로 찾음 · 설정 온도를 로그에서 읽어 띠(±2°C) · 그림 라벨을 맞춤(65°C 하드코딩 제거, 85°C 칩 chip22 · 24) · 느린 칩은 상온 느린 교정 칩(03 · 07 · 15)과 비교 · chip17 전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
2026-10-23 docs(results): chip02 100k → 200k 승격 — 세션 1792520588(보드 A, 10/20 → 10/22 02:49 KST, 사건 없음). 7섹터 148-178k 계단(한 구간 17.5-21.0ms, 빠른 FV 7/7), 200k 소거 4.00배 · 180k-200k 106-109ms 평탄, 프로그램 약 3배, 110k 재장착 단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
2026-10-23 docs(results): 85°C 온도 마모 chip22(느린) · chip24(빠른) 0 → 100k 승격 — 박지민 보드 B, 설정 85°C(파일명 65C 는 틀림, 의도 85°C), 칩 85.0 · 83.5°C. pe_end --temp(곡선 _85C · _83C, 교정 밖). chip22 1.90배 · 계단 없음 · 프로그램 1.64 / chip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
2026-10-23 docs: chip02 200k · 85°C 두 칩 해석 · 추기 — wear/wear_temperature_85C.md(65 · 85°C 네 칩 상온 개체 산포 안, 상온 모델 95% 47/48 · 68% 22/48, 고온 이력 칩은 범위로 답함) · 200k 문서 §10(빠른 FV 7/7 계단) · 등록부 chip02 · 22 · 24 · S-1 §1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
2026-10-23 docs(inverse): 등록 뒤 7장 판 확인 — chip02 200k 곡선이 들어와도 LOCO 81.7 · 94.5% · 폭 34,000 · ③ 1.33 으로 등록 수치와 같은 판정. chip08 은 7장 판으로 개봉. S-5 §9 9번 추기 · 로그 52 §17 (2026-10-23)
2026-10-23 feat(inverse): v4.3 7장 판 완성 — A_SESSIONS chip02 연장 세션 1792520588, 재측정 R 빠른 2.72 → 2.80 · 느린 1.59 · ρ 0.00 · 0.78 · 0.21 그대로 · LOCO 81.7 · 94.5% · ③ 1.33 · 합성 71 · 96. S-5 §2 v4.3 열 · 결과 문서 §7 · 로그 52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
2026-10-25 docs(chip_pe): 장부 증분 10/25 — chip26 · chip30-39 flash_prep (newchip 1회씩, 섹터 0-127 +1). 실패 런(JEDEC FF FF FF 8 · 접촉 실패 서명 3)은 UID 귀속 전이거나 라벨 등록 전이라 증분 없음 (2026-10-25)
2026-10-25 docs(results): chip26 신품 등록 · FV 신품 측정 끝 — 10/25 newchip 1회(보드 A). `25Q64FVSIG` `2122`(FV 중 가장 늦은 날짜 코드), 신품 소거 25.7ms(32-127) 빠른 무리 · width 39,638.1ps · blank_pre 0, 0-6 ÷ 32-127 0.98. 배정 85°C 종단(영웅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
2026-10-25 docs(results): JV chip30-39 신품 등록 — 디바이스마트 10칩, 10/25 newchip 1회씩(보드 A), 전부 `25Q64JVSIQ` · PASS · 2,520/2,520 · blank_pre 0. 빠른 7 · 느린 3(30 · 32 · 39, 52.7-53.4ms 전 칩 중 최대). UID 세 꼴 — `DF` 5(width 약 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
2026-10-25 docs(results): 신품 전수 무리 정리 표 — 31칩(측정 불가 05 · 11 · 13 제외) 빠른 19 · 느린 12. FV 19(chip12 포함) 빠른 10 · 느린 9 · JV 12 빠른 9 · 느린 3. 세대 · UID 앞바이트별 칩 · 분류값 · 날짜 코드, 33-37ms 에 모인 칩(chip04 · JV DF 다섯). 집계표 §1 끝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
2026-10-25 docs: 신품 전수 31칩 끝에 맞춘 문서 점검 — 해석 문서 newchip_survey.md 추기 다섯(결론 31칩 · ① 소거 24.5-53.4ms · ② width 는 UID 꼴로 두 띠, DF JV 7칩 38,704-38,918 vs 나머지 24칩 39,327-39,821 · ④ 접촉 실패 두 번째 서명 · §4 chip10 −912ps 는 칩 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
2026-10-25 docs: 3차 구매는 6칩(chip21-26) 정정 — 영웅님 확인. 등록부 제목 누계 38 → 34(측정 불가 3 빼면 31) · 10/16 「3차 10칩 = chip21-30」 · 「28칩」 에 정정 표시, 집계표 10/15 비고 · 워크플로 14 항목 (2026-10-25)
2026-10-25 docs(spec): 모델 적용 범위를 「W25Q64FV」 전체로 넓힘 (영웅님) — 10/12 「날짜 코드 1309 - 1551」 은 그때까지 잰 범위일 뿐, 3차 FV(1413 - 2122)도 같은 FV. 세대로 긋고 날짜 코드로 긋지 않는다. 교정 반영은 따로(chip21 _nocal 그대로) · chip12 · 21 형 한계 그대로. chip14 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
2026-10-25 docs: chip36(UID CA) 별개 칩 여부 보류 (영웅님) — 소거 128섹터 폭 36µs · 프로그램 10.66ms, 사양 안 · 측정 정상이라 불량은 아님. 등록부 행 (2026-10-25)
2026-11-01 docs(spec): S-5 현행 버전 줄을 v4.3 으로 — 10/23 등록 · 블라인드는 7장 판으로(§9 9번), --model v4.3 이 기본(코드는 이미 MODEL_VERSION v4.3), v4 · v3.2 는 이전 모델. 등록 경위 로그 52 §15 · §17, 수치 inverse_v4_3_eval_2026-10.md (2026-11-01)
2026-11-01 fix(temp_wear_summary): 85°C 칩 그림의 빈 온도 칸 · 중단 칩 — 온도 축을 설정값만큼 옮김(65°C 런의 55-69°C 고정이라 85°C 선이 축 밖이었다), x 축을 칩의 끝(체크포인트 또는 1k 곡선 끝)까지, 50k · 100k 비교점이 없는 칩(chip23 26.5k 중단)에서 죽던 것, 느린 무리 범례. 10/23 승격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
2026-11-01 docs(chip_pe): 장부 합침 — 지민 묶음의 chip26 85°C 0 → 70,000(세션 1792996750 · 1793025714, 30,000 → 33,100 error 뒤 이어 돌림) 행 21개를 10/25 · 11/01 행 사이 날짜 순으로, 11/01 chip23 · 26 newchip prep(보드 A 자동 기입). 섹터 0-6 합계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
2026-11-01 docs(results): 85°C 온도 마모 chip23(느린) 0 → 26,528 · chip26(빠른) 0 → 70,000 승격 — 박지민 보드 B, pe_end --temp(곡선 _85C · _84C, 교정 밖). chip23 10/18 USB 끊김 · 히터 센서 FAULT 로 중단, 26k 배율 1.77 · 프로그램 평평. chip26 10/26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
2026-11-01 docs(inverse): 85°C 온도 칩 v4.3 블라인드 — chip26 합격 · chip23 불합격 [D52-17]. 11/01 보드 A 상온 newchip 1회씩 → v4.3 7장 판(10/23 등록 그대로, git_rev 18e06ad). 정답은 지민 묶음으로 먼저 받아 봉인 없이 「모델 고정 판정」(영웅님). chip26(빠른, 정답 70,0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
2026-11-01 docs(workflow): 14 M1 최종 발표 11/6 확정 (영웅님) — 처음 계획 10/16 (2026-11-01)
2026-11-04 feat(analysis): plot_deck_figures — 최종 발표 슬라이드 그림 셋. 7쪽 chip06 계단 현상 · chip03 완만한 증가(0 → 200k), 8쪽 교정 9칩 소거 배율(글자 키움), 12쪽 무리 × 온도 100k 소거 · 프로그램 배율. 값은 wear_curves CSV 와 집계표에서 내고 wear_temperature_85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
2026-11-04 docs(results): 11/6 최종 발표 슬라이드 · 대본 · 예상 질문 — 슬라이드 16장 유지, 말을 줄여 추정 약 7분(초시계 리허설 전). 10쪽 chip06 상온 · chip26 열화(모델 고정 판정), 15쪽 chip26 시연값(11/1 측정), 수치는 v4.3. 세부는 예상 질문으로 — chip23 3.5배 과대 · 68% 과소신 · 두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
2026-11-04 docs(log): 로그 54 최종 발표 범위 — 16장 유지 · 말만 줄임 [D54-1], 블라인드 두 칩 설명 [D54-2], 발표 수치 v4.3 [D54-3]([D48-107] 뒤집음 · 추기), 12쪽 결론 [D54-4], NOR 부족 근거의 한계 [D54-5]. S-5 머리말 · 워크플로 14 M1(기한 11/6 · 데이터 마감 11/1 · 모델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
2026-11-06 docs: reconcile chip P/E ledger records
2026-11-10 docs(chip_pe): 대장 정리 — 머리의 잘못 들어간 「Alt + /」 줄과 표 중간에 중복으로 끼어든 chip26 10/26 run_wear 21줄을 지우고, 그 사이에 있던 11/6 chip26 flash_prep(20261106T012331Z) 줄을 날짜 순서대로 끝으로 옮겼다. 증분 합계는 바뀌지 않는다 (2026-11-10)
2026-11-10 docs(chip_pe): chip08 11/5 마모 0 → 30,000 (session 1793893689, 체크포인트 100 · 1k · 3k · 10k · 20k · 30k) · 11/5 flash_prep(20261105T235448Z) 기록 (2026-11-10)
2026-11-10 docs(log): 로그 55 교수님 피드백(11/2) — 욕조 곡선 요구 다섯(벽 확대 · 좌우 비교 · 0/1 pdf · 칩별 평균 산포 · 체크포인트별 평균) [D55-1], 좌우 비대칭은 에지 방향 가설로만 둔다(chip01 1회분) [D55-2]. 로그 목록 등재 (2026-11-10)
2026-11-10 refactor(results): plots/ 를 접두사별 폴더로 — bathtub_ → plots/bathtub/v1/ (버전 = 측정 방식, 정의는 plots/bathtub/README.md), wear_ → plots/wear/, temp_ → plots/temp/, 그 밖은 바로 아래. 규칙은 results README 「plots/ 자리」 표(4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
2026-11-10 docs(results): 체크포인트 집계표에 chip26 70,000 행(85°C 재스윕, 주 [24]) · chip23 26,528 격자 밖 주(11/1 상온 newchip) 반영 (2026-11-10)
2026-11-10 feat(analysis): deck_tables — 최종 발표 질의응답 부록의 기본 데이터 표를 원자료(wear_curves CSV · 신품 조사 · 칩 명부 · 집계표 · 세션)에서 뽑는다. 값 정의는 슬라이드 7 · 8 · 12쪽 그림과 같다 (2026-11-10)
2026-11-10 docs(results): 최종 발표 질의응답 부록 — 핵심 수치 · 예상 질문(★ 곤란한 질문) · 모델 수식 · 버전 · 블라인드 · 데이터 표(D1-D8). 대본 · results README · 로그 54 산출물 표에서 가리킨다 (2026-11-10)
2026-11-10 chore(claude): 프로젝트 서브에이전트 정의 — implementer · implementer-light · reviewer (2026-11-10)
2026-11-10 feat(analysis): 욕조 v2 설계 재료 — bathtub_stats(25MHz 칩별 · 체크포인트별 집계 · 순위 상관, 덩어리 = 바닥의 여집합 · 안쪽 0 틈 K=5 미만은 같은 덩어리) · bathtub_freq_compare(25 · 45 · 75MHz 사다리 — 천장의 절반 높이 선반, 마모 전 · 100k 짝) · monte_carl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
2026-11-10 docs(log): 로그 55 욕조 v2 설계 — 끊긴 축 W 1,000ps [D55-3] · 훑기 1회 → 벽 집중 K 5 · 상한 64스텝 · 천장 한 묶음 [D55-4] · 표준 N 8,064 / 초심부 2,064,384 = 직접 잰 BER 상한 7e-10 [D55-5] [D55-11] · 주력 25MHz(마모 체크포인트 386런과 연속) [D55-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
2026-11-10 docs(concepts): 16 에지 계수기 — 한눈에(기존 계수기의 문제 → 해결 → 원리) · 쉬운 버전(스냅샷과 전이 · 정렬 3개 · 승자 = 시간대) · 엔지니어링 버전(원본 열 · 해석표 · 벽 → 에지별 pdf · 못 하는 것 · 흔한 오해). 로그 55 [D55-13] (2026-11-10)
2026-11-10 docs(spec): 욕조 v2 명세 S-6 · 계약 수정안 #4 초안 — 훑기 1회 → 벽 집중(K 5 · 상한 64스텝 · 천장 한 묶음 · 끝 훑기) · 표준 N 8,064 / 초심부 2,064,384 · bathtub2_* 파일(pass 열 · 무효 ⑨⑩⑪ · END 행 수) · 에지 계수기는 정렬별 여섯 값 전부 기록, 승자 · 해석은 PC(LO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
2026-11-10 refactor(data): 측정 원본을 처음부터 data/ 에 쓴다 — 캡처 DEFAULT_OUTDIR = data/, run_wear LOG_ROOT = data/wear/<세션>/, pe_end 는 data/ 부터 읽고 옛 build 잔여도 본다. build/ 는 비트스트림 · ELF · 그림 · 파생물만. 계약 §6 저장 위치 표기 · 수정안 #4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
2026-11-10 docs: 현행 문서 전수 최신화 — README 를 공모전 최종 발표(11/6) 수치로(v4.3 · 블라인드 3칩 · 신품 31칩 · 마모 19칩 · 고온 6칩, 기준선 표는 v3.2 때 94점으로 표기), project_context · project_pipeline 을 11/11 현재로(졸업논문 M2 · 욕조 v2 진행 · chip08 은 횟수 봉인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
2026-11-10 docs(inverse): chip08 도 정답 봉인 없이 v4.3 「모델 고정 판정」 [D52-18] — 11/5 마모 정답이 대장 커밋 제목(17b93c6)과 대화로 판정자에게 드러났다. v4.3 은 10/23 등록 뒤 그대로이고 chip08 마모는 그 뒤라 모델 쪽에서 정답에 끌릴 길이 없다([D52-17] 과 같은 근거). 봉인 판정은 chip06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
2026-11-10 docs(inverse): chip08 블라인드 v4.3 모델 고정 판정 — 불합격. 추정(정답 열기 전 저장) 대표값 약 71,500 · 95% 43,001-100,000, 정답 30,000(장부 · 마지막 A 행 · A 행 수 일치) → 2.38배 과대, 기준 ① 불통과 · ② ③ 통과. 30k 배율 1.51 = 느린 교정 1.32-1.36 과 빠른 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
2026-11-10 feat(analysis): 욕조 v1 분석 B1 · B3 · B6 — bathtub_p1_figures(끊긴 축 W 1,000ps · 0 오류 포함 칩 평균, build/bathtub/v1/) · bathtub_session_trend(장착 세션 안 Spearman — 어느 특징도 마모로 우연 이상 변하지 않음, chip02 · 06 의 옛 추세는 재장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
2026-11-10 docs(spec): 욕조 v2 설계 리뷰 2 반영 — ID 는 그대로 · FEATURE 레지스터 0x38 [D55-18], 해석은 승자 대신 이웃 정렬 쌍(합 = 페이지 전이 수)의 「지금 비트」 정렬 [D55-19](개념 16 의 정렬 이름이 RTL 과 반대였던 것 정정), A5 부류 정답은 같은 런 안에서 [D55-20], 비트스트림 정책 [D55-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
2026-11-10 feat(rtl): 수정안 #1 BASE_SECTOR + #4 에지 계수기 — flash_rx 정렬별 정답 1 오류 카운터(o0-o2) · 96비트 후보 버퍼(LOG_C0-C2 0x2C-0x34) · FEATURE 0x38(HAS_BASE_SECTOR 파라미터, 루프백 bit1 = 0) · BASE_SECTOR 0x28(래치 · 범위 검사 · 주소와 시드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
2026-11-10 feat(bathtub2): 욕조 v2 측정 소프트웨어 — 펌웨어 bathtub_v2.c(S-6 ①-⑦, FEATURE · BASE_SECTOR 되읽기 검사, int32 위상 대조, u64 합, R8 ①-⑥, CFG_ERR 즉시 종료, N · base sector 실행 때 덮어쓰기) · 호스트 모의(가짜 core — 유휴 0 · 합성 프리앰블 · R11)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
2026-11-10 feat(analysis): B7 외삽 판정 bathtub_extrapolation — 벽마다 가능 25 · 부분 14 · 불가 747. 정직한 LOO(바깥 점 빼고 판정) 에서 안쪽이 직선인 19벽도 10배 넘게 틀리는 비율 8/19(95% 20-67%) = 전 벽과 같다 — 기준이 외삽할 수 있는 벽을 골라내지 못한다, 「가능」 은 검증되지 않음. 외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
2026-11-10 docs: 밤샘 구현 기록 — 로그 55 §11 · [U55-8]-[U55-10], 수정안 #4 · S-6 · 개념 16 추기(짝이 정확히 하나가 아니다 · 합 차 0-2 · A4 방향 대조는 지금 비트 정렬의 e1 로 · 허용 오차를 먼저 안 적었다 · 구현에서 더한 무효 사유), SPI NAND 범위 초안(워크플로 15, 결정 아님 — AI 제안은 최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
2026-11-11 docs(spec): A2 판정 기준 확정 [D55-23] — 주 기준 = 위상별 먼저 온 상승 · 하강 개수가 시뮬레이터 정답과 정확히 같음, 보조 기준 = 에지별 평균 · σ ±1.6ps(10:1 규칙, 위상 한 칸의 1/10; 4:1 은 σ 에 ±50% 라 버림). 결과를 본 뒤 정했다는 것과 조건(위상 2ps · 16읽기)을 남긴다 — 11/11 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
2026-11-11 docs(log): [D55-24] 쌍 규칙 · A4 방향 대조는 RTL A2 로 검증(6096/6096), 실칩은 A4 · A5 — 구현 세부 셋 그대로. 워크플로 14: chip08 블라인드 결과 해석과 한계 문구는 영웅님이 직접(AI 해석은 잠정) (2026-11-11)
2026-11-11 docs(workflow): 14 M2 — 영웅님이 할 일(2026-11-11) 한 절로: 욕조 v2 보드 순서 ①-⑦(A1 옛 → 새 → 옛 명령 포함 · v2 ELF 빌드 · A4 · #1 A2 · A5 · 첫 초심부 · A3), 마모(chip08 이어 · chip25 교정), 승인 요청 · M2 기한 · 칩 구매, 보류 판단(chip08 해석 · N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
